fernandomierhicks/wheeled-leg-robot/cad/v4 Larger Ball bearings/README.txt

Rationale
-Wide bearings 6804 bearings
-Double suspended tibia for max stiffness - less friction
-Single coupler for simplicity
-Movable Leg plate that bolts onto body for easy CG adjustment

--------------------------------------------------------------------------------Optimization
-Optimized for max travel with 2Nm limit when applying 1kg force on wheel. Leave us some margin
-10mm max vertical deviation ( to avoid balancing issues when changing leg height
-ok for femur to collie with coupler, design has them in different planes 

See 2N_10mm_279mm.pdf for main dimensions. 
Stroke is +28 to -57 degrees. 

------------------------------------------------Dimensions:
2mm 		link to link clearance
32.05mm 	Bearing clearance
20.05mm 	for shaft going into bearing
23mm 		inner bearing ring. 
26mm 		outer bearing ring. 
7mm		Shaft fastener reinforcement pattern radius - allows for washer to be on 23mm inner ring while fasteners are still in PLA
38.05mm		diameter for hole pattern of retaining washer for outer ring bearing.
