fernandomierhicks/wheeled-leg-robot/cad/v3 shifted CG thin RGB Limit Switch/README.txt

Moved to Square tube to be able to use regular ball bearings and not have spherical joints on rod ends. 

Print settings:
-Motor couplers need to be high infill so they dont deform upon compression.
