fernandomierhicks/wheeled-leg-robot/firmware/robot_teensy/radio_channels.md

# Radio Channel Map

**Link:** ExpressLRS / CRSF, 420000 baud, `Serial4` (RX pin 16, **TX pin 17**).
Bidirectional -- telemetry rides the return path. See
`teensy/src/crsf_protocol.h` for the wire format and, more importantly, its
FAILSAFE CONTRACT.

**TX Profile:** `WLR ROBOT` on the RadioMaster TX15 (`radio/sdcard/MODELS/`).
**Reversals:** none

> **"Up" is ambiguous, so read this once.** Below, "C5 up" means the *channel*
> is high (~2000 us). On the TX15 that is produced by pushing the switch
> **down** -- the model maps every switch so that up = channel low = safe, and
> the power-on switch warning enforces it. See `radio/CHANNELS.md`.

### Signal loss

`channel()` returns **0**, not the last value, whenever the link is not alive,
and `alive()` goes false on any of: no frame within 100 ms, uplink link
quality at 0 while frames still arrive, or fewer than 5 good frames since
boot. Set the receiver's own failsafe to **no pulses**, never "hold".

---

## Channel Assignments

| Ch  | TX Control | Function | Details |
|-----|---|---|---|
| C1  | Roll stick | Yaw rate | 1000–2000 → −1…+1 × active profile's `yaw_max` → `PARAM_OMEGA_CMD_RDS`, slewed at `yaw_accel_max` [rad/s²] (default 8, 0 = off) so a snapped stick ramps the rate in and out instead of stepping it. One limit for all profiles: P3 takes longest to reach full rate. Also ramps to 0 on link loss. |
| C2  | Pitch stick | Forward velocity | 1000–2000 → −1…+1 × active profile's `vel_max` → `PARAM_V_CMD_MS` |
| C3  | Throttle stick | Hip height / angle | 1000–2000 → 0…1 → `PARAM_RADIO_HIP_CMD` |
| C4  | Rudder stick | Roll setpoint | 1000–2000 → −1…+1 × active profile's `roll_max` → `PARAM_ROLL_CMD_RAD` (active-suspension roll controller; only acts when `roll_ctrl_en=1` in RUNNING) |
| C5  | SB (top row, 2nd from left) | **SD logging** | **Up = start recording, down = stop.** Edge-triggered. A start is refused outside STANDBY/ESTOP (`"CH5 up ignored -- start the log before arming"`) because opening a log preallocates and blocks ~96 ms — but once started, **recording continues through RUNNING**, which is the whole point. Confirmed by a single G5 chirp, so check `buzzer_volume` — there is no LED cue. C5's level no longer gates arming. |
| C6  | SF (momentary shoulder) | **Jump** | Rising edge > 1990 requests `STATE_JUMPING`. **One jump per edge** — drop C6 and raise it again for another; holding it up does not hop repeatedly. Refused unless the robot is in RUNNING *and* `jump_enable = 1` (default **0**, so this is inert until you deliberately enable it). |
| C7  | S1 dial | Live tune, slot 0 of active group | 1000–2000 → active group's slot-0 range → its mapped param. See "Live parameter tuning" below. |
| C8  | S2 dial | Live tune, slot 1 of active group | 1000–2000 → active group's slot-1 range → its mapped param. See "Live parameter tuning" below. |
| C9  | SC (top row, right of dials) | Speed profile | < 1333 = profile 1, 1333–1667 = profile 2, > 1667 = profile 3. Selects the active `vel_max`, `yaw_max`, `torque_lim`, and `roll_max`. |
| C10 | SD (top row, rightmost) | Arm / disarm | > 1990 → RUNNING (requires calibration); drop → STANDBY |
| C11 | SA (top row, leftmost) | **Calibration** | Rising edge requests CALIBRATION from STANDBY; re-trigger during a radio-owned CALIBRATION cancels it through DISARMING (hip gains taper over `calib_rampdown_s`). Edge-triggered off a latching switch, so a debounced *release* is required before another edge counts — powering up with it already down does nothing. 1 s lockout between actions. The calibration stick combo remains as the fallback. |
| C12 | SE (latching shoulder) | **Reset fault** | Rising edge in ESTOP: full reset to STARTUP, clearing `fault_code` regardless of severity and re-running the startup checks — the same effect as the rescue combo's rising edge. In STANDBY: beep only. Armed solely in STANDBY/ESTOP, never with torque live. No hold-to-reboot: a latching switch left down is not the deliberate gesture that makes the combo's 3 s hold safe. |
| C13 | SG/SH/SI (RGB buttons 1–3) | Live-tune group | All three mutually-exclusive buttons encoded onto one channel as distinct levels: ~1500 µs none, 1660 group 0, 1830 group 1, 2000 group 2. Decoded with ±80 µs bands. Still gated by `live_tune_multi_en`, which defaults to 0. C5/C6 keep SD logging and jump — the old combination borrowed them, so a tuning session could not be logged. |
| C14 | SJ (RGB button 4) | **Latch gains** | Rising edge fires the same one-shot as writing `live_tune_latch` from the GUI. Only picked-up slots are committed. |
| C15 | SK (RGB button 5) | **Coordinated-turn lean** | `roll_cmd = −lean_gain·atan(v·ω/g)`, added to the stick roll and clamped to the profile's roll limit. Requires `lean_turn_en=1`, `lean_gain>0` **and** `roll_ctrl_en=1` — the roll controller is what actually delivers the lean, and a warning is logged if it is off. Verify the sign suspended before any floor test. |
| C16 | — | *spare* | |

There is **no "LEGACY mode"**. C5 is always the SD-log switch, C6 is always the
jump trigger, and gain-group select is always C13. An earlier scheme borrowed
C5/C6 for group select and is gone; if you find a comment describing it, the
comment is stale, not the code.

**C1/C4 swap (2026-10-02):** yaw rate moved from C4 to C1, and the roll
setpoint moved from C1 to C4 (`main.cpp`). The physical stick bound to each
channel number is unchanged (C1 is still the TX's roll/aileron stick, C4 is
still the rudder stick) — only which robot command each channel drives
changed. Both signs (roll's and yaw's inversion) were previously
bench-verified on the *other* channel's stick and have **not** been
re-verified on the hardware since the swap — check both directions on the
bench before trusting them.

### Where to watch these channels

`TelemetryPayload.ibus_ch[]` mirrors **C1–C14 only** — the array predates CRSF
and is sized by the payload, not by CRSF's 16 (`main.cpp`, `RC_MIRROR_CH`). So
the GUI's Radio tab stops at C14 and **cannot see C15 or C16**.

That is deliberate rather than a gap to close. The link is bidirectional now
and the transmitter has its own **Outputs** screen showing all 16 channels in
real time, which makes the radio the better instrument for walking the channel
map — widening the telemetry struct would only duplicate it, at the cost of a
`TELEM_VERSION` bump, an ESP32 reflash and every existing `.wlog` ceasing to
decode. Verify C15/C16 on the radio; use the GUI mirror for C1–C14.

`lean_cmd_rad` is read-only telemetry, but it is `−lean_gain·atan(v·ω/g)` and
therefore **zero at standstill**, so it confirms the lean is *working*, never
that the C15 button is *wired*.

## Calibration combo — STANDBY → CALIBRATION

Both sticks jammed into opposite corners, the **exact mirror of the rescue combo
below**: **C1 and C4 full up (> 1990), C2 and C3 full down (< 1010)**. Debounced
3 ticks (~6 ms @ 500 Hz). One-shot on the rising edge — release and re-enter for
the next action. Replaced the old C5 switch when C5 became the SD-log switch.

| Event | Effect |
|---|---|
| Enter combo, in STANDBY | Requests CALIBRATION (still subject to `stateMachine_request_calibration()`'s own check that at least one hip motor is enabled) |
| Enter combo again, during a radio-started CALIBRATION | Cancels it through DISARMING — tapers each hip's calibration gains to zero over `calib_rampdown_s`, then returns to STANDBY |
| Enter combo, any other state | Ignored, logged |

**Armed only in STANDBY and CALIBRATION — deliberately not in ESTOP**, so in a
fault state the rescue combo is the only live stick gesture and the two mirrored
gestures can't be confused. The two combos are mutually exclusive stick
positions and can never be satisfied on the same tick.

After any accepted action there is a **1 s lockout** before another combo edge is
honoured, so a stick glitch part-way through a deliberate hold cannot start a
calibration and immediately cancel it again. Powering up or reconnecting with the
sticks already in the combo position does nothing: a debounced *release* must be
seen before the first rising edge counts. Loss of the radio link reads as
"released", which is inert — only rising edges act, so a dead radio can never
imitate an operator request. There is no other radio-side abort; re-entering the
combo is it.

## Rescue combo — clear ESTOP / reboot

Both sticks jammed into opposite corners, held: **C3 and C2 full up (> 1990),
C1 and C4 full down (< 1010)**. Debounced 3 ticks (~6 ms @ 500 Hz). Only armed
in **STANDBY** or **ESTOP** — never with torque live. Intended as a
transmitter-only escape hatch when the GUI isn't connected; no normal driving
input produces this stick position.

| Event | Effect | Cue |
|---|---|---|
| Enter combo, in ESTOP | Full reset → STARTUP: clears the fault regardless of severity and re-runs the startup checks | A5⇄E6 siren + white LED flash |
| Enter combo, in STANDBY | Nothing to clear — beep only, and the 3 s countdown starts | same siren |
| Hold 3 s | Full MCU reset, identical to the GUI's Reboot command | E6→A5→D5→G4 descending fall |

If the fault can't actually be cleared (a REBOOT-severity hardware dropout),
STARTUP re-faults straight back to ESTOP — keep holding and the 3 s reboot
fires anyway. Releasing the sticks re-arms the combo, so a second attempt
starts a fresh countdown. Loss of the radio link cannot satisfy the combo.

## Arm authority

- With no live radio link, the GUI/API may arm and owns that running session.
- While the radio is live, GUI/API arm requests are rejected; C10 owns arming.
- If a radio link appears during a GUI-owned running session, the robot enters
  DISARMING regardless of C10 level. Re-arm from STANDBY using C10.
- During a radio-owned session, live C10-low or loss of the radio link enters
  DISARMING. C10 is level-based, so its initial low state cannot be missed.
- Motion authority is never handed directly between GUI and radio while armed;
  every takeover passes through STANDBY.
- A calibration started by the calibration combo remains radio-owned until it
  completes or faults. Re-entering the combo while it is active enters
  DISARMING, tapers each hip's current calibration gains to zero over
  `calib_rampdown_s`, then returns to STANDBY. Loss of the radio link is neutral
  and does not imitate this operator-requested cancellation.

## Live parameter tuning

Generic mechanism (`teensy/src/live_tune.h`, `LIVE_TUNE_SLOTS` in `main.cpp`)
for feeling out a gain/limit live on the bench with a knob instead of editing
the Params tab blind and re-arming to see the effect. C7/C8 each drive one
slot of the active *gain group*, RUNNING only.

**Whether live tuning is available at all is set by `live_tune_multi_en`.**

### `live_tune_multi_en = 0` (default)

**Live tuning is off.** The C7/C8 knobs are inert and the group-select buttons
do nothing. The groups are not deleted, just unreachable — set
`live_tune_multi_en = 1`. It stays a deliberate, persistent opt-in so a knocked
button cannot start moving gains on its own.

### `live_tune_multi_en = 1`

Group select is **all on C13**: buttons 1–3 (SG/SH/SI) form a mutually-exclusive
switch group whose three positions are encoded as distinct levels on that one
channel. They are already mutually exclusive, so three channels would have been
three ways to say one thing. **C5 keeps SD logging and C6 keeps jump** — the old
scheme borrowed them, which meant a tuning session gave up both, and a tuning
session is exactly the one you most want a log of.

| Group | Button | C13 level | Decode band | Slot 0 (C7) | Slot 1 (C8) |
|---|---|---|---|---|---|
| *(none lit)* | — | ~1500 µs | < 1580 | *tuning inactive* | — |
| 0 | button 1 / SG | ~1660 µs | 1580–1745 | `lqr_k_pitch_ret`, -0.1 … -2.0 | `lqr_k_rate_ret`, -0.01 … -1.0 |
| 1 | button 2 / SH | ~1830 µs | 1745–1915 | `vel_pi_kp`, 0.05 … 1.0 | `vel_pi_ki`, 0.02 … 0.5 |
| 2 | button 3 / SI | ~2000 µs | > 1915 | `roll_kp`, 0.3 … 4.0 | `roll_kd`, 0.02 … 0.5 |

Bands are the midpoints between levels (`LT_BAND_*` in `main.cpp`), debounced 3
ticks. **"None = ~1500 µs = inactive" matters as much as the rest**: the resting
state of the buttons has to be the state that does nothing. Link loss also reads
as "none", which drops every slot's pickup on the next pass.

Ranges are `(value at knob-zero, value at knob-max)`. Both slots are mirrored
live to telemetry regardless of group: `live_tune_ch7_val` / `live_tune_ch8_val`.

**Knob direction convention.** A slot's range is `(value at knob-zero, value at
knob-max)`, not a sorted `(min, max)` pair. Group 0's gains are negative, so
turning the knob up always moves the value *more* negative — i.e. "more knob"
always means "more gain" (larger magnitude / stronger action), regardless of
the sign of the underlying param. Never flip a slot's range so that the raw
signed value increases with the knob instead.

**Repointing a slot at a different param** (e.g. a future tuning session) is a
one-line edit to `LIVE_TUNE_SLOTS` + reflash — no other code changes needed as
long as the target's read site in `control_loop.cpp` goes through
`live_tune_value(PARAM_X)` instead of a bare `param_get(PARAM_X)`.

**Safety — pickup, no step change.** A knob is inert on entering live-tune mode
(or switching to a different group) until it's swept through the target
param's *current* value; only then does it "pick up" and start tracking 1:1.
This avoids the gain jumping instantly to wherever the knob happened to be
sitting when the group was selected. Pickup resets every time you leave
live-tune mode or change groups (any C13 group change, including link loss, or
leaving RUNNING) — re-entering always requires re-sweeping.

**Nothing is written to the real, persistent param until you say so.** While a
slot is picked up, its live shadow value is what the control loop actually
uses (real-time effect, so you can feel the change) — but the underlying
persistent param is untouched, so exiting live-tune mode (or switching groups)
without latching leaves it exactly as it was.

*(All of the below requires `live_tune_multi_en = 1`.)*

1. Arm normally (raise C10) → RUNNING.
2. Press the group's RGB button — 1, 2 or 3 (C13). The lit button *is* the
   group indicator. Sweep C7/C8 through the group's current values to pick each
   slot up (watch `live_tune_ch7_val`/`live_tune_ch8_val` in telemetry — they
   update immediately; the *effect* on balance only kicks in once picked up,
   independently per slot).
3. Press **button 4 (C14)** to persist every currently picked-up slot's shadow
   value into its real param — or write `live_tune_latch` = 1 from the Params
   tab, which is the same one-shot. One-shot: firmware
   latches and resets the flag. A slot that never picked up this session is
   skipped, not latched at a stale/arbitrary value.
4. To leave live-tune mode: press the lit group button again so **none** are lit
   (C13 back to ~1500 µs), or move to another group and repeat steps 2-3. Either
   way the latched (or, if you didn't latch, unchanged) persistent values take
   over.
