fernandomierhicks/wheeled-leg-robot/artistic concepts/1e269624-bf2c-442b-bb45-654e40681b4a.png

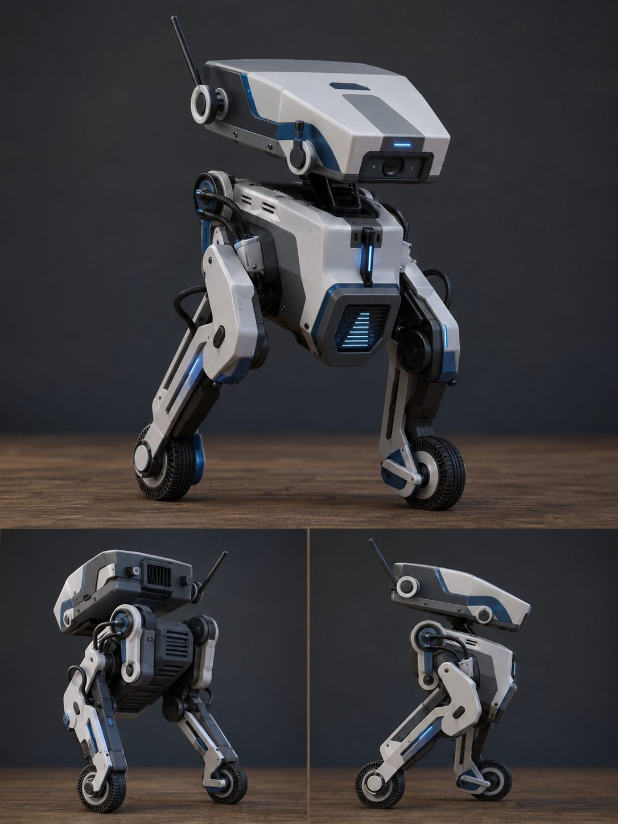
artistic concepts/1e269624-bf2c-442b-bb45-654e40681b4a.png
