fernandomierhicks/wheeled-leg-robot/artistic concepts/5fc2438b-1b2d-4f7d-8f79-38cc8f08c87c.png

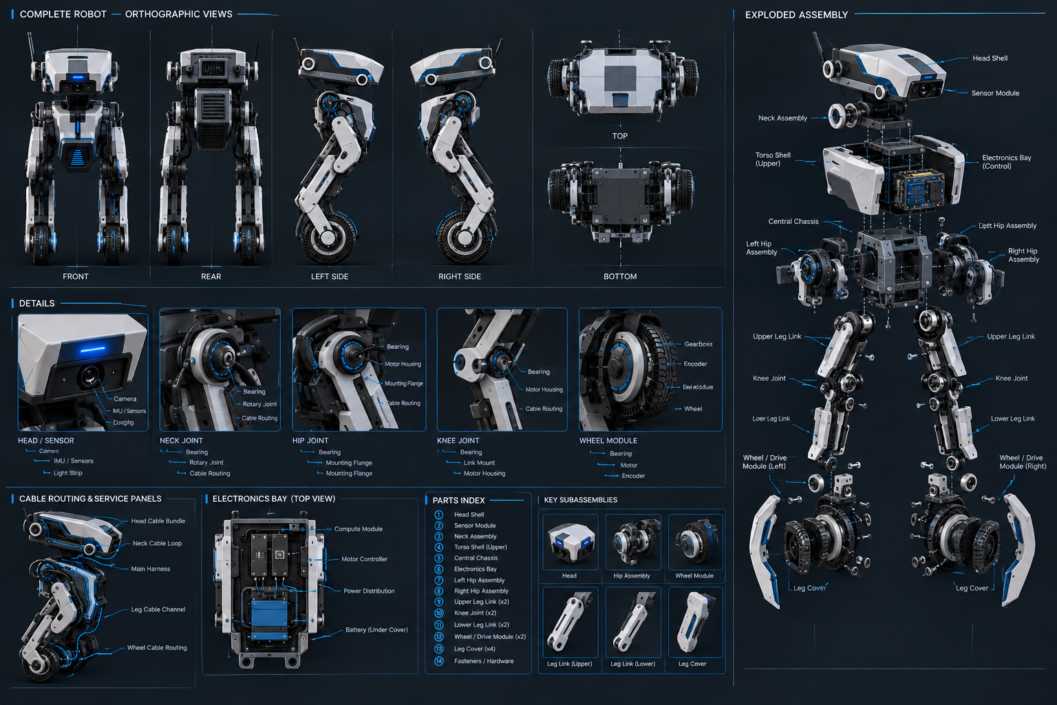
artistic concepts/5fc2438b-1b2d-4f7d-8f79-38cc8f08c87c.png
