fernandomierhicks/wheeled-leg-robot/artistic concepts/6a8995e4-0af4-4b7b-a4b5-fce23d9d5401.png

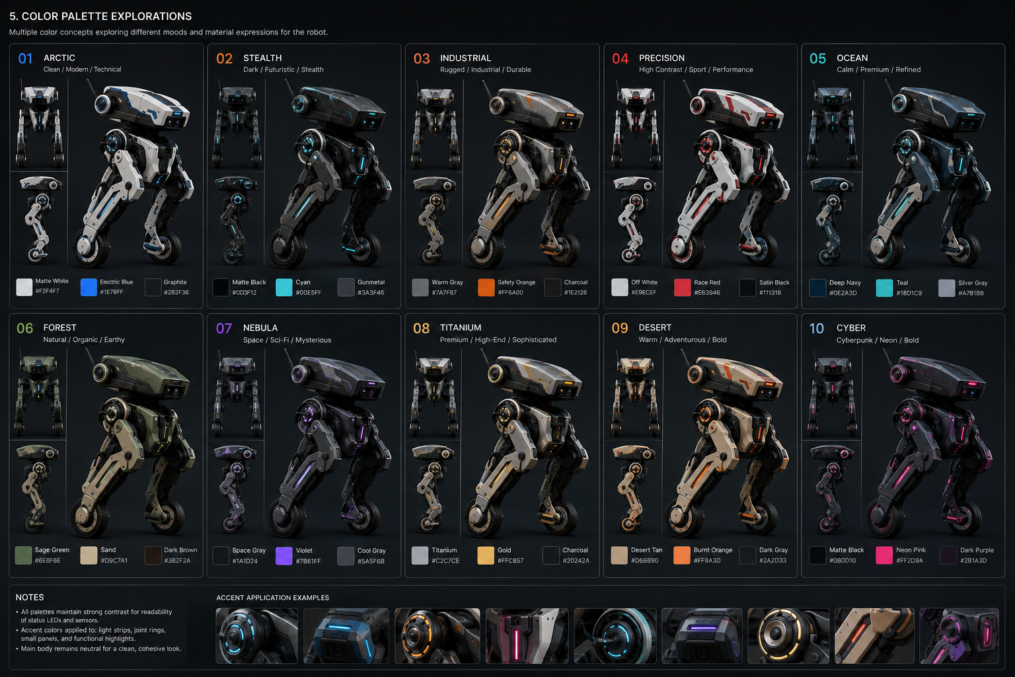
artistic concepts/6a8995e4-0af4-4b7b-a4b5-fce23d9d5401.png
