fernandomierhicks/wheeled-leg-robot/artistic concepts/circuit/futuristic-neon-techno-frame-with-corner-brackets-on-dark-background-vector.jpg

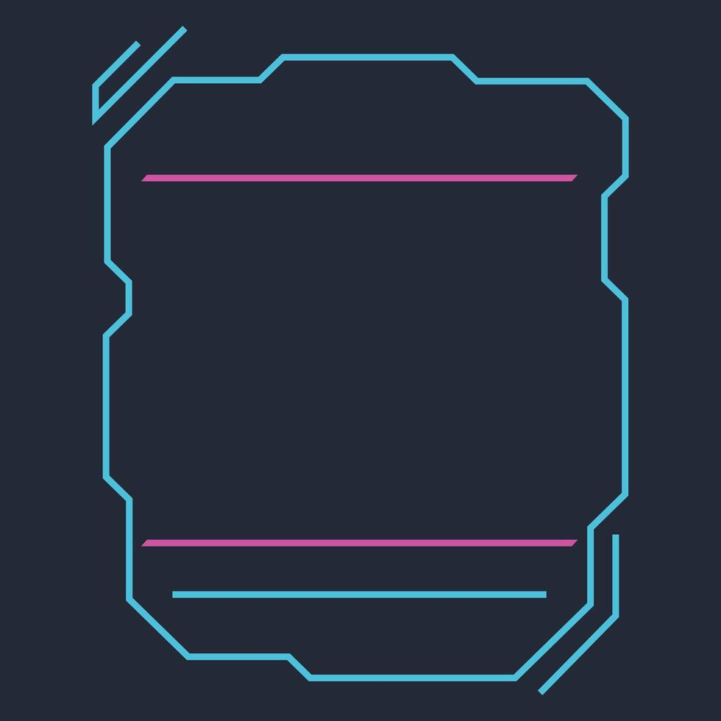
artistic concepts/circuit/futuristic-neon-techno-frame-with-corner-brackets-on-dark-background-vector.jpg
