fernandomierhicks/wheeled-leg-robot/artistic concepts/circuit/images.jpg

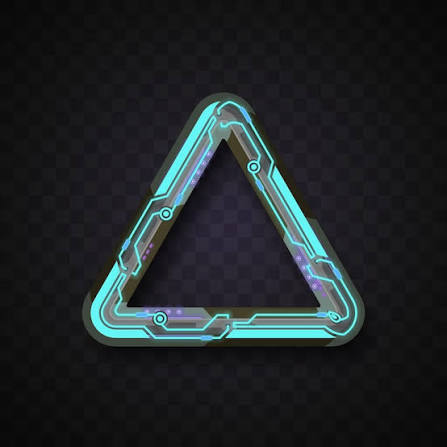
artistic concepts/circuit/images.jpg
