fernandomierhicks/wheeled-leg-robot/artistic concepts/circuit/minimalist-blue-cyberpunk-ui-with-clean-geometric-panels-sci-fi-data-charts-and-shapes-perfect-for-game-hud-robot-control-boards-or-virtual-display-mockups-vector.jpg

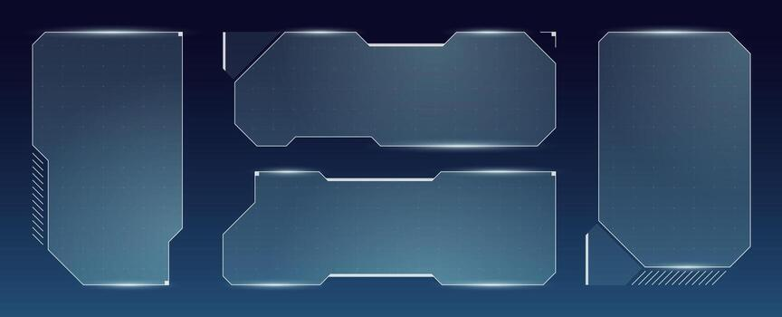
artistic concepts/circuit/minimalist-blue-cyberpunk-ui-with-clean-geometric-panels-sci-fi-data-charts-and-shapes-perfect-for-game-hud-robot-control-boards-or-virtual-display-mockups-vector.jpg
