fernandomierhicks/wheeled-leg-robot/artistic concepts/circuit/stylish-yellow-futuristic-interface-elements-design-vector.jpg

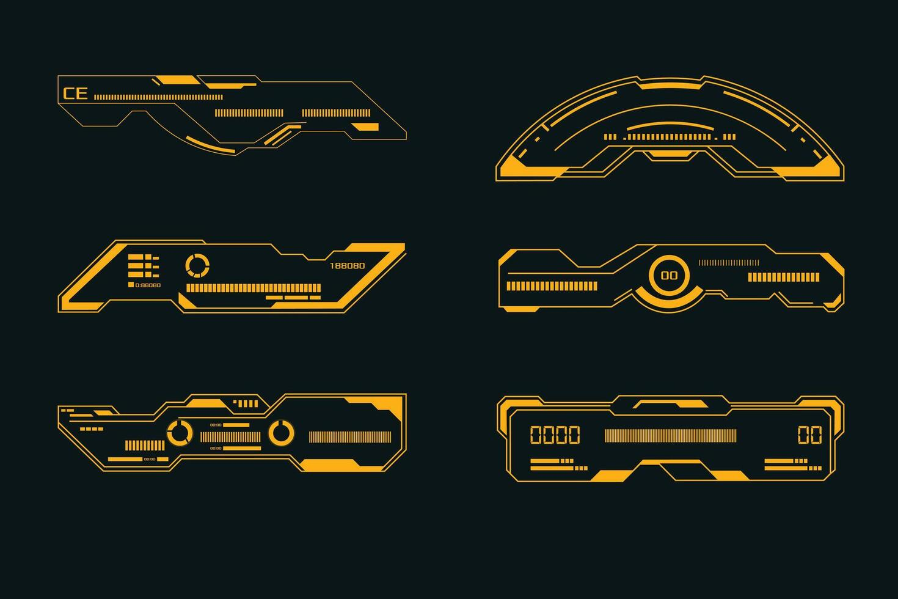
artistic concepts/circuit/stylish-yellow-futuristic-interface-elements-design-vector.jpg
