fernandomierhicks/wheeled-leg-robot/artistic concepts/ed0539cf-2716-43c7-a42b-d176d1103ca7.png

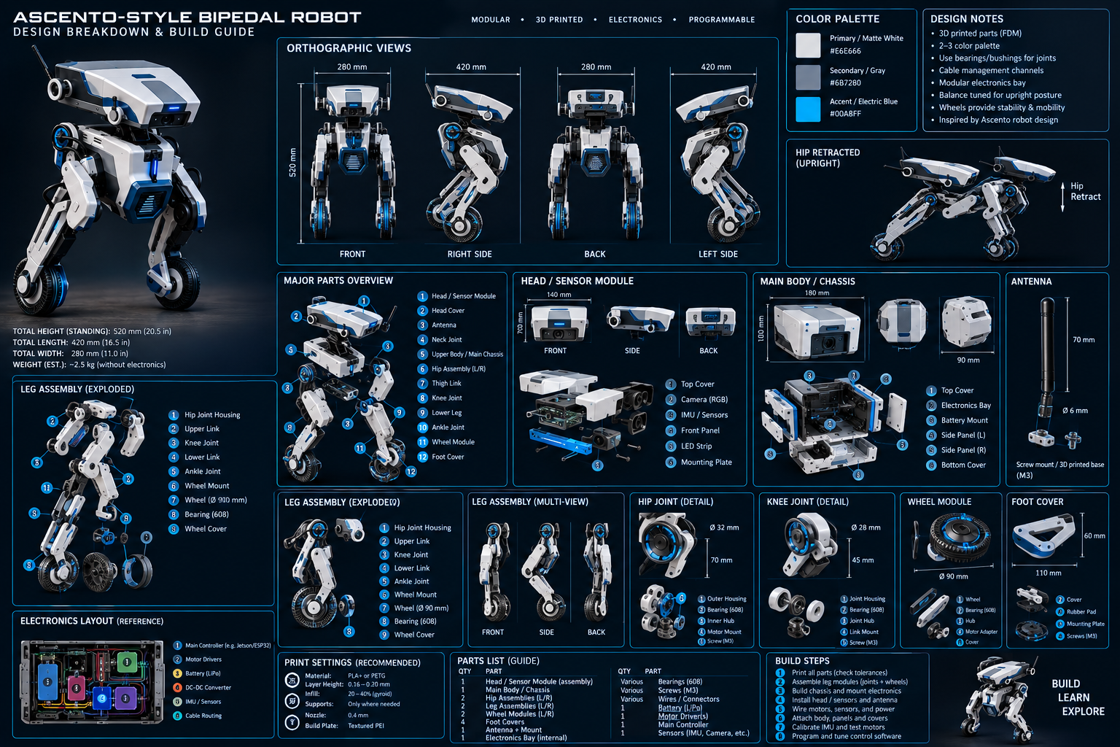
artistic concepts/ed0539cf-2716-43c7-a42b-d176d1103ca7.png
