fernandomierhicks/wheeled-leg-robot/artistic concepts/f49612d2-8224-4d90-8979-7ec5f9c1539f.png

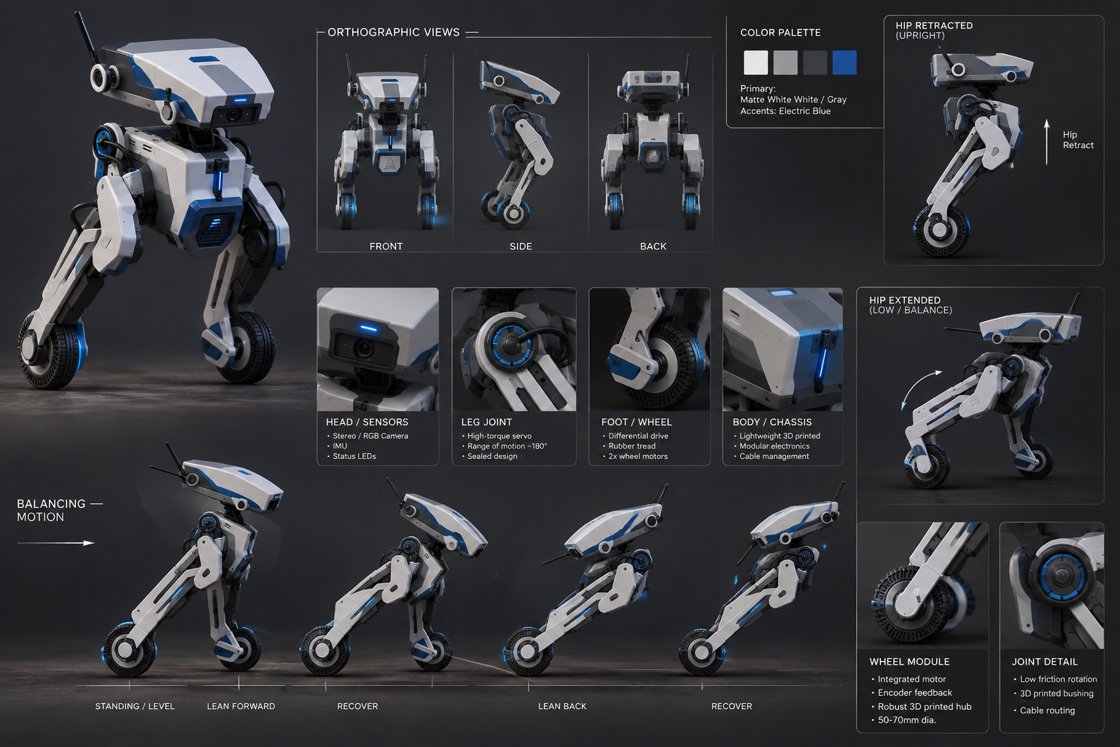
artistic concepts/f49612d2-8224-4d90-8979-7ec5f9c1539f.png
