fernandomierhicks/wheeled-leg-robot/artistic concepts/fd7d5789-46f4-43f5-883d-d11a78b0f6e3.png

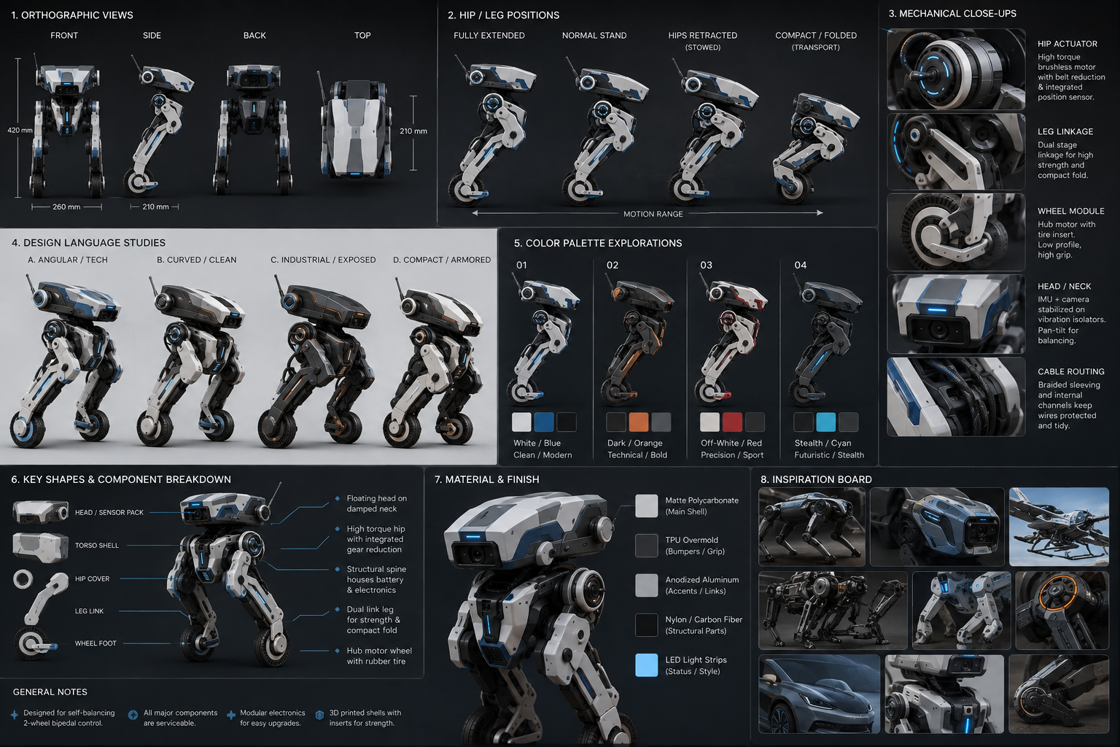
artistic concepts/fd7d5789-46f4-43f5-883d-d11a78b0f6e3.png
