fernandomierhicks/wheeled-leg-robot/artistic concepts/high res render.png

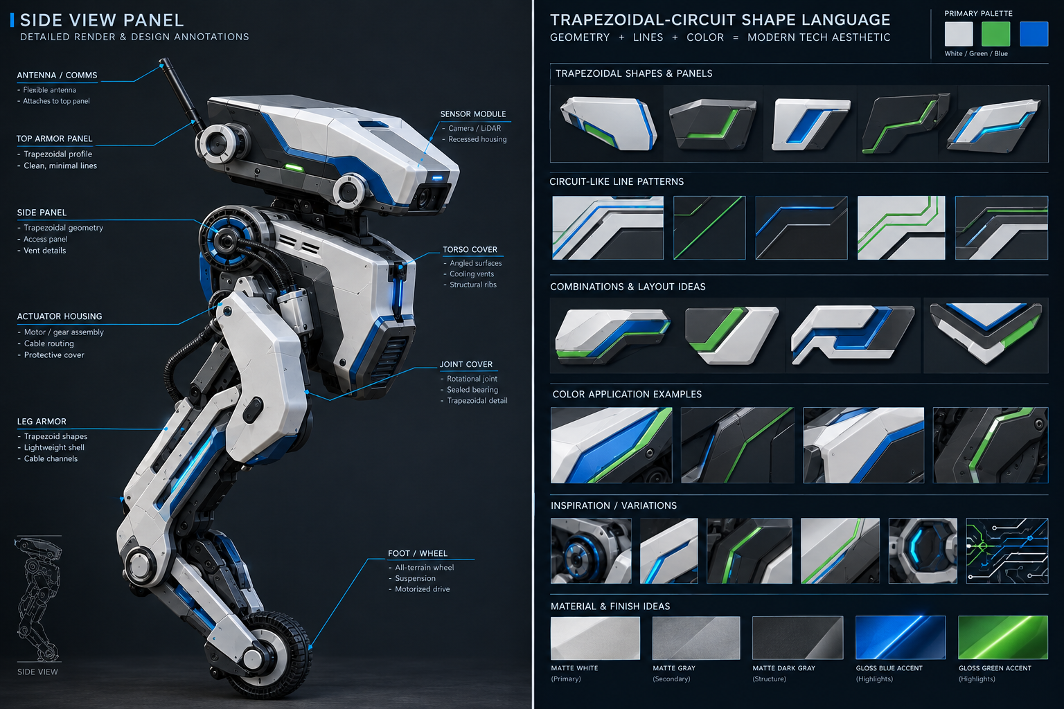
artistic concepts/high res render.png
