fernandomierhicks/wheeled-leg-robot/cad/aesthetics/out/boards/gal_femur_concepts.png

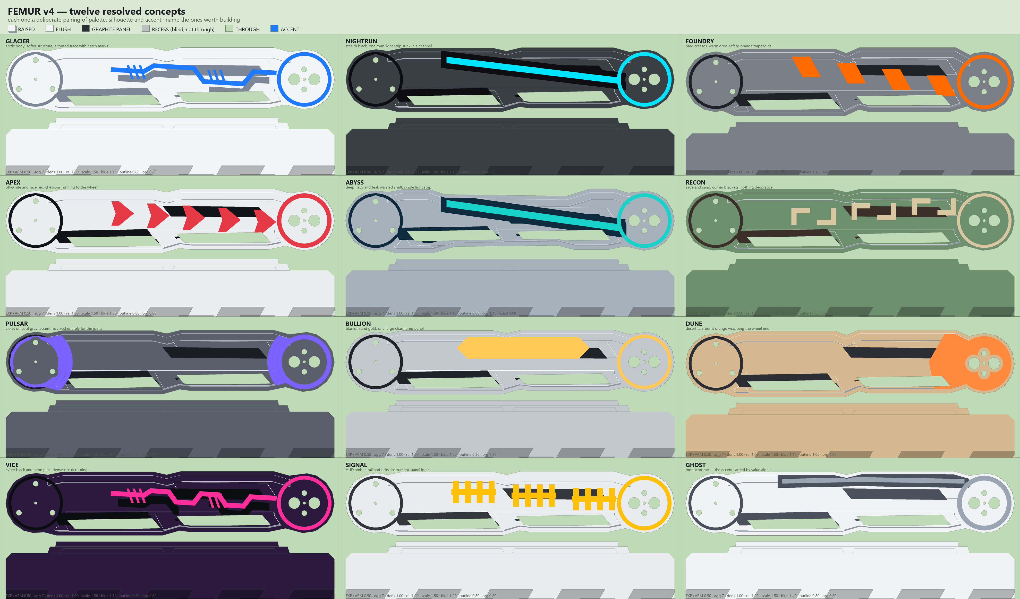
cad/aesthetics/out/boards/gal_femur_concepts.png
