fernandomierhicks/wheeled-leg-robot/cad/aesthetics/out/boards/gal_tibia_concepts.png

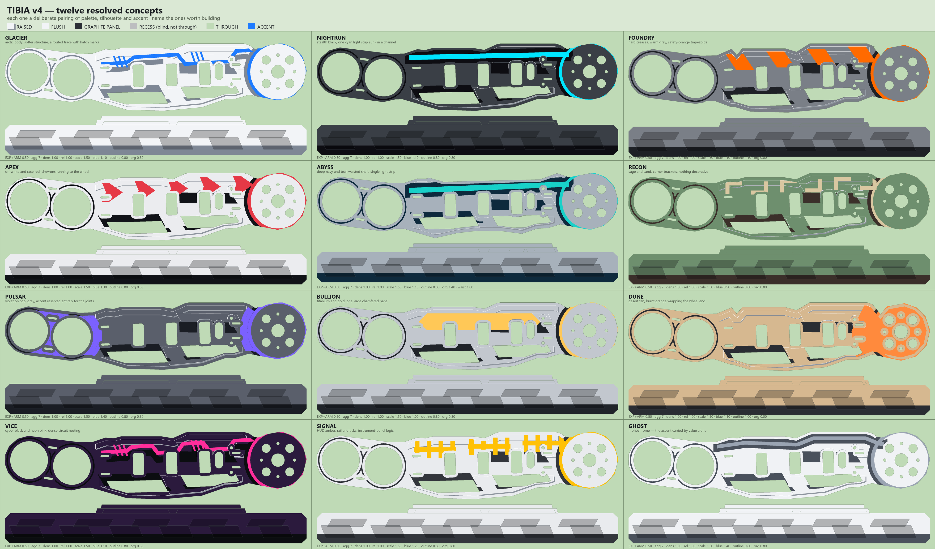
cad/aesthetics/out/boards/gal_tibia_concepts.png
