fernandomierhicks/wheeled-leg-robot/cad/aesthetics/out/renders/added_Coupler_glacier.png

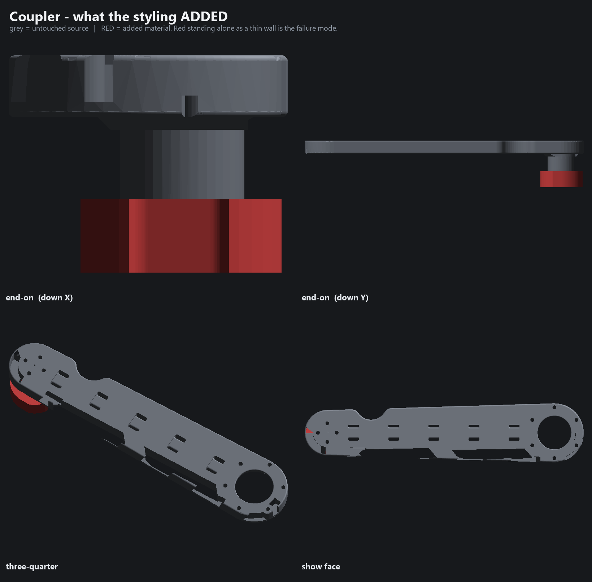
cad/aesthetics/out/renders/added_Coupler_glacier.png
