fernandomierhicks/wheeled-leg-robot/cad/aesthetics/out/renders/added_Femur.png

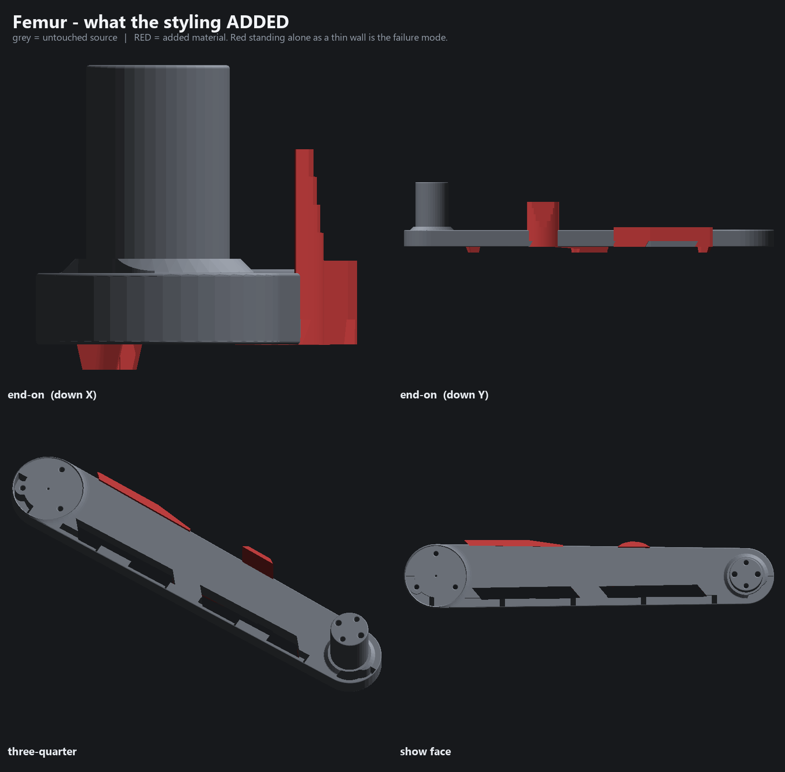
cad/aesthetics/out/renders/added_Femur.png
