fernandomierhicks/wheeled-leg-robot/cad/aesthetics/out/renders/added_Femur_glacier.png

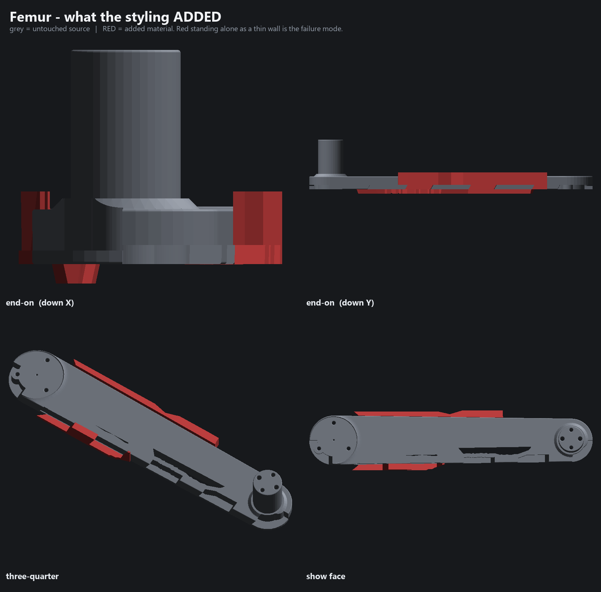
cad/aesthetics/out/renders/added_Femur_glacier.png
