fernandomierhicks/wheeled-leg-robot/cad/aesthetics/out/renders/added_RobotMount_glacier.png

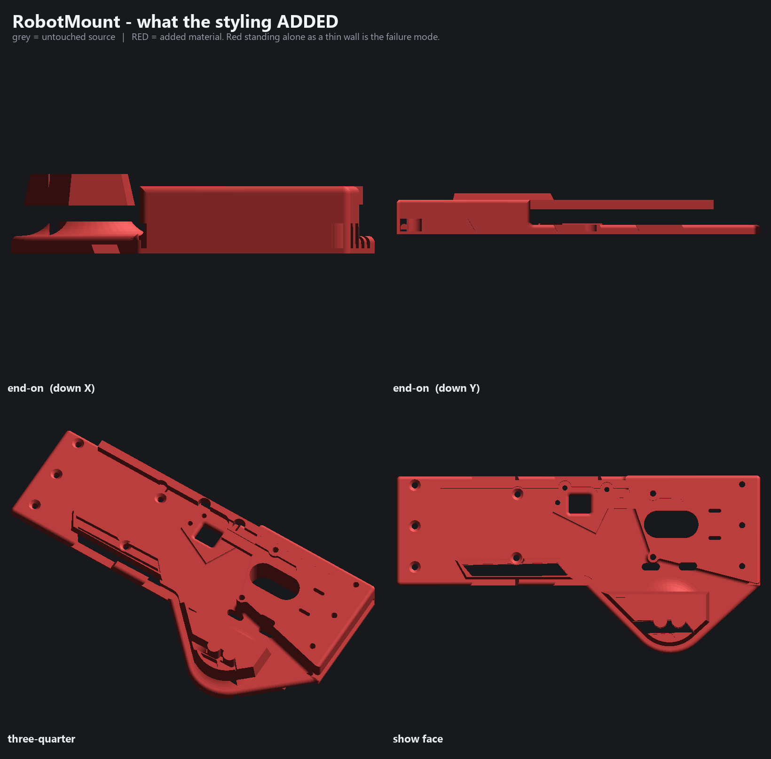
cad/aesthetics/out/renders/added_RobotMount_glacier.png
