fernandomierhicks/wheeled-leg-robot/cad/aesthetics/out/renders/added_Side_panel_glacier.png

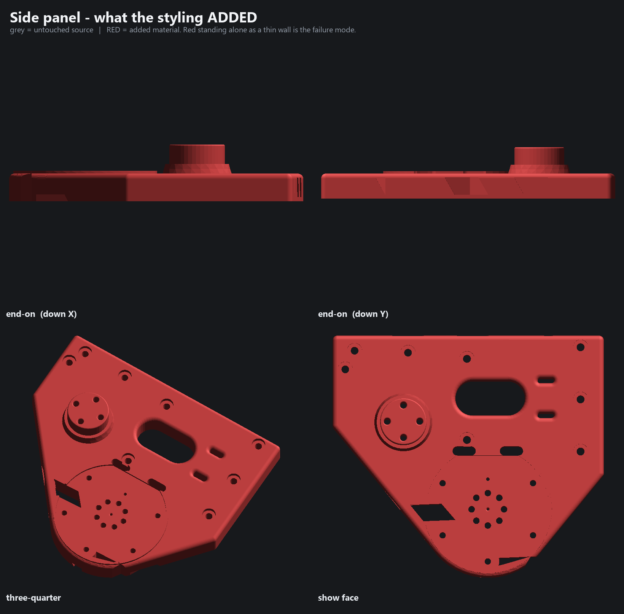
cad/aesthetics/out/renders/added_Side_panel_glacier.png
