fernandomierhicks/wheeled-leg-robot/cad/aesthetics/out/renders/agg_iso.png

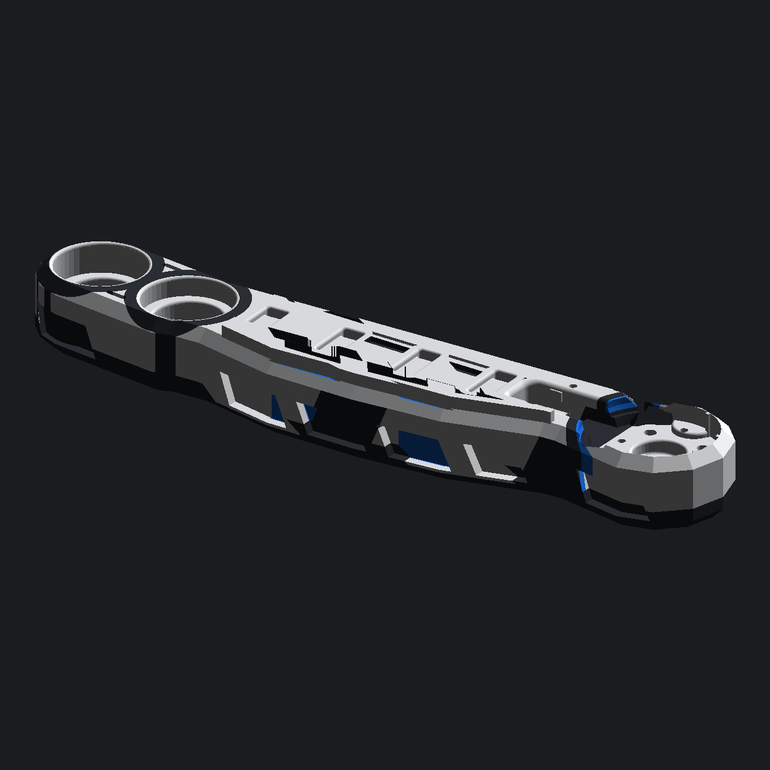
cad/aesthetics/out/renders/agg_iso.png
