fernandomierhicks/wheeled-leg-robot/cad/aesthetics/out/renders/agg_keel.png

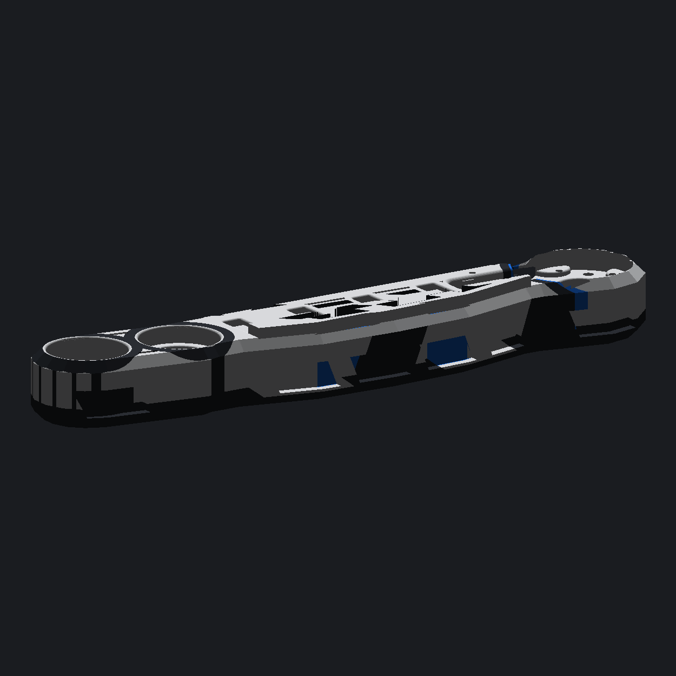
cad/aesthetics/out/renders/agg_keel.png
