fernandomierhicks/wheeled-leg-robot/cad/aesthetics/out/renders/agg_knee.png

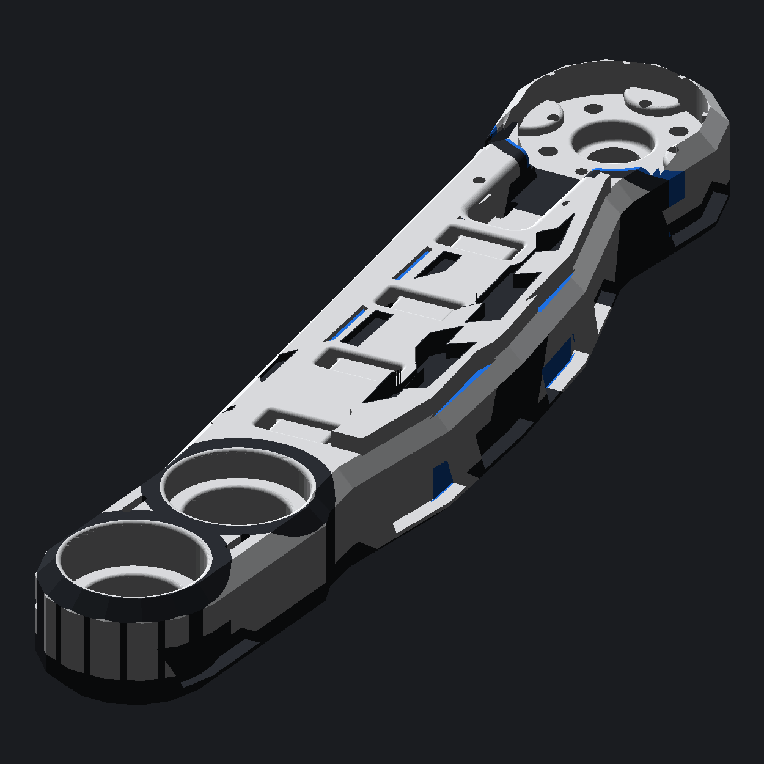
cad/aesthetics/out/renders/agg_knee.png
