fernandomierhicks/wheeled-leg-robot/cad/aesthetics/out/renders/femur_concepts_3d.png

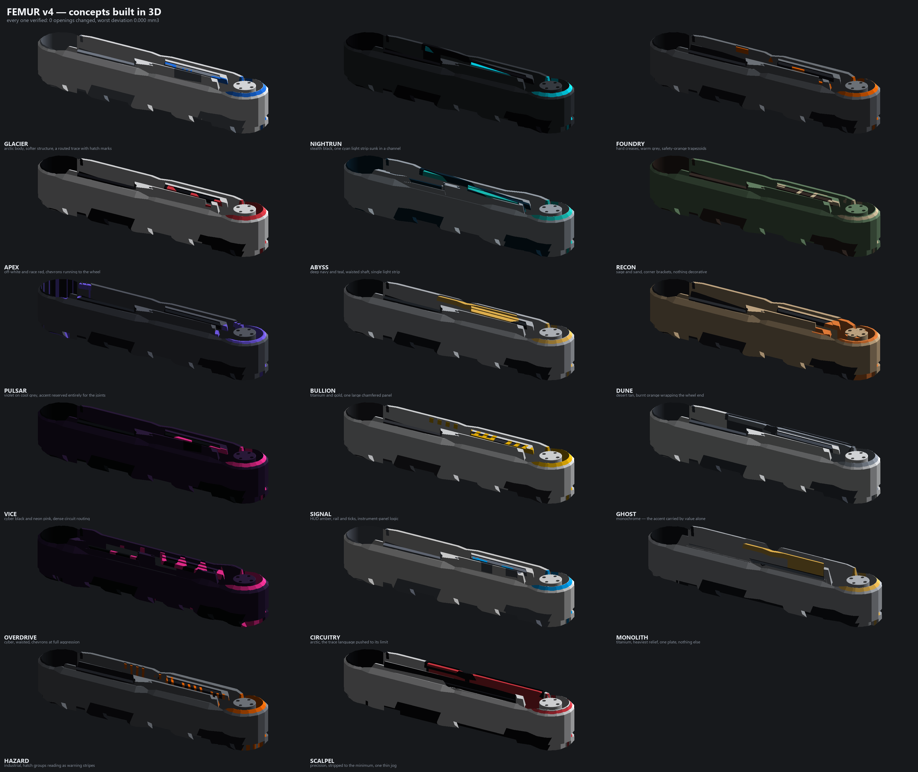
cad/aesthetics/out/renders/femur_concepts_3d.png
