fernandomierhicks/wheeled-leg-robot/cad/aesthetics/out/renders/fromfile_Femur.png

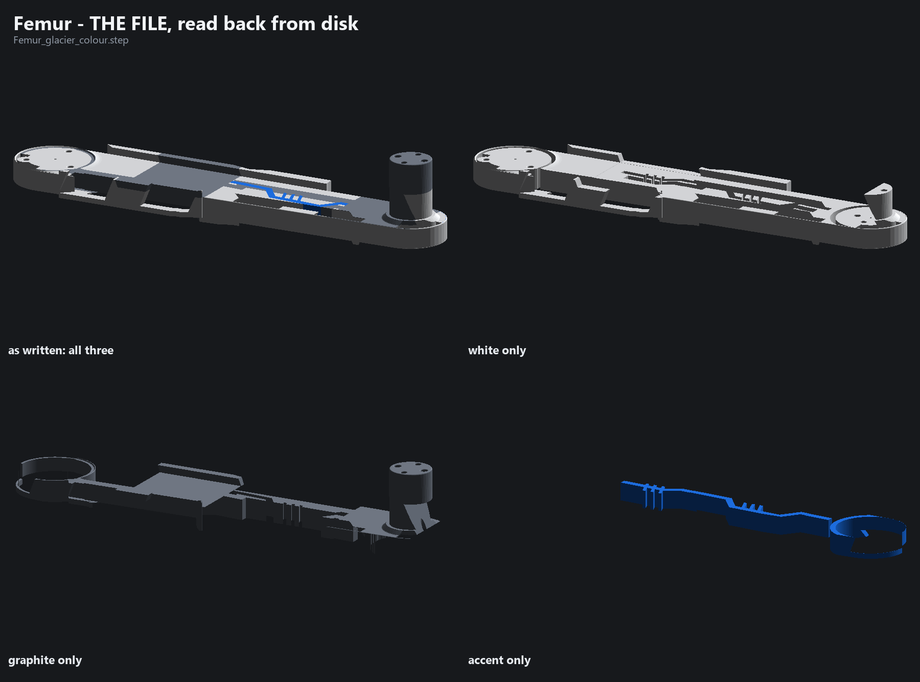
cad/aesthetics/out/renders/fromfile_Femur.png
