fernandomierhicks/wheeled-leg-robot/cad/aesthetics/out/renders/hero_tibia_apex.png

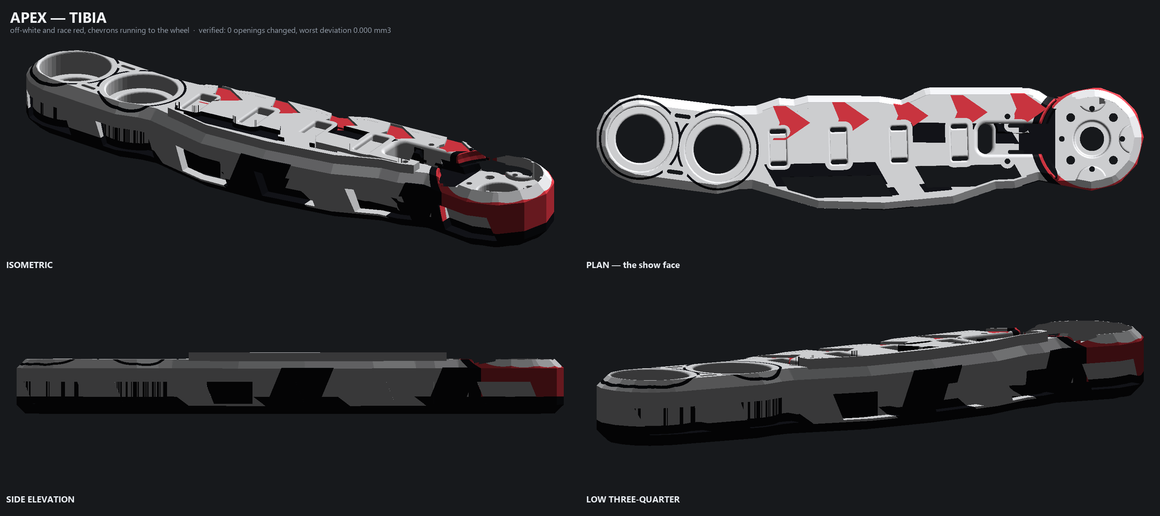
cad/aesthetics/out/renders/hero_tibia_apex.png
