fernandomierhicks/wheeled-leg-robot/cad/aesthetics/out/renders/hero_tibia_glacier.png

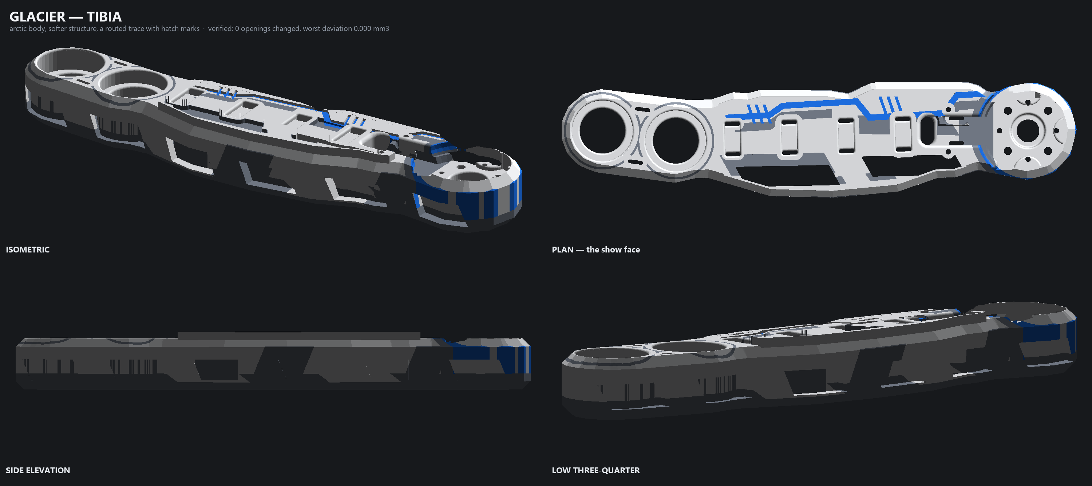
cad/aesthetics/out/renders/hero_tibia_glacier.png
