fernandomierhicks/wheeled-leg-robot/cad/aesthetics/out/renders/hero_tibia_vice.png

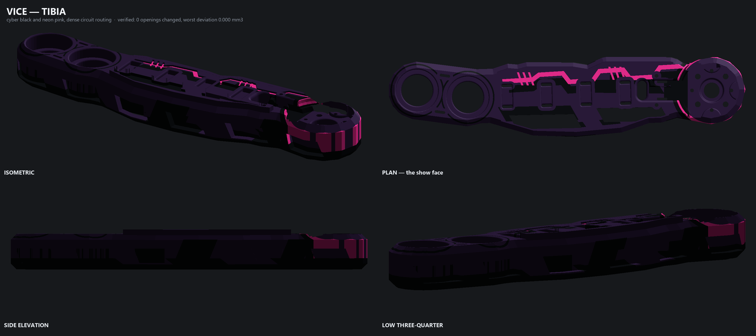
cad/aesthetics/out/renders/hero_tibia_vice.png
