fernandomierhicks/wheeled-leg-robot/cad/aesthetics/out/renders/part_Coupler_glacier.png

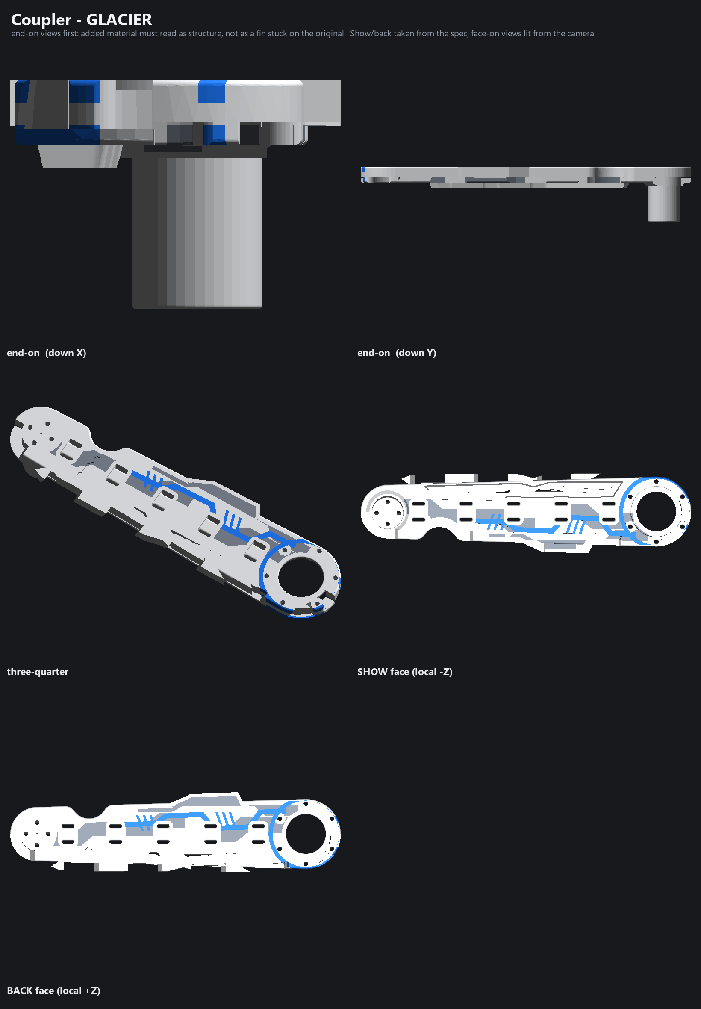
cad/aesthetics/out/renders/part_Coupler_glacier.png
