fernandomierhicks/wheeled-leg-robot/cad/aesthetics/out/renders/part_Femur.png

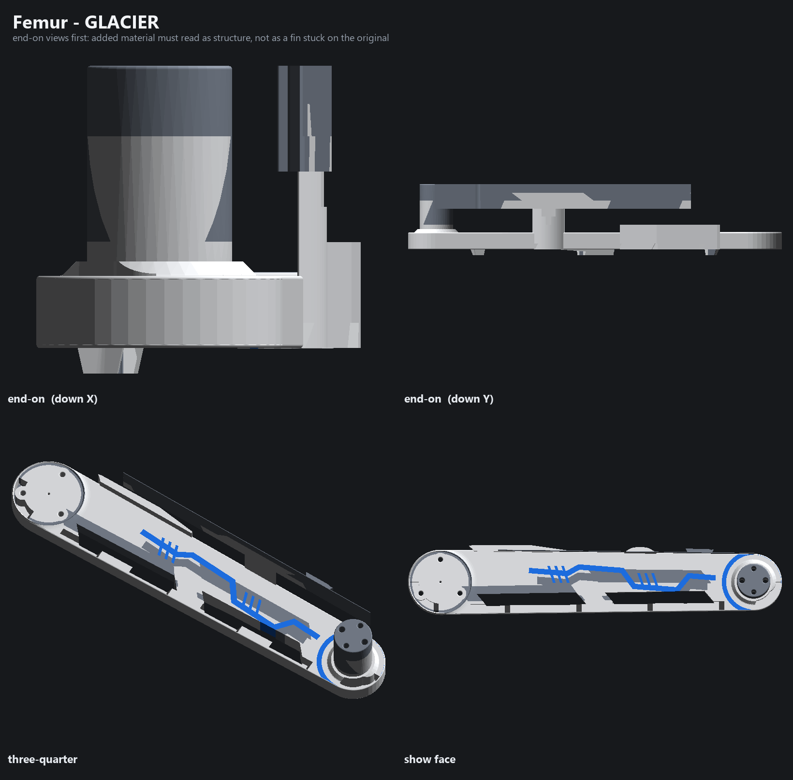
cad/aesthetics/out/renders/part_Femur.png
