fernandomierhicks/wheeled-leg-robot/cad/aesthetics/out/renders/part_Femur_noskirt.png

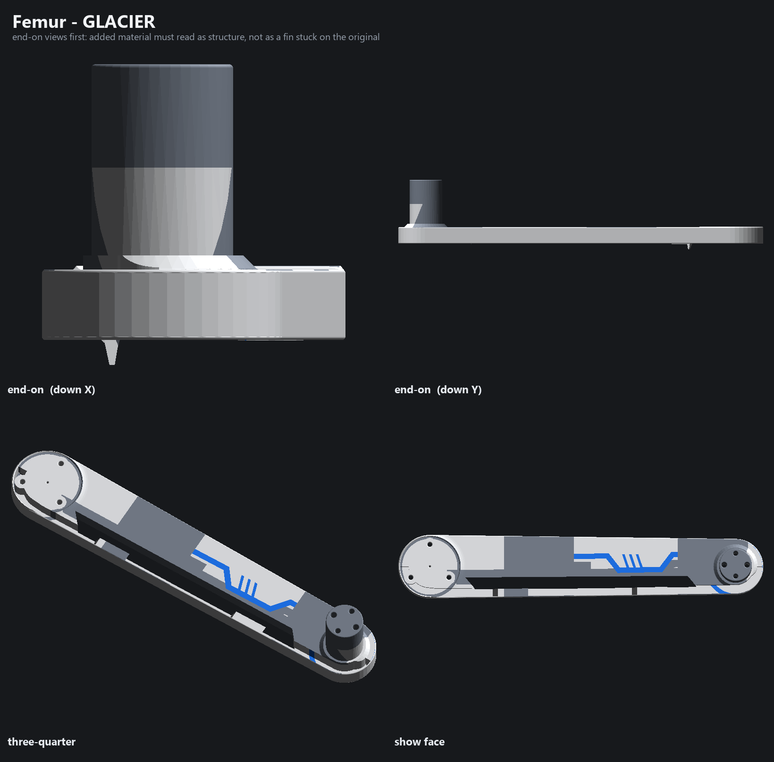
cad/aesthetics/out/renders/part_Femur_noskirt.png
