fernandomierhicks/wheeled-leg-robot/cad/aesthetics/out/renders/part_RobotMount_glacier.png

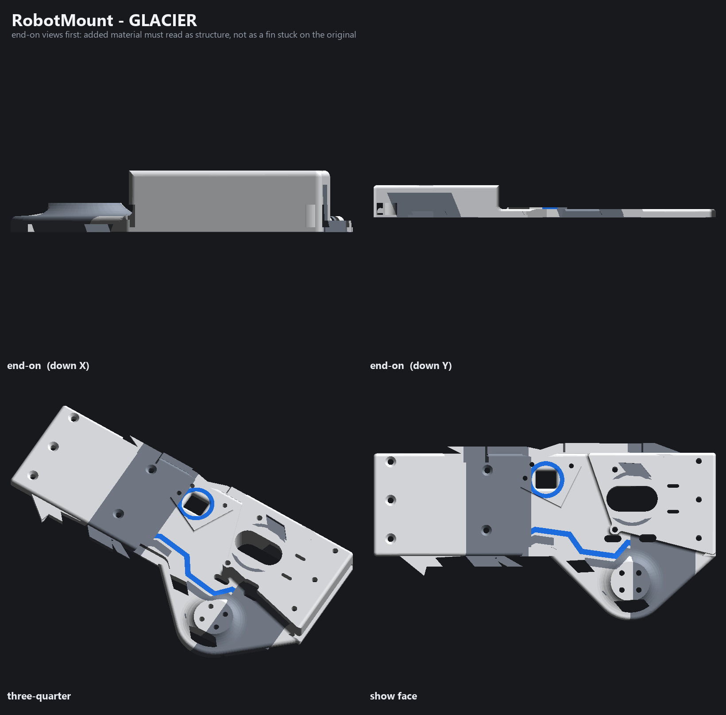
cad/aesthetics/out/renders/part_RobotMount_glacier.png
