fernandomierhicks/wheeled-leg-robot/cad/aesthetics/out/renders/part_Tibia_glacier.png

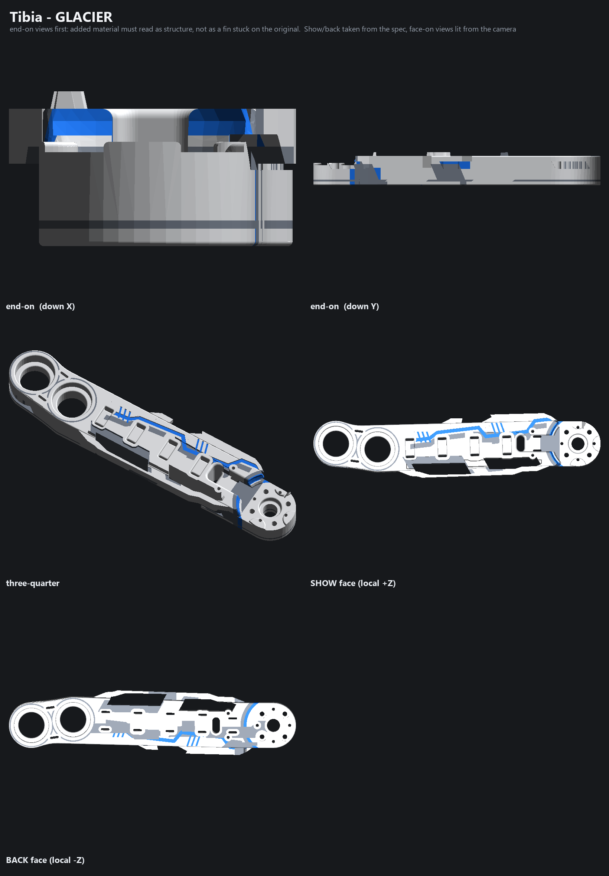
cad/aesthetics/out/renders/part_Tibia_glacier.png
