fernandomierhicks/wheeled-leg-robot/cad/aesthetics/out/renders/tibia_concepts_3d.png

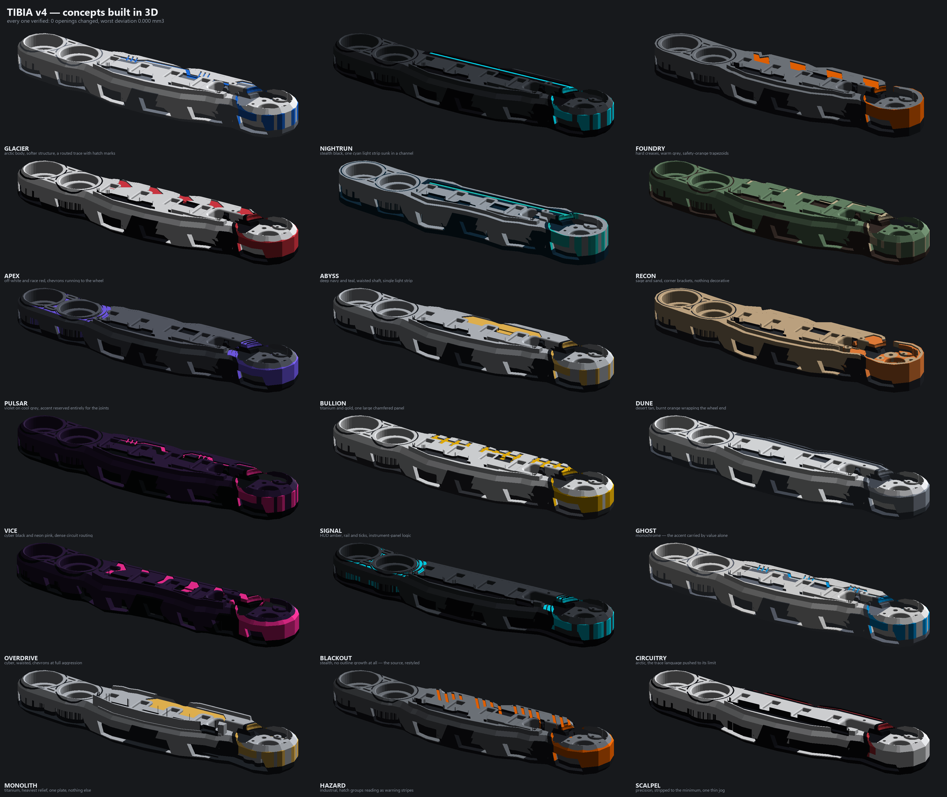
cad/aesthetics/out/renders/tibia_concepts_3d.png
