fernandomierhicks/wheeled-leg-robot/cad/solidworks_api/out/renders/box_concepts/A_helm_body_iso.png

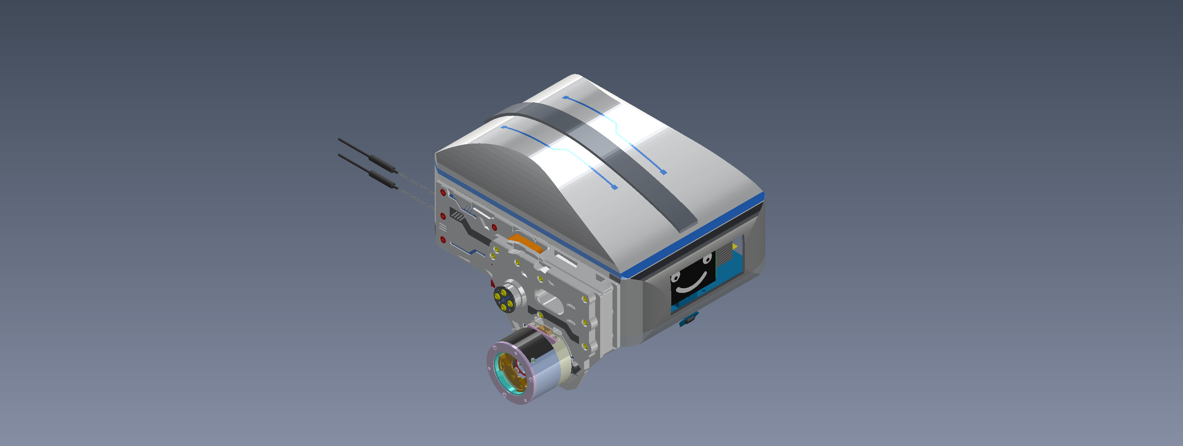
cad/solidworks_api/out/renders/box_concepts/A_helm_body_iso.png
