fernandomierhicks/wheeled-leg-robot/cad/solidworks_api/out/renders/box_concepts/B_carapace_body_back.png

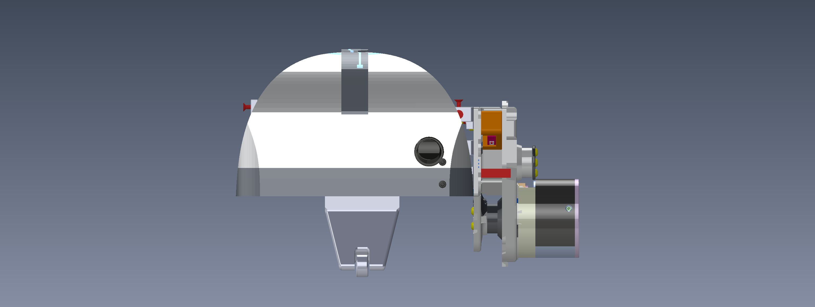
cad/solidworks_api/out/renders/box_concepts/B_carapace_body_back.png
