fernandomierhicks/wheeled-leg-robot/cad/solidworks_api/out/renders/box_concepts/B_carapace_body_face.png

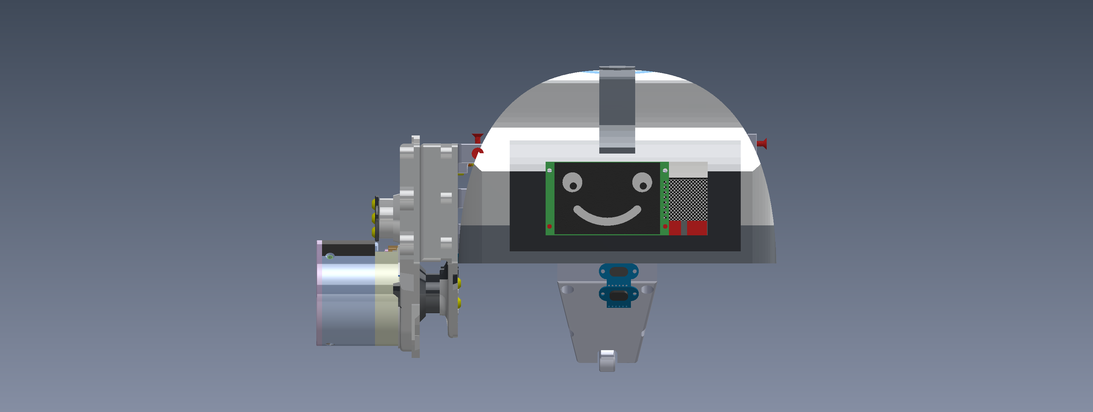
cad/solidworks_api/out/renders/box_concepts/B_carapace_body_face.png
