fernandomierhicks/wheeled-leg-robot/cad/solidworks_api/out/renders/box_concepts/board_concepts.png

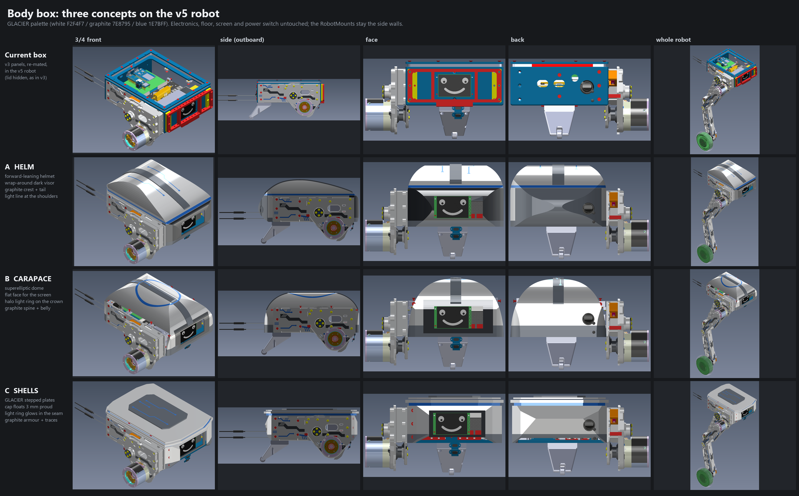
cad/solidworks_api/out/renders/box_concepts/board_concepts.png
