fernandomierhicks/wheeled-leg-robot/cad/solidworks_api/out/renders/box_concepts/C_shells_body_back.png

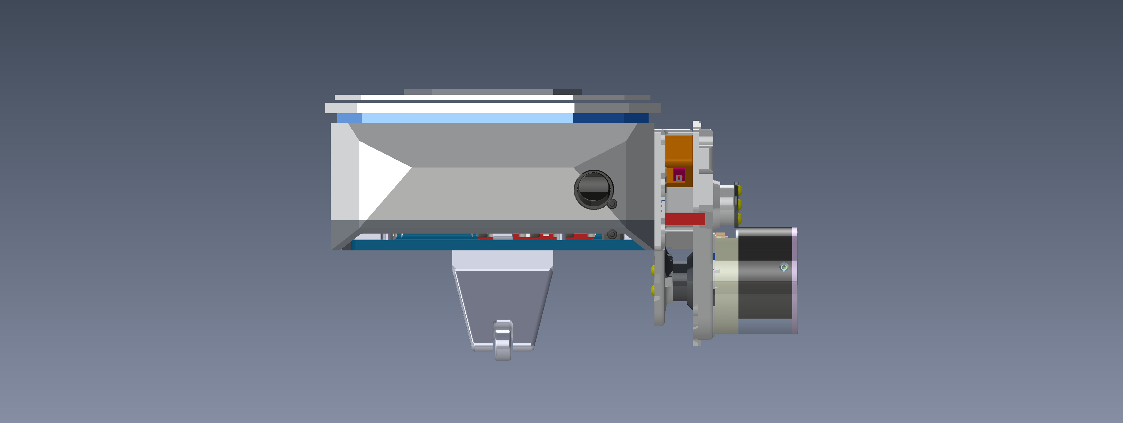
cad/solidworks_api/out/renders/box_concepts/C_shells_body_back.png
