fernandomierhicks/wheeled-leg-robot/cad/solidworks_api/out/renders/box_concepts/current_back.png

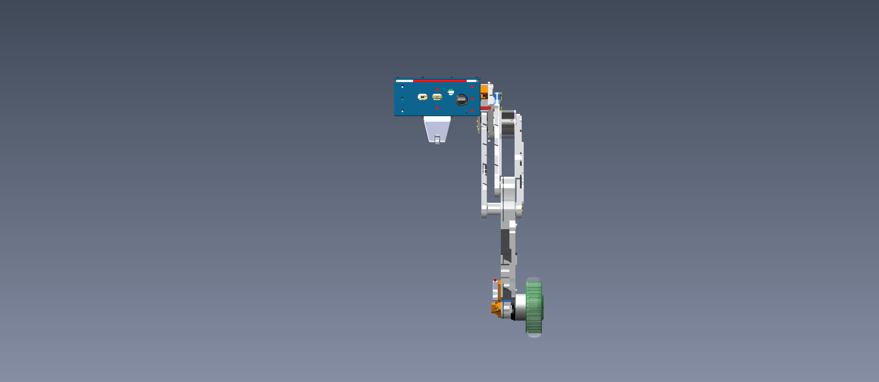
cad/solidworks_api/out/renders/box_concepts/current_back.png
