fernandomierhicks/wheeled-leg-robot/cad/solidworks_api/out/renders/box_concepts/current_body_top.png

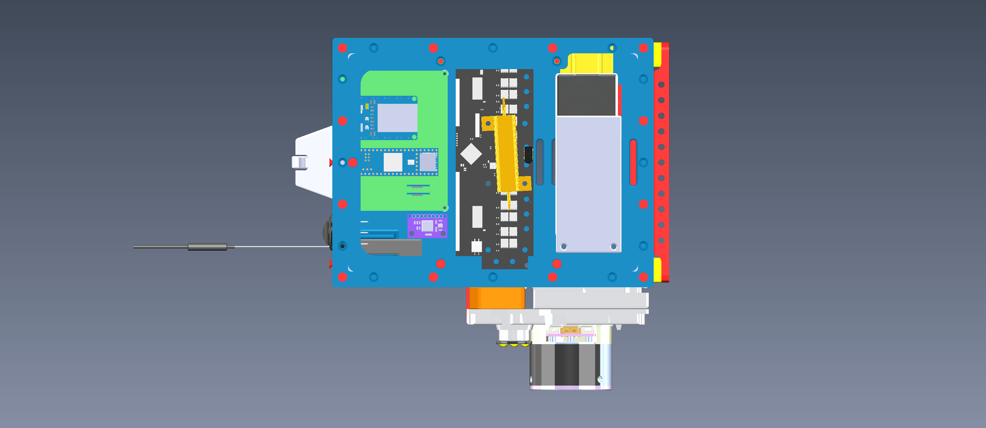
cad/solidworks_api/out/renders/box_concepts/current_body_top.png
