fernandomierhicks/wheeled-leg-robot/cad/solidworks_api/out/renders/box_concepts/D_facet_body_back.png

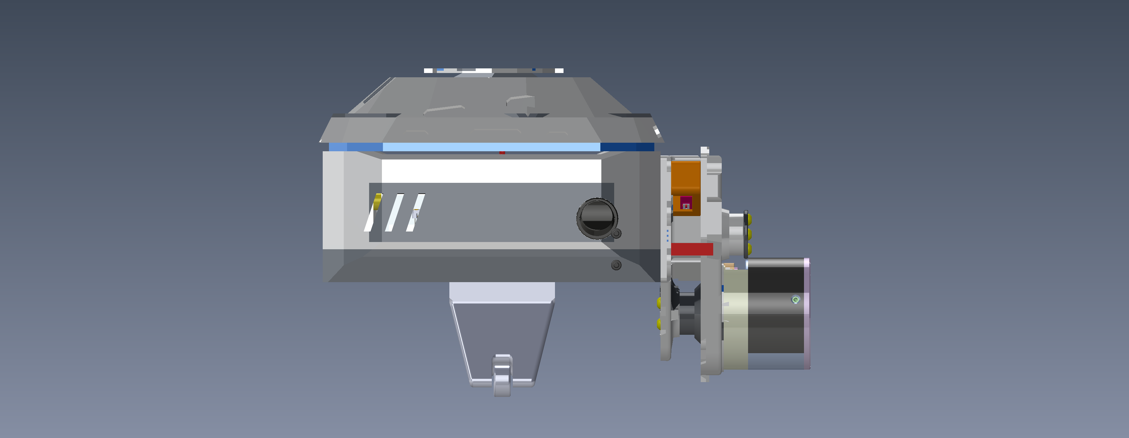
cad/solidworks_api/out/renders/box_concepts/D_facet_body_back.png
