fernandomierhicks/wheeled-leg-robot/cad/solidworks_api/out/renders/box_concepts/D_facet_body_iso.png

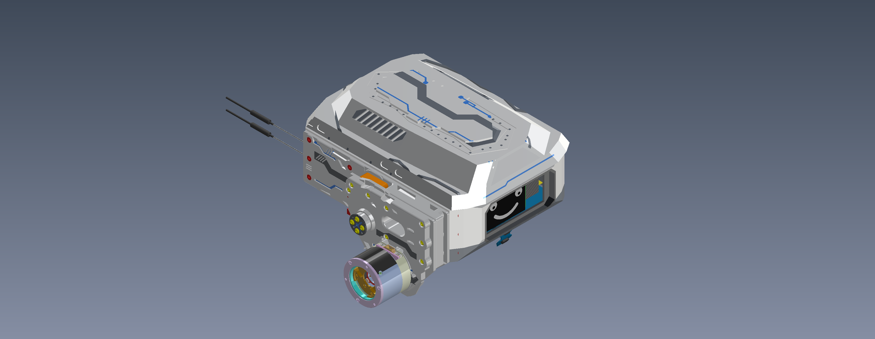
cad/solidworks_api/out/renders/box_concepts/D_facet_body_iso.png
