fernandomierhicks/wheeled-leg-robot/cad/solidworks_api/out/renders/box_concepts/D_facet_body_side.png

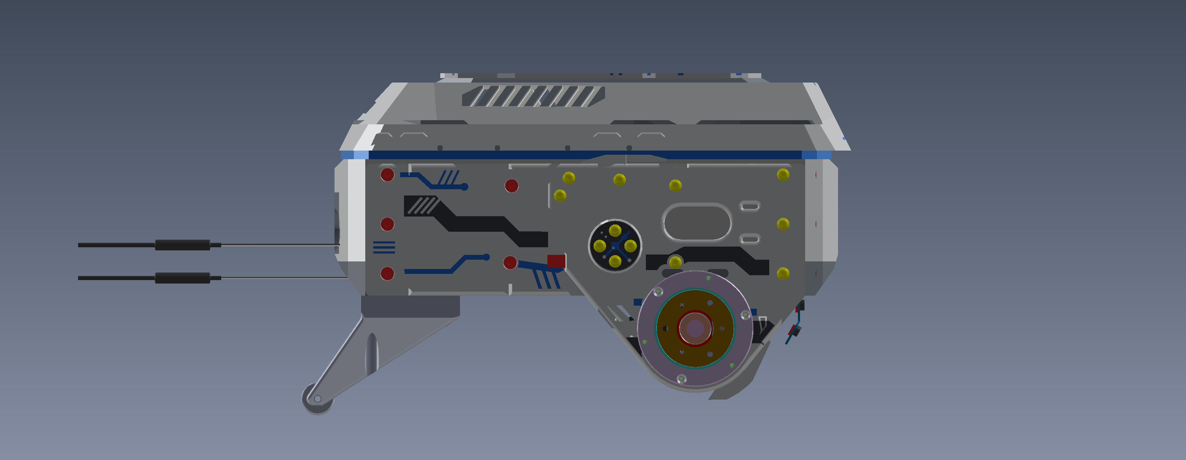
cad/solidworks_api/out/renders/box_concepts/D_facet_body_side.png
