fernandomierhicks/wheeled-leg-robot/cad/solidworks_api/out/renders/box_concepts/preview_A_helm.png

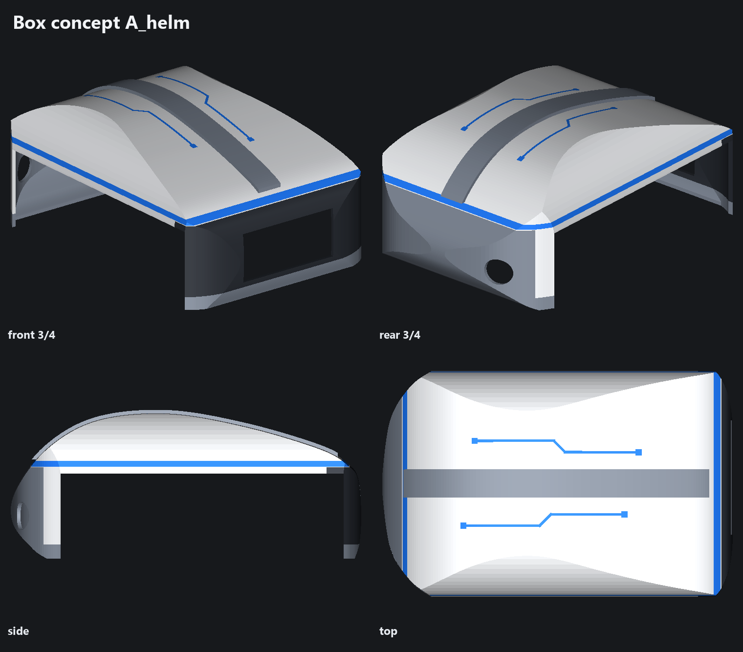
cad/solidworks_api/out/renders/box_concepts/preview_A_helm.png
