fernandomierhicks/wheeled-leg-robot/cad/solidworks_api/out/renders/box_concepts/preview_B_carapace.png

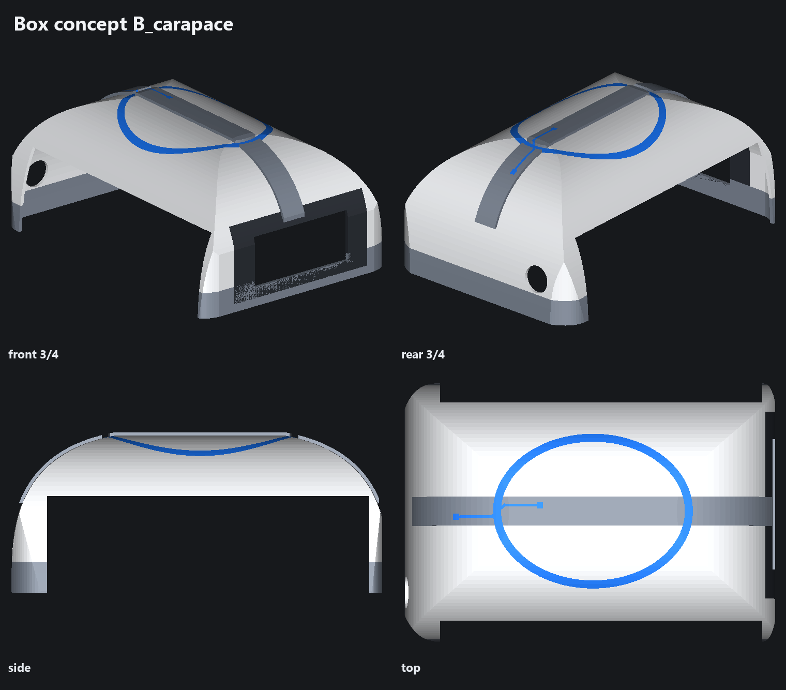
cad/solidworks_api/out/renders/box_concepts/preview_B_carapace.png
