fernandomierhicks/wheeled-leg-robot/cad/solidworks_api/out/renders/box_concepts/preview_C_shells.png

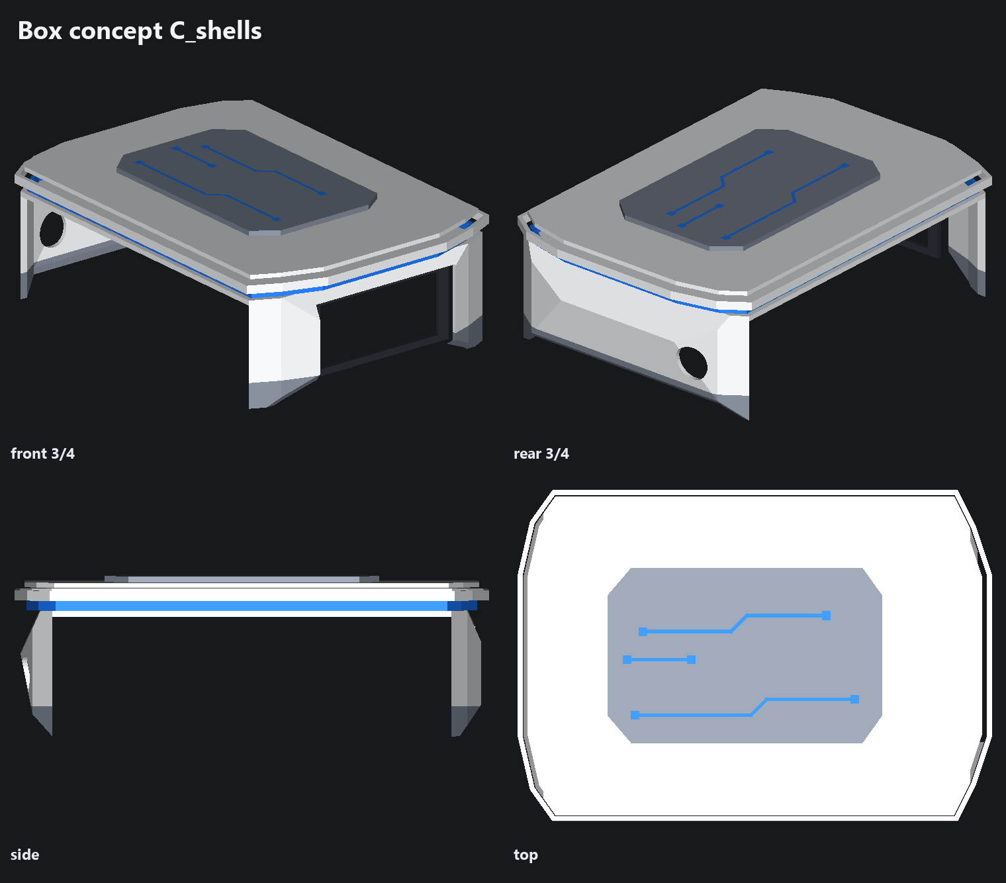
cad/solidworks_api/out/renders/box_concepts/preview_C_shells.png
