fernandomierhicks/wheeled-leg-robot/cad/solidworks_api/out/renders/box_concepts/preview_D_facet.png

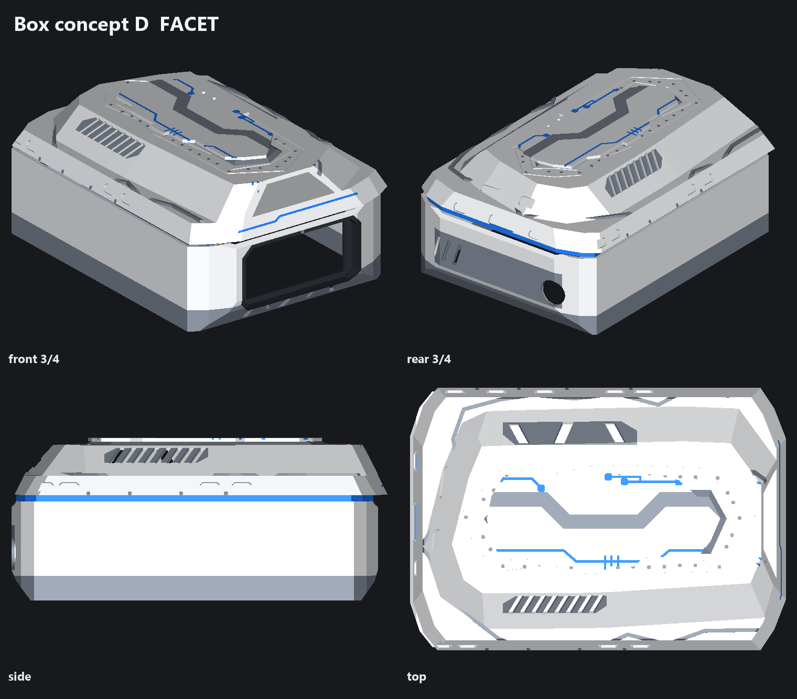
cad/solidworks_api/out/renders/box_concepts/preview_D_facet.png
