fernandomierhicks/wheeled-leg-robot/cad/solidworks_api/out/renders/bumpers_A_board.png

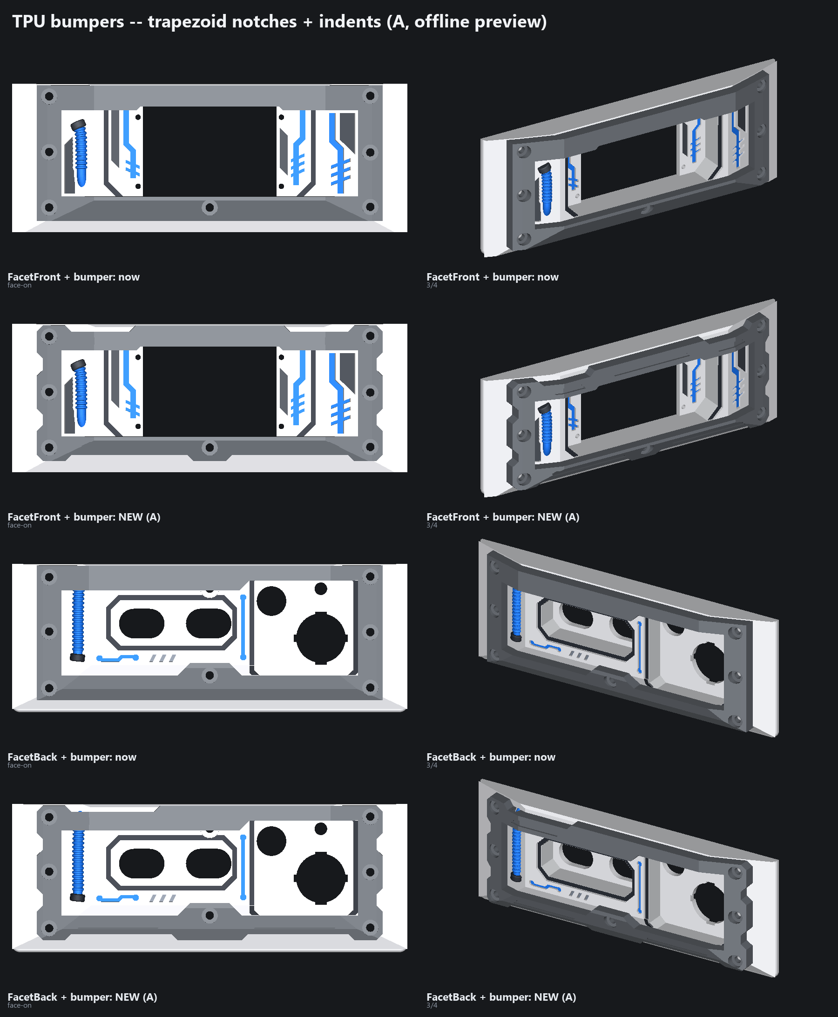
cad/solidworks_api/out/renders/bumpers_A_board.png
