fernandomierhicks/wheeled-leg-robot/cad/solidworks_api/out/renders/encoder_context.png

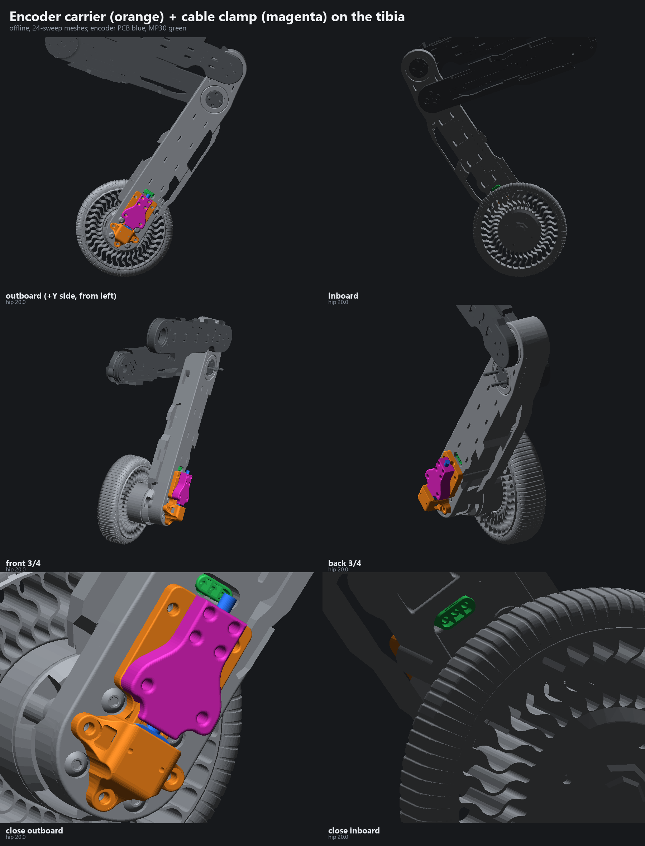
cad/solidworks_api/out/renders/encoder_context.png
