fernandomierhicks/wheeled-leg-robot/cad/solidworks_api/out/renders/encoder_inboard.png

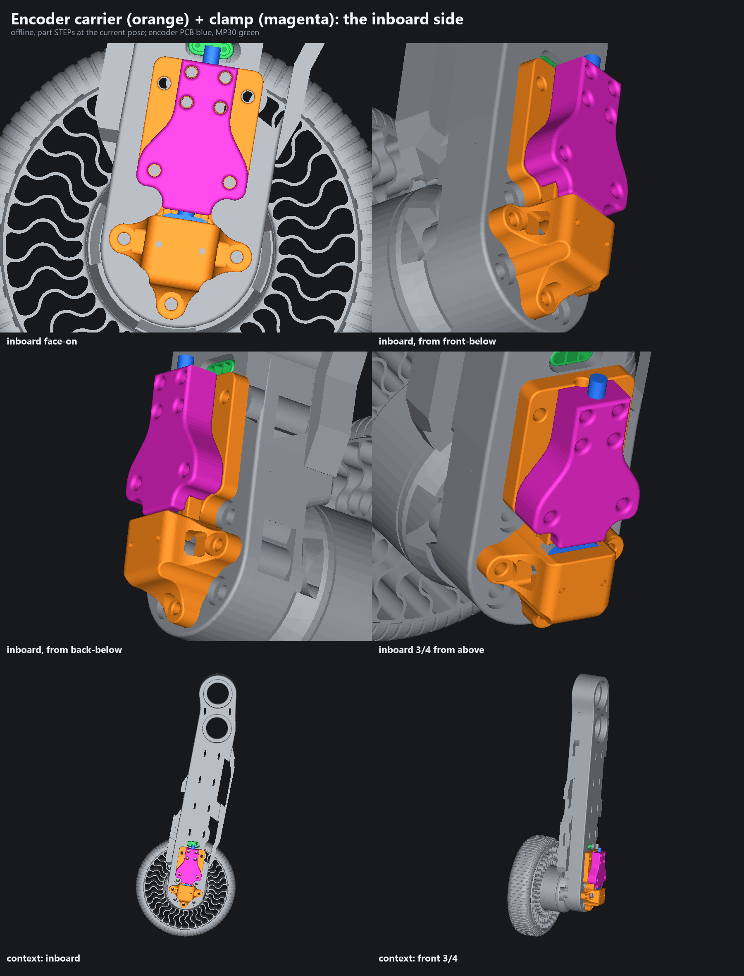
cad/solidworks_api/out/renders/encoder_inboard.png
