fernandomierhicks/wheeled-leg-robot/cad/solidworks_api/out/renders/encoder_style_B.png

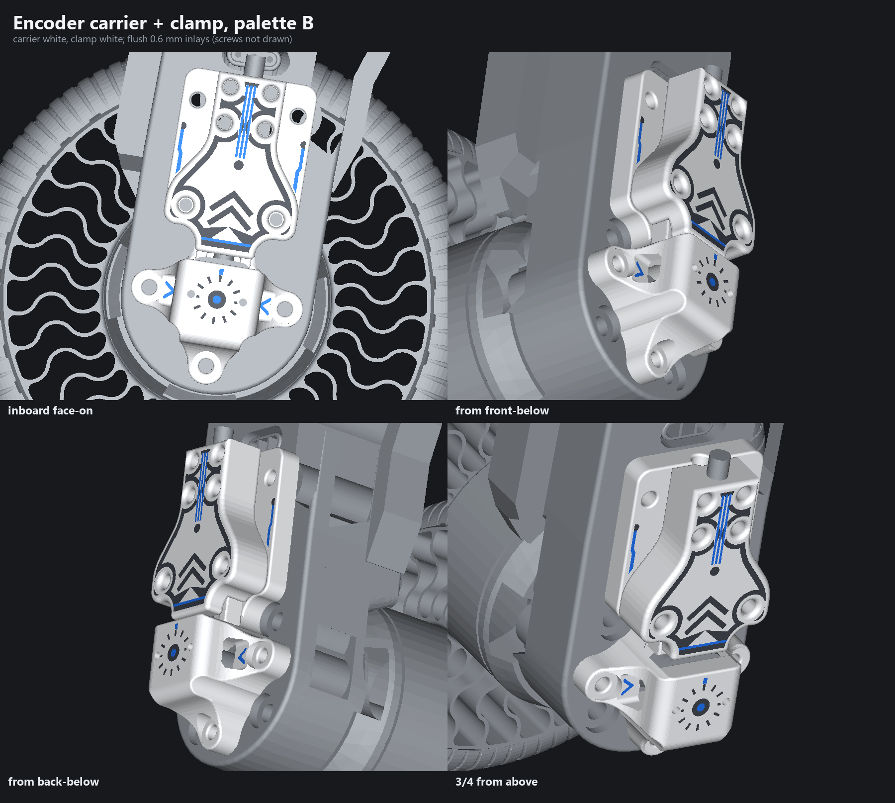
cad/solidworks_api/out/renders/encoder_style_B.png
