fernandomierhicks/wheeled-leg-robot/cad/solidworks_api/out/renders/encoder_style_B_faces.png

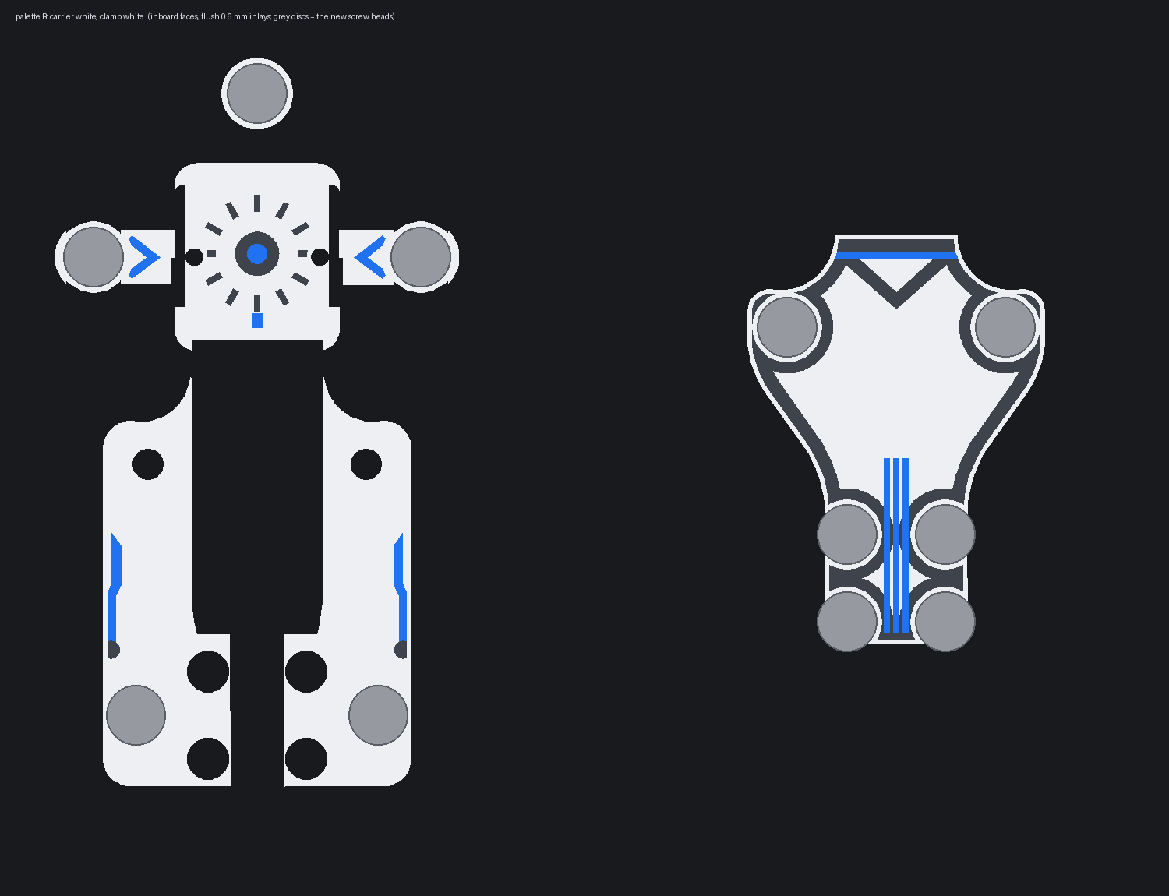
cad/solidworks_api/out/renders/encoder_style_B_faces.png
