fernandomierhicks/wheeled-leg-robot/cad/solidworks_api/out/renders/facet_front_round5_board.png

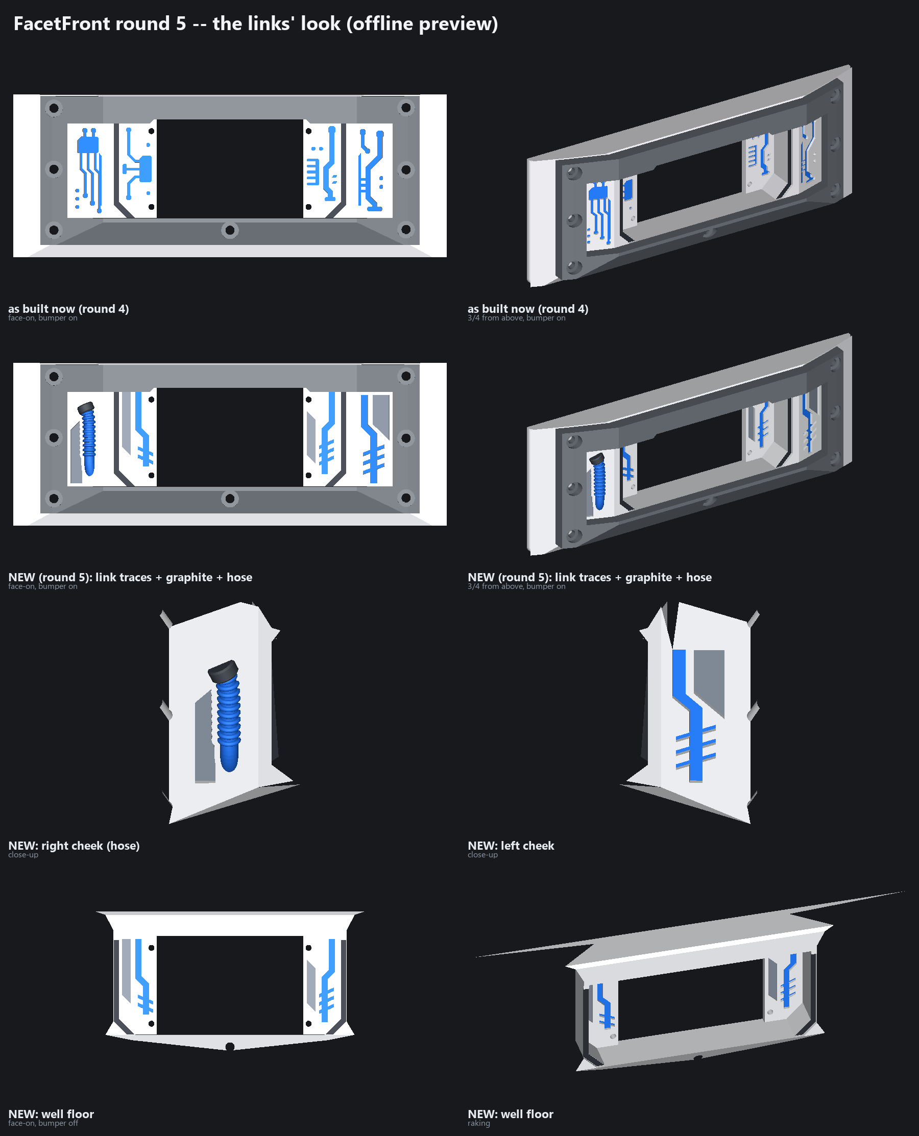
cad/solidworks_api/out/renders/facet_front_round5_board.png
