fernandomierhicks/wheeled-leg-robot/cad/solidworks_api/out/renders/hood_one_colour_board.png

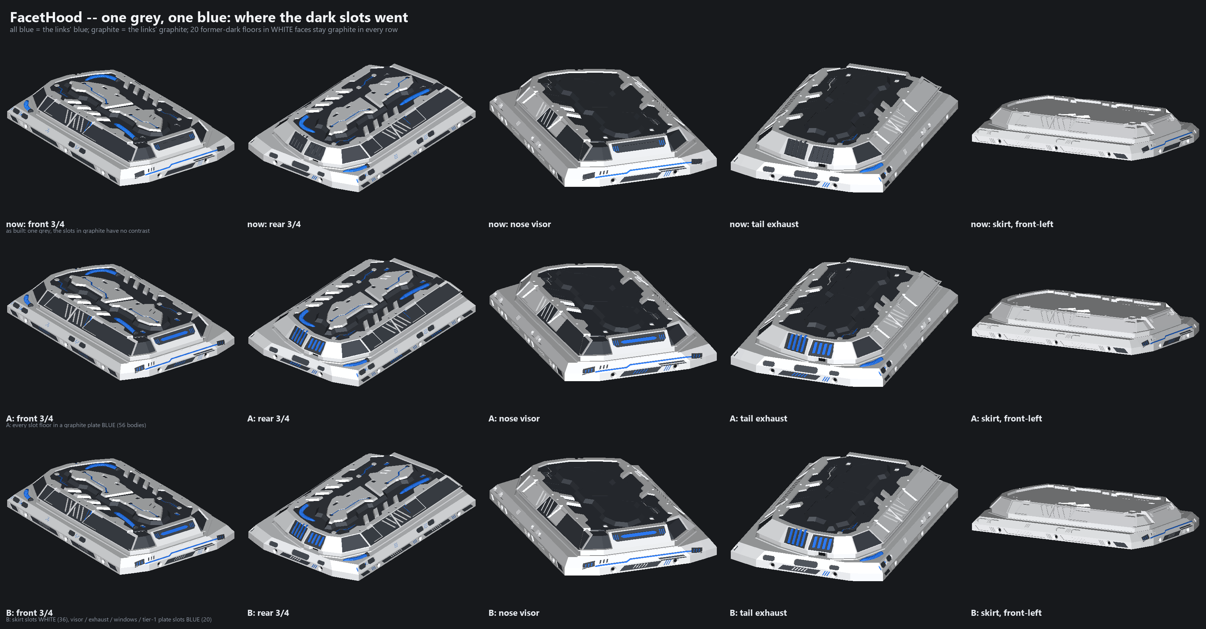
cad/solidworks_api/out/renders/hood_one_colour_board.png
