fernandomierhicks/wheeled-leg-robot/cad/solidworks_api/out/renders/hood_one_colour_built.png

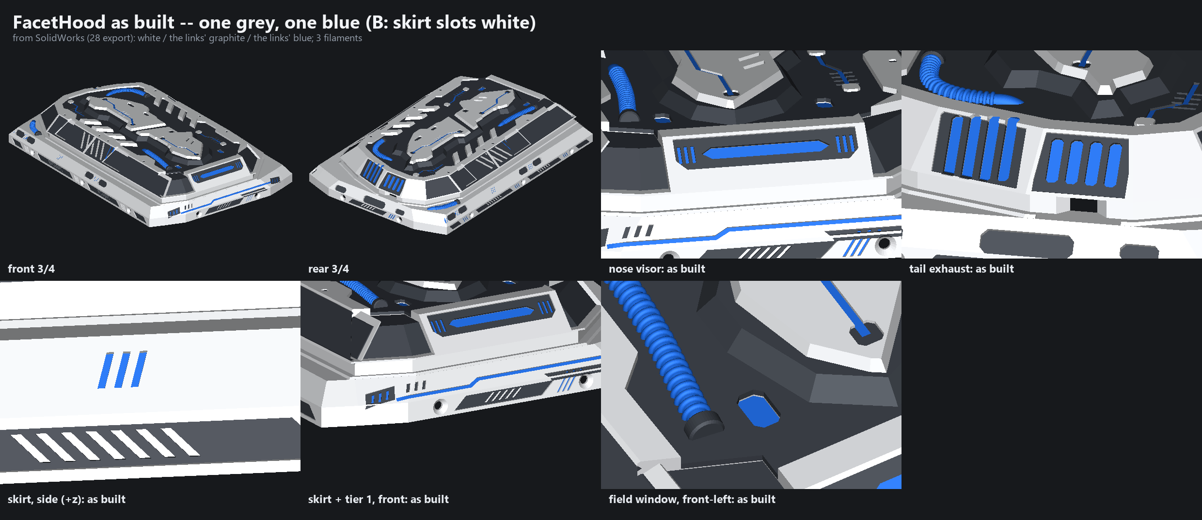
cad/solidworks_api/out/renders/hood_one_colour_built.png
