fernandomierhicks/wheeled-leg-robot/cad/solidworks_api/out/renders/hood_variants/board_204518.png

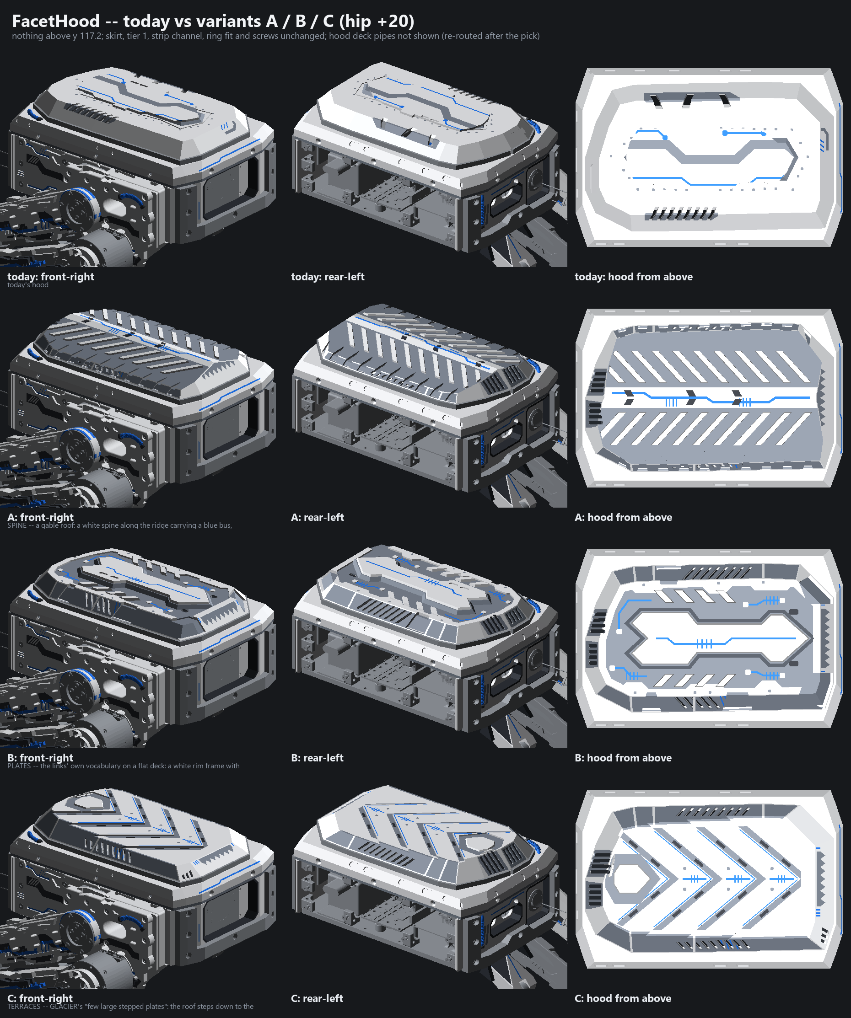
cad/solidworks_api/out/renders/hood_variants/board_204518.png
