fernandomierhicks/wheeled-leg-robot/cad/solidworks_api/out/renders/hood_variants/board_212953.png

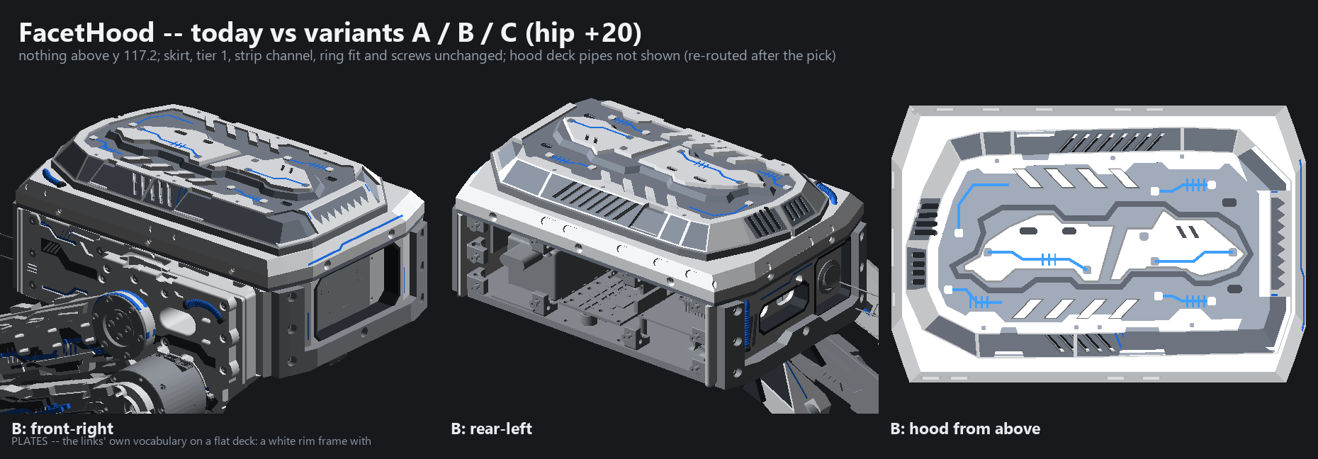
cad/solidworks_api/out/renders/hood_variants/board_212953.png
