fernandomierhicks/wheeled-leg-robot/cad/solidworks_api/out/renders/hood_variants/hood_A_203952.png

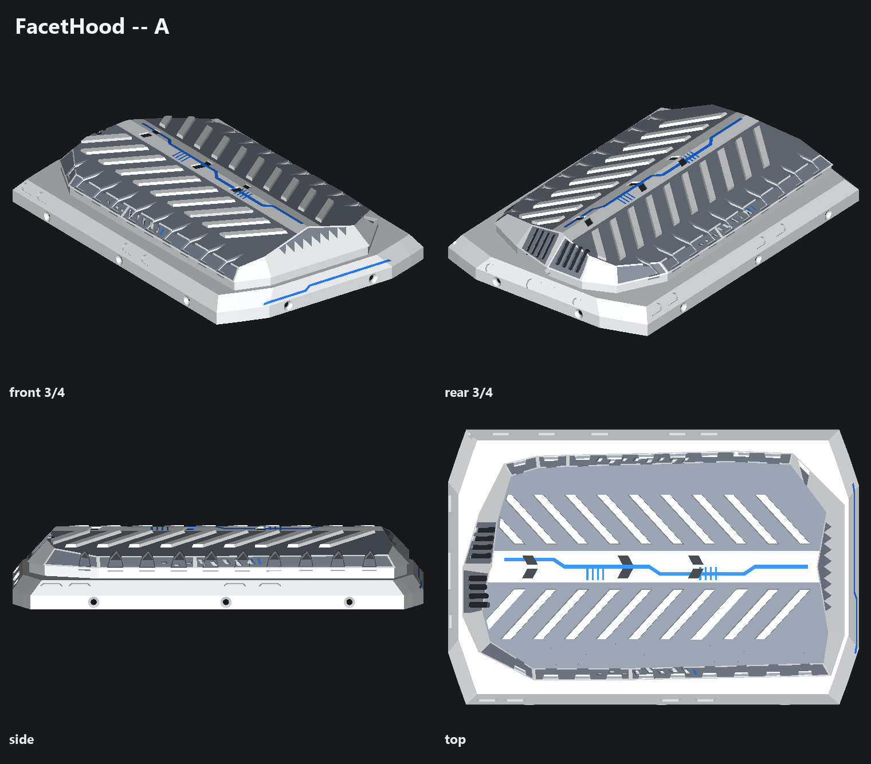
cad/solidworks_api/out/renders/hood_variants/hood_A_203952.png
