fernandomierhicks/wheeled-leg-robot/cad/solidworks_api/out/renders/hood_variants/hood_B_204054.png

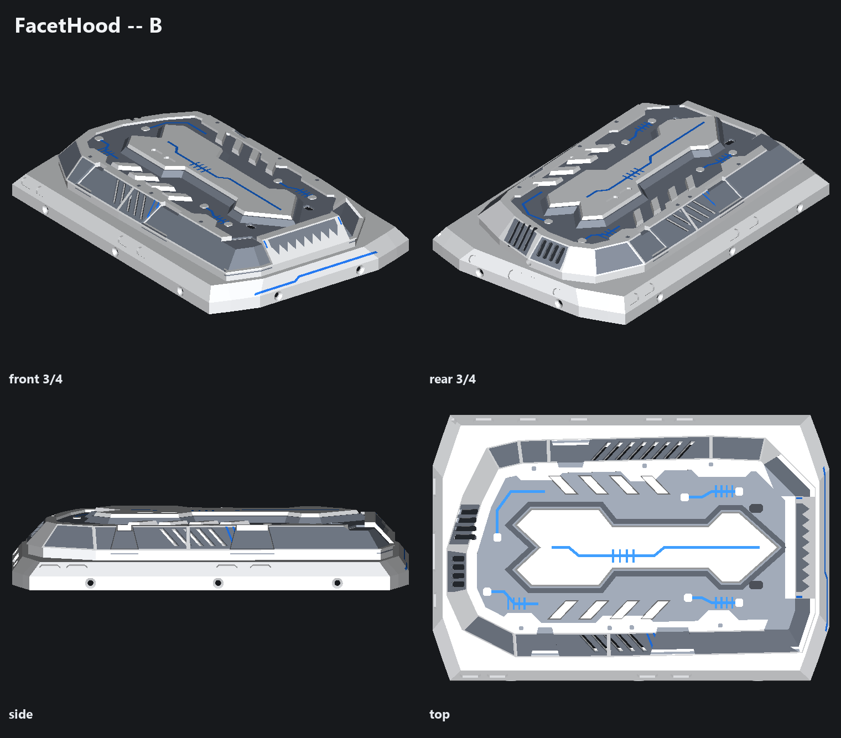
cad/solidworks_api/out/renders/hood_variants/hood_B_204054.png
