fernandomierhicks/wheeled-leg-robot/cad/solidworks_api/out/renders/hood_variants/hood_C_204137.png

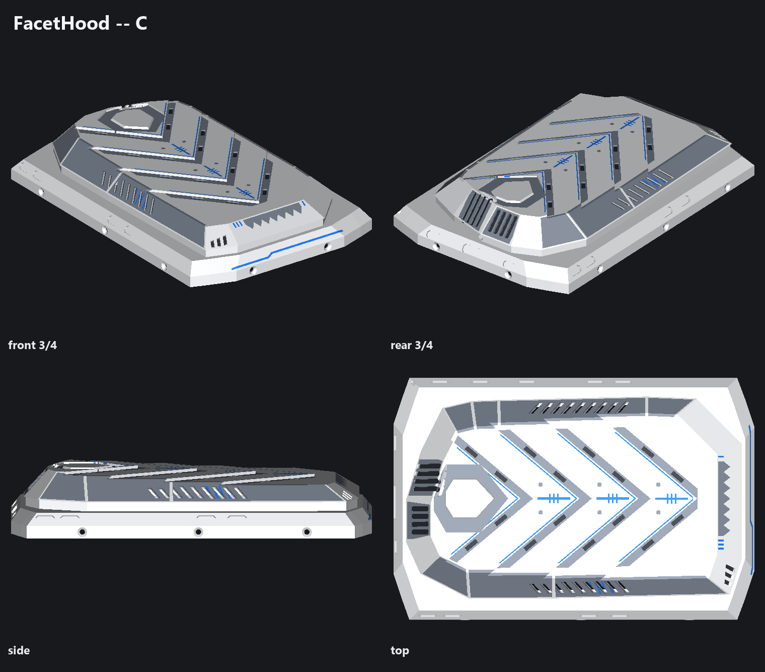
cad/solidworks_api/out/renders/hood_variants/hood_C_204137.png
