fernandomierhicks/wheeled-leg-robot/cad/solidworks_api/out/renders/hood_variants/hood_now_203824.png

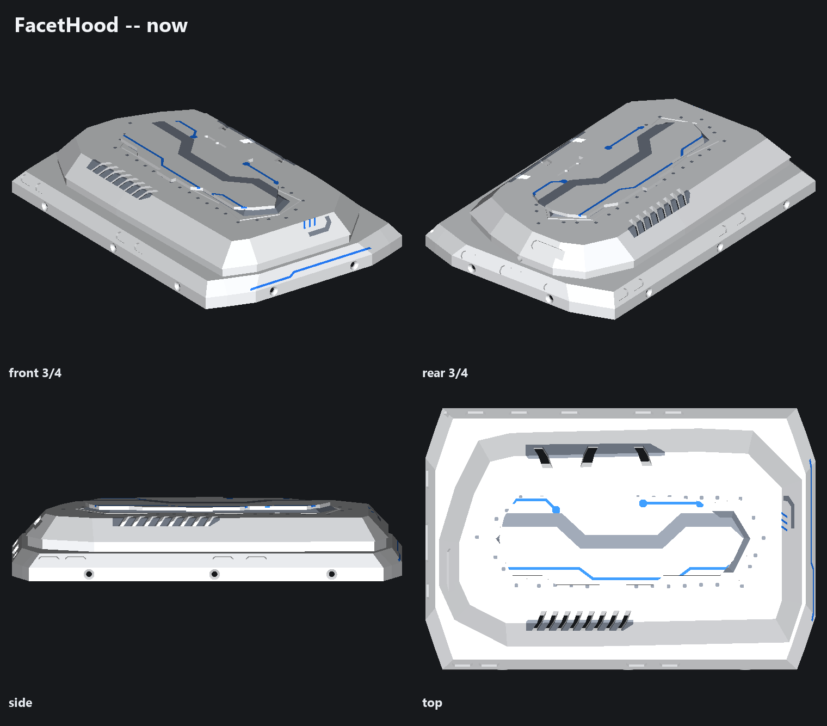
cad/solidworks_api/out/renders/hood_variants/hood_now_203824.png
