fernandomierhicks/wheeled-leg-robot/cad/solidworks_api/out/renders/part_BearingWasher_bottom.png

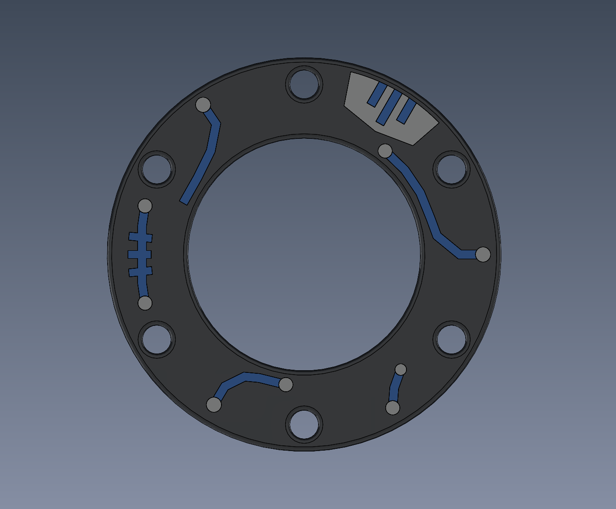
cad/solidworks_api/out/renders/part_BearingWasher_bottom.png
