fernandomierhicks/wheeled-leg-robot/cad/solidworks_api/out/renders/part_Coupler_back.png

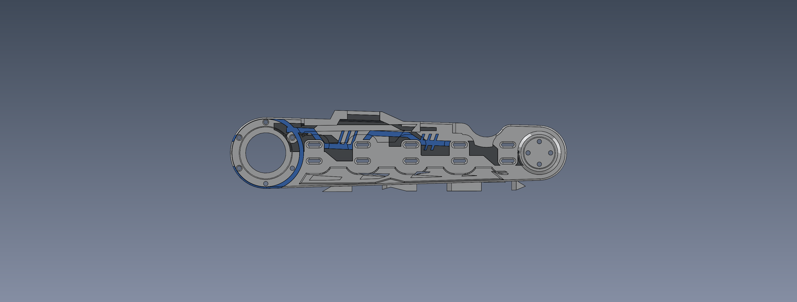
cad/solidworks_api/out/renders/part_Coupler_back.png
