fernandomierhicks/wheeled-leg-robot/cad/solidworks_api/out/renders/part_Coupler_front.png

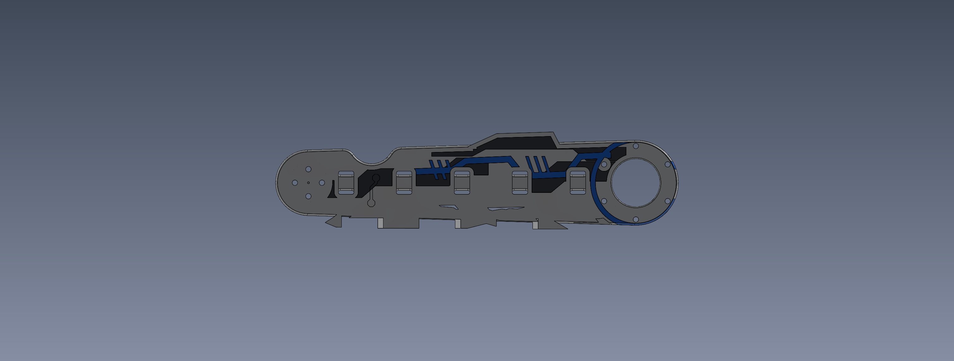
cad/solidworks_api/out/renders/part_Coupler_front.png
