fernandomierhicks/wheeled-leg-robot/cad/solidworks_api/out/renders/part_Femur_inside_trimetric.png

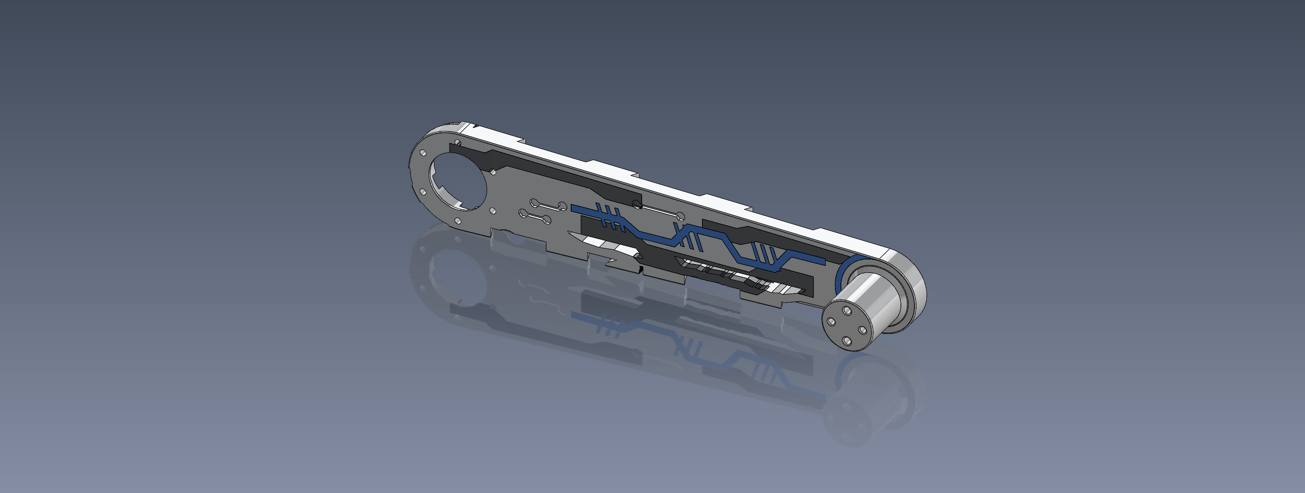
cad/solidworks_api/out/renders/part_Femur_inside_trimetric.png
