fernandomierhicks/wheeled-leg-robot/cad/solidworks_api/out/renders/part_InsideFemurShaft_top.png

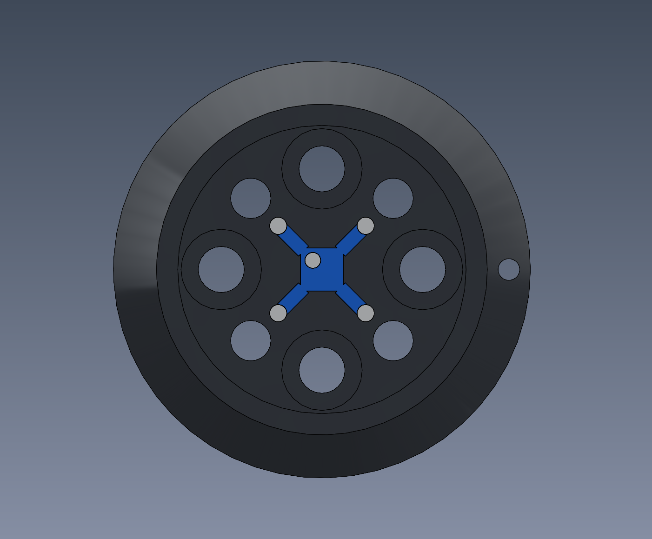
cad/solidworks_api/out/renders/part_InsideFemurShaft_top.png
