fernandomierhicks/wheeled-leg-robot/cad/solidworks_api/out/renders/part_InsideFemurShaft_trimetric.png

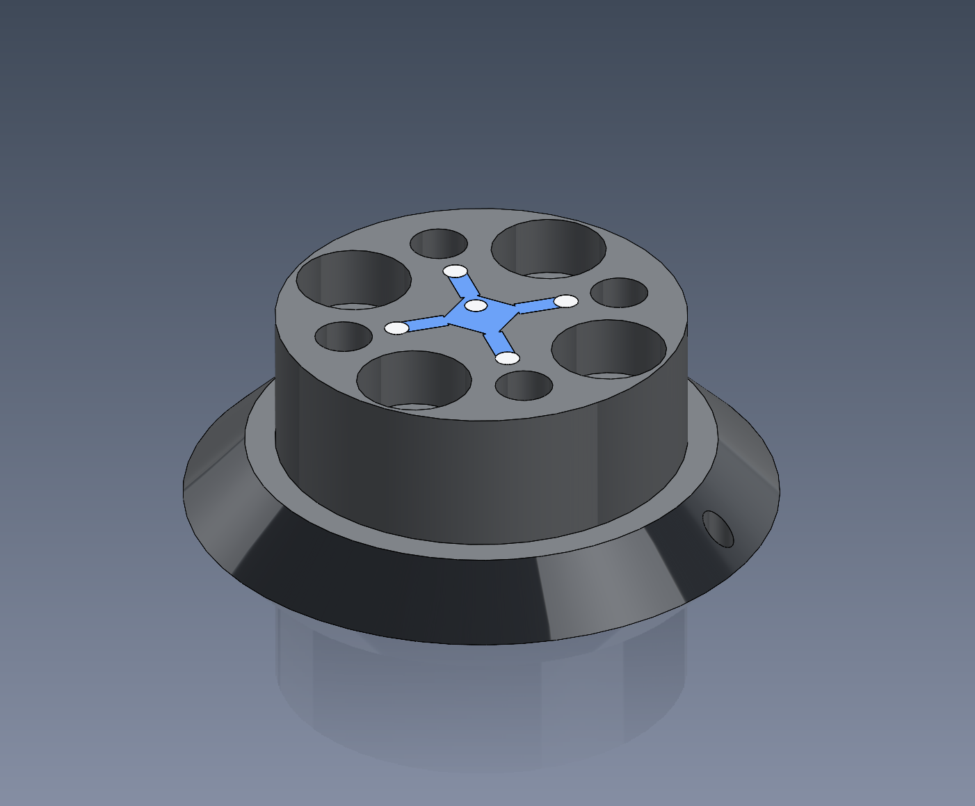
cad/solidworks_api/out/renders/part_InsideFemurShaft_trimetric.png
