fernandomierhicks/wheeled-leg-robot/cad/solidworks_api/out/renders/part_RobotMount_back.png

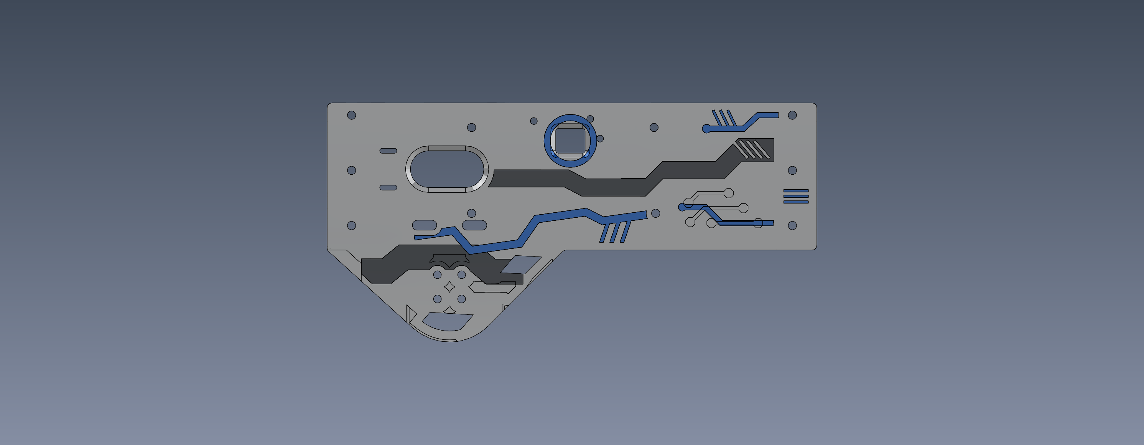
cad/solidworks_api/out/renders/part_RobotMount_back.png
