fernandomierhicks/wheeled-leg-robot/cad/solidworks_api/out/renders/part_Side_panel_front.png

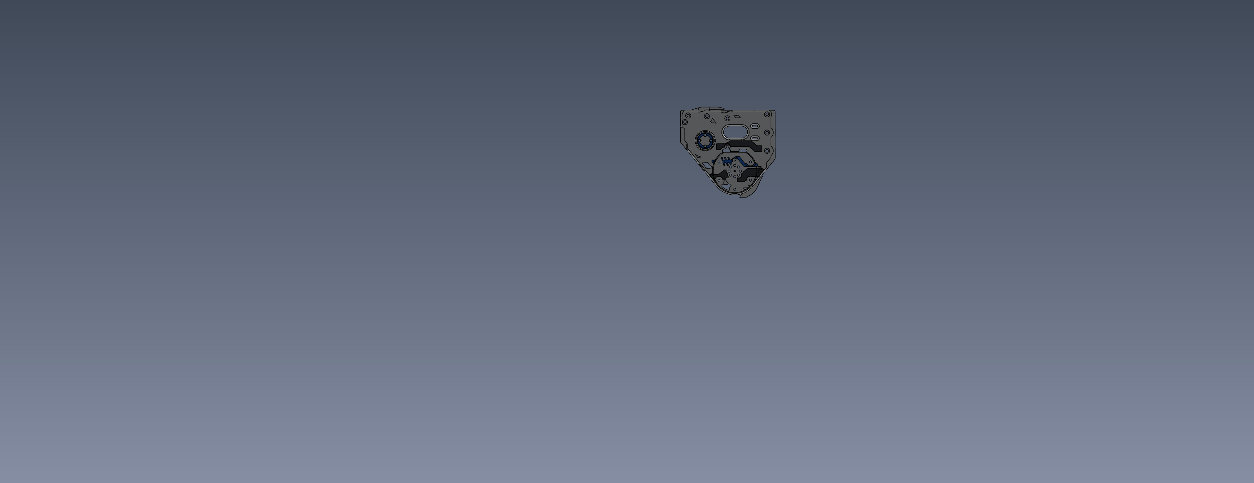
cad/solidworks_api/out/renders/part_Side_panel_front.png
