fernandomierhicks/wheeled-leg-robot/cad/solidworks_api/out/renders/part_Side_panel_trimetric.png

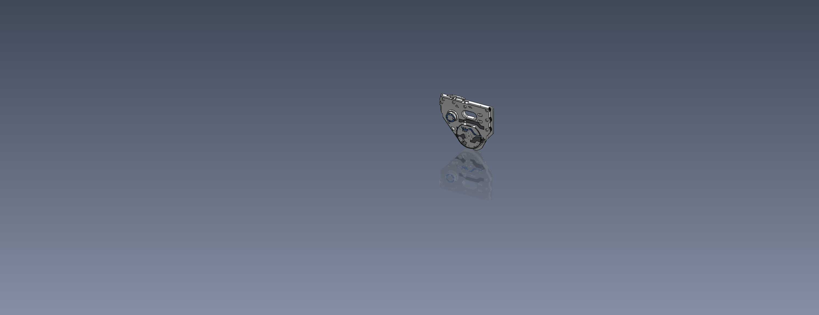
cad/solidworks_api/out/renders/part_Side_panel_trimetric.png
