fernandomierhicks/wheeled-leg-robot/cad/solidworks_api/out/renders/part_Tibia_back.png

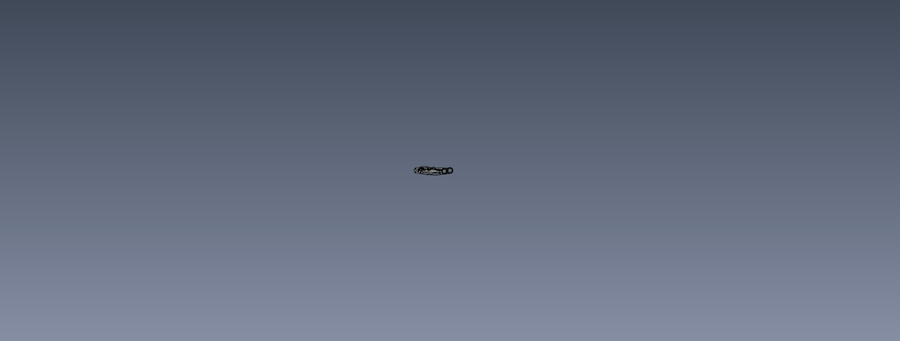
cad/solidworks_api/out/renders/part_Tibia_back.png
