fernandomierhicks/wheeled-leg-robot/cad/solidworks_api/out/renders/robot_full_front.png

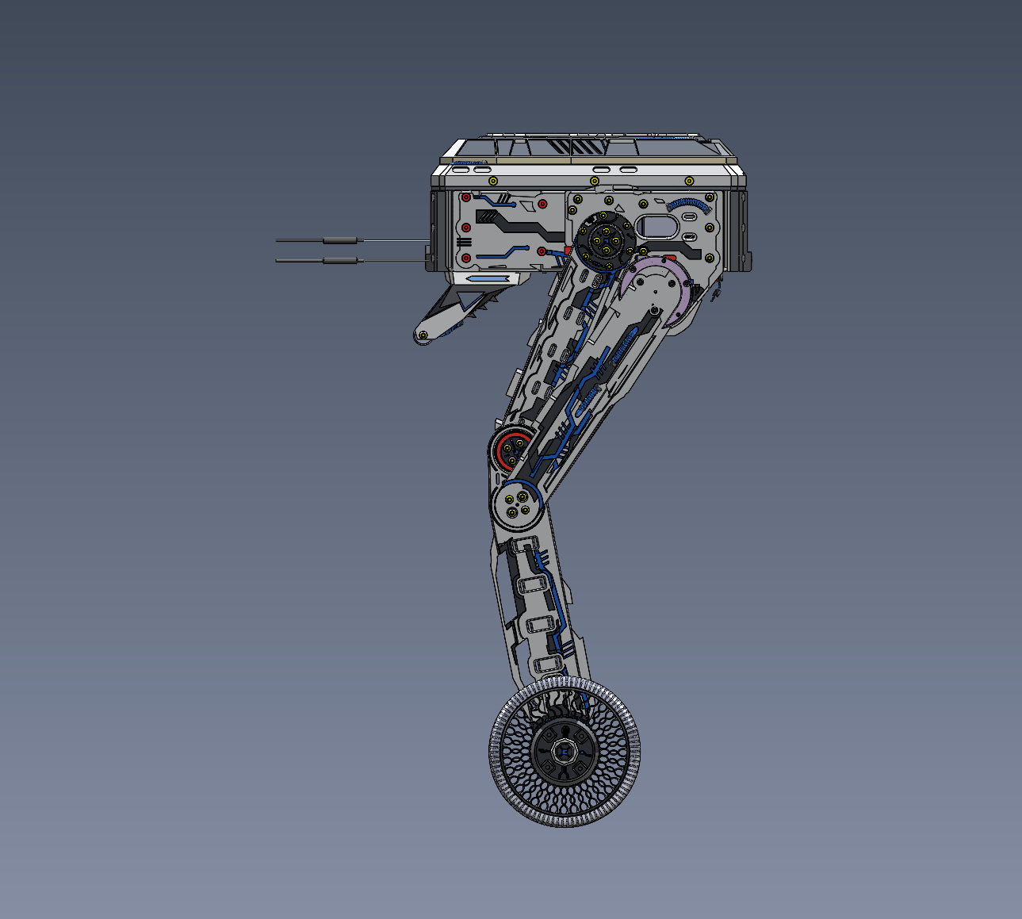
cad/solidworks_api/out/renders/robot_full_front.png
