fernandomierhicks/wheeled-leg-robot/cad/solidworks_api/out/renders/robot_full_isometric.png

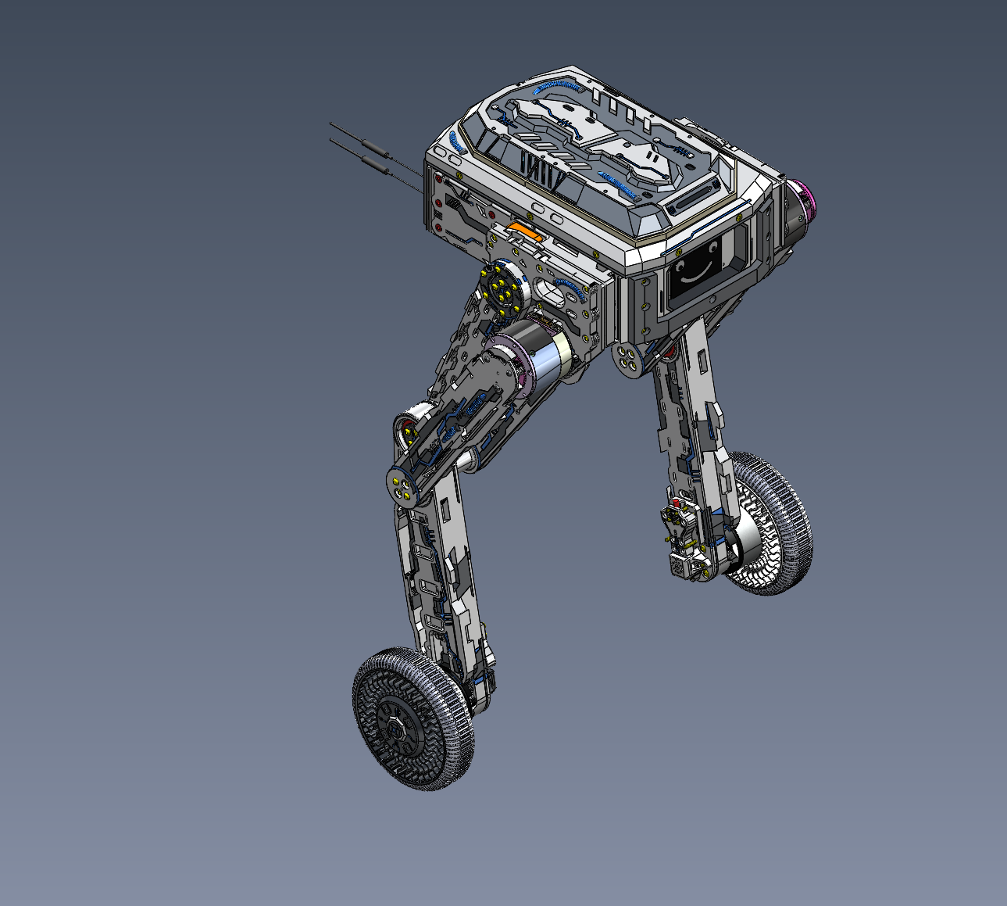
cad/solidworks_api/out/renders/robot_full_isometric.png
