fernandomierhicks/wheeled-leg-robot/cad/solidworks_api/out/renders/tail_strut_box_below.png

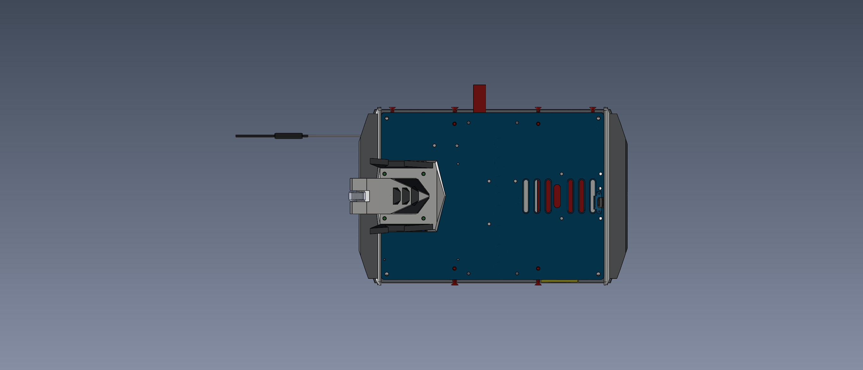
cad/solidworks_api/out/renders/tail_strut_box_below.png
