fernandomierhicks/wheeled-leg-robot/cad/solidworks_api/out/renders/tail_strut_box_side.png

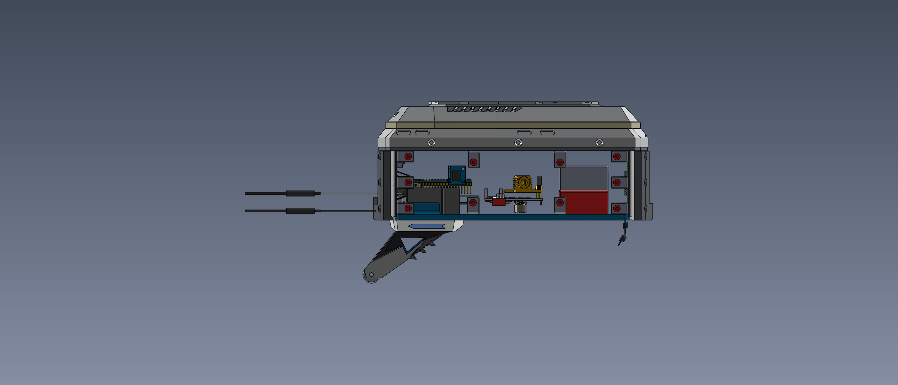
cad/solidworks_api/out/renders/tail_strut_box_side.png
