fernandomierhicks/wheeled-leg-robot/cad/solidworks_api/out/renders/tail_strut_preview.png

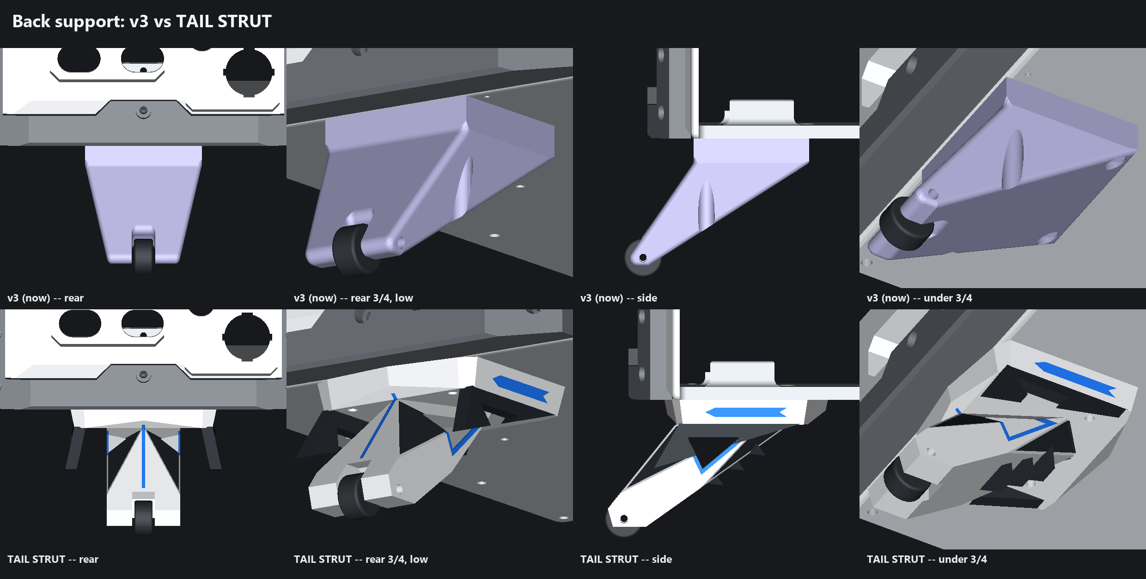
cad/solidworks_api/out/renders/tail_strut_preview.png
