fernandomierhicks/wheeled-leg-robot/cad/solidworks_api/out/renders/tail_strut_robot_side.png

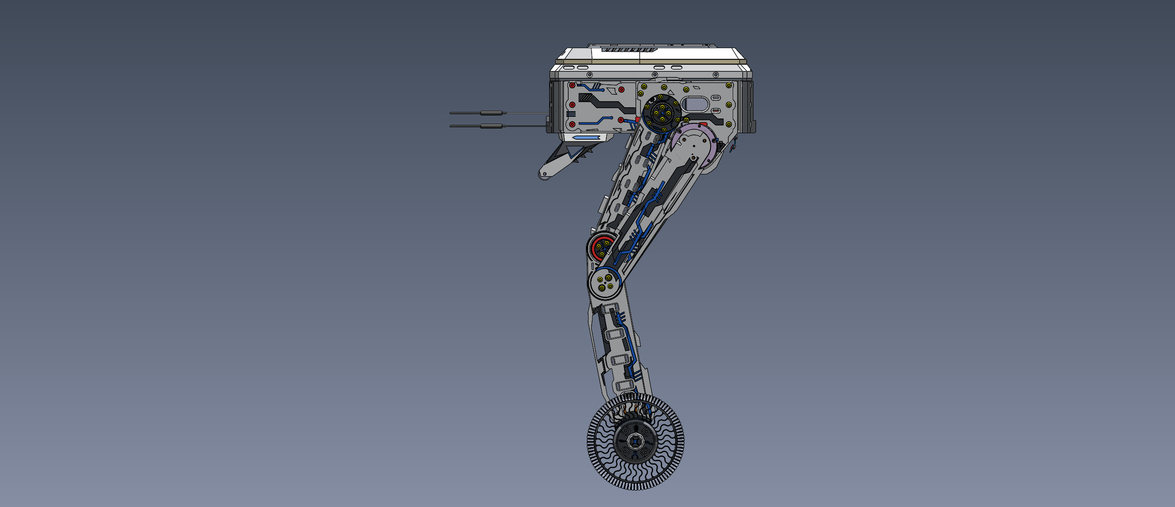
cad/solidworks_api/out/renders/tail_strut_robot_side.png
