fernandomierhicks/wheeled-leg-robot/cad/solidworks_api/out/renders/tailstrut_trapezoids.png

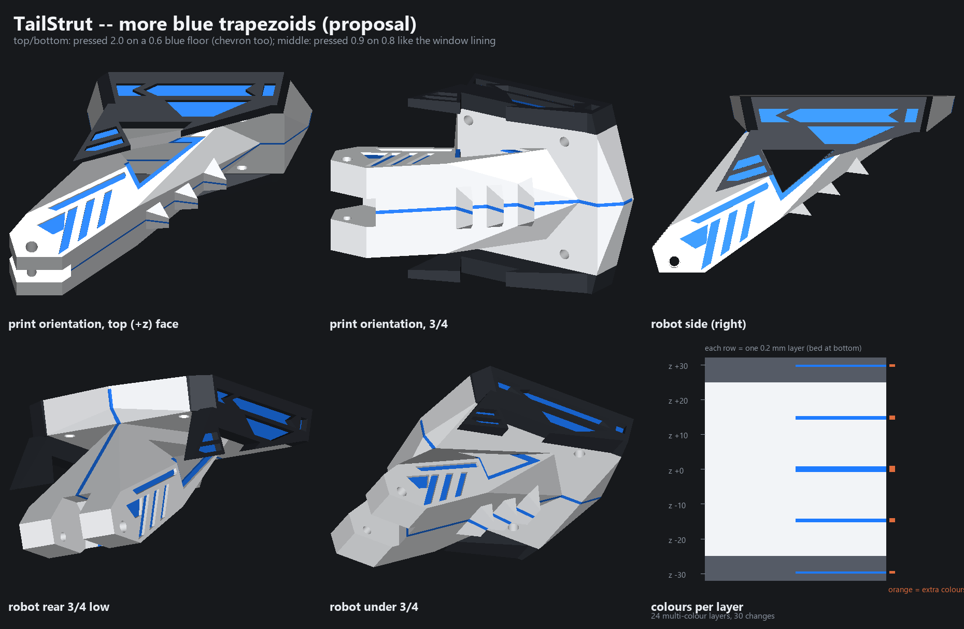
cad/solidworks_api/out/renders/tailstrut_trapezoids.png
