fernandomierhicks/wheeled-leg-robot/cad/solidworks_api/out/renders/tyrelock_rim_top.png

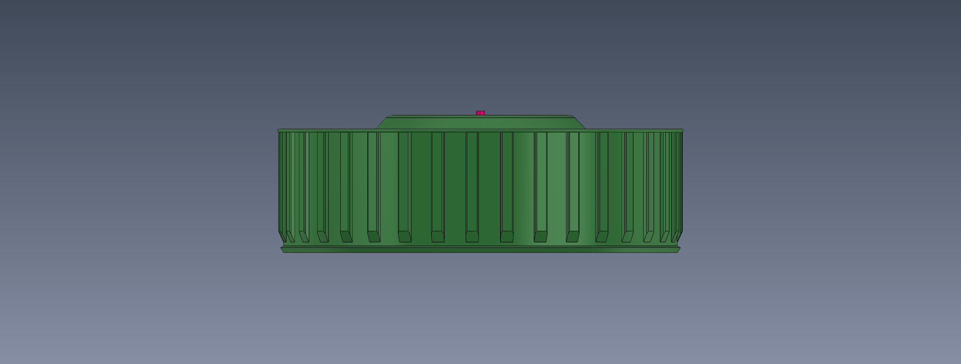
cad/solidworks_api/out/renders/tyrelock_rim_top.png
