fernandomierhicks/wheeled-leg-robot/cad/solidworks_api/out/renders/tyrelock_tyre_front.png

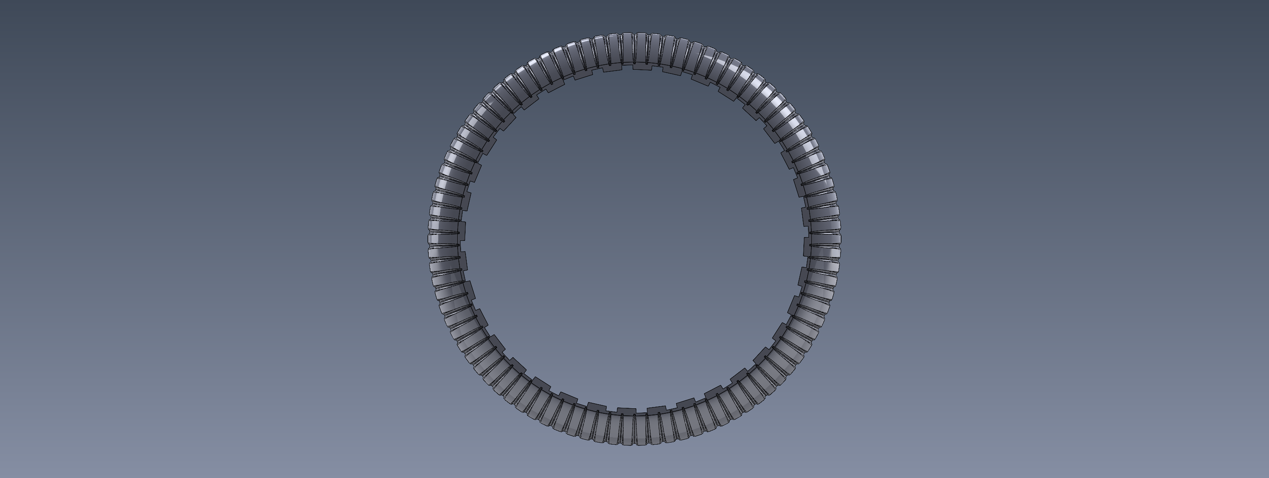
cad/solidworks_api/out/renders/tyrelock_tyre_front.png
