fernandomierhicks/wheeled-leg-robot/cad/solidworks_api/out/renders/tyrelock_tyre_trimetric.png

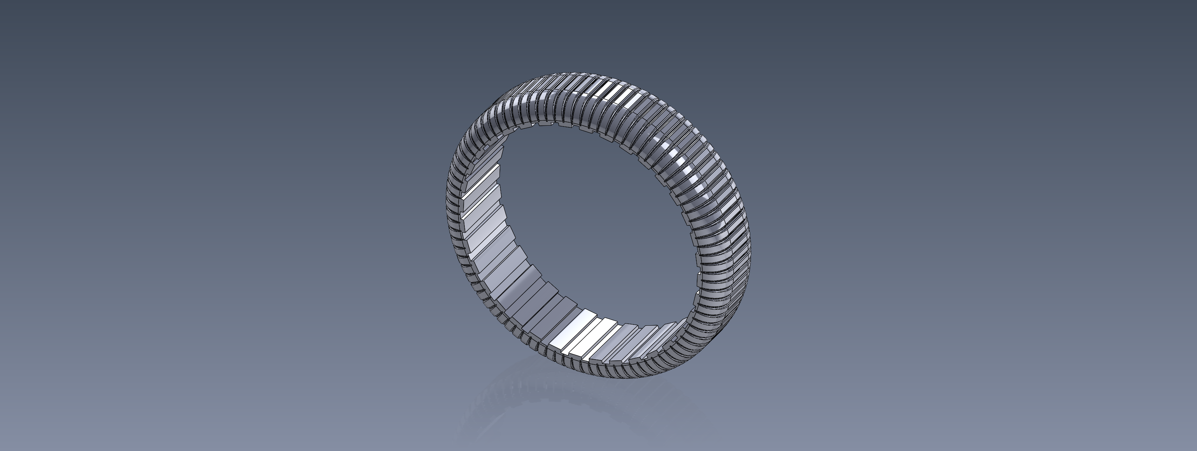
cad/solidworks_api/out/renders/tyrelock_tyre_trimetric.png
