fernandomierhicks/wheeled-leg-robot/cad/solidworks_api/out/renders/tyrelock_wheel_asm_front.png

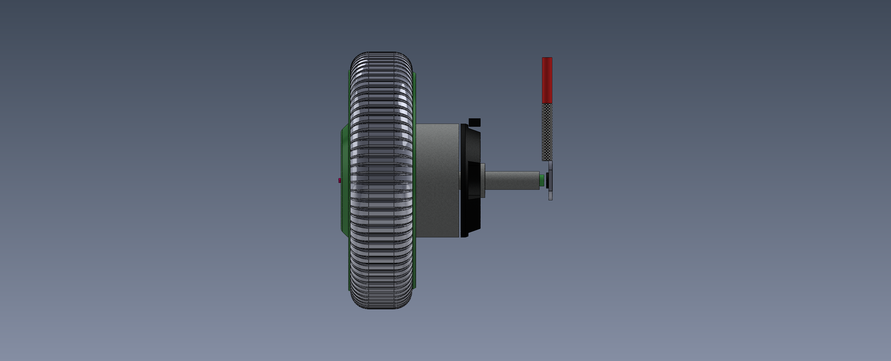
cad/solidworks_api/out/renders/tyrelock_wheel_asm_front.png
