fernandomierhicks/wheeled-leg-robot/cad/solidworks_api/out/renders/tyrelock_wheel_asm_trimetric.png

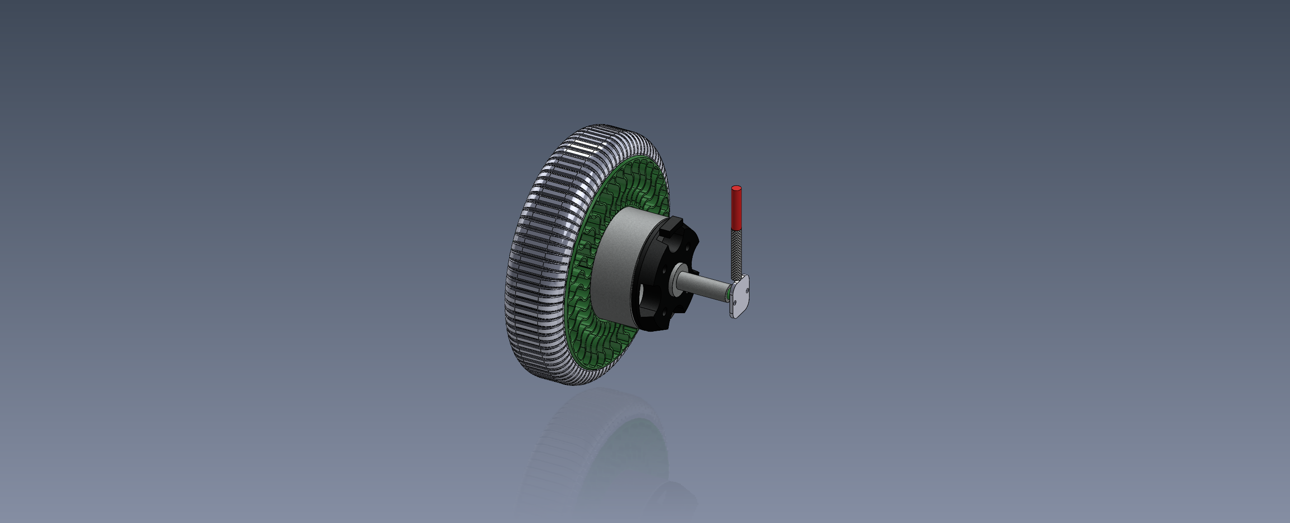
cad/solidworks_api/out/renders/tyrelock_wheel_asm_trimetric.png
