fernandomierhicks/wheeled-leg-robot/cad/solidworks_api/out/renders/washer_E_coupler_tibia_front.png

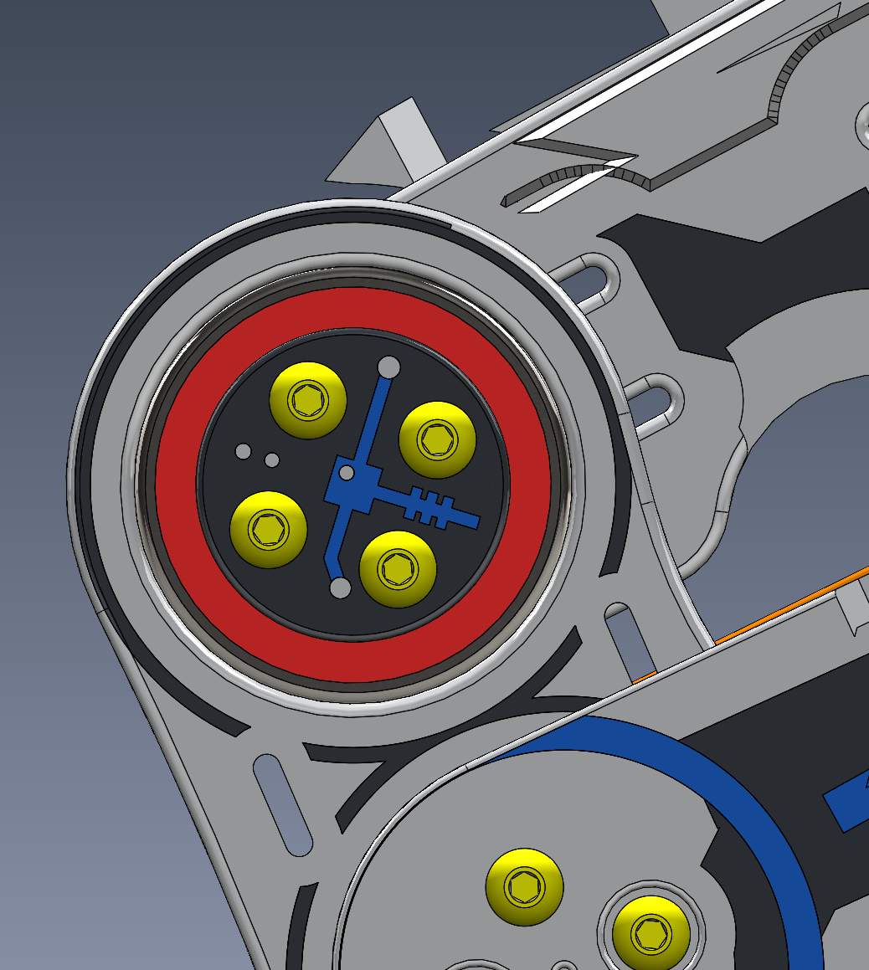
cad/solidworks_api/out/renders/washer_E_coupler_tibia_front.png
