fernandomierhicks/wheeled-leg-robot/cad/solidworks_api/out/renders/washer_F_coupler_body_front.png

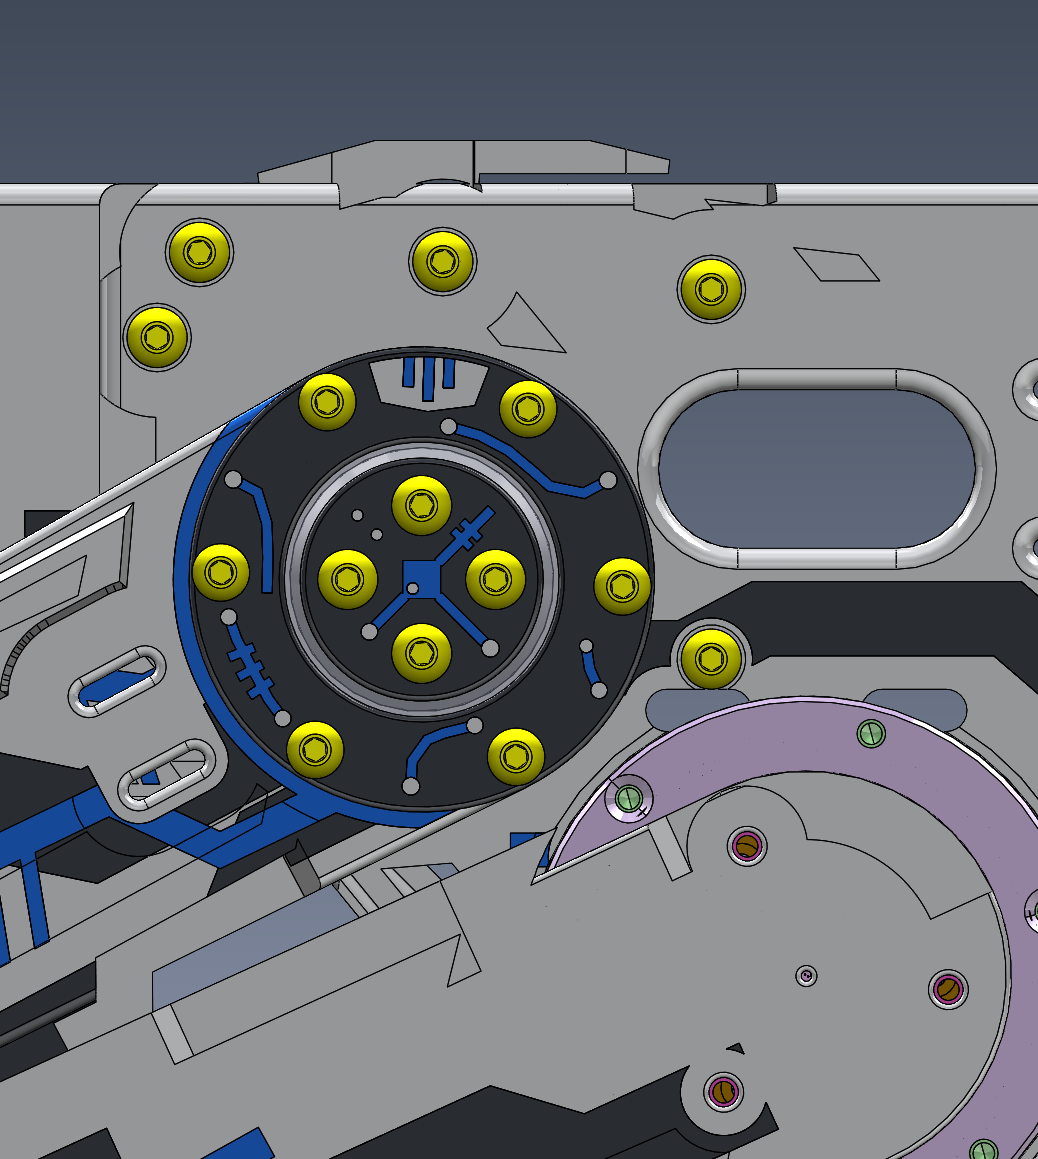
cad/solidworks_api/out/renders/washer_F_coupler_body_front.png
