fernandomierhicks/wheeled-leg-robot/cad/solidworks_api/out/renders/washer_patterns.png

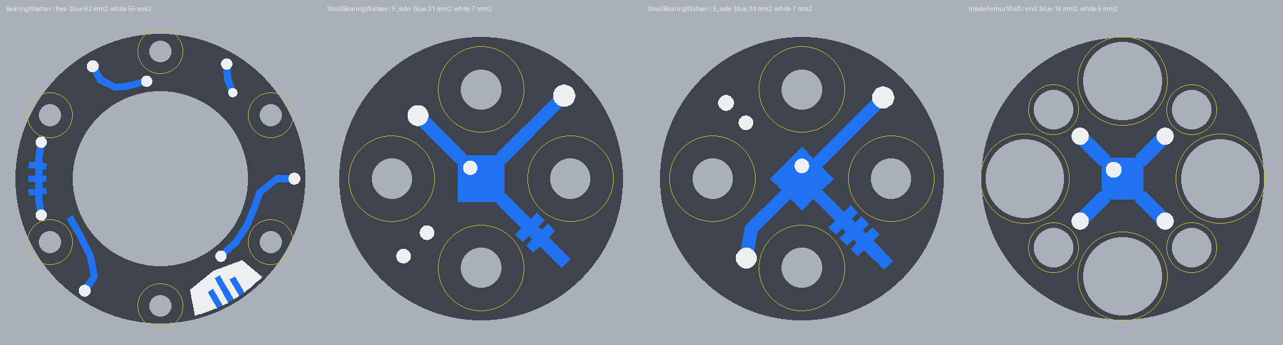
cad/solidworks_api/out/renders/washer_patterns.png
