fernandomierhicks/wheeled-leg-robot/cad/solidworks_api/out/renders/wheel_on_robot_front.png

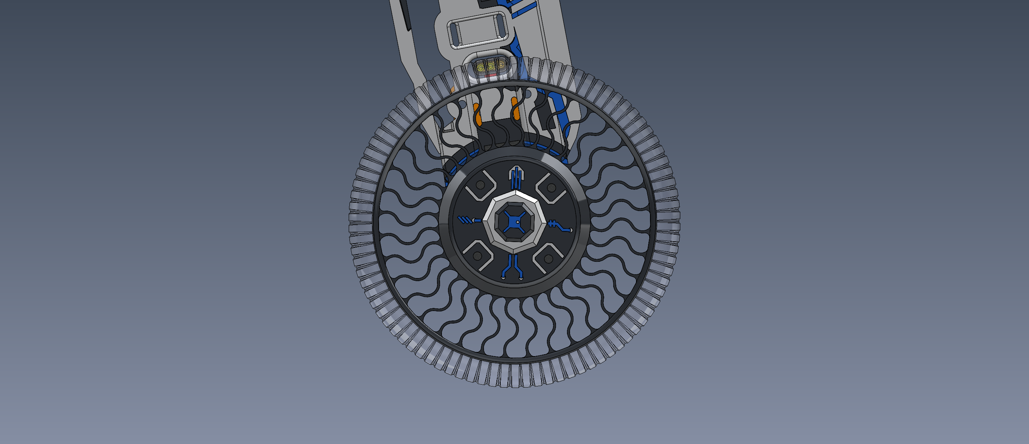
cad/solidworks_api/out/renders/wheel_on_robot_front.png
