fernandomierhicks/wheeled-leg-robot/cad/solidworks_api/out/renders/wheel_on_robot_trimetric.png

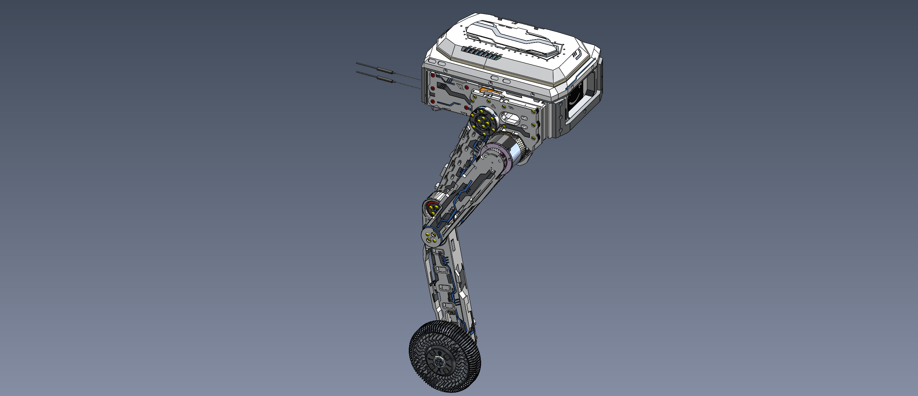
cad/solidworks_api/out/renders/wheel_on_robot_trimetric.png
