fernandomierhicks/wheeled-leg-robot/cad/v5 Ai designed/_originals/pre_facet_round3_2026-10-14/relief_src/FacetFront_relief.png

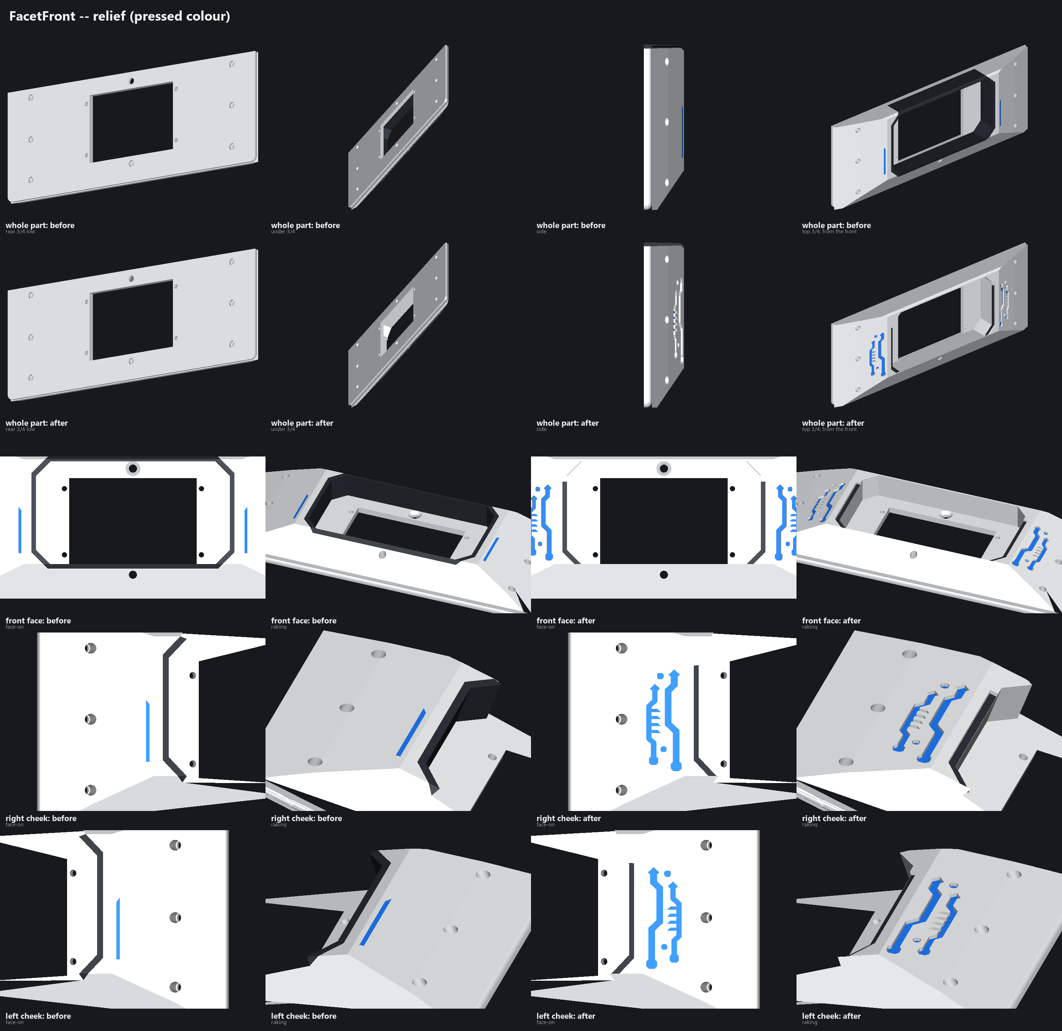
cad/v5 Ai designed/_originals/pre_facet_round3_2026-10-14/relief_src/FacetFront_relief.png
