fernandomierhicks/wheeled-leg-robot/cad/v5 Ai designed/_originals/pre_hoodB_2026-10-07/solidworks_api_out/pipes/FacetHood_pipes.png

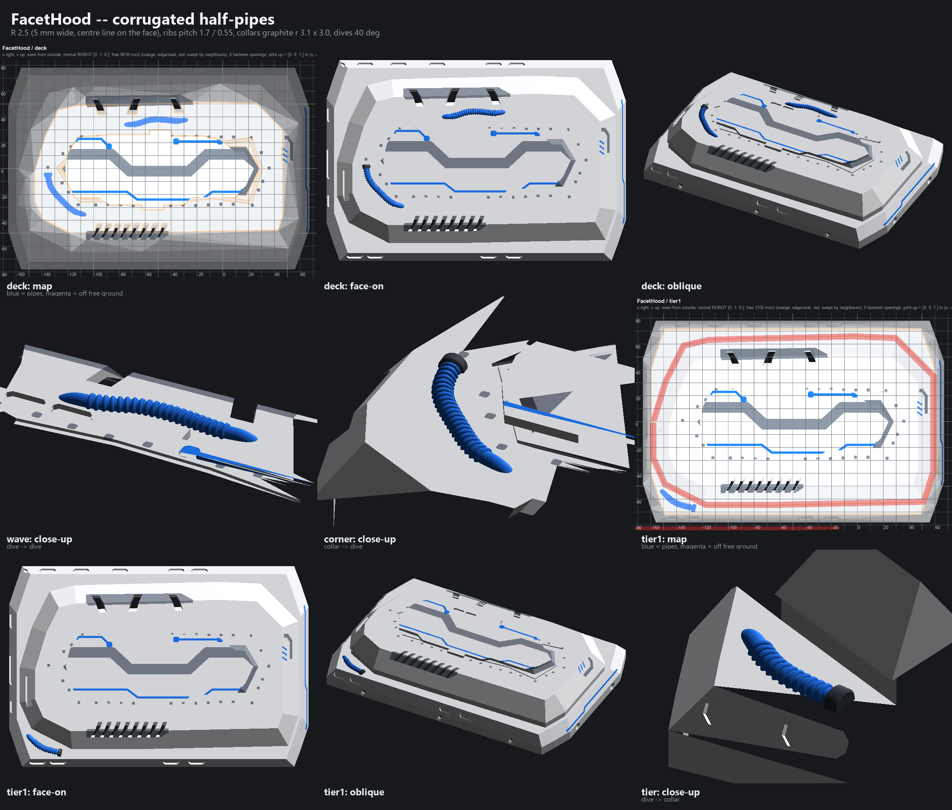
cad/v5 Ai designed/_originals/pre_hoodB_2026-10-07/solidworks_api_out/pipes/FacetHood_pipes.png
