fernandomierhicks/wheeled-leg-robot/components/datasheets/AbsoluteEncoder/Encoder Pinout.png

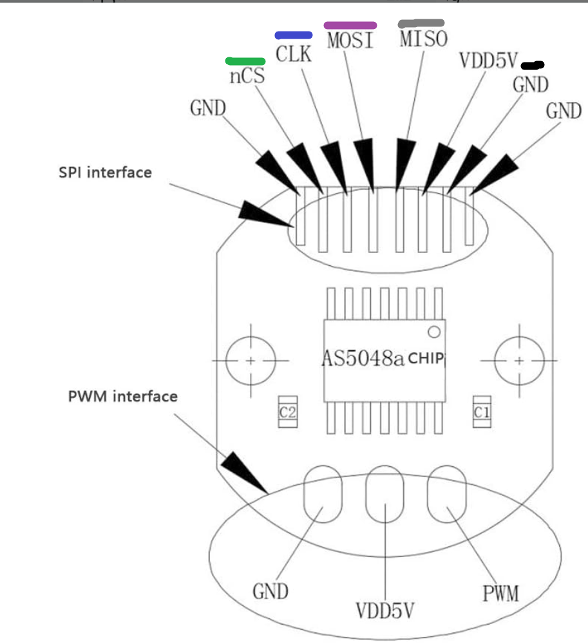
components/datasheets/AbsoluteEncoder/Encoder Pinout.png
