fernandomierhicks/wheeled-leg-robot/components/datasheets/Leg Motor/Pinout.png

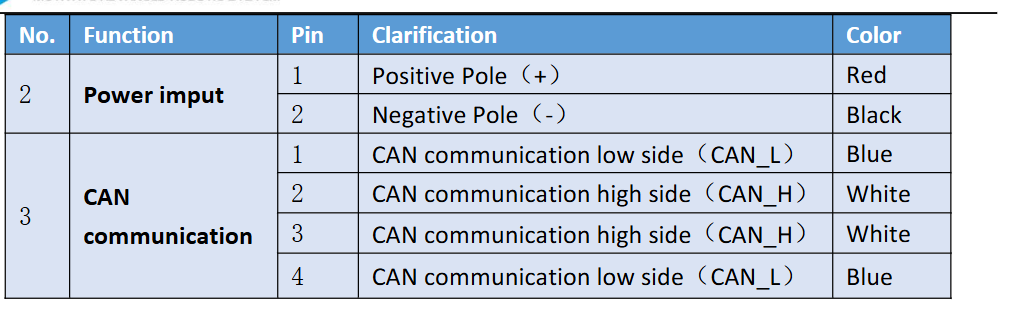
components/datasheets/Leg Motor/Pinout.png
