fernandomierhicks/wheeled-leg-robot/components/datasheets/Teensy/pinout.png

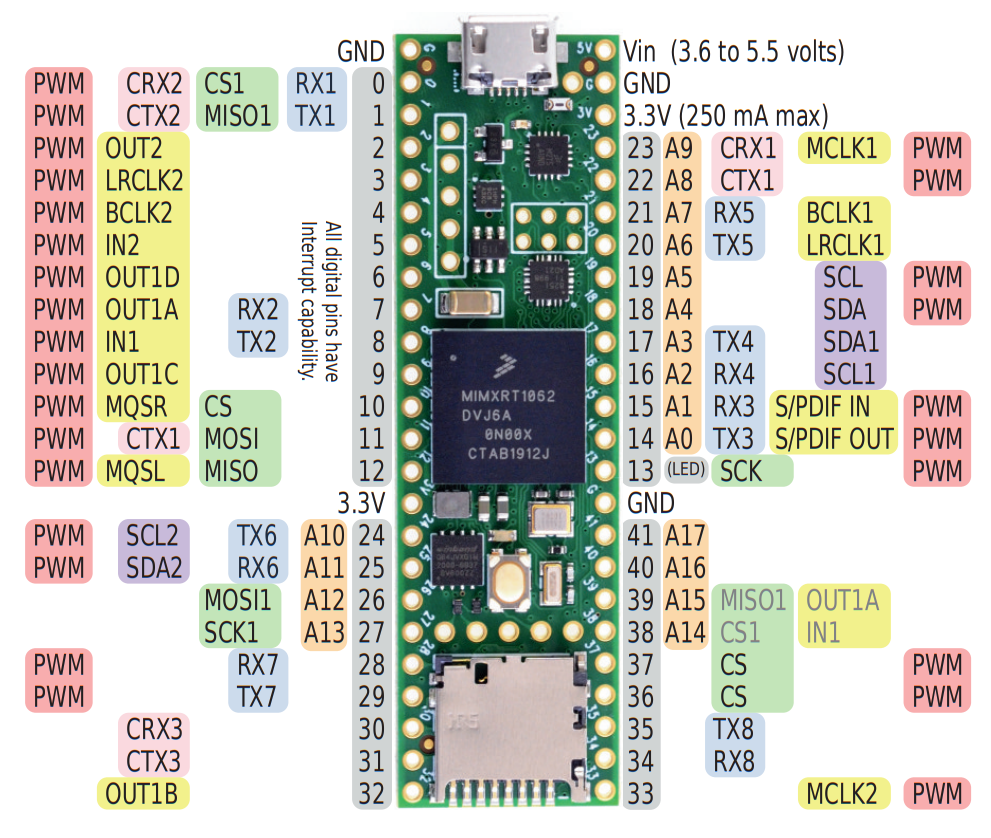
components/datasheets/Teensy/pinout.png
