fernandomierhicks/wheeled-leg-robot/docs/other/Jump_math_figures.png

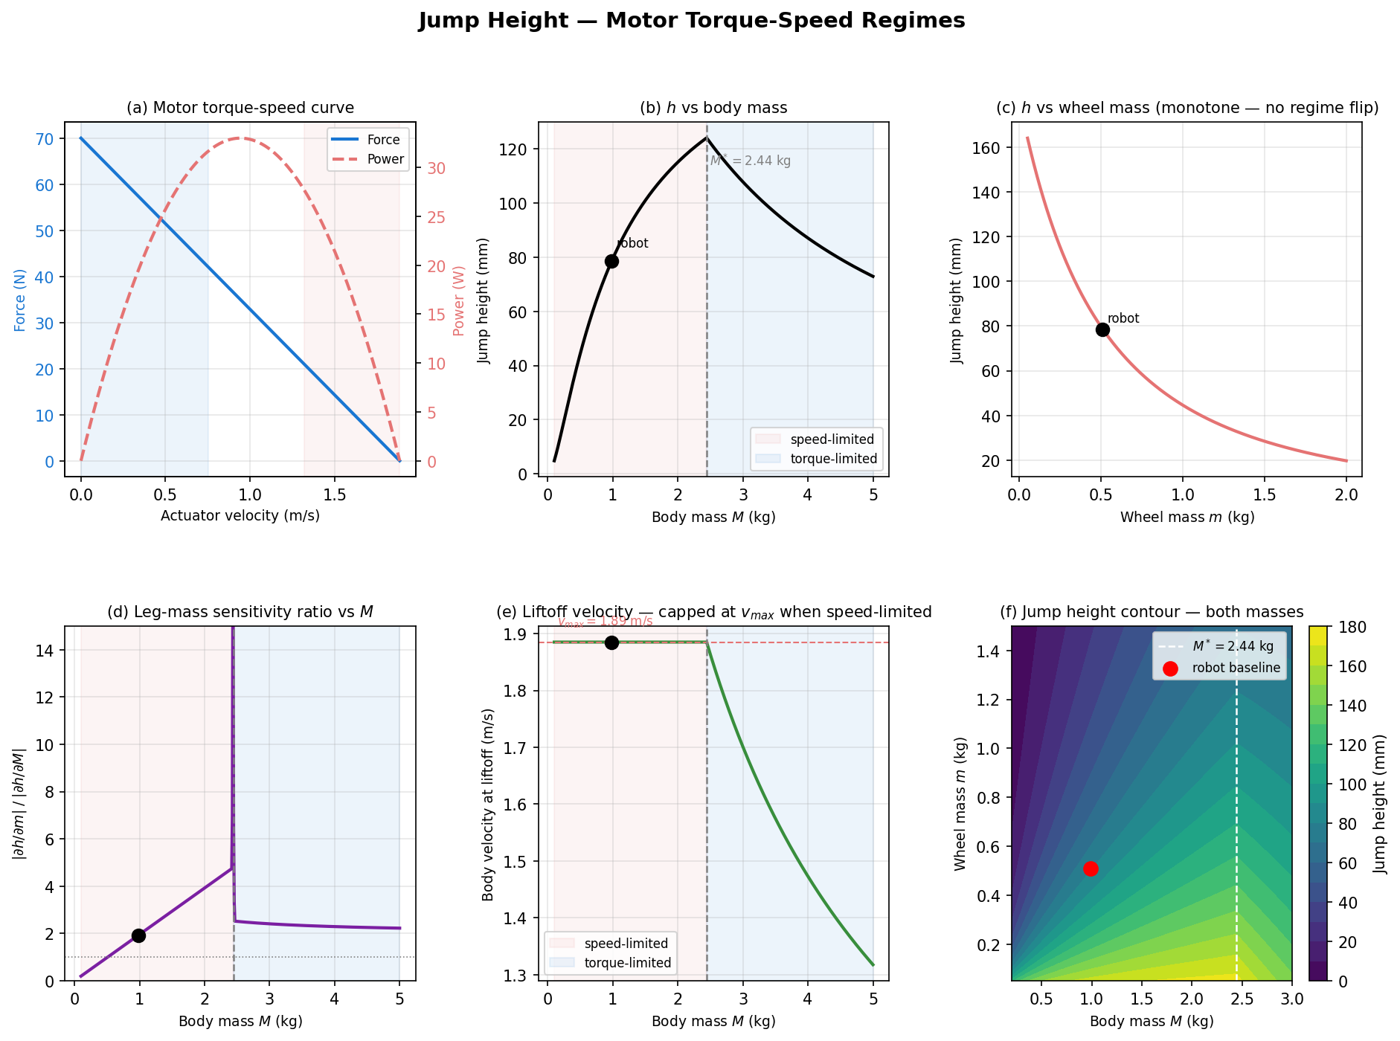
docs/other/Jump_math_figures.png
