fernandomierhicks/wheeled-leg-robot/media/2026_08_05 metal legs/2026-08-05 19.14.39.jpg

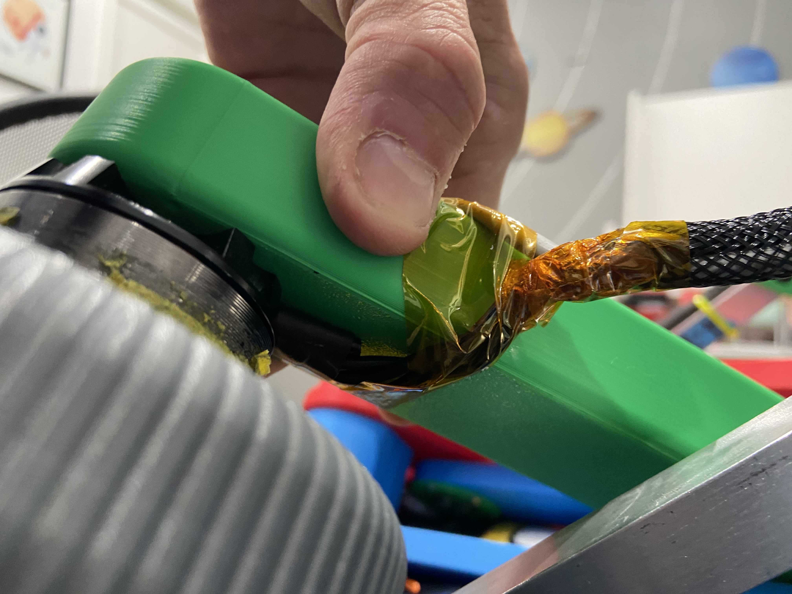
media/2026_08_05 metal legs/2026-08-05 19.14.39.jpg
