fernandomierhicks/wheeled-leg-robot/media/2026_08_05 metal legs/2026-08-05 19.21.58.jpg

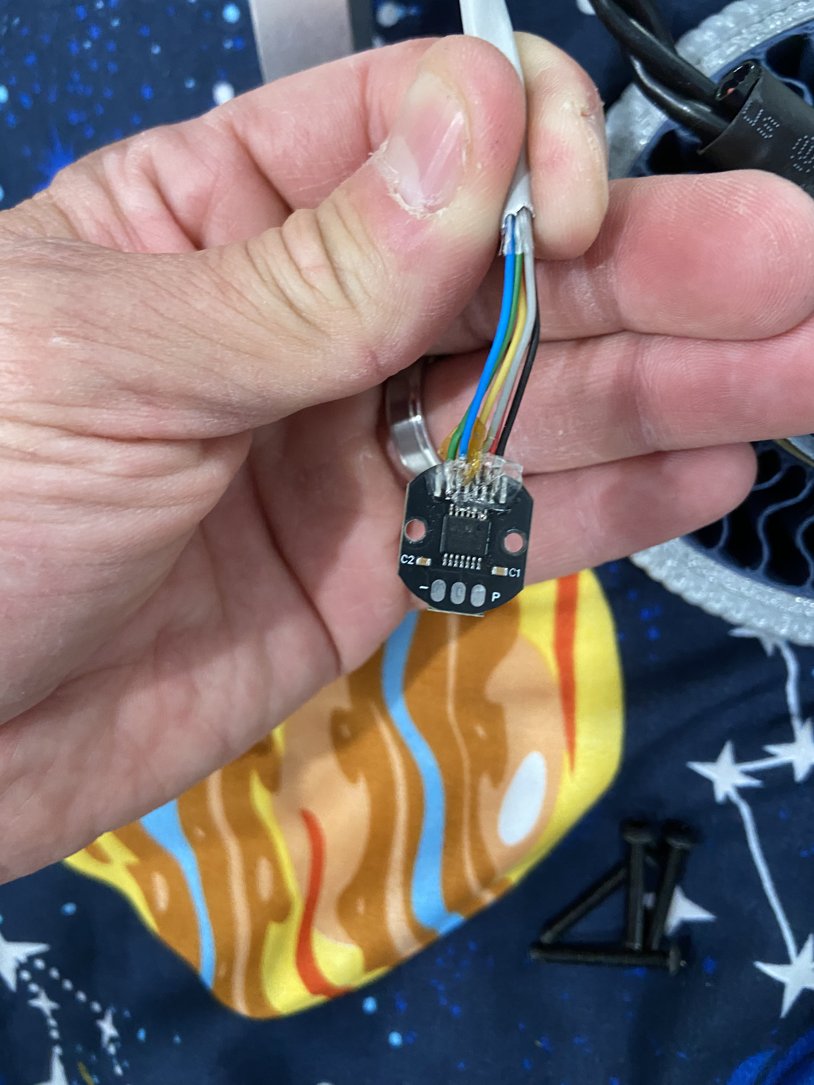
media/2026_08_05 metal legs/2026-08-05 19.21.58.jpg
