fernandomierhicks/wheeled-leg-robot/media/2026_08_05 metal legs/2026-08-07 10.24.17.jpg

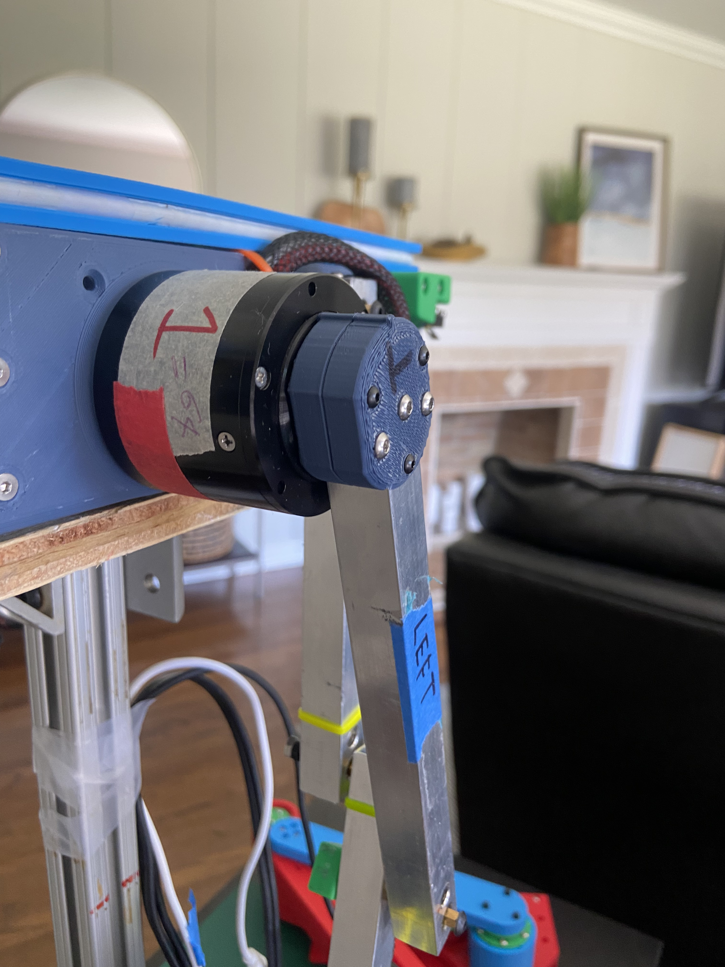
media/2026_08_05 metal legs/2026-08-07 10.24.17.jpg
