fernandomierhicks/wheeled-leg-robot/media/2026_10_10/2026-10-02 19.45.58.jpg

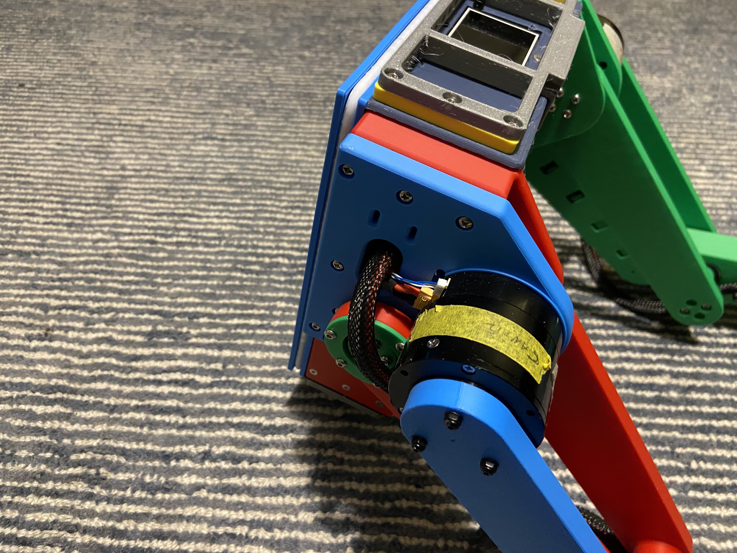
media/2026_10_10/2026-10-02 19.45.58.jpg
