fernandomierhicks/wheeled-leg-robot/components/datasheets/Leg Motor/other/ch340-driver-download-for-ak-2-0-Series-motor/CH340-Driver-Download-for-AK-2.0-Series-Motor/readme.txt

Open SETUP.EXE. The INF file prompted is CH341SER.INF. We don't need to pay attention to it (it's shared by 341 and 340). So just click "Install" directly!!
