fernandomierhicks/wheeled-leg-robot/cad/aesthetics/out/marks/INDEX_parts.png

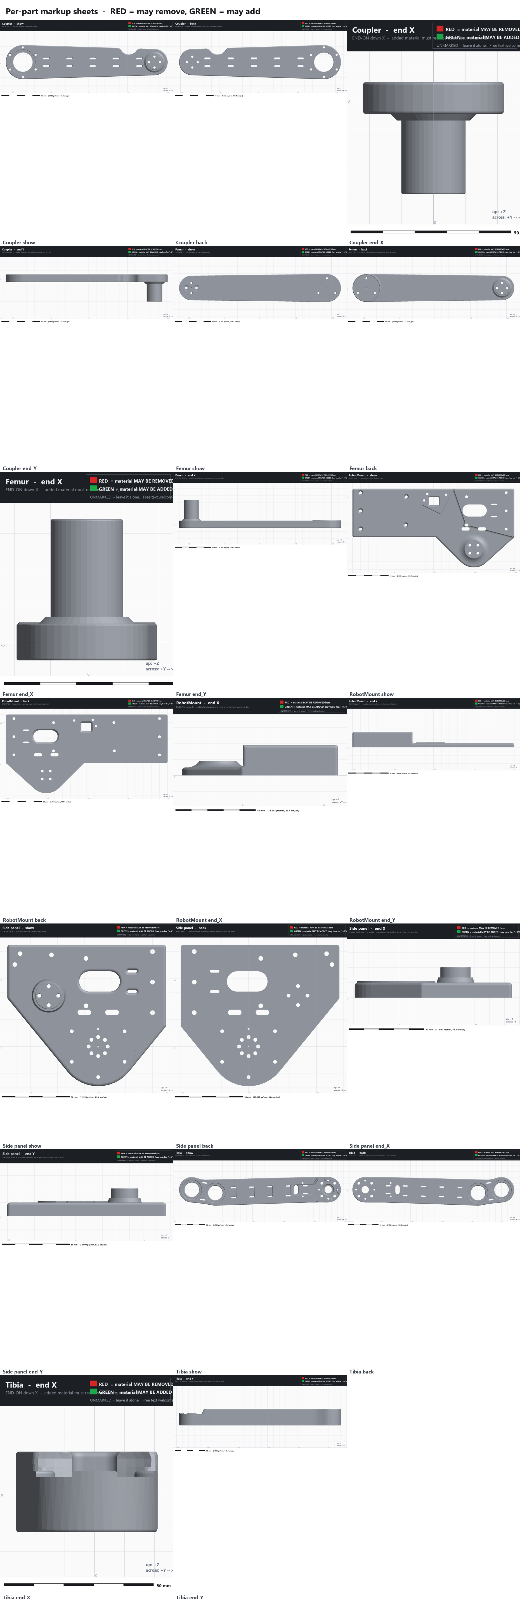
cad/aesthetics/out/marks/INDEX_parts.png
