fernandomierhicks/wheeled-leg-robot/cad/aesthetics/out/marks/parts/Coupler_back.png

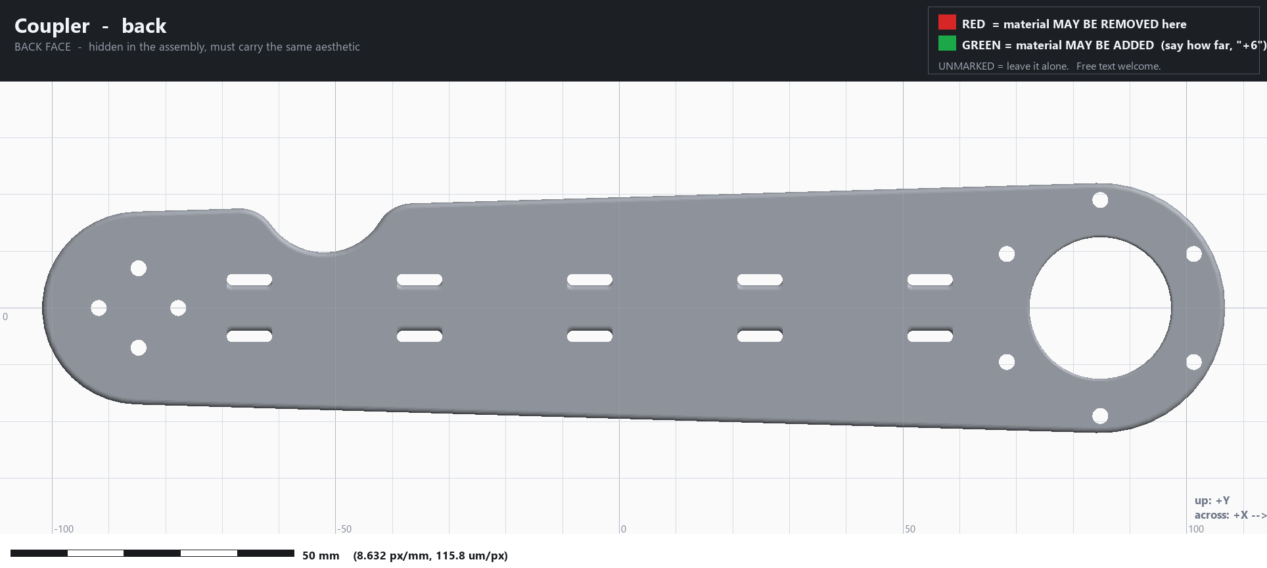
cad/aesthetics/out/marks/parts/Coupler_back.png
