fernandomierhicks/wheeled-leg-robot/cad/aesthetics/out/marks/parts/Coupler_end_X.png

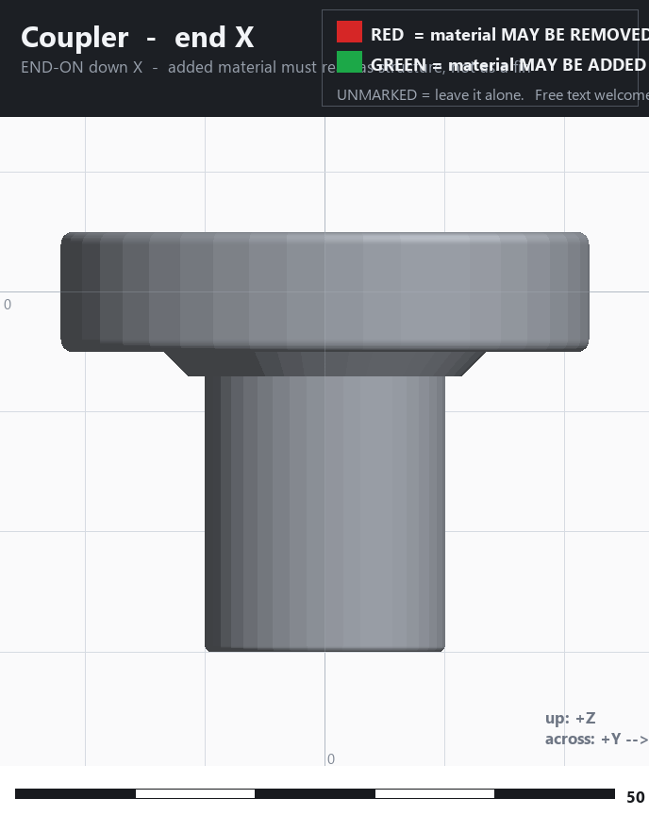
cad/aesthetics/out/marks/parts/Coupler_end_X.png
