fernandomierhicks/wheeled-leg-robot/cad/aesthetics/out/marks/parts/Coupler_end_Y.png

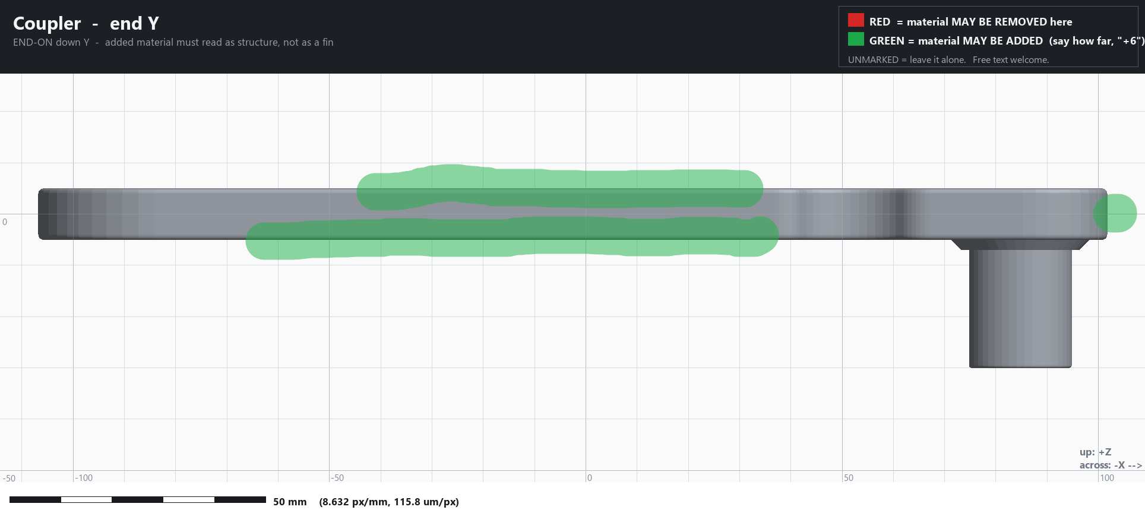
cad/aesthetics/out/marks/parts/Coupler_end_Y.png
