fernandomierhicks/wheeled-leg-robot/cad/aesthetics/out/marks/parts/Coupler_show.png

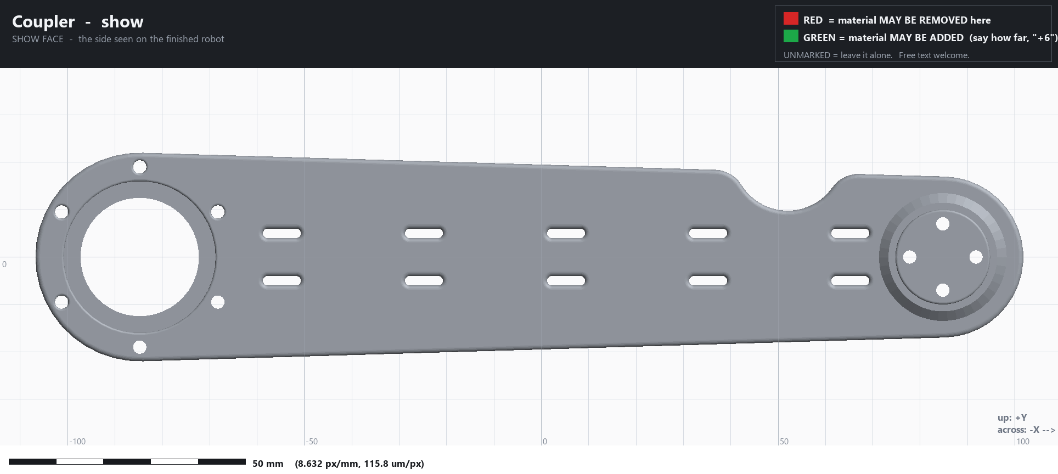
cad/aesthetics/out/marks/parts/Coupler_show.png
