fernandomierhicks/wheeled-leg-robot/cad/aesthetics/out/marks/parts/Femur_back.png

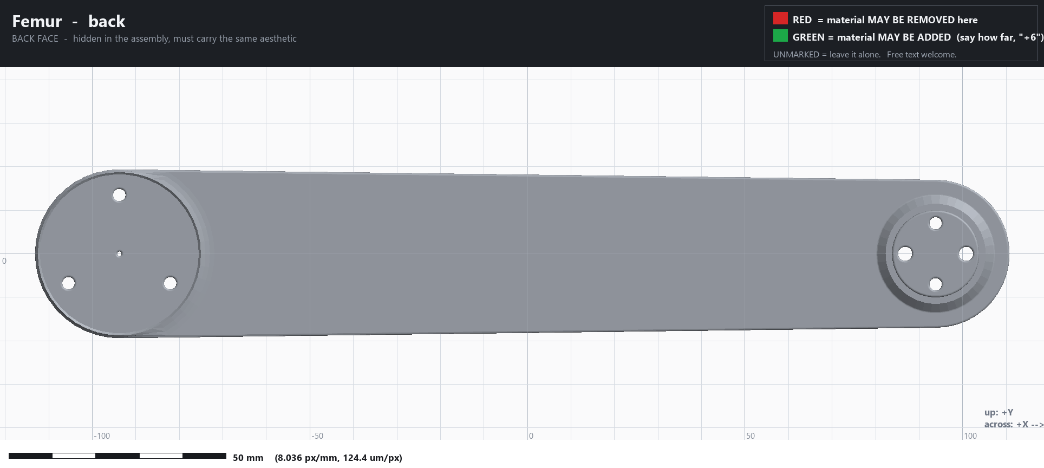
cad/aesthetics/out/marks/parts/Femur_back.png
