fernandomierhicks/wheeled-leg-robot/cad/aesthetics/out/marks/parts/Femur_end_X.png

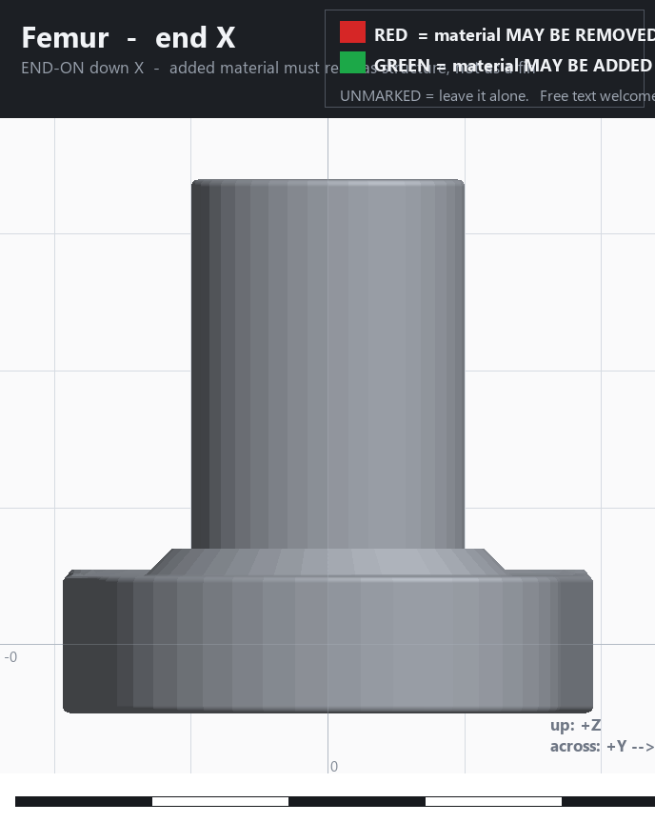
cad/aesthetics/out/marks/parts/Femur_end_X.png
