fernandomierhicks/wheeled-leg-robot/cad/aesthetics/out/marks/parts/Femur_end_Y.png

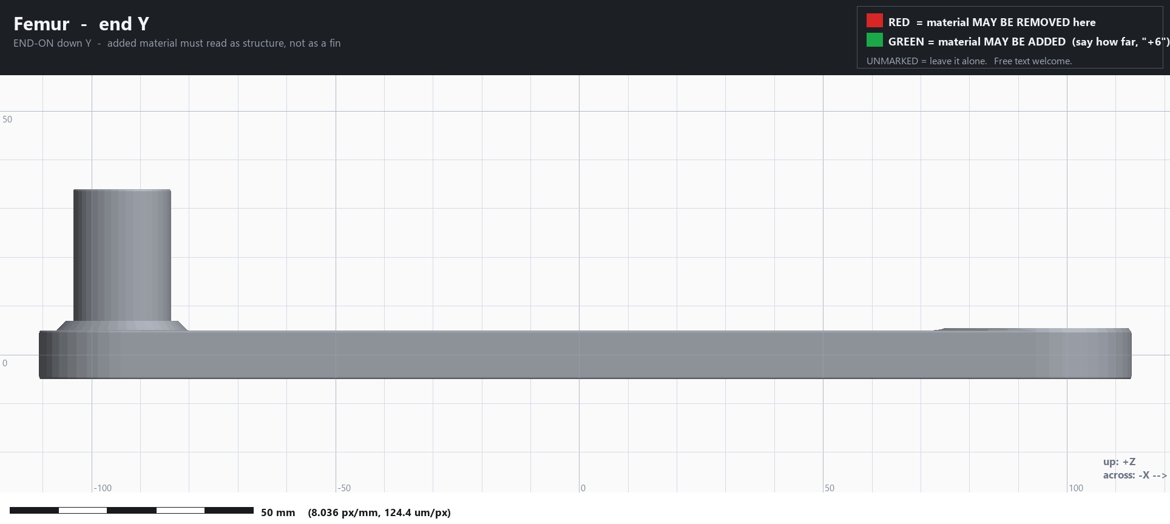
cad/aesthetics/out/marks/parts/Femur_end_Y.png
