fernandomierhicks/wheeled-leg-robot/cad/aesthetics/out/marks/parts/Femur_show.png

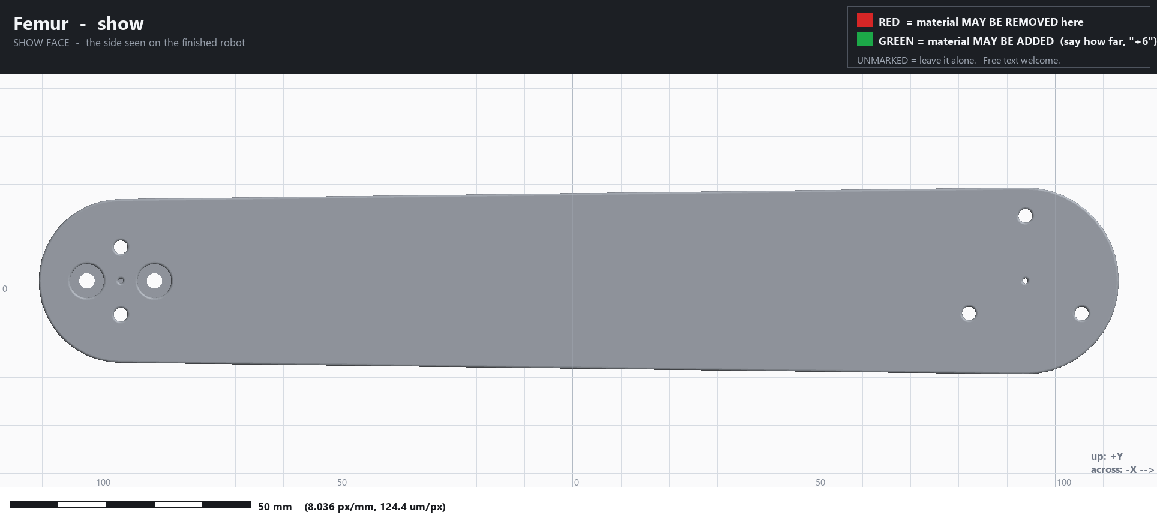
cad/aesthetics/out/marks/parts/Femur_show.png
