fernandomierhicks/wheeled-leg-robot/cad/aesthetics/out/marks/parts/RobotMount_back.png

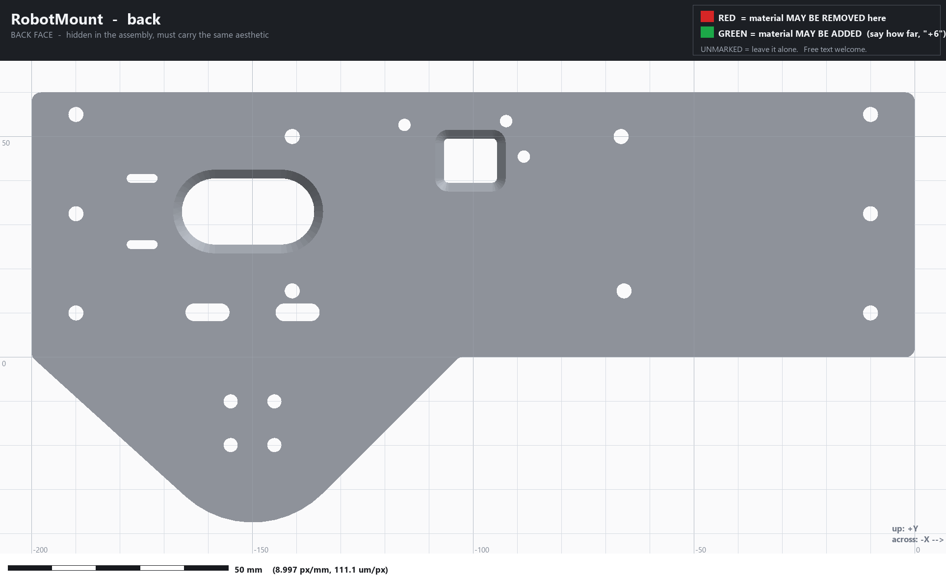
cad/aesthetics/out/marks/parts/RobotMount_back.png
