fernandomierhicks/wheeled-leg-robot/cad/aesthetics/out/marks/parts/RobotMount_end_X.png

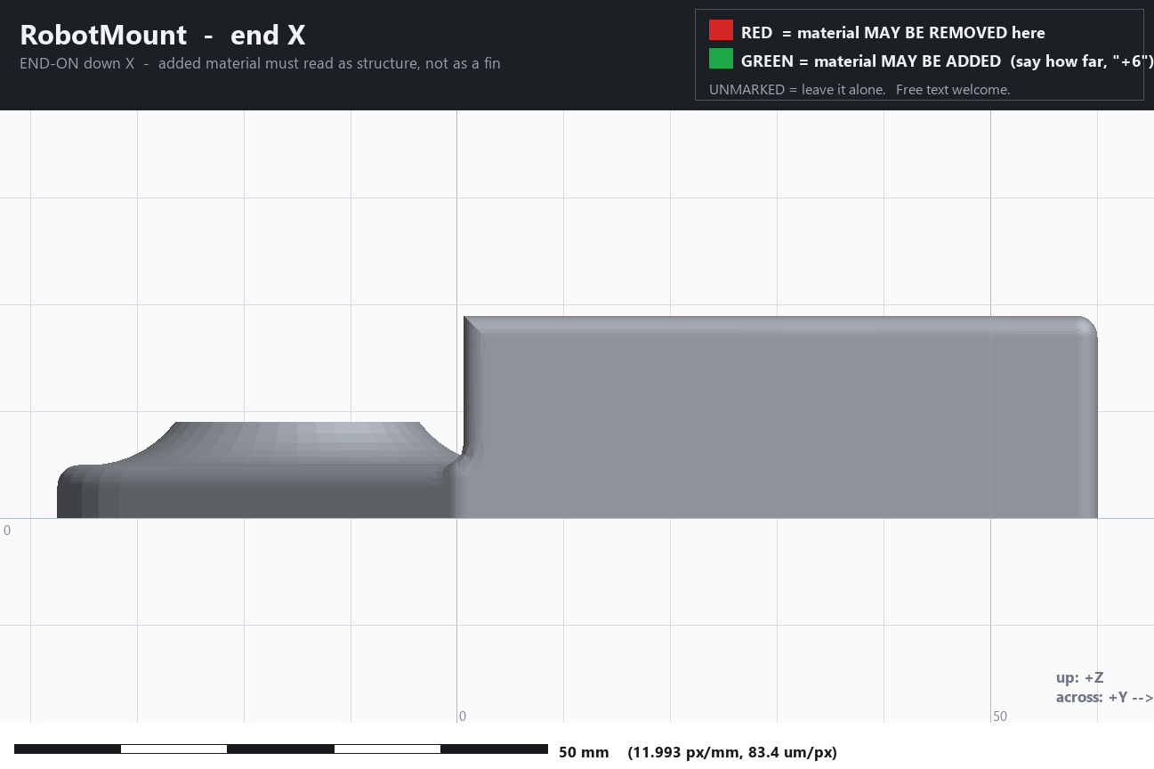
cad/aesthetics/out/marks/parts/RobotMount_end_X.png
