fernandomierhicks/wheeled-leg-robot/cad/aesthetics/out/marks/parts/RobotMount_end_Y.png

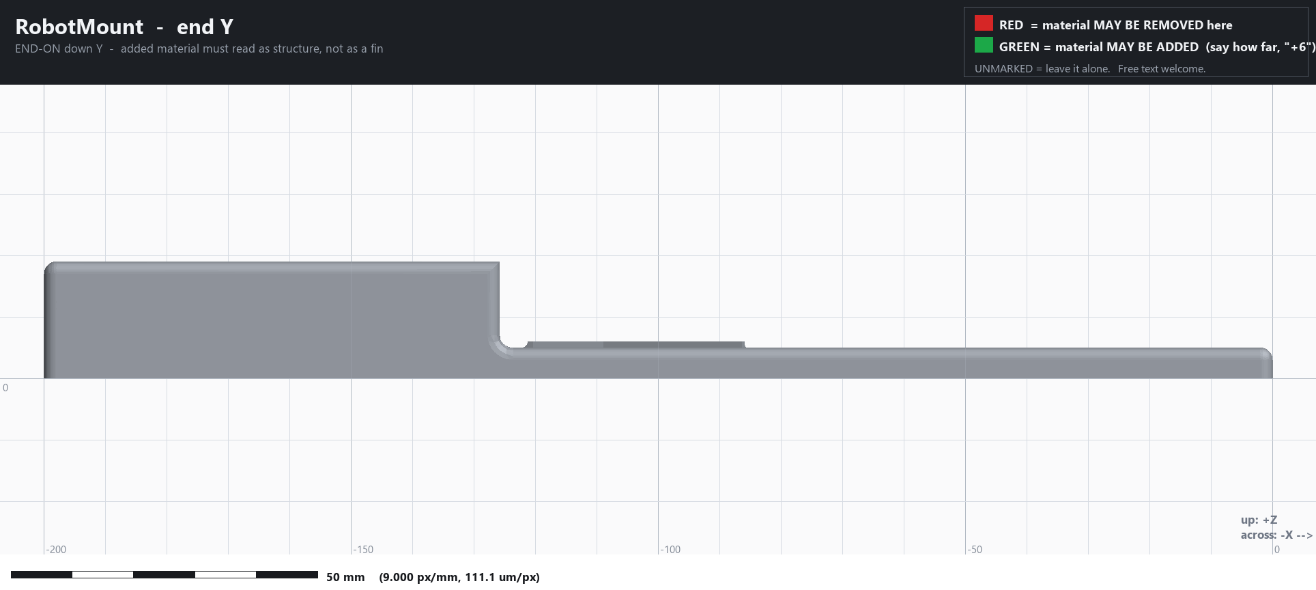
cad/aesthetics/out/marks/parts/RobotMount_end_Y.png
