fernandomierhicks/wheeled-leg-robot/cad/aesthetics/out/marks/parts/RobotMount_show.png

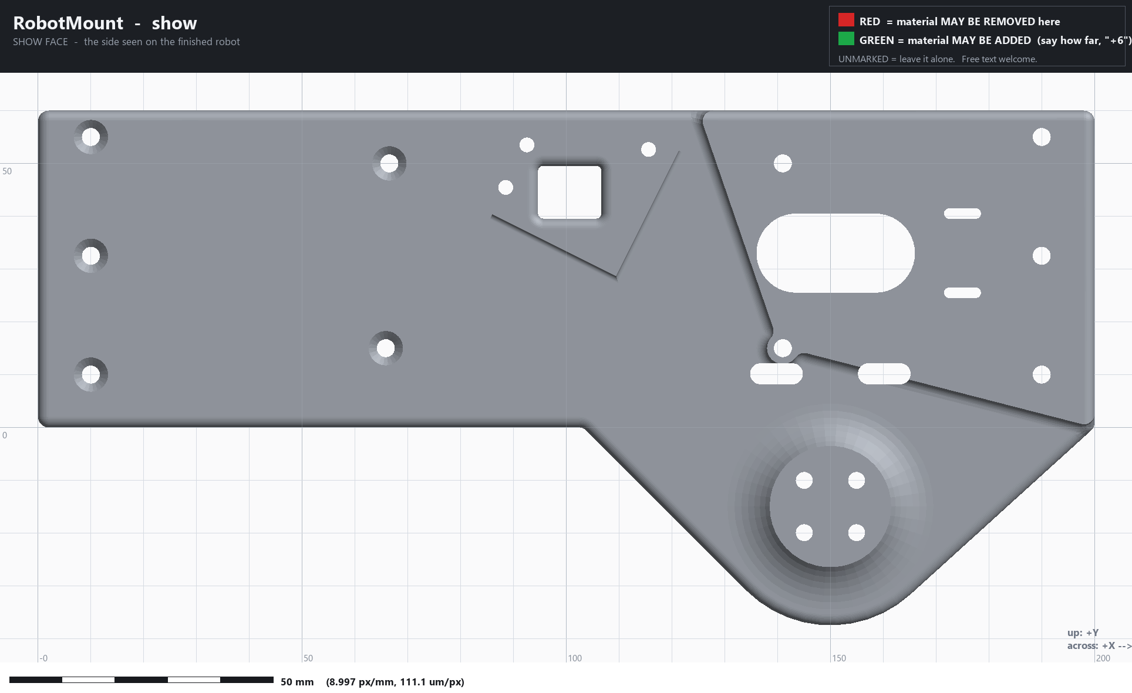
cad/aesthetics/out/marks/parts/RobotMount_show.png
