fernandomierhicks/wheeled-leg-robot/cad/aesthetics/out/marks/parts/Side_panel_back.png

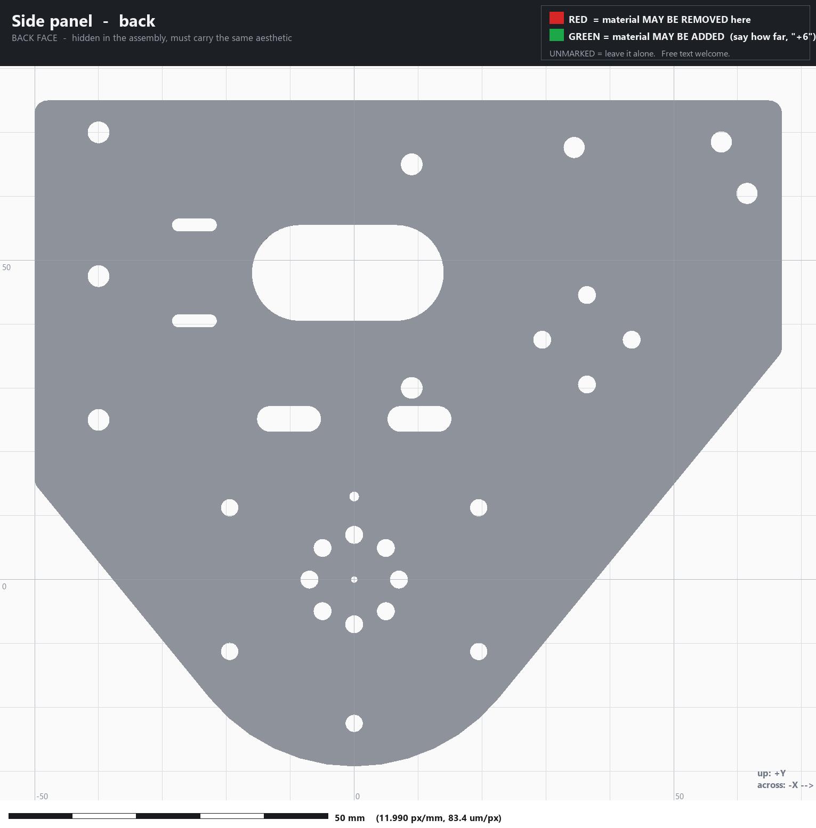
cad/aesthetics/out/marks/parts/Side_panel_back.png
