fernandomierhicks/wheeled-leg-robot/cad/aesthetics/out/marks/parts/Side_panel_end_X.png

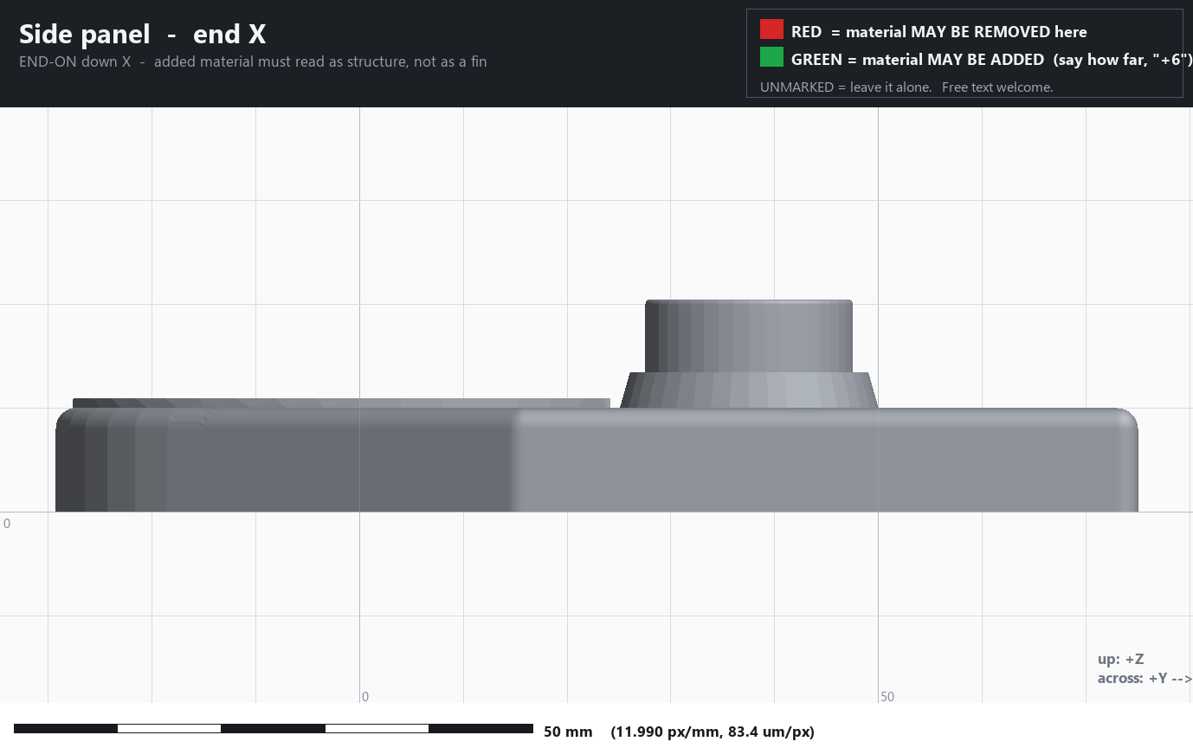
cad/aesthetics/out/marks/parts/Side_panel_end_X.png
