fernandomierhicks/wheeled-leg-robot/cad/aesthetics/out/marks/parts/Side_panel_show.png

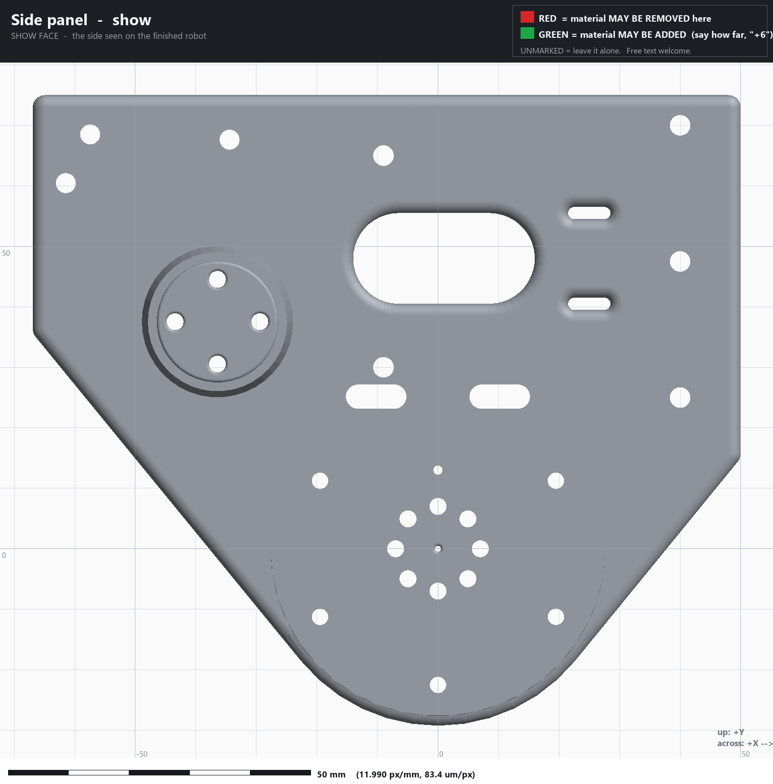
cad/aesthetics/out/marks/parts/Side_panel_show.png
