fernandomierhicks/wheeled-leg-robot/cad/aesthetics/out/marks/parts/Tibia_back.png

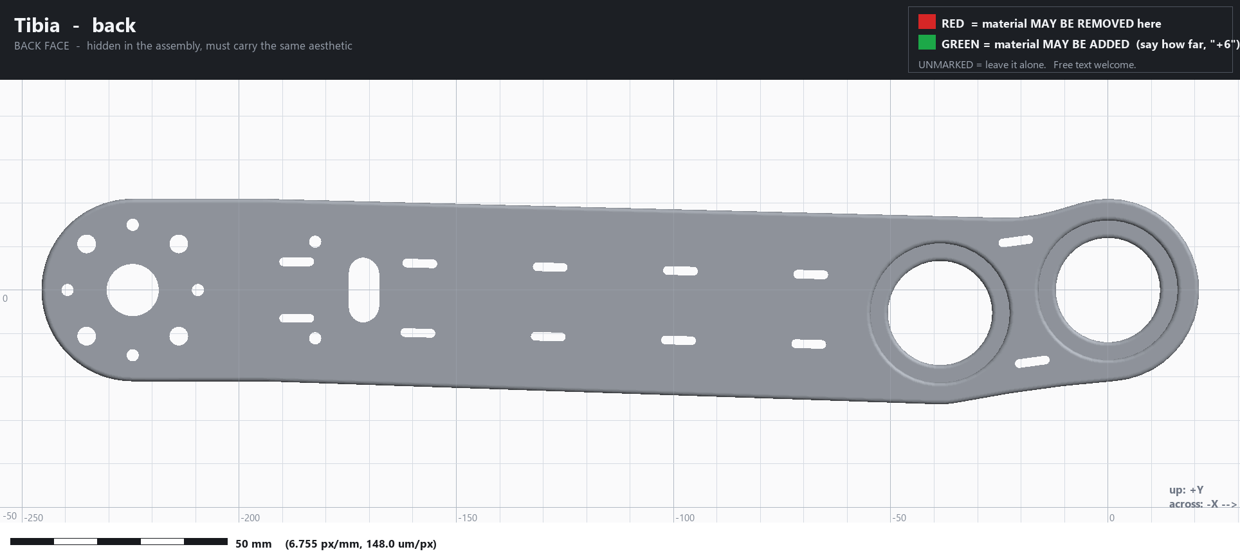
cad/aesthetics/out/marks/parts/Tibia_back.png
