fernandomierhicks/wheeled-leg-robot/cad/aesthetics/out/marks/parts/Tibia_end_X.png

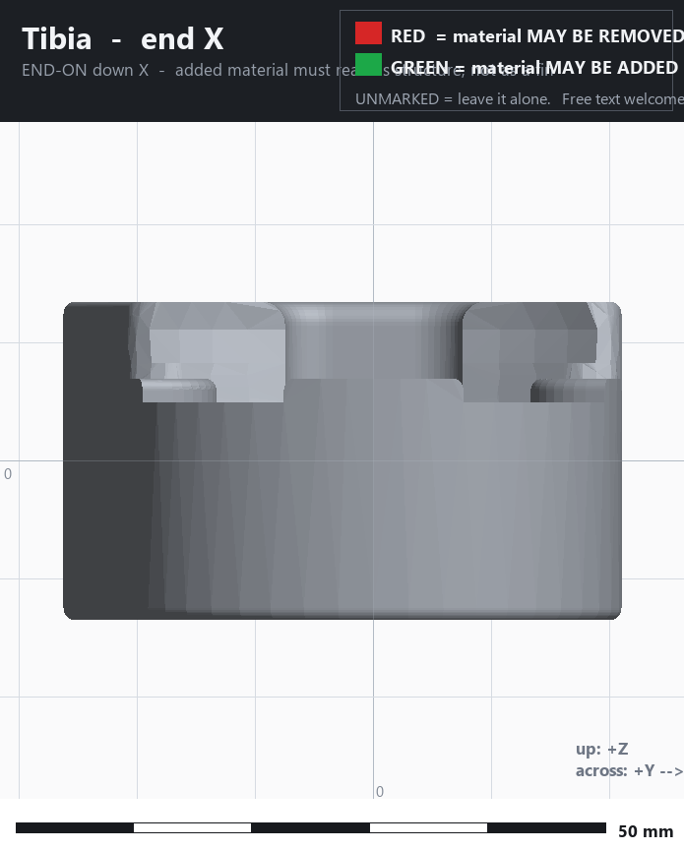
cad/aesthetics/out/marks/parts/Tibia_end_X.png
