fernandomierhicks/wheeled-leg-robot/cad/aesthetics/out/marks/parts/Tibia_end_Y.png

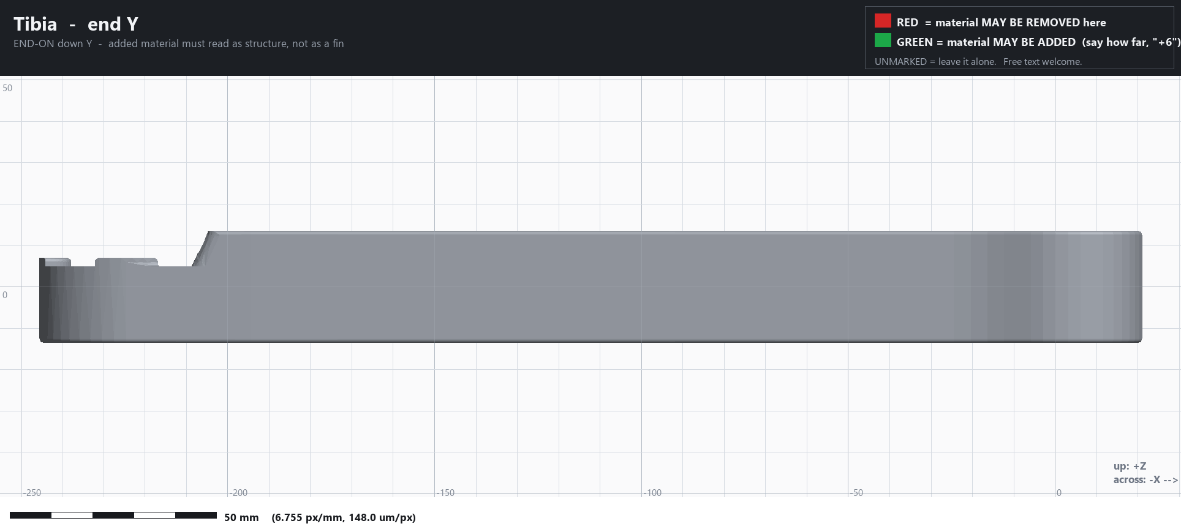
cad/aesthetics/out/marks/parts/Tibia_end_Y.png
