fernandomierhicks/wheeled-leg-robot/cad/aesthetics/out/marks/parts/Tibia_show.png

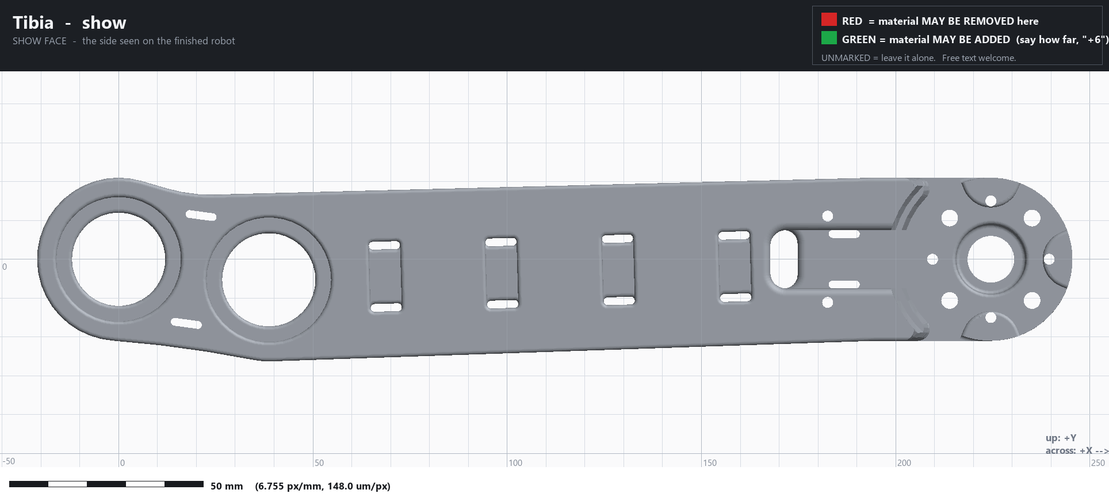
cad/aesthetics/out/marks/parts/Tibia_show.png
