fernandomierhicks/wheeled-leg-robot/components/datasheets/AbsoluteEncoder/Encoder Drawing.png

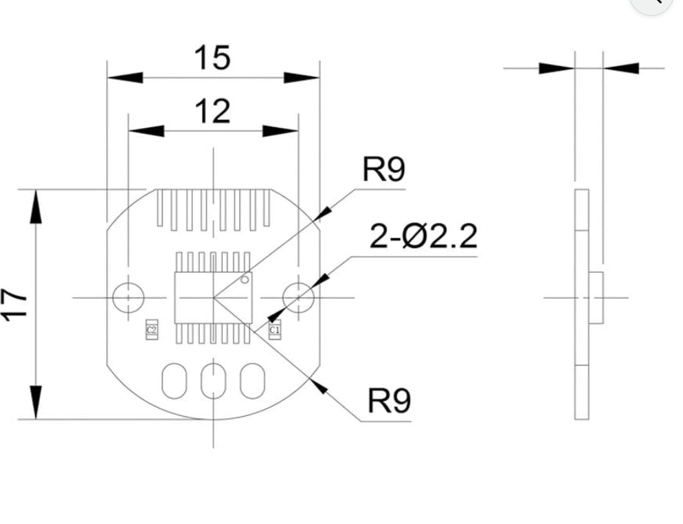
components/datasheets/AbsoluteEncoder/Encoder Drawing.png
