fernandomierhicks/wheeled-leg-robot/components/datasheets/custom board/Screenshot 2026-10-07 194200.png

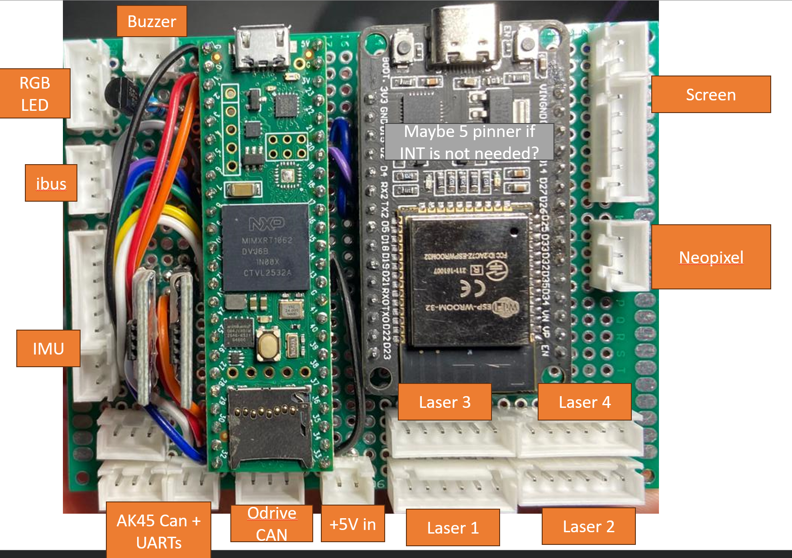
components/datasheets/custom board/Screenshot 2026-10-07 194200.png
