fernandomierhicks/wheeled-leg-robot/components/datasheets/custom board/Screenshot 2026-10-07 194221.png

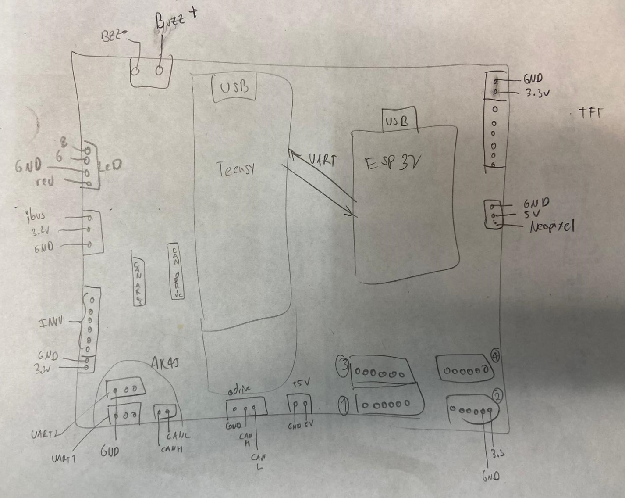
components/datasheets/custom board/Screenshot 2026-10-07 194221.png
