fernandomierhicks/wheeled-leg-robot/components/datasheets/Leg Motor/piout serial.png

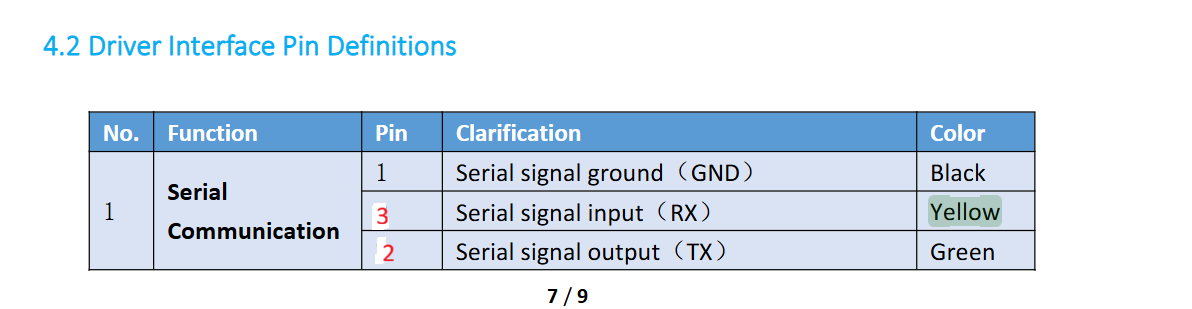
components/datasheets/Leg Motor/piout serial.png
