fernandomierhicks/wheeled-leg-robot/components/datasheets/radio receiver/Screenshot 2026-08-21 165144.png

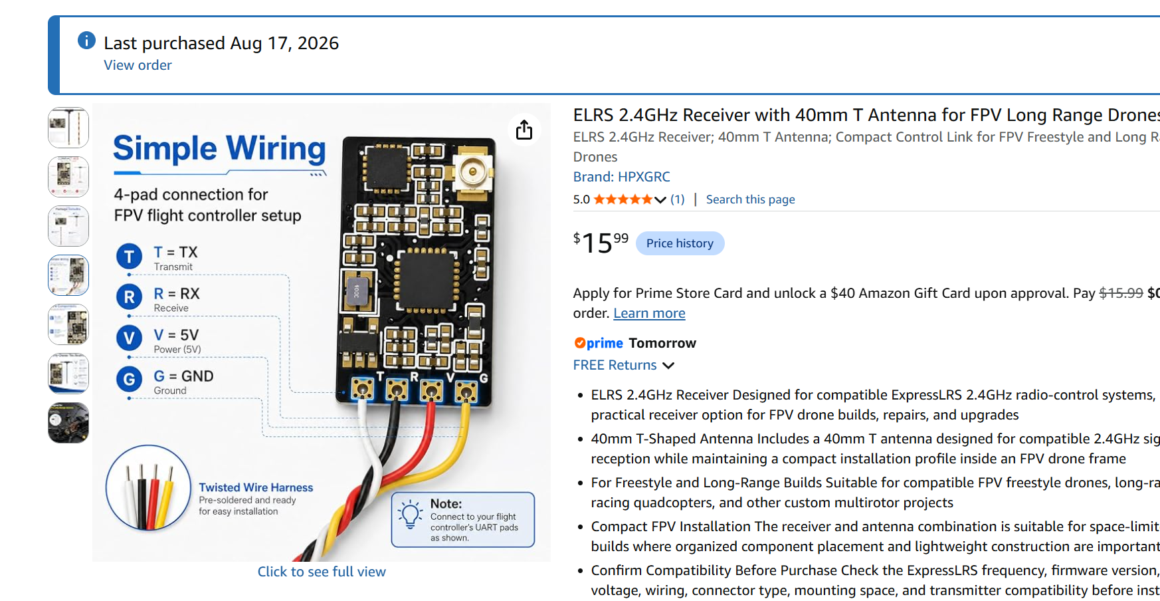
components/datasheets/radio receiver/Screenshot 2026-08-21 165144.png
