fernandomierhicks/wheeled-leg-robot/components/datasheets/radio transmitter/Screenshot 2026-08-21 183049.png

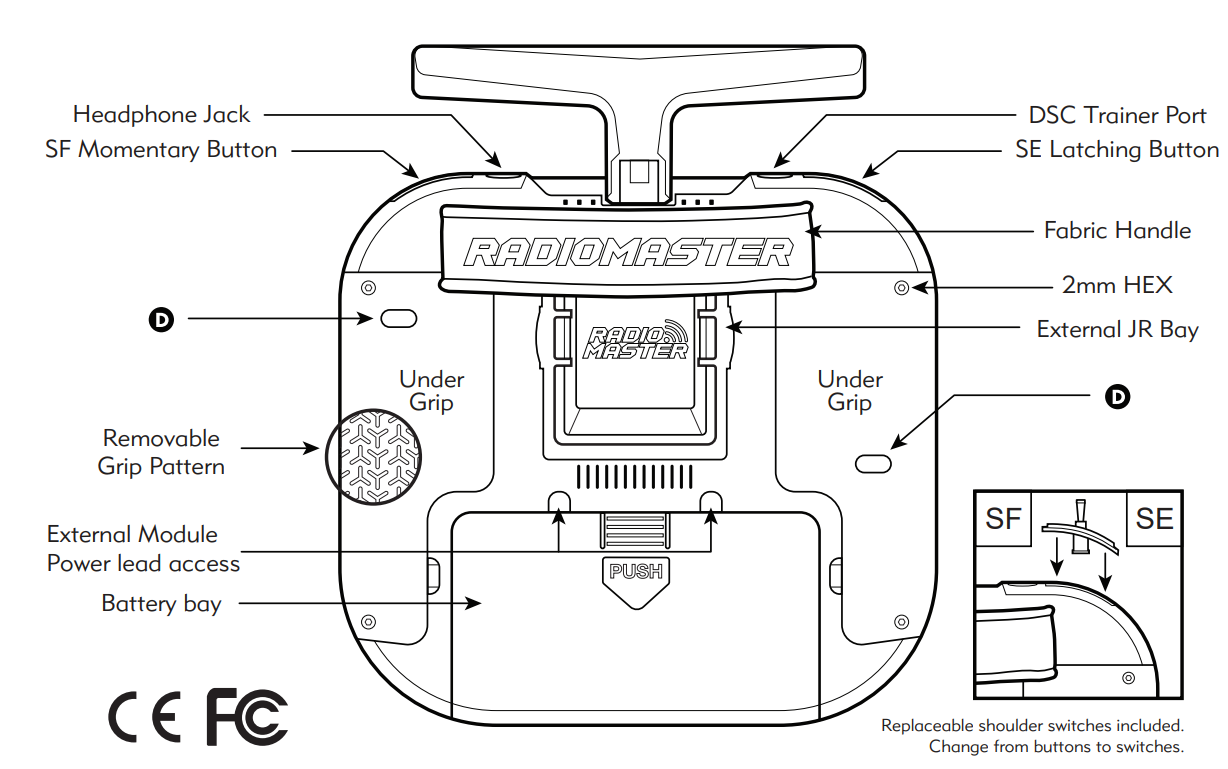
components/datasheets/radio transmitter/Screenshot 2026-08-21 183049.png
