fernandomierhicks/wheeled-leg-robot/components/datasheets/radio transmitter/Screenshot 2026-08-21 183102.png

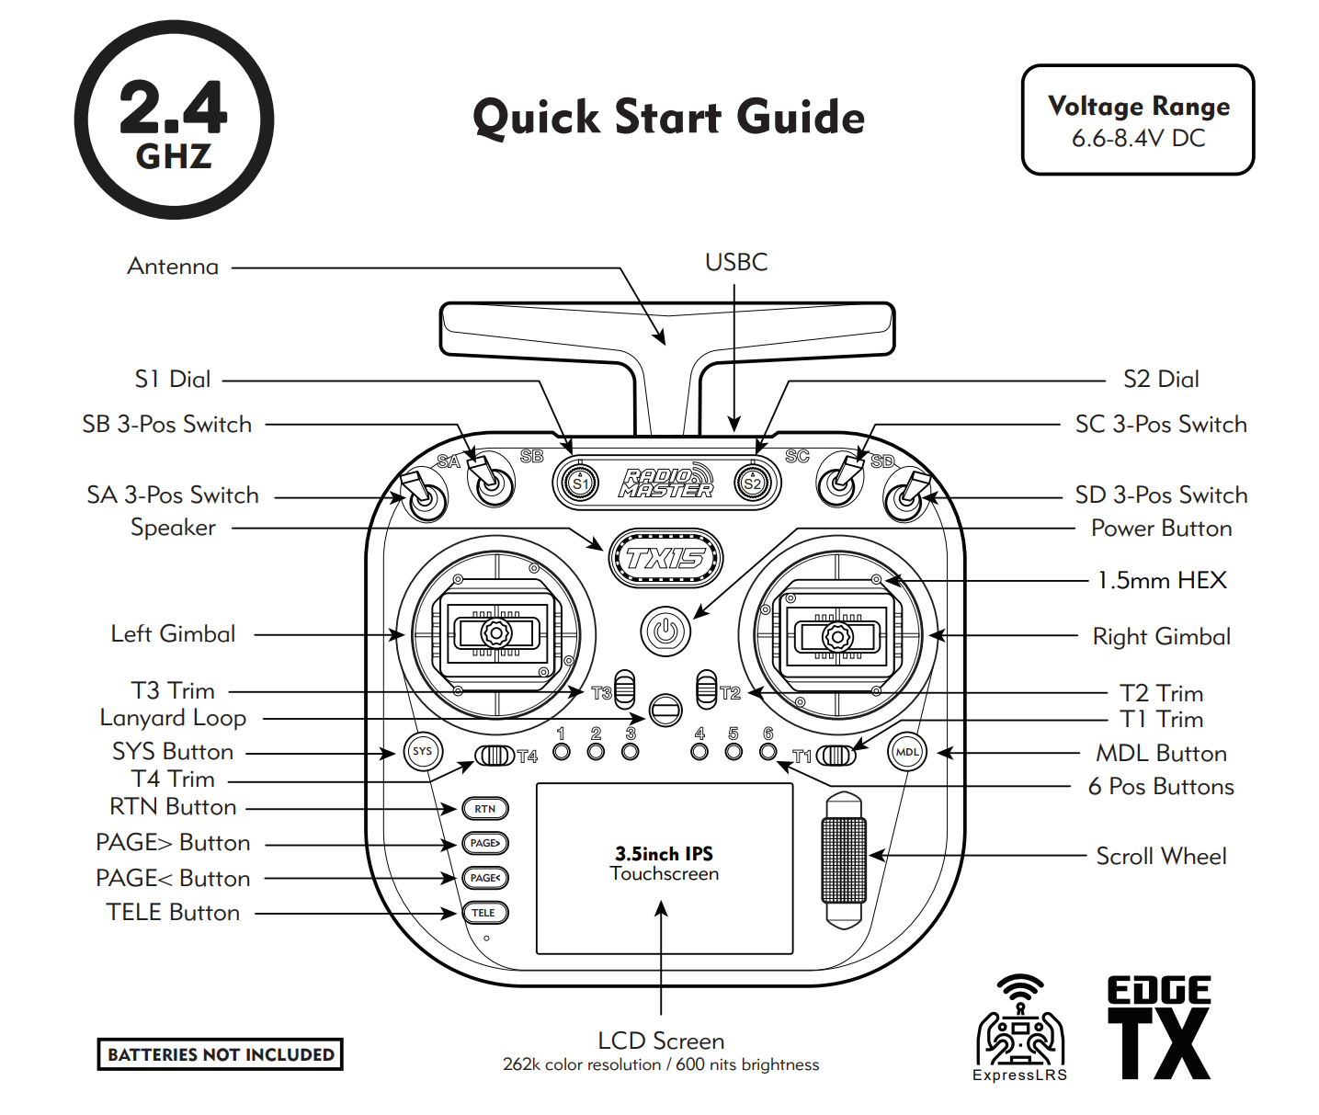
components/datasheets/radio transmitter/Screenshot 2026-08-21 183102.png
