fernandomierhicks/wheeled-leg-robot/components/datasheets/Wheel motor/Wheel motor dimensions.png

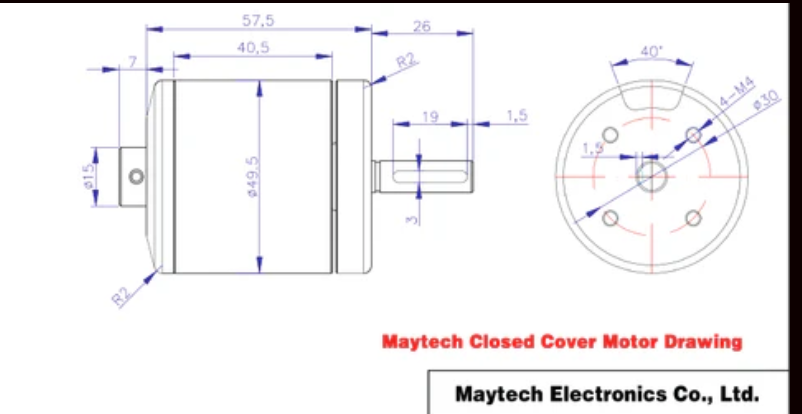
components/datasheets/Wheel motor/Wheel motor dimensions.png
