fernandomierhicks/wheeled-leg-robot/components/datasheets/Wheel motor/Wheel motor HAll connector.png

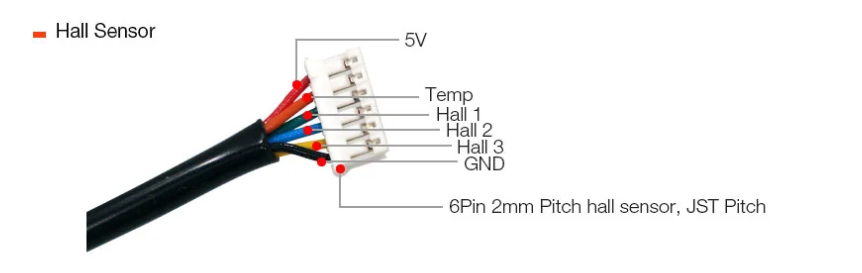
components/datasheets/Wheel motor/Wheel motor HAll connector.png
