fernandomierhicks/wheeled-leg-robot/components/Masses/2026-07-11 21.20.53.jpg

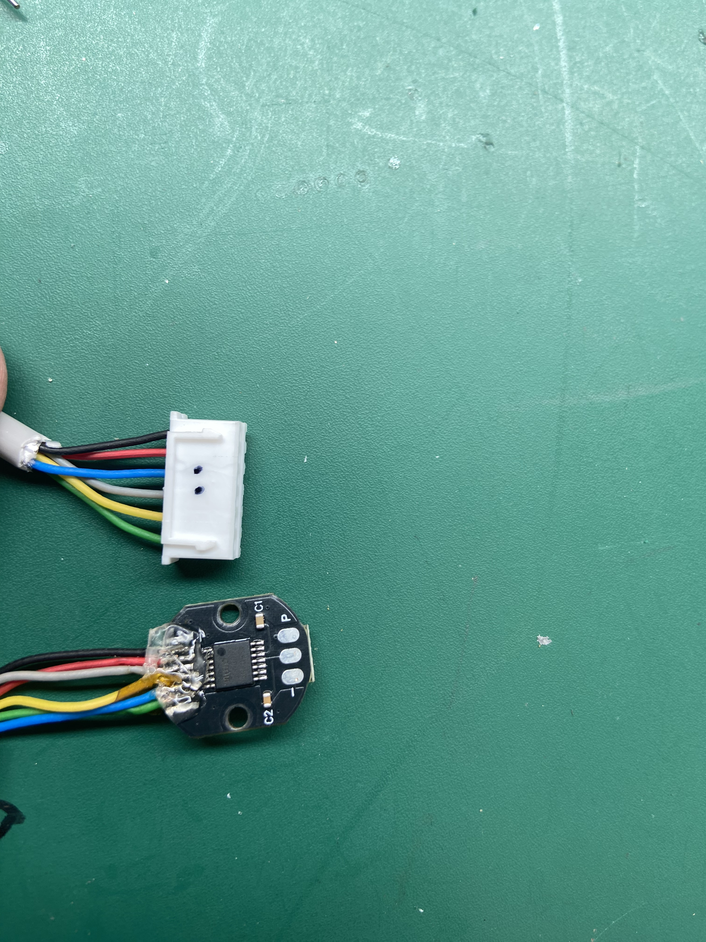
components/Masses/2026-07-11 21.20.53.jpg
