fernandomierhicks/wheeled-leg-robot/components/Masses/2026-07-13 22.07.12.jpg

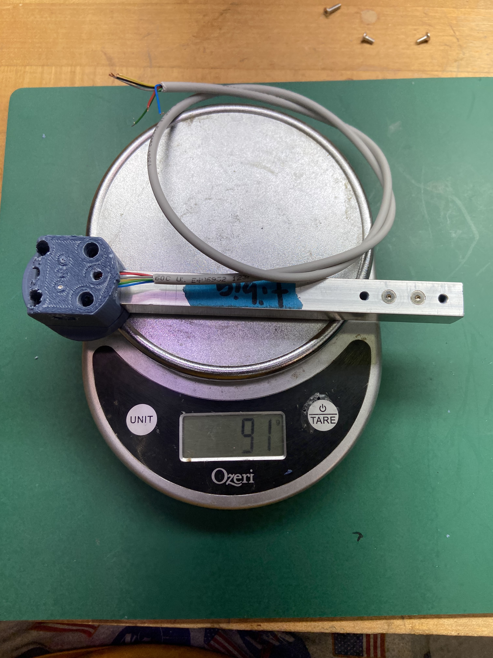
components/Masses/2026-07-13 22.07.12.jpg
