fernandomierhicks/wheeled-leg-robot/components/Masses/2026-07-13 22.14.31.jpg

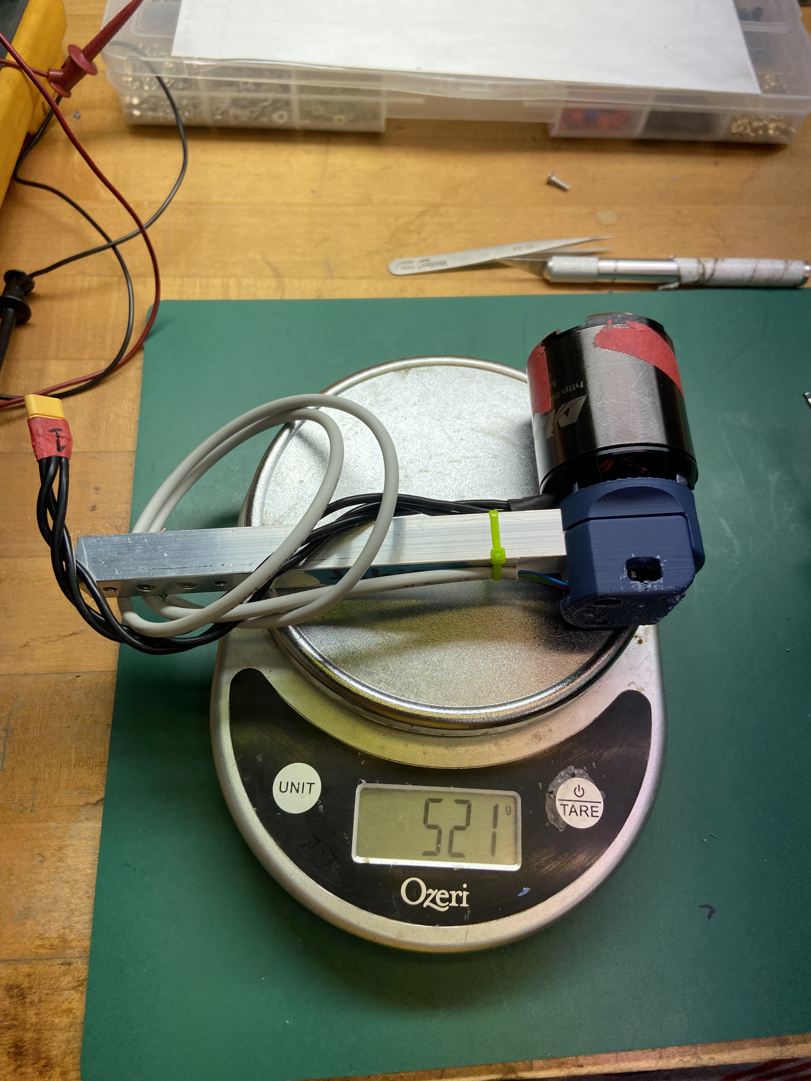
components/Masses/2026-07-13 22.14.31.jpg
