fernandomierhicks/wheeled-leg-robot/components/Masses/2026-07-13 22.24.36.jpg

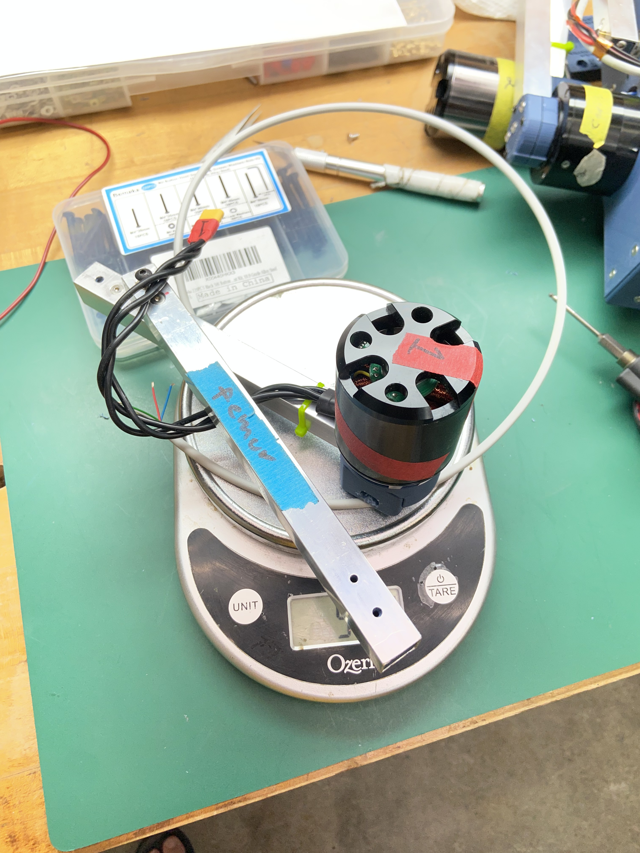
components/Masses/2026-07-13 22.24.36.jpg
