fernandomierhicks/wheeled-leg-robot/components/Masses/2026-07-14 19.01.38.jpg

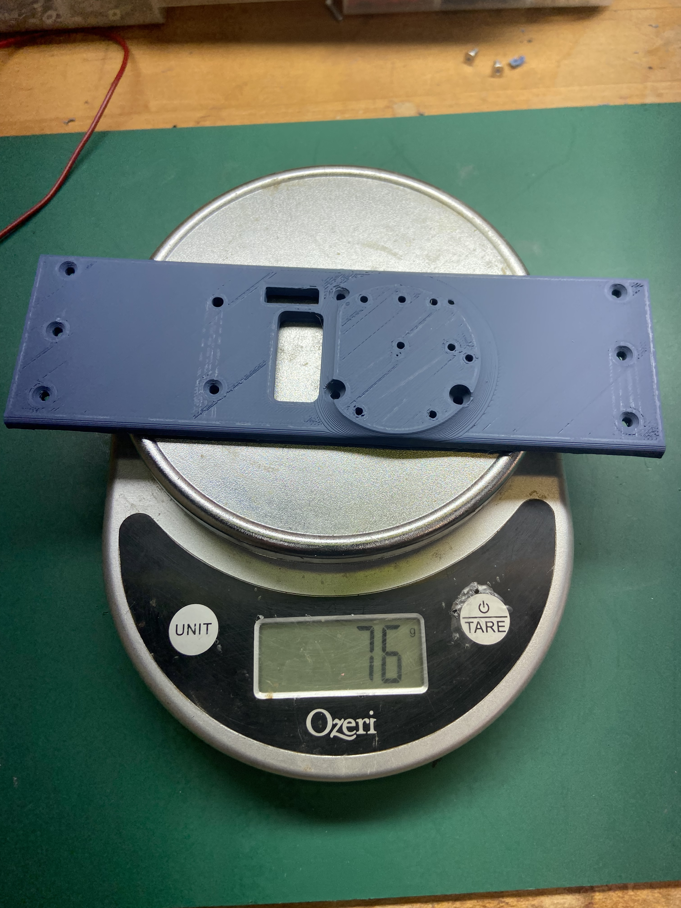
components/Masses/2026-07-14 19.01.38.jpg
