fernandomierhicks/wheeled-leg-robot/components/Masses/2026-07-22 19.05.20.jpg

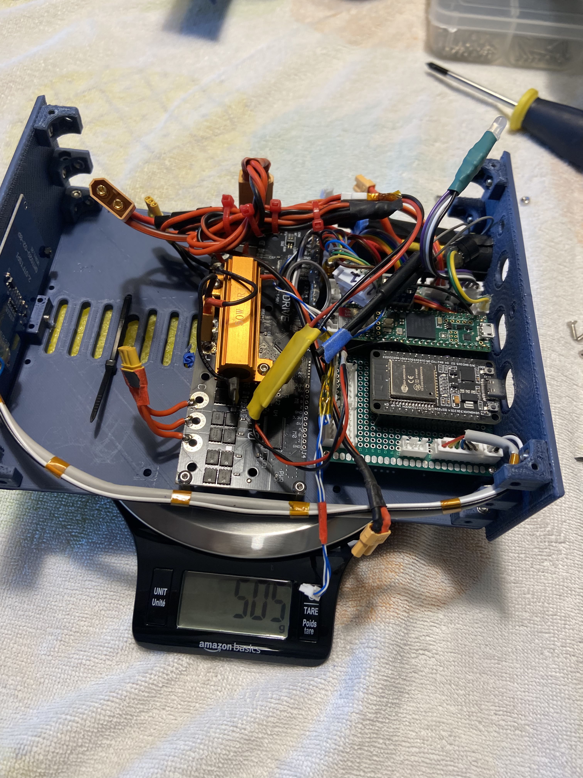
components/Masses/2026-07-22 19.05.20.jpg
