fernandomierhicks/wheeled-leg-robot/components/Masses/2026-07-22 19.41.00.jpg

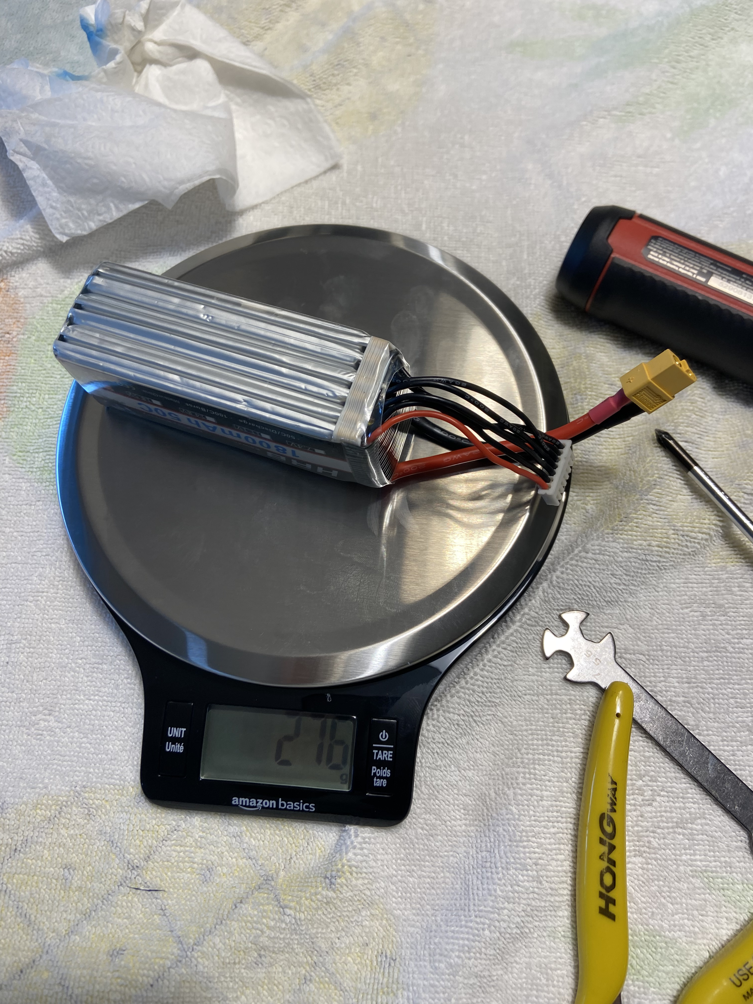
components/Masses/2026-07-22 19.41.00.jpg
