fernandomierhicks/wheeled-leg-robot/components/Masses/2026-07-22 19.50.22.jpg

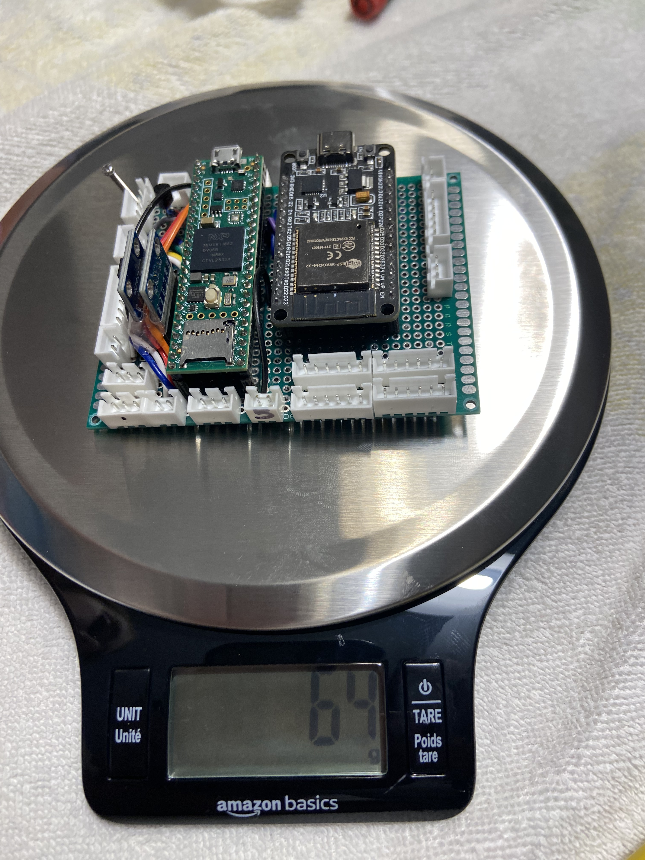
components/Masses/2026-07-22 19.50.22.jpg
