fernandomierhicks/wheeled-leg-robot/components/Masses/2026-08-09 22.43.23.jpg

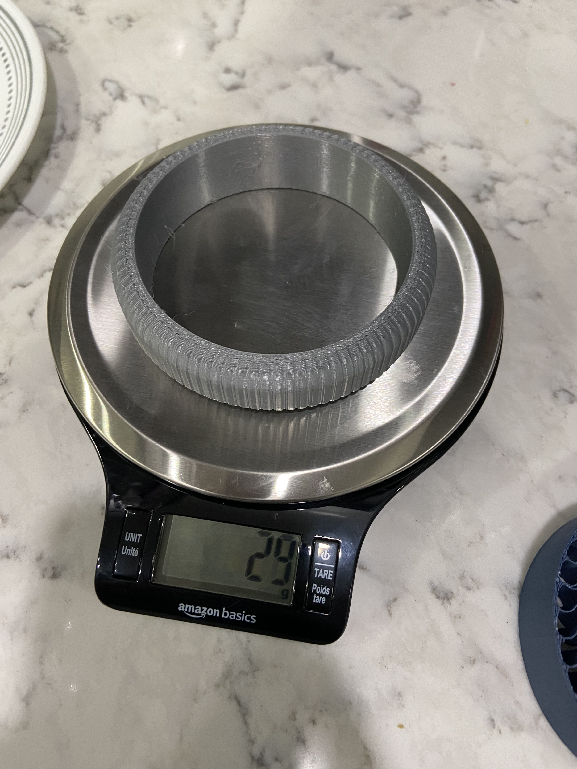
components/Masses/2026-08-09 22.43.23.jpg
