fernandomierhicks/wheeled-leg-robot/components/Masses/2026-08-09 22.43.27.jpg

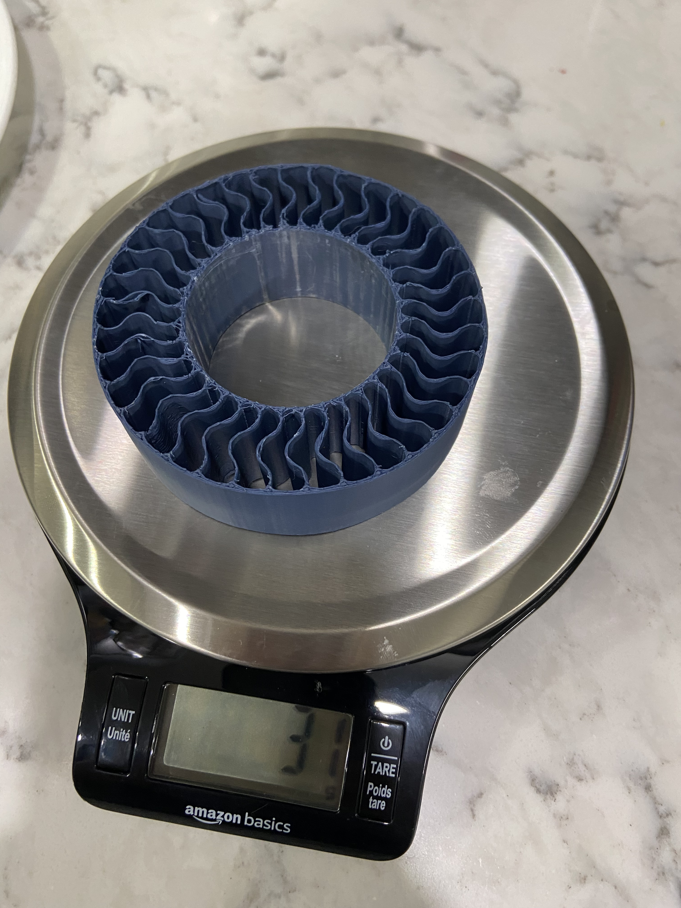
components/Masses/2026-08-09 22.43.27.jpg
