fernandomierhicks/wheeled-leg-robot/components/Masses/2026-08-09 22.44.34.jpg

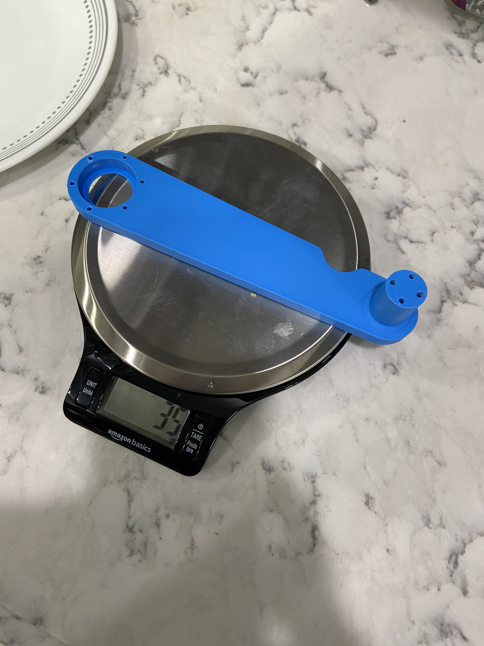
components/Masses/2026-08-09 22.44.34.jpg
