fernandomierhicks/wheeled-leg-robot/cad/aesthetics/input/parts/Coupler.step

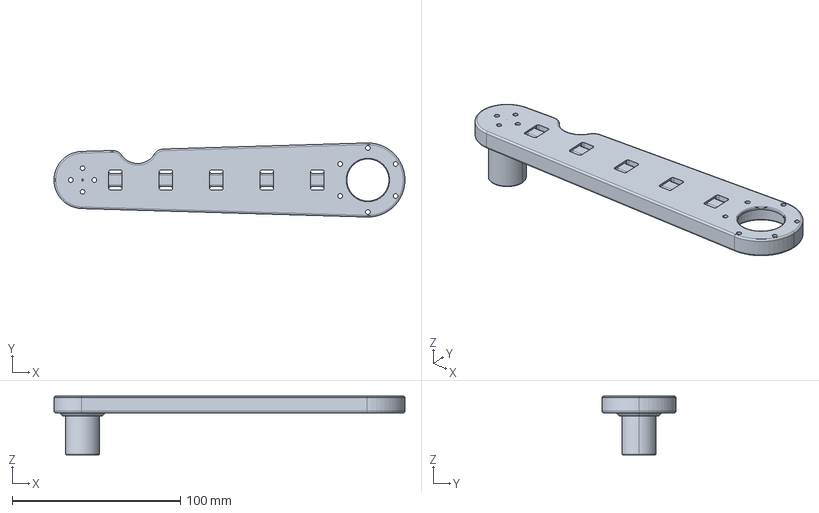
[picture p227: CAD file, 2026-10-04]
cad/aesthetics/input/parts/Coupler.step
208.5 x 44.0 x 35.0 mm
