fernandomierhicks/wheeled-leg-robot/cad/aesthetics/out/print/Coupler/Coupler_glacier.3mf

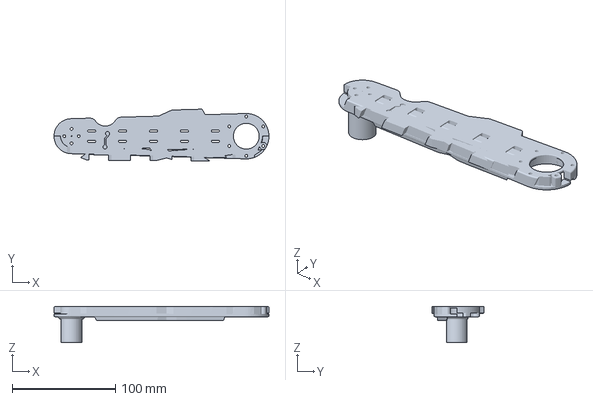
[picture p228: CAD file, 2026-10-03]
cad/aesthetics/out/print/Coupler/Coupler_glacier.3mf
208.6 x 50.2 x 35.0 mm
