fernandomierhicks/wheeled-leg-robot/cad/aesthetics/out/print/Femur/Femur_glacier.3mf

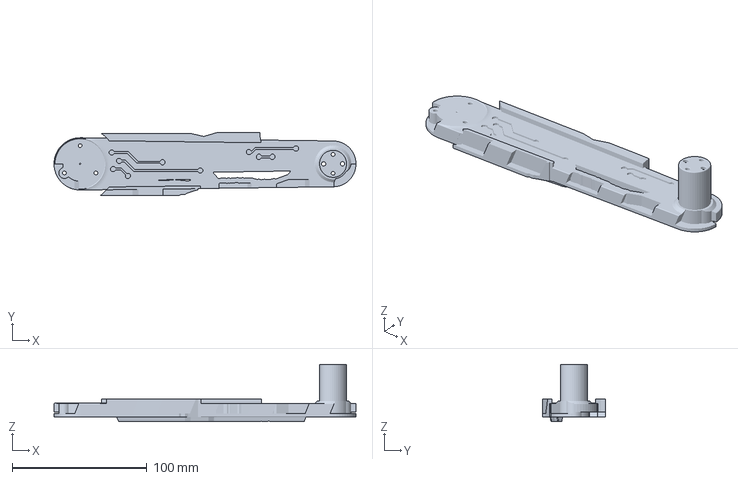
[picture p229: CAD file, 2026-10-03]
cad/aesthetics/out/print/Femur/Femur_glacier.3mf
224.0 x 46.8 x 42.5 mm
