fernandomierhicks/wheeled-leg-robot/cad/aesthetics/out/print/other colors/Femur/Femur_scalpel.3mf

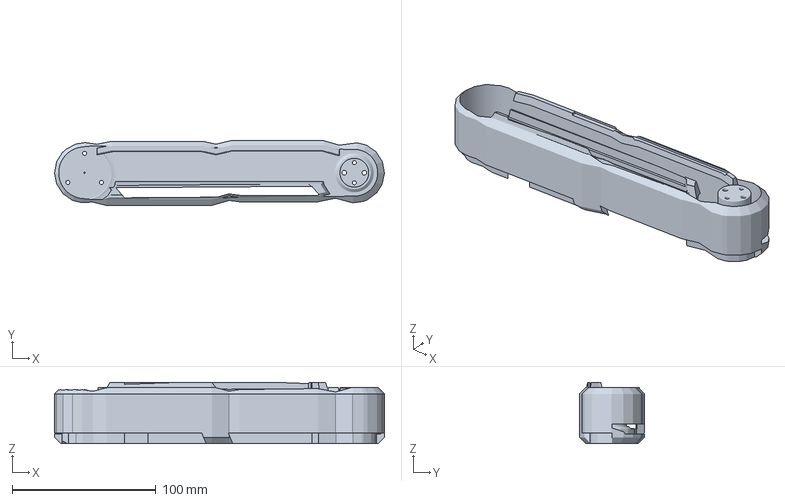
[picture p230: CAD file, 2026-09-20]
cad/aesthetics/out/print/other colors/Femur/Femur_scalpel.3mf
229.5 x 44.9 x 42.5 mm
