fernandomierhicks/wheeled-leg-robot/cad/aesthetics/out/print/other colors/Tibia/Tibia_pulsar.3mf

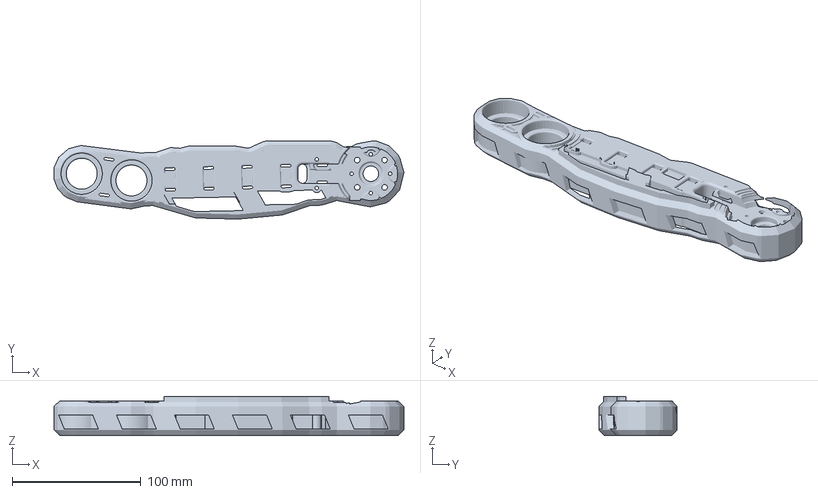
[picture p231: CAD file, 2026-09-20]
cad/aesthetics/out/print/other colors/Tibia/Tibia_pulsar.3mf
271.7 x 60.7 x 30.5 mm
