fernandomierhicks/wheeled-leg-robot/cad/aesthetics/out/print/RobotMount/RobotMount_glacier.3mf

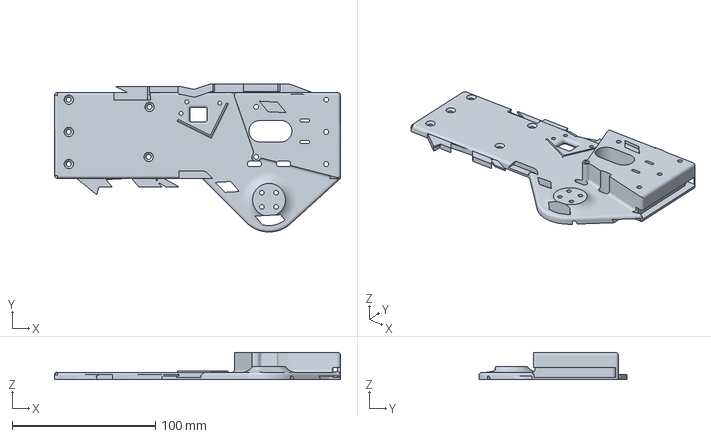
[picture p232: CAD file, 2026-09-20]
cad/aesthetics/out/print/RobotMount/RobotMount_glacier.3mf
200.0 x 103.5 x 19.0 mm
