fernandomierhicks/wheeled-leg-robot/cad/aesthetics/out/print/Side panel/Side panel_glacier.3mf

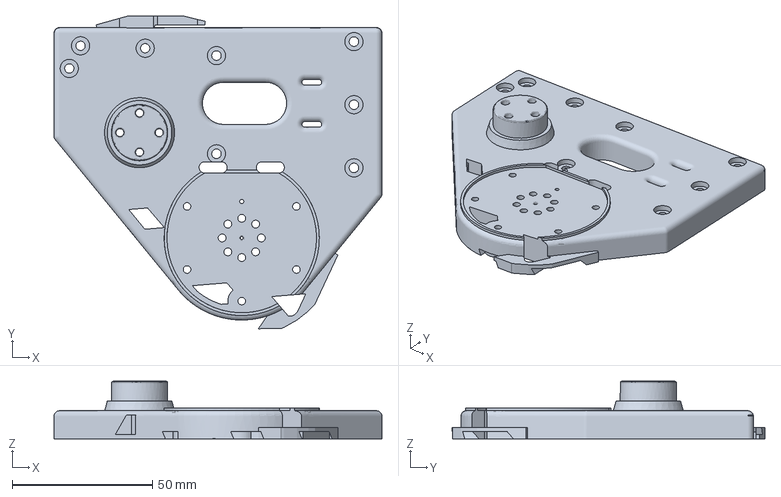
[picture p233: CAD file, 2026-09-20]
cad/aesthetics/out/print/Side panel/Side panel_glacier.3mf
116.9 x 111.4 x 20.5 mm
