fernandomierhicks/wheeled-leg-robot/cad/aesthetics/out/print/Tibia/Tibia_glacier.3mf

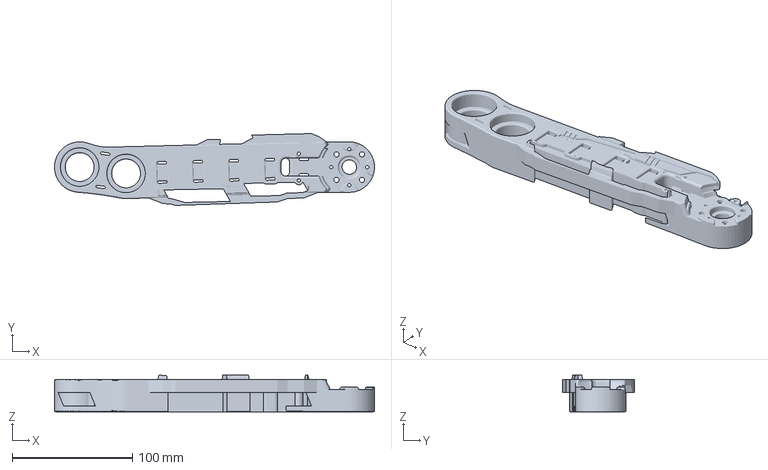
[picture p234: CAD file, 2026-09-22]
cad/aesthetics/out/print/Tibia/Tibia_glacier.3mf
266.5 x 59.9 x 30.5 mm
