fernandomierhicks/wheeled-leg-robot/cad/References to other robots/Robot Assembly STEP Files/Lower_Link_Left.3mf

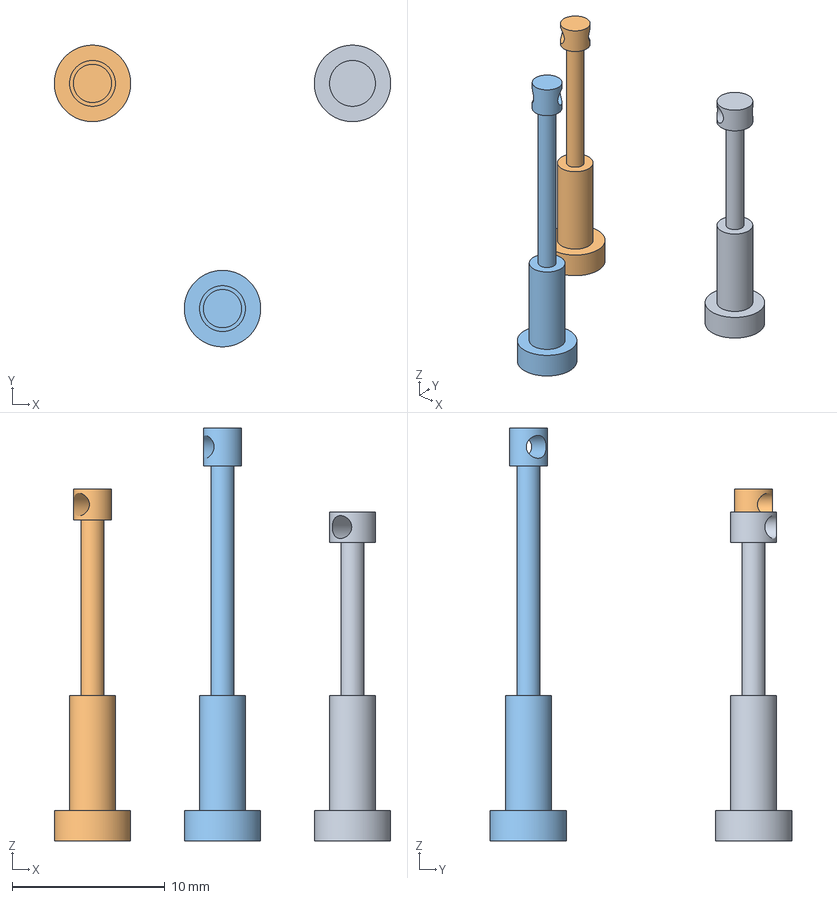
[picture p235: CAD file, 2026-07-30]
cad/References to other robots/Robot Assembly STEP Files/Lower_Link_Left.3mf
22.0 x 19.7 x 27.0 mm
Small Piston.stl
Medium Piston.stl
Large Piston.stl
