fernandomierhicks/wheeled-leg-robot/cad/solidworks_api/out/print/BumperBack_bambu.3mf

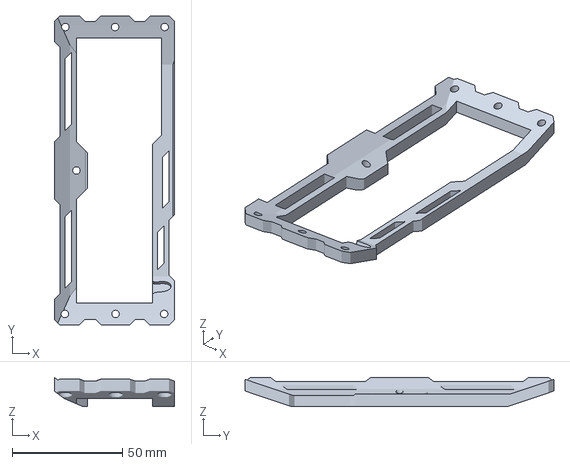
[picture p236: CAD file, 2026-10-17]
cad/solidworks_api/out/print/BumperBack_bambu.3mf
54.5 x 140.0 x 13.2 mm
