fernandomierhicks/wheeled-leg-robot/cad/v1 circular tube with end rods/wheel/Motor/Mount.SLDPRT

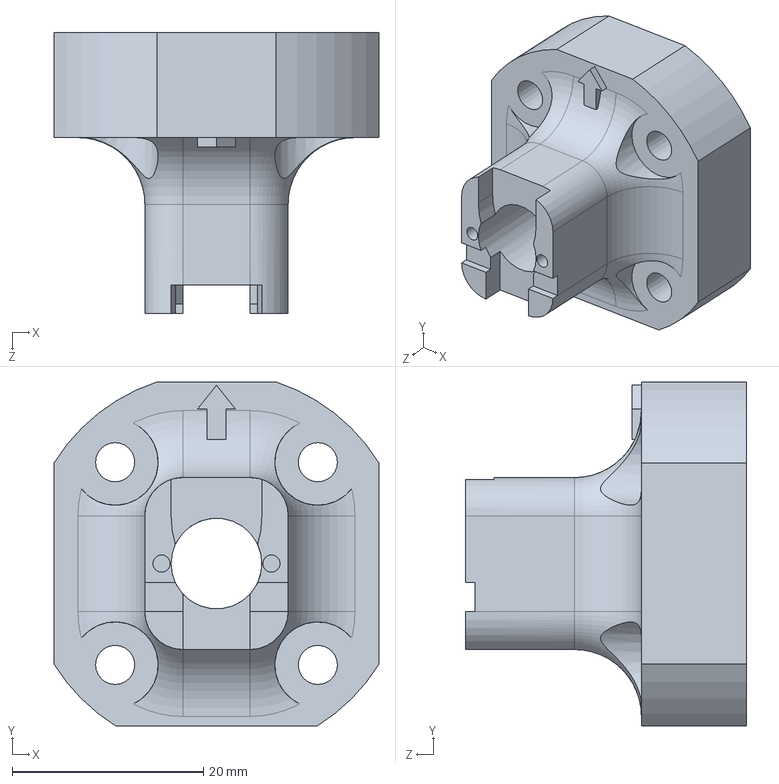
[picture p237: CAD file, 2026-08-07]
cad/v1 circular tube with end rods/wheel/Motor/Mount.SLDPRT
34.0 x 36.0 x 29.4 mm
