fernandomierhicks/wheeled-leg-robot/cad/v1 circular tube with end rods/wheel/Wheel.SLDPRT

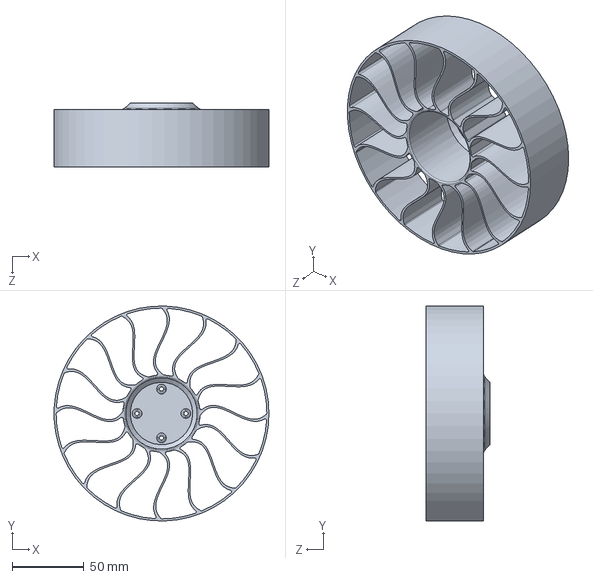
[picture p238: CAD file, 2026-04-28]
cad/v1 circular tube with end rods/wheel/Wheel.SLDPRT
150.0 x 149.9 x 44.7 mm
