fernandomierhicks/wheeled-leg-robot/cad/v2 square tube/wheel/Wheel.SLDPRT

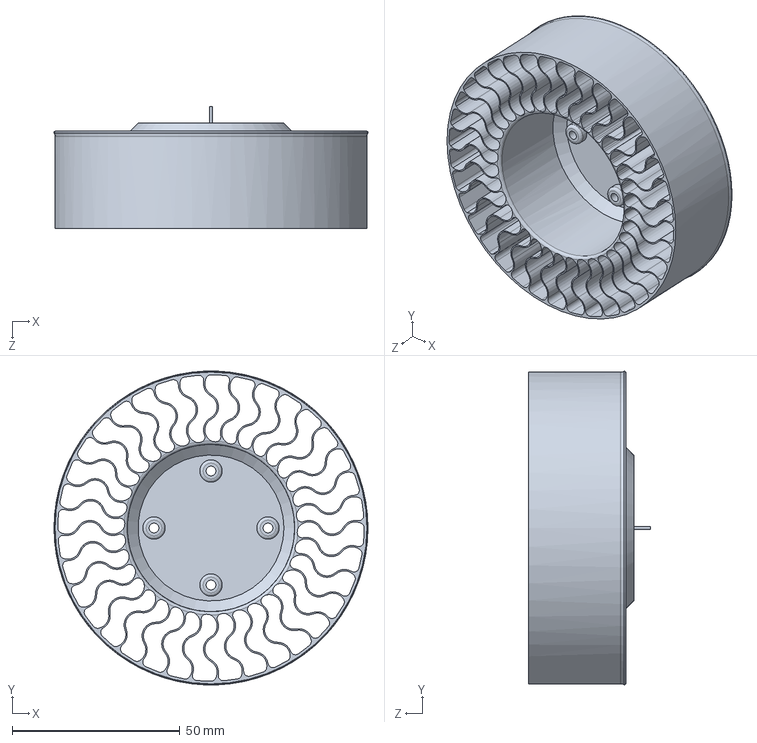
[picture p239: CAD file, 2026-07-31]
cad/v2 square tube/wheel/Wheel.SLDPRT
93.6 x 93.6 x 36.5 mm
