fernandomierhicks/wheeled-leg-robot/cad/v3 shifted CG thin RGB Limit Switch/links/Stopper.SLDPRT

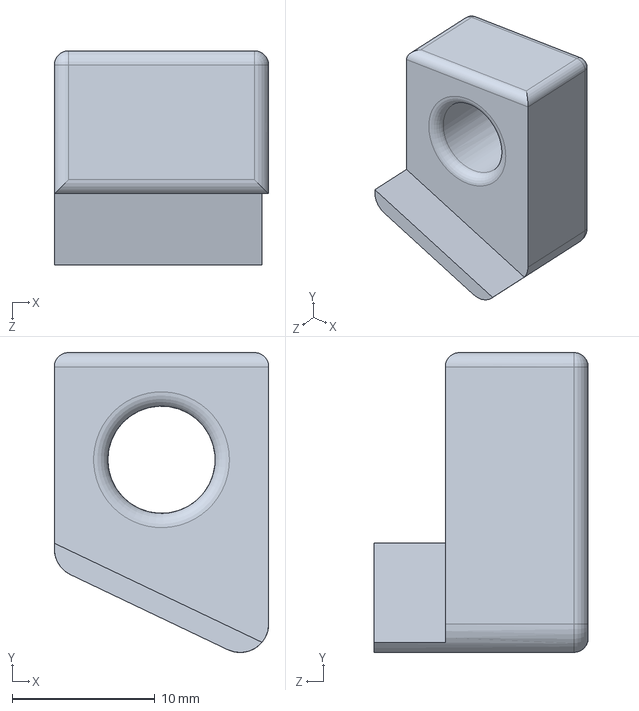
[picture p240: CAD file, 2026-07-30]
cad/v3 shifted CG thin RGB Limit Switch/links/Stopper.SLDPRT
15.0 x 21.0 x 15.0 mm
