fernandomierhicks/wheeled-leg-robot/cad/v3 shifted CG thin RGB Limit Switch/SupportWheel.SLDPRT

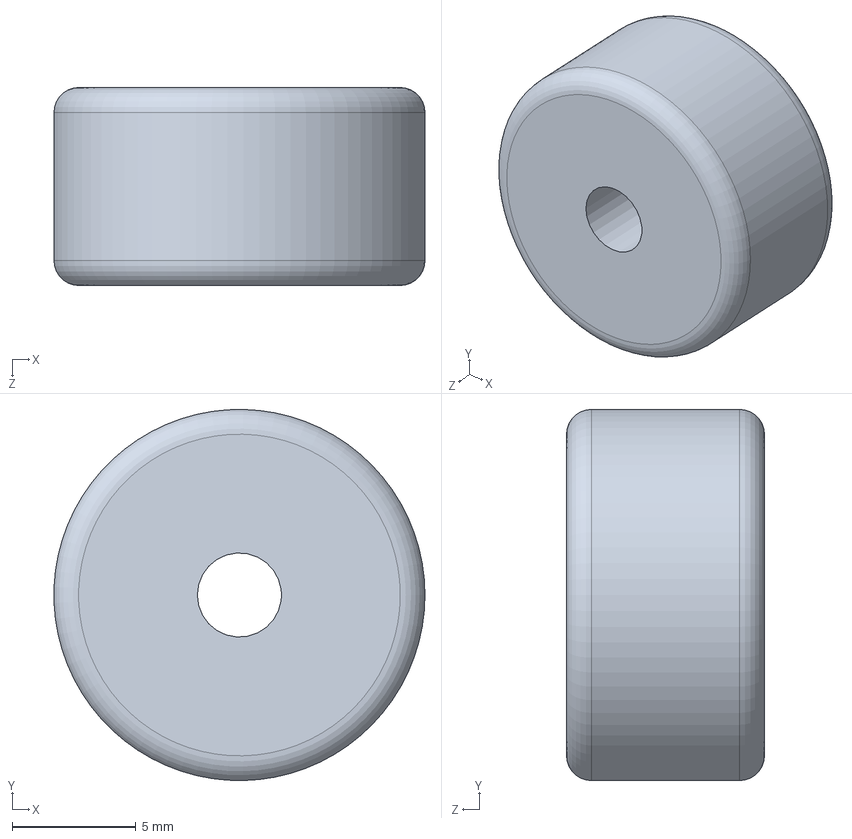
[picture p241: CAD file, 2026-08-10]
cad/v3 shifted CG thin RGB Limit Switch/SupportWheel.SLDPRT
15.0 x 15.0 x 8.00 mm
