fernandomierhicks/wheeled-leg-robot/cad/v3 shifted CG thin RGB Limit Switch/wheel/Motor/Encoder.SLDPRT

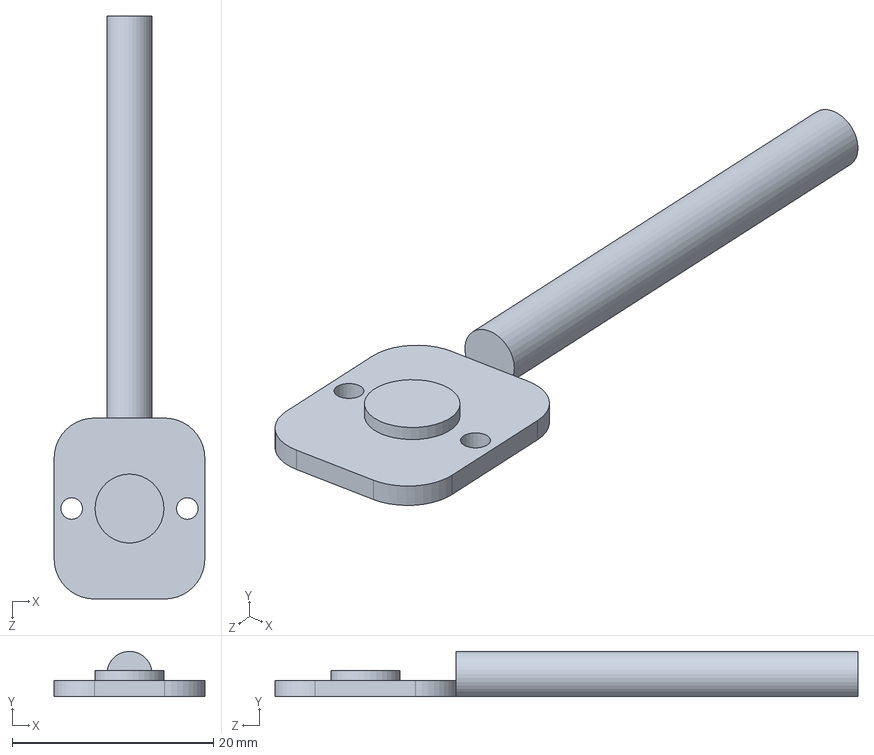
[picture p242: CAD file, 2026-07-17]
cad/v3 shifted CG thin RGB Limit Switch/wheel/Motor/Encoder.SLDPRT
15.0 x 4.50 x 58.0 mm
