fernandomierhicks/wheeled-leg-robot/cad/v3 shifted CG thin RGB Limit Switch/wheel/Tire.SLDPRT

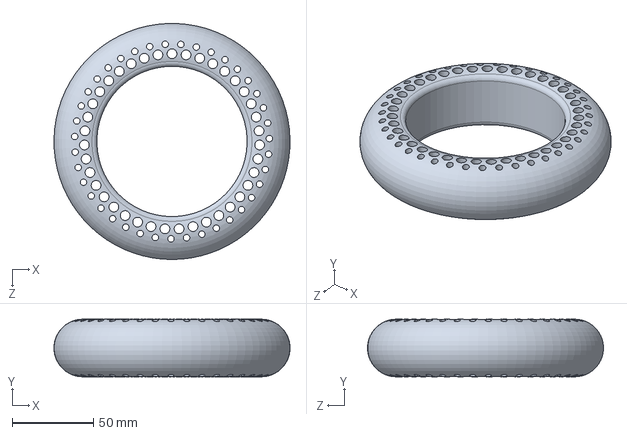
[picture p243: CAD file, 2026-05-29]
cad/v3 shifted CG thin RGB Limit Switch/wheel/Tire.SLDPRT
145.3 x 35.4 x 145.3 mm
