fernandomierhicks/wheeled-leg-robot/cad/v4 Larger Ball bearings/Other/WheelHanger.SLDPRT

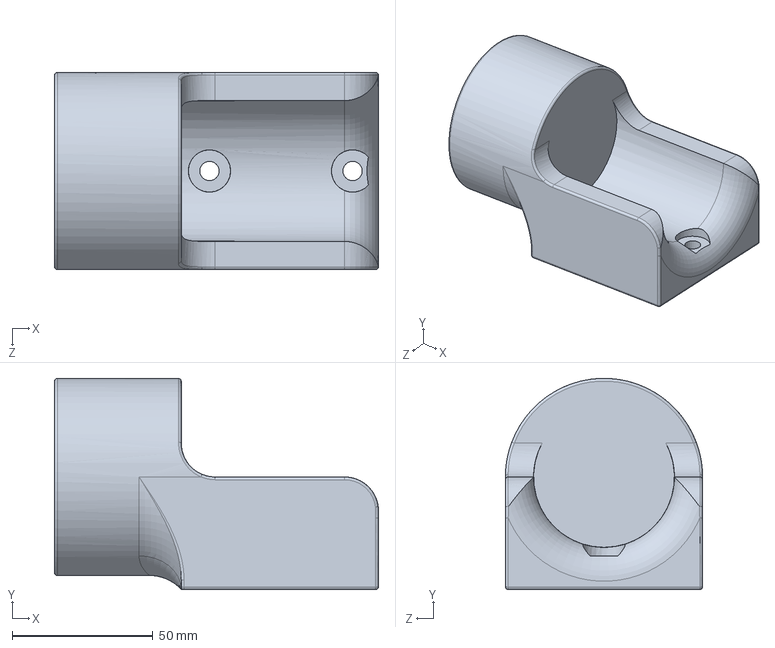
[picture p244: CAD file, 2026-08-10]
cad/v4 Larger Ball bearings/Other/WheelHanger.SLDPRT
115.0 x 75.0 x 70.0 mm
