fernandomierhicks/wheeled-leg-robot/cad/v4 Larger Ball bearings/STEP exports/Middle multiple parts/Femur.STEP

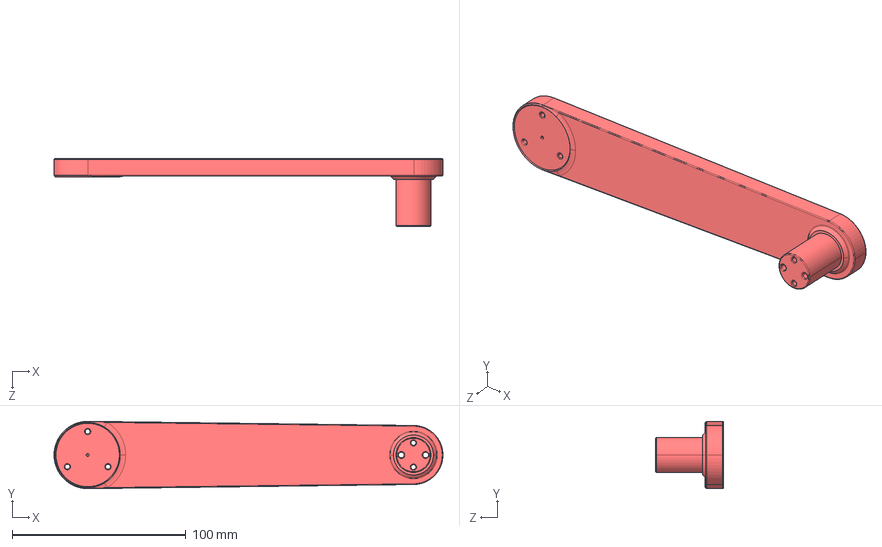
[picture p245: CAD file, 2026-10-04]
cad/v4 Larger Ball bearings/STEP exports/Middle multiple parts/Femur.STEP
224.0 x 38.8 x 39.0 mm
