fernandomierhicks/wheeled-leg-robot/cad/v5 Ai designed/_originals/Body/SmallBearingWahser.SLDPRT

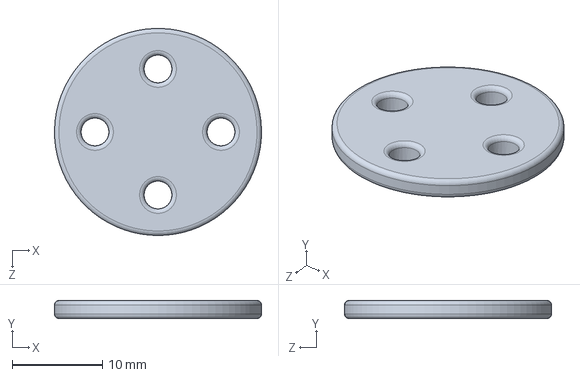
[picture p246: CAD file, 2026-10-04]
cad/v5 Ai designed/_originals/Body/SmallBearingWahser.SLDPRT
23.0 x 2.00 x 23.0 mm
