fernandomierhicks/wheeled-leg-robot/cad/v5 Ai designed/_originals/pre_bumper_slots_2026-10-16/Facet/BumperBack.SLDPRT

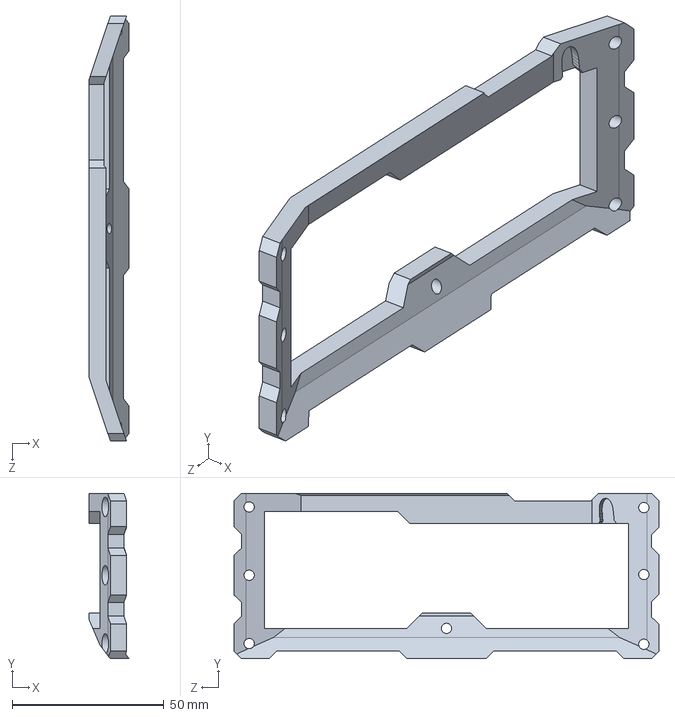
[picture p247: CAD file, 2026-10-17]
cad/v5 Ai designed/_originals/pre_bumper_slots_2026-10-16/Facet/BumperBack.SLDPRT
13.2 x 54.5 x 140.0 mm
