fernandomierhicks/wheeled-leg-robot/cad/v5 Ai designed/_originals/pre_facet_round3_2026-10-14/Facet/FacetFront.SLDPRT

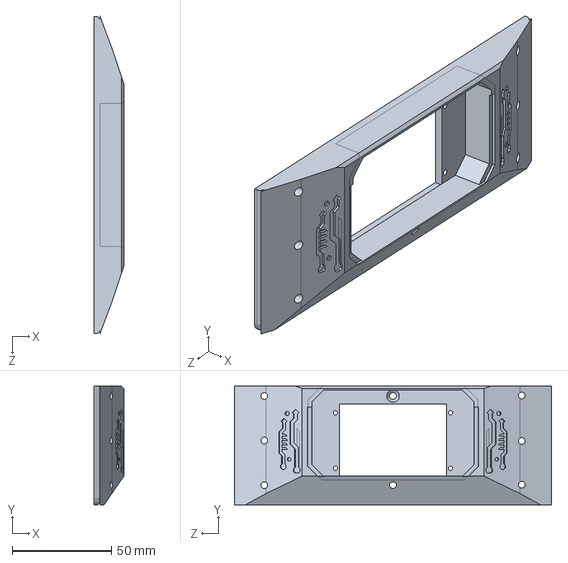
[picture p250: CAD file, 2026-10-17]
cad/v5 Ai designed/_originals/pre_facet_round3_2026-10-14/Facet/FacetFront.SLDPRT
15.0 x 60.0 x 160.0 mm
