fernandomierhicks/wheeled-leg-robot/cad/v5 Ai designed/_originals/pre_one_grey_2026-10-16/FacetHood.SLDPRT

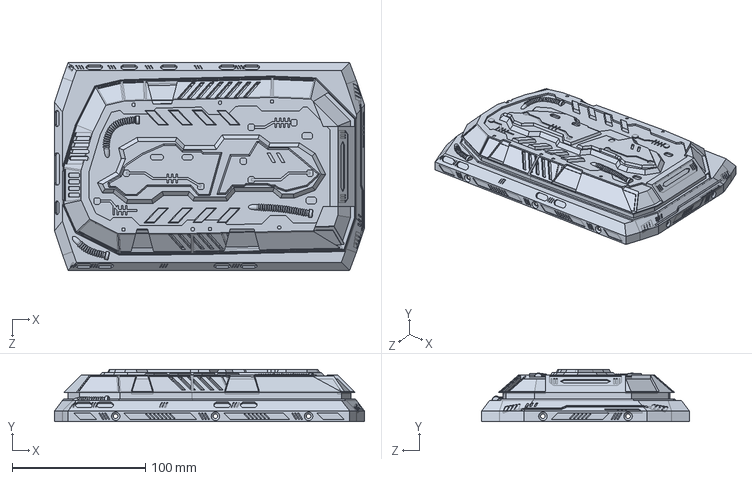
[picture p252: CAD file, 2026-10-17]
cad/v5 Ai designed/_originals/pre_one_grey_2026-10-16/FacetHood.SLDPRT
233.0 x 39.2 x 156.0 mm
