fernandomierhicks/wheeled-leg-robot/cad/v5 Ai designed/_originals/pre_pipes_2026-10-07/Box/TailStrut/TailStrut.SLDPRT

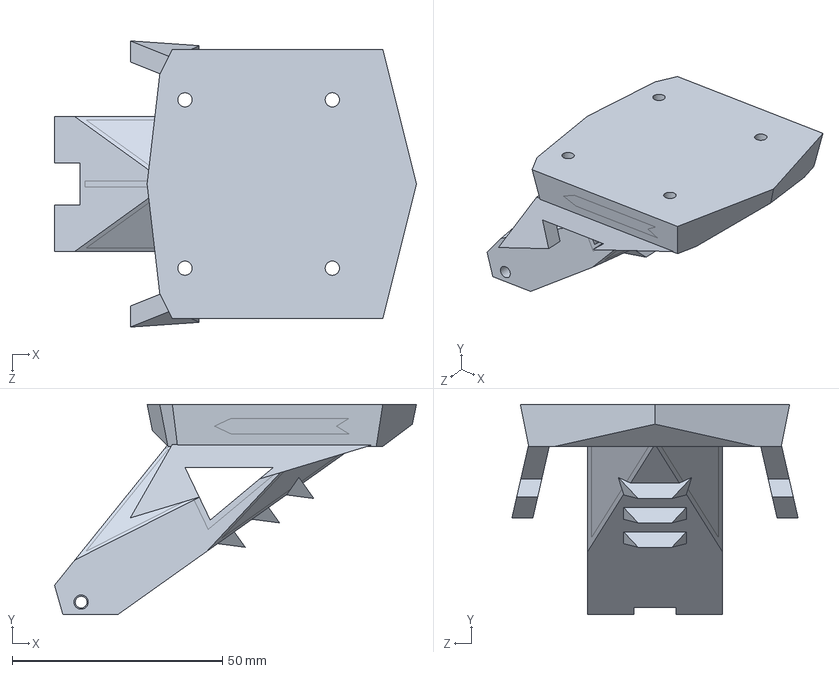
[picture p253: CAD file, 2026-10-08]
cad/v5 Ai designed/_originals/pre_pipes_2026-10-07/Box/TailStrut/TailStrut.SLDPRT
86.0 x 50.0 x 68.0 mm
