fernandomierhicks/wheeled-leg-robot/cad/v5 Ai designed/_originals/pre_printcolours_2026-10-12/Box/TailStrut/TailStrut.SLDPRT

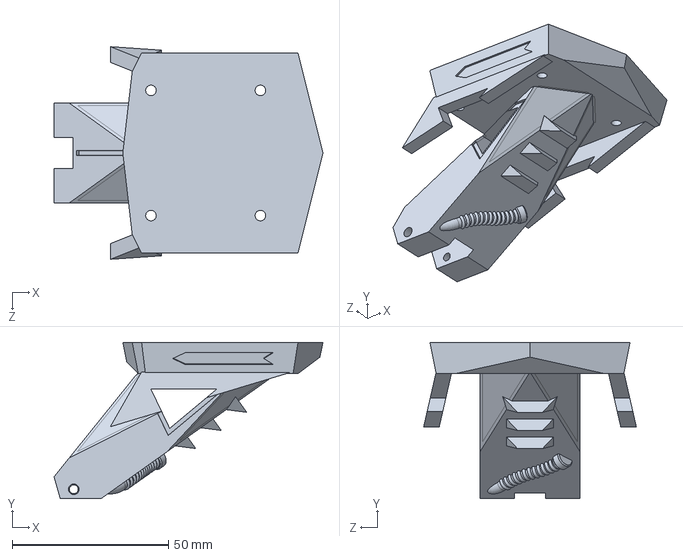
[picture p254: CAD file, 2026-10-13]
cad/v5 Ai designed/_originals/pre_printcolours_2026-10-12/Box/TailStrut/TailStrut.SLDPRT
86.0 x 50.0 x 68.0 mm
