fernandomierhicks/wheeled-leg-robot/cad/v5 Ai designed/_originals/pre_relief_2026-10-09/Motor/Wheel Motor/Wheel.SLDPRT

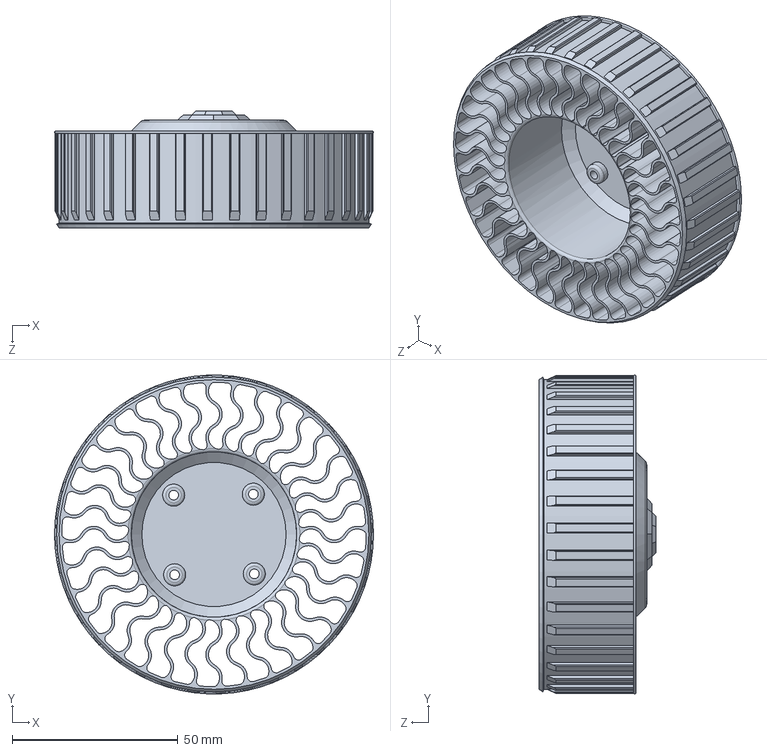
[picture p255: CAD file, 2026-10-13]
cad/v5 Ai designed/_originals/pre_relief_2026-10-09/Motor/Wheel Motor/Wheel.SLDPRT
96.2 x 96.1 x 35.4 mm
