fernandomierhicks/wheeled-leg-robot/cad/v5 Ai designed/_originals/pre_relief_2026-10-09/print/EncoderCableClamp_glacier_native.3mf

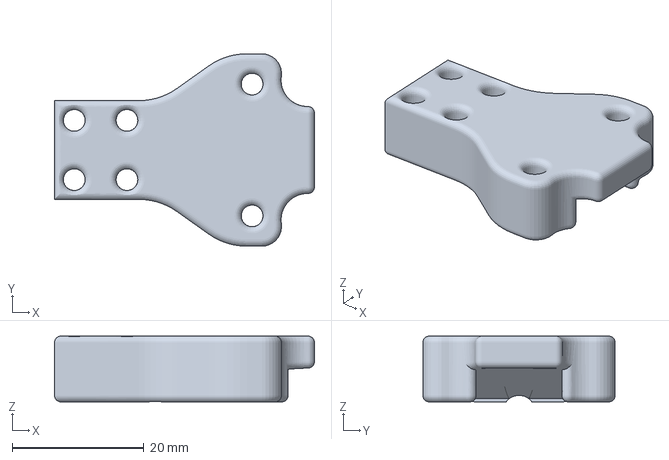
[picture p256: CAD file, 2026-10-09]
cad/v5 Ai designed/_originals/pre_relief_2026-10-09/print/EncoderCableClamp_glacier_native.3mf
39.5 x 29.2 x 10.0 mm
