fernandomierhicks/wheeled-leg-robot/cad/v5 Ai designed/_originals/pre_trapezoids_2026-10-12/Box/TailStrut/TailStrut.SLDPRT

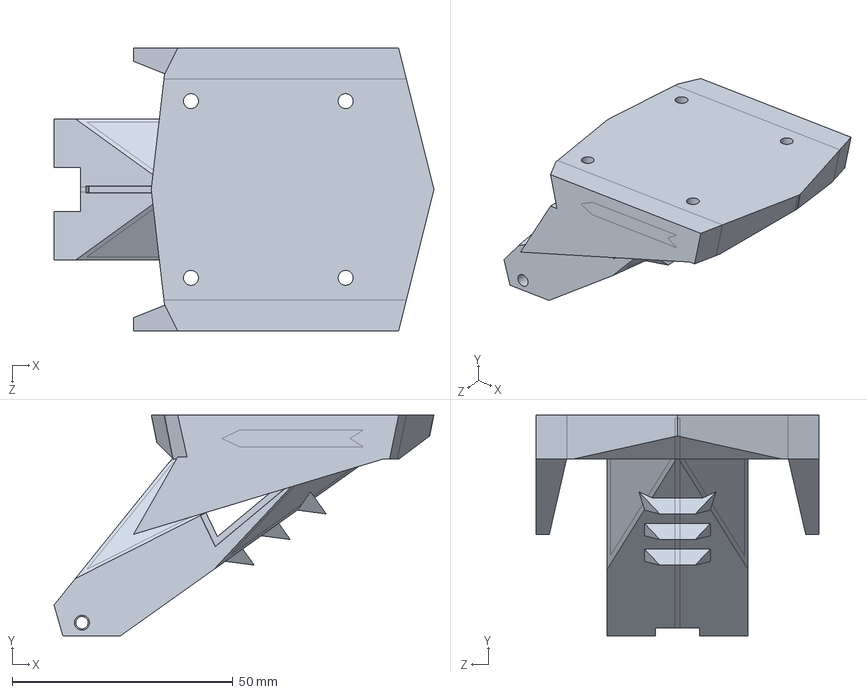
[picture p257: CAD file, 2026-10-13]
cad/v5 Ai designed/_originals/pre_trapezoids_2026-10-12/Box/TailStrut/TailStrut.SLDPRT
86.0 x 50.0 x 64.0 mm
