fernandomierhicks/wheeled-leg-robot/cad/v5 Ai designed/_originals/pre_visor_2026-10-08/Box/Facet/FacetHood.SLDPRT

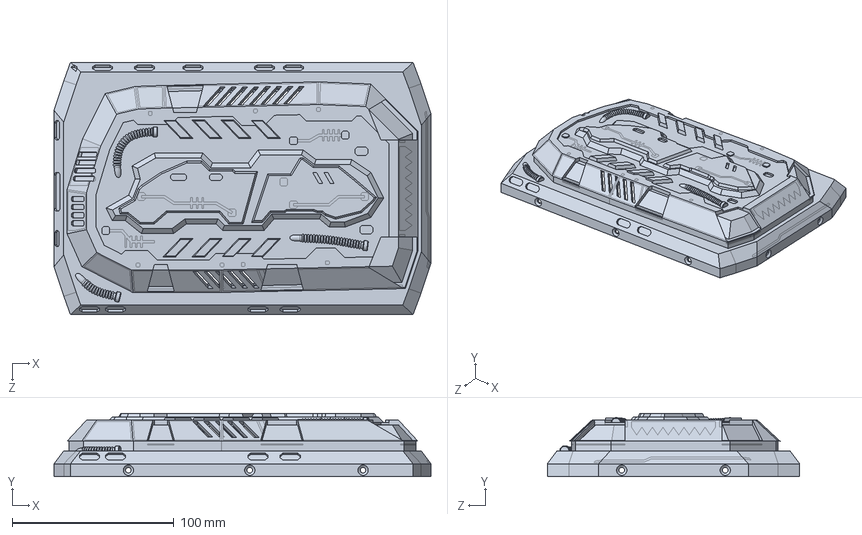
[picture p258: CAD file, 2026-10-08]
cad/v5 Ai designed/_originals/pre_visor_2026-10-08/Box/Facet/FacetHood.SLDPRT
233.0 x 39.2 x 156.0 mm
