fernandomierhicks/wheeled-leg-robot/cad/v5 Ai designed/ai_components/hello_box_multicolor_bambu.3mf

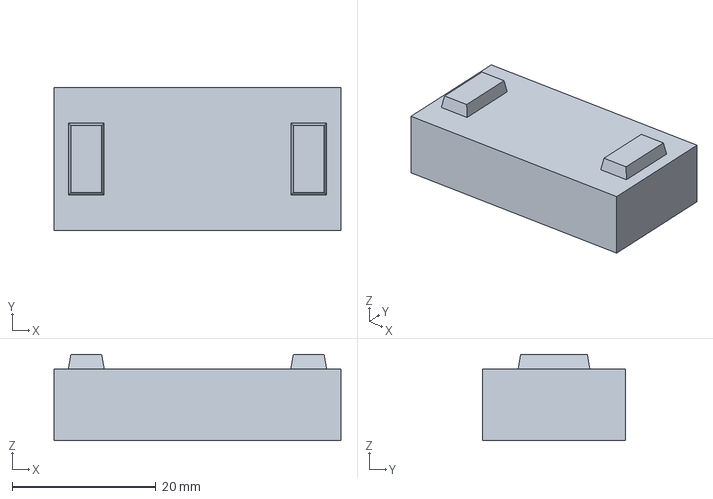
[picture p259: CAD file, 2026-10-04]
cad/v5 Ai designed/ai_components/hello_box_multicolor_bambu.3mf
40.0 x 20.0 x 12.0 mm
