fernandomierhicks/wheeled-leg-robot/cad/v5 Ai designed/Body/LimitSwitch/LimitSwitch.SLDPRT

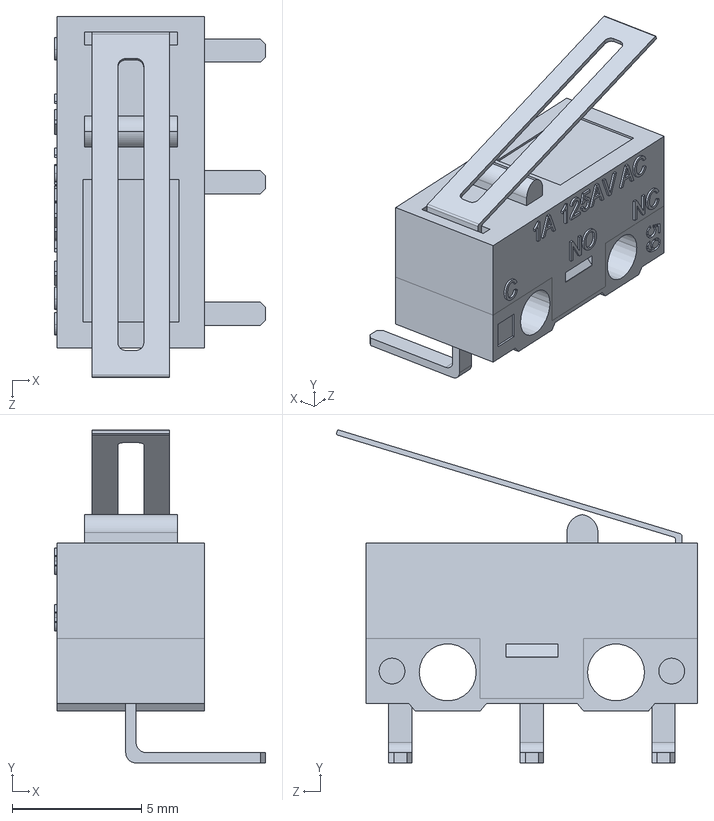
[picture p260: CAD file, 2026-10-17]
cad/v5 Ai designed/Body/LimitSwitch/LimitSwitch.SLDPRT
8.15 x 12.9 x 13.9 mm
