fernandomierhicks/wheeled-leg-robot/cad/v5 Ai designed/Box/Concepts/_originals/pre_round3_update_2026-10-04/BoxConcept_D_facet.SLDPRT

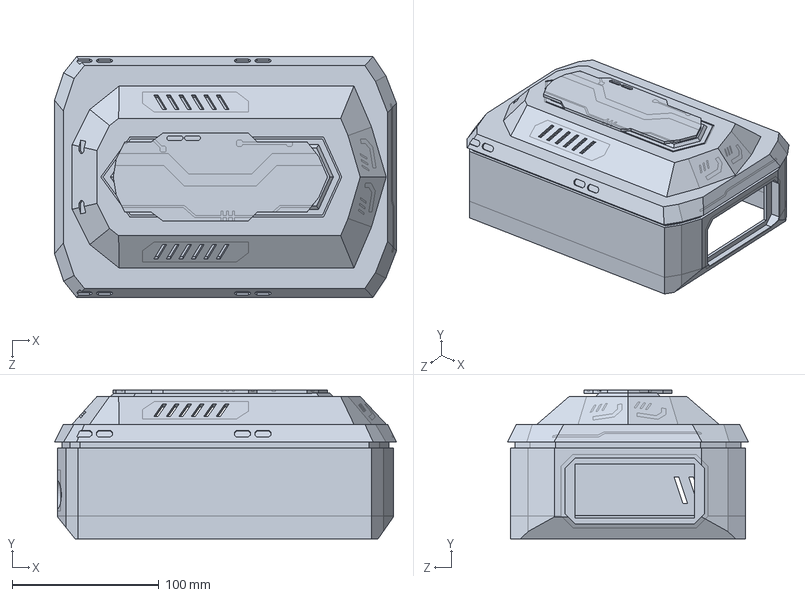
[picture p261: CAD file, 2026-10-08]
cad/v5 Ai designed/Box/Concepts/_originals/pre_round3_update_2026-10-04/BoxConcept_D_facet.SLDPRT
233.0 x 101.2 x 164.0 mm
