fernandomierhicks/wheeled-leg-robot/cad/v5 Ai designed/Box/Concepts/BoxConcept_A_helm.SLDPRT

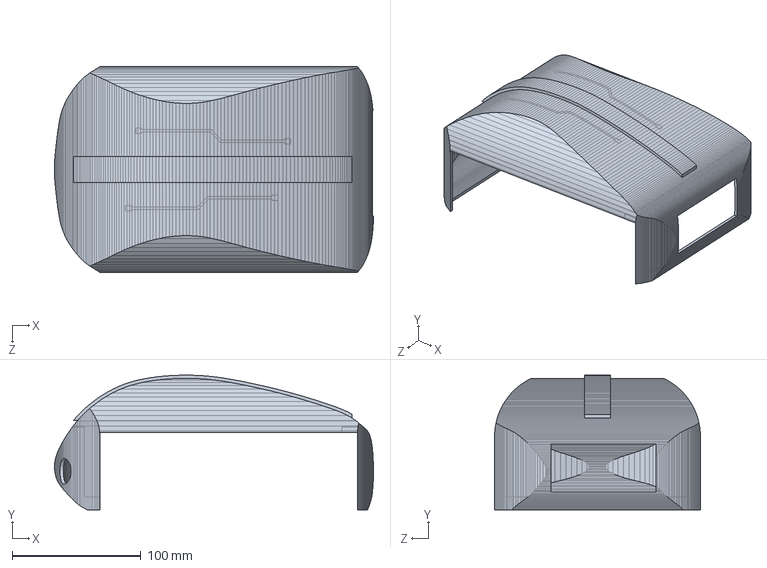
[picture p262: CAD file, 2026-10-08]
cad/v5 Ai designed/Box/Concepts/BoxConcept_A_helm.SLDPRT
247.8 x 104.7 x 160.0 mm
