fernandomierhicks/wheeled-leg-robot/cad/v5 Ai designed/Box/Electronics/LaserRange.SLDPRT

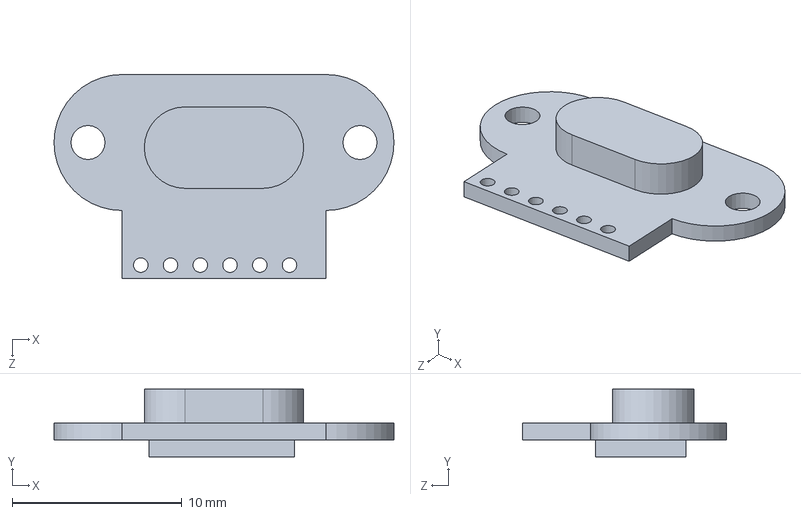
[picture p263: CAD file, 2026-10-17]
cad/v5 Ai designed/Box/Electronics/LaserRange.SLDPRT
20.0 x 4.00 x 12.0 mm
