fernandomierhicks/wheeled-leg-robot/cad/v5 Ai designed/Box/Facet/NeopixelStrip.SLDPRT

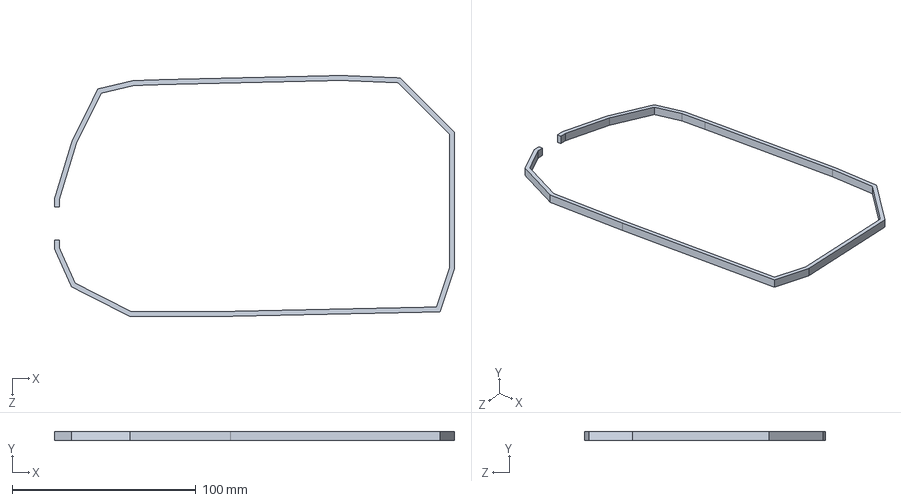
[picture p264: CAD file, 2026-10-17]
cad/v5 Ai designed/Box/Facet/NeopixelStrip.SLDPRT
217.8 x 5.10 x 131.3 mm
