fernandomierhicks/wheeled-leg-robot/cad/v5 Ai designed/Box/TailStrut/TailStrut.SLDPRT

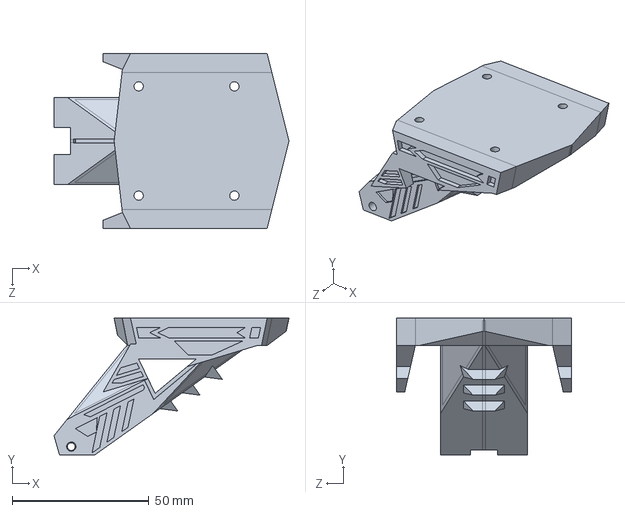
[picture p265: CAD file, 2026-10-17]
cad/v5 Ai designed/Box/TailStrut/TailStrut.SLDPRT
86.0 x 50.0 x 64.0 mm
