fernandomierhicks/wheeled-leg-robot/cad/v5 Ai designed/Common/M2.5 Roundhead.SLDPRT

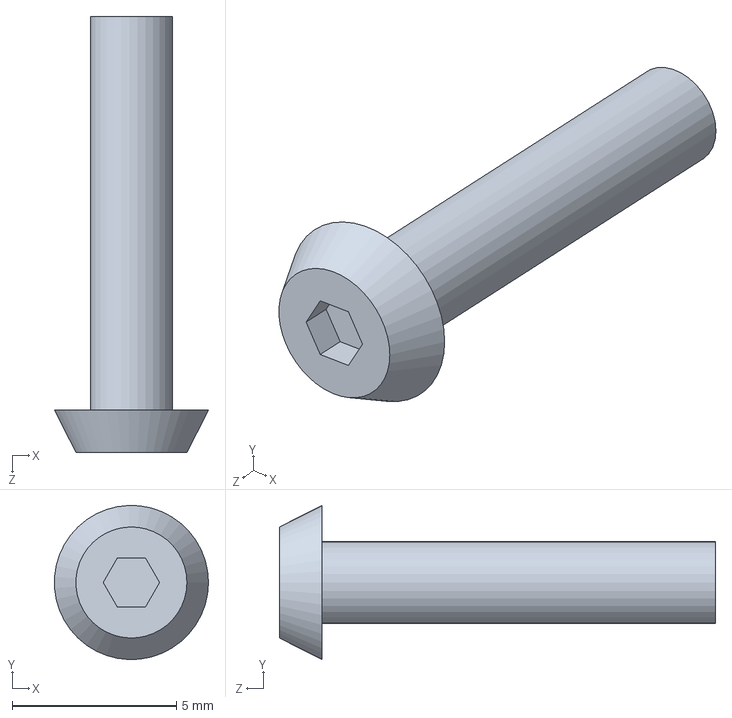
[picture p266: CAD file, 2026-10-17]
cad/v5 Ai designed/Common/M2.5 Roundhead.SLDPRT
4.69 x 4.70 x 13.3 mm
