fernandomierhicks/wheeled-leg-robot/cad/v5 Ai designed/Motor/AK45 simulator/ak sim body.SLDPRT

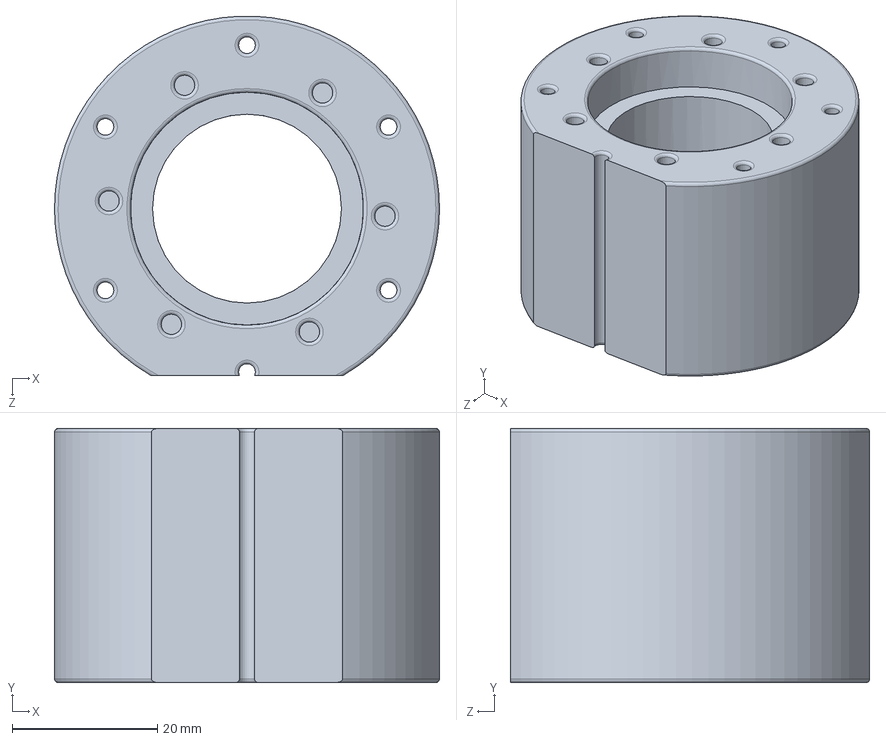
[picture p267: CAD file, 2026-10-17]
cad/v5 Ai designed/Motor/AK45 simulator/ak sim body.SLDPRT
53.0 x 35.0 x 49.5 mm
