fernandomierhicks/wheeled-leg-robot/cad/v5 Ai designed/Motor/AK45-10 Stator.SLDPRT

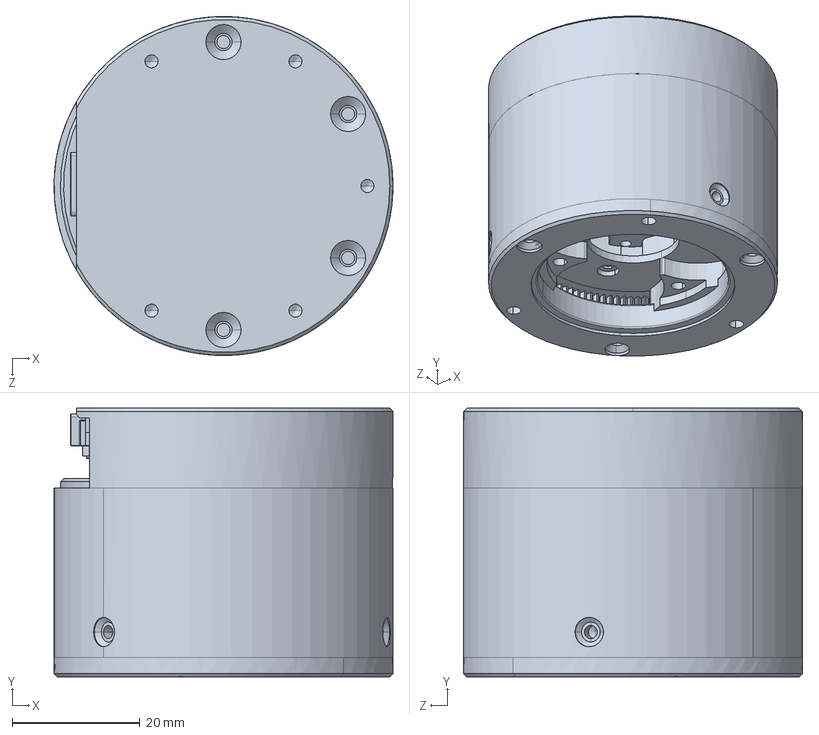
[picture p268: CAD file, 2026-10-17]
cad/v5 Ai designed/Motor/AK45-10 Stator.SLDPRT
53.0 x 42.0 x 53.0 mm
