fernandomierhicks/wheeled-leg-robot/cad/aesthetics/input/parts/Side panel.step

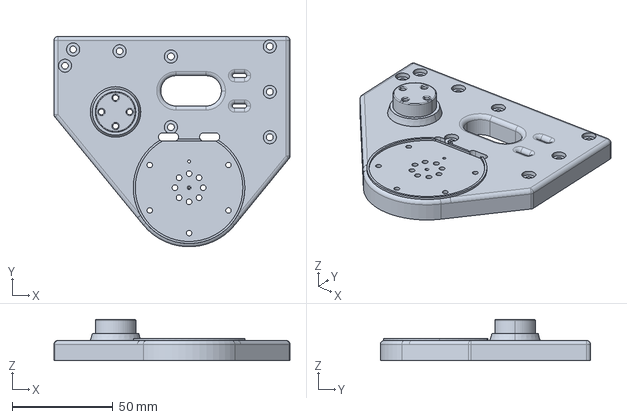
[picture p269: CAD file, 2026-10-04]
cad/aesthetics/input/parts/Side panel.step
116.9 x 104.2 x 20.5 mm
