fernandomierhicks/wheeled-leg-robot/cad/aesthetics/out/print/other colors/Femur/Femur_foundry.3mf

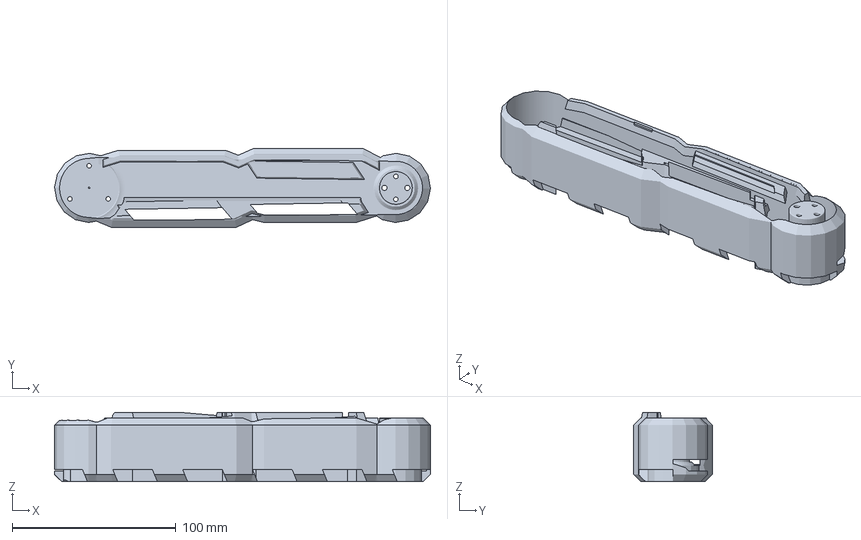
[picture p270: CAD file, 2026-09-20]
cad/aesthetics/out/print/other colors/Femur/Femur_foundry.3mf
229.9 x 48.1 x 42.5 mm
