fernandomierhicks/wheeled-leg-robot/cad/v3 shifted CG thin RGB Limit Switch/BackWheelSupport.SLDPRT

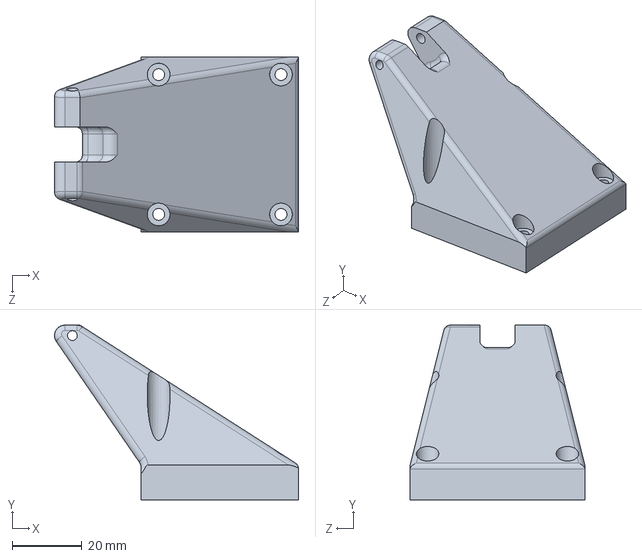
[picture p272: CAD file, 2026-08-10]
cad/v3 shifted CG thin RGB Limit Switch/BackWheelSupport.SLDPRT
69.8 x 50.0 x 50.0 mm
