fernandomierhicks/wheeled-leg-robot/cad/v3 shifted CG thin RGB Limit Switch/other/SupportBart.SLDPRT

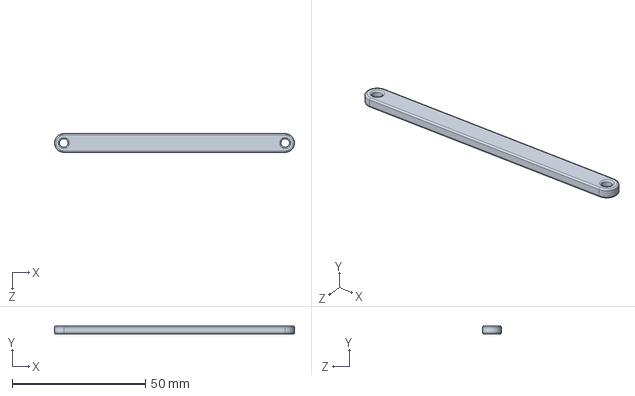
[picture p273: CAD file, 2026-05-15]
cad/v3 shifted CG thin RGB Limit Switch/other/SupportBart.SLDPRT
90.1 x 3.00 x 7.00 mm
