fernandomierhicks/wheeled-leg-robot/cad/v4 Larger Ball bearings/STEP exports/Middle multiple parts/RobotMount.STEP

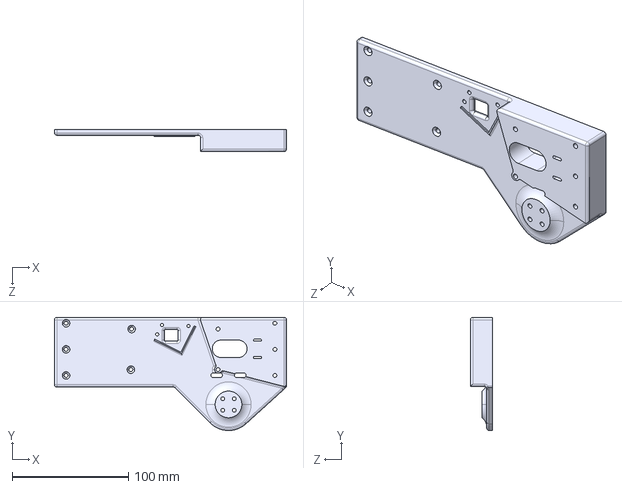
[picture p275: CAD file, 2026-10-04]
cad/v4 Larger Ball bearings/STEP exports/Middle multiple parts/RobotMount.STEP
200.0 x 97.5 x 19.0 mm
