fernandomierhicks/wheeled-leg-robot/cad/v5 Ai designed/_originals/Body/InsideFemurShaft.SLDPRT

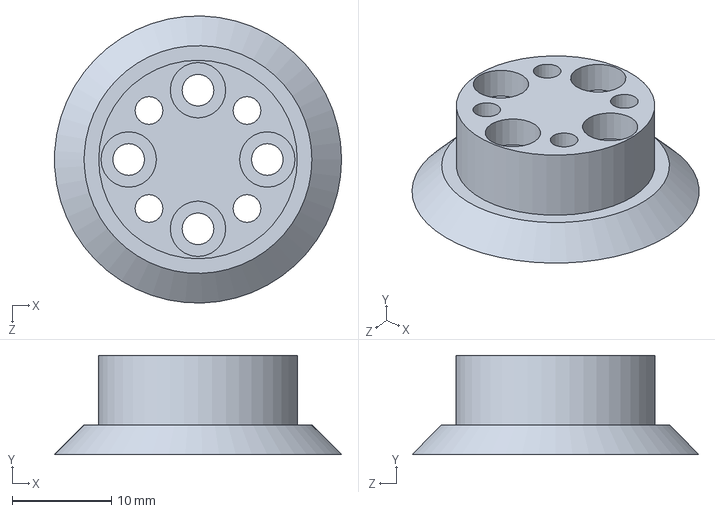
[picture p276: CAD file, 2026-10-04]
cad/v5 Ai designed/_originals/Body/InsideFemurShaft.SLDPRT
29.0 x 10.0 x 29.0 mm
