fernandomierhicks/wheeled-leg-robot/cad/v5 Ai designed/_originals/Motor/Wheel Motor/TPU wheel.SLDPRT

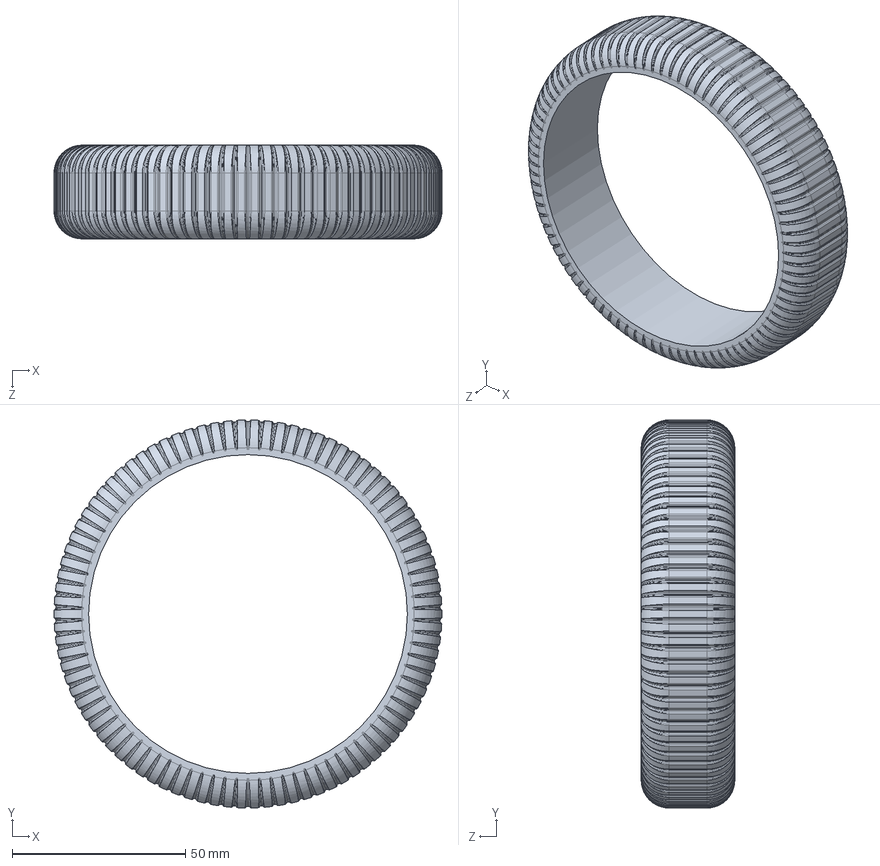
[picture p277: CAD file, 2026-10-04]
cad/v5 Ai designed/_originals/Motor/Wheel Motor/TPU wheel.SLDPRT
112.0 x 112.0 x 27.0 mm
