fernandomierhicks/wheeled-leg-robot/cad/v5 Ai designed/_originals/pre_bumper_slots_2026-10-16/print/BumperBack_bambu.3mf

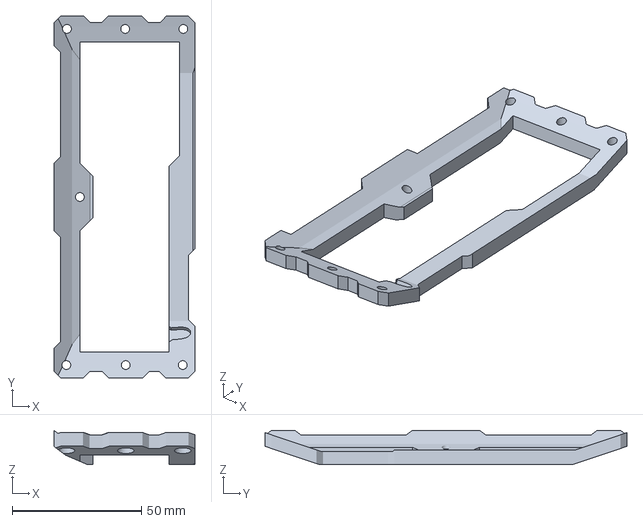
[picture p278: CAD file, 2026-10-17]
cad/v5 Ai designed/_originals/pre_bumper_slots_2026-10-16/print/BumperBack_bambu.3mf
54.5 x 140.0 x 13.2 mm
