fernandomierhicks/wheeled-leg-robot/cad/v5 Ai designed/_originals/pre_facet_round2_2026-10-14/Facet/FacetFront.SLDPRT

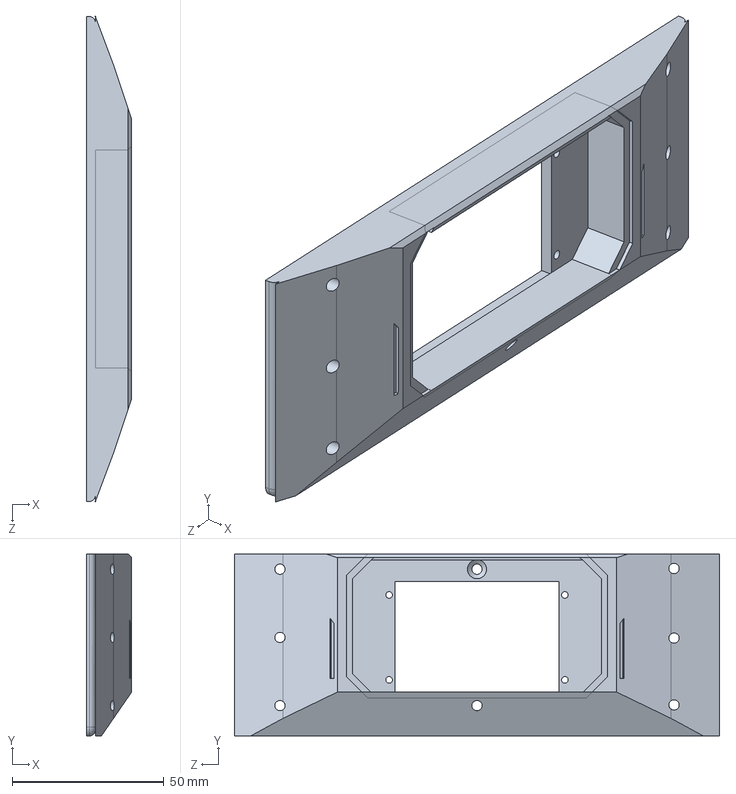
[picture p279: CAD file, 2026-10-15]
cad/v5 Ai designed/_originals/pre_facet_round2_2026-10-14/Facet/FacetFront.SLDPRT
15.0 x 60.0 x 160.0 mm
