fernandomierhicks/wheeled-leg-robot/cad/v5 Ai designed/_originals/pre_relief_2026-10-09/Links/MirrorFemur.SLDPRT

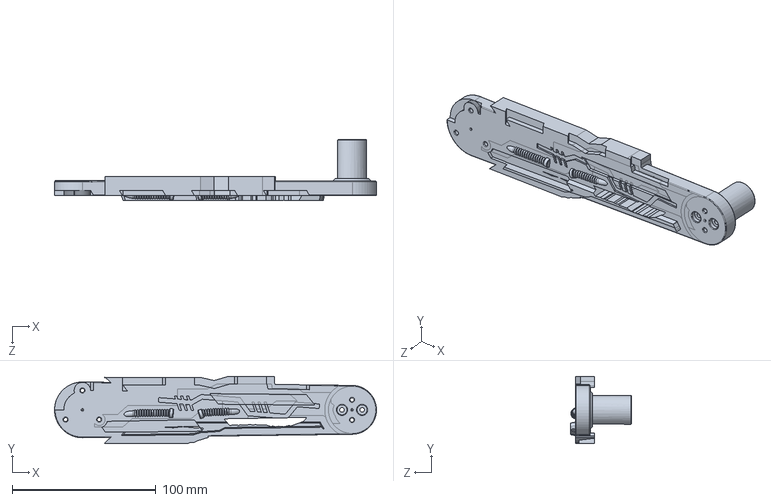
[picture p280: CAD file, 2026-10-13]
cad/v5 Ai designed/_originals/pre_relief_2026-10-09/Links/MirrorFemur.SLDPRT
224.0 x 46.9 x 42.5 mm
