fernandomierhicks/wheeled-leg-robot/cad/v5 Ai designed/_originals/pre_relief_2026-10-09/print/BumperFront_bambu.3mf

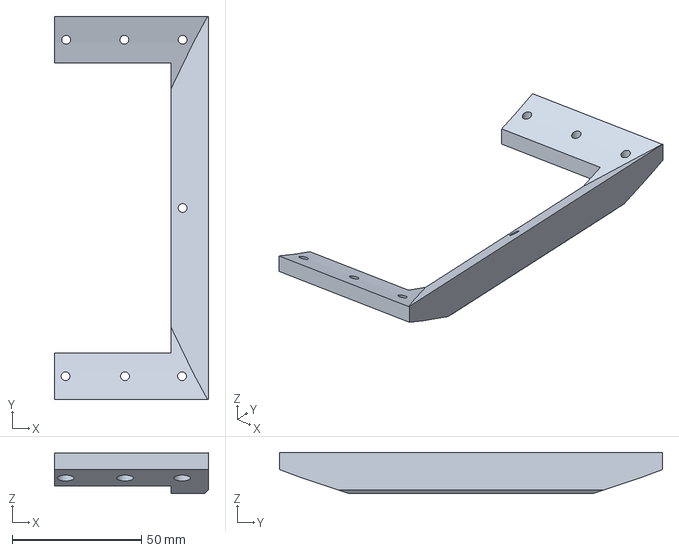
[picture p281: CAD file, 2026-10-08]
cad/v5 Ai designed/_originals/pre_relief_2026-10-09/print/BumperFront_bambu.3mf
59.5 x 148.0 x 16.0 mm
