fernandomierhicks/wheeled-leg-robot/cad/v5 Ai designed/_originals/pre_stripseat_2026-10-13/NeopixelStrip.SLDPRT

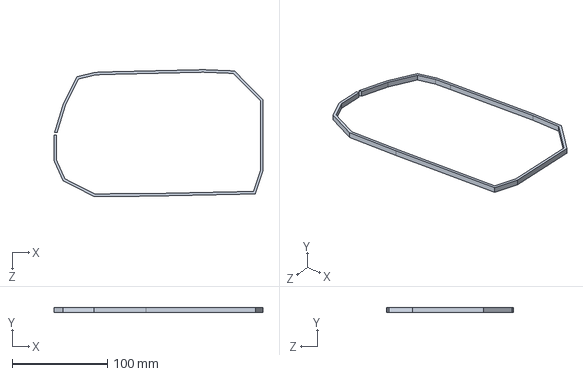
[picture p282: CAD file, 2026-10-15]
cad/v5 Ai designed/_originals/pre_stripseat_2026-10-13/NeopixelStrip.SLDPRT
219.8 x 5.10 x 133.3 mm
