fernandomierhicks/wheeled-leg-robot/cad/v5 Ai designed/Body/LimitSwitch/Switch_Mount.SLDPRT

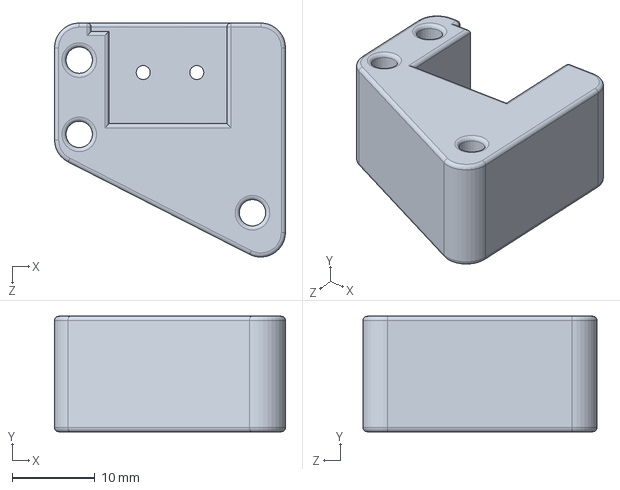
[picture p283: CAD file, 2026-10-17]
cad/v5 Ai designed/Body/LimitSwitch/Switch_Mount.SLDPRT
28.0 x 14.0 x 28.4 mm
