fernandomierhicks/wheeled-leg-robot/cad/v5 Ai designed/Box/Concepts/BoxConcept_C_shells.SLDPRT

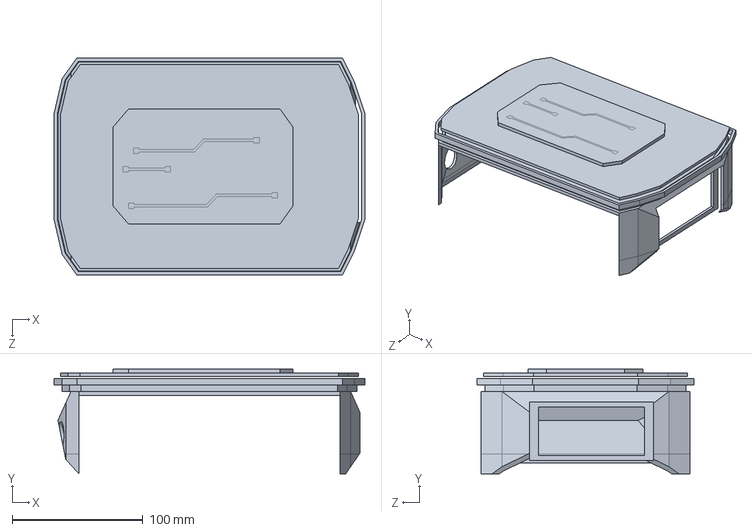
[picture p284: CAD file, 2026-10-08]
cad/v5 Ai designed/Box/Concepts/BoxConcept_C_shells.SLDPRT
238.0 x 80.0 x 166.0 mm
