fernandomierhicks/wheeled-leg-robot/cad/v5 Ai designed/Box/Electronics/Battery.SLDPRT

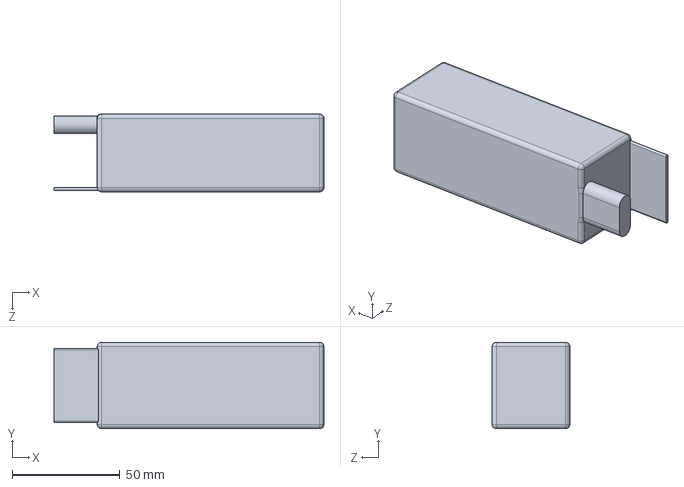
[picture p285: CAD file, 2026-10-17]
cad/v5 Ai designed/Box/Electronics/Battery.SLDPRT
125.0 x 40.0 x 36.0 mm
