fernandomierhicks/wheeled-leg-robot/cad/v5 Ai designed/Box/Switch.SLDPRT

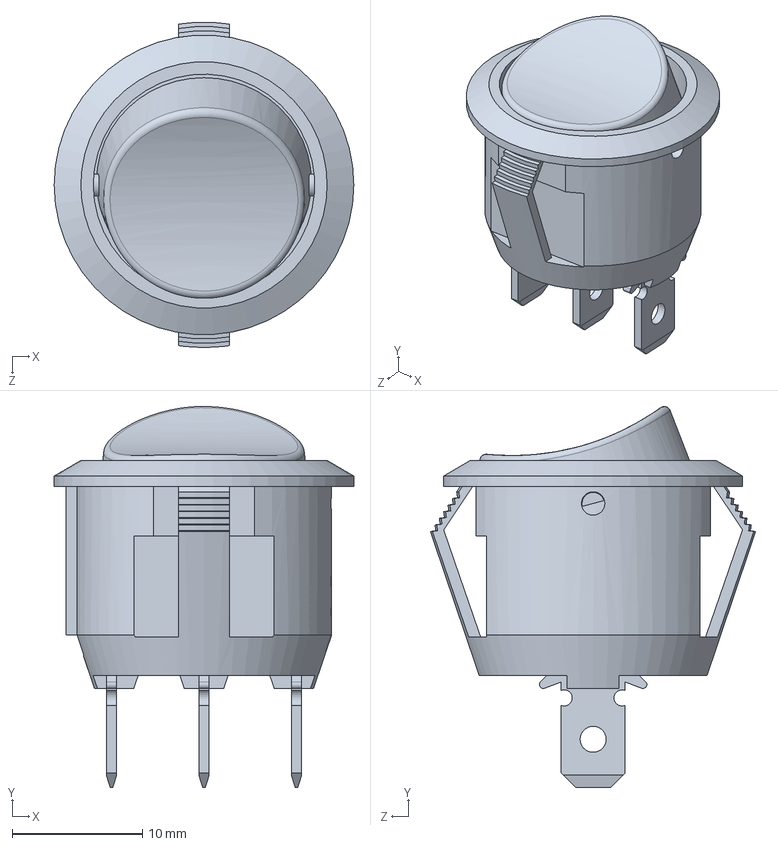
[picture p286: CAD file, 2026-10-17]
cad/v5 Ai designed/Box/Switch.SLDPRT
23.0 x 29.2 x 25.0 mm
