fernandomierhicks/wheeled-leg-robot/cad/v5 Ai designed/Concepts/Bearing mounting/MiddleLink.SLDPRT

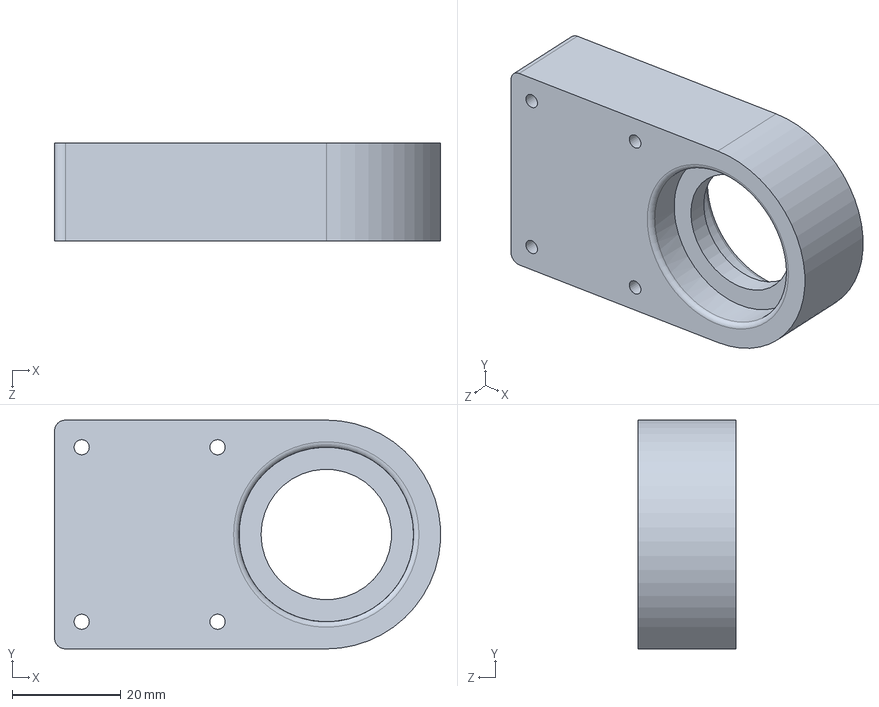
[picture p287: CAD file, 2026-08-07]
cad/v5 Ai designed/Concepts/Bearing mounting/MiddleLink.SLDPRT
71.0 x 42.1 x 18.0 mm
