fernandomierhicks/wheeled-leg-robot/cad/v5 Ai designed/Concepts/Kinematics/Tibia.SLDPRT

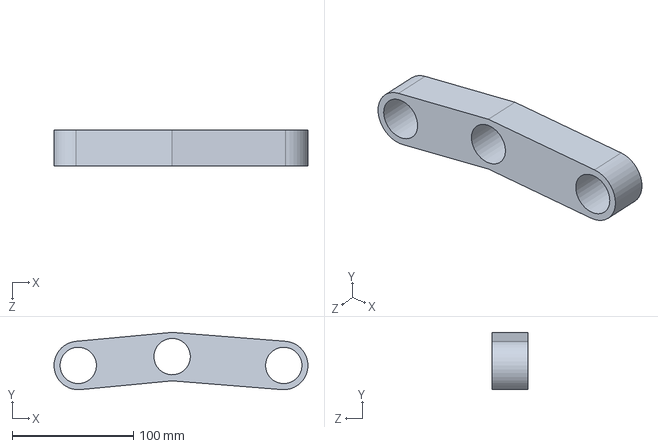
[picture p288: CAD file, 2026-07-31]
cad/v5 Ai designed/Concepts/Kinematics/Tibia.SLDPRT
209.5 x 47.3 x 30.0 mm
