fernandomierhicks/wheeled-leg-robot/cad/v5 Ai designed/Links/EncoderCableClamp.SLDPRT

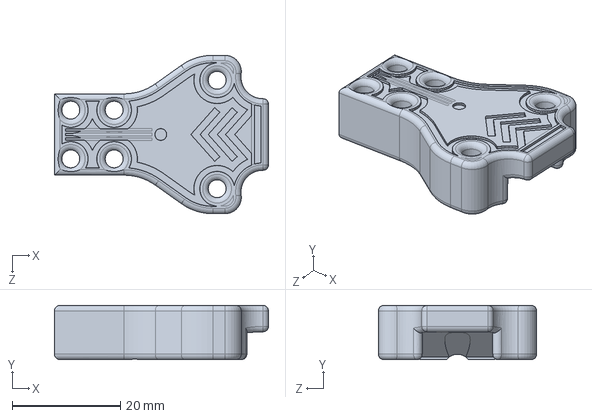
[picture p289: CAD file, 2026-10-17]
cad/v5 Ai designed/Links/EncoderCableClamp.SLDPRT
39.5 x 10.0 x 29.2 mm
