fernandomierhicks/wheeled-leg-robot/cad/v5 Ai designed/Motor/AK45 simulator/Ak sim rotor.SLDPRT

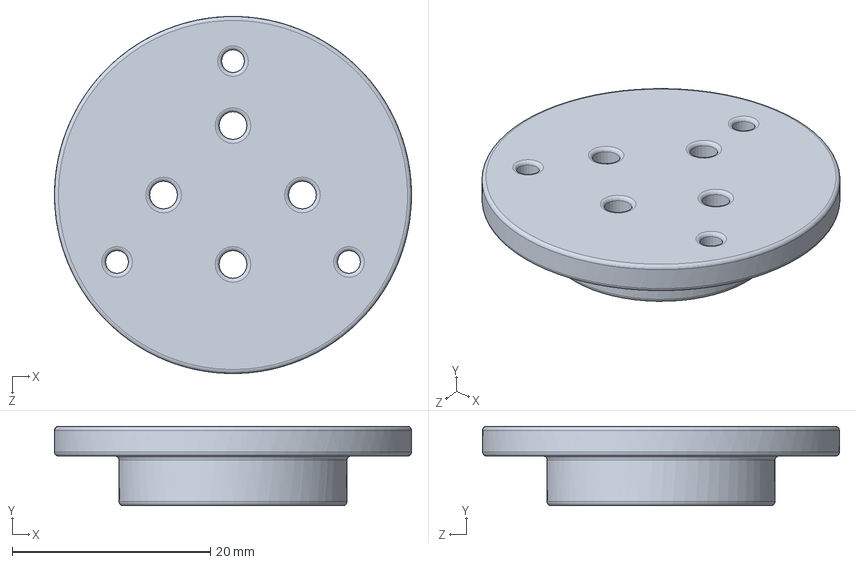
[picture p290: CAD file, 2026-10-17]
cad/v5 Ai designed/Motor/AK45 simulator/Ak sim rotor.SLDPRT
36.0 x 8.00 x 36.0 mm
