fernandomierhicks/wheeled-leg-robot/cad/v5 Ai designed/Motor/AK45-10 Rotor.SLDPRT

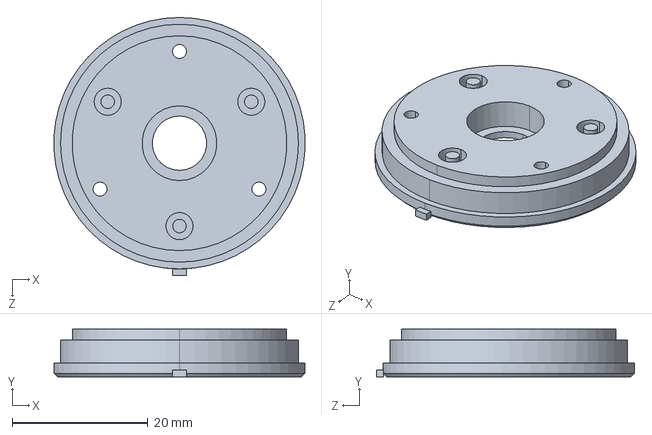
[picture p291: CAD file, 2026-10-17]
cad/v5 Ai designed/Motor/AK45-10 Rotor.SLDPRT
36.9 x 7.00 x 38.0 mm
