fernandomierhicks/wheeled-leg-robot/cad/v5 Ai designed/Motor/Wheel Motor/Stator.SLDPRT

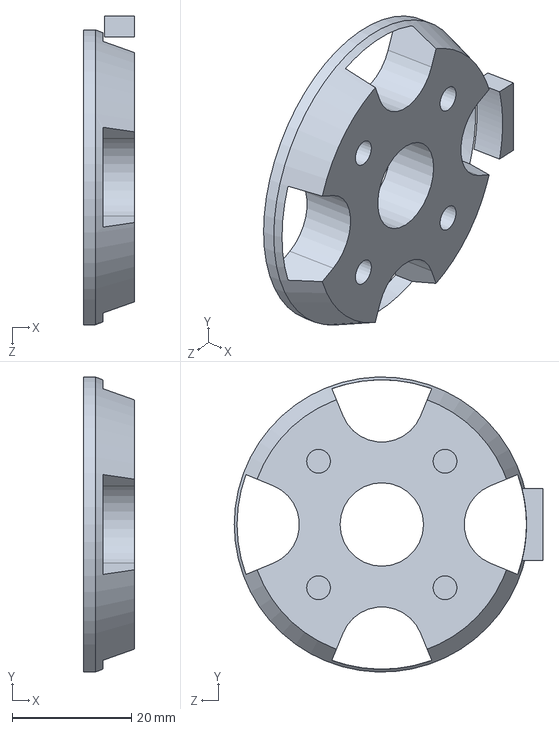
[picture p292: CAD file, 2026-10-17]
cad/v5 Ai designed/Motor/Wheel Motor/Stator.SLDPRT
8.50 x 49.5 x 51.8 mm
