fernandomierhicks/wheeled-leg-robot/cad/v5 Ai designed/Other/Ak45 Lever arm.SLDPRT

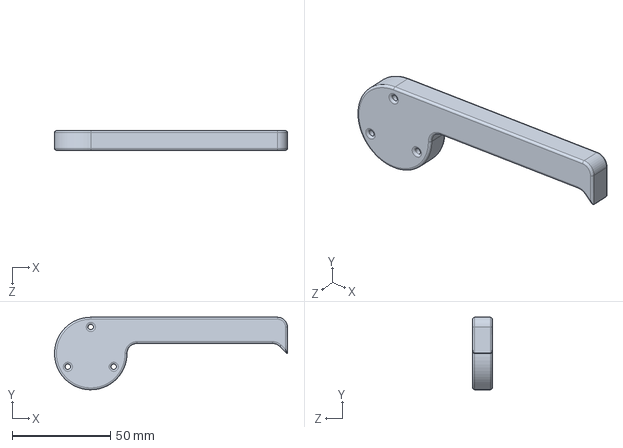
[picture p293: CAD file, 2026-08-07]
cad/v5 Ai designed/Other/Ak45 Lever arm.SLDPRT
118.8 x 37.0 x 10.0 mm
