fernandomierhicks/wheeled-leg-robot/cad/aesthetics/input/parts/Femur_inside.step

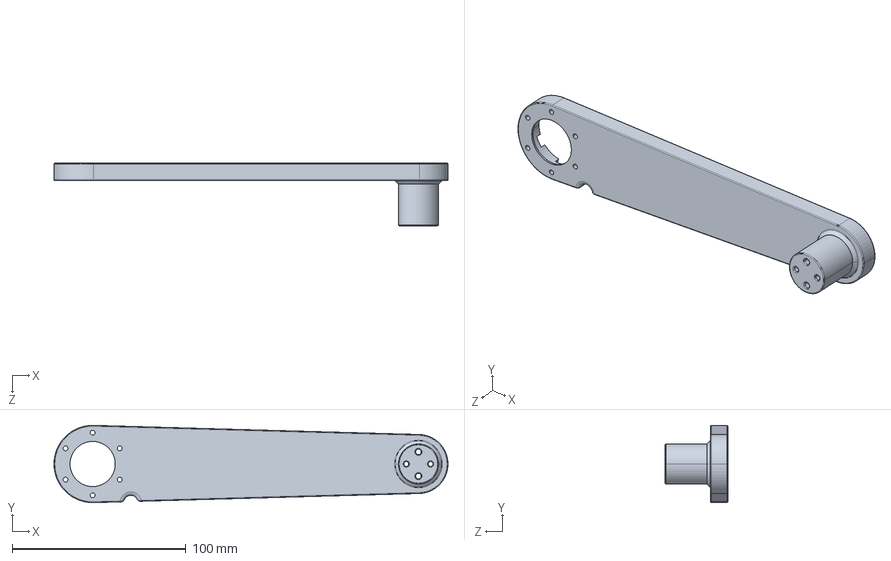
[picture p294: CAD file, 2026-10-04]
cad/aesthetics/input/parts/Femur_inside.step
226.8 x 44.5 x 36.0 mm
