fernandomierhicks/wheeled-leg-robot/cad/aesthetics/out/print/other colors/Femur/Femur_abyss.3mf

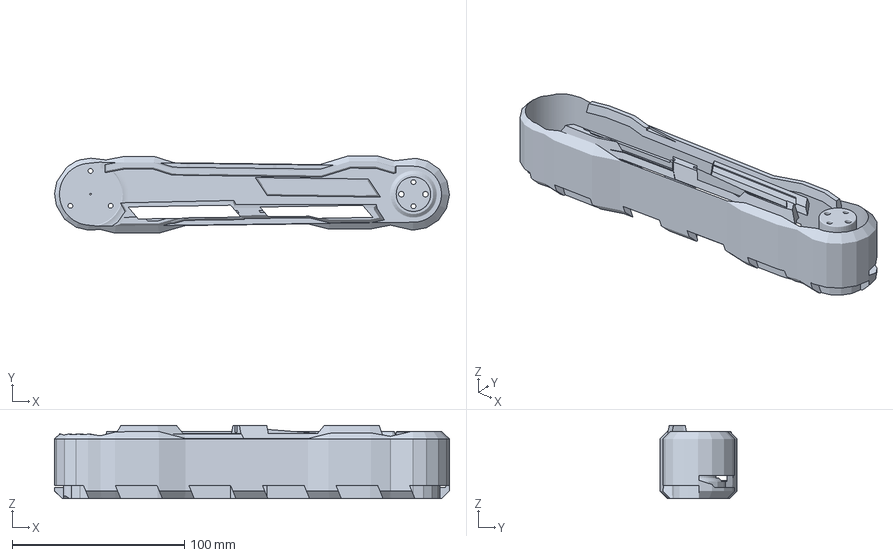
[picture p295: CAD file, 2026-09-20]
cad/aesthetics/out/print/other colors/Femur/Femur_abyss.3mf
229.4 x 44.9 x 42.5 mm
