fernandomierhicks/wheeled-leg-robot/cad/aesthetics/out/print/other colors/Tibia/Tibia_dune.3mf

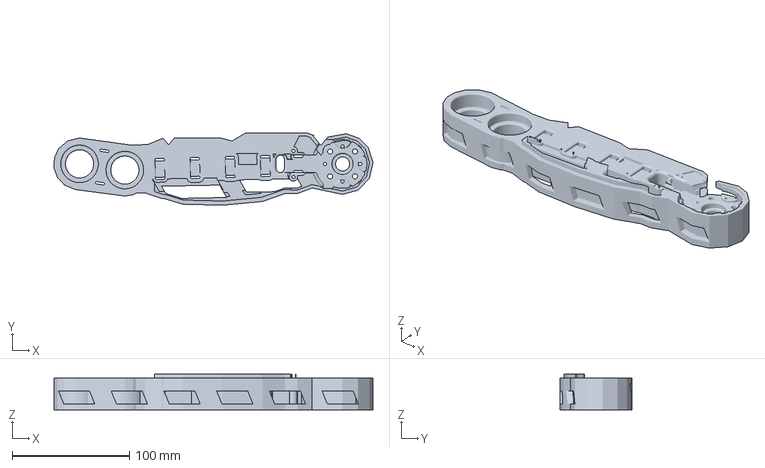
[picture p296: CAD file, 2026-09-20]
cad/aesthetics/out/print/other colors/Tibia/Tibia_dune.3mf
272.3 x 61.9 x 30.5 mm
