fernandomierhicks/wheeled-leg-robot/cad/solidworks_api/out/print/EncoderCarrier_glacier_native.3mf

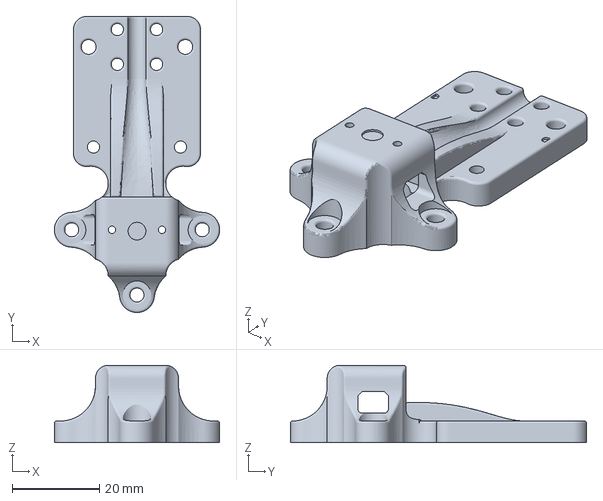
[picture p297: CAD file, 2026-10-17]
cad/solidworks_api/out/print/EncoderCarrier_glacier_native.3mf
38.0 x 68.0 x 17.8 mm
