fernandomierhicks/wheeled-leg-robot/cad/v3 shifted CG thin RGB Limit Switch/DC_DC.SLDPRT

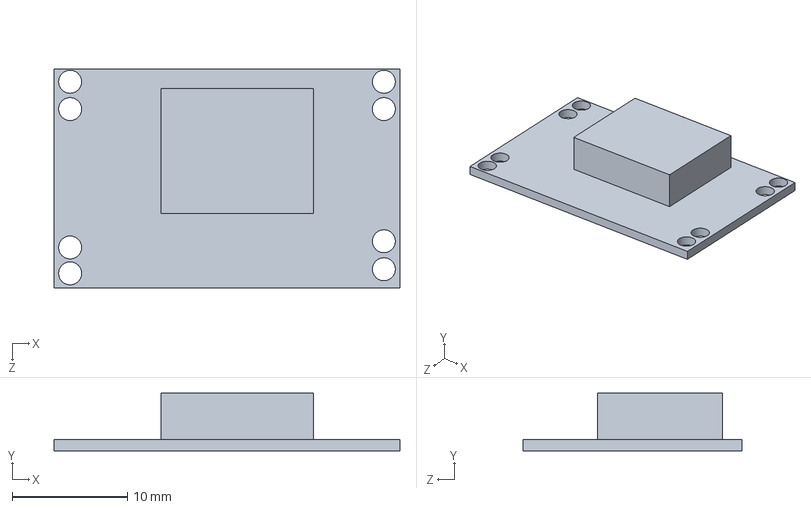
[picture p298: CAD file, 2026-07-17]
cad/v3 shifted CG thin RGB Limit Switch/DC_DC.SLDPRT
30.0 x 5.00 x 19.0 mm
