fernandomierhicks/wheeled-leg-robot/cad/v3 shifted CG thin RGB Limit Switch/other/CustomBoardFlatsatSupport.SLDPRT

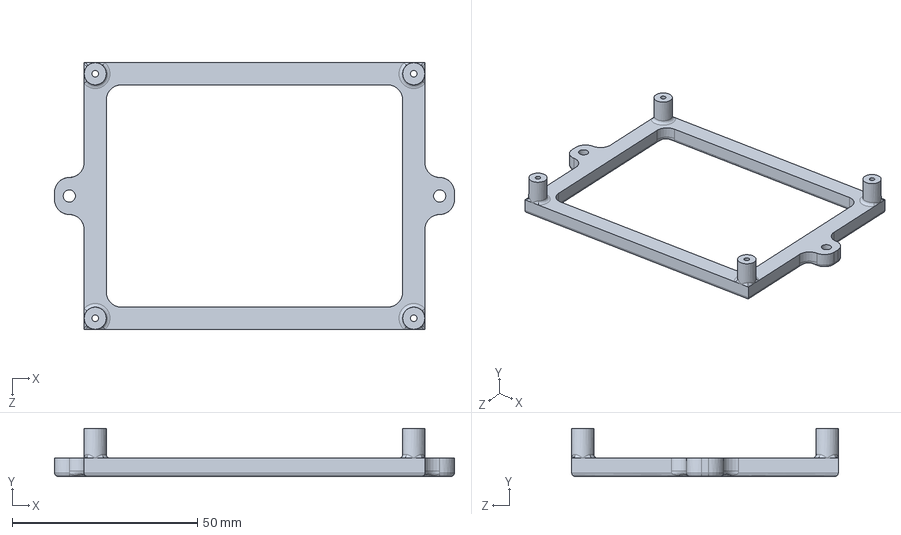
[picture p299: CAD file, 2026-05-15]
cad/v3 shifted CG thin RGB Limit Switch/other/CustomBoardFlatsatSupport.SLDPRT
108.0 x 13.0 x 72.0 mm
