fernandomierhicks/wheeled-leg-robot/cad/v3 shifted CG thin RGB Limit Switch/wheel/Wheel.SLDPRT

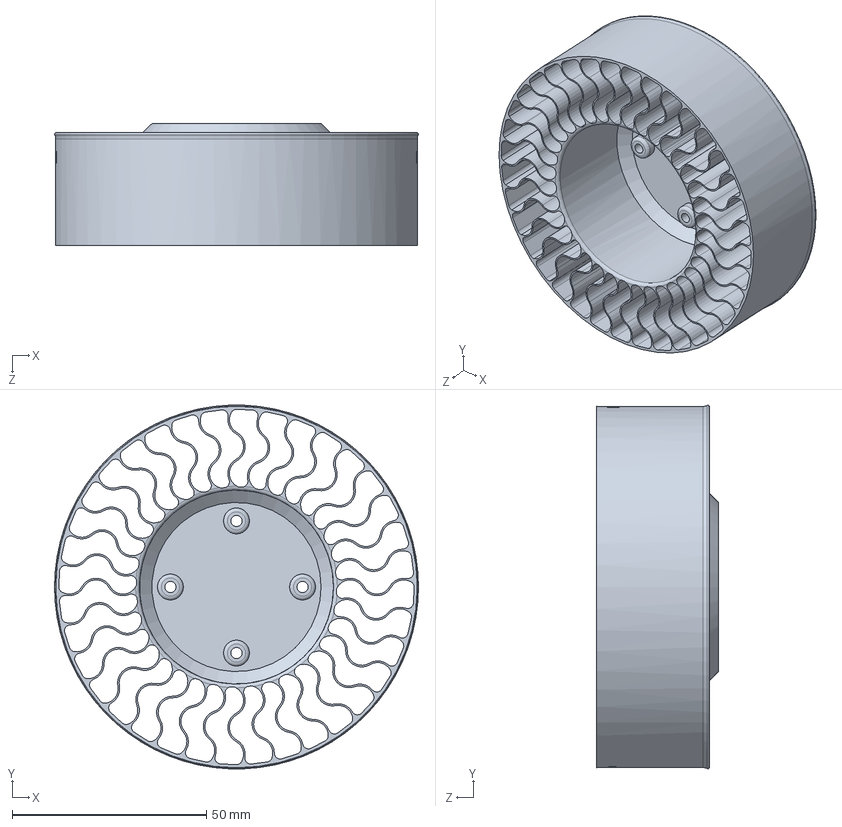
[picture p300: CAD file, 2026-05-29]
cad/v3 shifted CG thin RGB Limit Switch/wheel/Wheel.SLDPRT
93.6 x 93.6 x 31.5 mm
