fernandomierhicks/wheeled-leg-robot/cad/v4 Larger Ball bearings/STEP exports/Middle multiple parts/Tibia.STEP

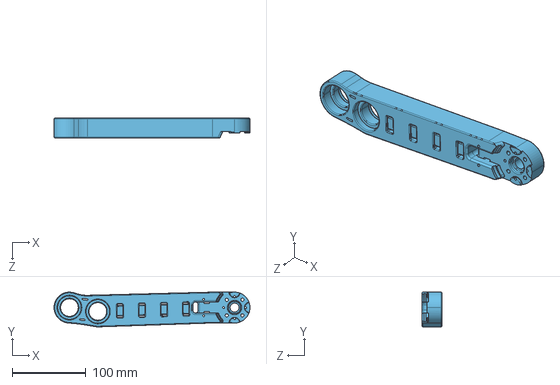
[picture p301: CAD file, 2026-10-04]
cad/v4 Larger Ball bearings/STEP exports/Middle multiple parts/Tibia.STEP
266.5 x 47.3 x 27.0 mm
