fernandomierhicks/wheeled-leg-robot/cad/v5 Ai designed/_originals/Motor/Wheel Motor/Wheel.SLDPRT

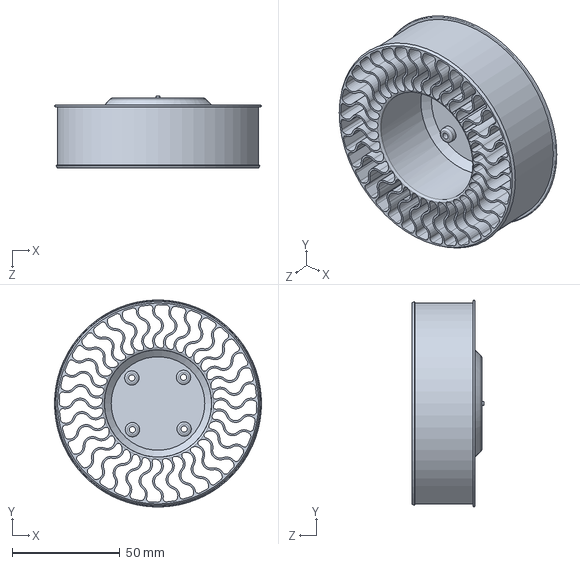
[picture p302: CAD file, 2026-10-04]
cad/v5 Ai designed/_originals/Motor/Wheel Motor/Wheel.SLDPRT
96.2 x 96.1 x 33.7 mm
