fernandomierhicks/wheeled-leg-robot/cad/v1 circular tube with end rods/ROBOT.SLDASM

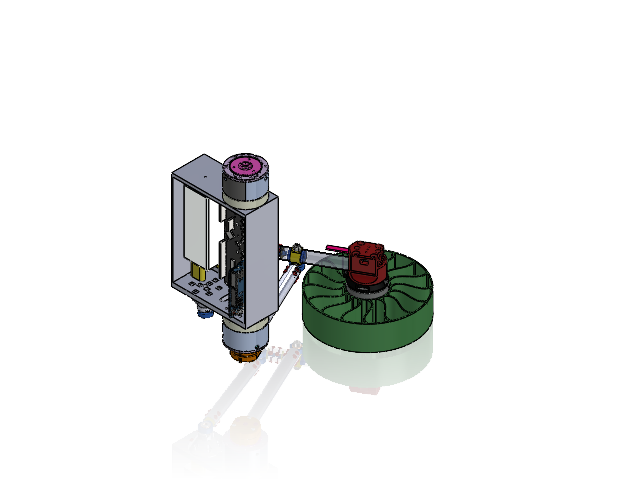
[picture p303: CAD file, 2026-05-29]
cad/v1 circular tube with end rods/ROBOT.SLDASM
Odrive
AK45-10 Stator x 2
Battery
AK45-10 Rotor x 2
IMU BNO085
Arduino
M16 Tube Coupler
M5 RodEnd x 4
Coupler x 4
M3x5 x 37
Washer x 8
M5 Washer x 6
M16 Tube Femur
M5x30
FemurMotorCoupler
M2.5x20 x 3
MotorCouplerReinforcement
M16 Tube Tibia
Encoder
Magnet
Stator
TibiaCouplerBase
TibiaCouplerCap
FemuerTibiaCoupler
FemurTibiaSleeve
M5 nut
FootCoupler
Rotor
Wheel
CouplerSupport
