fernandomierhicks/wheeled-leg-robot/cad/v2 square tube/ROBOT.SLDASM

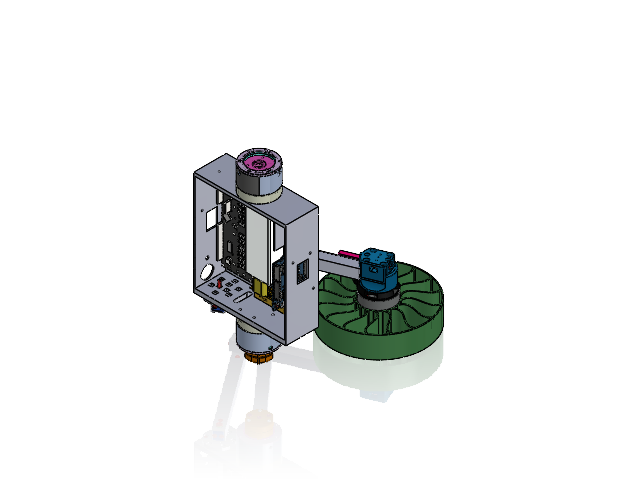
[picture p304: CAD file, 2026-05-07]
cad/v2 square tube/ROBOT.SLDASM
Odrive
AK45-10 Stator x 2
Battery
AK45-10 Rotor x 2
IMU BNO085
Arduino
M3x5 x 17
Bearing 624ZZ x 10
Coupler x 5
M4 SplitWasher x 10
M3 x 6 flathead x 12
M16 Tube Coupler
M16 Tube Femur
FemurMotorCoupler x 2
M2.5x20 x 3
MotorCouplerReinforcement
Stator
Encoder
M16 Tube Tibia
Magnet
TibiaCouplerBase
TibiaCouplerCap
FootCoupler
M4x10 x 7
FemurTibiaCoupler
Rotor
Wheel
CouplerSupport
Resistor
