fernandomierhicks/wheeled-leg-robot/cad/v3 shifted CG thin RGB Limit Switch/other/FlatSAT.SLDASM

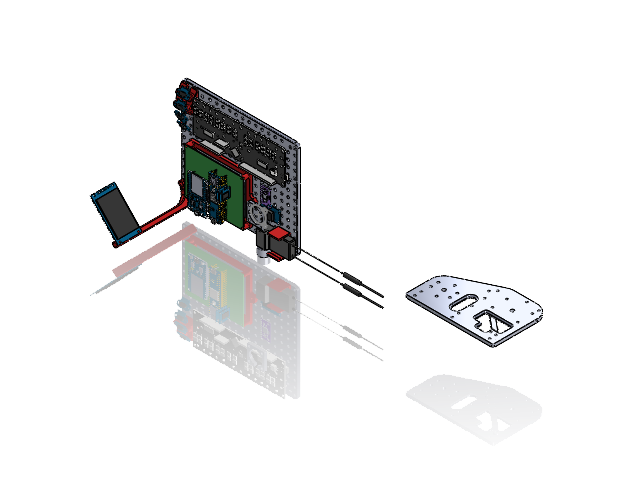
[picture p305: CAD file, 2026-05-29]
cad/v3 shifted CG thin RGB Limit Switch/other/FlatSAT.SLDASM
FlatSatPlate
IMU BNO085
Odrive
OLED
LaserRange x 4
DC_DC
Receiver
Buzzer
CustomBoard
CAN x 2
ESP32
Teensy 4.1
ScreenFlatsatSupport
FlySkyFlatsat support
CustomBoardFlatsatSupport
LaserFlatSat support
switch
FlatSatMotorPlate
SupportBart
