fernandomierhicks/wheeled-leg-robot/cad/v4 Larger Ball bearings/ROBOT.SLDASM

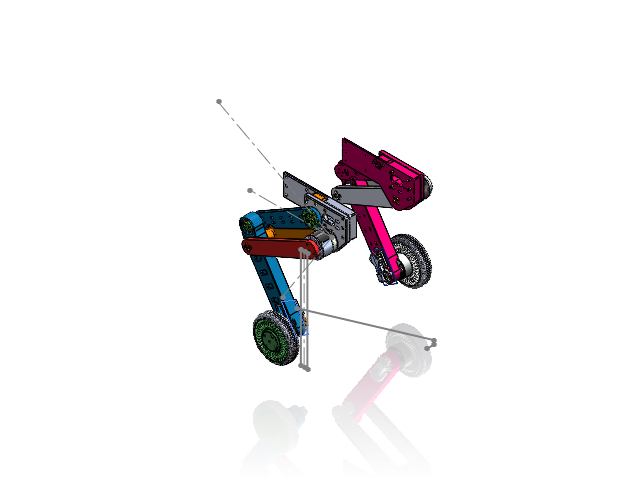
[picture p306: CAD file, 2026-10-04]
cad/v4 Larger Ball bearings/ROBOT.SLDASM
Tibia
Bearing 6804-2RS (20x32x7) x 12
Stator x 2
Rotor x 2
Magnet x 2
Encoder x 2
TPU wheel x 2
Wheel x 2
M4 roundhead x 8
MP30 connector x 2
EncoderCarrier x 2
EncoderCableClamp x 2
Femur x 2
AK45-10 Rotor x 2
M3 Roundhead x 88
Side panel
AK45-10 Stator x 2
SmallBearingWahser x 4
InsideFemurShaft x 2
LimitSwitch x 2
Switch_Mount
RobotMount
Coupler
BearingWasher x 2
Femur_inside
M3 washer x 12
MirrorTibia
MirrorSide panel
MirrorSwitch_Mount
MirrorRobotMount
MirrorCoupler
MirrorFemur_inside
