fernandomierhicks/wheeled-leg-robot/cad/v5 Ai designed/_originals/Motor/Wheel Motor/WheelMotorASM.SLDASM

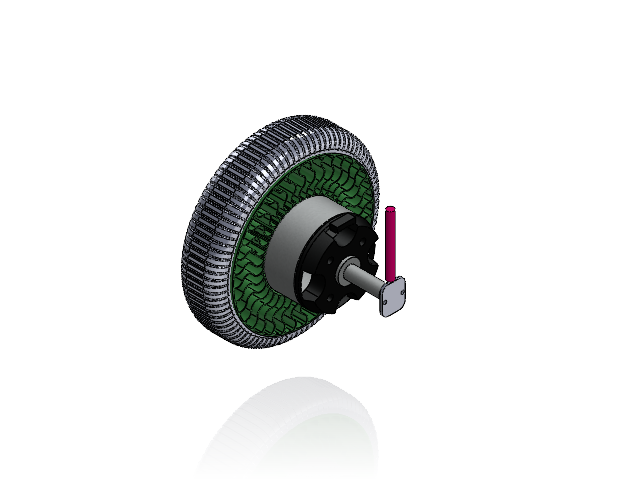
[picture p307: CAD file, 2026-10-04]
cad/v5 Ai designed/_originals/Motor/Wheel Motor/WheelMotorASM.SLDASM
Stator
Rotor
Magnet
Encoder
TPU wheel
Wheel
