fernandomierhicks/wheeled-leg-robot/cad/v5 Ai designed/_originals/pre_pipes_2026-10-07/Box/BottomPanelWithAvionics.SLDASM

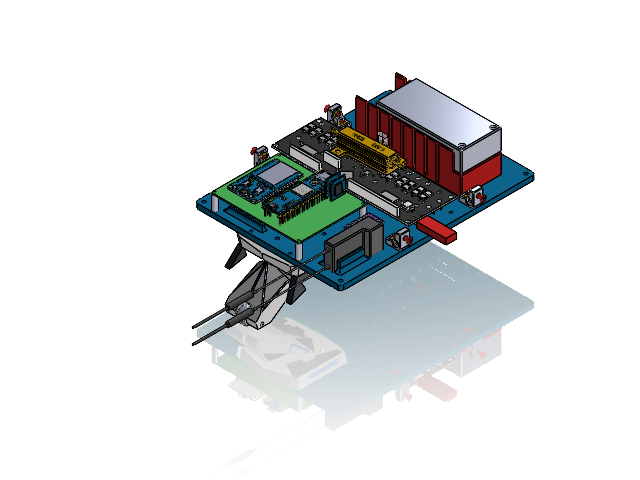
[picture p309: CAD file, 2026-10-08]
cad/v5 Ai designed/_originals/pre_pipes_2026-10-07/Box/BottomPanelWithAvionics.SLDASM
BottomPanel
CustomBoard
CAN x 2
ESP32
Teensy 4.1
IMU BNO085
Odrive
Receiver
Resistor
DC_DC
CornerBracket x 4
M3x8 flathead x 8
M3 nut x 8
M2 standoff x 4
XT30
Battery holder
BatteryCap
SupportWheel
TailStrut
