fernandomierhicks/wheeled-leg-robot/cad/v5 Ai designed/_originals/pre_pipes_2026-10-07/Links/Femur.SLDASM

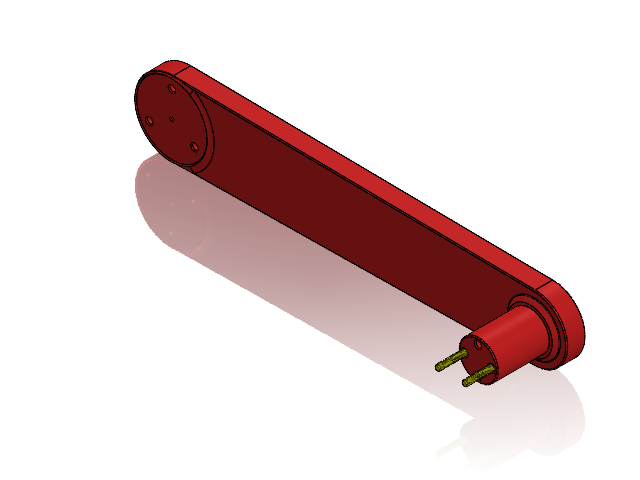
[picture p310: CAD file, 2026-10-04]
cad/v5 Ai designed/_originals/pre_pipes_2026-10-07/Links/Femur.SLDASM
Femur
M3 Roundhead x 4
