fernandomierhicks/wheeled-leg-robot/cad/v5 Ai designed/Box/Box.SLDASM

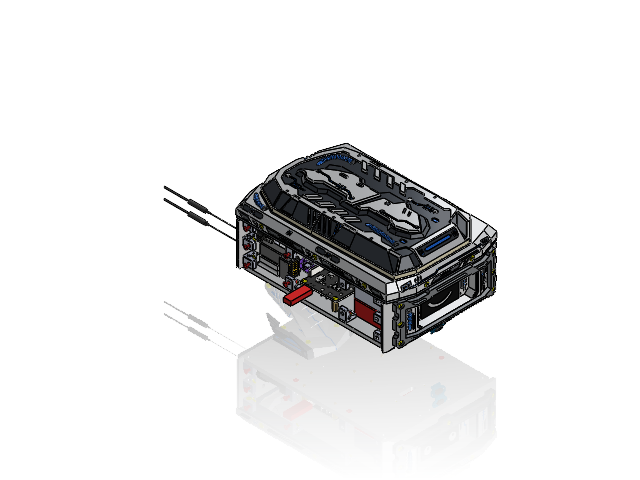
[picture p311: CAD file, 2026-10-17]
cad/v5 Ai designed/Box/Box.SLDASM
CornerBracket x 22
M3x8 flathead x 15
M3 nut x 48
BottomPanel
Battery
CustomBoard
CAN x 2
ESP32
Teensy 4.1
IMU BNO085
Odrive
Receiver
Resistor
DC_DC
M2 standoff x 4
XT30
Battery holder
BatteryCap
SupportWheel
TailStrut
M3 Roundhead x 30
M3 Flathead x 22
M3 standoff MF x 11
OLED
LaserRange x 2
Switch
FacetFront
FacetBack
BumperFront
BumperBack
FacetRing
FacetHood
NeopixelStrip
M2 Roundhead x 4
