fernandomierhicks/wheeled-leg-robot/cad/v5 Ai designed/Concepts/Bearing mounting/Bearings on inside link.SLDASM

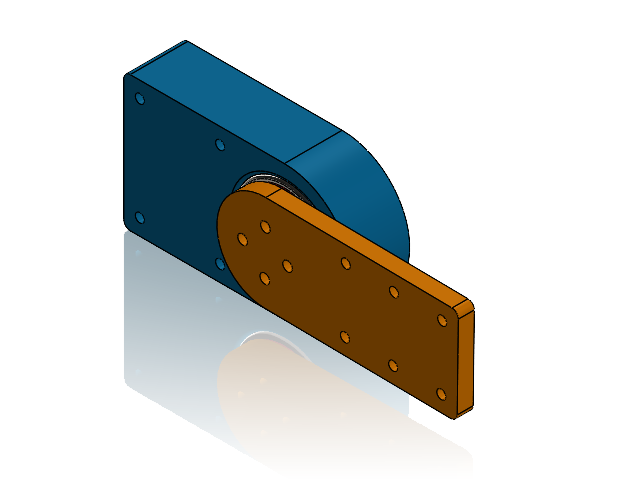
[picture p312: CAD file, 2026-08-07]
cad/v5 Ai designed/Concepts/Bearing mounting/Bearings on inside link.SLDASM
MiddleLink
Bearing 6804-2RS (20x32x7) x 2
Outer Plate
