fernandomierhicks/wheeled-leg-robot/cad/v5 Ai designed/Concepts/Kinematics/WheelMotorASM.SLDASM

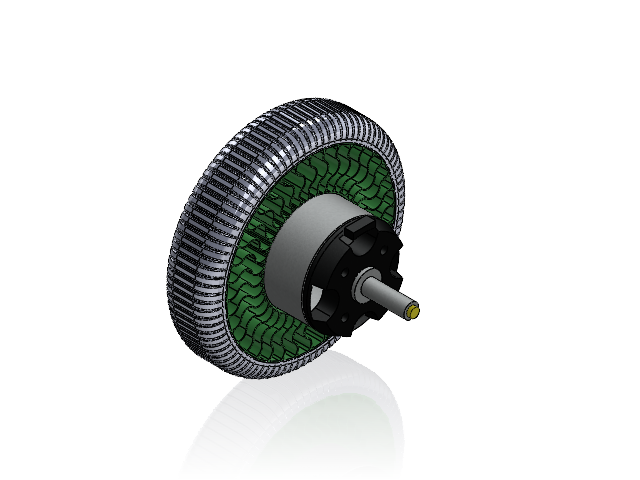
[picture p313: CAD file, 2026-07-31]
cad/v5 Ai designed/Concepts/Kinematics/WheelMotorASM.SLDASM
Stator
Rotor
Magnet
Wheel
TPU wheel
