fernandomierhicks/wheeled-leg-robot/cad/v5 Ai designed/Links/FEMUR_INSIDE.SLDASM

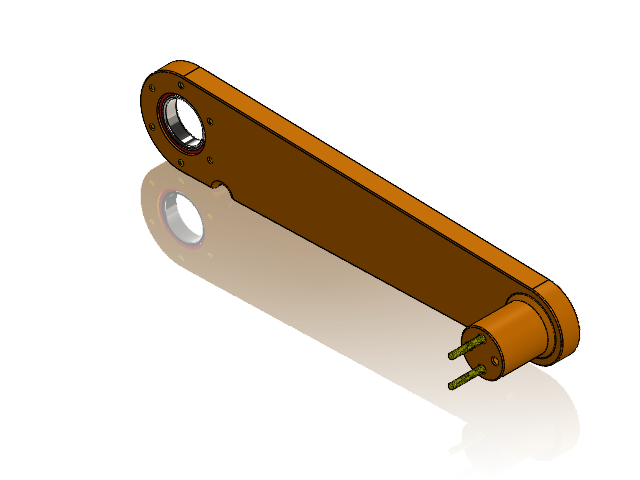
[picture p314: CAD file, 2026-10-17]
cad/v5 Ai designed/Links/FEMUR_INSIDE.SLDASM
Femur_inside
Bearing 6804-2RS (20x32x7)
M3 Roundhead x 10
M3 washer x 6
