fernandomierhicks/wheeled-leg-robot/cad/v5 Ai designed/Motor/Wheel Motor/WheelMotorASM.SLDASM

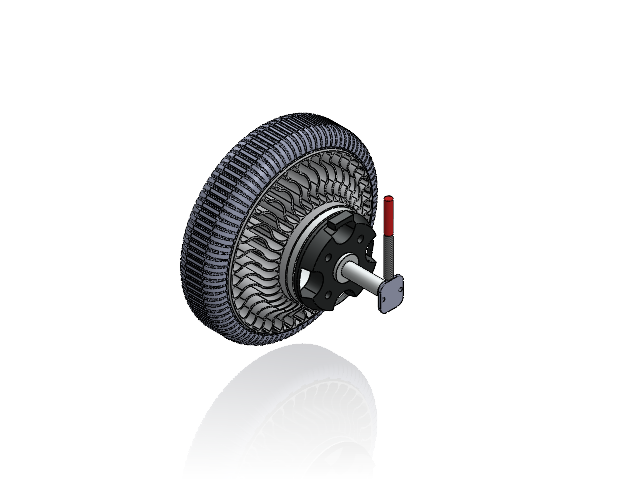
[picture p315: CAD file, 2026-10-17]
cad/v5 Ai designed/Motor/Wheel Motor/WheelMotorASM.SLDASM
Stator
Rotor
Magnet
Encoder
TPU wheel
Wheel
