fernandomierhicks/wheeled-leg-robot/cad/v3 shifted CG thin RGB Limit Switch/links/Tibia.SLDASM

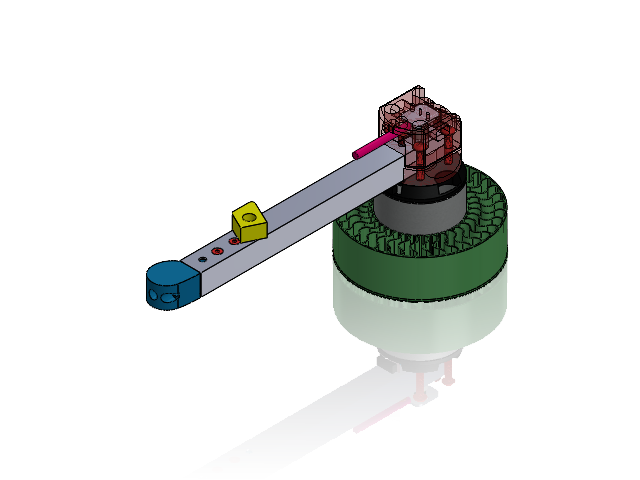
[picture p316: CAD file, 2026-07-30]
cad/v3 shifted CG thin RGB Limit Switch/links/Tibia.SLDASM
M3x5 x 4
M3 x 6 flathead x 4
Stator
Encoder
M16 Tube Tibia
Magnet
Rotor
TibiaCouplerBase
TibiaCouplerCap
FootCoupler
M4x10 x 4
CouplerNOBearing
Wheel
KneeCover
Stopper
