fernandomierhicks/wheeled-leg-robot/cad/v3 shifted CG thin RGB Limit Switch/wheel/Motor/WheelMotorASM.SLDASM

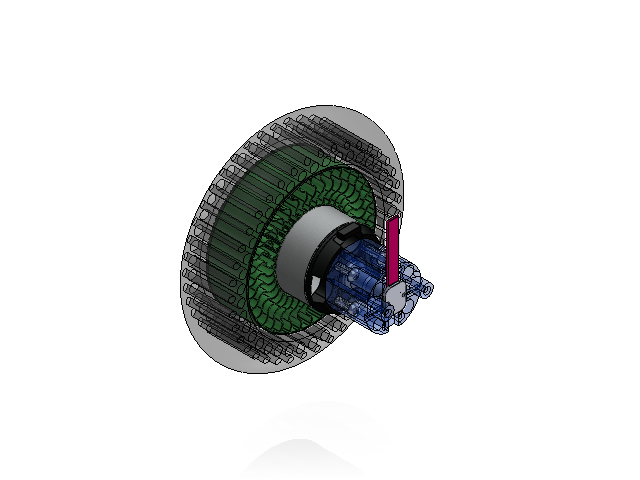
[picture p317: CAD file, 2026-07-17]
cad/v3 shifted CG thin RGB Limit Switch/wheel/Motor/WheelMotorASM.SLDASM
Stator
Rotor
Magnet
Encoder
Mount
M4x16 x 4
Wheel
Tire
