fernandomierhicks/wheeled-leg-robot/cad/v5 Ai designed/_originals/pre_pipes_2026-10-07/Body/SIDE PANEL.SLDASM

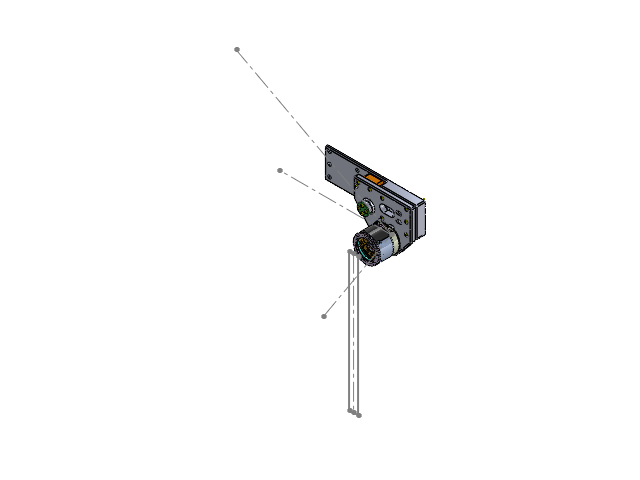
[picture p318: CAD file, 2026-10-04]
cad/v5 Ai designed/_originals/pre_pipes_2026-10-07/Body/SIDE PANEL.SLDASM
Side panel
AK45-10 Stator
SmallBearingWahser
InsideFemurShaft
LimitSwitch
Switch_Mount
M3 Roundhead x 20
RobotMount
