fernandomierhicks/wheeled-leg-robot/cad/v5 Ai designed/_originals/pre_pipes_2026-10-07/Box/Box.SLDASM

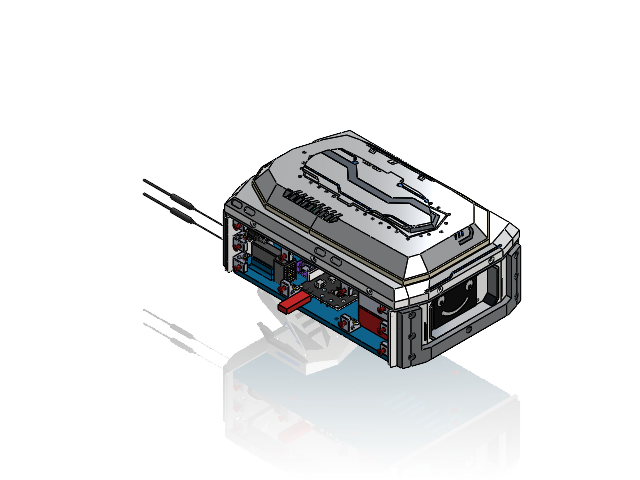
[picture p319: CAD file, 2026-10-08]
cad/v5 Ai designed/_originals/pre_pipes_2026-10-07/Box/Box.SLDASM
CornerBracket x 16
M3x8 flathead x 32
M3 nut x 32
BottomPanel
Battery
CustomBoard
CAN x 2
ESP32
Teensy 4.1
IMU BNO085
Odrive
Receiver
Resistor
DC_DC
M2 standoff x 4
XT30
Battery holder
BatteryCap
SupportWheel
TailStrut
OLED
LaserRange x 2
Switch
FacetFront
FacetBack
BumperFront
BumperBack
FacetRing
FacetHood
NeopixelStrip
