fernandomierhicks/wheeled-leg-robot/cad/v5 Ai designed/Body/SIDE PANEL.SLDASM

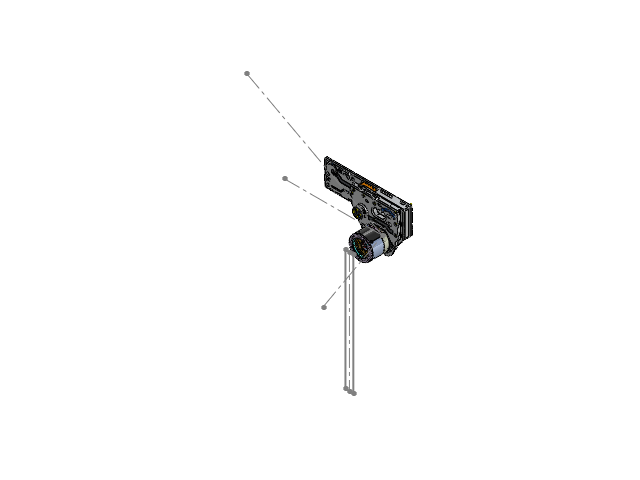
[picture p320: CAD file, 2026-10-17]
cad/v5 Ai designed/Body/SIDE PANEL.SLDASM
Side panel
AK45-10 Stator
SmallBearingWahser
InsideFemurShaft
LimitSwitch
Switch_Mount
M2 Roundhead x 2
M3 Roundhead x 20
RobotMount
M2.5 Roundhead x 5
