fernandomierhicks/wheeled-leg-robot/cad/v3 shifted CG thin RGB Limit Switch/wheel/Motor/FlatSatMotorPlate.SLDASM

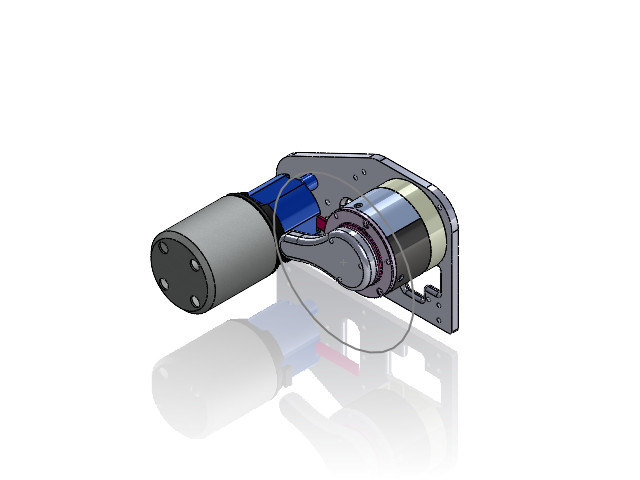
[picture p321: CAD file, 2026-05-07]
cad/v3 shifted CG thin RGB Limit Switch/wheel/Motor/FlatSatMotorPlate.SLDASM
FlatSatMotorPlate
Stator
Rotor
Magnet
Encoder
Mount
M4x16 x 4
AK45-10 Stator
AK45-10 Rotor
Ak45LeverArm
