fernandomierhicks/wheeled-leg-robot/cad/v5 Ai designed/Body/MirrorSIDE PANEL.SLDASM

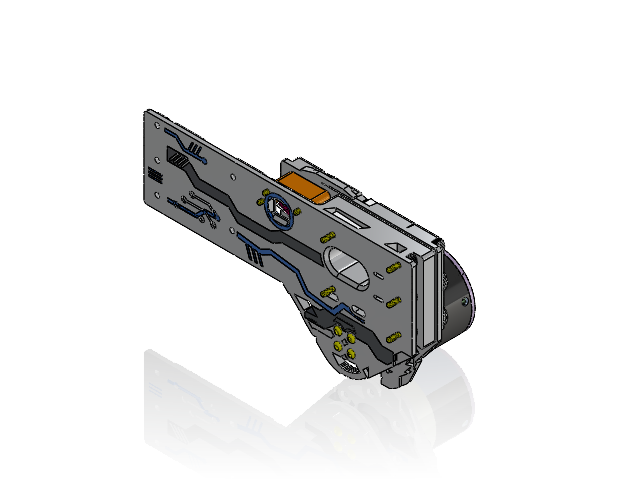
[picture p322: CAD file, 2026-10-17]
cad/v5 Ai designed/Body/MirrorSIDE PANEL.SLDASM
MirrorSide panel
AK45-10 Stator
SmallBearingWahser
InsideFemurShaft
LimitSwitch
MirrorSwitch_Mount
M2 Roundhead x 2
M3 Roundhead x 20
MirrorRobotMount
M2.5 Roundhead x 5
