fernandomierhicks/wheeled-leg-robot/cad/v5 Ai designed/Box/CornerBracket.SLDASM

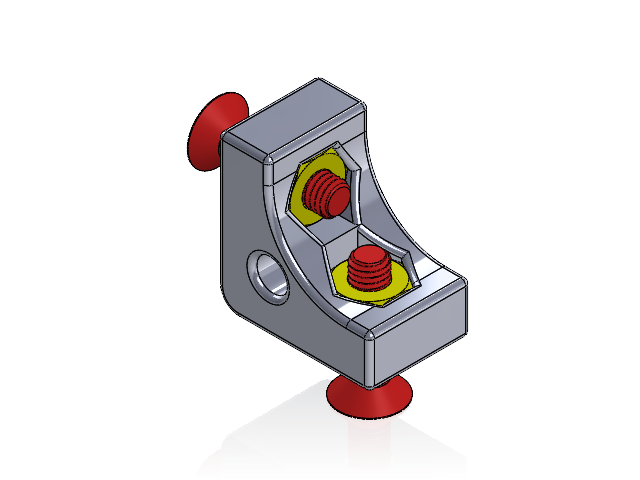
[picture p323: CAD file, 2026-10-17]
cad/v5 Ai designed/Box/CornerBracket.SLDASM
CornerBracket
M3x8 flathead
M3 nut x 2
