fernandomierhicks/wheeled-leg-robot/cad/v5 Ai designed/Concepts/Bearing mounting/Bearings on outside link.SLDASM

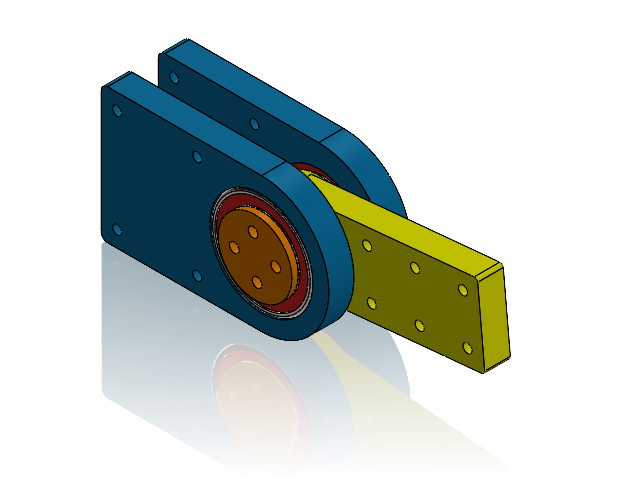
[picture p324: CAD file, 2026-08-07]
cad/v5 Ai designed/Concepts/Bearing mounting/Bearings on outside link.SLDASM
FemurPlate x 2
Bearing 6804-2RS (20x32x7) x 2
Tibia
BearingWasher x 2
