fernandomierhicks/wheeled-leg-robot/cad/v5 Ai designed/Motor/AK45 simulator/AK_SIM.SLDASM

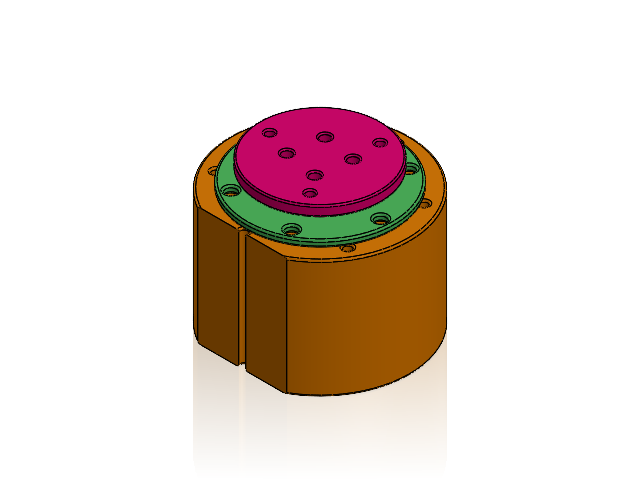
[picture p325: CAD file, 2026-10-17]
cad/v5 Ai designed/Motor/AK45 simulator/AK_SIM.SLDASM
ak sim body
Bearing 6804-2RS (20x32x7)
BearingWasher
Ak sim rotor
Plug
