fernandomierhicks/wheeled-leg-robot/cad/v3 shifted CG thin RGB Limit Switch/CustomBoard.SLDASM

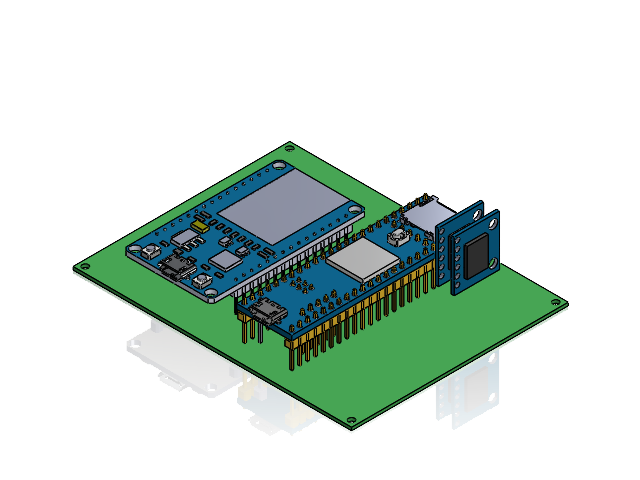
[picture p326: CAD file, 2026-07-17]
cad/v3 shifted CG thin RGB Limit Switch/CustomBoard.SLDASM
CustomBoard
CAN x 2
ESP32
Teensy 4.1
