fernandomierhicks/wheeled-leg-robot/cad/v5 Ai designed/Body/LimitSwitch/MirrorSwicthMount.SLDASM

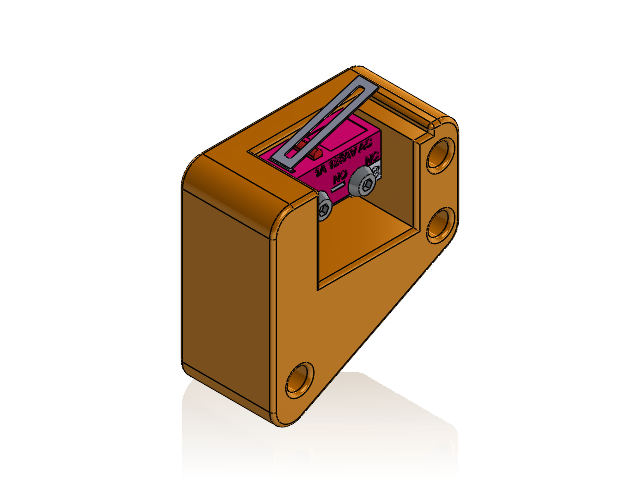
[picture p327: CAD file, 2026-10-17]
cad/v5 Ai designed/Body/LimitSwitch/MirrorSwicthMount.SLDASM
LimitSwitch
MirrorSwitch_Mount
M2 Roundhead x 2
