fernandomierhicks/wheeled-leg-robot/cad/v5 Ai designed/Links/LeftFemur.SLDASM

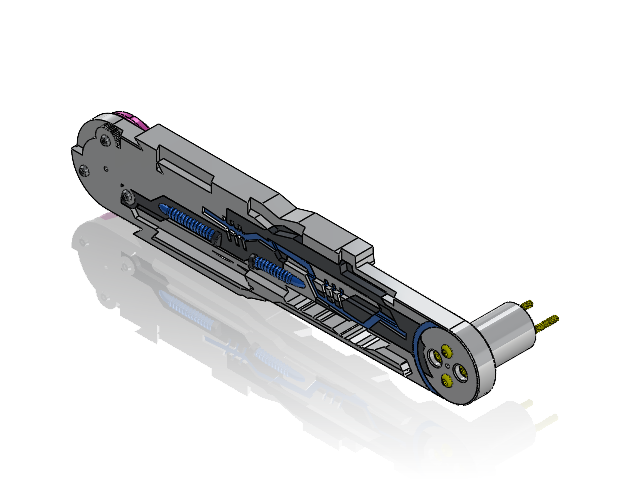
[picture p328: CAD file, 2026-10-17]
cad/v5 Ai designed/Links/LeftFemur.SLDASM
AK45-10 Rotor
M3 Roundhead x 4
M2.5 Roundhead x 3
MirrorFemur
