fernandomierhicks/wheeled-leg-robot/cad/v5 Ai designed/Body/LimitSwitch/SwicthMount.SLDASM

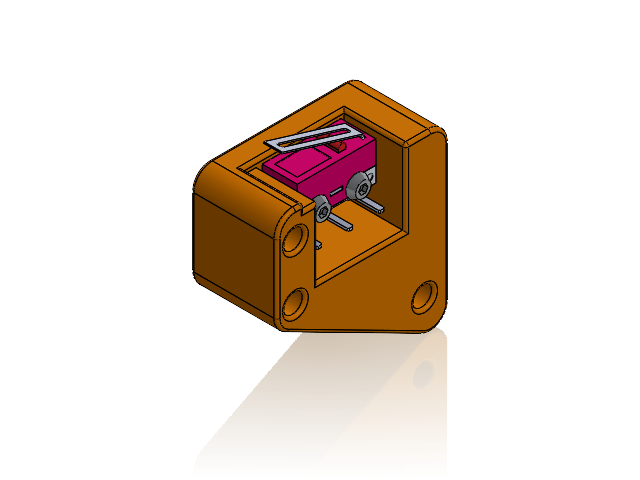
[picture p329: CAD file, 2026-10-17]
cad/v5 Ai designed/Body/LimitSwitch/SwicthMount.SLDASM
LimitSwitch
Switch_Mount
M2 Roundhead x 2
