fernandomierhicks/wheeled-leg-robot/cad/v5 Ai designed/Links/Femur.SLDASM

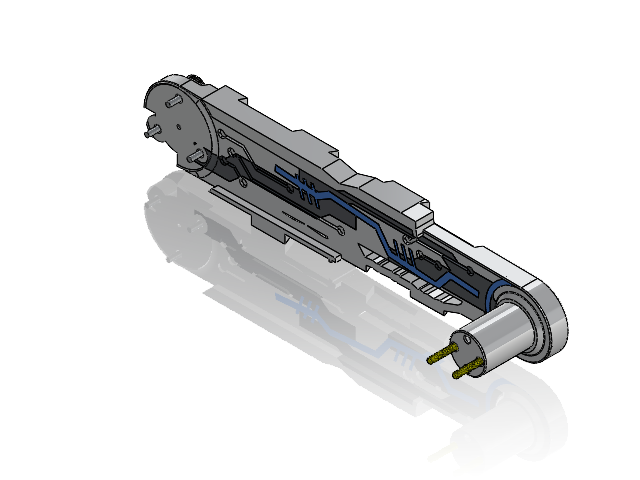
[picture p330: CAD file, 2026-10-17]
cad/v5 Ai designed/Links/Femur.SLDASM
Femur
M3 Roundhead x 4
M2.5 Roundhead x 3
