fernandomierhicks/wheeled-leg-robot/cad/v5 Ai designed/Box/Electronics/CustomBoard.SLDASM

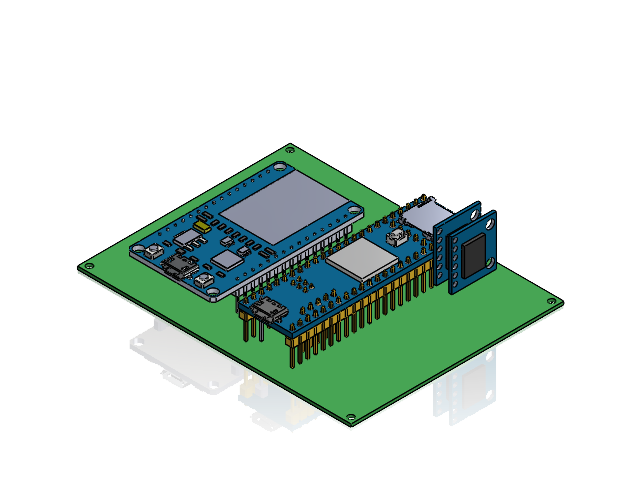
[picture p331: CAD file, 2026-10-17]
cad/v5 Ai designed/Box/Electronics/CustomBoard.SLDASM
CustomBoard
CAN x 2
ESP32
Teensy 4.1
