fernandomierhicks/wheeled-leg-robot/cad/v5 Ai designed/Concepts/Kinematics/Kinematics.SLDASM

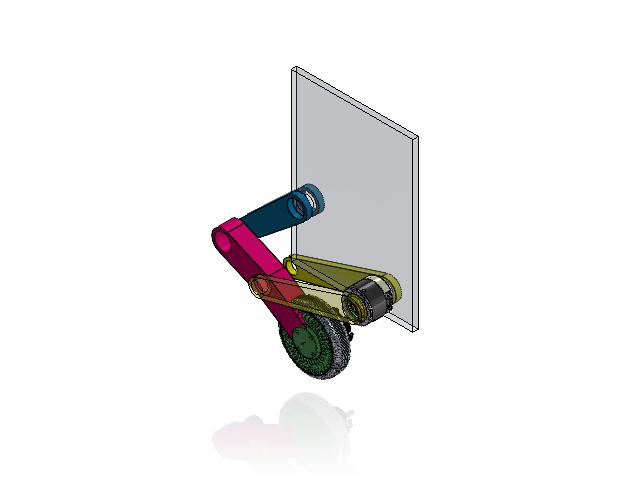
[picture p332: CAD file, 2026-07-31]
cad/v5 Ai designed/Concepts/Kinematics/Kinematics.SLDASM
Femur x 2
AK45-10 Stator
Stator
Rotor
Magnet
Wheel
TPU wheel
Tibia
Coupler x 2
