fernandomierhicks/wheeled-leg-robot/cad/v5 Ai designed/Links/COUPLER.SLDASM

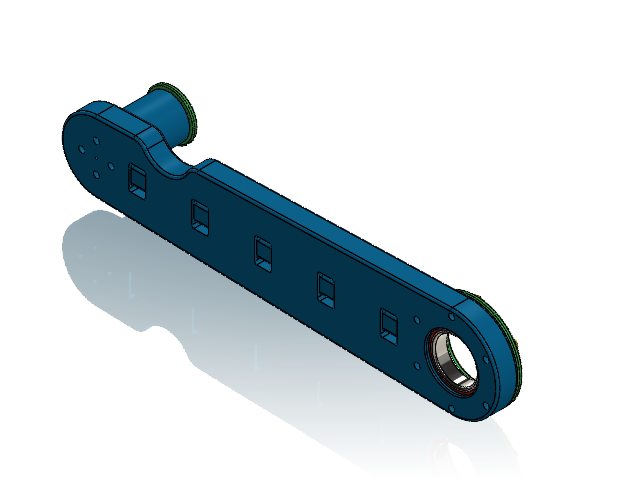
[picture p333: CAD file, 2026-10-17]
cad/v5 Ai designed/Links/COUPLER.SLDASM
Coupler
Bearing 6804-2RS (20x32x7)
BearingWasher
SmallBearingWahser
M3 Roundhead x 10
