fernandomierhicks/wheeled-leg-robot/cad/v3 shifted CG thin RGB Limit Switch/links/Femur.SLDASM

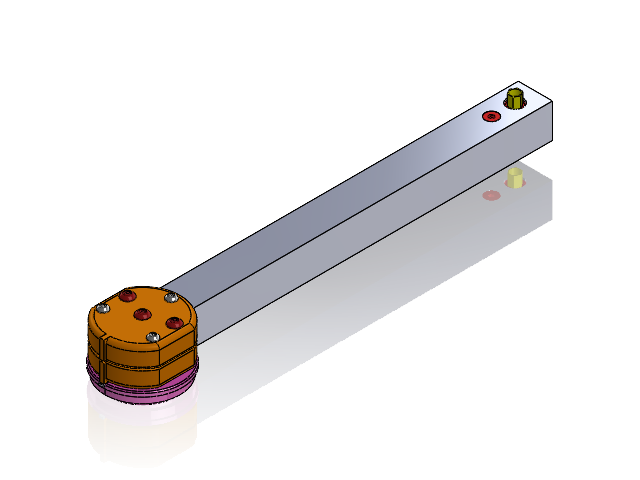
[picture p334: CAD file, 2026-07-12]
cad/v3 shifted CG thin RGB Limit Switch/links/Femur.SLDASM
M3x5 x 5
Bearing 624ZZ x 2
Coupler
M4 SplitWasher x 2
M3 x 6 flathead x 2
AK45-10 Rotor
M16 Tube Femur
FemurMotorCoupler x 2
M2.5x20 x 3
MotorCouplerReinforcement
