fernandomierhicks/wheeled-leg-robot/cad/v3 shifted CG thin RGB Limit Switch/links/Coupler.SLDASM

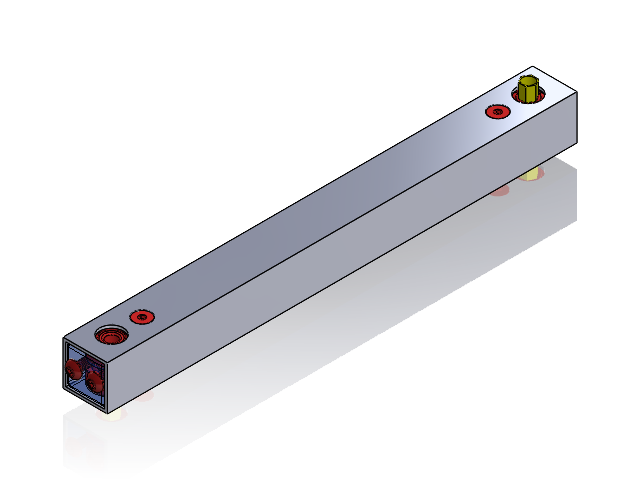
[picture p335: CAD file, 2026-06-09]
cad/v3 shifted CG thin RGB Limit Switch/links/Coupler.SLDASM
M3x5 x 4
Bearing 624ZZ x 4
Coupler x 2
M4 SplitWasher x 2
M3 x 6 flathead x 4
M16 Tube Coupler
