fernandomierhicks/wheeled-leg-robot/cad/v3 shifted CG thin RGB Limit Switch/links/EndRod.SLDASM

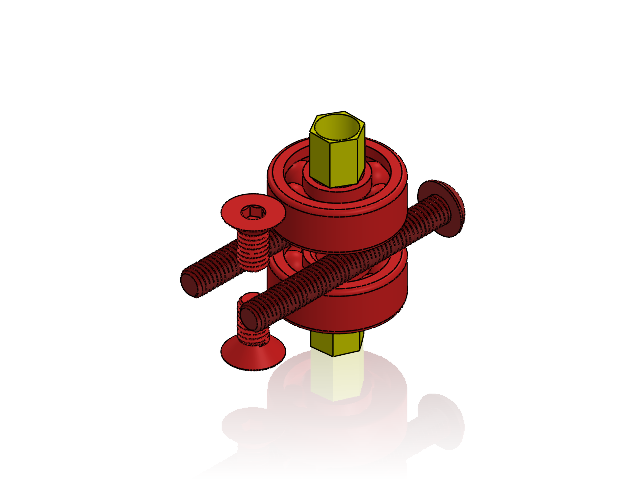
[picture p337: CAD file, 2026-06-09]
cad/v3 shifted CG thin RGB Limit Switch/links/EndRod.SLDASM
M3x5 x 2
Bearing 624ZZ x 2
M4 SplitWasher x 2
M3 x 6 flathead x 2
