fernandomierhicks/wheeled-leg-robot/cad/v3 shifted CG thin RGB Limit Switch/other/Ak45Stand.SLDASM

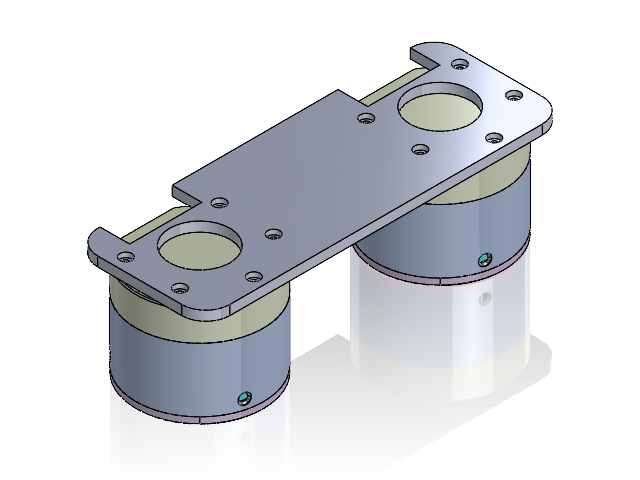
[picture p338: CAD file, 2026-05-02]
cad/v3 shifted CG thin RGB Limit Switch/other/Ak45Stand.SLDASM
AK45-10 Stator x 2
AK45 stand
