fernandomierhicks/wheeled-leg-robot/cad/v3 shifted CG thin RGB Limit Switch/Box/SwicthMount.SLDASM

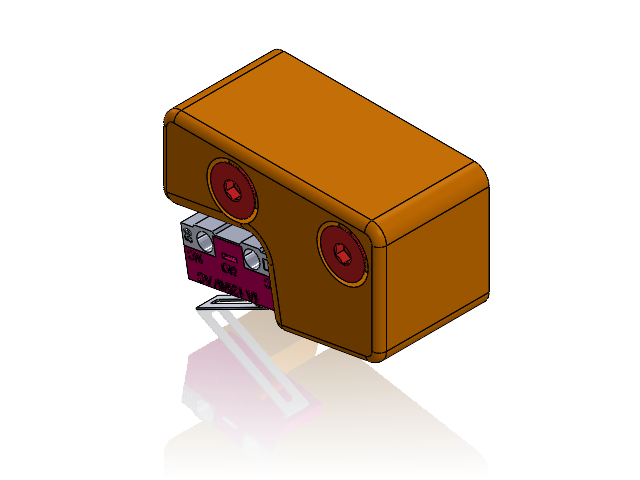
[picture p339: CAD file, 2026-08-09]
cad/v3 shifted CG thin RGB Limit Switch/Box/SwicthMount.SLDASM
SwitchMount
LimitSwitch
M3x8 flathead x 2
