fernandomierhicks/wheeled-leg-robot/cad/v5 Ai designed/Box/BottomPanelWithAvionics.SLDASM

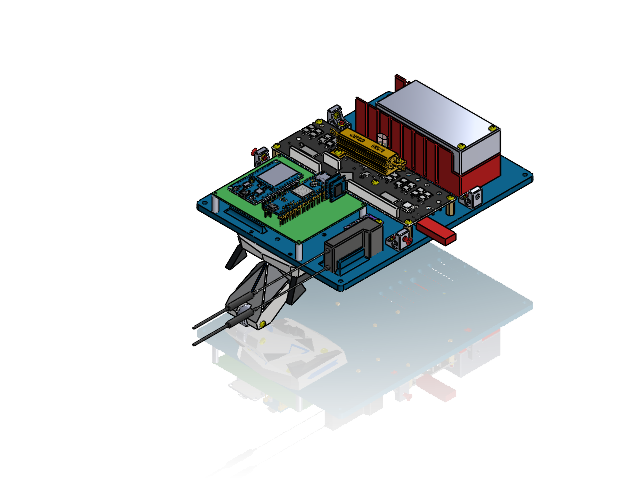
[picture p340: CAD file, 2026-10-17]
cad/v5 Ai designed/Box/BottomPanelWithAvionics.SLDASM
BottomPanel
CustomBoard
CAN x 2
ESP32
Teensy 4.1
IMU BNO085
Odrive
Receiver
Resistor
DC_DC
CornerBracket x 4
M3x8 flathead x 6
M3 nut x 8
M2 standoff x 4
XT30
Battery holder
BatteryCap
SupportWheel
TailStrut
M3 Roundhead x 16
M3 Flathead x 2
M3 standoff MF x 11
