fernandomierhicks/wheeled-leg-robot/cad/v5 Ai designed/Links/Tibia.SLDASM

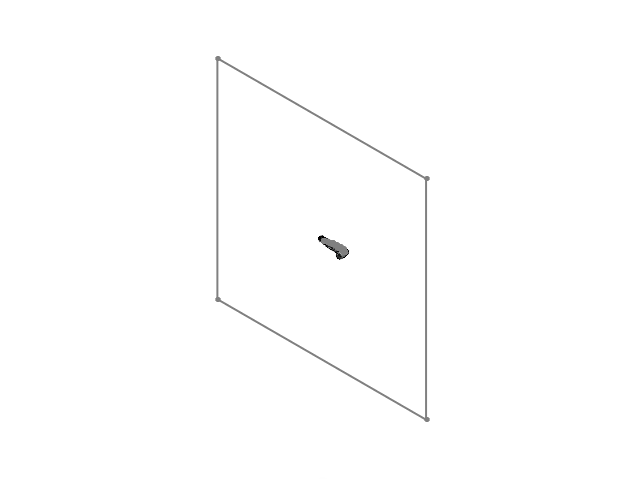
[picture p341: CAD file, 2026-10-17]
cad/v5 Ai designed/Links/Tibia.SLDASM
Tibia
Bearing 6804-2RS (20x32x7) x 4
Stator
Rotor
Magnet
Encoder
M4 roundhead x 4
MP30 connector
EncoderCarrier
EncoderCableClamp
M3 Roundhead x 11
M2 Roundhead x 2
