fernandomierhicks/wheeled-leg-robot/cad/v5 Ai designed/Links/MirrorFemur.SLDASM

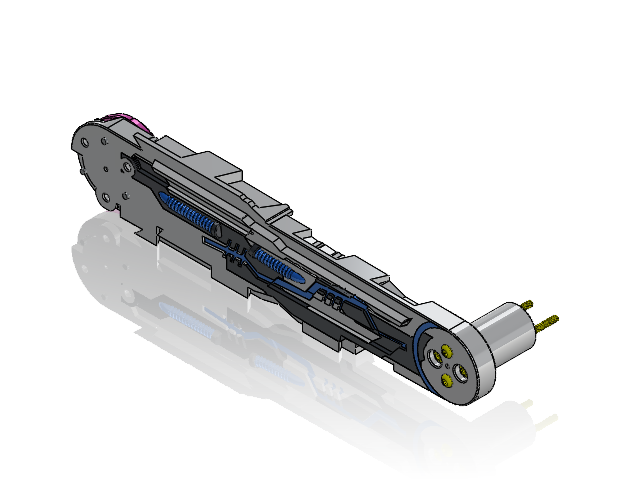
[picture p342: CAD file, 2026-10-10]
cad/v5 Ai designed/Links/MirrorFemur.SLDASM
Femur
AK45-10 Rotor
M3 Roundhead x 4
M2.5 Roundhead x 3
