fernandomierhicks/wheeled-leg-robot/cad/v5 Ai designed/Links/MirrorTibia.SLDASM

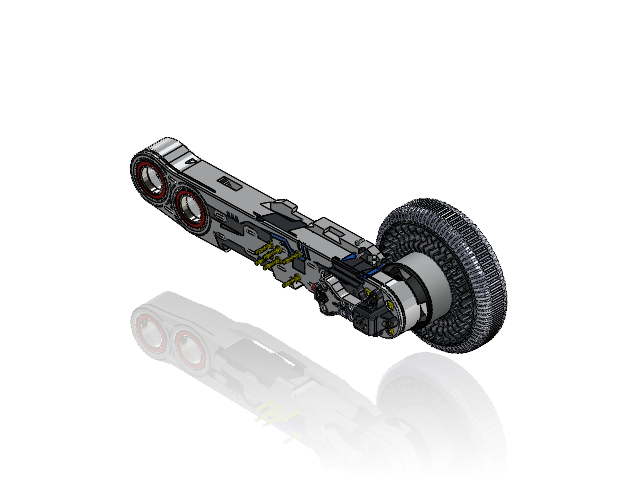
[picture p343: CAD file, 2026-10-10]
cad/v5 Ai designed/Links/MirrorTibia.SLDASM
MirrorTibia
Bearing 6804-2RS (20x32x7) x 4
Stator
Rotor
Magnet
Encoder
TPU wheel
Wheel
M4 roundhead x 4
MP30 connector
EncoderCarrier
EncoderCableClamp
M3 Roundhead x 11
M2 Roundhead x 2
