fernandomierhicks/wheeled-leg-robot/cad/v3 shifted CG thin RGB Limit Switch/links/FemurTibiaCouplerForPrinting.SLDASM

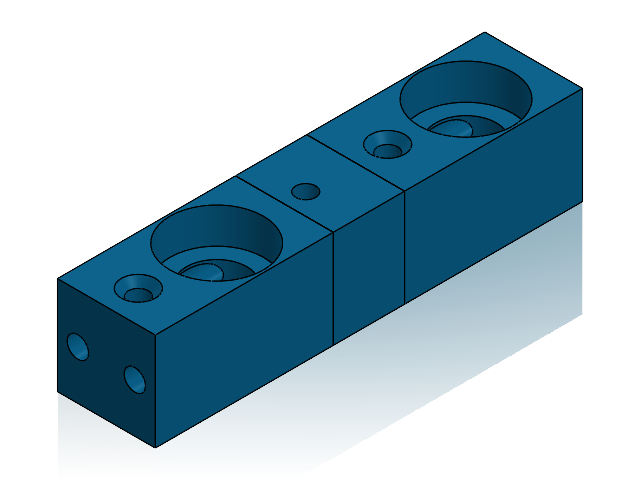
[picture p344: CAD file, 2026-05-07]
cad/v3 shifted CG thin RGB Limit Switch/links/FemurTibiaCouplerForPrinting.SLDASM
Coupler x 2
FemurTibiaCoupler
