fernandomierhicks/wheeled-leg-robot/(list of files, cad)

Other CAD files:
cad/v5 Ai designed/Body/BODY.SLDASM
cad/v5 Ai designed/ROBOT.SLDASM
cad/v5 Ai designed/_originals/pre_pipes_2026-10-07/Links/MirrorFemur.SLDASM
cad/v5 Ai designed/_originals/pre_pipes_2026-10-07/Body/MirrorSIDE PANEL.SLDASM
cad/v5 Ai designed/_originals/pre_pipes_2026-10-07/Body/MirrorBODY.SLDASM
cad/v5 Ai designed/Body/MirrorBODY.SLDASM
cad/v5 Ai designed/Links/MirrorFEMUR_INSIDE.SLDASM
cad/v5 Ai designed/Links/MirrorCOUPLER.SLDASM
cad/v5 Ai designed/_originals/pre_bumper_slots_2026-10-16/print/BumperFront_bambu.3mf
cad/v5 Ai designed/_originals/pre_facet_round3_2026-10-14/print/FacetFront_bambu.3mf
cad/v5 Ai designed/_originals/pre_facet_round4_2026-10-15/Facet/FacetFront.SLDPRT
cad/v5 Ai designed/_originals/pre_facet_round4_2026-10-15/print/FacetFront_bambu.3mf
cad/v5 Ai designed/_originals/pre_facet_round5_2026-10-15/Facet/FacetFront.SLDPRT
cad/v5 Ai designed/_originals/pre_facet_round5_2026-10-15/print/FacetFront_bambu.3mf
cad/v5 Ai designed/_originals/pre_hoodB_2026-10-07/solidworks_api_out/print/FacetHood_bambu.3mf
cad/v5 Ai designed/_originals/pre_printcolours_2026-10-12/print/TailStrut_bambu.3mf
cad/v5 Ai designed/_originals/pre_relief_2026-10-09/Box/TailStrut/TailStrut.SLDPRT
cad/v5 Ai designed/_originals/pre_relief_2026-10-09/Links/Coupler.SLDPRT
cad/v5 Ai designed/_originals/pre_stripseat_2026-10-13/FacetHood.SLDPRT
cad/v5 Ai designed/_originals/pre_trapezoids_2026-10-12/print/TailStrut_bambu.3mf
cad/v5 Ai designed/_originals/pre_visor_2026-10-08/solidworks_api_out/print/FacetHood_bambu.3mf
cad/v5 Ai designed/Other/WheelHanger.SLDPRT
cad/solidworks_api/out/print/TailStrut_bambu.3mf
cad/v5 Ai designed/_originals/pre_bumper_slots_2026-10-16/Facet/BumperFront.SLDPRT
cad/v5 Ai designed/_originals/pre_bumper_trapezoid_2026-10-15/Facet/BumperFront.SLDPRT
cad/v5 Ai designed/_originals/pre_one_grey_2026-10-16/FacetHood_bambu.3mf
cad/v5 Ai designed/ai_components/hello_box_multicolor.SLDPRT
cad/v5 Ai designed/Box/Facet/BumperFront.SLDPRT
cad/v3 shifted CG thin RGB Limit Switch/links/StopperMirrored.SLDPRT
cad/v5 Ai designed/_originals/Body/Side panel.SLDPRT
cad/v5 Ai designed/_originals/pre_relief_2026-10-09/Box/Facet/FacetHood.SLDPRT
cad/v5 Ai designed/_originals/pre_relief_2026-10-09/Links/MirrorCoupler.SLDPRT
cad/aesthetics/out/print/other colors/Femur/Femur_apex.3mf
cad/aesthetics/out/print/other colors/Femur/Femur_bullion.3mf
cad/aesthetics/out/print/other colors/Femur/Femur_circuitry.3mf
cad/aesthetics/out/print/other colors/Femur/Femur_dune.3mf
cad/aesthetics/out/print/other colors/Femur/Femur_ghost.3mf
cad/aesthetics/out/print/other colors/Femur/Femur_hazard.3mf
cad/aesthetics/out/print/other colors/Femur/Femur_monolith.3mf
cad/aesthetics/out/print/other colors/Femur/Femur_nightrun.3mf
cad/aesthetics/out/print/other colors/Femur/Femur_overdrive.3mf
cad/aesthetics/out/print/other colors/Femur/Femur_pulsar.3mf
cad/aesthetics/out/print/other colors/Femur/Femur_recon.3mf
cad/aesthetics/out/print/other colors/Femur/Femur_signal.3mf
cad/aesthetics/out/print/other colors/Femur/Femur_vice.3mf
cad/aesthetics/out/print/other colors/Tibia/Tibia_abyss.3mf
cad/aesthetics/out/print/other colors/Tibia/Tibia_apex.3mf
cad/aesthetics/out/print/other colors/Tibia/Tibia_blackout.3mf
cad/aesthetics/out/print/other colors/Tibia/Tibia_bullion.3mf
cad/aesthetics/out/print/other colors/Tibia/Tibia_circuitry.3mf
cad/aesthetics/out/print/other colors/Tibia/Tibia_foundry.3mf
cad/aesthetics/out/print/other colors/Tibia/Tibia_ghost.3mf
cad/aesthetics/out/print/other colors/Tibia/Tibia_hazard.3mf
cad/aesthetics/out/print/other colors/Tibia/Tibia_monolith.3mf
cad/aesthetics/out/print/other colors/Tibia/Tibia_overdrive.3mf
cad/aesthetics/out/print/other colors/Tibia/Tibia_recon.3mf
cad/aesthetics/out/print/other colors/Tibia/Tibia_scalpel.3mf
cad/aesthetics/out/print/other colors/Tibia/Tibia_signal.3mf
cad/aesthetics/out/print/other colors/Tibia/Tibia_vice.3mf
cad/solidworks_api/out/print/BearingWasher_glacier_native.3mf
cad/solidworks_api/out/print/BottomPanel_bambu.3mf
cad/solidworks_api/out/print/BumperFront_bambu.3mf
cad/solidworks_api/out/print/Coupler_glacier_native.3mf
cad/solidworks_api/out/print/EncoderCableClamp_glacier_native.3mf
cad/solidworks_api/out/print/FacetBack_bambu.3mf
cad/solidworks_api/out/print/FacetFront_bambu.3mf
cad/solidworks_api/out/print/FacetHood_bambu.3mf
cad/solidworks_api/out/print/FacetRing_bambu.3mf
cad/solidworks_api/out/print/Femur_glacier_native.3mf
cad/solidworks_api/out/print/Femur_inside_glacier_native.3mf
cad/solidworks_api/out/print/InsideFemurShaft_glacier_native.3mf
cad/solidworks_api/out/print/RobotMount_glacier_native.3mf
cad/solidworks_api/out/print/Side panel_glacier_native.3mf
cad/solidworks_api/out/print/Side panel_skin.3mf
cad/solidworks_api/out/print/SmallBearingWahser_glacier_native.3mf
cad/solidworks_api/out/print/Tibia_glacier_native.3mf
cad/solidworks_api/out/print/Wheel_glacier_native.3mf
cad/v1 circular tube with end rods/links/Ak45LeverArm.SLDPRT
cad/v1 circular tube with end rods/links/AligmentJig.SLDPRT
cad/v1 circular tube with end rods/links/Coupler.SLDASM
cad/v1 circular tube with end rods/links/Coupler.SLDPRT
cad/v1 circular tube with end rods/links/CouplerJig.SLDPRT
cad/v1 circular tube with end rods/links/EndRod.SLDASM
cad/v1 circular tube with end rods/links/Femur.SLDASM
cad/v1 circular tube with end rods/links/FemurJig.SLDPRT
cad/v1 circular tube with end rods/links/FemurMotorCoupler.SLDPRT
cad/v1 circular tube with end rods/links/FootCoupler.SLDPRT
cad/v1 circular tube with end rods/links/M16 Tube Coupler.SLDPRT
cad/v1 circular tube with end rods/links/M16 Tube Femur.SLDPRT
cad/v1 circular tube with end rods/links/M16 Tube Tibia.SLDPRT
cad/v1 circular tube with end rods/links/M16 Tube.SLDPRT
cad/v1 circular tube with end rods/links/M5 RodEnd.SLDPRT
cad/v1 circular tube with end rods/links/MotorCouplerReinforcement.SLDPRT
cad/v1 circular tube with end rods/links/Tibia.SLDASM
cad/v1 circular tube with end rods/links/TibiaCouplerBase.SLDPRT
cad/v1 circular tube with end rods/links/TibiaCouplerCap.SLDPRT
cad/v1 circular tube with end rods/links/TibiaJig.SLDPRT
cad/v3 shifted CG thin RGB Limit Switch/AK45-10 Rotor.SLDPRT
cad/v3 shifted CG thin RGB Limit Switch/Arduino.SLDPRT
cad/v3 shifted CG thin RGB Limit Switch/Battery.SLDPRT
cad/v3 shifted CG thin RGB Limit Switch/Box/BackPanel.SLDPRT
cad/v3 shifted CG thin RGB Limit Switch/Box/Battery holder.SLDPRT
cad/v3 shifted CG thin RGB Limit Switch/Box/BatteryCap.SLDPRT
cad/v3 shifted CG thin RGB Limit Switch/Box/BottomPanel.SLDPRT
cad/v3 shifted CG thin RGB Limit Switch/Box/BottomPanelWithAvionics.SLDASM
cad/v3 shifted CG thin RGB Limit Switch/Box/Box.SLDASM
cad/v3 shifted CG thin RGB Limit Switch/Box/CableClamp.SLDPRT
cad/v3 shifted CG thin RGB Limit Switch/Box/Cap.SLDPRT
cad/v3 shifted CG thin RGB Limit Switch/Box/CornerBracket.SLDASM
cad/v3 shifted CG thin RGB Limit Switch/Box/CornerBracket.SLDPRT
cad/v3 shifted CG thin RGB Limit Switch/Box/Cushion_support.SLDPRT
cad/v3 shifted CG thin RGB Limit Switch/Box/FrontPanel.SLDPRT
cad/v3 shifted CG thin RGB Limit Switch/Box/Lid.SLDPRT
cad/v3 shifted CG thin RGB Limit Switch/Box/M2 standoff.SLDPRT
cad/v3 shifted CG thin RGB Limit Switch/Box/M3 Square nut.SLDPRT
cad/v3 shifted CG thin RGB Limit Switch/Box/M3x8 flathead.SLDPRT
cad/v3 shifted CG thin RGB Limit Switch/Box/MirrorSinePanel.SLDPRT
cad/v3 shifted CG thin RGB Limit Switch/Box/MirroredSwitchMount.SLDPRT
cad/v3 shifted CG thin RGB Limit Switch/Box/NeoPixelCage.SLDPRT
cad/v3 shifted CG thin RGB Limit Switch/Box/Neopixel.SLDPRT
cad/v3 shifted CG thin RGB Limit Switch/Box/NeopixelSupport.SLDPRT
cad/v3 shifted CG thin RGB Limit Switch/Box/SinePanel.SLDPRT
cad/v3 shifted CG thin RGB Limit Switch/Box/SwitchMount.SLDPRT
cad/v3 shifted CG thin RGB Limit Switch/Box/TPU_protector.SLDPRT
cad/v3 shifted CG thin RGB Limit Switch/Buzzer.SLDPRT
cad/v3 shifted CG thin RGB Limit Switch/CAN.SLDPRT
cad/v3 shifted CG thin RGB Limit Switch/CouplerSupport.SLDPRT
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
