fernandomierhicks/wheeled-leg-robot/cad/v3 shifted CG thin RGB Limit Switch/Instructions.txt

Drill all holes
Chamfers need to be drilled without 3d part in there.
