fernandomierhicks/wheeled-leg-robot/cad/aesthetics/out/marks/assembly/asm_edge_-X.png

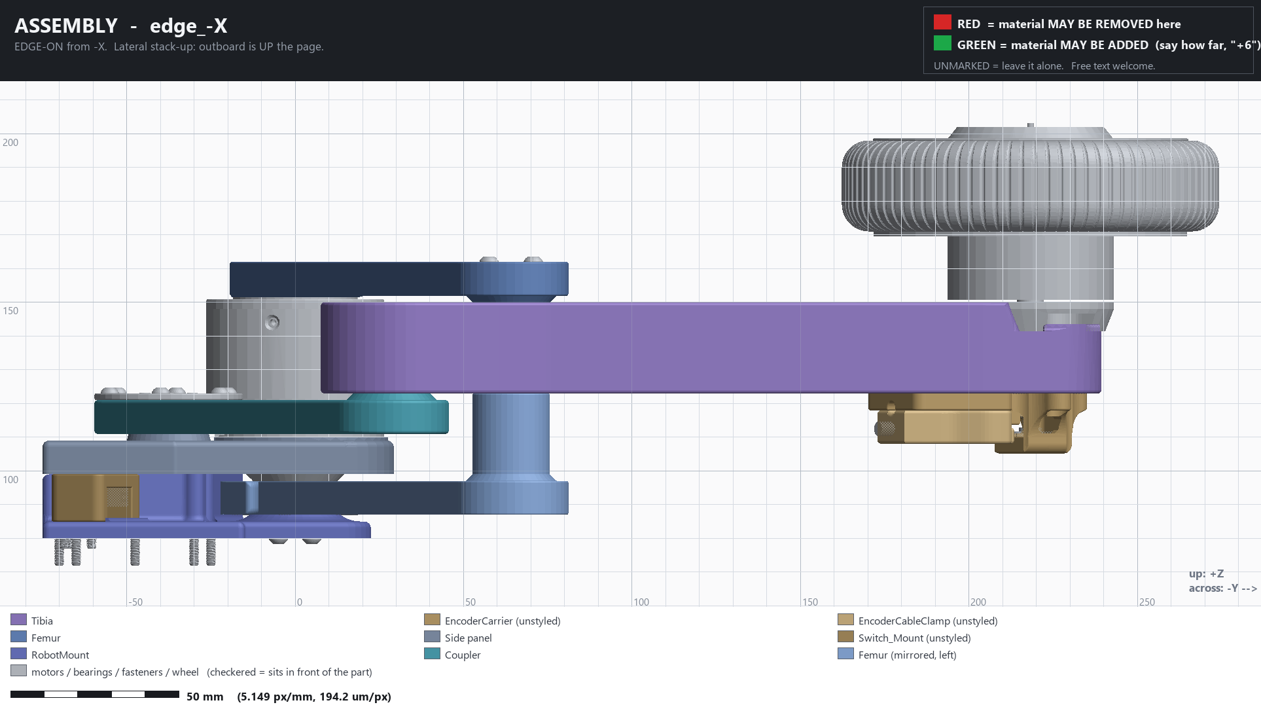
cad/aesthetics/out/marks/assembly/asm_edge_-X.png
