fernandomierhicks/wheeled-leg-robot/cad/aesthetics/out/marks/assembly/asm_edge_-Y.png

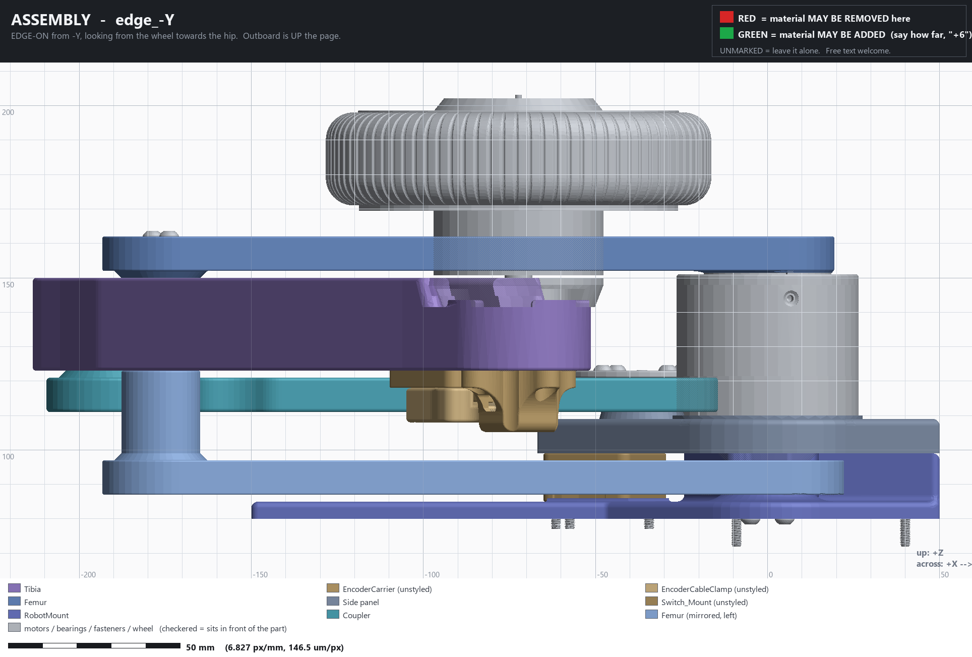
cad/aesthetics/out/marks/assembly/asm_edge_-Y.png
