fernandomierhicks/wheeled-leg-robot/cad/aesthetics/out/marks/assembly/asm_inboard.png

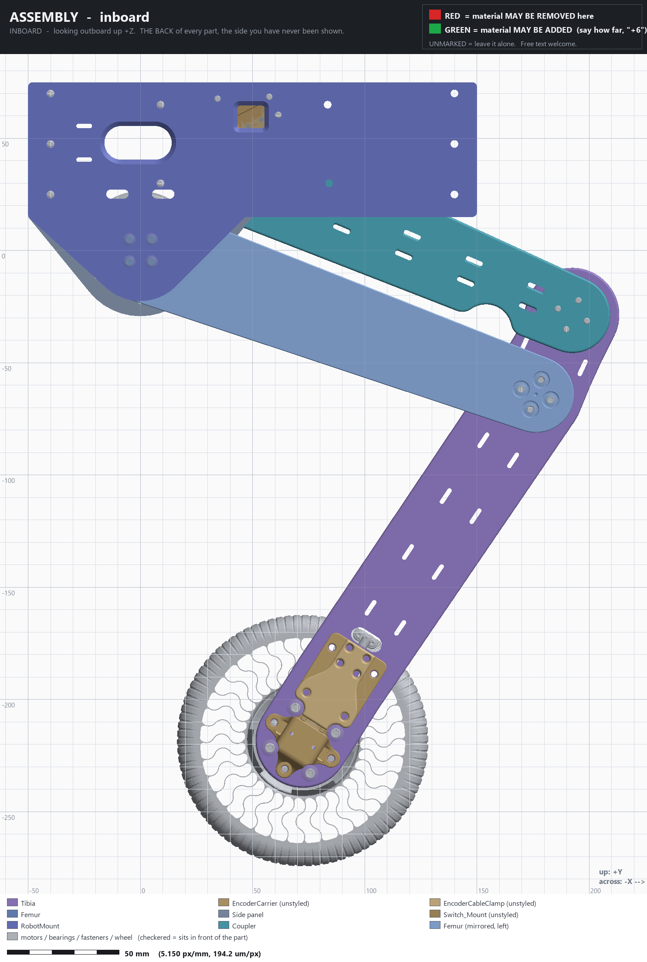
cad/aesthetics/out/marks/assembly/asm_inboard.png
