fernandomierhicks/wheeled-leg-robot/cad/aesthetics/out/marks/assembly/asm_outboard.png

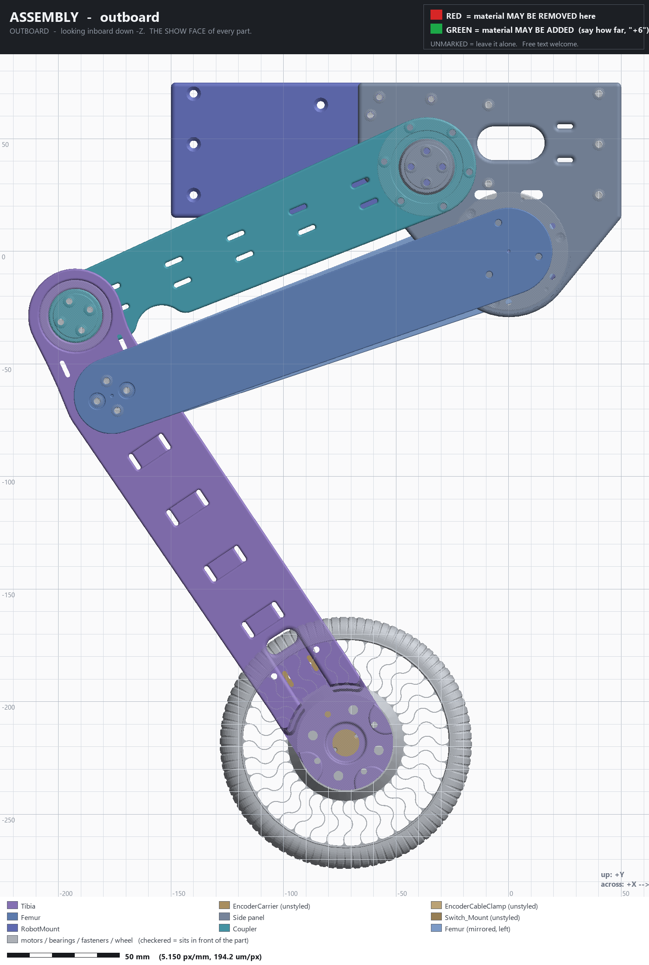
cad/aesthetics/out/marks/assembly/asm_outboard.png
