fernandomierhicks/wheeled-leg-robot/cad/aesthetics/out/marks/INDEX_assembly.png

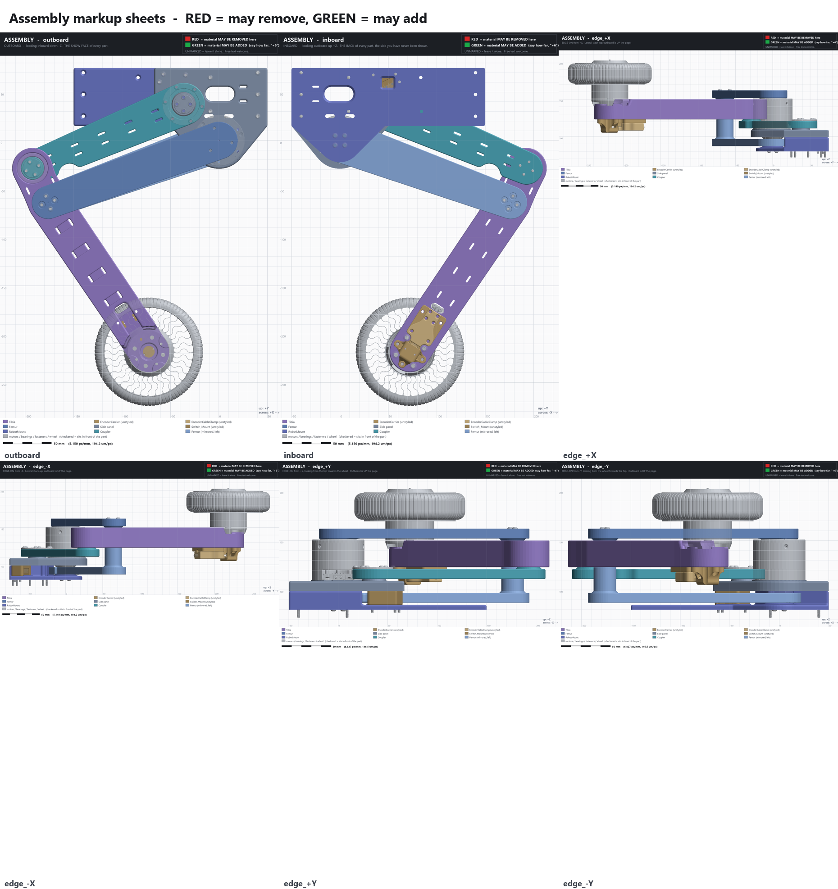
cad/aesthetics/out/marks/INDEX_assembly.png
