fernandomierhicks/wheeled-leg-robot/cad/aesthetics/out/renders/assembly_glacier.png

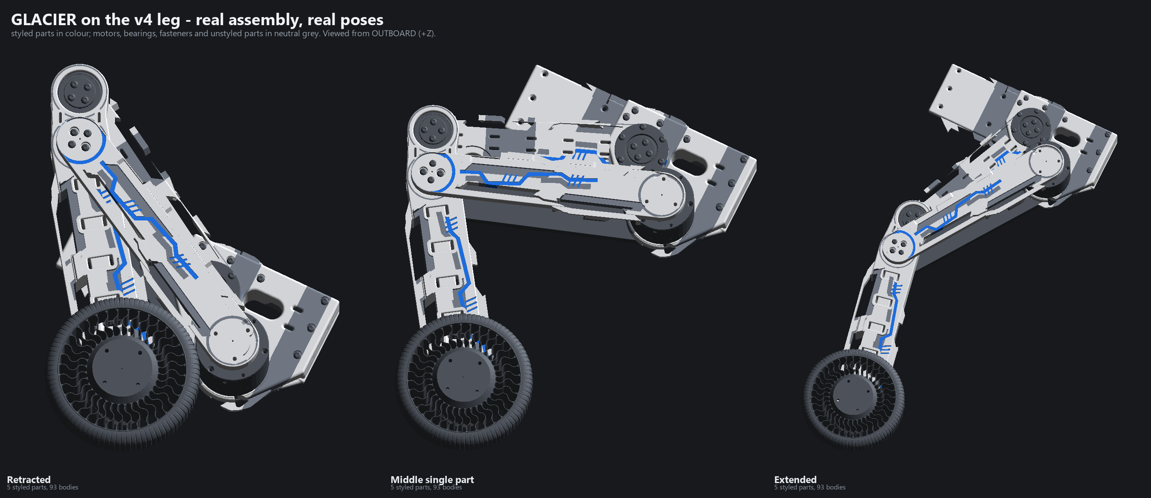
cad/aesthetics/out/renders/assembly_glacier.png
