fernandomierhicks/wheeled-leg-robot/cad/solidworks_api/out/renders/assembly_middle_front.png

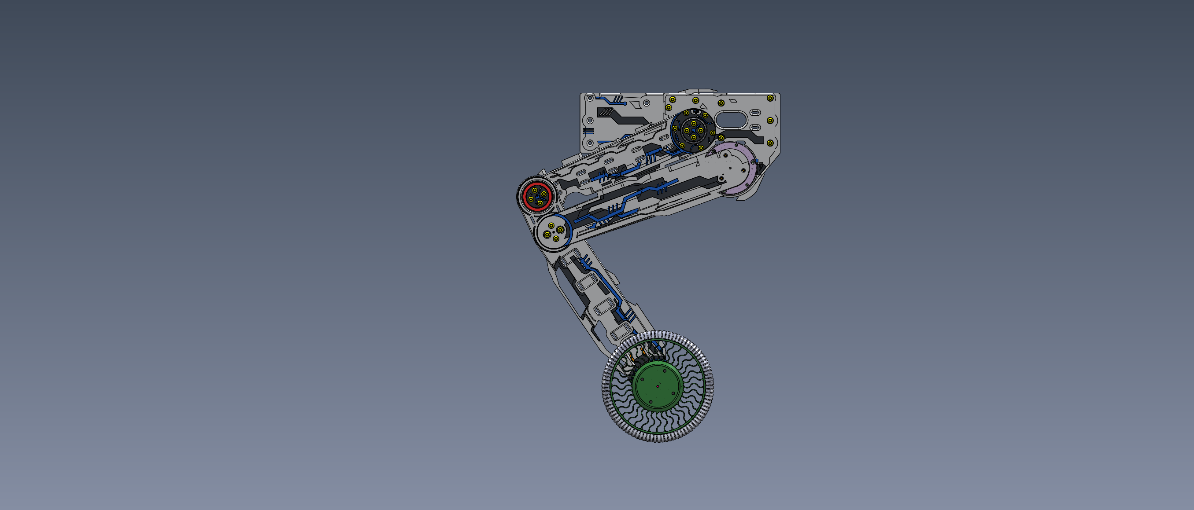
cad/solidworks_api/out/renders/assembly_middle_front.png
