fernandomierhicks/wheeled-leg-robot/cad/solidworks_api/out/renders/assembly_middle_trimetric.png

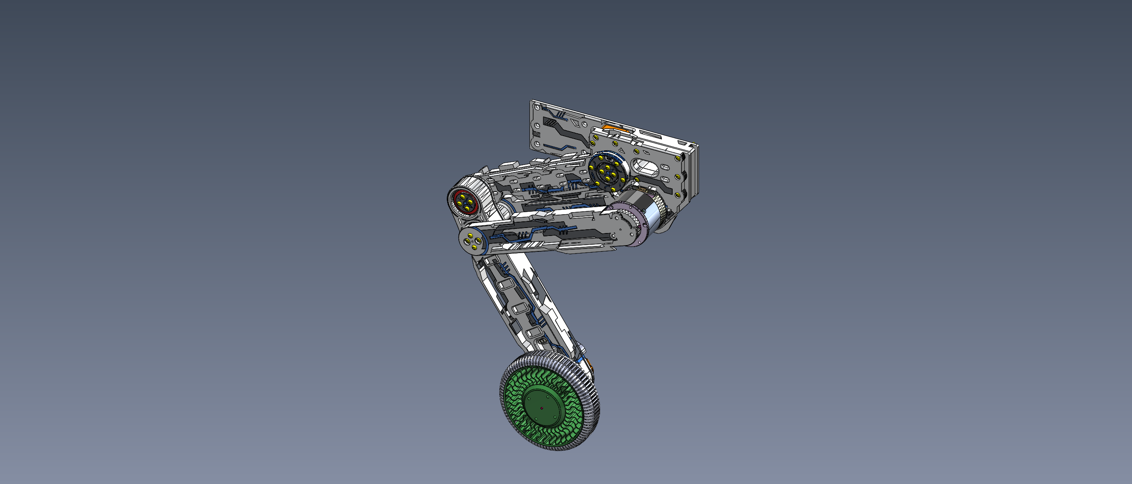
cad/solidworks_api/out/renders/assembly_middle_trimetric.png
