fernandomierhicks/wheeled-leg-robot/cad/solidworks_api/out/renders/assembly_retracted_trimetric.png

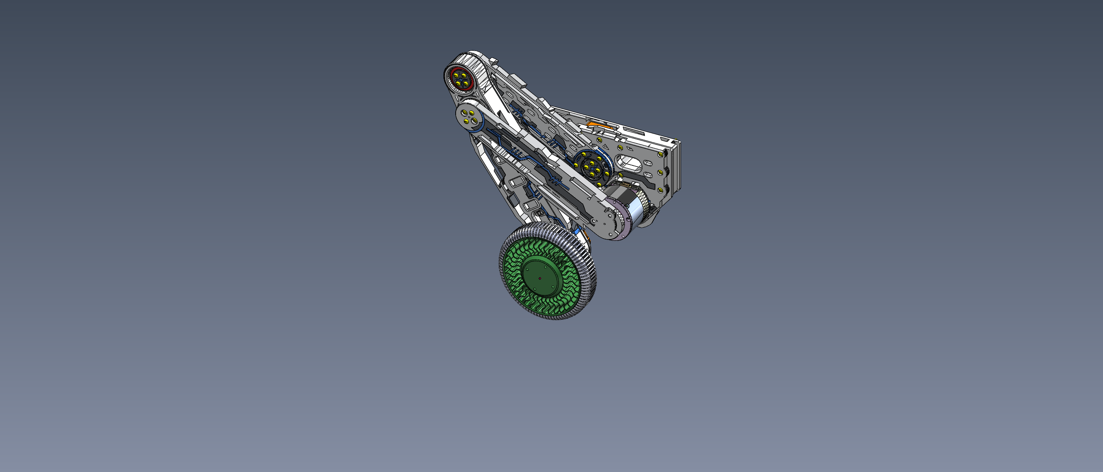
cad/solidworks_api/out/renders/assembly_retracted_trimetric.png
