fernandomierhicks/wheeled-leg-robot/cad/solidworks_api/out/renders/box_facet_print/facet_close.png

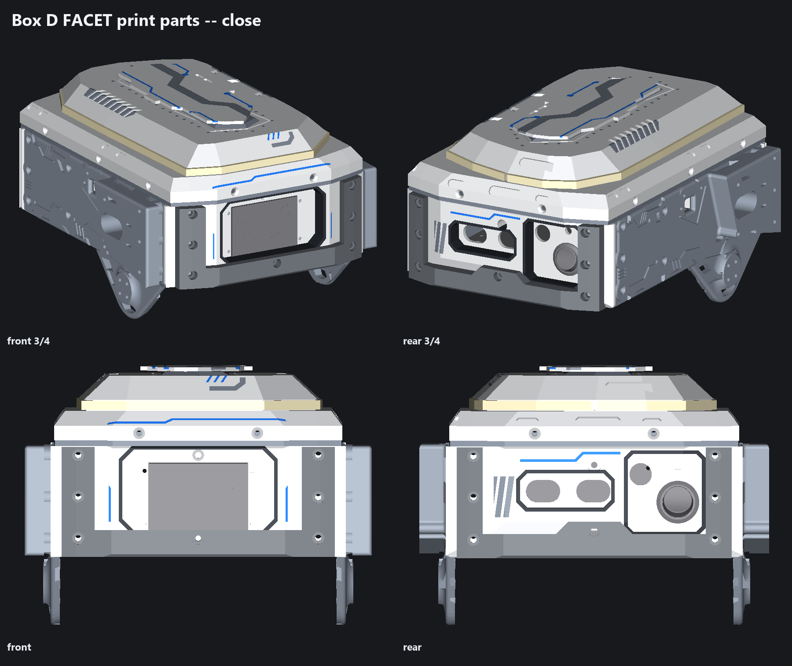
cad/solidworks_api/out/renders/box_facet_print/facet_close.png
