fernandomierhicks/wheeled-leg-robot/cad/solidworks_api/out/renders/box_facet_print/facet_exploded.png

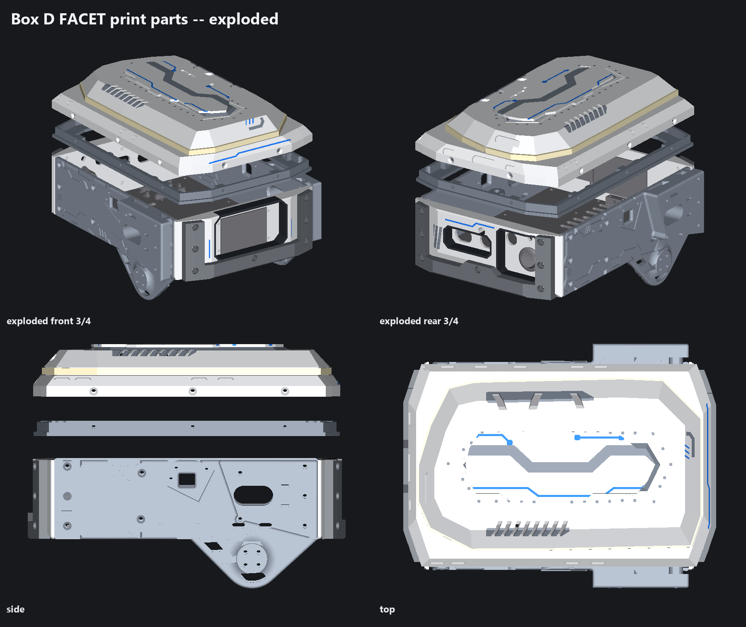
cad/solidworks_api/out/renders/box_facet_print/facet_exploded.png
