fernandomierhicks/wheeled-leg-robot/cad/solidworks_api/out/renders/box_facet_print/facet_part_BumperFront_BumperBack.png

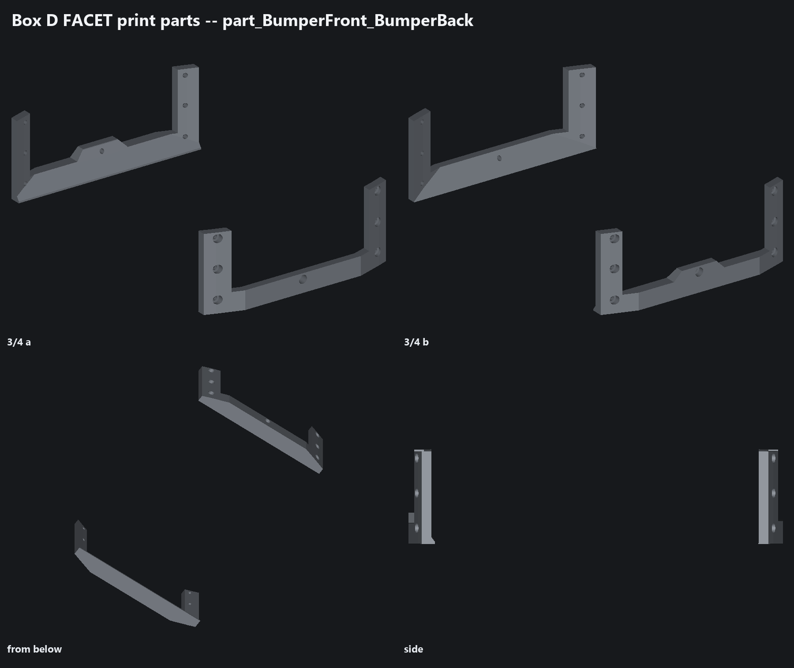
cad/solidworks_api/out/renders/box_facet_print/facet_part_BumperFront_BumperBack.png
