fernandomierhicks/wheeled-leg-robot/cad/solidworks_api/out/renders/box_facet_print/robot_body_iso.png

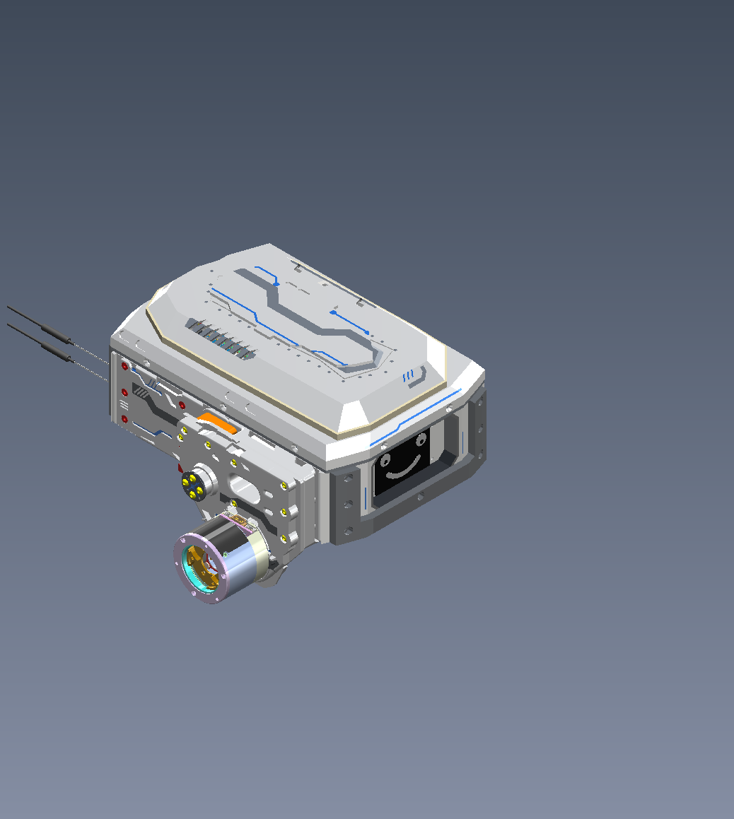
cad/solidworks_api/out/renders/box_facet_print/robot_body_iso.png
