fernandomierhicks/wheeled-leg-robot/cad/solidworks_api/out/renders/robotmount_left_field_assembly_front.png

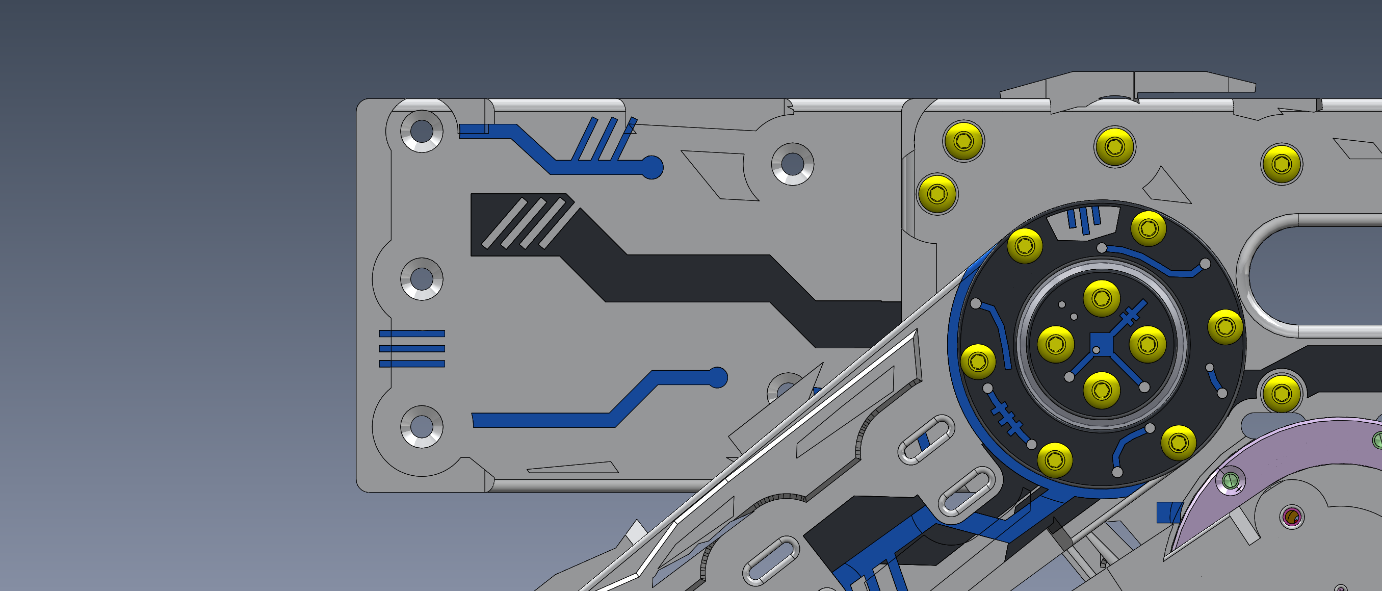
cad/solidworks_api/out/renders/robotmount_left_field_assembly_front.png
