fernandomierhicks/wheeled-leg-robot/cad/solidworks_api/out/renders/tailstrut_print_colours.png

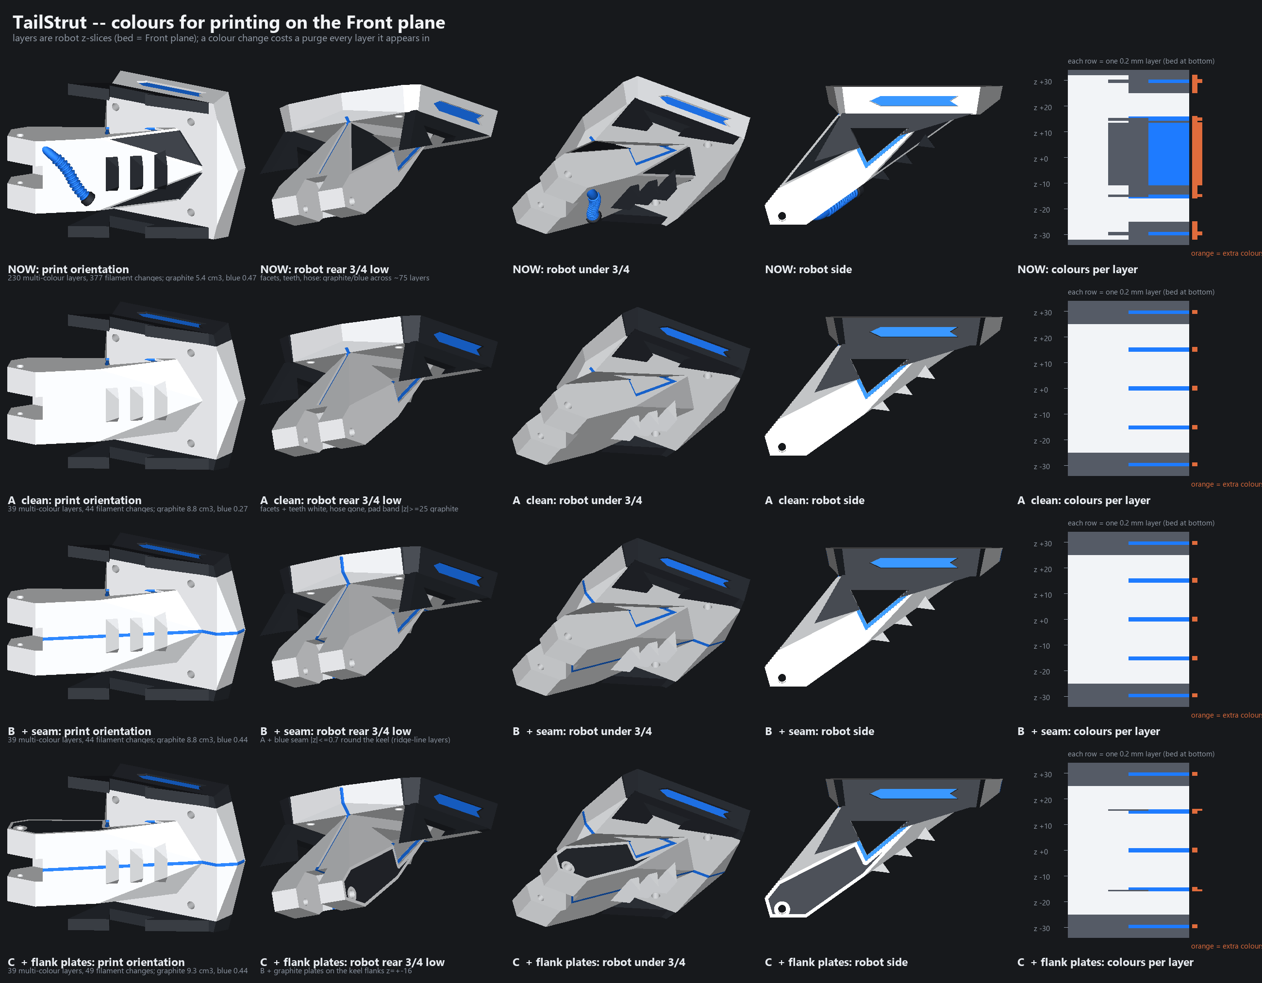
cad/solidworks_api/out/renders/tailstrut_print_colours.png
