fernandomierhicks/wheeled-leg-robot/cad/v5 Ai designed/Box/Facet/preview_facet_print.png

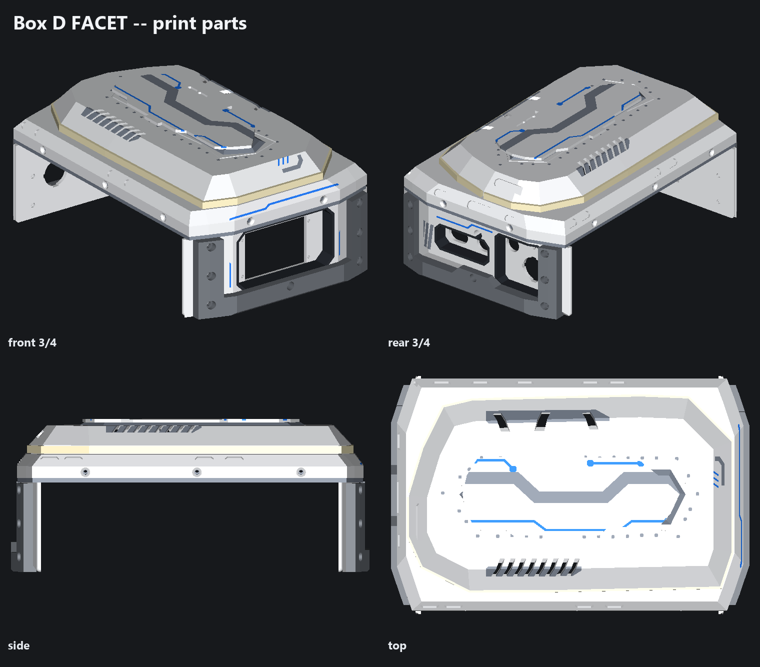
cad/v5 Ai designed/Box/Facet/preview_facet_print.png
