fernandomierhicks/wheeled-leg-robot/components/characterization/akMars/README.md

# AK45-10 Characterization — CubeMars Tool V1.32

## Tool
`CubeMarstool_V1.32.exe` — VESC-derived upper computer software.

## Max Speed

**Datasheet:** 180 rpm output (no-load, 24 V) = **25,200 ERPM** (10:1 gearbox, 14 pole pairs).

**Verified:** Visual inspection confirmed the motor reaches ~3 RPS (180 rpm) at full command — matches datasheet.

## Known Issue: Speed Display in deg/s is Wrong

The GUI reports output speed in deg/s with a large scaling error (~4.7× too low). At full speed the display shows ~230 deg/s when the true output is ~1,080 deg/s (180 rpm × 6).

**Use ERPM as the ground truth** (25,200 ERPM = 180 rpm = 1,080 deg/s at no load, 24 V).

The bug is likely a wrong gear ratio or pole-pair count in the GUI's unit conversion — do not trust the deg/s readout.

## CAN Wiring: Ground Required

CAN communication to the AK45 **requires a common ground** between the Arduino and the motor driver. Without it, CAN frames are never received by the motor despite correct CANH/CANL wiring.

**Use the GND pin exposed on the motor's UART connector** — it is the most accessible ground point on the motor side.

## MIT Mode: Periodic `enter_mit` is Required

Sending `enter_mit` once in `setup()` is **not enough**. The motor drops out of MIT mode after a few seconds if it does not receive a periodic re-entry command.

**Rule:** re-send `enter_mit` (followed immediately by a motion command) every few seconds in the main loop. The working cadence found in `springness` is every **4 seconds**. Without this, the motor silently stops responding to position/torque commands even though CAN traffic continues — it will not move and gives no error indication.

```cpp
if (nowMs - lastEnterMs >= 4000) {
    lastEnterMs = nowMs;
    enter_mit(M1_ID);
    delayMicroseconds(INTER_FRAME_US);
    enter_mit(M2_ID);
    delay(5);
    send_command(M1_ID);   // must follow enter_mit immediately
    delayMicroseconds(INTER_FRAME_US);
    send_command(M2_ID);
}
```
