fernandomierhicks/wheeled-leg-robot/components/characterization/akMars/Tuning.docx

SERVO SETUP

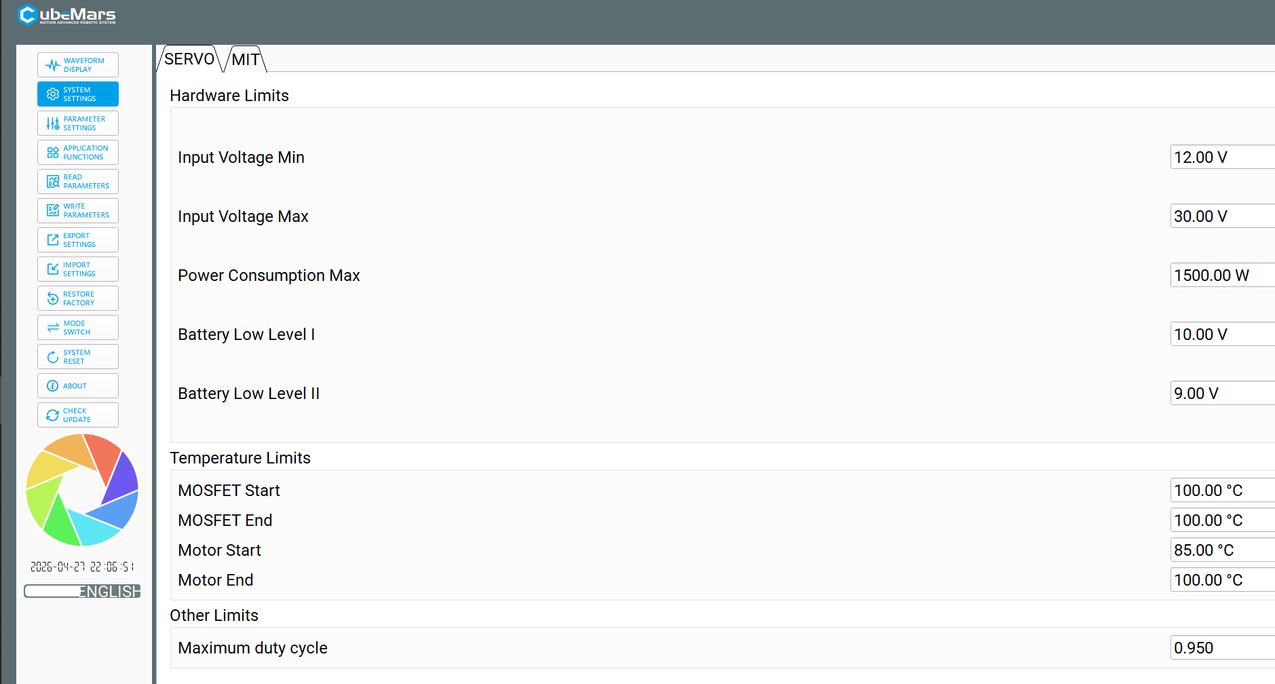
[picture p373: figure]

1. Set Current limits
2. Detect encoder→Update
3. Measure R/L →Lambda→Update
4. Might have to tune velocity controller

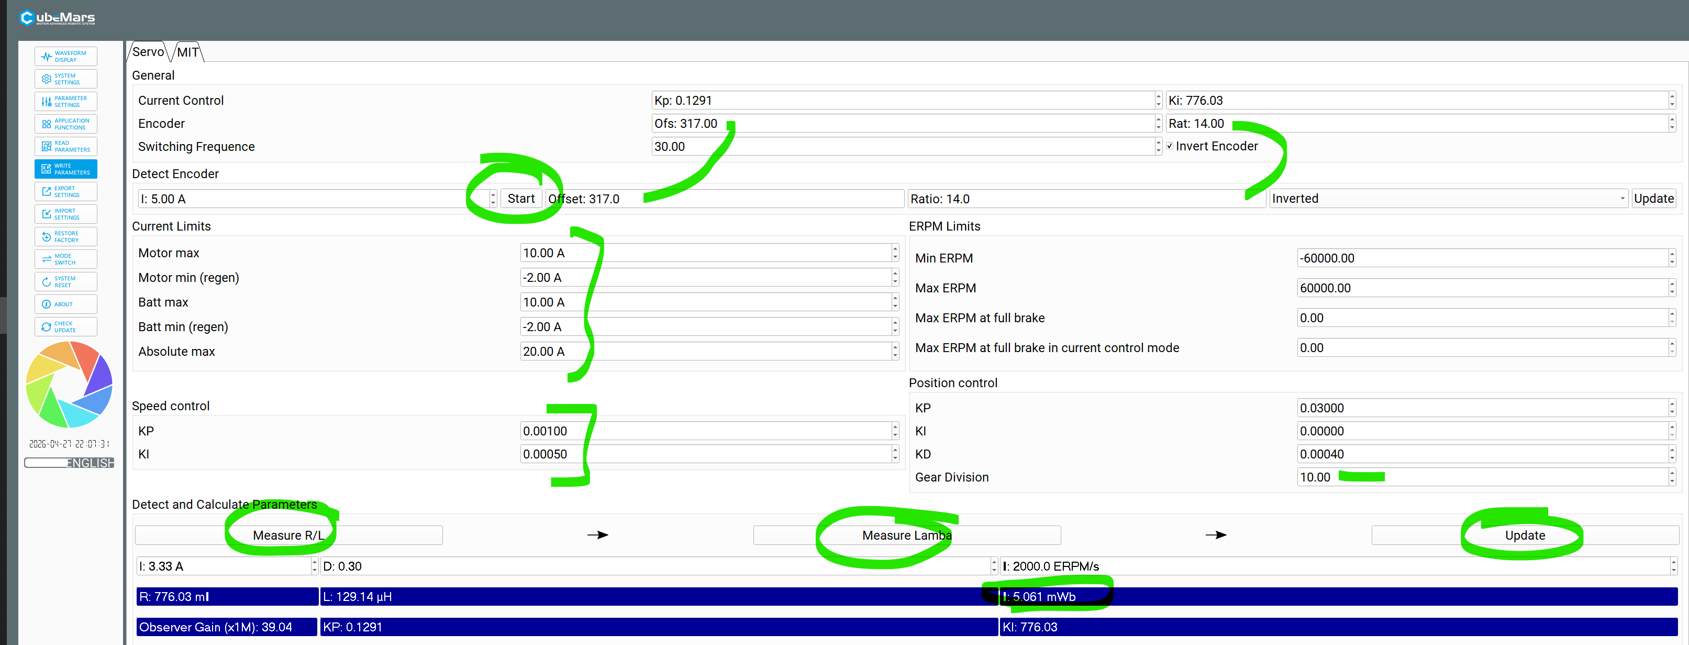
[picture p374: figure]
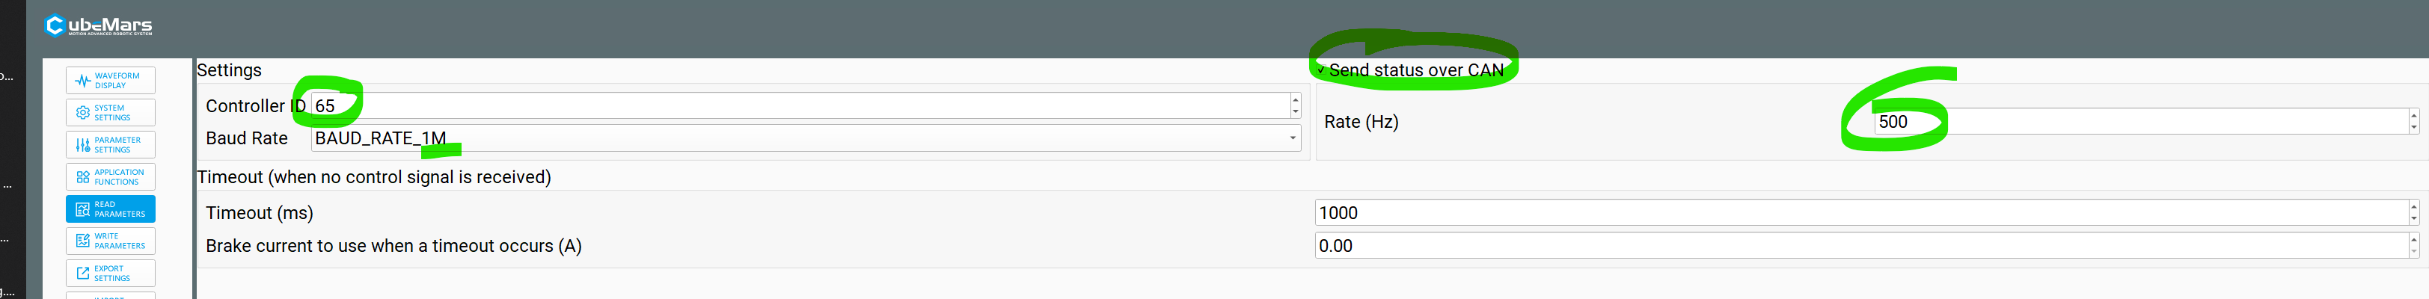
[picture p375: figure]

CAN MODE

https://www.youtube.com/watch?v=5KYqYAnAdCM

Setup CAN mode→ Debug

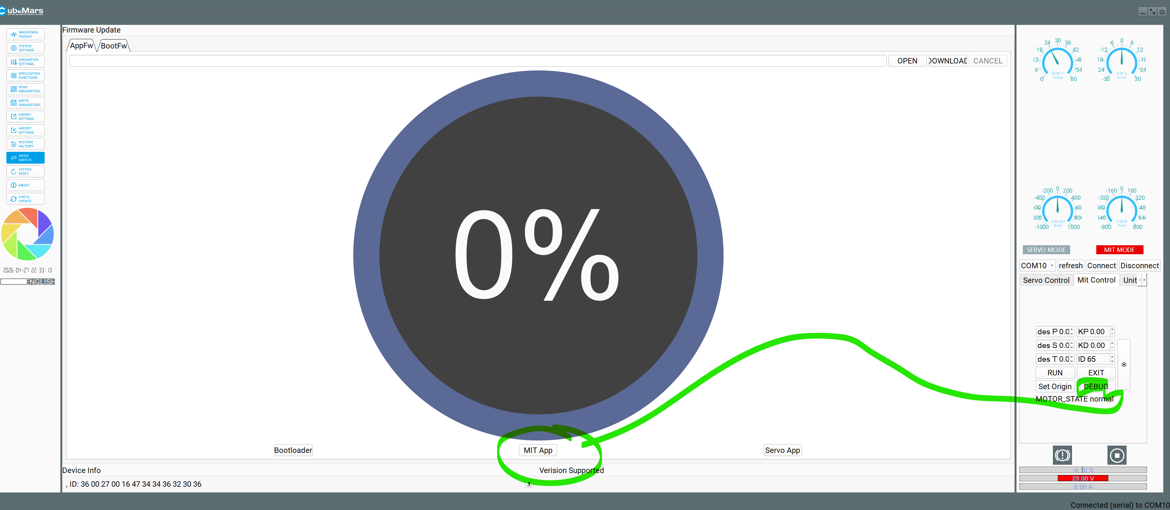
[picture p376: figure]
