fernandomierhicks/wheeled-leg-robot/simulation/mujoco/4bar_optimization/results.csv

run_id | label | timestamp | L_femur_mm | L_stub_mm | L_tibia_mm | Lc_mm | F_X_mm | F_Z_mm | A_Z_mm | AF_mm | AF_motor_clearance_mm | m_box_g | m_femur_g | m_tibia_g | m_coupler_g | m_wheel_g | total_mass_g | Q_retracted_rad | Q_extended_rad | stroke_deg | jump_height_mm | status | fail_reason | bearing_warnings
1 | visual_sim_baseline | 2026-03-16 11:37:07 | 100.0 | 15.0 | 115.0 | 110.0 | -15.0 | 2.5 | -23.5 | 30.02 | 3.52 | 477.0 | 25.0 | 35.0 | 15.0 | 410.0 | 1222.0 | -0.35071 | -1.31902 | 55.48 | 33.13 | PASS |  | tibia_stub 15.0mm<25mm|AF_clear 3.5mm<12.5mm
2 | bearing_legal_default | 2026-03-16 11:37:08 | 100.0 | 25.0 | 115.0 | 110.0 | -20.0 | 11.16 | -23.5 | 40.02 | 13.52 | 477.0 | 25.0 | 35.0 | 15.0 | 410.0 | 1222.0 | -0.35071 | -1.35905 | 57.77 | 21.87 | PASS
3 | oat_L_femur_50mm | 2026-03-16 11:37:08 | 50.0 | 25.0 | 115.0 | 110.0 | -20.0 | 11.16 | -23.5 | 40.02 | 13.52 | 477.0 | 25.0 | 35.0 | 15.0 | 410.0 | 1222.0 | -2.35238 | -2.35488 | 0.14 |  | FAIL | mechanical crash: joint below ground
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
