fernandomierhicks/wheeled-leg-robot/simulation/mujoco/LQR_controller/lqr_sweep_results.csv

Q_pitch | R | settle_time | overshoot | control_effort | peak_control | damp_ratio
50 | 0.05 | 0.734 | 2.8944032115136005 | 831159.1168912401 | 660.703830423325 | 0.968647655965139
50 | 0.1 | 0.734 | 2.8944032115136005 | 416674.6055425546 | 467.6194904812313 | 0.968142723175761
50 | 0.2 | 0.734 | 2.8944032115136005 | 209112.80230164988 | 331.08800737158526 | 0.9671329659243743
50 | 0.5 | 1.1420000000000001 | 2.894360317918633 | 84248.55162966828 | 208.8951612594769 | 0.9641065385811658
50 | 1.0 | 0.734 | 2.8943010065995725 | 42455.19494051807 | 151.52458563941488 | 0.959084983385107
75 | 0.05 | 0.734 | 2.8944032115136005 | 833363.0336155521 | 661.3195045369241 | 0.9510743849705515
75 | 0.1 | 0.734 | 2.8944032115136005 | 417770.8425536148 | 468.0518392757579 | 0.9506656254296616
75 | 0.2 | 0.734 | 2.8944032115136005 | 209655.32552655868 | 331.38987698661106 | 0.9498487154513303
75 | 0.5 | 1.1420000000000001 | 2.894361921534063 | 84540.28608776901 | 210.03856230266325 | 0.9474038632527518
75 | 1.0 | 0.734 | 2.894303897434329 | 42545.67188608375 | 148.43883218574456 | 0.9433552666971247
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
