fernandomierhicks/wheeled-leg-robot/simulation/mujoco/latency_sensitivity/logs/results.csv

run_id | scenario | label | timestamp | Q_PITCH | Q_PITCH_RATE | Q_VEL | R | KP_V | KI_V | rms_pitch_deg | max_pitch_deg | wheel_travel_m | wheel_liftoff_s | vel_track_rms_ms | settle_time_s | survived_s | fitness_balance | fitness_disturbance | fitness_drive_slow | fitness_drive_med | fitness_obstacle | fitness | status | fail_reason
1 | 1_LQR_pitch_step |  | 2026-03-20 01:25:00 |  |  |  |  |  |  | 6.8756 | 43.4979 |  |  |  | 0.52 | 2.296 |  |  |  |  |  | 200.324169 | FAIL | fell over
2 | 1_LQR_pitch_step |  | 2026-03-20 01:25:01 |  |  |  |  |  |  | 7.2019 | 43.1072 |  |  |  | 0.216 | 2.302 |  |  |  |  |  | 200.315713 | FAIL | fell over
3 | 1_LQR_pitch_step |  | 2026-03-20 01:25:01 |  |  |  |  |  |  | 7.1346 | 43.4948 |  |  |  | 0.148 | 2.304 |  |  |  |  |  | 200.30622 | FAIL | fell over
4 | 1_LQR_pitch_step |  | 2026-03-20 01:25:01 |  |  |  |  |  |  | 6.4643 | 43.1642 |  |  |  | 0.21 | 2.258 |  |  |  |  |  | 200.319683 | FAIL | fell over
5 | 1_LQR_pitch_step |  | 2026-03-20 01:25:01 |  |  |  |  |  |  | 6.9179 | 43.1035 |  |  |  | 0.144 | 2.302 |  |  |  |  |  | 200.309908 | FAIL | fell over
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
