fernandomierhicks/wheeled-leg-robot/components/characterization/Archive/odesk/AbsoluteEncoder.md

Ribbon cable absolute encoder pinout:

BLACK   GND
WHITE   5V or 3.3V
GREY    MISO
PURPLE  MOSI
BLUE    CLK
GREEN   CS

ODESK SPI connector pintout:
RED     3.3V
BLACK   CS
WHITE   SCK
BLUE    MISO
GREEN   MOSI
YELLOW  GND
