fernandomierhicks/wheeled-leg-robot/simulation/mujoco/archive/LQR_Control_optimization/results_5_VEL_PI_leg_cycling.csv

run_id | scenario | label | timestamp | Q_PITCH | Q_PITCH_RATE | Q_VEL | R | KP_V | KI_V | rms_pitch_deg | max_pitch_deg | wheel_travel_m | wheel_liftoff_s | vel_track_rms_ms | settle_time_s | survived_s | fitness_balance | fitness_disturbance | fitness_drive_slow | fitness_drive_med | fitness_obstacle | fitness | status | fail_reason
1 | 5_VEL_PI_leg_cycling | evo_seed | 2026-03-18 14:50:39 |  |  |  |  | 0.502932 | 0.012678 | 6.6849 | 16.9991 | 7.2958 | 1.054 | 0.4883 | 1.38 | 13.0 |  |  |  |  |  | 2.1334 | PASS
2 | 5_VEL_PI_leg_cycling | evo_g000000_c0 | 2026-03-18 14:50:41 |  |  |  |  | 0.389224 | 0.01 | 6.3147 | 17.0333 | 7.1999 | 0.944 | 0.5168 | 1.422 | 13.0 |  |  |  |  |  | 2.1819 | PASS
4 | 5_VEL_PI_leg_cycling | evo_g000000_c2 | 2026-03-18 14:50:41 |  |  |  |  | 1.440417 | 0.02335 | 9.617 | 17.2061 | 7.9588 | 1.11 | 0.7737 | 13.0 | 13.0 |  |  |  |  |  | 3.2828 | PASS
5 | 5_VEL_PI_leg_cycling | evo_g000000_c3 | 2026-03-18 14:50:41 |  |  |  |  | 0.147942 | 0.083623 | 6.3411 | 16.6682 | 8.3168 | 1.1 | 0.5868 | 0.592 | 13.0 |  |  |  |  |  | 2.3945 | PASS
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
