fernandomierhicks/wheeled-leg-robot/simulation/mujoco/archive/LQR_Control_optimization/results_archive_4_leg_height_gain_sched.csv

run_id | scenario | label | timestamp | Q_PITCH | Q_PITCH_RATE | Q_VEL | R | KP_V | KI_V | rms_pitch_deg | max_pitch_deg | wheel_travel_m | wheel_liftoff_s | vel_track_rms_ms | settle_time_s | survived_s | fitness_balance | fitness_disturbance | fitness_drive_slow | fitness_drive_med | fitness_obstacle | fitness | status | fail_reason
4861 | 4_leg_height_gain_sched |  | 2026-03-18 14:28:59 | 0.138282 | 0.023379 | 0.004591 | 9.998298 |  |  | 1.8714 | 3.6533 |  |  |  |  | 12.0 |  |  |  |  |  | 0.02558 | PASS
4862 | 4_leg_height_gain_sched |  | 2026-03-18 14:28:59 | 0.436737 | 0.02457 | 0.016647 | 0.514014 |  |  | 23.2952 | 51.462 |  |  |  |  | 0.152 |  |  |  |  |  | 200.665528 | FAIL | fell over
4863 | 4_leg_height_gain_sched |  | 2026-03-18 14:29:00 | 0.272281 | 0.052038 | 0.003486 | 0.190832 |  |  | 13.1607 | 55.7208 |  |  |  |  | 0.316 |  |  |  |  |  | 201.566947 | FAIL | fell over
4864 | 4_leg_height_gain_sched |  | 2026-03-18 14:29:00 | 0.034118 | 0.00438 | 0.000133 | 21.173286 |  |  | 1.2437 | 2.1303 |  |  |  |  | 12.0 |  |  |  |  |  | 0.017997 | PASS
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
