fernandomierhicks/wheeled-leg-robot/simulation/mujoco/archive/LQR_Control_optimization/results_combined_PI.csv

run_id | scenario | label | timestamp | Q_PITCH | Q_PITCH_RATE | Q_VEL | R | KP_V | KI_V | rms_pitch_deg | max_pitch_deg | wheel_travel_m | wheel_liftoff_s | vel_track_rms_ms | settle_time_s | survived_s | fitness_balance | fitness_disturbance | fitness_drive_slow | fitness_drive_med | fitness_obstacle | fitness | status | fail_reason
1 | combined_PI | evo_seed | 2026-03-18 13:45:52 |  |  |  |  | 0.502932 | 0.012678 |  |  |  |  |  |  | 12.0 |  |  |  |  |  | 1.06 | PASS
5 | combined_PI | evo_g000000_c3 | 2026-03-18 13:45:55 |  |  |  |  | 0.246906 | 0.01 |  |  |  |  |  |  | 12.0 |  |  |  |  |  | 1.1206 | PASS
4 | combined_PI | evo_g000000_c2 | 2026-03-18 13:45:55 |  |  |  |  | 0.168118 | 0.020422 |  |  |  |  |  |  | 12.0 |  |  |  |  |  | 1.1518 | PASS
6 | combined_PI | evo_g000000_c4 | 2026-03-18 13:45:56 |  |  |  |  | 0.243248 | 0.02769 |  |  |  |  |  |  | 12.0 |  |  |  |  |  | 1.0924 | PASS
3 | combined_PI | evo_g000000_c1 | 2026-03-18 13:45:56 |  |  |  |  | 0.575168 | 0.023783 |  |  |  |  |  |  | 12.0 |  |  |  |  |  | 1.0649 | PASS
2 | combined_PI | evo_g000000_c0 | 2026-03-18 13:45:56 |  |  |  |  | 0.126469 | 0.059231 |  |  |  |  |  |  | 12.0 |  |  |  |  |  | 1.1421 | PASS
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
