fernandomierhicks/wheeled-leg-robot/simulation/mujoco/archive/LQR_Control_optimization/results_suspension_combined.csv

run_id | scenario | label | timestamp | Q_PITCH | Q_PITCH_RATE | Q_VEL | R | KP_V | KI_V | rms_pitch_deg | max_pitch_deg | wheel_travel_m | wheel_liftoff_s | vel_track_rms_ms | settle_time_s | survived_s | fitness_balance | fitness_disturbance | fitness_drive_slow | fitness_drive_med | fitness_obstacle | fitness | status | fail_reason
1 | suspension_combined | evo_seed | 2026-03-18 17:27:57 |  |  |  |  |  |  |  |  |  |  |  |  |  |  |  |  |  |  | 5000.5419 | FAIL
2 | suspension_combined | evo_g000000_c0 | 2026-03-18 17:27:58 |  |  |  |  |  |  |  |  |  |  |  |  |  |  |  |  |  |  | 5000.541 | FAIL
4 | suspension_combined | evo_g000000_c2 | 2026-03-18 17:27:58 |  |  |  |  |  |  |  |  |  |  |  |  |  |  |  |  |  |  | 5000.5409 | FAIL
3 | suspension_combined | evo_g000000_c1 | 2026-03-18 17:27:58 |  |  |  |  |  |  |  |  |  |  |  |  |  |  |  |  |  |  | 5000.5258 | FAIL
7 | suspension_combined | evo_g000000_c5 | 2026-03-18 17:27:58 |  |  |  |  |  |  |  |  |  |  |  |  |  |  |  |  |  |  | 5000.5702 | FAIL
8 | suspension_combined | evo_g000000_c6 | 2026-03-18 17:27:58 |  |  |  |  |  |  |  |  |  |  |  |  |  |  |  |  |  |  | 5000.5037 | FAIL
5 | suspension_combined | evo_g000000_c3 | 2026-03-18 17:27:58 |  |  |  |  |  |  |  |  |  |  |  |  |  |  |  |  |  |  | 5000.5566 | FAIL
6 | suspension_combined | evo_g000000_c4 | 2026-03-18 17:27:58 |  |  |  |  |  |  |  |  |  |  |  |  |  |  |  |  |  |  | 5000.5552 | FAIL
9 | suspension_combined | evo_g000000_c7 | 2026-03-18 17:27:58 |  |  |  |  |  |  |  |  |  |  |  |  |  |  |  |  |  |  | 5000.5466 | FAIL
16 | suspension_combined | evo_g000001_c6 | 2026-03-18 17:27:59 |  |  |  |  |  |  |  |  |  |  |  |  |  |  |  |  |  |  | 5000.5418 | FAIL
13 | suspension_combined | evo_g000001_c3 | 2026-03-18 17:27:59 |  |  |  |  |  |  |  |  |  |  |  |  |  |  |  |  |  |  | 5000.5375 | FAIL
15 | suspension_combined | evo_g000001_c5 | 2026-03-18 17:27:59 |  |  |  |  |  |  |  |  |  |  |  |  |  |  |  |  |  |  | 5000.5461 | FAIL
10 | suspension_combined | evo_g000001_c0 | 2026-03-18 17:27:59 |  |  |  |  |  |  |  |  |  |  |  |  |  |  |  |  |  |  | 5000.5172 | FAIL
14 | suspension_combined | evo_g000001_c4 | 2026-03-18 17:27:59 |  |  |  |  |  |  |  |  |  |  |  |  |  |  |  |  |  |  | 5000.535 | FAIL
12 | suspension_combined | evo_g000001_c2 | 2026-03-18 17:27:59 |  |  |  |  |  |  |  |  |  |  |  |  |  |  |  |  |  |  | 5000.54 | FAIL
11 | suspension_combined | evo_g000001_c1 | 2026-03-18 17:27:59 |  |  |  |  |  |  |  |  |  |  |  |  |  |  |  |  |  |  | 5000.5495 | FAIL
17 | suspension_combined | evo_g000001_c7 | 2026-03-18 17:27:59 |  |  |  |  |  |  |  |  |  |  |  |  |  |  |  |  |  |  | 5000.5419 | FAIL
20 | suspension_combined | evo_g000002_c2 | 2026-03-18 17:28:00 |  |  |  |  |  |  |  |  |  |  |  |  |  |  |  |  |  |  | 5000.5469 | FAIL
24 | suspension_combined | evo_g000002_c6 | 2026-03-18 17:28:00 |  |  |  |  |  |  |  |  |  |  |  |  |  |  |  |  |  |  | 5000.5469 | FAIL
19 | suspension_combined | evo_g000002_c1 | 2026-03-18 17:28:00 |  |  |  |  |  |  |  |  |  |  |  |  |  |  |  |  |  |  | 5000.5504 | FAIL
23 | suspension_combined | evo_g000002_c5 | 2026-03-18 17:28:00 |  |  |  |  |  |  |  |  |  |  |  |  |  |  |  |  |  |  | 5000.5426 | FAIL
22 | suspension_combined | evo_g000002_c4 | 2026-03-18 17:28:00 |  |  |  |  |  |  |  |  |  |  |  |  |  |  |  |  |  |  | 5000.5246 | FAIL
18 | suspension_combined | evo_g000002_c0 | 2026-03-18 17:28:00 |  |  |  |  |  |  |  |  |  |  |  |  |  |  |  |  |  |  | 5000.5314 | FAIL
21 | suspension_combined | evo_g000002_c3 | 2026-03-18 17:28:00 |  |  |  |  |  |  |  |  |  |  |  |  |  |  |  |  |  |  | 5000.5741 | FAIL
25 | suspension_combined | evo_g000002_c7 | 2026-03-18 17:28:00 |  |  |  |  |  |  |  |  |  |  |  |  |  |  |  |  |  |  | 5000.5198 | FAIL
32 | suspension_combined | evo_g000003_c6 | 2026-03-18 17:28:01 |  |  |  |  |  |  |  |  |  |  |  |  |  |  |  |  |  |  | 5000.5382 | FAIL
29 | suspension_combined | evo_g000003_c3 | 2026-03-18 17:28:01 |  |  |  |  |  |  |  |  |  |  |  |  |  |  |  |  |  |  | 5000.5401 | FAIL
28 | suspension_combined | evo_g000003_c2 | 2026-03-18 17:28:01 |  |  |  |  |  |  |  |  |  |  |  |  |  |  |  |  |  |  | 5000.5495 | FAIL
31 | suspension_combined | evo_g000003_c5 | 2026-03-18 17:28:01 |  |  |  |  |  |  |  |  |  |  |  |  |  |  |  |  |  |  | 5000.5534 | FAIL
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
459 | suspension_combined | evo_g000057_c1 | 2026-03-18 17:28:48 |  |  |  |  |  |  |  |  |  |  |  |  |  |  |  |  |  |  | 5000.5733 | FAIL
463 | suspension_combined | evo_g000057_c5 | 2026-03-18 17:28:48 |  |  |  |  |  |  |  |  |  |  |  |  |  |  |  |  |  |  | 5000.5498 | FAIL
458 | suspension_combined | evo_g000057_c0 | 2026-03-18 17:28:48 |  |  |  |  |  |  |  |  |  |  |  |  |  |  |  |  |  |  | 5000.5453 | FAIL
461 | suspension_combined | evo_g000057_c3 | 2026-03-18 17:28:48 |  |  |  |  |  |  |  |  |  |  |  |  |  |  |  |  |  |  | 5000.5434 | FAIL
465 | suspension_combined | evo_g000057_c7 | 2026-03-18 17:28:48 |  |  |  |  |  |  |  |  |  |  |  |  |  |  |  |  |  |  | 5000.5432 | FAIL
464 | suspension_combined | evo_g000057_c6 | 2026-03-18 17:28:48 |  |  |  |  |  |  |  |  |  |  |  |  |  |  |  |  |  |  | 5000.5514 | FAIL
460 | suspension_combined | evo_g000057_c2 | 2026-03-18 17:28:48 |  |  |  |  |  |  |  |  |  |  |  |  |  |  |  |  |  |  | 5000.5575 | FAIL
466 | suspension_combined | evo_g000058_c0 | 2026-03-18 17:28:49 |  |  |  |  |  |  |  |  |  |  |  |  |  |  |  |  |  |  | 5000.5435 | FAIL
472 | suspension_combined | evo_g000058_c6 | 2026-03-18 17:28:49 |  |  |  |  |  |  |  |  |  |  |  |  |  |  |  |  |  |  | 5000.5496 | FAIL
473 | suspension_combined | evo_g000058_c7 | 2026-03-18 17:28:49 |  |  |  |  |  |  |  |  |  |  |  |  |  |  |  |  |  |  | 5000.5655 | FAIL
469 | suspension_combined | evo_g000058_c3 | 2026-03-18 17:28:49 |  |  |  |  |  |  |  |  |  |  |  |  |  |  |  |  |  |  | 5000.5405 | FAIL
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
