fernandomierhicks/wheeled-leg-robot/components/characterization/akMars/Presets/Factory settings/After RL and Lambda calibration.png

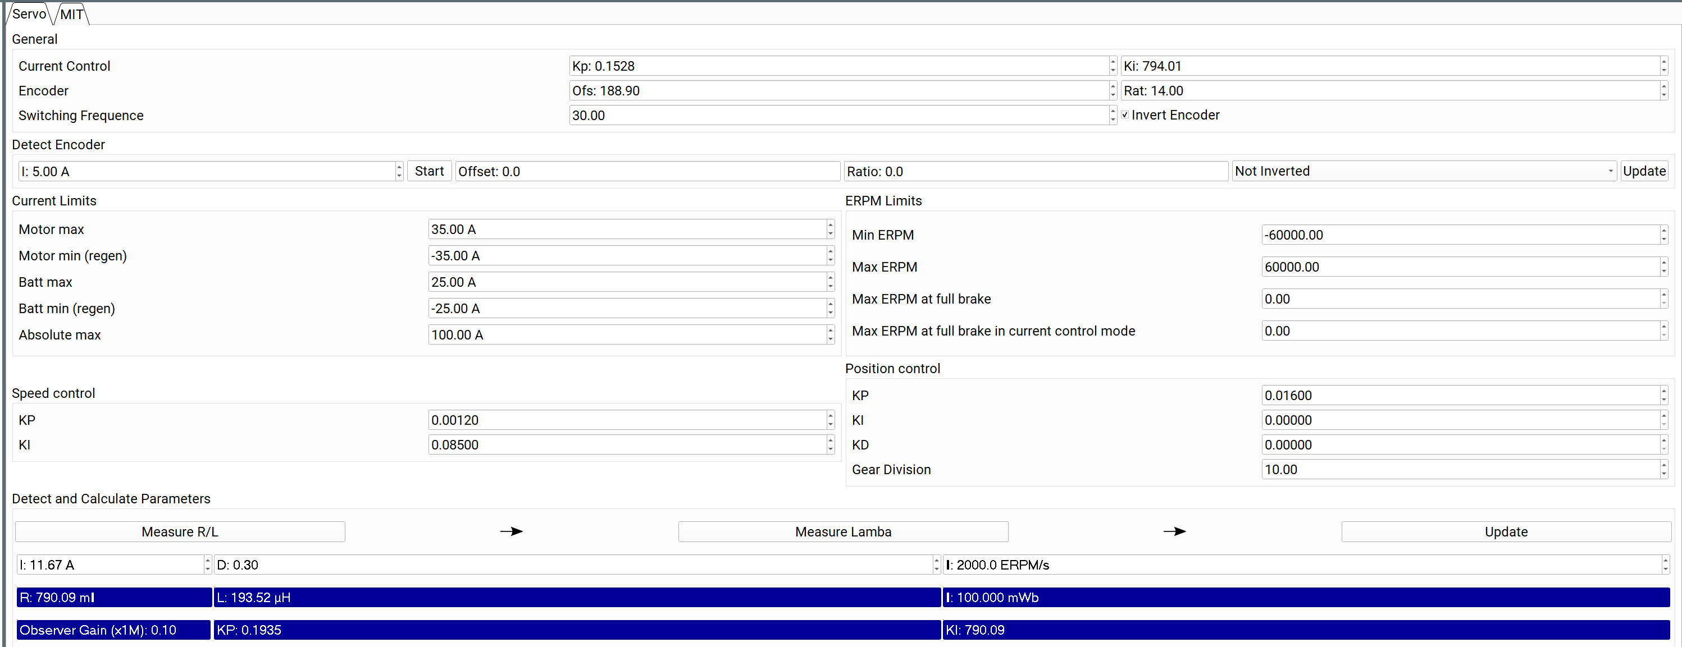
components/characterization/akMars/Presets/Factory settings/After RL and Lambda calibration.png
