fernandomierhicks/wheeled-leg-robot/components/characterization/akMars/Presets/Factory settings/Screenshot 2026-05-01 224914.png

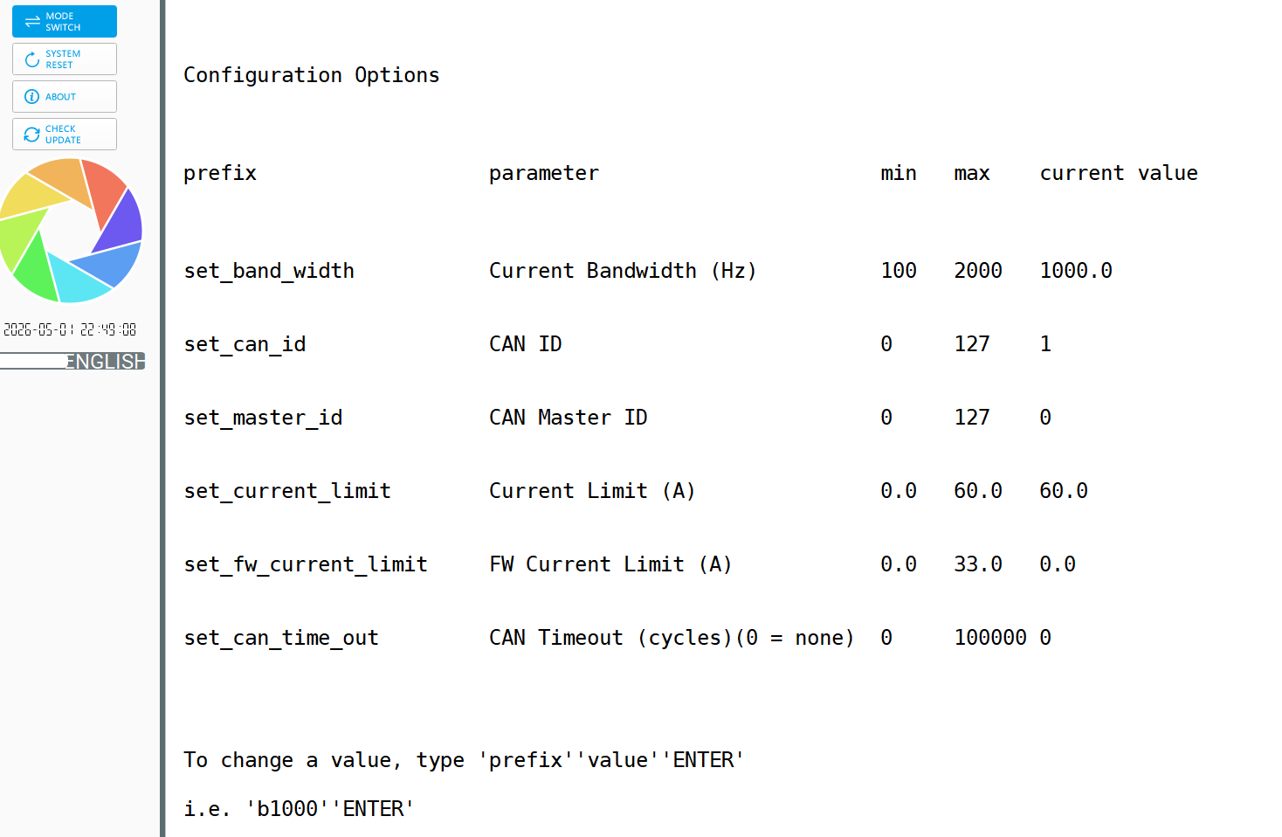
components/characterization/akMars/Presets/Factory settings/Screenshot 2026-05-01 224914.png
