fernandomierhicks/wheeled-leg-robot/components/characterization/IMU_Sparkfun/logs/drift_timeseries.png

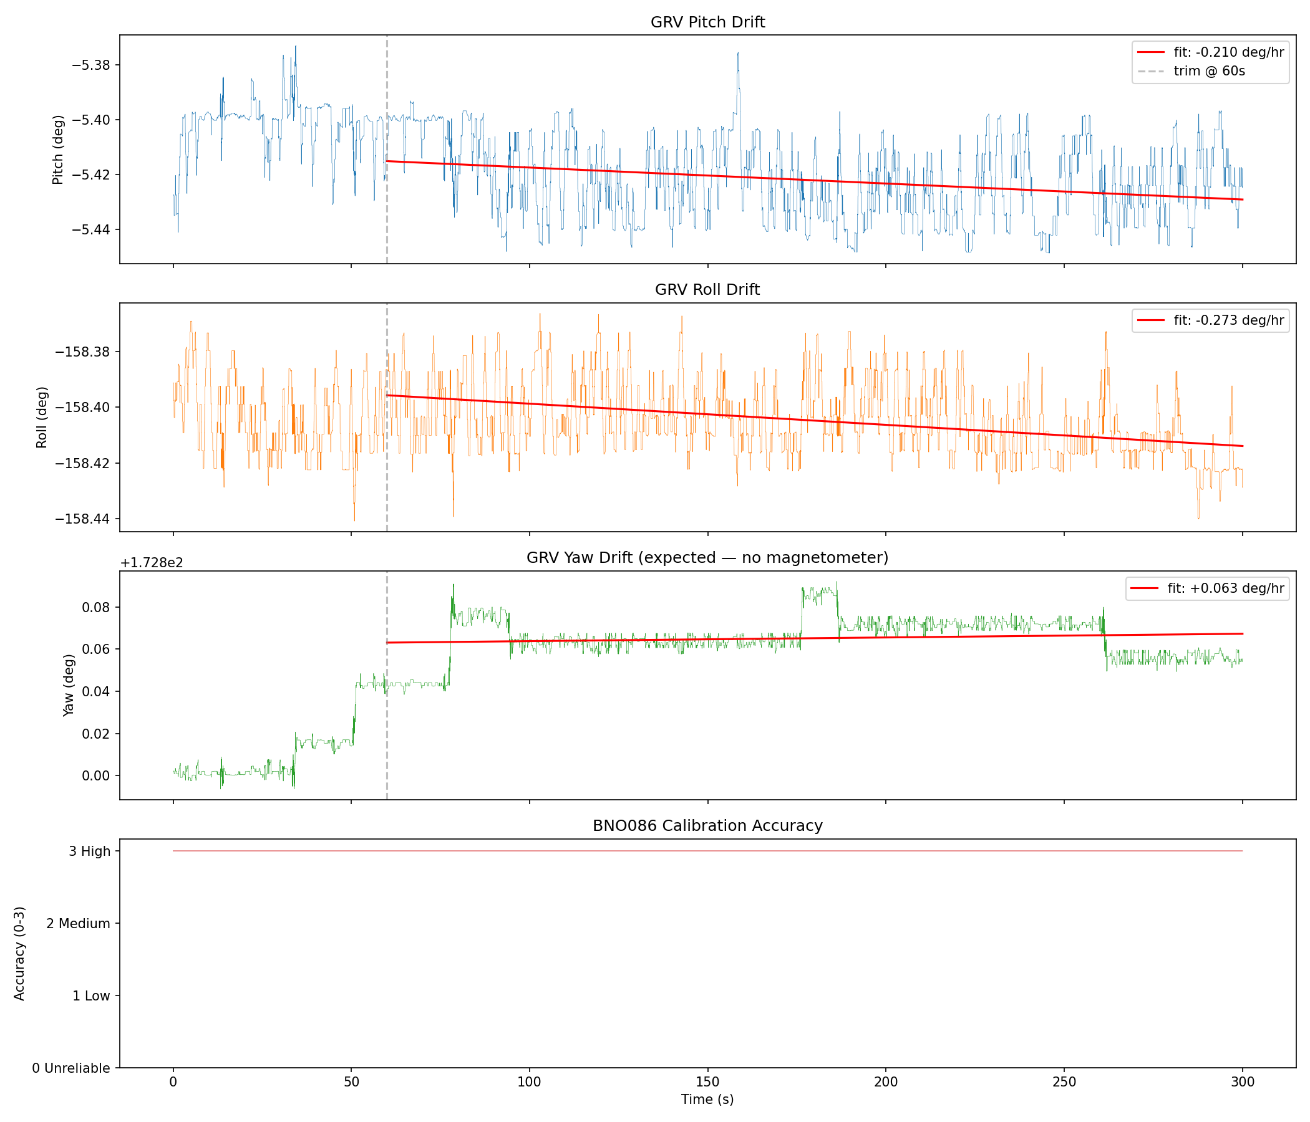
components/characterization/IMU_Sparkfun/logs/drift_timeseries.png
