fernandomierhicks/wheeled-leg-robot/components/characterization/IMU_Sparkfun/logs/noise_accel_allan.png

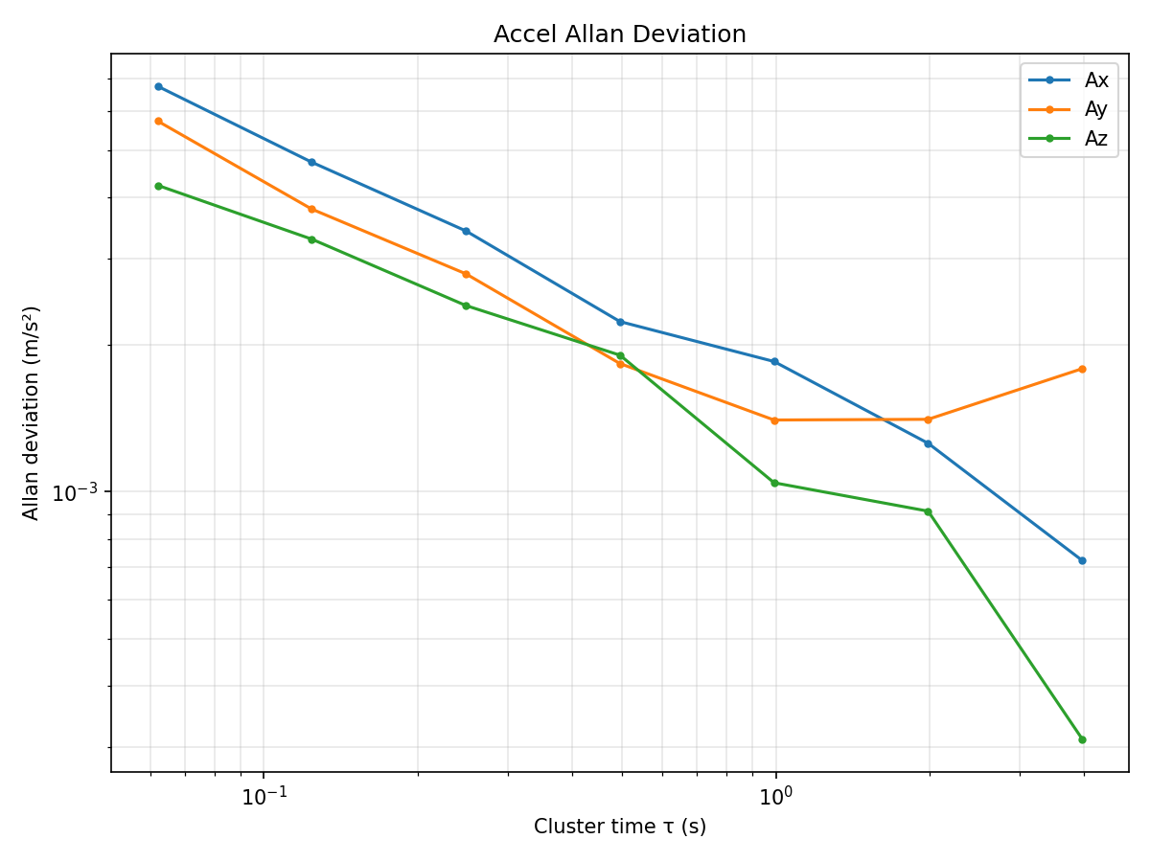
components/characterization/IMU_Sparkfun/logs/noise_accel_allan.png
