fernandomierhicks/wheeled-leg-robot/components/characterization/IMU_Sparkfun/logs/noise_accel_psd.png

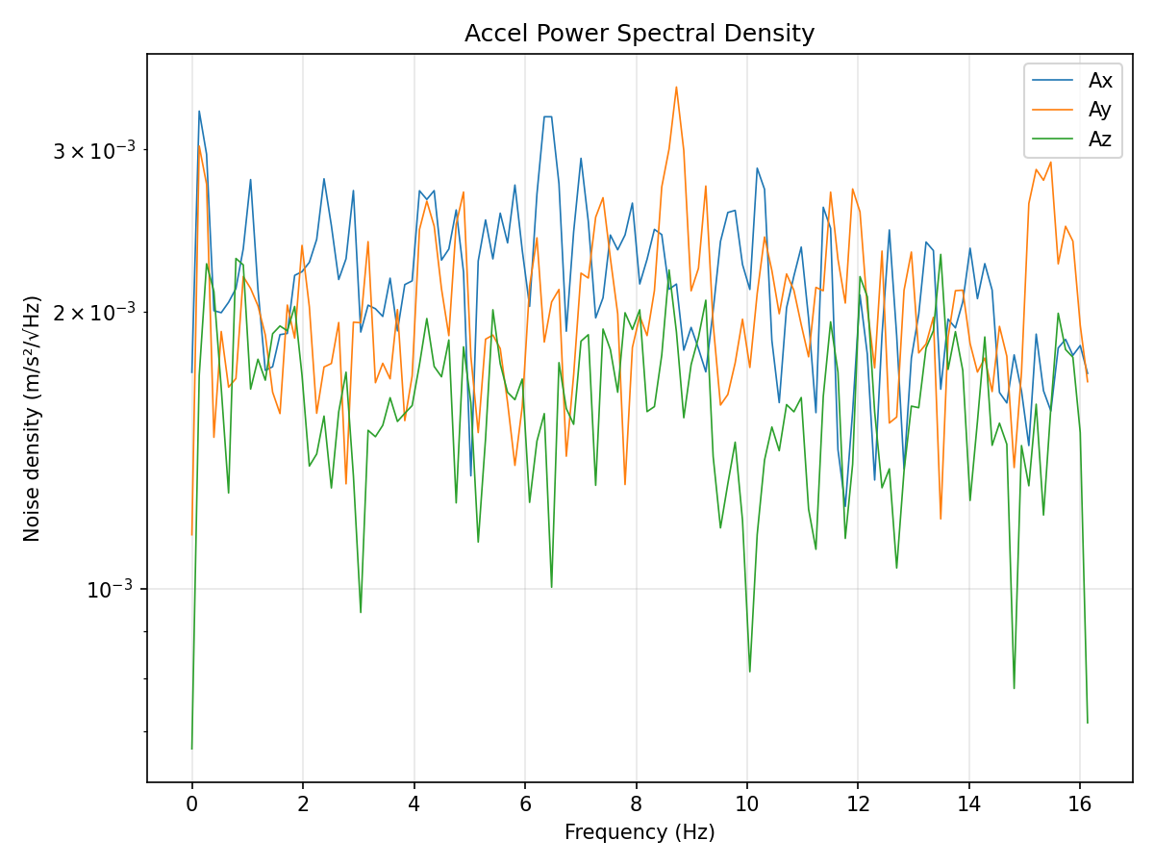
components/characterization/IMU_Sparkfun/logs/noise_accel_psd.png
