fernandomierhicks/wheeled-leg-robot/components/characterization/IMU_Sparkfun/logs/noise_allan_deviation.png

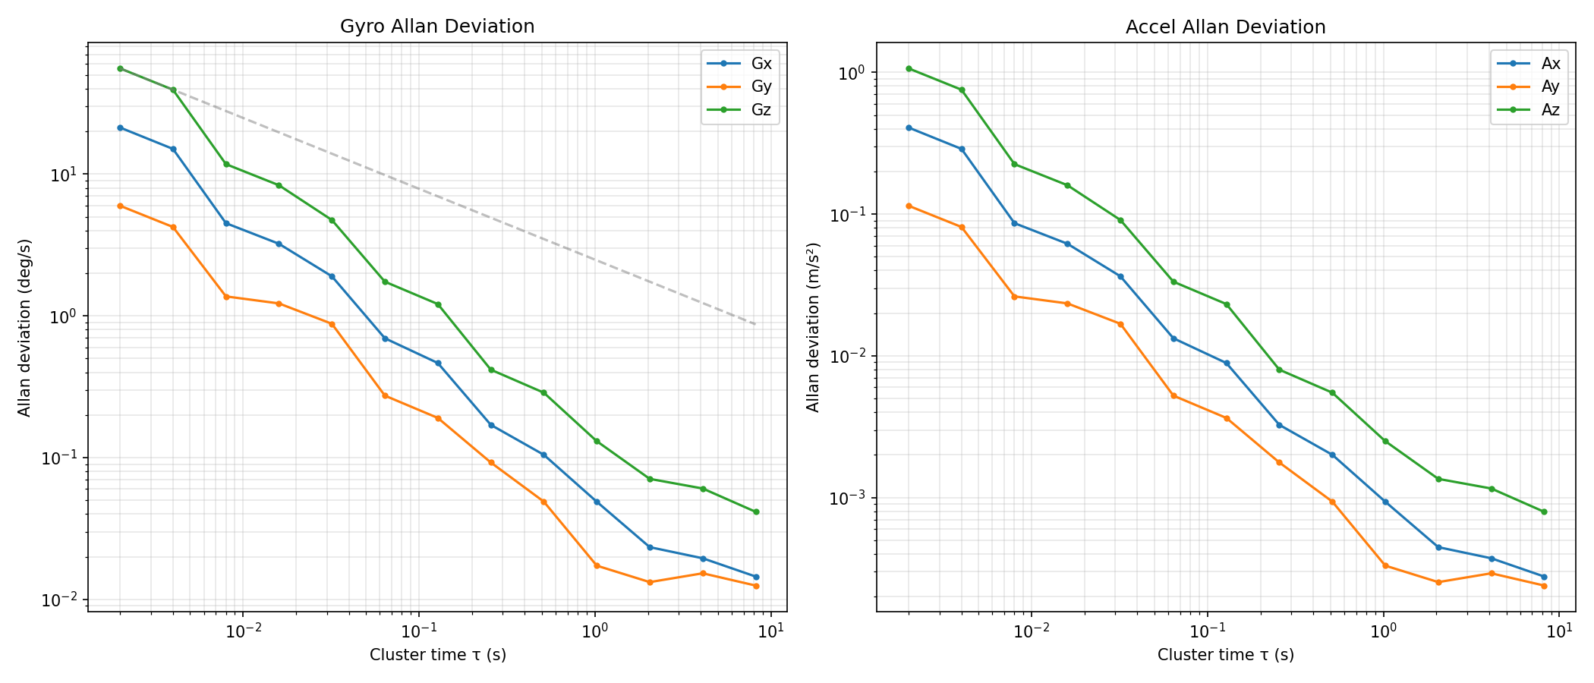
components/characterization/IMU_Sparkfun/logs/noise_allan_deviation.png
