fernandomierhicks/wheeled-leg-robot/components/characterization/IMU_Sparkfun/logs/noise_gyro_allan.png

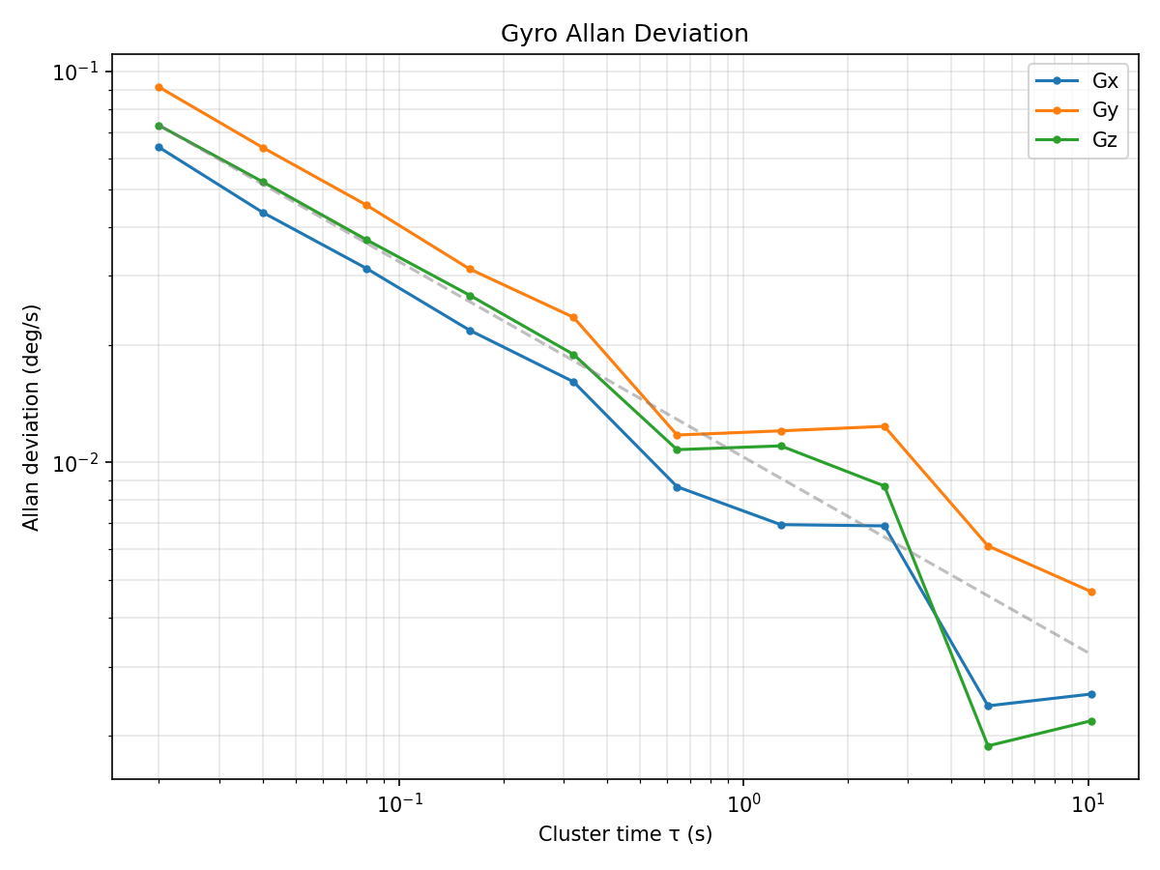
components/characterization/IMU_Sparkfun/logs/noise_gyro_allan.png
