fernandomierhicks/wheeled-leg-robot/components/characterization/IMU_Sparkfun/logs/noise_gyro_psd.png

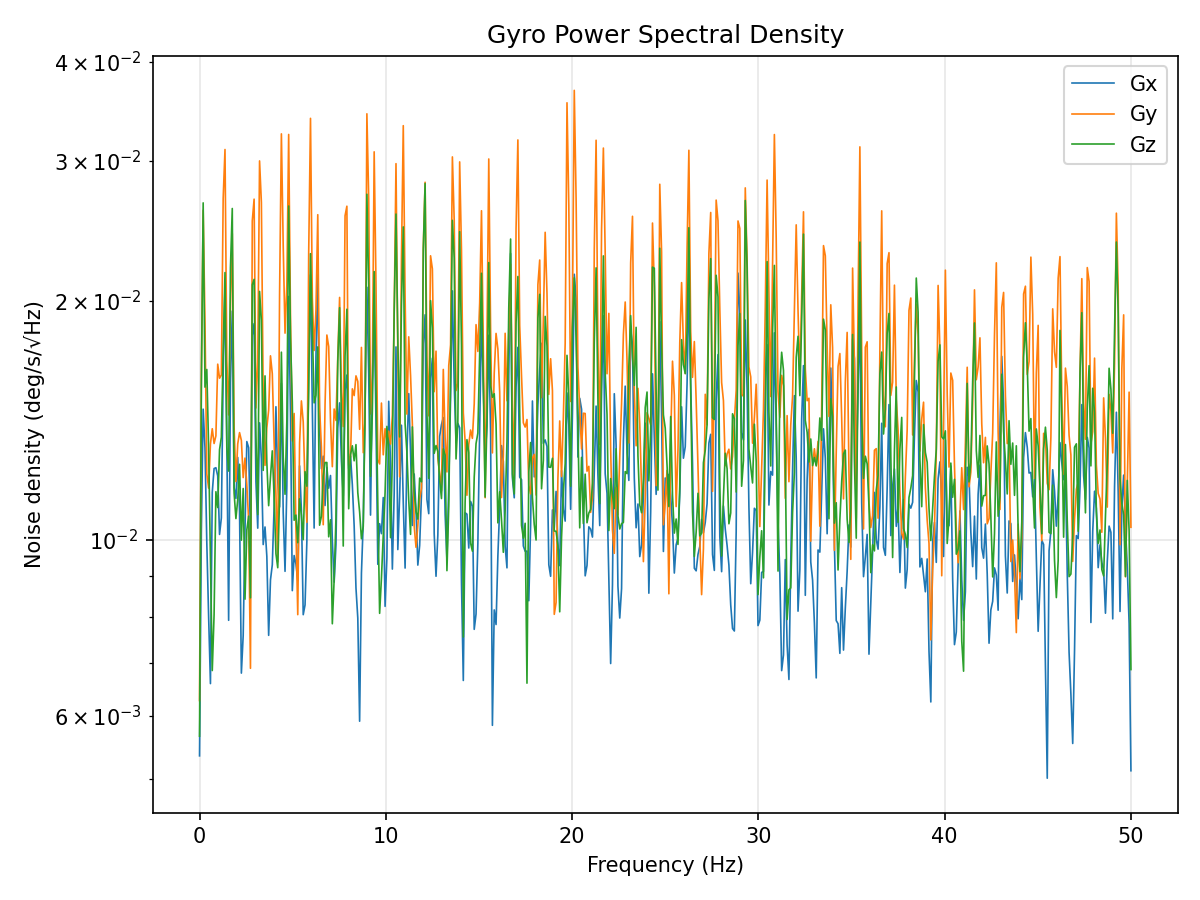
components/characterization/IMU_Sparkfun/logs/noise_gyro_psd.png
