fernandomierhicks/wheeled-leg-robot/components/characterization/IMU_Sparkfun/logs/noise_gyro_timeseries.png

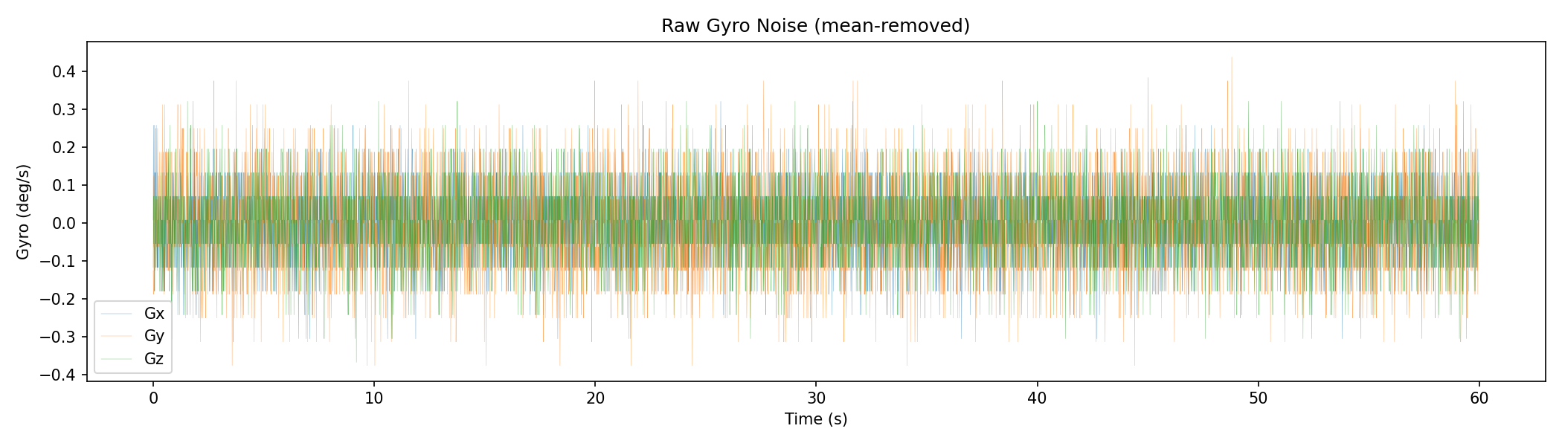
components/characterization/IMU_Sparkfun/logs/noise_gyro_timeseries.png
