fernandomierhicks/wheeled-leg-robot/components/characterization/motor/ak45_dyno_results.png

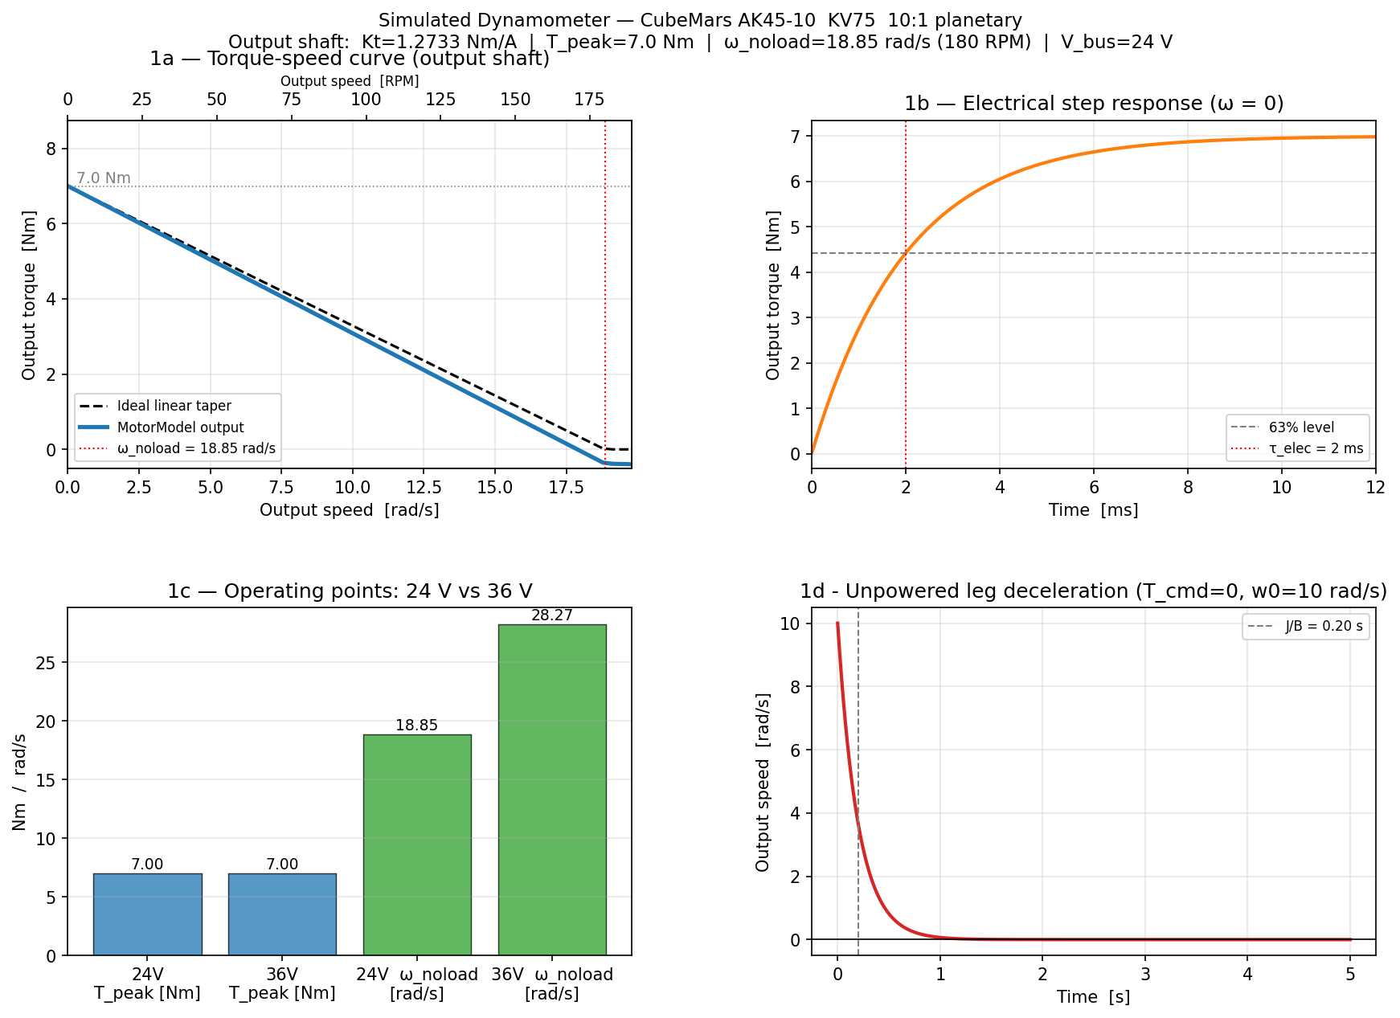
components/characterization/motor/ak45_dyno_results.png
