fernandomierhicks/wheeled-leg-robot/components/characterization/motor/ak45_motor_curve.png

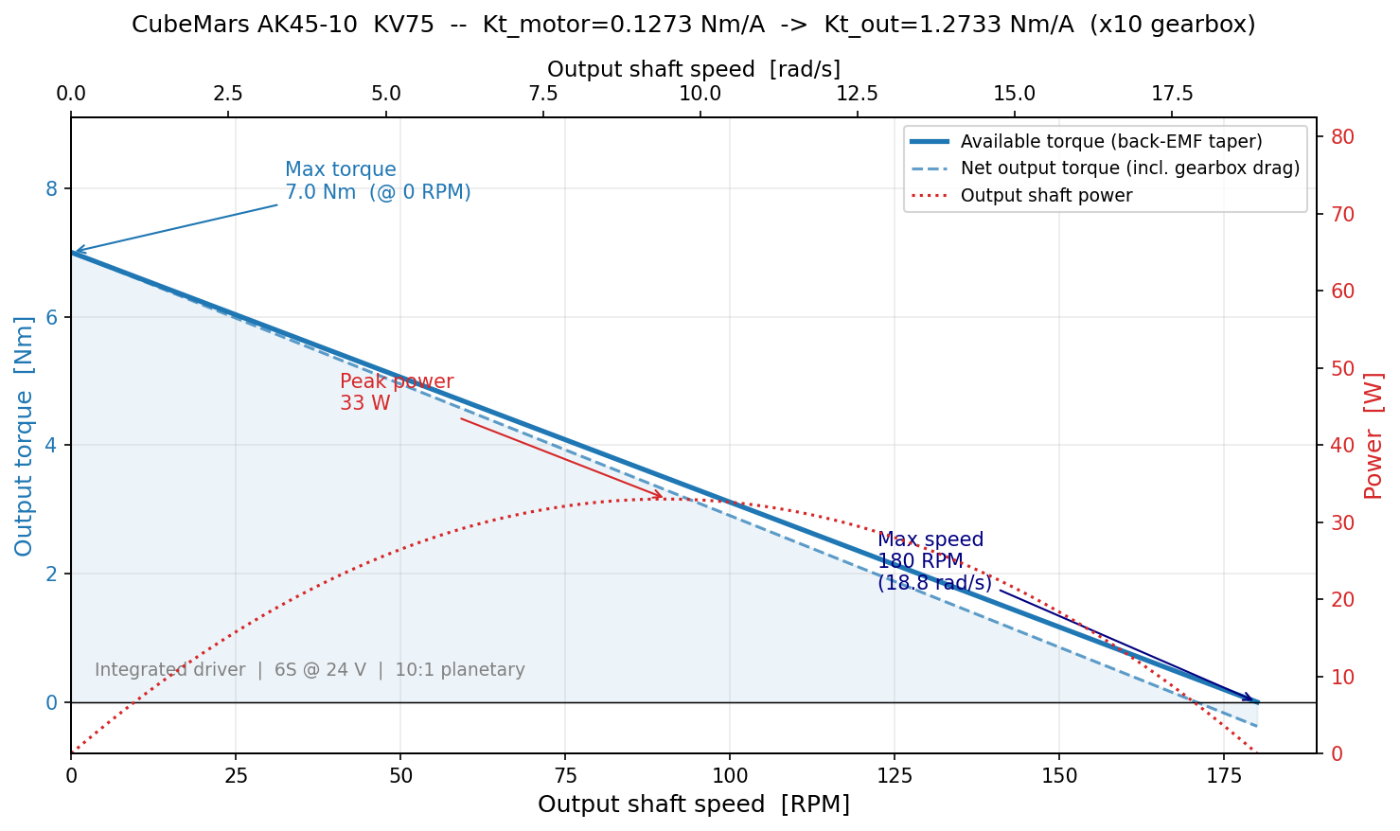
components/characterization/motor/ak45_motor_curve.png
