fernandomierhicks/wheeled-leg-robot/components/characterization/motor/motor_curve.png

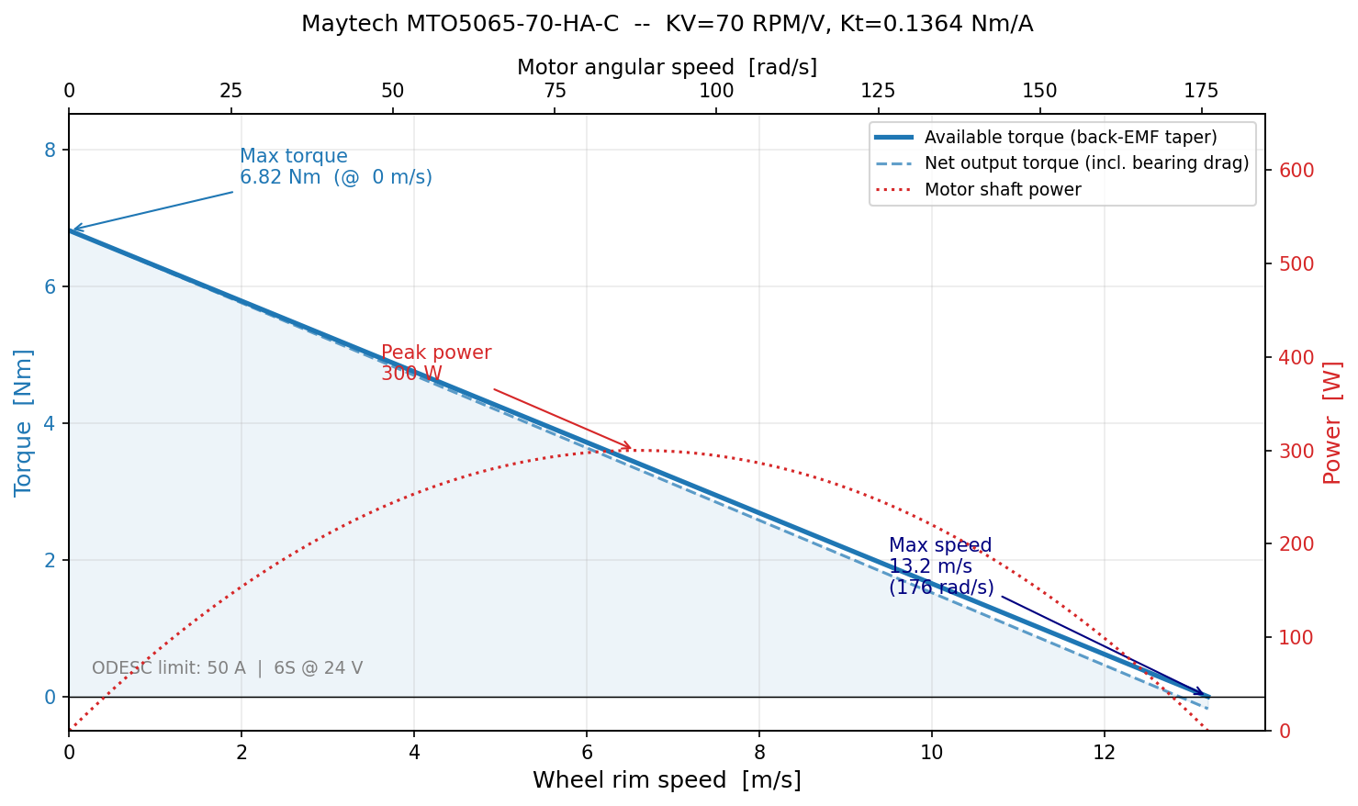
components/characterization/motor/motor_curve.png
