fernandomierhicks/wheeled-leg-robot/components/characterization/motor/motor_dyno_results.png

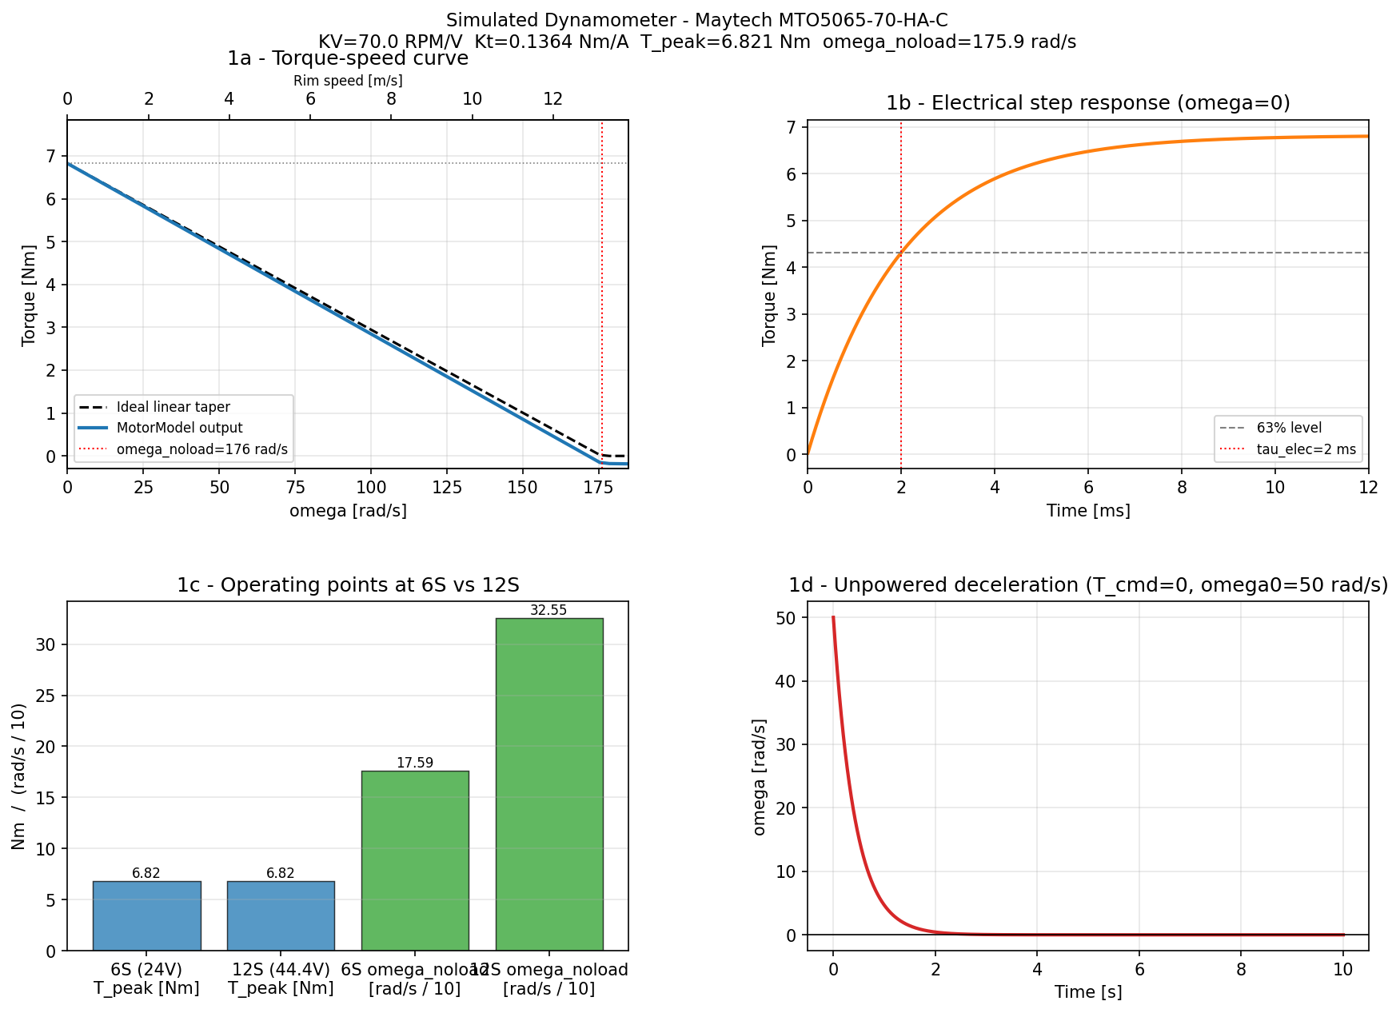
components/characterization/motor/motor_dyno_results.png
