fernandomierhicks/wheeled-leg-robot/TODO.txt

---Fernandos note dont change below

----------------------------------------------------------CAD

-How to allow human to edit parts?
-Hole for USB on right side panel. 
-No flat colors, any line or thing of different color has a different height, even if minimal.
-Make blue accents round so they shine better?
-Optimize color intrusions for less waste? color is only 2 layers or so deep? eveything else is white. 
-find easier way for AI to work with SW so I can save 
-whenever you save generate .3mf or print ready files? show me where scripts are....

------------------------------firmware
-reduce speed limit on profile3, hitting traction wheel limitation. 

---------------------------------------------------------SIMULATION
TYPO on mechanical dimensions. Revisit for highest jump???

-retune robot with AK45 as wheel motor?

-Flip?
Want me to build this as a new scenario (S11)? The sequence would be:
Settle + drive forward at max speed for ~1.5s
Brake hard (or just jump without braking — the hip extension alone might be enough)
Jump
Retract legs immediately after liftoff
Land (somehow...)

-----------------------------------------------------------CUBEMARS
LEG MOTOR
-Add CAN interface Via arduino

---------------------------------------------------------ODRIVE

-implement the potential odrive firmware improvements in components\characterization\odrive\forkedFirmware
Do 30min anticogging run or longer for both motors
-Fix encoder parity issue in README.MD

--MOtor
-Spinout detection
-Hard bus current limits
-Leak current limit 
-Live Power Monitoring Torque estimation

--CAN into ODRIVE to check latencies.
