fernandomierhicks/wheeled-leg-robot/components/2N_10mm_279mm.pdf

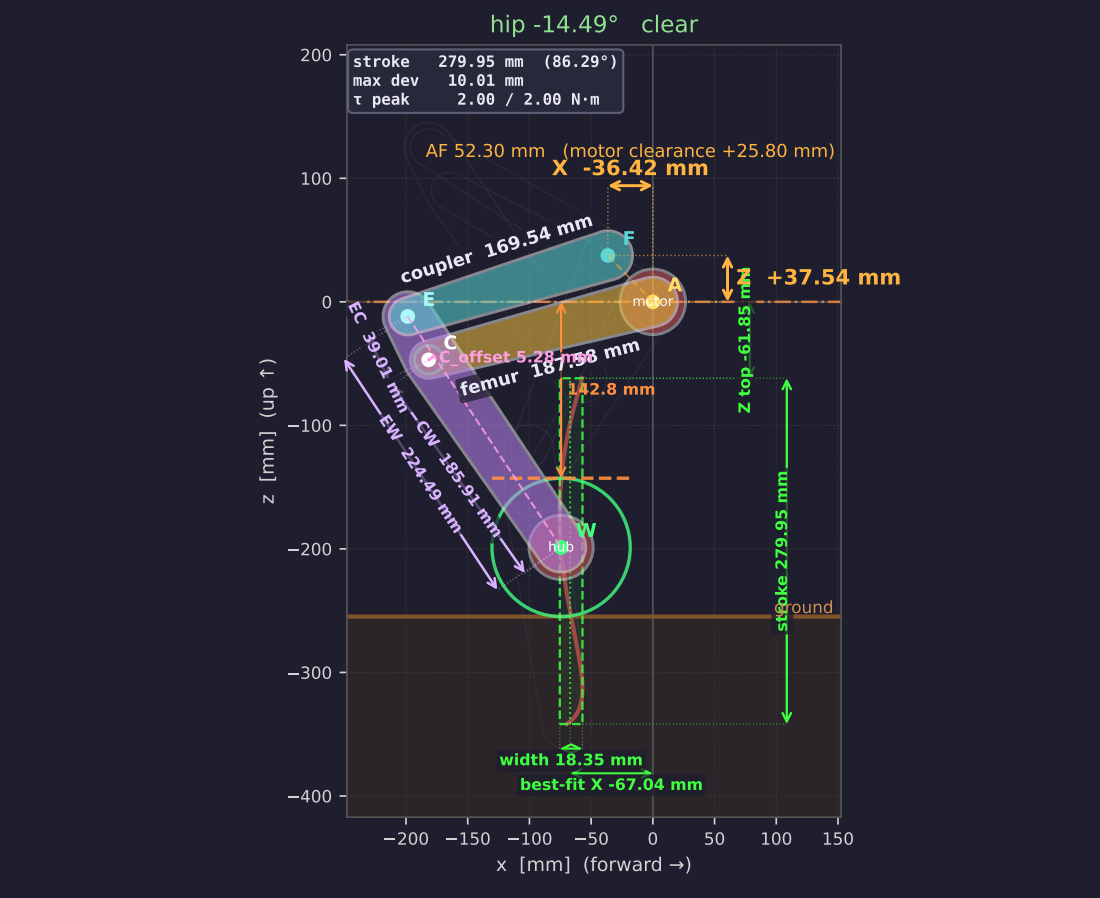
[picture p394: page 1]
x [mm] (forward ); hip -14.49° clear; Z top -61.85 mm; stroke 279.95 mm; width 18.35 mm; best-fit; femur 187.58 mm; coupler 169.54 mm

stroke max dev peak | 279.95 mm 10.01 mm 2.00 / 2.00 N·m AF 52.30 mm (motor clearance | (86.29°) X -36.42 mm | | | +25.80 mm)

E | | | motor | A

C C_offset 5.28 mm

hub | W

ground
