fernandomierhicks/wheeled-leg-robot/pcb/wlr_mainboard.kicad_pcb

## KiCad design pcb/wlr_mainboard.kicad_pcb (2026-10-08)

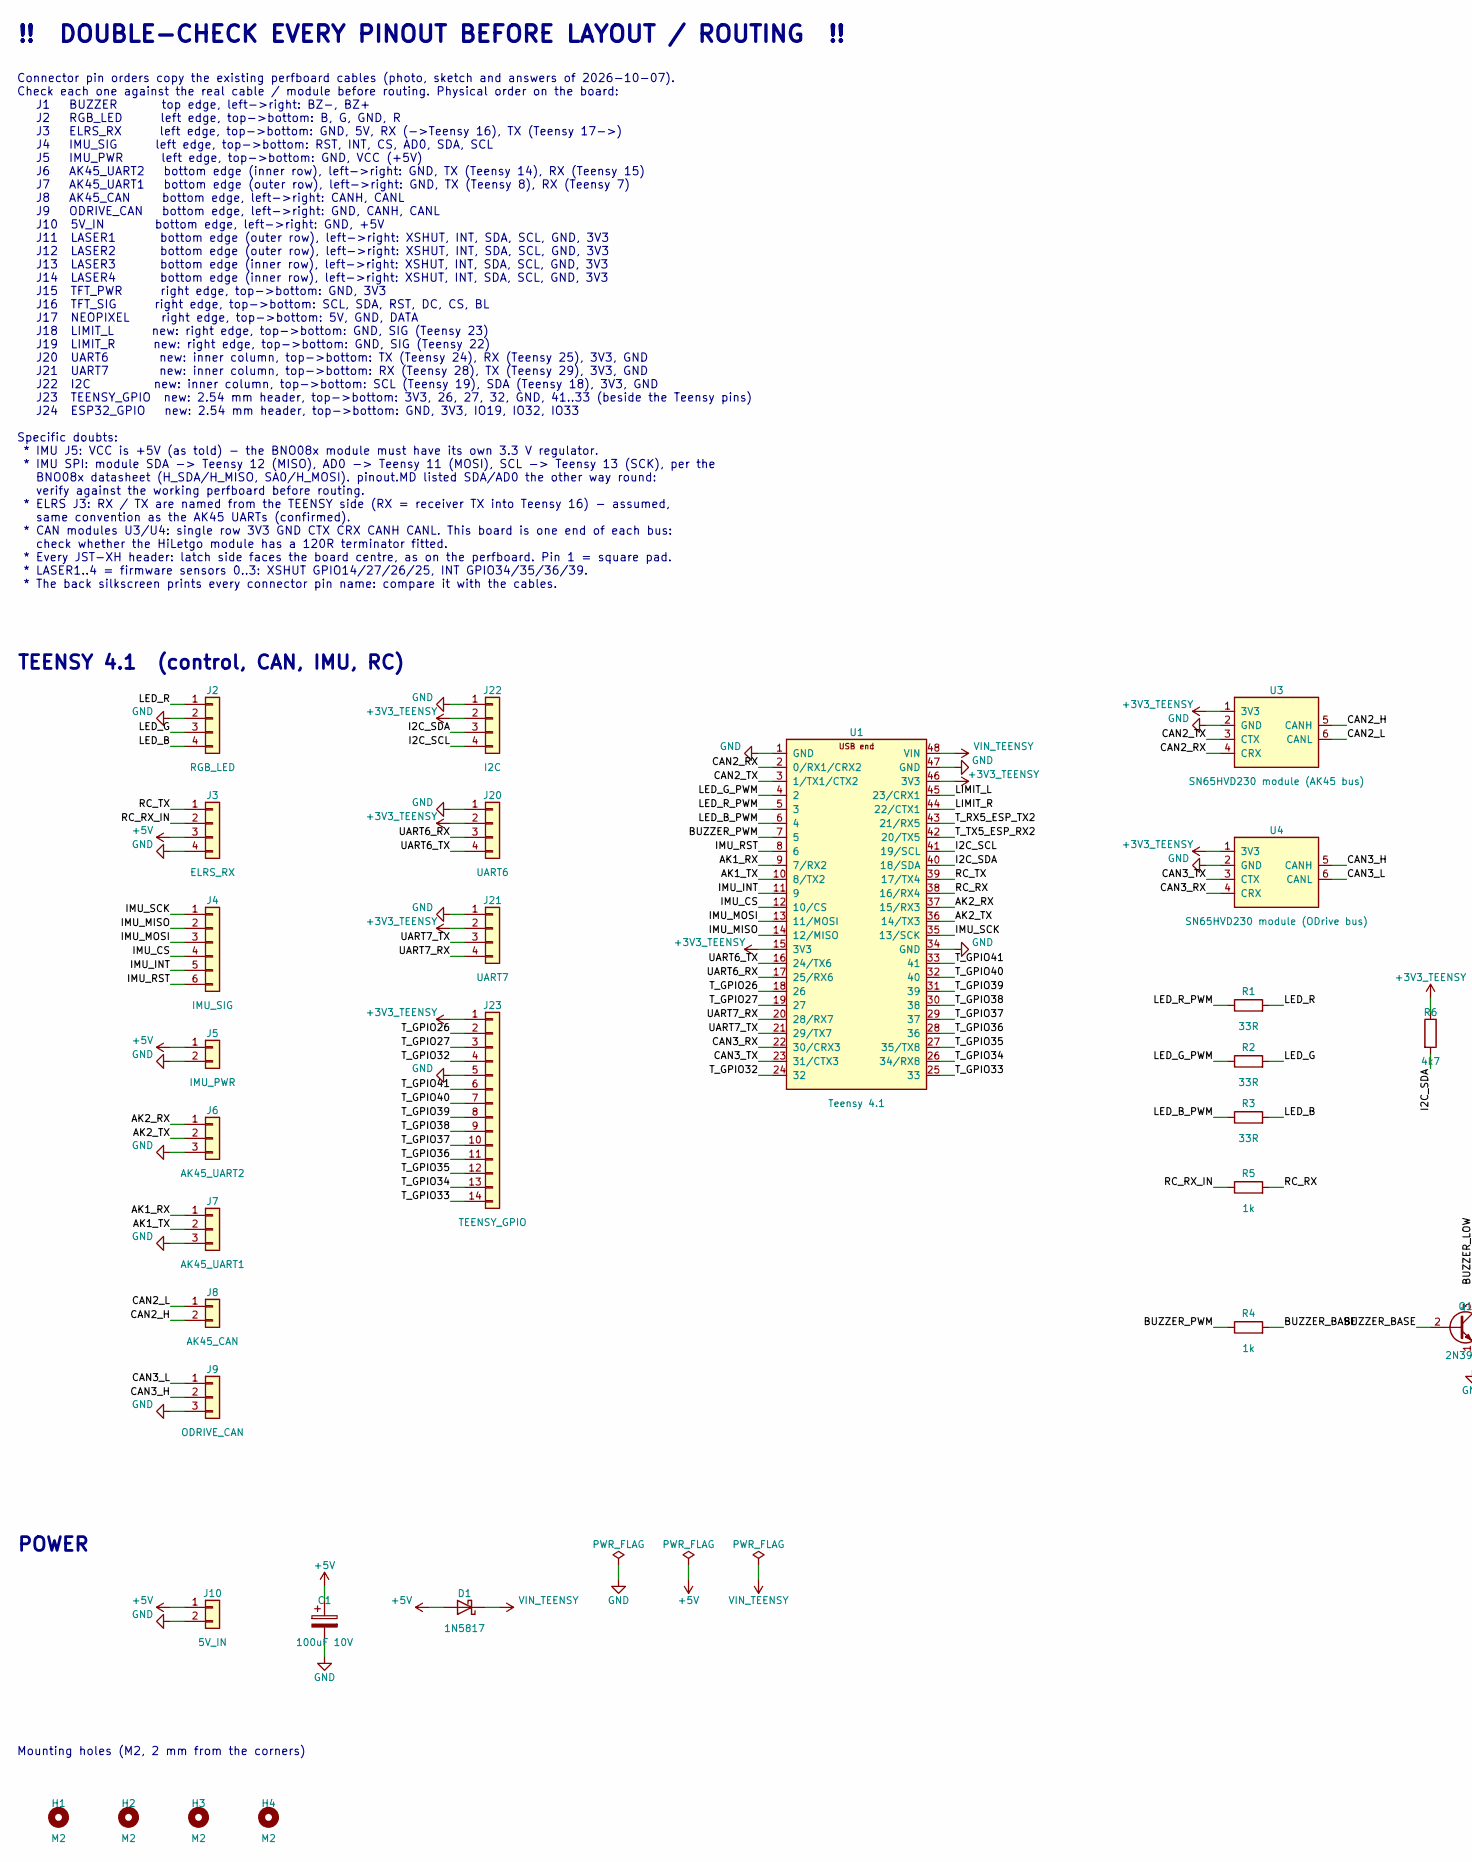
[picture p395: schematic wlr_mainboard.kicad_sch, Wheeled-Leg Robot - Main Board, part in row 1, column 1]

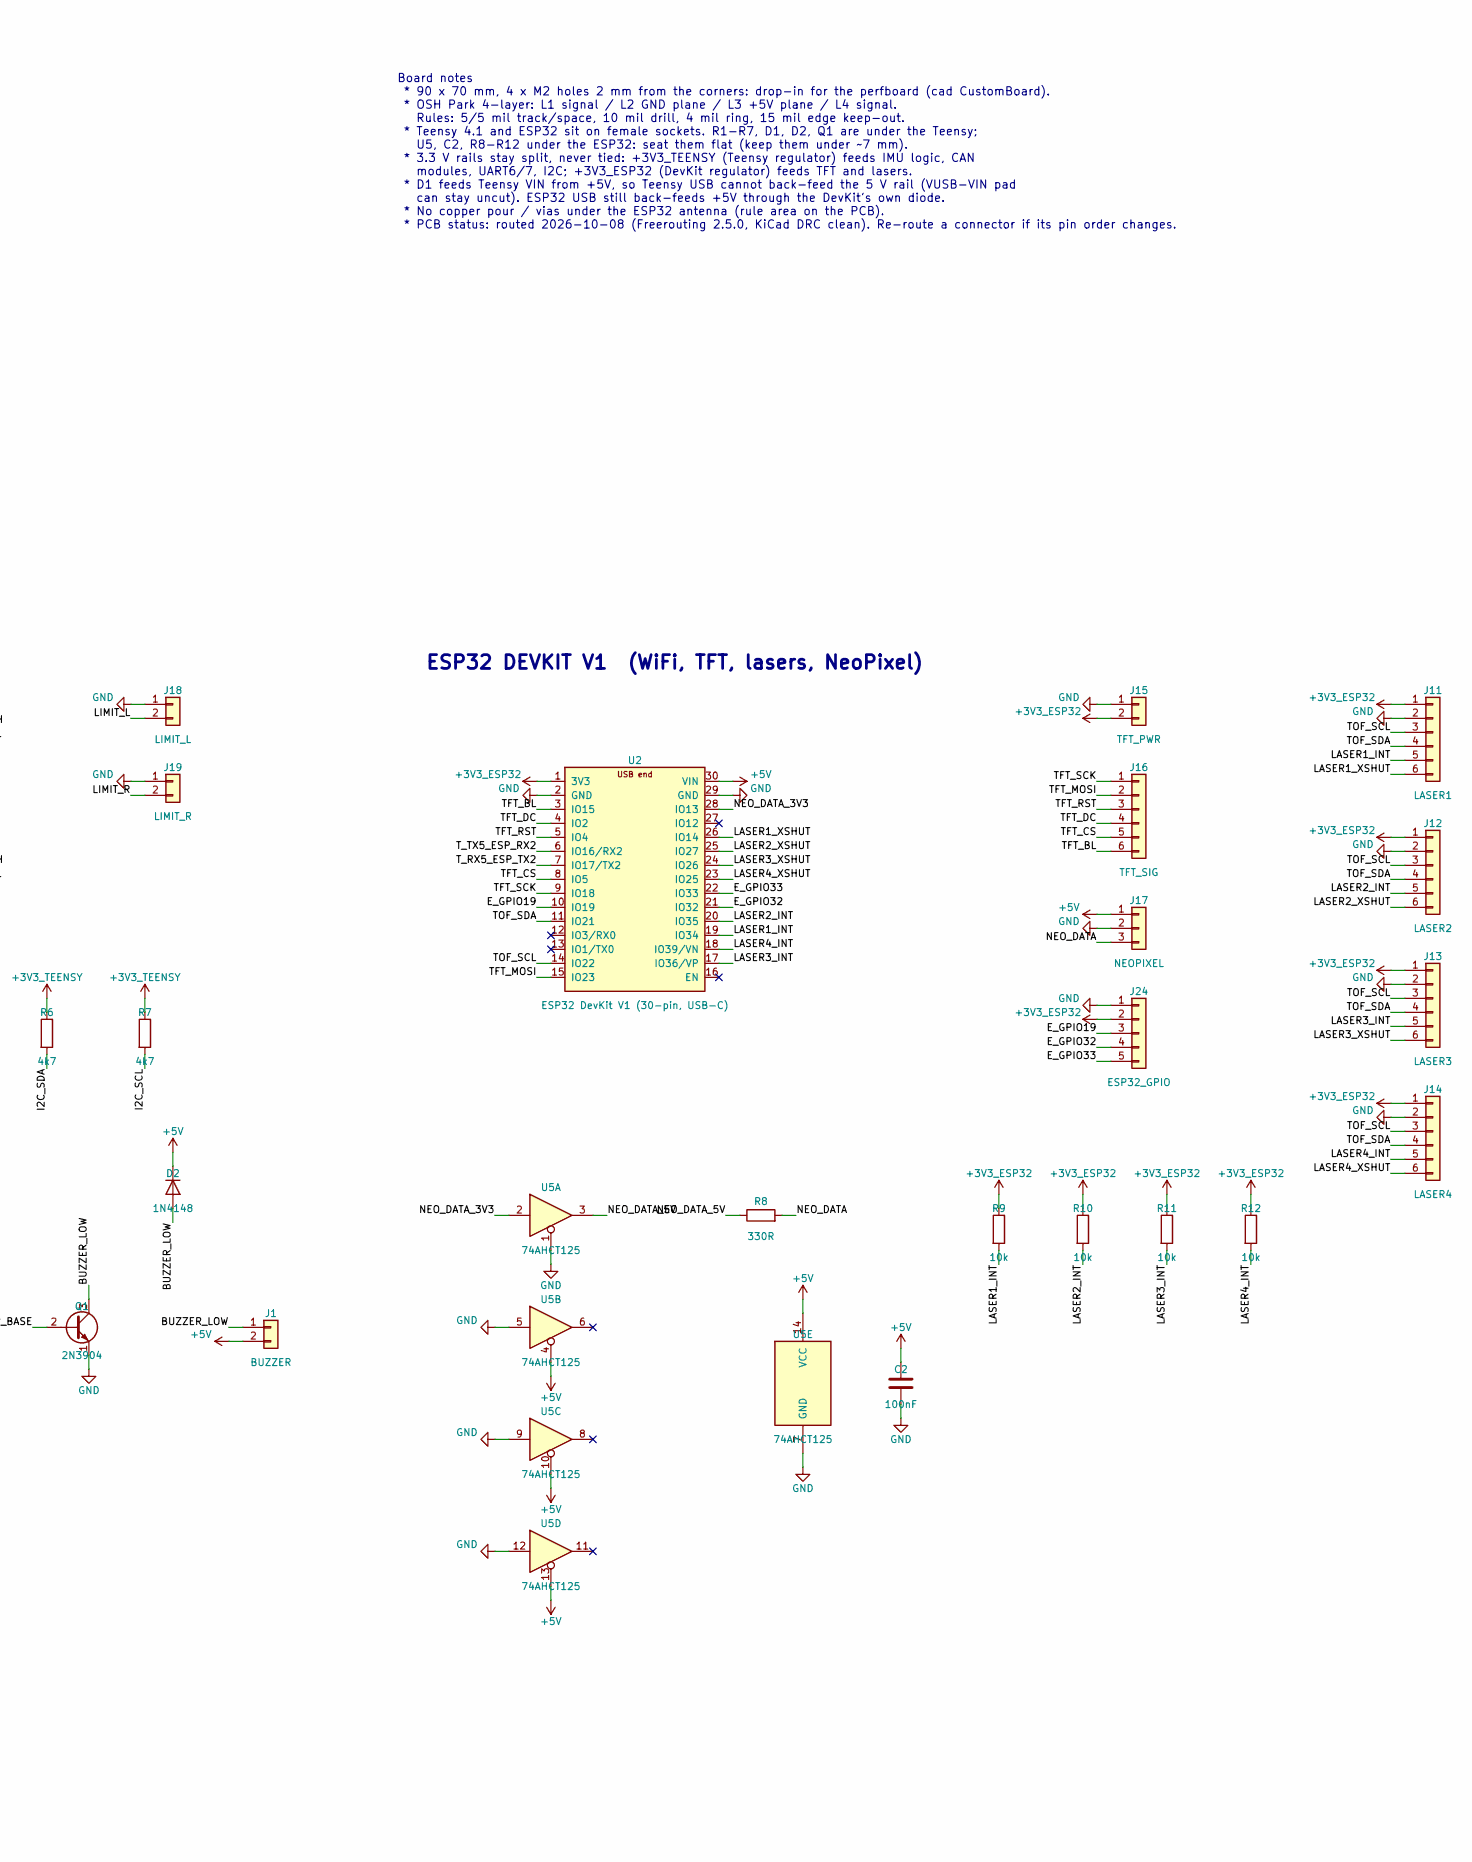
[picture p396: schematic wlr_mainboard.kicad_sch, Wheeled-Leg Robot - Main Board, part in row 1, column 2]

Parts:
C1: 100uF 10V; CP_Radial_D6.3mm_P2.50mm
C2: 100nF; C_Disc_D5.0mm_W2.5mm_P5.00mm
D1: 1N5817; D_DO-41_SOD81_P7.62mm_Horizontal
D2: 1N4148; D_DO-35_SOD27_P7.62mm_Horizontal
H1, H2, H3, H4: M2; MountingHole_2.2mm_M2
J1: BUZZER; JST_XH_B2B-XH-A_1x02_P2.50mm_Vertical
J2: RGB_LED; JST_XH_B4B-XH-A_1x04_P2.50mm_Vertical
J3: ELRS_RX; JST_XH_B4B-XH-A_1x04_P2.50mm_Vertical
J4: IMU_SIG; JST_XH_B6B-XH-A_1x06_P2.50mm_Vertical
J5: IMU_PWR; JST_XH_B2B-XH-A_1x02_P2.50mm_Vertical
J6: AK45_UART2; JST_XH_B3B-XH-A_1x03_P2.50mm_Vertical
J7: AK45_UART1; JST_XH_B3B-XH-A_1x03_P2.50mm_Vertical
J8: AK45_CAN; JST_XH_B2B-XH-A_1x02_P2.50mm_Vertical
J9: ODRIVE_CAN; JST_XH_B3B-XH-A_1x03_P2.50mm_Vertical
J10: 5V_IN; JST_XH_B2B-XH-A_1x02_P2.50mm_Vertical
J11: LASER1; JST_XH_B6B-XH-A_1x06_P2.50mm_Vertical
J12: LASER2; JST_XH_B6B-XH-A_1x06_P2.50mm_Vertical
J13: LASER3; JST_XH_B6B-XH-A_1x06_P2.50mm_Vertical
J14: LASER4; JST_XH_B6B-XH-A_1x06_P2.50mm_Vertical
J15: TFT_PWR; JST_XH_B2B-XH-A_1x02_P2.50mm_Vertical
J16: TFT_SIG; JST_XH_B6B-XH-A_1x06_P2.50mm_Vertical
J17: NEOPIXEL; JST_XH_B3B-XH-A_1x03_P2.50mm_Vertical
J18: LIMIT_L; JST_XH_B2B-XH-A_1x02_P2.50mm_Vertical
J19: LIMIT_R; JST_XH_B2B-XH-A_1x02_P2.50mm_Vertical
J20: UART6; JST_XH_B4B-XH-A_1x04_P2.50mm_Vertical
J21: UART7; JST_XH_B4B-XH-A_1x04_P2.50mm_Vertical
J22: I2C; JST_XH_B4B-XH-A_1x04_P2.50mm_Vertical
J23: TEENSY_GPIO; PinHeader_1x14_P2.54mm_Vertical
J24: ESP32_GPIO; PinHeader_1x05_P2.54mm_Vertical
Q1: 2N3904; TO-92_Inline
R1, R2, R3: 33R; R_Axial_DIN0207_L6.3mm_D2.5mm_P7.62mm_Horizontal
R4, R5: 1k; R_Axial_DIN0207_L6.3mm_D2.5mm_P7.62mm_Horizontal
R6, R7: 4k7; R_Axial_DIN0207_L6.3mm_D2.5mm_P7.62mm_Horizontal
R8: 330R; R_Axial_DIN0207_L6.3mm_D2.5mm_P7.62mm_Horizontal
R9, R10, R11, R12: 10k; R_Axial_DIN0207_L6.3mm_D2.5mm_P7.62mm_Horizontal
U1: Teensy 4.1; Teensy_4.1_Socket
U2: ESP32 DevKit V1 (30-pin, USB-C); ESP32_DevKit_V1_30P_Socket
U3: SN65HVD230 module (AK45 bus); SN65HVD230_Module_Standing
U4: SN65HVD230 module (ODrive bus); SN65HVD230_Module_Standing
U5: 74AHCT125; DIP-14_W7.62mm

Connections:
+3V3_ESP32: J11.1, J12.1, J13.1, J14.1, J15.2, J24.2, R9.1, R10.1, R11.1, R12.1, U2.1 (3V3)
+3V3_TEENSY: J20.2, J21.2, J22.2, J23.1, R6.1, R7.1, U1.15 (3V3), U1.46 (3V3), U3.1 (3V3), U4.1 (3V3)
+5V: C1.1, C2.1, D1.2 (A), D2.1 (K), J1.2, J3.3, J5.1, J10.1, J17.1, U2.30 (VIN), U5.4, U5.10, U5.13, U5.14 (VCC)
/AK1_RX: J7.1, U1.9 (7/RX2)
/AK1_TX: J7.2, U1.10 (8/TX2)
/AK2_RX: J6.1, U1.37 (15/RX3)
/AK2_TX: J6.2, U1.36 (14/TX3)
/BUZZER_BASE: Q1.2 (B), R4.2
/BUZZER_LOW: D2.2 (A), J1.1, Q1.3 (C)
/BUZZER_PWM: R4.1, U1.7 (5)
/CAN2_H: J8.2, U3.5 (CANH)
/CAN2_L: J8.1, U3.6 (CANL)
/CAN2_RX: U1.2 (0/RX1/CRX2), U3.4 (CRX)
/CAN2_TX: U1.3 (1/TX1/CTX2), U3.3 (CTX)
/CAN3_H: J9.2, U4.5 (CANH)
/CAN3_L: J9.1, U4.6 (CANL)
/CAN3_RX: U1.22 (30/CRX3), U4.4 (CRX)
/CAN3_TX: U1.23 (31/CTX3), U4.3 (CTX)
/E_GPIO19: J24.3, U2.10 (IO19)
/E_GPIO32: J24.4, U2.21 (IO32)
/E_GPIO33: J24.5, U2.22 (IO33)
/I2C_SCL: J22.4, R7.2, U1.41 (19/SCL)
/I2C_SDA: J22.3, R6.2, U1.40 (18/SDA)
/IMU_CS: J4.4, U1.12 (10/CS)
/IMU_INT: J4.5, U1.11 (9)
/IMU_MISO: J4.2, U1.14 (12/MISO)
/IMU_MOSI: J4.3, U1.13 (11/MOSI)
/IMU_RST: J4.6, U1.8 (6)
/IMU_SCK: J4.1, U1.35 (13/SCK)
/LASER1_INT: J11.5, R9.2, U2.19 (IO34)
/LASER1_XSHUT: J11.6, U2.26 (IO14)
/LASER2_INT: J12.5, R10.2, U2.20 (IO35)
/LASER2_XSHUT: J12.6, U2.25 (IO27)
/LASER3_INT: J13.5, R11.2, U2.17 (IO36/VP)
/LASER3_XSHUT: J13.6, U2.24 (IO26)
/LASER4_INT: J14.5, R12.2, U2.18 (IO39/VN)
/LASER4_XSHUT: J14.6, U2.23 (IO25)
/LED_B: J2.4, R3.2
/LED_B_PWM: R3.1, U1.6 (4)
/LED_G: J2.3, R2.2
/LED_G_PWM: R2.1, U1.4 (2)
/LED_R: J2.1, R1.2
/LED_R_PWM: R1.1, U1.5 (3)
/LIMIT_L: J18.2, U1.45 (23/CRX1)
/LIMIT_R: J19.2, U1.44 (22/CTX1)
/NEO_DATA: J17.3, R8.2
/NEO_DATA_3V3: U2.28 (IO13), U5.2
/NEO_DATA_5V: R8.1, U5.3
/RC_RX: R5.2, U1.38 (16/RX4)
/RC_RX_IN: J3.2, R5.1
/RC_TX: J3.1, U1.39 (17/TX4)
/TFT_BL: J16.6, U2.3 (IO15)
/TFT_CS: J16.5, U2.8 (IO5)
/TFT_DC: J16.4, U2.4 (IO2)
/TFT_MOSI: J16.2, U2.15 (IO23)
/TFT_RST: J16.3, U2.5 (IO4)
/TFT_SCK: J16.1, U2.9 (IO18)
/TOF_SCL: J11.3, J12.3, J13.3, J14.3, U2.14 (IO22)
/TOF_SDA: J11.4, J12.4, J13.4, J14.4, U2.11 (IO21)
/T_GPIO26: J23.2, U1.18 (26)
/T_GPIO27: J23.3, U1.19 (27)
/T_GPIO32: J23.4, U1.24 (32)
/T_GPIO33: J23.14, U1.25 (33)
/T_GPIO34: J23.13, U1.26 (34/RX8)
/T_GPIO35: J23.12, U1.27 (35/TX8)
/T_GPIO36: J23.11, U1.28 (36)
/T_GPIO37: J23.10, U1.29 (37)
/T_GPIO38: J23.9, U1.30 (38)
/T_GPIO39: J23.8, U1.31 (39)
/T_GPIO40: J23.7, U1.32 (40)
/T_GPIO41: J23.6, U1.33 (41)
/T_RX5_ESP_TX2: U1.43 (21/RX5), U2.7 (IO17/TX2)
/T_TX5_ESP_RX2: U1.42 (20/TX5), U2.6 (IO16/RX2)
/UART6_RX: J20.3, U1.17 (25/RX6)
/UART6_TX: J20.4, U1.16 (24/TX6)
/UART7_RX: J21.4, U1.20 (28/RX7)
/UART7_TX: J21.3, U1.21 (29/TX7)
GND: C1.2, C2.2, J2.2, J3.4, J5.2, J6.3, J7.3, J9.3, J10.2, J11.2, J12.2, J13.2, J14.2, J15.1, J17.2, J18.1, J19.1, J20.1, J21.1, J22.1, J23.5, J24.1, Q1.1 (E), U1.1 (GND), U1.34 (GND), U1.47 (GND), U2.2 (GND), U2.29 (GND), U3.2 (GND), U4.2 (GND), U5.1, U5.5, U5.7 (GND), U5.9, U5.12
VIN_TEENSY: D1.1 (K), U1.48 (VIN)

Notes on the sheet:
!! DOUBLE-CHECK EVERY PINOUT BEFORE LAYOUT / ROUTING !!
Board notes * 90 x 70 mm, 4 x M2 holes 2 mm from the corners: drop-in for the perfboard (cad CustomBoard). * OSH Park 4-layer: L1 signal / L2 GND plane / L3 +5V plane / L4 signal. Rules: 5/5 mil track/space, 10 mil drill, 4 mil ring, 15 mil edge keep-out. * Teensy 4.1 and ESP32 sit on female socket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
ESP32 DEVKIT V1 (WiFi, TFT, lasers, NeoPixel)
Mounting holes (M2, 2 mm from the corners)
POWER
TEENSY 4.1 (control, CAN, IMU, RC)
Connector pin orders copy the existing perfboard cables (photo, sketch and answers of 2026-10-07). Check each one against the real cable / module before routing. Physical order on the board: J1 BUZZER top edge, left->right: BZ-, BZ+ J2 RGB_LED left edge, top->bottom: B, G, GND, R J3 ELRS_RX left ed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

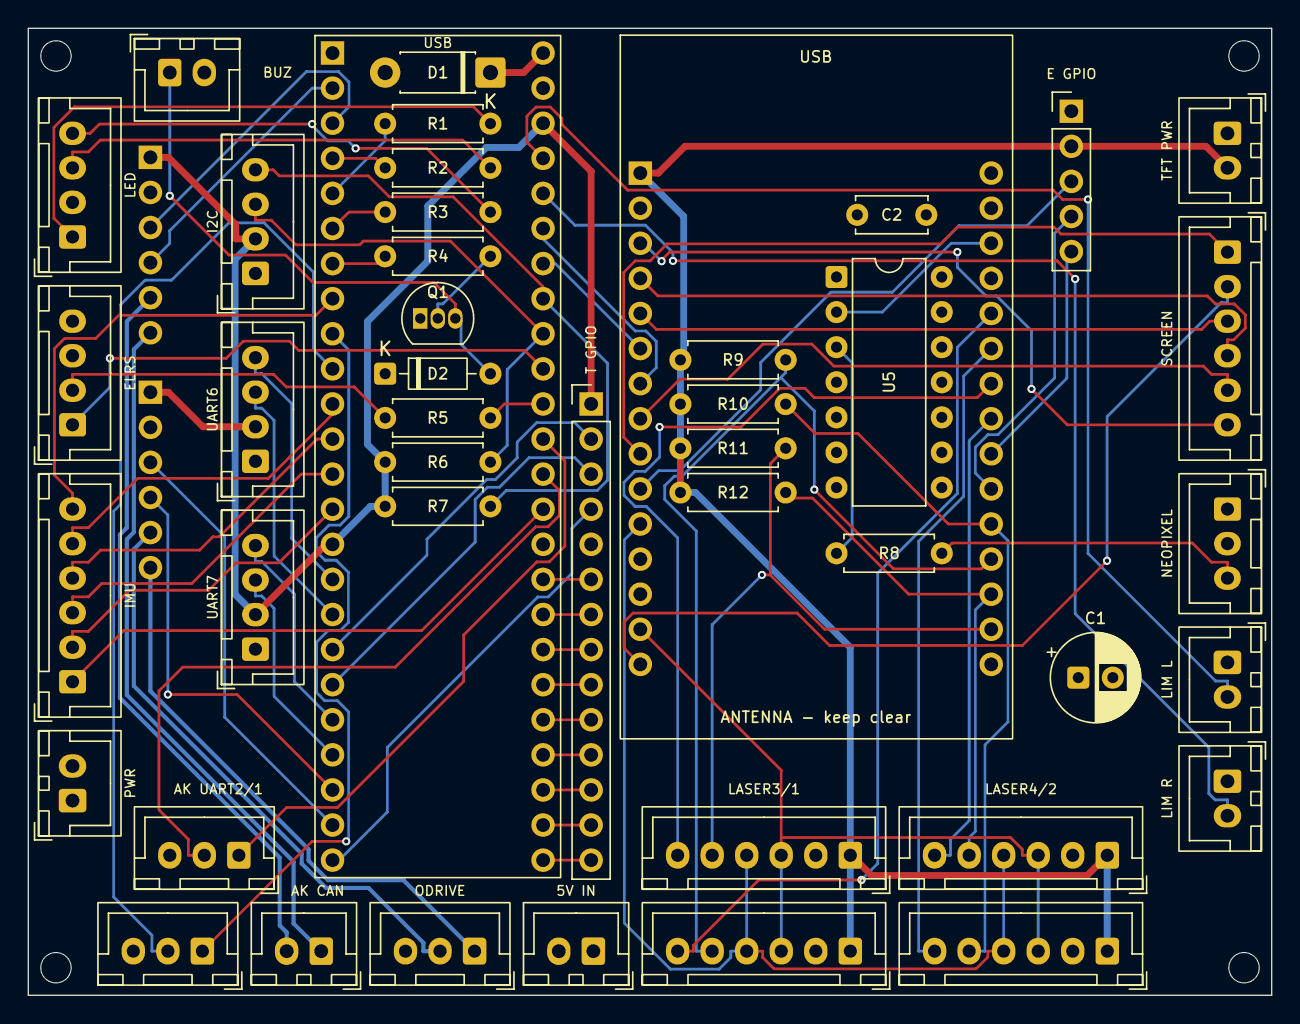
[picture p397: board wlr_mainboard.kicad_pcb from above]

Board: 4 copper layers, 90.0 x 70.0 mm, 50 parts (0 on the bottom side), 79 nets.
