fernandomierhicks/wheeled-leg-robot/firmware/robot_teensy/teensy/src/state_machine.cpp

#include <Arduino.h>
#include "state_machine.h"
#include "robot_state.h"
#include "IMU.h"
#include "hip_motors.h"
#include "calibration.h"
#include "comm_protocol.h"
#include "config.h"
#include "param_registry.h"
#include "control_loop.h"
#include "jump_landing.h"
#include "standup_safety.h"
#include "wheel_motors.h"
#include "Buzzer.h"
#include <StateMachine.h>

extern Buzzer g_buzzer;

static const BuzzerNote ARMED_MELODY[] = {
    {79, 80, 20},   // G5
    {86, 120,  0},  // D6 — rising fifth: "armed"
};
static const BuzzerNote DISARMED_MELODY[] = {
    {86, 80, 20},   // D6
    {79, 120,  0},  // G5 — falling fifth: "safe"
};
static const BuzzerNote REJECT_MELODY[] = {
    {60, 100, 40},  // C4
    {55, 180,  0},  // G3 — low descending: "denied"
};
static const BuzzerNote ESTOP_MELODY[] = {
    {72, 80,  20},  // C5
    {72, 80,  20},  // C5
    {72, 80,  20},  // C5
    {60, 400,  0},  // C4 — three short blasts then low long: "danger"
};
static const BuzzerNote JUMP_MELODY[] = {
    // Launch countdown: quick ascending run
    {72,  80, 30},  // C5
    {74,  80, 30},  // D5
    {76,  80, 30},  // E5
    {79,  80, 30},  // G5
    // Power-up hits
    {84, 150, 40},  // C6
    {83, 150, 40},  // B5
    {84, 150, 40},  // C6
    // Big launch arc
    {86, 250, 50},  // D6
    {84, 250, 50},  // C6
    {81, 250, 50},  // A5
    // Victory fanfare
    {79, 120, 20},  // G5
    {84, 120, 20},  // C6
    {88, 400,  0},  // E6 — hold: ~2.6 s total, state timer holds to 3 s
};
static const BuzzerNote STANDUP_MELODY[] = {
    // Fallen -> recovering: low, unresolved — outcome (capture vs. fail) unknown yet
    {48,  90, 30},  // C3
    {50,  90, 30},  // D3
    {53, 150,  0},  // F3
};

// ── State machine ─────────────────────────────────────────────────────────────

static StateMachine sm;

static State* S_STARTUP;
static State* S_STANDBY;
static State* S_MANUAL;
static State* S_CALIBRATION;
static State* S_RUNNING;
static State* S_ESTOP;
static State* S_CMD_REJECT;
static State* S_JUMPING;
static State* S_STANDING_UP;
static State* S_DISARMING;

// ── ESTOP hip-disable tracking ────────────────────────────────────────────────
static bool s_estop_hip_disabled = false;  // set when MIT was killed on ESTOP entry
static bool s_hip_disarm_ramping = false;  // set while ramping hip torque down before STANDBY
static bool s_disarming_calibration = false;

// ── ESTOP gentle hip-cutoff ramp ───────────────────────────────────────────────
// Compatibility hook for stateMachine_estop_hip_ramping(). ESTOP is now an
// immediate cutoff; normal hip ramp-down belongs only to DISARMING.
static bool s_estop_hip_ramping = false;
static bool s_disarm_done = false;

// ── Pending mode-change requests (set by command handler) ─────────────────────
static volatile bool s_req_manual        = false;
static volatile bool s_req_standby       = false;
static volatile bool s_req_reset         = false;
static volatile bool s_req_calibration   = false;
static volatile bool s_req_running       = false;
static volatile bool s_req_disarm_running = false;
static volatile bool s_req_disarm_calibration = false;
static volatile bool s_req_estop         = false;
static volatile bool s_req_cmd_reject    = false;
static volatile bool s_req_soft_clear    = false;
static volatile bool s_req_jump          = false;

// ── CMD_REJECT auto-exit timer ────────────────────────────────────────────────
static uint32_t s_cmd_reject_deadline_ms = 0;

// ── JUMPING timing ────────────────────────────────────────────────────────────
// No overall deadline/overrun fault (removed 2026-08-12): every JUMPING phase
// timeout — EXTEND's, RETRACT's landing detection, HANDOFF's capture — now
// falls through to a normal, non-faulting exit (retire to RETRACT/RUNNING as
// appropriate) rather than ESTOPping, because the ground-tuned wheel/balance
// loop runs unbroken through every phase regardless (see g_state.jump_state
// below), so a missed timing bookkeeping event was never actually a loss of
// control. The pitch watchdog (and motor/IMU hard-fault detection) remain the
// live safety net throughout — see JUMPING's row in state_machine.md.

// Floor on any derived phase duration. A zero-travel phase (already at the
// crouch target, or an EXTEND that never moved) must still occupy a couple of
// control ticks rather than collapsing to zero and dividing badly.
static constexpr float JUMP_PHASE_MIN_S = 0.02f;

// The quintic minimum-jerk profile's peak rate is 1.875x its average —
// standup_min_jerk_rate(0.5, 1.0) == 1.875, asserted in test_control_math.cpp.
// So a phase whose *peak* hip speed must not exceed peak_speed takes this long.
// Speeds are specified as peak because that is what the motor and the balance
// disturbance actually see; average would understate both by nearly 2x.
static constexpr float MIN_JERK_PEAK_OVER_MEAN = 1.875f;

static float jump_phase_duration_s(float travel_rad, float peak_speed_rad_s) {
    if (peak_speed_rad_s <= 0.0f) return JUMP_PHASE_MIN_S;
    float d = MIN_JERK_PEAK_OVER_MEAN * fabsf(travel_rad) / peak_speed_rad_s;
    return d < JUMP_PHASE_MIN_S ? JUMP_PHASE_MIN_S : d;
}

// ── Jump FSM state (Phase 7) ──────────────────────────────────────────────────
typedef enum : uint8_t {
    JP_CROUCH  = 0,
    JP_EXTEND  = 1,
    JP_RETRACT = 2,
    JP_LANDING = 3,
    JP_HANDOFF = 4,
} JumpPhase;

static JumpPhase s_jp_phase        = JP_HANDOFF;
static uint32_t  s_jp_phase_ms     = 0;       // millis() when current phase started
static float     s_jp_nom_L        = 0.0f;    // hip pos at jump trigger (RETRACT target)
static float     s_jp_nom_R        = 0.0f;
static float     s_jp_crouch_L     = 0.0f;    // CROUCH target, from jump_crouch_angle
static float     s_jp_crouch_R     = 0.0f;
static float     s_jp_ret_L        = 0.0f;    // RETRACT target — the intended landing pose
static float     s_jp_ret_R        = 0.0f;
static float     s_jp_from_L       = 0.0f;    // hip pos when RETRACT began
static float     s_jp_from_R       = 0.0f;
static float     s_jp_crouch_dur_s = 0.0f;    // derived: angle travel / jump_crouch_speed
static float     s_jp_retract_dur_s = 0.0f;   // derived when RETRACT begins, from actual travel
static JumpLandingDetector s_jp_landing = {};
// Liftoff: unloaded wheels spin up within ~10 ms of leaving the floor, which no
// ground manoeuvre can do (5 turns/s is ~1.8 m/s). LOG0043 shows it 25-40 ms
// into RETRACT on all nine jumps. A jump that never leaves the floor never
// trips it, so the ground balance loop keeps the wheels.
static constexpr float JUMP_LIFTOFF_WHEEL_DELTA = 5.0f;   // [turns/s]
static bool      s_jp_airborne     = false;
static float     s_jp_whl0_L       = 0.0f;    // wheel speed at RETRACT entry [turns/s]
static float     s_jp_whl0_R       = 0.0f;
static uint32_t  s_jp_handoff_capture_since_ms = 0;
static bool      s_jp_handoff_captured = false;

// ── Standing-up FSM state ─────────────────────────────────────────────────────
// Phase order is CROUCH -> STIFFEN -> RECOVER (-> PAUSE on a retry). SU_STIFFEN
// is numbered last, not in sequence, so the telemetry codes already in logs and
// in the GUI keep their meaning.
typedef enum : uint8_t {
    SU_CROUCH = 0, SU_RECOVER = 1, SU_PAUSE = 2, SU_STIFFEN = 3
} StandupPhase;
// Divergence debounce — fixed duration (not a tunable param), same rationale
// as control_loop.cpp's PITCH_WATCHDOG_MS: a safety-timeout, not a tuning knob.
static constexpr uint32_t STANDUP_DIVERGE_MS = 50;
static StandupPhase s_su_phase             = SU_CROUCH;
static uint32_t     s_su_phase_ms          = 0;
static float        s_su_nom_L, s_su_nom_R;       // hip pos snapshot at entry
static uint32_t     s_su_hip_settle_since_ms = 0; // 0 = hips not continuously settled
static float        s_su_stiff_from          = 0.0f; // stiffness scale STIFFEN ramps up from
static uint8_t      s_su_attempt           = 0;   // 1-based RECOVER attempt counter
static uint32_t     s_su_capture_since_ms  = 0;   // 0 = not currently in-band
static uint32_t     s_su_diverge_start_ms  = 0;   // 0 = not currently past the divergence limit
static bool         s_su_captured          = false;

// ── MANUAL GUI watchdog ───────────────────────────────────────────────────────
// Fed by any COMM_TYPE_COMMAND packet; the GUI sends CMD_ID_PING at 10 Hz so a
// GUI crash/disconnect exits MANUAL (and stops wheels) within ~500 ms.
static uint32_t s_last_gui_packet_ms  = 0;
static const uint32_t MANUAL_GUI_TIMEOUT_MS = 500;

// ── State actions ─────────────────────────────────────────────────────────────

static void on_startup()  {
    bool entering = (g_state.state != STATE_STARTUP);
    g_state.state = STATE_STARTUP;
    if (entering) {
        g_state.fault_code = FAULT_NONE;
        comm_log(LOG_LEVEL_INFO, "-> STARTUP");
        // Defensive cleanup for firmware upgraded from the former ESTOP-ramp
        // behavior: never carry a cached hip command across reset.
        if (s_estop_hip_ramping) {
            s_estop_hip_ramping = false;
            hip_motors_clear_setpoints();
        }
    }
    if (s_estop_hip_disabled) {
        s_estop_hip_disabled = false;
        if (param_get(PARAM_ESTOP_HIP_DISABLE) >= 0.5f) hip_motors_enter_mit();
    }
}
static void on_standby()  {
    bool entering      = (g_state.state != STATE_STANDBY);
    bool from_calib    = (g_state.state == STATE_CALIBRATION);
    bool calib_done    = from_calib && calibration_done();
    bool from_estop    = (g_state.state == STATE_ESTOP);  // soft-clear path
    bool from_manual   = (g_state.state == STATE_MANUAL);
    bool from_startup  = (g_state.state == STATE_STARTUP);
    g_state.state = STATE_STANDBY;
    hip_motors_clear_setpoints();  // DISARMING has already completed any normal ramp

    g_state.whl_tau_l = 0.0f;
    g_state.whl_tau_r = 0.0f;
    if (from_calib && !calib_done) calibration_abort();
    if (from_manual) {
        wheel_motors_send(0.0f, 0.0f);
        wheel_motors_set_mode(WheelMode::IDLE);
        wheel_motors_clear_errors();
    }
    // Startup succeeded: enabled hardware is ready and the IMU (if enabled)
    // reached NOMINAL.
    if (entering && from_startup) comm_log(LOG_LEVEL_INFO, "Startup complete");
    if (entering) comm_log(LOG_LEVEL_INFO, "-> STANDBY");
    if (from_estop) {
        // Soft-clear: clear fault and restore hip MIT mode skipped by bypassing STARTUP.
        g_state.fault_code = FAULT_NONE;
        // Defensive cleanup for the former ESTOP-ramp behavior.
        s_estop_hip_ramping = false;
        if (s_estop_hip_disabled) {
            s_estop_hip_disabled = false;
            if (param_get(PARAM_ESTOP_HIP_DISABLE) >= 0.5f) hip_motors_enter_mit();
        }
    }
}

static void on_disarming() {
    bool entering = (g_state.state != STATE_DISARMING);
    bool from_calib = (g_state.state == STATE_CALIBRATION);
    g_state.state = STATE_DISARMING;
    if (entering) {
        comm_log(LOG_LEVEL_INFO, "-> DISARMING");
        wheel_motors_send(0.0f, 0.0f);
        wheel_motors_set_mode(WheelMode::IDLE);
        g_state.whl_tau_l = g_state.whl_tau_r = g_state.tau_sym = g_state.tau_yaw = 0.0f;
        s_jp_phase = JP_HANDOFF;
        s_jp_handoff_captured = false;
        controlLoop_set_jump_handoff_active(false);
        controlLoop_set_velocity_loop_frozen(false);
        controlLoop_set_wheel_hold(false, 0.0f, 0.0f);
        s_su_captured = false;
        s_disarming_calibration = from_calib;
        if (s_disarming_calibration) {
            calibration_begin_disarm();
            s_hip_disarm_ramping = true;
            s_disarm_done = false;
        } else {
            controlLoop_reset_hip_disarm_ramp();
            s_hip_disarm_ramping =
                param_get(PARAM_HIP_RUNNING_RAMP_TIME_S) > 0.0f;
            s_disarm_done = !s_hip_disarm_ramping;
            if (s_disarm_done) hip_motors_clear_setpoints();
        }
    }
    if (s_hip_disarm_ramping) {
        const bool ramping = s_disarming_calibration
            ? calibration_run_disarm()
            : controlLoop_run_hip_disarm_ramp();
        if (!ramping) {
            s_hip_disarm_ramping = false;
            s_disarm_done = true;
            hip_motors_clear_setpoints();
        }
    }
}
static void on_manual() {
    bool entering = (g_state.state != STATE_MANUAL);
    g_state.state = STATE_MANUAL;
    if (entering) {
        s_last_gui_packet_ms = millis();  // start watchdog fresh; don't inherit stale timestamp
        g_hip_cmd.pending = false;        // discard any hip cmd latched before MANUAL entry
        comm_log(LOG_LEVEL_INFO, "-> MANUAL");
    }
    if (!g_hip_cmd.pending) return;
    g_hip_cmd.pending = false;
    switch (g_hip_cmd.sub_cmd) {
        case HIP_SUB_ENABLE:  hip_motors_enter_mit(); break;
        case HIP_SUB_DISABLE: hip_motors_exit_mit();  break;
        case HIP_SUB_ZERO:    hip_motors_zero();       break;
        case HIP_SUB_MIT:
            if      (g_hip_cmd.motor_id == HIP_MOTOR_L)
                hip_motors_set_setpoint_L(g_hip_cmd.p, g_hip_cmd.v, g_hip_cmd.kp, g_hip_cmd.kd, g_hip_cmd.tff);
            else if (g_hip_cmd.motor_id == HIP_MOTOR_R)
                hip_motors_set_setpoint_R(g_hip_cmd.p, g_hip_cmd.v, g_hip_cmd.kp, g_hip_cmd.kd, g_hip_cmd.tff);
            else {
                hip_motors_set_setpoint_L(g_hip_cmd.p, g_hip_cmd.v, g_hip_cmd.kp, g_hip_cmd.kd, g_hip_cmd.tff);
                hip_motors_set_setpoint_R(g_hip_cmd.p, g_hip_cmd.v, g_hip_cmd.kp, g_hip_cmd.kd, g_hip_cmd.tff);
            }
            break;
        default: break;
    }
}
static void on_calibration() {
    bool entering = (g_state.state != STATE_CALIBRATION);
    g_state.state = STATE_CALIBRATION;
    if (entering) {
        comm_log(LOG_LEVEL_INFO, "-> CALIBRATION");
        calibration_start();
    }
    calibration_update();
}
static void on_running() {
    bool entering         = (g_state.state != STATE_RUNNING);
    bool from_jumping     = (g_state.state == STATE_JUMPING);
    bool from_standing_up = (g_state.state == STATE_STANDING_UP);
    g_state.state = STATE_RUNNING;
    if (entering) {
        comm_log(LOG_LEVEL_INFO, "-> RUNNING (armed)");
        g_buzzer.play(ARMED_MELODY, sizeof(ARMED_MELODY) / sizeof(ARMED_MELODY[0]));
        wheel_motors_set_mode(WheelMode::TORQUE);
        // Captured standup and jump handoff have already been running this very
        // controller until the entry guard passed. Resetting it here would
        // throw away a converged velocity integral and create a torque step at
        // the exact moment the steady RUNNING limits take over.
        if (from_standing_up) {
            controlLoop_clear_hip_override();
        } else if (from_jumping) {
            controlLoop_set_jump_handoff_active(false);
            controlLoop_set_velocity_loop_frozen(false);
            controlLoop_set_wheel_hold(false, 0.0f, 0.0f);
        } else {
            controlLoop_reset();  // C1: clear integrators/rate-limit state so each arm starts clean
        }
        // Skip after either captured recovery. Landing already seeded the hip
        // command shadow from the measured pose and forced full stiffness;
        // normal CH3 slew has been active throughout HANDOFF.
        if (!from_jumping && !from_standing_up) {
            controlLoop_reset_hip_ramp();
        }
    }
    controlLoop_run();
}
static void on_cmd_reject() {
    bool entering = (g_state.state != STATE_CMD_REJECT);
    g_state.state = STATE_CMD_REJECT;
    if (entering) {
        comm_log(LOG_LEVEL_WARN, "-> CMD_REJECT");
        g_buzzer.play(REJECT_MELODY, sizeof(REJECT_MELODY) / sizeof(REJECT_MELODY[0]));
        s_cmd_reject_deadline_ms = millis() + 1000;
    }
}
static void on_jumping() {
    bool entering = (g_state.state != STATE_JUMPING);
    g_state.state = STATE_JUMPING;

    if (entering) {
        comm_log(LOG_LEVEL_INFO, "-> JUMPING");
        g_buzzer.play(JUMP_MELODY, sizeof(JUMP_MELODY) / sizeof(JUMP_MELODY[0]));

        s_jp_phase  = JP_CROUCH;
        s_jp_phase_ms = millis();
        s_jp_handoff_capture_since_ms = 0;
        s_jp_handoff_captured = false;
        s_jp_airborne = false;
        controlLoop_set_jump_handoff_active(false);
        s_jp_nom_L  = hm_L.pos_rad;
        s_jp_nom_R  = hm_R.pos_rad;

        // CROUCH target is an absolute extension angle, so the same jump is the
        // same motion from any ride height. The old code always crouched to the
        // calibrated retracted endpoint over a fixed time, which meant the
        // crouch *speed* silently scaled with wherever CH3 happened to be — two
        // jumps from different heights were two different manoeuvres.
        hip_ext_angle_to_setpoints(param_get(PARAM_JUMP_CROUCH_ANGLE),
                                   &s_jp_crouch_L, &s_jp_crouch_R);
        float crouch_travel = fmaxf(fabsf(s_jp_crouch_L - s_jp_nom_L),
                                    fabsf(s_jp_crouch_R - s_jp_nom_R));
        s_jp_crouch_dur_s = jump_phase_duration_s(
            crouch_travel, param_get(PARAM_JUMP_CROUCH_SPEED));
        s_jp_retract_dur_s = 0.0f;   // not known until EXTEND ends
    }

    // The wheel loop runs as in RUNNING except between detected liftoff and
    // detected landing, when each wheel is held at its RETRACT-entry speed.
    // Releasing the wheels by *phase* was tried and removed: crouched, l_eff is
    // ~0.09 m and the pendulum time constant ~0.1 s, so free wheels on a jump
    // that never leaves the floor are an every-attempt fall risk. Gating on the
    // liftoff wheel spike means such a jump never enters the hold.
    g_state.jump_state = (uint8_t)s_jp_phase;

    // Both gates below skip the phase machine entirely, so the phase would
    // otherwise sit at JP_CROUCH forever. Retire straight to a captured
    // handoff instead: no hip command was ever issued, so there is nothing to
    // unwind, and the sequence exits through the normal jump_done() path.
    auto retire_unstarted = [] {
        s_jp_phase = JP_HANDOFF;
        s_jp_handoff_captured = true;
        controlLoop_set_jump_handoff_active(false);
    };

    // ── Master gate: leave at 0 until ready to test ───────────────────────────
    const bool jump_enabled = param_get(PARAM_JUMP_ENABLE) >= 0.5f;
    const bool limits_valid = hm_limits_L.valid && hm_limits_R.valid;

    float phase_elapsed = (millis() - s_jp_phase_ms) / 1000.0f;
    controlLoop_set_jump_handoff_active(
        s_jp_phase == JP_LANDING || s_jp_phase == JP_HANDOFF);
    controlLoop_set_velocity_loop_frozen(
        s_jp_phase == JP_RETRACT || s_jp_phase == JP_LANDING ||
        (s_jp_phase == JP_HANDOFF && !s_jp_handoff_captured));
    controlLoop_set_wheel_hold(s_jp_airborne && s_jp_phase == JP_RETRACT,
                               s_jp_whl0_L, s_jp_whl0_R);
    controlLoop_run();

    if (!jump_enabled) { retire_unstarted(); return; }

    // Require valid calibration limits before any hip torque is applied
    if (!limits_valid) {
        comm_log(LOG_LEVEL_WARN, "JUMP: limits not valid — skipping hip cmds");
        retire_unstarted();
        return;
    }

    float hip_q_L  = hm_L.pos_rad;
    float hip_q_R  = hm_R.pos_rad;
    float hip_dq_L = hm_L.vel_rad_s;
    float hip_dq_R = hm_R.vel_rad_s;
    float elapsed  = phase_elapsed;
    float kp       = param_get(PARAM_JUMP_KP);
    float kd       = param_get(PARAM_JUMP_KD);

    if (s_jp_phase == JP_CROUCH) {
        // Minimum-jerk S-curve, the same profile and helpers STANDING_UP's
        // CROUCH uses (standup_safety.h). Zero commanded velocity and
        // acceleration at both ends, so the drop into the crouch no longer
        // starts and stops with an instantaneous velocity step.
        float u = (s_jp_crouch_dur_s > 0.0f) ? (elapsed / s_jp_crouch_dur_s) : 1.0f;
        if (u > 1.0f) u = 1.0f;
        float s    = standup_min_jerk_position(u);
        float rate = standup_min_jerk_rate(u, s_jp_crouch_dur_s);
        float dq_L = (s_jp_crouch_L - s_jp_nom_L) * rate;
        float dq_R = (s_jp_crouch_R - s_jp_nom_R) * rate;
        hip_motors_set_setpoint_L(s_jp_nom_L + s * (s_jp_crouch_L - s_jp_nom_L), dq_L, kp, kd, 0.0f);
        hip_motors_set_setpoint_R(s_jp_nom_R + s * (s_jp_crouch_R - s_jp_nom_R), dq_R, kp, kd, 0.0f);
        if (elapsed >= s_jp_crouch_dur_s) {
            s_jp_phase    = JP_EXTEND;
            s_jp_phase_ms = millis();
        }
    }
    else if (s_jp_phase == JP_EXTEND) {
        // seek_dir points toward the retract switch; extension is opposite.
        float dir_L = CALIB_L_SEEK_DIR;
        float dir_R = CALIB_R_SEEK_DIR;

        // Extended limit is the configured range from switch zero.
        float lim_L = (dir_L > 0.0f) ? hm_limits_L.min_rad : hm_limits_L.max_rad;
        float lim_R = (dir_R > 0.0f) ? hm_limits_R.min_rad : hm_limits_R.max_rad;

        float dist_L = fabsf(hip_q_L - lim_L);
        float dist_R = fabsf(hip_q_R - lim_R);

        float ramp_dn = param_get(PARAM_JUMP_RAMP_DOWN_RAD);
        float margin  = param_get(PARAM_JUMP_HARDSTOP_MARGIN);
        float w_max   = param_get(PARAM_JUMP_OMEGA_MAX);
        float ext_kd  = param_get(PARAM_JUMP_EXTEND_KD);

        // jump_torque_max is the reviewed ceiling; persistent jump_effort is the
        // operator's scale factor. The product is what reaches the motor, so an
        // effort of 0 is a full no-op even with jump_enable stored at 1.
        float max_trq = param_get(PARAM_JUMP_TORQUE_MAX) * param_get(PARAM_JUMP_EFFORT);

        // How far each leg still has to go to reach the commanded extend target,
        // stated forwards as an angle rather than backwards from the calibrated
        // limit. Negative once past it.
        float togo_L = param_get(PARAM_JUMP_EXTEND_ANGLE)
                     - hip_measured_ext_angle(hm_L, hm_limits_L, dir_L);
        float togo_R = param_get(PARAM_JUMP_EXTEND_ANGLE)
                     - hip_measured_ext_angle(hm_R, hm_limits_R, dir_R);

        // Torque onset at a fixed *rate*, so the time to reach the commanded
        // torque scales with that torque. Under the old fixed softstart duration
        // a harder push ramped in proportionally faster — the biggest jumps got
        // the sharpest torque step, which is exactly backwards.
        float ramp_in = 1.0f;
        if (max_trq > 0.0f) {
            ramp_in = elapsed * param_get(PARAM_JUMP_TORQUE_RATE) / max_trq;
            if (ramp_in > 1.0f) ramp_in = 1.0f;
        }

        // Torque ramp-to-zero approaching the extend target
        float ramp_out_L = togo_L / ramp_dn;
        if (ramp_out_L > 1.0f) ramp_out_L = 1.0f;
        if (ramp_out_L < 0.0f) ramp_out_L = 0.0f;
        float ramp_out_R = togo_R / ramp_dn;
        if (ramp_out_R > 1.0f) ramp_out_R = 1.0f;
        if (ramp_out_R < 0.0f) ramp_out_R = 0.0f;

        // Speed taper: torque → 0 as hip velocity approaches omega_max
        float tap_L = 1.0f - fabsf(hip_dq_L) / w_max;
        if (tap_L < 0.0f) tap_L = 0.0f;
        float tap_R = 1.0f - fabsf(hip_dq_R) / w_max;
        if (tap_R < 0.0f) tap_R = 0.0f;

        // Extension is -dir: seek_dir points toward the retract switch, so with
        // dir=+1 define_limits() puts retracted at max_rad and extended at
        // min_rad (see lim_L above, and hip_cmd_to_setpoints()) — extending
        // means *decreasing* position, which needs negative torque.
        //
        // Until 2026-08-11 this read `dir_L *`, i.e. it pushed the leg INTO the
        // retract stop for the whole of EXTEND. Nothing caught it: dist_L grows
        // under the wrong sign so neither near_ext nor the hardstop cutoff can
        // fire, and EXTEND runs at kp=0 so clamp_to_limits() has no position
        // command to clamp. It stayed invisible only because jump_torque_max
        // shipped at 0 and no jump had ever commanded torque.
        float tff_L = -dir_L * max_trq * ramp_in * ramp_out_L * tap_L;
        float tff_R = -dir_R * max_trq * ramp_in * ramp_out_R * tap_R;

        // Layer 4: hard cutoff — zero torque if within absolute margin of the
        // *calibrated* extended limit. Independent of jump_extend_angle and
        // deliberately lower-level than it, so an extend target set too high is
        // still caught by the mechanism rather than by the operator.
        bool cutoff = false;
        if (dist_L < margin) { tff_L = 0.0f; cutoff = true; }
        if (dist_R < margin) { tff_R = 0.0f; cutoff = true; }

        // kp=0: pure torque + small damping; pos set to current so MITprotocol is well-formed
        hip_motors_set_setpoint_L(hip_q_L, 0.0f, 0.0f, ext_kd, tff_L);
        hip_motors_set_setpoint_R(hip_q_R, 0.0f, 0.0f, ext_kd, tff_R);

        bool near_ext = (togo_L <= 0.0f && togo_R <= 0.0f);
        bool timed_out = (elapsed >= param_get(PARAM_JUMP_EXTEND_TIMEOUT_S));
        if (near_ext || cutoff || timed_out) {
            s_jp_from_L   = hip_q_L;
            s_jp_from_R   = hip_q_R;

            // Landing pose. A negative jump_retract_angle means "return to the
            // pose we launched from" — the behaviour before the parameter
            // existed, and still the default. A real angle lets the landing pose
            // be chosen independently of the launch height.
            float ret_ang = param_get(PARAM_JUMP_RETRACT_ANGLE);
            if (ret_ang < 0.0f) {
                s_jp_ret_L = s_jp_nom_L;
                s_jp_ret_R = s_jp_nom_R;
            } else {
                hip_ext_angle_to_setpoints(ret_ang, &s_jp_ret_L, &s_jp_ret_R);
            }

            // Only now is the tuck distance known — it depends on how far EXTEND
            // actually got as well as on the target. Deriving the duration here
            // is what makes jump_retract_speed mean a speed rather than, as the
            // old hardcoded 0.20 s did, whatever speed that distance implied.
            float retract_travel = fmaxf(fabsf(s_jp_ret_L - s_jp_from_L),
                                         fabsf(s_jp_ret_R - s_jp_from_R));
            s_jp_retract_dur_s = jump_phase_duration_s(
                retract_travel, param_get(PARAM_JUMP_RETRACT_SPEED));
            s_jp_whl0_L   = wm_L.vel_turns_s;
            s_jp_whl0_R   = wm_R.vel_turns_s;
            s_jp_airborne = false;
            s_jp_phase    = JP_RETRACT;
            s_jp_phase_ms = millis();
            jump_landing_reset(&s_jp_landing,
                               s_jp_phase_ms,
                               imu_gyro_last_update_ms(),
                               imu_roll_rate(),
                               imu_pitch_rate(),
                               imu_yaw_rate());
        }
    }
    else if (s_jp_phase == JP_RETRACT) {
        // Held at the landing pose once the tuck completes, until landing is
        // detected or jump_land_timeout expires.
        float u = (s_jp_retract_dur_s > 0.0f) ? (elapsed / s_jp_retract_dur_s) : 1.0f;
        if (u > 1.0f) u = 1.0f;
        float s    = standup_min_jerk_position(u);
        float rate = standup_min_jerk_rate(u, s_jp_retract_dur_s);
        float dq_L = (s_jp_ret_L - s_jp_from_L) * rate;
        float dq_R = (s_jp_ret_R - s_jp_from_R) * rate;
        hip_motors_set_setpoint_L(s_jp_from_L + s * (s_jp_ret_L - s_jp_from_L), dq_L, kp, kd, 0.0f);
        hip_motors_set_setpoint_R(s_jp_from_R + s * (s_jp_ret_R - s_jp_from_R), dq_R, kp, kd, 0.0f);

        if (!s_jp_airborne &&
            (fabsf(wm_L.vel_turns_s - s_jp_whl0_L) > JUMP_LIFTOFF_WHEEL_DELTA ||
             fabsf(wm_R.vel_turns_s - s_jp_whl0_R) > JUMP_LIFTOFF_WHEEL_DELTA)) {
            s_jp_airborne = true;
            comm_log(LOG_LEVEL_INFO, "JUMP: liftoff detected at %.3f s", elapsed);
        }

        bool landed = jump_landing_update(
            &s_jp_landing,
            millis(),
            imu_gyro_last_update_ms(),
            imu_roll_rate(),
            imu_pitch_rate(),
            imu_yaw_rate(),
            param_get(PARAM_JUMP_LANDING_MIN_AIR_S),
            param_get(PARAM_JUMP_LANDING_GYRO_IMPULSE_RADS));

        if (landed) {
            comm_log(LOG_LEVEL_INFO,
                     "JUMP: gyro landing detected at %.3f s", elapsed);
            controlLoop_reset_hip_ramp();
            controlLoop_complete_hip_ramp();
            s_jp_handoff_capture_since_ms = 0;
            s_jp_phase    = JP_LANDING;
            s_jp_phase_ms = millis();
        } else if (elapsed >= param_get(PARAM_JUMP_LANDING_TIMEOUT_S)) {
            // A missed detection is not a fault: the balance loop has run every
            // tick since CROUCH. Enter HANDOFF uncaptured rather than jumping
            // straight to RUNNING, so the handoff wheel-speed limit still
            // applies — the wheels can still be near jmp_air_vel_lim here, and
            // RUNNING's 2x wm_vel_limit runaway trip (LOG0042 jump 4) would
            // fire within 50 ms.
            comm_log(LOG_LEVEL_WARN,
                     "JUMP: gyro landing not detected within %.3f s — entering HANDOFF",
                     elapsed);
            controlLoop_reset_hip_ramp();
            controlLoop_complete_hip_ramp();
            s_jp_handoff_capture_since_ms = 0;
            s_jp_phase    = JP_HANDOFF;
            s_jp_phase_ms = millis();
        }
    }
    else if (s_jp_phase == JP_LANDING) {
        // One explicit telemetry phase separates contact from recovery. The
        // ordinary controller already owns wheel and hip outputs here with the
        // handoff gains active.
        if (elapsed >= 0.002f) {
            s_jp_phase    = JP_HANDOFF;
            s_jp_phase_ms = millis();
        }
    }
    else {  // JP_HANDOFF
        float pitch_error = g_state.pitch_rad - g_state.theta_ref - g_state.applied_pitch_trim;
        float running_vel_limit = param_get(PARAM_WHEEL_VEL_LIMIT_TURNS_S);
        bool in_band = fabsf(pitch_error) < param_get(PARAM_JUMP_HANDOFF_CAPTURE_PITCH_RAD) &&
                       fabsf(g_state.pitch_rate_rads) < param_get(PARAM_JUMP_HANDOFF_CAPTURE_RATE_RADS) &&
                       fabsf(wm_L.vel_turns_s) <= running_vel_limit &&
                       fabsf(wm_R.vel_turns_s) <= running_vel_limit;
        if (in_band) {
            if (s_jp_handoff_capture_since_ms == 0) {
                s_jp_handoff_capture_since_ms = millis();
            }
            if (!s_jp_handoff_captured &&
                millis() - s_jp_handoff_capture_since_ms >=
                (uint32_t)(param_get(PARAM_JUMP_HANDOFF_CAPTURE_HOLD_S) * 1000.0f)) {
                s_jp_handoff_captured = true;
                comm_log(LOG_LEVEL_INFO, "JUMP: handoff captured");
            }
        } else {
            s_jp_handoff_capture_since_ms = 0;
        }

        // Give up waiting for the tight capture band rather than fault: the
        // ordinary RUNNING controller (with handoff authority active) has
        // already been the one driving pitch/wheels this whole time, so a
        // slow convergence is not a loss of control — just a bookkeeping
        // gap, same reasoning as the RETRACT landing-timeout fallback above.
        // Drop the elevated handoff authority and let plain RUNNING limits
        // take over; the pitch watchdog remains live throughout regardless.
        if (!s_jp_handoff_captured &&
            elapsed >= param_get(PARAM_JUMP_HANDOFF_TIMEOUT_S)) {
            comm_log(LOG_LEVEL_WARN,
                     "JUMP: handoff not captured within %.3f s — releasing to RUNNING anyway",
                     elapsed);
            s_jp_handoff_captured = true;
            controlLoop_set_jump_handoff_active(false);
        }
    }
}
// Hip hold used by the pre-LQR standup phases. `stiff` scales kp and the hip
// feedforward together — the same pair control_loop.cpp's arm-in ramp_alpha
// scales, and for the same reason: kp alone would leave the feedforward
// stepping in whole at the RECOVER handoff (hip_running_tff_ret is -2.5 N·m by
// default, which is a real kick). kd is at its full running value throughout,
// also matching the arm-in ramp — damping is what keeps a softly-held leg from
// oscillating, so it is never the thing that gets faded.
//
// The feedforward uses the retracted anchor only. It is exact at the crouch
// target (where alpha = 0, and where the hips spend STIFFEN and RECOVER) and
// approximate during the excursion, where the leg is still extended; `stiff` is
// small there, so the error it can contribute is small too.
static void standup_hold_hips(float pos_L, float pos_R,
                              float vel_L, float vel_R, float stiff) {
    float kp  = stiff * param_get(PARAM_HIP_RUNNING_KP);
    float kd  = param_get(PARAM_HIP_RUNNING_KD);
    float tff = stiff * param_get(PARAM_HIP_RUNNING_TFF_RET);
    hip_motors_set_setpoint_L(pos_L, vel_L, kp, kd, tff);
    hip_motors_set_setpoint_R(pos_R, vel_R, kp, kd, tff);
}

// Arm-time settling window — see standing_up.md. Not a separate controller:
// CROUCH poses the legs, then RECOVER hands every tick to controlLoop_run()
// (the ordinary RUNNING stack) with only the pitch watchdog masked, so the
// catch and the steady state are the same loop and the handoff to RUNNING is
// not a controller switch. Replaced an earlier inline P/D wheel-torque law.
static void on_standing_up() {
    bool entering = (g_state.state != STATE_STANDING_UP);
    g_state.state = STATE_STANDING_UP;

    if (entering) {
        comm_log(LOG_LEVEL_INFO, "-> STANDING_UP");
        g_buzzer.play(STANDUP_MELODY, sizeof(STANDUP_MELODY) / sizeof(STANDUP_MELODY[0]));
        s_su_phase            = SU_CROUCH;
        s_su_phase_ms         = millis();
        s_su_attempt          = 0;
        s_su_captured         = false;
        s_su_capture_since_ms = 0;
        s_su_diverge_start_ms = 0;
        s_su_hip_settle_since_ms = 0;
        s_su_stiff_from = 0.0f;
        // Clamp the ramp's starting pose into the calibrated span. Every hip
        // command is clamped on the way out (hip_motors_set_setpoint_*), so a
        // ramp starting outside the span is not a ramp at all: its first
        // command is already the clamped endpoint and the excursion collapses
        // into a step. That is the normal case, not a corner case — the leg
        // parks *on* the retract switch at the end of calibration, which is one
        // calib_backoff_rad (15 deg as configured) beyond the retracted end of
        // the span, so every arm from the parked pose used to snap the hips
        // through that backoff at full running stiffness, whatever
        // standup_crouch_time said. Clamping here makes the ramp start where
        // the commands can actually start; the stiffness fade-in below is what
        // removes the torque step the remaining pose error would otherwise
        // still produce.
        s_su_nom_L = hip_motors_clamp_to_limits(hm_L.pos_rad, hm_limits_L);
        s_su_nom_R = hip_motors_clamp_to_limits(hm_R.pos_rad, hm_limits_R);
        wheel_motors_set_mode(WheelMode::TORQUE);
        // Clean integrators/rate-limit state before the RUNNING controllers are
        // handed the catch in SU_RECOVER. Also clears any stale hip override.
        controlLoop_reset();
    }

    g_state.standup_state = (uint8_t)s_su_phase;

    // Refuse to command hips without valid calibrated limits — mirrors the
    // identical guard in on_jumping(). Without it, hip_cmd_to_setpoints()
    // silently returns pos=0 (span==0), not the requested height, which would
    // snap the hip to an arbitrary pose at full stiffness. Unlike
    // on_jumping(), an invalid-limits abort here goes straight to ESTOP rather
    // than just skipping hip commands for the tick: the whole point of this
    // state is that the pitch watchdog is masked, so there is no safety net
    // left to fall back on if the legs are in an unknown pose.
    if (!hm_limits_L.valid || !hm_limits_R.valid) {
        comm_log(LOG_LEVEL_WARN, "STANDING_UP: limits not valid — aborting");
        g_state.fault_code = FAULT_STANDUP_FAILED;
        stateMachine_request_estop();
        return;
    }

    float pitch      = g_state.pitch_rad;
    float pitch_rate = g_state.pitch_rate_rads;

    // The stand-up pose is the calibrated retracted endpoint. Calibration
    // defines t=0 at exactly calib_backoff_rad away from each retract switch,
    // so no second stand-up height parameter can disagree with it.
    float su_ret_L, su_ret_R;
    hip_cmd_to_setpoints(0.0f, &su_ret_L, &su_ret_R);
    float configured_backoff = param_get(PARAM_CALIB_BACKOFF_RAD);
    if (!standup_target_matches_configured_backoff(
            su_ret_L, su_ret_R, configured_backoff,
            CALIB_L_SEEK_DIR, CALIB_R_SEEK_DIR)) {
        comm_log(LOG_LEVEL_ERROR,
                 "STANDING_UP: calib_backoff changed since calibration; recalibrate before arming");
        g_state.fault_code = FAULT_STANDUP_FAILED;
        stateMachine_request_estop();
        return;
    }

    // Divergence check (no retry): pitch grew past the recoverable range
    // mid-attempt — a wrong-direction/unstable response, not just a slow one.
    // Deliberately looser than the arm-time-only entry gate
    // (standup_pitch_min/max) so a saturated catch has overshoot budget
    // instead of self-tripping the instant it starts, and debounced
    // (STANDUP_DIVERGE_MS) like every other fault instead of instantaneous,
    // so one noisy IMU sample can't abort a good catch. Checked every phase,
    // including CROUCH, not just RECOVER/PAUSE.
    if (pitch > param_get(PARAM_STANDUP_DIVERGE_PITCH_FWD_RAD) ||
        pitch < -param_get(PARAM_STANDUP_DIVERGE_PITCH_BWD_RAD)) {
        if (s_su_diverge_start_ms == 0) s_su_diverge_start_ms = millis();
        if (millis() - s_su_diverge_start_ms > STANDUP_DIVERGE_MS) {
            g_state.fault_code = FAULT_STANDUP_FAILED;
            stateMachine_request_estop();
            return;
        }
    } else {
        s_su_diverge_start_ms = 0;
    }

    float elapsed = (millis() - s_su_phase_ms) / 1000.0f;

    if (s_su_phase == SU_CROUCH) {
        // The excursion: walk the hip setpoint from where the legs actually are
        // to the calibrated retracted endpoint over standup_crouch_time. This
        // is the pose the balance controller can recover from, and getting
        // there slowly — under a stiffness that fades in with the motion rather
        // than being applied whole on tick one — is the whole point of the
        // phase. Wheels stay at zero until the legs are in a measured
        // known-good pose.
        float crouch_t = param_get(PARAM_STANDUP_CROUCH_TIME_S);
        float u = elapsed / crouch_t;
        if (u > 1.0f) u = 1.0f;
        float alpha      = standup_min_jerk_position(u);
        float alpha_rate = standup_min_jerk_rate(u, crouch_t);
        float dq_L = (su_ret_L - s_su_nom_L) * alpha_rate;
        float dq_R = (su_ret_R - s_su_nom_R) * alpha_rate;
        bool ramp_done = elapsed >= crouch_t;

        // Fade kp/tff in on the same minimum-jerk profile as the position, so
        // both the commanded motion and the stiffness that drives it start at
        // exactly zero. Arming therefore applies no torque step regardless of
        // where the legs are — including the parked-on-the-switch case above,
        // where the clamped ramp has no distance left to travel and this fade
        // is the only thing moving the leg onto the backoff pose.
        float crouch_stiff = param_get(PARAM_STANDUP_CROUCH_STIFF) * alpha;
        standup_hold_hips(s_su_nom_L + alpha * (su_ret_L - s_su_nom_L),
                          s_su_nom_R + alpha * (su_ret_R - s_su_nom_R),
                          dq_L, dq_R, crouch_stiff);
        wheel_motors_send(0.0f, 0.0f);  // no wheel motion until legs are known-good
        g_state.whl_tau_l = g_state.whl_tau_r = g_state.tau_sym = 0.0f;

        uint32_t now_ms = millis();
        bool hips_quiet = ramp_done && standup_hips_quiet(hm_L.vel_rad_s, hm_R.vel_rad_s);
        if (hips_quiet) {
            if (s_su_hip_settle_since_ms == 0) s_su_hip_settle_since_ms = now_ms;
        } else {
            s_su_hip_settle_since_ms = 0;
        }

        // Excursion over: the commanded trajectory has run its full length and
        // the legs have come to rest. Only their *position* is still unverified
        // — a partial-stiffness proportional hold sags well past the strict
        // band — so that check belongs to STIFFEN, at full gains.
        if (s_su_hip_settle_since_ms != 0 &&
            now_ms - s_su_hip_settle_since_ms >= STANDUP_HIP_SETTLE_HOLD_MS) {
            s_su_stiff_from = param_get(PARAM_STANDUP_CROUCH_STIFF);
            s_su_phase    = SU_STIFFEN;
            s_su_phase_ms = now_ms;
            s_su_hip_settle_since_ms = 0;
        } else if (ramp_done &&
                   now_ms - s_su_phase_ms >=
                       (uint32_t)(crouch_t * 1000.0f) + STANDUP_HIP_SETTLE_TIMEOUT_MS) {
            comm_log(LOG_LEVEL_ERROR,
                     "STANDING_UP: hips still moving after crouch (vel L=%.3f R=%.3f rad/s)",
                     (double)hm_L.vel_rad_s, (double)hm_R.vel_rad_s);
            g_state.fault_code = FAULT_STANDUP_FAILED;
            stateMachine_request_estop();
        }
        return;
    }

    if (s_su_phase == SU_STIFFEN) {
        // Legs are parked at the crouch target; make them rigid before handing
        // the robot to the LQR. kp and the hip feedforward ramp from the crouch
        // fraction to their full running values, which also pulls out the sag
        // the softer hold left — so the strict position band below is only
        // reachable once the hips really are stiff.
        float stiffen_t = param_get(PARAM_STANDUP_STIFFEN_TIME_S);
        float stiff = standup_stiffen_scale(elapsed, stiffen_t, s_su_stiff_from);
        standup_hold_hips(su_ret_L, su_ret_R, 0.0f, 0.0f, stiff);
        wheel_motors_send(0.0f, 0.0f);
        g_state.whl_tau_l = g_state.whl_tau_r = g_state.tau_sym = 0.0f;

        uint32_t now_ms = millis();
        bool at_full_stiffness = elapsed >= stiffen_t;
        // Tolerance at the gains actually commanded this tick: a P-hold with a
        // feedforward rests offset by (tff - load)/kp, and the load is nothing
        // like the standing load while the wheels are still off the ground.
        float pos_tol = standup_hip_pos_tol(stiff * param_get(PARAM_HIP_RUNNING_KP),
                                            stiff * param_get(PARAM_HIP_RUNNING_TFF_RET));
        bool hips_settled = at_full_stiffness && standup_hips_in_settle_band(
            hm_L.pos_rad, hm_L.vel_rad_s, hm_R.pos_rad, hm_R.vel_rad_s,
            su_ret_L, su_ret_R, pos_tol);
        if (hips_settled) {
            if (s_su_hip_settle_since_ms == 0) s_su_hip_settle_since_ms = now_ms;
        } else {
            s_su_hip_settle_since_ms = 0;
        }

        // Engage the balance controller only after both measured hips have
        // reached the calibrated backoff pose, at full stiffness, and stopped
        // there continuously.
        if (s_su_hip_settle_since_ms != 0 &&
            now_ms - s_su_hip_settle_since_ms >= STANDUP_HIP_SETTLE_HOLD_MS) {
            // STIFFEN has just walked the hips up to full hip_running_kp/tff.
            // Mark the ordinary arm-in ramp complete so RECOVER and the RUNNING
            // handoff continue from there instead of re-loosening a verified
            // pose the moment the wheel LQR is enabled.
            controlLoop_complete_hip_ramp();
            s_su_phase    = SU_RECOVER;
            s_su_phase_ms = now_ms;
            s_su_attempt  = 1;
            s_su_hip_settle_since_ms = 0;
        } else if (at_full_stiffness &&
                   now_ms - s_su_phase_ms >=
                       (uint32_t)(stiffen_t * 1000.0f) + STANDUP_HIP_SETTLE_TIMEOUT_MS) {
            comm_log(LOG_LEVEL_ERROR,
                     "STANDING_UP: hips failed to settle (err L=%.3f R=%.3f rad, tol %.3f, "
                     "vel L=%.3f R=%.3f rad/s)",
                     (double)(hm_L.pos_rad - su_ret_L),
                     (double)(hm_R.pos_rad - su_ret_R), (double)pos_tol,
                     (double)hm_L.vel_rad_s, (double)hm_R.vel_rad_s);
            g_state.fault_code = FAULT_STANDUP_FAILED;
            stateMachine_request_estop();
        }
        return;
    }

    if (s_su_phase == SU_RECOVER) {
        // The catch is the ordinary RUNNING control stack — balance LQR,
        // velocity PI, yaw PI, feedforward, per-wheel soft governor and
        // wheel-runaway watchdog — with only the pitch watchdog suppressed
        // (control_loop.cpp gates it on STATE_STANDING_UP). No standup-specific
        // torque law: from the leans the entry gate admits, the linearized LQR
        // is what will be holding the robot a moment later anyway, so catching
        // with the same controller removes the handoff discontinuity entirely.
        // controlLoop_run() commands the hips too; re-assert the calibrated
        // retracted endpoint every tick so CH3 cannot move them mid-catch.
        controlLoop_set_hip_override(0.0f);
        controlLoop_run();

        // Capture check: in-band relative to the same trim the LQR is
        // regulating to (not pitch=0), continuously for the hold time =>
        // settled enough to re-arm the pitch watchdog. A trim-blind band
        // centered on zero would capture mid-roll, since x0=0 there requires
        // sustained forward acceleration rather than being an equilibrium.
        // Reads the trim controlLoop_run() just applied this tick rather than
        // lqr_pitch_trim_ret directly, so the band stays centred on the actual
        // equilibrium when standup_ret_gains=0 leaves alpha free to schedule.
        float x0 = pitch - g_state.applied_pitch_trim;
        bool in_band = fabsf(x0)         < param_get(PARAM_STANDUP_CAPTURE_PITCH_RAD) &&
                        fabsf(pitch_rate) < param_get(PARAM_STANDUP_CAPTURE_RATE_RADS) &&
                        standup_wheels_ready_for_handoff(
                            wm_L.vel_turns_s, wm_R.vel_turns_s,
                            param_get(PARAM_WHEEL_VEL_LIMIT_TURNS_S));
        if (in_band) {
            if (s_su_capture_since_ms == 0) s_su_capture_since_ms = millis();
            if (millis() - s_su_capture_since_ms >= (uint32_t)(param_get(PARAM_STANDUP_CAPTURE_HOLD_S) * 1000.0f)) {
                s_su_captured = true;
            }
        } else {
            s_su_capture_since_ms = 0;
        }

        // Attempt timeout: stayed within range but didn't converge in time
        if (elapsed >= param_get(PARAM_STANDUP_ATTEMPT_TIMEOUT_S) && !s_su_captured) {
            if (s_su_attempt >= (uint8_t)param_get(PARAM_STANDUP_MAX_RETRIES) + 1) {
                g_state.fault_code = FAULT_STANDUP_FAILED;
                stateMachine_request_estop();
                return;
            }
            s_su_phase    = SU_PAUSE;
            s_su_phase_ms = millis();
        }
    }
    else {  // SU_PAUSE
        // controlLoop_run() is not called here, so hold the hips explicitly at
        // the same pinned height RECOVER uses (the override only takes effect
        // inside controlLoop_run(); it stays set across the pause). Full
        // stiffness, feedforward included: the hips were rigid entering the
        // pause and dropping either one would sag the legs and hand RECOVER a
        // different pose than the one it left.
        standup_hold_hips(su_ret_L, su_ret_R, 0.0f, 0.0f, 1.0f);
        wheel_motors_send(0.0f, 0.0f);
        g_state.whl_tau_l = g_state.whl_tau_r = g_state.tau_sym = 0.0f;
        if (elapsed >= param_get(PARAM_STANDUP_RETRY_PAUSE_S)) {
            s_su_attempt++;
            s_su_phase    = SU_RECOVER;
            s_su_phase_ms = millis();
        }
    }
}
static bool standup_captured() { return s_su_captured; }
// Immediate hip cutoff used by ESTOP. Normal exits use STATE_DISARMING.
static void estop_cut_hip() {
    if (param_get(PARAM_ESTOP_HIP_DISABLE) >= 0.5f) {
        hip_motors_exit_mit();
        s_estop_hip_disabled = true;
    }
}

static void on_estop() {
    bool entering     = (g_state.state != STATE_ESTOP);
    bool from_startup = (g_state.state == STATE_STARTUP);
    g_state.state = STATE_ESTOP;
    if (entering) {
        // Discard ALL queued requests so nothing stale fires after a future
        // reset/soft-clear — e.g. a CH6 jump latched the same tick a fault
        // fired would otherwise jump the instant the robot is re-armed.
        s_req_cmd_reject     = false;
        s_req_manual         = false;
        s_req_running        = false;
        s_req_calibration    = false;
        s_req_jump           = false;
        s_req_disarm_running = false;
        s_req_disarm_calibration = false;
        s_req_standby        = false;
        s_req_reset          = false;
        s_req_soft_clear     = false;
        // Startup failed (or was aborted by ESTOP) before it could resolve —
        // the specific reason (IMU/hip) was already logged by startup_fail()
        // just before this transition fired.
        if (from_startup) comm_log(LOG_LEVEL_ERROR, "Startup complete with errors");
        comm_log(LOG_LEVEL_ERROR, "-> ESTOP [fault 0x%02X]", g_state.fault_code);
        g_buzzer.play(ESTOP_MELODY, sizeof(ESTOP_MELODY) / sizeof(ESTOP_MELODY[0]));

        // Wheels: kill power immediately — no reason to keep driving a wheel
        // through an emergency stop.
        wheel_motors_set_mode(WheelMode::IDLE);

        // ESTOP is the immediate path, distinct from normal DISARMING. Clear
        // every active hip setpoint in this entry action and apply the
        // configured MIT-disable policy now; no torque ramp may delay the
        // emergency output invariant.
        s_hip_disarm_ramping = false;
        s_disarming_calibration = false;
        s_estop_hip_ramping = false;
        // A fault raised mid-jump must not leave the phase machine mid-sequence
        // for whatever state comes next.
        s_jp_phase = JP_HANDOFF;
        s_jp_handoff_captured = false;
        controlLoop_set_jump_handoff_active(false);
        controlLoop_set_velocity_loop_frozen(false);
        controlLoop_set_wheel_hold(false, 0.0f, 0.0f);
        hip_motors_clear_setpoints();
        estop_cut_hip();
    }
}

// ── Transition conditions ─────────────────────────────────────────────────────

static bool startup_ok() {
    bool imu_ok = (param_get(PARAM_IMU_ENABLE) < 0.5f) ||
                  (imu_state() == ImuState::NOMINAL);
    return imu_ok && hip_motors_ok() && wheel_motors_ok();
}
static bool startup_fail() {
    if (param_get(PARAM_IMU_ENABLE) >= 0.5f && imu_state() == ImuState::ERROR) {
        comm_log(LOG_LEVEL_ERROR, "FAULT: IMU init failed");
        g_state.fault_code = FAULT_IMU_ERROR;
        return true;
    }
    bool l_missing = (param_get(PARAM_HIP_L_ENABLE) >= 0.5f) && !hm_L.ever_heard;
    bool r_missing = (param_get(PARAM_HIP_R_ENABLE) >= 0.5f) && !hm_R.ever_heard;
    if (millis() > 2000 && (l_missing || r_missing)) {
        comm_log(LOG_LEVEL_ERROR, "FAULT: hip init timeout (L=%d R=%d)", (int)hm_L.ever_heard, (int)hm_R.ever_heard);
        g_state.fault_code = FAULT_HIP_INIT_TIMEOUT;
        return true;
    }
    bool wl_missing = (param_get(PARAM_WHEEL_L_ENABLE) >= 0.5f) && !wm_L.ever_heard;
    bool wr_missing = (param_get(PARAM_WHEEL_R_ENABLE) >= 0.5f) && !wm_R.ever_heard;
    if (millis() > 2000 && (wl_missing || wr_missing)) {
        comm_log(LOG_LEVEL_ERROR, "FAULT: wheel init timeout (L=%d R=%d)", (int)wm_L.ever_heard, (int)wm_R.ever_heard);
        g_state.fault_code = FAULT_WHEEL_INIT_TIMEOUT;
        return true;
    }
    return false;
}
// Checked from nearly every state (see stateMachine_init()) — a motor feedback
// dropout is a global ESTOP trigger, not just a RUNNING-time concern.
static bool motor_feedback_fault() {
    if (!hip_motors_ok()) {
        comm_log(LOG_LEVEL_ERROR, "FAULT: hip feedback lost");
        g_state.fault_code = FAULT_HIP_FEEDBACK_LOST;
        return true;
    }
    if (!wheel_motors_ok()) {
        comm_log(LOG_LEVEL_ERROR, "FAULT: wheel feedback lost L(ok=%d e=%lu) R(ok=%d e=%lu)",
                 (int)wm_L.ok, (unsigned long)wm_L.error, (int)wm_R.ok, (unsigned long)wm_R.error);
        g_state.fault_code = FAULT_WHEEL_FEEDBACK_LOST;
        return true;
    }
    return false;
}
// All energetic states, including DISARMING: a frozen pitch estimate is unsafe,
// so ESTOP the moment the required IMU leaves NOMINAL.
static bool running_imu_fault() {
    if (param_get(PARAM_IMU_ENABLE) < 0.5f) return false;
    if (imu_state() == ImuState::NOMINAL) return false;
    comm_log(LOG_LEVEL_ERROR, "FAULT: IMU lost (imu_state=%d)", (int)imu_state());
    g_state.fault_code = FAULT_IMU_LOST;
    return true;
}
static bool req_manual()        { bool v = s_req_manual;  s_req_manual  = false; return v; }
static bool req_standby()       { bool v = s_req_standby; s_req_standby = false; return v; }
static bool req_reset()         { bool v = s_req_reset;   s_req_reset   = false; return v; }
static bool req_calibration() {
    bool v = s_req_calibration;
    s_req_calibration = false;
    return v;
}
static bool req_cmd_reject() { bool v = s_req_cmd_reject; s_req_cmd_reject = false; return v; }
static bool cmd_reject_done() { return (millis() >= s_cmd_reject_deadline_ms); }
static bool manual_gui_timeout() {
    if (millis() - s_last_gui_packet_ms < MANUAL_GUI_TIMEOUT_MS) return false;
    comm_log(LOG_LEVEL_WARN, "MANUAL: GUI timeout -> STANDBY");
    return true;
}
static bool req_running_checks_common() {
    if (param_get(PARAM_IMU_ENABLE) < 0.5f) {
        comm_log(LOG_LEVEL_WARN, "Running mode denied: IMU disabled (imu_enable=0)");
        stateMachine_request_cmd_reject();
        return false;
    }
    if (!hm_limits_L.valid || !hm_limits_R.valid) {
        if (param_get(PARAM_CALIB_BYPASS_EN) < 0.5f) {
            comm_log(LOG_LEVEL_WARN, "Running mode denied: calibrate first (limits not valid).");
            stateMachine_request_cmd_reject();
            return false;
        }
        comm_log(LOG_LEVEL_WARN, "Running mode ARMED without calibration (calib_bypass_en=1) — hip limits unenforced.");
    }
    // The two halves are reported separately and by name. Fused into one
    // message ("a motor is disabled") they were genuinely hard to act on: with
    // calib_bypass_en=1 the log said the hip bypass was working on one line and
    // denied on the next, without ever revealing that it was the *wheel* half
    // and a different param (run_wheel_bypass_en) that was missing.
    bool bypass_hip_check   = param_get(PARAM_CALIB_BYPASS_EN)         >= 0.5f;
    bool bypass_wheel_check = param_get(PARAM_RUNNING_WHEEL_BYPASS_EN) >= 0.5f;
    if (!bypass_hip_check &&
        (param_get(PARAM_HIP_L_ENABLE) < 0.5f || param_get(PARAM_HIP_R_ENABLE) < 0.5f)) {
        comm_log(LOG_LEVEL_WARN,
                 "Running mode denied: hip motor disabled (hip_l_enable=%.0f hip_r_enable=%.0f) "
                 "and calib_bypass_en=0",
                 param_get(PARAM_HIP_L_ENABLE), param_get(PARAM_HIP_R_ENABLE));
        stateMachine_request_cmd_reject();
        return false;
    }
    if (!bypass_wheel_check &&
        (param_get(PARAM_WHEEL_L_ENABLE) < 0.5f || param_get(PARAM_WHEEL_R_ENABLE) < 0.5f)) {
        comm_log(LOG_LEVEL_WARN,
                 "Running mode denied: wheel motor disabled (wheel_l_enable=%.0f wheel_r_enable=%.0f) "
                 "and run_wheel_bypass_en=0",
                 param_get(PARAM_WHEEL_L_ENABLE), param_get(PARAM_WHEEL_R_ENABLE));
        stateMachine_request_cmd_reject();
        return false;
    }
    return true;
}
// Arm while STANDUP_ENABLE=1: gate on recoverable pitch range, then route
// through STANDING_UP instead of straight to RUNNING.
static bool req_running_to_standing_up() {
    if (!s_req_running) return false;
    if (param_get(PARAM_STANDUP_ENABLE) < 0.5f) return false;  // let _direct handle it
    s_req_running = false;
    return true;
}
// Today's exact behavior, byte-identical, when STANDUP_ENABLE=0 (the default).
static bool req_running_direct() {
    if (!s_req_running) return false;
    if (param_get(PARAM_STANDUP_ENABLE) >= 0.5f) return false;  // handled above
    s_req_running = false;
    return true;
}
static bool req_disarm_running() { bool v = s_req_disarm_running; s_req_disarm_running = false; return v; }
static bool req_disarm_calibration() {
    bool v = s_req_disarm_calibration;
    s_req_disarm_calibration = false;
    return v;
}
static bool disarm_done()        { return s_disarm_done; }
static bool req_jump()           { bool v = s_req_jump;           s_req_jump           = false; return v; }
// Normal exit only after the post-landing controller has continuously held its
// capture band. The controller remains live across this transition.
static bool jump_done() {
    return s_jp_handoff_captured;
}

static bool req_estop() {
    if (!s_req_estop) return false;
    s_req_estop = false;
    if (g_state.fault_code == FAULT_NONE) g_state.fault_code = FAULT_HUMAN_ESTOP;
    return true;
}
static bool req_soft_clear() {
    if (!s_req_soft_clear) return false;
    s_req_soft_clear = false;
    if (fault_severity(g_state.fault_code) != FAULT_SEVERITY_SOFT) {
        comm_log(LOG_LEVEL_WARN, "Soft clear denied: fault 0x%02X is not SOFT severity", g_state.fault_code);
        return false;
    }
    comm_log(LOG_LEVEL_INFO, "Soft clear ESTOP [0x%02X] -> STANDBY", g_state.fault_code);
    return true;
}

static bool calibration_done_fn() {
    return calibration_done();
}
static bool calibration_failed_fn() {
    if (!calibration_failed()) return false;
    g_state.fault_code = FAULT_CALIBRATION_TIMEOUT;
    return true;
}

// ── Init / update ─────────────────────────────────────────────────────────────

void stateMachine_init() {
    S_STARTUP     = sm.addState(on_startup);
    S_STANDBY     = sm.addState(on_standby);
    S_MANUAL      = sm.addState(on_manual);
    S_CALIBRATION = sm.addState(on_calibration);
    S_RUNNING     = sm.addState(on_running);
    S_ESTOP       = sm.addState(on_estop);
    S_CMD_REJECT  = sm.addState(on_cmd_reject);
    S_JUMPING     = sm.addState(on_jumping);
    S_STANDING_UP = sm.addState(on_standing_up);
    S_DISARMING   = sm.addState(on_disarming);

    S_STARTUP->addTransition(req_estop,    S_ESTOP);
    S_STARTUP->addTransition(startup_ok,   S_STANDBY);
    S_STARTUP->addTransition(startup_fail, S_ESTOP);

    S_STANDBY->addTransition(req_estop,            S_ESTOP);
    S_STANDBY->addTransition(motor_feedback_fault, S_ESTOP);
    S_STANDBY->addTransition(req_manual,           S_MANUAL);
    S_STANDBY->addTransition(req_calibration,      S_CALIBRATION);
    S_STANDBY->addTransition(req_running_to_standing_up, S_STANDING_UP);
    S_STANDBY->addTransition(req_running_direct,   S_RUNNING);
    S_STANDBY->addTransition(req_cmd_reject,       S_CMD_REJECT);

    S_MANUAL ->addTransition(req_estop,            S_ESTOP);
    S_MANUAL ->addTransition(motor_feedback_fault, S_ESTOP);
    S_MANUAL ->addTransition(req_standby,          S_STANDBY);
    S_MANUAL ->addTransition(manual_gui_timeout,   S_STANDBY);

    S_CALIBRATION->addTransition(req_estop,             S_ESTOP);
    S_CALIBRATION->addTransition(motor_feedback_fault,  S_ESTOP);
    S_CALIBRATION->addTransition(calibration_failed_fn, S_ESTOP);
    S_CALIBRATION->addTransition(calibration_done_fn,   S_STANDBY);
    S_CALIBRATION->addTransition(req_disarm_calibration, S_DISARMING);
    S_CALIBRATION->addTransition(req_standby,           S_STANDBY);

    S_RUNNING->addTransition(req_estop,            S_ESTOP);
    S_RUNNING->addTransition(motor_feedback_fault, S_ESTOP);
    S_RUNNING->addTransition(running_imu_fault,    S_ESTOP);
    S_RUNNING->addTransition(req_disarm_running,   S_DISARMING);
    S_RUNNING->addTransition(req_jump,             S_JUMPING);

    S_JUMPING->addTransition(req_estop,            S_ESTOP);
    S_JUMPING->addTransition(motor_feedback_fault, S_ESTOP);
    S_JUMPING->addTransition(running_imu_fault,    S_ESTOP);
    S_JUMPING->addTransition(req_disarm_running,   S_DISARMING);
    S_JUMPING->addTransition(jump_done,            S_RUNNING);

    S_STANDING_UP->addTransition(req_estop,            S_ESTOP);
    S_STANDING_UP->addTransition(motor_feedback_fault, S_ESTOP);
    S_STANDING_UP->addTransition(running_imu_fault,    S_ESTOP);
    S_STANDING_UP->addTransition(req_disarm_running,   S_DISARMING);
    S_STANDING_UP->addTransition(standup_captured,     S_RUNNING);

    S_DISARMING->addTransition(req_estop,            S_ESTOP);
    S_DISARMING->addTransition(motor_feedback_fault, S_ESTOP);
    S_DISARMING->addTransition(running_imu_fault,    S_ESTOP);
    S_DISARMING->addTransition(disarm_done,          S_STANDBY);

    S_ESTOP  ->addTransition(req_soft_clear,     S_STANDBY);
    S_ESTOP  ->addTransition(req_reset,          S_STARTUP);

    // req_estop/motor_feedback_fault checked first, same as every other state —
    // without these, an ESTOP request during the ~1 s reject transient would
    // sit latched and only take effect once cmd_reject_done() fires.
    S_CMD_REJECT->addTransition(req_estop,            S_ESTOP);
    S_CMD_REJECT->addTransition(motor_feedback_fault, S_ESTOP);
    S_CMD_REJECT->addTransition(cmd_reject_done,      S_STANDBY);

    g_state.state = STATE_STARTUP;
}

void stateMachine_update() {
    RobotStateEnum previous_state = g_state.state;
    sm.run();
    if (g_state.state != previous_state &&
        (previous_state == STATE_RUNNING || previous_state == STATE_JUMPING)) {
        controlLoop_disarm_plant_id();
    }
}

// ── Public request API ────────────────────────────────────────────────────────

// stateMachine_request_manual/_calibration/_running only latch while actually
// in STANDBY. Their matching req_X() transition conditions (which clear the
// flag) are only ever evaluated from S_STANDBY, so a stale/duplicate request
// arriving while already past STANDBY (e.g. the GUI's dual WiFi+USB send
// delivering one click twice) would otherwise sit latched indefinitely and
// immediately re-fire the instant we return to STANDBY for any reason.
bool stateMachine_request_manual() {
    if (g_state.state != STATE_STANDBY) return false;
    s_req_manual = true;
    return true;
}
// req_standby() is only evaluated from S_MANUAL/S_CALIBRATION — guard so a
// stray "Standby" request sent from some other state (e.g. RUNNING, where
// disarm_running is the correct path) doesn't latch and fire the moment we
// next happen to enter MANUAL or CALIBRATION.
bool stateMachine_exit_manual() {
    if (g_state.state != STATE_MANUAL && g_state.state != STATE_CALIBRATION) return false;
    s_req_standby = true;
    return true;
}
// req_reset() is only evaluated from S_ESTOP — guard so a stray reset request
// doesn't sit latched and silently clear a later, unrelated ESTOP fault.
bool stateMachine_request_reset() {
    if (g_state.state != STATE_ESTOP) return false;
    s_req_reset = true;
    return true;
}
bool stateMachine_request_calibration() {
    if (g_state.state != STATE_STANDBY) return false;
    if (param_get(PARAM_HIP_L_ENABLE) < 0.5f && param_get(PARAM_HIP_R_ENABLE) < 0.5f) {
        comm_log(LOG_LEVEL_WARN, "Calibration denied: no hip motors enabled (hip_l_enable=0, hip_r_enable=0)");
        stateMachine_request_cmd_reject();
        return false;
    }
    s_req_calibration = true;
    return true;
}
bool stateMachine_request_running() {
    if (g_state.state != STATE_STANDBY) return false;
    if (imu_state() != ImuState::NOMINAL || millis() - imu_last_update_ms() > 50) {
        comm_log(LOG_LEVEL_WARN, "Running mode denied: IMU not nominal/fresh (state=%d age=%lu ms)",
                 (int)imu_state(), (unsigned long)(millis() - imu_last_update_ms()));
        stateMachine_request_cmd_reject();
        return false;
    }
    if (!req_running_checks_common()) return false;
    if (param_get(PARAM_STANDUP_ENABLE) >= 0.5f) {
        float pitch = g_state.pitch_rad;
        if (pitch < param_get(PARAM_STANDUP_PITCH_MIN_RAD) ||
            pitch > param_get(PARAM_STANDUP_PITCH_MAX_RAD)) {
            comm_log(LOG_LEVEL_WARN, "Standing-up denied: pitch %.3f rad outside recoverable range", pitch);
            stateMachine_request_cmd_reject();
            return false;
        }
    }
    s_req_running = true;
    return true;
}
// req_disarm_running() is only evaluated from S_RUNNING — guard so a stray
// disarm request doesn't sit latched and fire the instant we next arm,
// disarming immediately after an operator arms RUNNING.
bool stateMachine_disarm_running() {
    if (g_state.state != STATE_RUNNING && g_state.state != STATE_JUMPING &&
        g_state.state != STATE_STANDING_UP) return false;
    s_req_disarm_running = true;
    return true;
}
bool stateMachine_disarm_calibration() {
    if (g_state.state != STATE_CALIBRATION) return false;
    s_req_disarm_calibration = true;
    return true;
}
// Deliberately unguarded: ESTOP must be reachable from any state (it already
// is, from every state's transition list) and re-requesting it is harmless —
// idempotent, and there is no origin state where a "stray" estop is wrong.
bool stateMachine_request_estop() {
    // Idempotent in ESTOP, and crucially do not leave a stale event that can
    // fire immediately after RESET enters STARTUP.
    if (g_state.state == STATE_ESTOP) return true;
    s_req_estop = true;
    return true;
}
// Only ever called synchronously from within req_calibration()/req_running(),
// which themselves only run while currentState == S_STANDBY — no external
// caller, so no stale-latch risk here.
void stateMachine_request_cmd_reject()  { s_req_cmd_reject     = true; }
// req_soft_clear() is only evaluated from S_ESTOP — guard so a stray soft
// clear doesn't sit latched and silently clear a later, unrelated SOFT fault.
bool stateMachine_request_soft_clear() {
    if (g_state.state != STATE_ESTOP) return false;
    if (fault_severity(g_state.fault_code) != FAULT_SEVERITY_SOFT) {
        comm_log(LOG_LEVEL_WARN, "Soft clear denied: fault 0x%02X is not SOFT severity", g_state.fault_code);
        return false;
    }
    s_req_soft_clear = true;
    return true;
}
// req_jump() is only evaluated from S_RUNNING — guard so a stray jump request
// doesn't sit latched and fire an unintended jump the instant we next arm.
// jump_enable is the master gate: with it 0, don't even enter STATE_JUMPING —
// on_jumping() would skip hip commands, leaving the hips uncommanded for 3 s.
// Ground-motion arm gate: refuse to launch a jump out of a maneuver already
// in progress, since CROUCH/EXTEND would then compound whatever disturbance
// is live rather than start from a settled stance. Checked once here, at
// request time — not re-checked during the jump, which leans on the (still
// fully live, per 2026-08-12 review) pitch watchdog for that. Forward speed
// is deliberately given more headroom than backward/yaw/roll: a bit of
// forward speed helps the launch, the others don't.
static bool jump_arm_motion_ok() {
    float v = g_state.wheel_vel_avg_ms;
    if (v > param_get(PARAM_JUMP_ARM_MAX_FWD_SPEED_MS)) {
        comm_log(LOG_LEVEL_WARN, "JUMP: blocked — forward speed %.2f m/s too high", v);
        return false;
    }
    if (-v > param_get(PARAM_JUMP_ARM_MAX_BWD_SPEED_MS)) {
        comm_log(LOG_LEVEL_WARN, "JUMP: blocked — backward speed %.2f m/s too high", -v);
        return false;
    }
    float yaw_rate = imu_yaw_rate();
    if (fabsf(yaw_rate) > param_get(PARAM_JUMP_ARM_MAX_YAW_RATE_RADS)) {
        comm_log(LOG_LEVEL_WARN, "JUMP: blocked — yaw rate %.2f rad/s too high", yaw_rate);
        return false;
    }
    float roll = imu_roll();
    if (fabsf(roll) > param_get(PARAM_JUMP_ARM_MAX_ROLL_RAD)) {
        comm_log(LOG_LEVEL_WARN, "JUMP: blocked — roll %.2f rad too high", roll);
        return false;
    }
    return true;
}
bool stateMachine_request_jump() {
    if (param_get(PARAM_JUMP_ENABLE) < 0.5f) {
        comm_log(LOG_LEVEL_WARN, "JUMP: blocked — jump_enable=0");
        return false;
    }
    if (g_state.state != STATE_RUNNING) return false;
    if (!jump_arm_motion_ok()) return false;
    s_req_jump = true;
    return true;
}
void stateMachine_ping_gui_watchdog()   { s_last_gui_packet_ms = millis(); }
uint32_t stateMachine_ms_since_gui_packet() { return millis() - s_last_gui_packet_ms; }
bool stateMachine_is_estop_hip_ramping() { return s_estop_hip_ramping; }
