fernandomierhicks/wheeled-leg-robot/radio/sdcard/MODELS/model90.yml

semver: 3.0.0
header: 
   name: "WLR ROBOT"
   modelId: 
      0: 
         val: 1
   bitmap: "wlrrobot.png"
   labels: "Robot"
mixData: 
 -
   destCh: 0
   srcRaw: "I3"
   carryTrim: 1
   mixWarn: 0
   mltpx: ADD
   delayPrec: 0
   speedPrec: 0
   flightModes: 000000000
   weight: 100
   offset: 0
   swtch: "NONE"
   delayUp: 0
   delayDown: 0
   speedUp: 0
   speedDown: 0
   name: "Roll"
 -
   destCh: 1
   srcRaw: "I1"
   carryTrim: 1
   mixWarn: 0
   mltpx: ADD
   delayPrec: 0
   speedPrec: 0
   flightModes: 000000000
   weight: 100
   offset: 0
   swtch: "NONE"
   delayUp: 0
   delayDown: 0
   speedUp: 0
   speedDown: 0
   name: "Vel"
 -
   destCh: 2
   srcRaw: "I2"
   carryTrim: 1
   mixWarn: 0
   mltpx: ADD
   delayPrec: 0
   speedPrec: 0
   flightModes: 000000000
   weight: 100
   offset: 0
   swtch: "NONE"
   delayUp: 0
   delayDown: 0
   speedUp: 0
   speedDown: 0
   name: "Hip"
 -
   destCh: 3
   srcRaw: "I0"
   carryTrim: 1
   mixWarn: 0
   mltpx: ADD
   delayPrec: 0
   speedPrec: 0
   flightModes: 000000000
   weight: 100
   offset: 0
   swtch: "NONE"
   delayUp: 0
   delayDown: 0
   speedUp: 0
   speedDown: 0
   name: "Yaw"
 -
   destCh: 4
   srcRaw: "SB"
   carryTrim: 1
   mixWarn: 0
   mltpx: ADD
   delayPrec: 0
   speedPrec: 0
   flightModes: 000000000
   weight: 100
   offset: 0
   swtch: "NONE"
   delayUp: 0
   delayDown: 0
   speedUp: 0
   speedDown: 0
   name: "Log"
 -
   destCh: 5
   srcRaw: "SF"
   carryTrim: 1
   mixWarn: 0
   mltpx: ADD
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
      curve: 0
      name: "PROF"
   9: 
      min: 0
      max: 0
      ppmCenter: 0
      offset: 0
      symetrical: 0
      revert: 0
      curve: 0
      name: "ARM"
   10: 
      min: 0
      max: 0
      ppmCenter: 0
      offset: 0
      symetrical: 0
      revert: 0
      curve: 0
      name: "CALIB"
   11: 
      min: 0
      max: 0
      ppmCenter: 0
      offset: 0
      symetrical: 0
      revert: 0
      curve: 0
      name: "RESET"
   13: 
      min: 0
      max: 0
      ppmCenter: 0
      offset: 0
      symetrical: 0
      revert: 0
      curve: 0
      name: "LATCH"
   14: 
      min: 0
      max: 0
      ppmCenter: 0
      offset: 0
      symetrical: 0
      revert: 0
      curve: 0
      name: "LEAN"
   12: 
      min: 0
      max: 0
      ppmCenter: 0
      offset: 0
      symetrical: 0
      revert: 0
      curve: 0
      name: "TUNEG"
expoData: 
 -
   mode: 3
   scale: 0
   trimSource: 0
   srcRaw: "Rud"
   weight: 100
   offset: 0
   swtch: "NONE"
   curve: 
      type: 1
      value: 0
   chn: 0
   flightModes: 000000000
   name: "Yaw"
 -
   mode: 3
   scale: 0
   trimSource: 0
   srcRaw: "Ele"
   weight: 100
   offset: 0
   swtch: "NONE"
   curve: 
      type: 1
      value: 0
   chn: 1
   flightModes: 000000000
   name: "Vel"
 -
   mode: 3
   scale: 0
   trimSource: 0
   srcRaw: "Thr"
   weight: 100
   offset: 0
   swtch: "NONE"
   curve: 
      type: 1
      value: 0
   chn: 2
   flightModes: 000000000
   name: "Hip"
 -
   mode: 3
   scale: 0
   trimSource: 0
   srcRaw: "Ail"
   weight: 100
   offset: 0
   swtch: "NONE"
   curve: 
      type: 1
      value: 0
   chn: 3
   flightModes: 000000000
   name: "Roll"
inputNames: 
   0: 
      val: "Yaw"
   1: 
      val: "Vel"
   2: 
      val: "Hip"
   3: 
      val: "Roll"
logicalSw: 
   0: 
      func: FUNC_VPOS
      def: "ch(9),50"
      andsw: "NONE"
      delay: 0
      duration: 0
   1: 
      func: FUNC_VPOS
      def: "ch(5),50"
      andsw: "NONE"
      delay: 0
      duration: 0
   2: 
      func: FUNC_VPOS
      def: "ch(10),50"
      andsw: "NONE"
      delay: 0
      duration: 0
customFn: 
   0: 
      swtch: "L1"
      func: PLAY_TRACK
      def: "wlrarm,1,1x"
   1: 
      swtch: "!L1"
      func: PLAY_TRACK
      def: "wlrdis,1,1x"
   2: 
      swtch: "L3"
      func: PLAY_TRACK
      def: "wlrcal,1,1x"
   3: 
      swtch: "SBd"
      func: LOGS
      def: "10,1"
   4: 
      swtch: "SBd"
      func: PLAY_TRACK
      def: "wlrlog,1,1x"
   5: 
      swtch: "!SBd"
      func: PLAY_TRACK
      def: "wlrlgf,1,1x"
timers: 
   0: 
      start: 0
      swtch: "L1"
      value: 0
      mode: ON
      countdownBeep: 0
      minuteBeep: 1
      persistent: 0
      countdownStart: 0
      showElapsed: 0
      extraHaptic: 0
      name: "ARMED"
switchWarning: 
   SA: 
      pos: up
   SB: 
      pos: up
   SC: 
      pos: up
   SD: 
      pos: up
   SE: 
      pos: up
   SF: 
      pos: up
moduleData: 
   0: 
      type: TYPE_CROSSFIRE
      subType: 0
      channelsStart: 0
      channelsCount: 16
      failsafeMode: NOT_SET
      mod: 
         crsf: 
            telemetryBaudrate: 0
            crsfArmingMode: 0
            crsfArmingTrigger: "NONE"
screenData: 
   0: 
      LayoutId: "Layout1x1"
      layoutData: 
         zones: 
            0: 
               widgetName: "WLR HUD"
               widgetData: 
                  options: 
                     0: 
                        type: Bool
                        value: 
                           boolValue: 1
                     1: 
                        type: Color
                        value: 
                           color: COLIDX4
         options: 
            0: 
               type: Bool
               value: 
                  boolValue: 0
            1: 
               type: Bool
               value: 
                  boolValue: 0
            2: 
               type: Bool
               value: 
                  boolValue: 0
            3: 
               type: Bool
               value: 
                  boolValue: 0
            4: 
               type: Bool
               value: 
                  boolValue: 0
   1: 
      LayoutId: "Layout1x1"
      layoutData: 
         zones: 
            0: 
               widgetName: "Outputs"
               widgetData: 
                  options: 
                     0: 
                        type: Signed
                        value: 
                           signedValue: 1
                     1: 
                        type: Bool
                        value: 
                           boolValue: 0
                     2: 
                        type: Color
                        value: 
                           color: COLIDX5
                     3: 
                        type: Color
                        value: 
                           color: COLIDX1
                     4: 
                        type: Color
                        value: 
                           color: COLIDX4
         options: 
            0: 
               type: Bool
               value: 
                  boolValue: 1
            1: 
               type: Bool
               value: 
                  boolValue: 0
            2: 
               type: Bool
               value: 
                  boolValue: 0
            3: 
               type: Bool
               value: 
                  boolValue: 1
            4: 
               type: Bool
               value: 
                  boolValue: 0
customSwitches: 
   SW1: 
      name: "TUNE G0"
      type: 2POS
      group: 1
      start: START_OFF
      state: 0
      onColorLuaOverride: OFF
      offColorLuaOverride: OFF
      onColor: 
         r: 255
         g: 180
         b: 0
      offColor: 
         r: 0
         g: 0
         b: 0
   SW2: 
      name: "TUNE G1"
      type: 2POS
      group: 1
      start: START_OFF
      state: 0
      onColorLuaOverride: OFF
      offColorLuaOverride: OFF
      onColor: 
         r: 255
         g: 180
         b: 0
      offColor: 
         r: 0
         g: 0
         b: 0
   SW3: 
      name: "TUNE G2"
      type: 2POS
      group: 1
      start: START_OFF
      state: 0
      onColorLuaOverride: OFF
      offColorLuaOverride: OFF
      onColor: 
         r: 255
         g: 180
         b: 0
      offColor: 
         r: 0
         g: 0
         b: 0
   SW4: 
      name: "LATCH"
      type: TOGGLE
      group: 0
      start: START_OFF
      state: 0
      onColorLuaOverride: OFF
      offColorLuaOverride: OFF
      onColor: 
         r: 46
         g: 230
         b: 138
      offColor: 
         r: 0
         g: 0
         b: 0
   SW5: 
      name: "LEAN"
      type: 2POS
      group: 0
      start: START_OFF
      state: 0
      onColorLuaOverride: OFF
      offColorLuaOverride: OFF
      onColor: 
         r: 0
         g: 229
         b: 255
      offColor: 
         r: 0
         g: 0
         b: 0
   SW6: 
      name: ""
      type: NONE
      group: 0
      start: START_OFF
      state: 0
      onColorLuaOverride: OFF
      offColorLuaOverride: OFF
      onColor: 
         r: 255
         g: 255
         b: 255
      offColor: 
         r: 0
         g: 0
         b: 0
cfsGroupOn: 
   1: 
      v: 0
   2: 
      v: 0
   3: 
      v: 0
displayChecklist: 0
checklistInteractive: 0
disableThrottleWarning: 0
thrTraceSrc: Thr
view: 0
radioThemesDisabled: GLOBAL
radioGFDisabled: GLOBAL
radioTrainerDisabled: GLOBAL
modelHeliDisabled: GLOBAL
modelFMDisabled: GLOBAL
modelCurvesDisabled: GLOBAL
modelGVDisabled: GLOBAL
modelLSDisabled: GLOBAL
modelSFDisabled: GLOBAL
modelCustomScriptsDisabled: GLOBAL
modelTelemetryDisabled: GLOBAL
telemetryProtocol: 0
ignoreSensorIds: 0
showInstanceIds: 0
rssiSource: none
rfAlarms: 
   warning: 45
   critical: 42
disableTelemetryWarning: 1
thrTrim: 0
thrTrimSw: 0
throttleReversed: 0
enableCustomThrottleWarning: 0
customThrottleWarningPosition: 0
extendedLimits: 0
extendedTrims: 0
trimInc: 0
displayTrims: 0
beepANACenter: 0
noGlobalFunctions: 0
potsWarnEnabled: 0
potsWarnMode: WARN_OFF
jitterFilter: GLOBAL
modelRegistrationID: ""
usbJoystickExtMode: 0
usbJoystickIfMode: JOYSTICK
usbJoystickCircularCut: 0
topbarData: 
   zones: 
      4:
         widgetName: "Radio Info"
         widgetData: 
            options: 
               0:
                  type: Color
                  value: 
                     color: 0xF04030
               1:
                  type: Color
                  value: 
                     color: 0xF8C000
               2:
                  type: Color
                  value: 
                     color: 0x48AC50
      5:
         widgetName: "Date Time"
         widgetData: 
            options: 
               0:
                  type: Color
                  value: 
                     color: COLIDX1
topbarWidgetWidth: 
   0:
      val: 1
   1:
      val: 1
   2:
      val: 1
   3:
      val: 1
   4:
      val: 1
   5:
      val: 1
