fernandomierhicks/wheeled-leg-robot/(commit log)

2026-03-17 Initial commit — wheeled-leg robot project
    Full project snapshot: MuJoCo 4-bar sim, firmware scaffold, params,
    docs, and Claude Code config. CAD STEP/STL files excluded (>50 MB).
    [4bar_base.xml, 4bar_jump.xml, 4bar_leg.xml, femur_jump.xml, force_log.csv, fourbar.xml, results.csv, robot_params.yaml]
2026-03-17 Add arena walls, platforms, and ramps to simulation environment
    - 5m x 5m enclosure with 4 concrete walls (0.5m tall)
    - 12 wide platforms: 5 low (3-5cm), 7 taller (7-11cm)
    - 5 ramps at 5-8 degree slopes, floor-flush base
    - All heights at 50% of initial design after user feedback
2026-03-17 Rebaseline wheel motor — 5065 130KV outrunner replaces Maytech 7052 hub
    - BOM: swap WHEEL_MOTOR to 5065 130KV (200g, $30), add WHEEL_TYRE entry
    (PLA hub 45g + TPU tread 25g = 70g); totals now 2798g / $625
    - sim_config: update m_wheel=0.270kg, WHEEL_TORQUE_LIMIT=3.67Nm,
    WHEEL_OMEGA_NOLOAD=326.7 rad/s, WHEEL_B_FRICTION=0.02
    - motor_models: update wheel motor docstring to match new specs
2026-03-17 Trim and update CLAUDE.md; fix COMPONENTS.md for 5065 wheel motor
    - CLAUDE.md: remove duplicate BOM table, update architecture to baseline1
    geometry (173.78 mm femur etc.), fix wheel motor to 5065 130KV, update
    sim section to describe baseline1_leg_analysis, refresh open tasks
    - COMPONENTS.md: Maytech 380g → 5065 130KV 200g, wheel 30g TPU →
    70g PLA hub + TPU tread; subtotals and summary recalculated (3018g → 2738g)
2026-03-17 Implement LQR balance controller with systematic parameter tuning
    - Create LQR_controller/ parallel folder with complete implementation
    * lqr_design.py: 4-step LQR design pipeline (params → A,B → CARE → K)
    * lqr_parameter_sweep.py: 25-config grid search (Q[0,0]=50-200, R=0.05-1.0)
    * viewer.py: PID/LQR blending with interactive slider (0.0-1.0 fade)
    * test_lqr_integration.py: Validates control law execution
    - LQR state vector: [pitch, pitch_rate, wheel_pos, wheel_vel]
    - Wheel position tracking: Integrate velocities in control loop
    - Blending formula: u = (1-factor)*u_pid + factor*u_lqr
    - Sweep results: Q[0,0]=50, R=1.0 optimal (settling 0.73s, overshoot 2.89°)
    Recommended g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
2026-03-17 Document Session 4 findings: self-balance LQR complete, drive needs architecture redesign
    ## Summary
    - Completed behavioral test framework (test_behavioral.py)
    - Completed evolutionary LQR optimization (optimize_self_balance.py)
    Best found: Q=16.96, R=1.514 with RMS pitch wobble 0.10°
    - Completed visualization tool (run_scenario_visual.py)
    ## Key Finding
    Drive scenario reveals fundamental architecture conflict: single LQR state
    [pitch_error, pitch_rate, wheel_pos, wheel_vel] cannot simultaneously:
    - Hold position (for self-balance)
    - Allow position changes (for drive)
    Tried 5 approaches; all failed. Proper solution requires redesign:
    Option A (hierarchical): inner LQR pitch damper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
2026-03-17 Add full control architecture plan and Session 4 artifacts
    docs/Control.MD: complete 6-phase control strategy — 3-state balance LQR
    with Ascento-style gain scheduling, velocity PI outer loop, yaw PI differential
    drive, leg impedance suspension, and jump recovery state machine. Includes
    per-controller tuning strategy and granular Haiku agent step tables.
    Also commits Session 4 optimizer artifacts: best_solution.json (Q=16.96,
    R=1.51, RMS pitch 0.10°), optimization_log.csv, lqr_sweep_results.csv,
    optimize_self_balance.py, run_scenario_visual.py, test_behavioral.py.
    [lqr_sweep_results.csv, optimization_log.csv]
2026-03-17 Phase 1.1: Add q_hip parameter to compute_lqr_gain(); flag asymmetric leg control as future task
    - Modified compute_lqr_gain() to accept q_hip parameter (defaults to Q_NEUTRAL)
    - Function now computes l_eff at given hip angle via solve_ik(q_hip, p)
    - Added comprehensive test showing gains differ across stroke range (RET/NOM/EXT)
    - Gains K differ significantly: ||K_RET - K_NOM|| = 142.46, ||K_NOM - K_EXT|| = 62.34
    - l_eff changes: 0.106 m (retracted) → 0.172 m (nominal) → 0.295 m (extended)
    - Currently assumes symmetric leg operation (both at same angle)
    - Flagged independent leg control (asymmetric q_hip_L, q_hip_R) as future task in HANDOFF.md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
    [force_log.csv]
2026-03-17 Phase 1.2: Convert 4-state LQR to 3-state (remove wheel_pos)
    - Changed system state from [pitch, pitch_rate, wheel_pos, wheel_vel] to [pitch, pitch_rate, wheel_vel]
    - Updated A matrix from 4x4 to 3x3, B matrix from 4x1 to 3x1
    - Updated Q cost matrix from diag([100, 1, 1, 0.1]) to diag([100, 1, 0.1])
    - Updated compute_lqr_gain() function to use 3-state matrices
    - 3-state gains: K = [-72.56, -12.20, -1.00] for nominal leg height
    - All eigenvalues negative real (stable): -58.4, -7.76, -3.23
    - Step response settles in ~3-4 seconds
    - Gain scheduling still varies across leg heights: ||K_RET-K_NOM||=107, ||K_NOM-K_EXT||=37.97
    - Updated sim_config.py with new 3-state LQR_K gains
    - Enables hierarchic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
2026-03-17 Add test_3state_lqr.py: quick validation of 3-state LQR control law
    Tests confirm:
    - 3-state gains loaded correctly from sim_config (shape 3,)
    - Control law is corrective: 5 deg pitch error -> +6.3 Nm torque
    - Closed-loop system stabilizes pitch disturbance
    - Linear simulation settles in ~3-4 seconds
    - Gain scheduling foundation verified: gains differ 107 Nm (RET->NOM), 37 Nm (NOM->EXT)
    This is a quick sanity check before implementing gain scheduling (Steps 1.3-1.5).
2026-03-17 Disable blend slider: use 100% 3-state LQR control
    - Commented out matplotlib Slider widget for LQR blending
    - Set blend_factor = 1.0 (use pure LQR, no PID)
    - Disabled BLEND command handler in simulation loop
    - Self-balance scenario now runs with pure 3-state LQR control
    Visualization confirmed working:
    - No dimension mismatch errors
    - 3-state state vector properly constructed
    - Control torques applied to wheels
    - MuJoCo viewer launches and runs simulation
    Next: implement gain scheduling (Steps 1.3-1.4) for adaptive gains across leg heights.
2026-03-17 Fix run_scenario_visual.py: update to 3-state LQR
    - Changed _lqr_state from 4-state to 3-state: [pitch_err, pitch_rate, wheel_vel]
    - Removed wheel_pos from state vector (handled by outer Velocity PI loop)
    - Updated both self_balance and drive scenarios
    - Visualization now runs without dimension mismatch errors
2026-03-17 Add diagnose_viewer.py: interactive debugging for visualization issues
    - Launches MuJoCo viewer with proper initialization (IK + equilibrium pitch)
    - Extracts pitch correctly from body quaternion (not from qpos)
    - Uses dynamically computed LQR K gains (matches run_scenario_visual.py)
    - Provides step-by-step diagnostics: model build, indices, motors, init, viewer, sim loop
    - Shows detailed error output for debugging viewer crashes
    Current finding: 3-state LQR is UNSTABLE in nonlinear MuJoCo physics
    - Pitch grows from -2° to 50-90° over first 4-5 seconds
    - Control torques exceed motor limits (50+ Nm vs 3.67 Nm limit)
    - This likely causes the viewer window to close on user machines
    This is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
2026-03-17 Fix diagnose_viewer.py: correct body/joint ID lookups and add equilibrium pitch feedforward
    - Fix body name from 'body' to 'box' to match MuJoCo model
    - Use model.jnt_dofadr[] for proper DOF address lookups (was using name2id directly on DOF)
    - Add validation to catch missing entities and provide helpful error messages
    - Add equilibrium pitch target based on hip angle (accounts for 4-bar linkage geometry)
    - Update TODO with next phase: LQR control architecture from docs/Control.MD
2026-03-18 Phase 1 Complete: Baseline optimized 3-state LQR controller with gain scheduling
    - Implemented 3-state LQR with gain scheduling across leg stroke
    - Optimized Q/R weights via (1+8)-ES: 50 gen, 400 evals
    - Baseline gains: Q=[0.158, 0.00419, 0.00196], R=0.451
    - Performance: 5.428 combined fitness (20% balance + 80% disturbance)
    - Baseline1 equivalent: RMS pitch 1.44° (still), survives 1N disturbance for 1s
    - Updated Control.MD with Phase 1 findings and implementation details
    - Updated CLAUDE.md to point to Control.MD for control architecture
    - LQR_Control_optimization now standalone, production-ready
    Run 819 baseline: stable balance + robust disturbance recovery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
2026-03-18 Phase 1 re-baselined: 8496-eval LQR optimizer run, new gains Q/R
    - Re-baselined LQR weights from 10-min / 8-worker optimizer run (1062 gen, 8496 evals)
    Q=[0.0438, 0.0021, 0.0001], R=9.027 → fitness=0.400, RMS pitch=0.113°, max=0.363°
    - Fixed replay.py: was using PD defaults; now loads Q/R from CSV and recomputes K_table
    - Archived old LQR_controller/ → LQR_controller_OUTDATED/
    - HANDOFF.md: added obstacle and turning path-forward plans
    - docs/Control.MD, CLAUDE.md: updated with new gains, metrics, and Phase 1 v2 notes
    [force_log.csv, lqr_sweep_results.csv, optimization_log.csv, results.csv]
2026-03-18 Phase 2: Add drive+obstacle scenarios and VelocityPI to LQR optimizer
    New simulation scenarios (all headless, work with existing LQR):
    - run_drive_slow_scenario: 0.3 m/s fwd/bwd with VelocityPI lean control
    - run_drive_medium_scenario: 0.8 m/s fwd/bwd
    - run_obstacle_scenario: 0.3 m/s + 3cm floor step at x=0.5m
    Architecture:
    - VelocityPI class: velocity error -> theta_ref (lean angle command)
    theta_ref > 0 = forward drive; sign convention empirically verified
    - lqr_torque() extended with theta_ref=0.0 default (backward compatible)
    - _run_sim_loop() shared core loop for all drive/obstacle scenarios
    - build_xml() extended with obstacle_height=0.0 (floor step geometry)
    Optimizer (6-param sea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
2026-03-18 Phase 2 complete: balance-only optimizer, bearing fix, scenario polish
    Key changes:
    - physics.py: fix get_equilibrium_pitch to include bearing pin masses (4×12g×2 legs),
    correcting pitch_ff from -1.99° to +1.92° — eliminates backward drift
    - scenarios.py: balance fitness simplified (wheel_travel only, liftoff=instant kill);
    run_combined_scenario gains active_scenarios param for single/multi-scenario switching
    - optimize_lqr.py: add ACTIVE_SCENARIOS=['balance'], SEED_WEIGHTS with Q_VEL=0.02,
    SIGMA_LOG_INIT=0.50; thread active_scenarios through worker args
    - replay.py: add --freefall and --slowmo flags
    - sim_config.py: Phase 2 baseline gains committed
    - results.csv: cleared to bala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
    [results.csv]
2026-03-18 Phase 2 Complete: VelocityPI wired with correct sign, optimized gains
    - Fix velocity sign: vel_est_ms = wheel_vel * WHEEL_R (+ve = forward)
    Previous negation caused positive feedback in VelocityPI
    - Optimize KP_V=0.299, KI_V=0.500 (balance-only, 3032 evals, 2 min)
    fitness=0.142m wheel travel (was 2.94m, 20x improvement)
    - replay.py: 4-panel telemetry (pitch + commanded pitch overlay,
    torque, hip angle, robot velocity m/s)
    - replay.py: v_desired slider (±1 m/s) feeds VelocityPI directly
    - replay.py: Drive ON/OFF toggle, XYZ world frame axes in viewer
    - sim_config.py: updated VELOCITY_PI_KP/KI to optimized values
    - HANDOFF.md + Control.MD: updated to reflect Phase 2 complete,
    next ste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
    [results.csv]
2026-03-18 Phase 2 baselined: VelocityPI optimized, drive scenarios added, docs updated
    - Optimized VelocityPI gains (KP=0.503, KI=0.013) via combined S2+S3 scenario
    - Added optimize_vel_pi.py with (1+8)-ES optimizer and progress window
    - Added vis_scenario1.py for S1 telemetry visualization
    - Updated Control.MD and HANDOFF.md with Phase 2 status and next steps
    - Refreshed results CSVs with latest run data
    [results.csv, results_1_LQR_pitch_step.csv, results_combined_PI.csv]
2026-03-18 Phase 2 re-baselined on S4/S5: LQR + VelocityPI tuned on harder scenarios with leg cycling and obstacles
    [results.csv, results_4_leg_height_gain_sched.csv, results_5_VEL_PI_leg_cycling.csv, results_combined_PI.csv]
2026-03-18 Phase 3: YawPI controller — class, differential torque, S6 scenario, optimizer
    - Add YawPI class to scenarios.py (mirrors VelocityPI pattern)
    kp=0.3 N·m/(rad/s), ki=0.05 N·m/rad, torque_max=0.5 N·m
    - Add USE_YAW_PI flag (default True); disable for LQR/VelocityPI-only tests
    - Wire differential torque into _run_sim_loop via omega_profile_fn=None:
    tau_L = tau_sym - tau_yaw (right wheel gets more for left turn)
    tau_R = tau_sym + tau_yaw
    Sign verified: omega=+1 rad/s → +26.5° CCW yaw ✓
    - Add yaw_track_rms_rads metric to _run_sim_loop return dict
    - Add Scenario 6 (6_YAW_PI_turn): pure 360° CCW turn at 1 rad/s, 8s
    Starting gains: yaw_rms=0.045 rad/s, pitch=3.3°, survived=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
2026-03-18 Phase 3 complete: YawPI + sandbox arena, docs updated for Phase 4
    - replay.py: yaw rate telemetry panel, omega_desired slider, Turn ON/OFF,
    differential torque (tau_L = tau_sym - tau_yaw, tau_R = tau_sym + tau_yaw)
    - sandbox.py: interactive free-drive arena, 28 obstacles 1-8 cm,
    v/omega/hip sliders, gamepad support (axes 1/2/3), Drive+Turn ON by default
    - physics.py: build_xml() extended with sandbox_obstacles + floor_size params
    - HANDOFF.md: Phase 3 marked complete, Phase 4 leg suspension task spelled out
    - docs/Control.MD: Phase 3 section updated with implementation details and results
    - LQR_controller_OUTDATED/: removed obsolete files
    - LQR_Control_optimization/handoff.md: removed (s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
    [force_log.csv, lqr_sweep_results.csv, optimization_log.csv]
2026-03-19 Phase 4 complete: Leg Impedance + Roll Leveling — baselined and visualized
    Controller:
    - Leg impedance PD: K_s=16.0 N·m/rad, B_s=0.822 N·m·s/rad
    - Roll leveling (differential hip): K_ROLL=3.964, D_ROLL=1.0
    - Hip safe range: ±10° buffer from joint limits (HIP_SAFE_MIN/MAX)
    - Single source of truth in sim_config.py — no duplicated gains
    Optimizer (optimize_suspension.py):
    - (1+8)-ES, combined S5+S8 fitness, 177 gens / 1416 evals / 5 min
    - Best fitness: 4.11 (seed was ~20.16)
    Scenario 8 (one-sided bumps):
    - Alternating left/right bumps at y=±LEG_Y to exercise roll in both directions
    - Metric: max_roll_deg (peak spike, not RMS)
    replay.py:
    - 8-panel 4×2 telemetry: pitch, velocity, y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
    [results_suspension_combined.csv]
2026-03-19 Re-baseline Yaw PI and Suspension from long optimizer runs (75+90 min)
    Yaw PI (55752 evals, 75 min, fitness=0.4102):
    KP_YAW: 0.3 → 2.272 (+7.6×)
    KI_YAW: 0.05 → 1.125 (+22.5×)
    Previous gains were visual only; optimizer found much more aggressive response needed.
    Suspension (25016 evals, 90 min, fitness=4.0918):
    K_s=16.0 (unchanged), B_s: 0.8216 → 0.7987, K_ROLL=4.0, D_ROLL=1.0
    Confirmed K_s/K_ROLL/D_ROLL all at upper bounds — bounds are correct.
2026-03-19 Tune velocity responsiveness: KP_V 2× and rate limit 2.5×
    VELOCITY_PI_KP: 0.251209 → 0.502418 (2×, matches pre-S5 known-good baseline)
    THETA_REF_RATE_LIMIT: 2.0 → 5.0 rad/s (2.5×, lean ramp ~52ms vs 130ms)
    Manually tuned in sandbox — 1.0/10.0 too aggressive, 0.75/7.5 slightly too much,
    0.50/5.0 felt right. VelocityPI_KI unchanged (0.011405).
2026-03-19 Baseline manual velocity tuning — optimizer gains too conservative
    Sandbox testing showed optimizer-tuned KP_V (0.251) felt sluggish.
    Doubled KP_V and raised rate limit 2.5× based on sandbox feel.
    VELOCITY_PI_KP: 0.251209 → 0.502418
    THETA_REF_RATE_LIMIT: 2.0 → 5.0 rad/s
    VELOCITY_PI_KI: unchanged (0.011405)
2026-03-19 HANDOFF: update stale gains, document Phase 5 (back-EMF motor model)
    - Phase 2: updated to sandbox-retuned KP_V=0.502, rate_limit=5.0
    - Phase 3: updated to optimizer gains KP_YAW=2.272, KI_YAW=1.125
    - Phase 4: updated to re-opt gains B_s=0.799, K_ROLL=4.0
    - Phase 5 proposal: realistic wheel back-EMF taper in control loop
2026-03-19 Fix sandbox telemetry tuple mismatch (15 vs 18 values)
    _plot_process expected 18 values after Phase 5 battery panel expansion,
    but push loop was sending 15 (missing v_batt, soc_pct, batt_temp_c).
    Added real battery state values to match the 5×2 telemetry layout.
2026-03-19 Phase 6: realistic 6S LiPo battery model + telemetry overhaul
    - battery_model.py (new): BatteryModel with OCV-SoC curve, R_int(SoC,T),
    Coulomb counting, and 1st-order thermal model
    - sim_config.py: add 13 battery constants + HIP_KT_OUTPUT
    - scenarios.py: voltage-scaled motor_taper(), _motor_currents() helper,
    battery.step() integrated into all 6 control loops
    - sandbox.py / replay.py: battery instance, per-motor current telemetry
    (I_whl_L/R, I_hip_L/R, I_total), 22-value tuple, 120 Hz update rate;
    remove drive sliders, combine battery V+T on one axis, new currents panel,
    logically reordered 5×2 chart layout
2026-03-19 Phase 6 plan: latency model docs + HANDOFF updated, sandbox changes
    - docs/Latencies.MD: new §5 with ring-buffer implementation plan, delay constants, granularity table, BNO086 400Hz note
    - HANDOFF.md: Phase 5 (back-EMF) marked complete, Phase 6 (latency model) added as NEXT with full plan
    - sandbox.py, TODO.txt: misc updates from session
2026-03-19 Phase 6: latency_sensitivity/ framework + optimization plan
    - New folder latency_sensitivity/ (copy of LQR_Control_optimization/) with ring-buffer delays:
    sensor 10 steps (5 ms), actuator 5 steps (2.5 ms)
    - sim_config.py: USE_LATENCY_MODEL, SENSOR_DELAY_S, ACTUATOR_DELAY_S constants
    - scenarios.py: collections.deque sensor + actuator ring buffers in _run_sim_loop
    - sandbox.py: same ring buffers + reset on _reset_state + import fix
    - docs/Control.MD: new "Optimizing with Latencies" section (Steps 0-4 with rationale)
    [results_1_LQR_pitch_step.csv, results_4_leg_height_gain_sched.csv, results_5_VEL_PI_leg_cycling.csv, results_combined_PI.csv, results_suspension_combined.csv]
2026-03-19 Phase 6 Step 1 baselined: LQR re-tuned for delayed plant on S4
    - latency_sensitivity/sim_config.py: new LQR gains (Q=[0.0634, 0.000219, 0.000011], R=1.98)
    - optimize_lqr.py: ACTIVE_SCENARIO=S4, SEED_WEIGHTS from Step 0 result
    - All result CSVs cleared (latency_sensitivity/) — clean slate for remaining steps
    - docs/Control.MD: Steps 0+1 marked done with results tables
    - HANDOFF.md: Phase 6 updated, Step 2 (VelocityPI) written up as NEXT
    [results_1_LQR_pitch_step.csv, results_4_leg_height_gain_sched.csv, results_5_VEL_PI_leg_cycling.csv, results_combined_PI.csv, results_suspension_combined.csv]
2026-03-20 Phase 6: full latency-model gain sweep — LQR, VelocityPI, YawPI, Suspension
    All controllers re-optimised in simulation/mujoco/latency_sensitivity/ with 6ms
    sensor + 2.5ms actuator ring-buffer delays active.
    Key findings:
    - LQR (S4): Q_PITCH↑4.5×, Q_PITCH_RATE↓154×, Q_VEL↓23×, R↓14× vs zero-latency
    Stale rate info destabilises — pitch correction only, rates suppressed
    - VelocityPI (S5): KP_V 0.50→0.376, KI_V 0.011→0.011 (fitness 2.06→6.51)
    Near-zero KP was artefact of stiff suspension; resolved after suspension re-opt
    - YawPI (S6): KP_YAW −3%, KI_YAW −62% — integrator wind-up with stale yaw rate
    - Suspension (combined S5+S8): K_S 16→2.04 (↓8×), B_S 0.8→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
    [results_2_VEL_PI_disturbance.csv, results_4_leg_height_gain_sched.csv, results_6_YAW_PI_turn.csv, results_suspension_combined.csv]
2026-03-20 Phase 6 post-processing: replay fixes, sandbox_fastchart, pipeline, log reorganisation + doc cleanup
    - latency_sensitivity: S6/S7 replay bugs fixed (turn_active NameError, S7 omega_desired missing)
    - latency_sensitivity: CSVs moved to logs/S{name}.csv; archive/ for old results; pipeline.py added
    - latency_sensitivity: sandbox_fastchart.py (pyqtgraph arena), thermal_model.py added
    - LQR_Control_optimization: S8 bump reduced to 1 (left 5cm at x=1.2m); results_6 CSV added
    - components/characterization/: motor dyno scripts + curves added
    - misc/fastchart.py: shared chart helper
    - Docs: CLAUDE.md + HANDOFF.md + Control.MD self-consistency pass (dates, Yaw gains 0.3→2.272,
    latency steps 3/4 or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
    [S1_LQR_pitch_step.csv, S2_leg_height_gain_sched.csv, S3_VEL_PI_disturbance.csv, S4_VEL_PI_staircase.csv, S5_VEL_PI_leg_cycling.csv, S6_YAW_PI_turn.csv, S7_DRIVE_TURN.csv, S8_terrain_compliance.csv]
2026-03-21 Consolidate sim into master_sim framework, archive old folders
    Move all legacy sim folders (LQR_Control_optimization, latency_sensitivity,
    4bar_*, baseline1_leg_analysis, etc.) to simulation/mujoco/archive/.
    Add new unified master_sim/ package with modular controllers, scenarios,
    optimizer, and physics. Update HANDOFF.md, TODO.txt, and COMPONENTS.md.
    [4bar_base.xml, 4bar_jump.xml, 4bar_leg.xml, S1_LQR_pitch_step.csv, S2_leg_height_gain_sched.csv, S3_VEL_PI_disturbance.csv, S4_VEL_PI_staircase.csv, S5_VEL_PI_leg_cycling.csv]
2026-03-21 Live scenario switching, optimizer DRY-up, and sim_loop cleanup
    - Launcher now spawns a single visualizer process and switches scenarios
    via mp.Queue instead of relaunching subprocesses
    - Extract optimizer/common.py to DRY up the 4 optimizer scripts
    - Add tick_flags property on ScenarioConfig as single source of truth
    - Move metric thresholds from sim_loop constants into MetricThresholds dataclass
    - Visualizer: add world-origin axes, window layout padding constants
    - Use hip_position_torque() helper in sim_loop
    - Delete obsolete verify_phase{0,1,3}.py scripts
    - Temp suspension gain tweaks for step-terrain testing
2026-03-23 Good gains for sim with delay=0; Arduino OTA and IMU
    - Optimized LQR/velocity/yaw/suspension gains for zero-delay plant
    - Added integrated scenario (s09) and optimizer
    - Arduino UNO R4 WiFi firmware: BNO086 IMU over SPI, ESP32-S3 OTA, LED matrix status
    - Reorganized characterization files into Arduino/IMU/motor subdirs
    - Master sim improvements: search space, progress UI, baseline auto-save
    [S_s01_lqr_pitch_step.csv, S_s02_leg_height_gain_sched.csv, S_s03_vel_pi_disturbance.csv, S_s04_vel_pi_staircase.csv, S_s05_vel_pi_leg_cycling.csv, S_s06_yaw_pi_turn.csv, S_s07_drive_turn.csv, S_s08_terrain_compliance.csv]
2026-03-23 UDP telemetry/commands, IMU drain loop, loop timing instrumentation, and LQR A/B interpolation
    Firmware: add binary UDP telemetry (50 Hz) and command receiver (10 Hz) with
    auto-discovered dashboard IP; drain BNO086 event queue via direct INT register
    read to avoid stale data; per-section timing breakdown in 1 Hz heartbeat;
    loop-rate watchdog (faults on >20% drift); OTA reduced to 1 Hz; serial 1 Mbps.
    Simulation: precompute and interpolate continuous A,B matrices across leg stroke
    for state prediction in LQR controller; params and visualizer updates.
    [S_s01_lqr_pitch_step.csv]
2026-03-23 Matrix ZOH predictor replaces scalar Smith predictor for sensor-delay compensation
    - lqr.py: add discretize_AB() using matrix exponential (ZOH)
    - sim_loop.py: SimController pre-computes A_d^n and B_d power series at init;
    tick() propagates delayed 3-state vector x(t-n) forward n steps exactly,
    replacing scalar Euler predict_state/smith_predict; remove physics-rate
    sample_sensors() — sensor buffer now pushed at control rate only
    - params.py: restore good gains (Q_pitch=5.40254, R=39.647); unlock real
    torque limit (Kt × I_max); simplify LatencyParams (drop predict_state flag
    and physics-rate delay helpers); sensor_delay=2 ms, actuator_delay=0
    - visualizer.py: remove stale _replay_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
    [S_s01_lqr_pitch_step.csv]
2026-03-23 Delay predictor analysis, updated TODOs, and pipeline logs
    Replace Master Sim plan with delay/predictor investigation findings
    (no code bug, stability margin issue at ≥2ms delay). Update TODO
    with new tasks (visualizer fixes, estimator delay tests, gyro filter).
    Add pipeline logs from today's runs.
2026-03-24 Delayed controller now works — IMU characterization, firmware telemetry, sim scenarios, and dashboard
    Adds BNO086 IMU characterization suite (datarate, drift, noise, e2e latency tests with analysis scripts),
    firmware UDP telemetry/commands with WiFi manager, simulation scenario updates for delay-compensated LQR,
    and Dear PyGui telemetry dashboard. Cleans up .pio build artifacts from tracking and broadens .gitignore.
    [S_s01_lqr_pitch_step.csv, S_s02_leg_height_gain_sched.csv, S_s03_vel_pi_disturbance.csv]
2026-03-24 Retuned gains (LQR, velocity PI, yaw PI, suspension), scenario fixes, and visualizer layout swap
    - Updated LQR, velocity PI, yaw PI, and suspension gains from optimizer runs
    - Wider Q_RET range, hip target clamping in sim_loop
    - S1 hip_mode → none, S8 adds yaw_pi controller, fix use_suspension logic
    - Swapped hip/wheel torque chart order in both replay and live visualizer
    - Live viz syncs controller checkboxes on scenario switch (CONFIG_UPDATE)
    - Narrowed KFF_V search space, removed stale leg_cycle_Q_RET property
    - Deleted Master Sim plan.md, updated TODO, added JumpController.MD
    [S_s01_lqr_pitch_step.csv, S_s02_leg_height_gain_sched.csv, S_s03_vel_pi_disturbance.csv, S_s04_vel_pi_staircase.csv, S_s05_vel_pi_leg_cycling.csv, S_s06_yaw_pi_turn.csv, S_s07_drive_turn.csv, S_s08_terrain_compliance.csv]
2026-03-25 Retuned suspension gains, S08 scenario fix, jump sim scaffold, and updated logs
    - Suspension gains reoptimized (K_s, B_s, K_roll, D_roll)
    - S08 terrain compliance: disabled yaw controller, formatting cleanup
    - Added master_sim_jump/ scaffold for jump controller development
    - Updated velocity PI and terrain compliance CSV logs + param backups
    - Cleaned up TODO.txt
    [S_s01_lqr_pitch_step.csv, S_s02_leg_height_gain_sched.csv, S_s03_vel_pi_disturbance.csv, S_s04_vel_pi_staircase.csv, S_s05_vel_pi_leg_cycling.csv, S_s06_yaw_pi_turn.csv, S_s07_drive_turn.csv, S_s08_terrain_compliance.csv]
2026-03-25 LED matrix icon rewrite, S09 disturbance cleanup, force arrow viz, and flip analysis script
    [robot_params.yaml]
2026-03-25 Retuned LQR, velocity PI, yaw PI, and suspension gains from optimizer + updated sim logs
    [S_s01_lqr_pitch_step.csv, S_s02_leg_height_gain_sched.csv, S_s03_vel_pi_disturbance.csv, S_s04_vel_pi_staircase.csv, S_s05_vel_pi_leg_cycling.csv, S_s06_yaw_pi_turn.csv, S_s07_drive_turn.csv, S_s08_terrain_compliance.csv]
2026-03-26 ODESC CAN driver, jump controller improvements, and feedforward planning
    - Add odesc_can.cpp/h: CAN bus driver for ODESC wheel encoder feedback and torque commands
    - Wire ODESC CAN init/poll/send into firmware main loop
    - Update CAN node IDs to match actual hardware wiring (hip L=2, R=3, ODESC axes 0/1)
    - Jump controller: flying phase now uses impedance mode to retract legs (tuck + cushion landing)
    - Jump controller: add extend and landing timeouts to prevent stuck states
    - Rewrite HANDOFF.md with feedforward & state estimation improvement plan (FF1-FF4, SE1)
    - Remove stale scratch files (ManualGains.txt, good gains 3-24.py)
    - Update TODO.txt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
    [config.h, main.cpp]
2026-03-26 FF1 hip reaction torque cancellation feedforward implementation
    Adds feedforward term that compensates wheel torque for hip reaction forces,
    with configurable alpha gain and IK-based effective leg length. Wired into
    sim loop, scenarios, visualizer toggle, and sandbox/unified run modes.
2026-03-27 Updated mass estimates, feedforward docs, spring optimizer, and sim improvements
    Corrected wheel motor mass (200→450g each), bringing total robot mass to ~3.5 kg.
    Documented FF1/FF2 feedforward terms in Control.MD. Added detailed component
    breakdown table to COMPONENTS.md. New spring optimizer script. Updated sim
    controllers, physics, and visualizer.
2026-03-28 Add IMU_ONLY/NO_CAN bench-test build modes, auto_stroke_angles, and fix dashboard mode display
    - firmware: IMU_ONLY env strips CAN + controllers for bench testing; NO_CAN stubs in odesc_can
    - imu: replace direct register read with digitalRead(), reduce drain cap 10→4
    - physics: add auto_stroke_angles() to find valid hip stroke range for arbitrary 4-bar geometry
    - dashboard: fix mode label (_last_mode tracking was a no-op stub)
    [dashboard.py, imu.cpp, main.cpp]
2026-03-28 Add staircase obstacle and custom rgba support for sandbox boxes
    - physics.py: sandbox box geoms now respect per-obstacle rgba override
    - visualizer.py: add 3-step staircase (0.18 m rise, 0.28 m run) in purple
    - S_s01 log: updated pitch-step run data
    [S_s01_lqr_pitch_step.csv]
2026-03-30 4-bar geometry optimizer: widen search bounds and add 8h run results
    - Widened search space: L_FEMUR 220→280mm, L_TIBIA 170→220mm, LC 190→240mm, CROUCH_TIME upper 0.35→1.0s, lower 0.10→0.05s
    - Fixed UnicodeEncodeError on Windows (→ arrow in print statement)
    - Best geometry from 8h run (24k evals, converged): L_femur=247mm, L_tibia=220mm, Lc=222mm, L_stub=25mm, crouch_time=0.125s → ~770mm peak body Z (vs 470mm baseline)
    - Added best_jump_params.py with baseline annotations for comparison
    - Updated README bounds table
    [S_s10_jump_geometry.csv]
2026-03-30 Optimizer: wheel-height fitness, mechanical constraints, mass fixes, and jump wheel hold
    - Switch optimizer fitness from peak_body_z to peak_wheel_z (eliminates
    leg-length bias) and add pitch-stability + compactness penalty terms
    - Add analytical mechanical constraint checks (bearing interference,
    link-to-link collisions, wheel-body clearance) to reject infeasible
    geometries before running sim
    - Fix MuJoCo mass double-counting: fold motor/bearing masses into
    <inertial> tags and zero the corresponding geom masses
    - Disable knee spring (K=0) — found not useful for jump performance
    - Add wheel hold gain + reverse feedforward during CROUCH/EXTEND to
    keep wheels stationary during jump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
    [S_s10_jump_geometry.csv]
2026-03-31 Add ODrive characterization GUI and update AI usage in TODO
2026-04-01 Jump controller improvements, visualizer enhancements, and cleanup
    - Extend jump.py with improved flight/landing detection logic
    - Update params.py with new suspension/jump parameters
    - Refactor sim_loop.py sensor and jump control flow
    - Enhance visualizer with jump phase markers and IMU plot updates
    - Update TODO with new tasks and AI usage stats
    - Remove Optimizer4bar.md and fourbaroptimizer.md (consolidated elsewhere)
    - Add BugFixes.MD
2026-04-01 Fix az_imu reading wrong cacc index (5→2)
    Index 5 is angular Z acceleration; index 2 is linear Z.
    At rest az_imu now correctly reads ~9.81 m/s² instead of ~19.5.
2026-04-02 Add RETRACT state, full IMU channels, and sandbox fall-pause
    jump.py: 6-state machine (BALANCE→CROUCH→EXTEND→RETRACT→FLYING→LANDING→SETTLED),
    position-based liftoff (hip reaches Q_EXT) replaces IMU debounce.
    params.py: retract_time/retract_done_rad replace liftoff_debounce_s; wheel_ff_torque=0.
    sim_loop.py: ax/ay/gx/gy/gz IMU channels added; jump ctrl uses undelayed az.
    visualizer.py: sandbox fall freezes sim instead of auto-reset — click Restart to recover;
    replay gains hot-swap, pause/resume, and mode marker index fix.
    [_test_cacc.xml]
2026-04-04 Milestone: ODrive driving motor with absolute encoder feedback
    - Expand ODrive GUI with full characterization suite: velocity/position/torque
    ramp tests, encoder diagnostics, hall sensor test, and live telemetry plots
    - Add CAD: ODrive SLDPRT body part and wheel motor folder
    - Add datasheets: absolute encoder, encoder drawings/pinout, wheel motor dims
    - Add ODESC wiring diagram (drawio)
    - Minor params.py and TODO updates
    [CenteringJig.SLDPRT, Encoder.SLDPRT, M4x16.SLDPRT, Magnet.SLDPRT, Mount.SLDPRT, Odrive.sldprt, Rotor.SLDPRT, Stator.SLDPRT]
2026-04-04 ODrive firmware updated to v0.5.6; probe and docs updated
    - Flashed official ODrive v0.5.6 via STM32CubeProgrammer + Zadig driver reinstall
    - probe_firmware.py: full recursive tree dump, UTF-8 file output, incremental flush
    - probe_results.txt: full attribute tree captured on pre-update dev snapshot
    - odrive.md: comprehensive reference — all params, callables, encoder modes, API quirks
    - updateFirmware.md: step-by-step DFU → flash → driver reinstall procedure
    - This commit marks the baseline before any work begins on 0.5.6 firmware
2026-04-04 Update ODrive docs to confirmed 0.5.6 firmware probe results
    - odrive.md: fully rewritten for 0.5.6 — all attribute paths, new features,
    API diffs vs old snapshot, encoder reconfiguration steps needed after flash
    - probe_results.txt: fresh 0.5.6 full tree capture
    - Key findings: per-axis CAN moved to axis.config.can sub-object,
    thermistors moved into motor, gpio{n}_mode per-pin config, brake resistor
    now needs explicit enable, user_config_loaded=0 (config wiped by flash)
2026-04-05 Add anticogging docs, calibration scripts, and firmware backups
    Full anticogging calibration procedure documented from source-verified
    fw-v0.5.6 behaviour. Added ODrive utility scripts (GUI v2, anticogging
    probing/running, velocity test) and backed up firmware binaries.
2026-04-12 ODESC v4.2 works but web GUI has firmware mismatch issues
    The ODESC v4.2 board runs modified fw v0.5.1, which lacks properties
    the MoonLighTingPY web GUI assumes (e.g. usb_cdc_protocol). Added
    HANDOFF with a fork plan to fix it, ODESK characterization docs, and
    updated TODO/odrive notes with current status.
2026-04-12 Unified ODrive GUI Steps 1-2: core framework, terminal tab, and Claude command interface
    Consolidates 9 standalone scripts + 2 old GUIs into a clean modular PySide6 app.
    Step 1: ODriveManager, error tables, dark theme, connect/status bar.
    Step 2: Terminal REPL (eval namespace: odrv, ax0, ax1), file-based command
    inbox/outbox for Claude automation, continuous odrive_gui.log.
    Old scripts archived to odrive_old/.
    [check_anticog_nvm.py, constants.py, fix_and_spin.py, odrive_errors.py, odrive_gui.py, odrive_manager.py, probe_anticogging.py]
2026-04-12 AS5048A encoder workaround + ODrive GUI Step 3 tabs
    Add SPI Absolute CUI (256) as a selectable encoder type because the
    AS5048A fails under the documented SPI_ABS_AMS (257) mode — leading
    hypothesis is the AS5047P vs AS5048A parity/EF bit swap in the 16-bit
    SPI frame. Mode 256 reads position correctly but still raises spurious
    SPI error bits, so encoder errors are suppressed in the status bar while
    GUI development continues. README documents the quirk, hypothesis, and
    confirmation steps. Also lands the Setup, Control, and Anticogging tabs
    plus core/odrive_operations for the unified GUI, and a direct-SPI
    encoder setup helper script.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
    [constants.py, odrive_gui.py, odrive_operations.py, tab_anticogging.py, tab_control.py, tab_setup.py]
2026-04-12 ODrive GUI Step 6: Inspector tab + AS5048A encoder working with documented workaround
    Add property tree inspector tab with recursive device walk, search/filter,
    and inline editing of writable config properties. AS5048A encoder now
    calibrates successfully via error-suppression + split calibration sequence;
    known SPI parity/EF bit-swap idiosyncrasy documented in README.md with
    permanent fix options.
    [odrive_gui.py, tab_control.py, tab_inspector.py, tab_setup.py]
2026-04-13 ODrive GUI Step 7: Live charts tab merged into Control tab
    Split-pane layout: left = controls (errors, mode, gains, readouts),
    right = 4 pyqtgraph ring-buffer plots (Vbus, Iq, velocity, position)
    with toggle checkboxes, clear, and live stats.
    [odrive_gui.py, tab_charts.py, tab_control.py]
2026-04-13 ODrive GUI Step 8: Presets tab for saving/loading ODrive configurations
    Adds preset management (save, load, delete) so known-good ODrive configs can be
    recalled quickly. First saved preset: "Simple p and v control working".
    [odrive_cmd_output.json]
2026-04-13 ODrive GUI Step 9: Working feedforwards and watchdog
    [Arm.SLDPRT, Rotor.SLDPRT, WheelMotorASM.SLDASM]
2026-04-13 ODrive GUI Step 10: Autotuner, control tab improvements, and working preset
    Add autotuner module, enhance control/setup/charts tabs with feedforward
    and watchdog refinements, and save "Both axis working" preset.
2026-04-14 ODrive GUI Step 11: Safety guards against position-mode slam
    Motivated by an ODrive 3.6 fry caused by switching from velocity to
    position mode while the motor was armed — the PASSTHROUGH input_pos=0
    seed snapped a 150 mm arm toward zero, spiking regen and killing the
    STM32 rail.
    Changes in tab_control.py:
    - Seed input_pos from encoder.pos_estimate on enable (no more snap to 0)
    - Default position mode to TRAP_TRAJ (input_mode=5) with conservative
    vel/accel/decel limits; velocity/torque stay on PASSTHROUGH
    - Force IDLE and wait for state transition before writing control_mode
    - Gate mode radios + Enable button on IDLE state; Setpoint spinbox
    only enabled in CLOSED_LOOP
    - Redundant Safet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
    [tab_control.py]
2026-04-15 Sim: fix MuJoCo link inertials to true CoMs; remove FF3
    Femur and coupler inertials were at pos="0 0 0" (hip A and pivot F),
    putting rod mass on the pivot instead of along the rod; tibia's folded
    bearing landed at the rod midpoint instead of at stub E. This biased
    MuJoCo's subtree CoM vs the analytical model by a hip-angle-dependent
    offset (up to ~5 mm), which pitch_ff could not compensate — causing
    hip-direction-dependent drift. Inertials now sit at the composite
    (rod + folded bearings) CoM with parallel-axis inertia about it;
    truth vs analytical CoM now agree to numerical precision across the
    full hip range. With pitch_ff exact, FF3 (which was redundant, wrong-
    signed, and used the wrong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
2026-04-18 AK45-10 characterization notes and sim updates
    Add README to akMars folder documenting CubeMars tool deg/s display
    bug and confirming motor reaches 3 RPS (180 rpm) as expected.
    Also stage latest HANDOFF, TODO, and sim changes.
    [ak45_dyno.py, check_anticog_nvm.py, fix_and_spin.py, odrive_gui.py, probe_anticogging.py, probe_firmware.py, run_anticogging.py]
2026-04-18 AK45-10 MIT CAN control: firmware driver + dashboard AK45 tab
    - config.h: CAN_ID_HIP_L/R → 0x41/0x42 (avoids ODESC collision)
    - ak45_can.h/cpp: full MIT CAN driver (pack_cmd, unpack_reply, enable/disable/zero, watchdog, NO_CAN stubs)
    - robot_state.h: add hip_enabled, hip_temp, hip_error fields
    - odesc_can.cpp: route hip RX frames to ak45_parse_rx in drain loop
    - main.cpp: ak45_init() in setup; hip MIT cmd TX each tick when hip_enabled
    - telemetry.h/cpp + wifi_fast.cpp: packet 69→73 bytes, hip_q_avg→hip_q_L + hip_q_R
    - dashboard.py: 73-byte format, CMD_HIP=5, send_hip(), AK45 Motors tab with live labels/mini plots/enable/disable/zero/MIT cmd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
    [ak45_can.cpp, ak45_can.h, config.h, dashboard.py, main.cpp, robot_state.h, telemetry.cpp, telemetry.h]
2026-04-23 ODrive: reorganize scripts/firmware, add encoder setup UX, update TODO
    - Move encoder_cal_fix.py and setup_encoder_direct.py into scripts/ subdir
    - Move firmware.elf into firmware/originalFirmwareBinary/ and rename to match version
    - Add saved preset "Both axis working CS 3 and 4"
    - Add AS5048A encoder setup instructions label to tab_setup.py
    - Post-reboot action now triggers power-cycle warning dialog after encoder config save
    - Drop stale docs placeholders (.gitkeep) and outdated project_structure/math docs
    - Add CH340 driver for AK 2.0 series motor to datasheets
    - Update TODO with SIMULATION/CUBEMARS/ODRIVE section headers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
    [tab_setup.py]
2026-04-23 CAN bridge firmware + ODrive CAN config fixes; document D10/D13 pin conflict
    - firmware/can_bridge/: new standalone SLCAN bridge firmware for UNO R4 WiFi;
    relays CAN ↔ USB-Serial so Python can talk to ODrive directly
    - firmware/can_bridge/probe_odrive.py: diagnostic script; confirmed ODrive
    axis0/1 heartbeats and encoder estimates streaming at 1 Mbps
    - firmware/README.MD: pin assignments for both projects; documents critical
    conflict — D10=CAN TX collides with IMU CS, D13=CAN RX collides with SPI SCK
    on the WiFi variant (Minima uses D4/D5 instead)
    - firmware/robot/src/config.h: TODO comments on D10/D13 pin conflicts
    - firmware/robot/src/odesc_can.h: fix stale encoder_rate_ms=0 co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
    [ak45_can.cpp, ak45_can.h, commands.cpp, commands.h, config.h, controllers.h, debug_harness.h, debug_main.cpp]
2026-04-24 ODrive CAN→Dashboard pipeline: velocity mode + diagnostics
    - usb_can firmware env: CAN enabled, telemetry + commands over USB-Serial
    - odesc_can: axis state + error from heartbeats stored in RobotState;
    auto-clear errors before SET_AXIS_STATE in enable_velocity/position;
    log can_send OK/FAIL for each SET_AXIS_STATE call
    - commands: add CMD_ODRIVE_CLEAR (id=11) → sends CLEAR_ERRORS via CAN;
    serial watchdog zeros velocity after 2s silence when ODrive is spinning
    - telemetry: pack odrive_axis_state (bits[5:2]) + has_error (bit 6) into status_flags
    - dashboard: ODrive tab shows axis state label (IDLE/CLOSED_LOOP/ERROR);
    velocity UI range tightened to ±5 t/s for bench safety;
    Clear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
    [commands.cpp, dashboard.py, robot_state.h, telemetry.cpp]
2026-04-24 CAN characterization sketch + ODrive USB GUI reorganization; firmware README rewrite
    - Add components/characterization/CAN/ PlatformIO sketch for measuring CAN TX throughput, RX jitter, and command→feedback latency
    - Rename odrive/ flat layout → odrive/USB GUI/ to separate USB-based tool from new CAN workflow
    - Move forkedFirmware submodule → odrive/firmware/forkedFirmware
    - Rewrite firmware/README.MD: full ODrive CAN protocol table (broadcast, request/reply, command), bus load budget (≈52% at 500 Hz × 4 motors), characterization sketch usage
    - Add firmware/can_bridge/ Python scripts: can_query.py, read_position.py, spin_motor.py
    - Dashboard: fix loop-timing plot (rename, y-range 0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
    [AligmentJig.SLDPRT, CenteringJig.SLDPRT, Coupler.SLDPRT, Link.SLDASM, M16 Tube.SLDPRT, M3x5.SLDPRT, M5 RodEnd.SLDPRT, Rotor.SLDPRT]
2026-04-24 WIP: CAN telemetry + dashboard refactor; known bugs in Arduino & dashboard firmware
    - odesc_can: expanded CAN packet handling, new axis/state fields
    - telemetry: added fields for richer dashboard data
    - dashboard.py: refactored serial/CAN pipeline (debug_serial moved to debug/)
    - firmware/can_bridge: add calibrate, diagnose, spin_both scripts
    - CAD: new top-level assembly (ROBOT.SLDASM), links, body, motor components
    - .vscode settings added
    - NOTE: active bugs in Arduino firmware and dashboard — do not treat as stable
    [AK45-10 Rotor.SLDPRT, Arduino.SLDPRT, Battery.SLDPRT, Coupler.SLDASM, Femur.SLDASM, IMU BNO085.SLDPRT, M16 Tube Coupler.SLDPRT, M16 Tube Femur.SLDPRT]
2026-04-26 Dashboard per-motor control: velocity, position, torque modes via CAN
    - Dashboard: add Position and Torque mode rows to Wheel Motors tab,
    each with Enable + stepper + Send; add Target Motor selector
    (Both / Left M0 / Right M1) that routes to per-motor or broadcast cmds
    - Dashboard: new CMD IDs 12-15 (torque both, vel/pos/torque per-motor)
    and matching CommandSender methods
    - Firmware: split odrive_vel_cmd/odrive_pos_cmd into per-axis fields
    (odrive_vel_L/R, odrive_pos_L/R, odrive_tau_L/R) in RobotState
    - Firmware: handle CMD IDs 12-15 in both commands.cpp (serial) and
    wifi_fast.cpp (UDP); add WheelMode::TORQUE branch in main.cpp
    - Critical finding: small inter-axis CAN delay requir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
2026-04-28 AK45 servo mode CAN control working; MIT mode WIP
    - Add firmware/can_bridge_cubemars: SLCAN bridge firmware + Python scripts
    (move_motor.py servo control, test_servo_to_mit.py mode-switch test,
    mit_control.py MIT velocity sweep — TX confirmed, no RX yet)
    - Add firmware/can_bridge_odrive, can_odrive_library directories
    - Add firmware/robot: ak45_can driver, wheel_motors, telemetry, controllers
    - Remove old firmware/can_bridge (ODrive-era scripts, superseded)
    - CAD updates: leg links, Tibia/Femur/Coupler assemblies, new EndRod/couplers
    - components: AK Mars presets/tuning notes, leg motor datasheet pinout
    - firmware README expanded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
    [AK45 stand.SLDPRT, Ak45Stand.SLDASM, Coupler.SLDASM, Coupler.SLDPRT, Encoder.SLDPRT, EndRod.SLDASM, FemuerTibiaCoupler.SLDPRT, Femur.SLDASM]
2026-05-02 CAD reorg to v1 folder; AK45 MIT mode WIP (not yet working)
    - Moved all cad files into cad/v1 circular tube with end rods/
    - Added CubeMars reference code, factory presets, arduinoToCubeMars sketch
    - Added mit_listen.py, mit_probe.py; renamed move_motor.py -> ServoMode_move_motor.py
    - Updated mit_control.py; removed test_servo_to_mit.py
    [AK45 stand.SLDPRT, AK45-10 Rotor.SLDPRT, AK45-10 Stator.SLDPRT, Ak45Stand.SLDASM, AligmentJig.SLDPRT, Arduino.SLDPRT, Arm.SLDPRT, Battery.SLDPRT]
2026-05-02 Arduino CAN to AK45 MIT mode working; initial connection is finicky
    500 Hz CAN telemetry loop with 2-second direction reversal. Motor
    responds correctly once connected but initial MIT mode entry is
    unreliable — root cause TBD.
    [main.cpp]
2026-05-02 AK45 MIT mode CAN demo working with evident backdrivability
    Spring compliance demo: kp=0.5 kd=0.1, alternates between ±2 rad
    set-points every 2s. Motor is easily backdrivable by hand while
    maintaining a compliant spring return force.
2026-05-02 Two AK45 motors in MIT mode working over Arduino CAN!
    Independent spring-compliance control of M1 (ID=64) and M2 (ID=1).
    Motors alternate set-points sequentially — one moves while the other
    holds. Key fix: alternate CAN sends every 1ms so replies never
    collide on the bus. Also includes CAD updates for AK45 rotor and
    femur assembly.
    [AK45-10 Rotor.SLDPRT, Ak45LeverArm.SLDPRT, Femur.SLDASM]
2026-05-03 AK45 CAN timing stress test + springiness explorer firmware
    - time_stress: dual-motor CAN timing benchmark; confirmed 1500 Hz reliable
    (both motors, INTER_FRAME_US=150); 500 Hz is ~10% tick budget
    - arduinoToCubeMars_HelloWorld: dual-motor MIT mode reference firmware
    - springness: cycles through 7 KP/KD presets (1-4 normal, 5-7 softer
    siblings); LED matrix always shows active preset number
2026-05-03 AK45 hardstop detection working — findHardstop firmware
    Dual-motor hardstop finder for AK45-10 hip motors. Wait for 'S' over
    serial while hammering enter_mit + hold-zero so motor is ready the
    instant it boots. On 'S', ramps position target at SEEK_SPEED rad/s;
    detects stall via position deadband + current threshold, then exits
    MIT mode, sets zero, re-enters MIT, and holds with soft gains.
    Also reorganised all akMars Arduino programs under ArduinoPrograms/
    and documented the periodic enter_mit requirement in README.md.
    [flash.py, main.cpp]
2026-05-03 Document AK45 CAN ground requirement in both READMEs
    CAN to AK45 needs a common GND — use the pin on the motor's UART
    connector. Added to both firmware/README.MD and akMars/README.md.
2026-05-07 Teensy firmware + Python GUI — IMU, telemetry, flash monitor
    Firmware (firmware/robot_teensy/):
    - Migrate from Arduino UNO R4 to Teensy 4.1 + ESP32-S3 split
    - BNO086 IMU driver (SPI, 400 Hz, game rotation vector + gyro)
    - Binary comm protocol: TELEM, CMD, ACK, LOG packet types
    - Telemetry payload extended with roll_rad + yaw_rad
    - LOG packet type for structured firmware debug messages
    - IMU state-change events logged (NOMINAL / DEGRADED / ERROR)
    - Serial.printf removed from IMU driver (was corrupting binary stream)
    - Upload protocol switched to teensy-cli (headless, no GUI popup)
    - IMU unit test with live 10 Hz serial readout
    GUI (software/gui/):
    - Flash & Monitor tab: per-device flash bu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
    [AK45 stand.SLDPRT, AK45-10 Rotor.SLDPRT, AK45-10 Stator.SLDPRT, Ak45LeverArm.SLDPRT, Ak45Stand.SLDASM, Arduino.SLDPRT, Arm.SLDPRT, Battery.SLDPRT]
2026-05-09 Teensy dual-MCU firmware — HipMotors + Esp32Link libs, corrected AK45 IDs
    - Add HipMotors library (hip_motors.cpp/h) with MIT Cheetah CAN driver
    - Add Esp32Link library (esp32_link.cpp/h) for Teensy↔ESP32 UART bridge
    - Fix AK45 CAN IDs to 11/12 (decimal) throughout — README, config.h, tests
    - Switch ESP32 MCU to DevKit V1 (ESP32-WROOM-32); update UART2 pin defines
    - Expand test suite: test_uart_hw, test_esp32_link, test_hip_motor, test_wheel_motor, test_telemetry
    - Add springness AK45 characterization firmware (TeensyPrograms)
    - Update pinout.MD with full Teensy 4.1 ↔ ESP32 wiring
    - Add CAD parts: Buzzer.SLDPRT, FlatSatPlate.SLDPRT
    - Update GUI: flash_monitor.py, main.py
    - Remove obs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
    [Buzzer.SLDPRT, FlatSAT.SLDASM, FlatSatPlate.SLDPRT]
2026-05-09 ESP32 VL53L1X driver + GUI flash button
    - src/vl53l1x/main.cpp: single-sensor hello-world, Short mode, cm output,
    XSHUT on GPIO19 (TX2-side), continuous ranging at 50 ms
    - platformio.ini: vl53l1x_demo env (pololu/VL53L1X); esp32dev excludes vl53l1x/ subdir
    - flash_monitor.py: "Flash Laser Test" button in ESP32 test grid
    [main.cpp]
2026-05-09 pinout.MD: document VL53L1X full 4-sensor wiring
    XSHUT on GPIO25-27,32 (left-side pins); I2C on GPIO21/22.
    Replaces the temporary single-sensor workaround note.
2026-05-10 IMU and AK45 working with connectorized board
2026-05-11 Connectorized Teensy board — all interfaces tested and passing
    New: AK45Uart lib, RgbLed lib, ak45_uart_demo, rgb_led_demo, test_comm_usb, test_led.
    Updated: platformio.ini env split, config.h pin assignments, all test stubs, flash_monitor.py.
    Removed: pinout.pdf (replaced by pinout.MD), HipMotor/.gitkeep.
    [FlatSAT.SLDASM]
2026-05-11 Add passive buzzer driver, demo, and unit tests
    - Buzzer lib: non-blocking PWM driver with tone(), midi(), play() (melody),
    volume via duty cycle (0-50%), and midi_to_hz() utility
    - test_buzzer: 13 Unity tests covering MIDI math, tone state, timed tones,
    melody playback, rests, and interrupts; demo sequence runs after tests
    - buzzer_demo: standalone Hello World build (Twinkle -> scale sweep -> SOS)
    - platformio.ini: buzzer_demo env added
    - GUI: single ♪ Buzzer button runs tests + demo
    [main.cpp, test_buzzer.cpp]
2026-05-12 VL53L1X 4-sensor init + working single-sensor demo on GPIO26
    - vl53l1x/main.cpp: rewrite for 4-sensor sequential XSHUT init with
    I2C bus recovery on missing sensor; simplified to single sensor 1
    (GPIO26, default addr 0x29) after confirming GPIO25 sensor absent
    - pinout.MD: move TEENSY_RST from GPIO33 → GPIO14 to free GPIO33 for
    future XSHUT use; update table, bridge diagram, and prose note
    - platformio.ini: exclude neopixel_demo from default build
    - test_telemetry (Teensy + ESP32): simplify to 1 Hz send with per-packet
    serial prints for easier manual verification
    - flash_monitor.py: remove stale test entries, rename OLED→TFT Screen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
    [main.cpp, test_telemetry.cpp]
2026-05-12 VL53L1X 4-sensor demo working — finalize XSHUT pinout
    All 4 sensors confirmed working with XSHUT on GPIO14/27/26/25.
    - vl53l1x/main.cpp: update XSHUT_PINS to {14, 27, 26, 25}, addresses
    0x30–0x33; init→setAddress sequence per Pololu library requirement;
    blocking reads with range_status filter
    - pinout.MD: update XSHUT table and summary to match actual wiring;
    note GPIO25/26 are DAC pins but work in practice
2026-05-14 Fix IMU test assertions, IMU poll-gap timeout, and AK45 UART comms
    - IMU test: replace TEST_ASSERT_LESS_THAN with TEST_ASSERT_TRUE_MESSAGE
    for float comparisons — Unity was truncating floats to int, making
    thresholds < 1.0 always fail
    - IMU driver: timeout now requires active polling + silence; prevents
    ERROR state during Unity teardown gap between tests and loop()
    - AK45 UART: poll() drains multiple frames to skip the diagnostic
    "show encoder now" preamble and find the E ANGLE data frame
    - Remove erroneous half-duplex / 1kΩ+diode wiring references;
    AK45 uses standard 2-wire TX/RX at 921600 baud
    [config.h, main.cpp, test_imu.cpp]
2026-05-15 Flatsat fully working — all interfaces tested and passing
    CAD: CustomBoard SLDASM/SLDPRT, updated FlatSAT assembly and plate, Teensy
    4.1 part, and 6 new flatsat support bracket parts (FlySky, laser, screen,
    switch, SupportBart, CustomBoardFlatsatSupport). VL53L1X firmware updated,
    flash_monitor.py tweaked, connectors.pptx and TODO updated.
    [CustomBoard.SLDASM, CustomBoard.SLDPRT, CustomBoardFlatsatSupport.SLDPRT, FlatSAT.SLDASM, FlatSatPlate.SLDPRT, FlySkyFlatsat support.SLDPRT, LaserFlatSat support.SLDPRT, ScreenFlatsatSupport.SLDPRT]
2026-05-29 v2 CAD updates, Box enclosure, jump math docs, and sim mass tweaks
    - Add Box/ enclosure CAD (corner brackets, panels, hardware)
    - Add new link parts: CouplerNOBearing, M4 nut/washers, TibiaJig2, Tire, wheel variants
    - Delete body.SLDPRT (replaced by Box assembly)
    - Update all v2 assembly and link parts
    - Add BASELINE annotations to params.py mass params; lower m_wheel 0.510→0.383 kg
    - Add Jump_math.ipynb notebook and figures
    - Update TODO.txt with firmware dashboard tasks and jump mass sensitivity note
    - Ignore SolidWorks ~$ lock files in .gitignore
    [BackPanel.SLDPRT, Battery.SLDPRT, Bearing 624ZZ.SLDPRT, BottomPanel.SLDPRT, BottomPanelWithAvionics.SLDASM, Box.SLDASM, CornerBracket.SLDASM, CornerBracket.SLDPRT]
2026-06-09 Teensy/ESP32 firmware restructure, GUI overhaul, CAD Box updates
    - Firmware: state machine with IDLE/STAND/BALANCE/MANUAL modes; hip
    motor torque control via AK45 UART; ESP32 WiFi bridge with OTA;
    shared comm protocol for Teensy↔ESP32 and GUI↔robot messaging
    - GUI: robot visualizer tab, source manager, hip motors panel, IMU tab,
    flash monitor, and theme improvements; port manager refactored
    - CAD: Box enclosure panels updated (sine/mirror-sine/front/back),
    new Lid, Cap, NeoPixel cage/holder parts; ROBOT.SLDASM updated
    - Manual mode still needs work — torque commands not yet fully wired
    end-to-end through the state machine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
    [BackPanel.SLDPRT, BottomPanel.SLDPRT, BottomPanelWithAvionics.SLDASM, Box.SLDASM, Cap.SLDPRT, CornerBracket.SLDASM, CornerBracket.SLDPRT, Coupler.SLDASM]
2026-06-10 Add ESTOP reset/MCU reboot, hip MIT setpoint caching, and GUI command path refactor
    - Teensy: CMD_ID_REBOOT triggers full MCU reset; ESTOP can now transition back
    to STARTUP via a reset request, clearing the fault code
    - Hip motors: cache MIT setpoints and re-send them every poll tick, falling
    back to the safe zero-torque ping on ESTOP or stale commands
    - LED: add flash_then_pulse for a reset-accepted indicator; boot rainbow/chime
    sequence on startup
    - ESP32: decode and display a rolling log of recent commands on the TFT
    - GUI: extract shared CommLink framing into comm_commands.py, add Reset/Reboot
    buttons, decouple hip motor chart redraw from telemetry rate
    [comm_protocol.h, config.h, main.cpp, main.py, state_machine.cpp, state_machine.h]
2026-06-15 Add hardstop calibration state machine and ESTOP request path
    Introduces a STATE_CALIBRATION state (lib/Calibration) that seeks hip
    hardstops, computes joint limits, and homes before returning to
    STANDBY, plus a stateMachine_request_estop() path reachable from any
    non-ESTOP state. GUI/comm protocol and hip motor handling updated to
    support the new calibration flow; HANDOFF.md/frames.md/TODO.txt
    document the follow-up work for surfacing calibration events in the GUI.
2026-06-16 Add STATE_RUNNING with radio arm/disarm, PARAM_CALIB_DONE, and hip direction transform
    - STATE_RUNNING: new state reachable only from STANDBY after calibration has been
    completed at least once (PARAM_CALIB_DONE persisted to flash). Armed by CH10 > 1990
    µs, disarmed when CH10 drops. Hip fault or E-stop still routes to ESTOP.
    - PARAM_CALIB_DONE (0x010C): persistent flag written on calibration completion,
    gates entry into RUNNING across reboots.
    - PARAM_RADIO_HIP_CMD (0x0500): normalised hip extension t ∈ [0,1] (0=retracted,
    1=extended) derived from CH3 each tick while radio is alive; left stale when dead.
    - hip_cmd_to_setpoints(): converts t to per-motor position setpoints [rad] usi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
    [comm_protocol.h, config.h, main.cpp, main.py, state_machine.cpp, state_machine.h, test_comm_usb.cpp]
2026-06-17 Hip motor hardstop calibration and RC control working end-to-end
    - Hardstop detection via current spike in calibration state machine
    - RC arm/disarm via IBus channel gates STATE_RUNNING
    - Hip direction transform and MIT setpoint caching for reliable AK45 control
    - GUI robot_log_widget, hip_motors tab, and raw_data_tab refactored
    - state_machine.md updated with full calibration and running flow
2026-06-20 Add ToF sensor support on ESP32, wheel motor GUI telemetry, and HANDOFF plan
    - ESP32: switch to TFT_eSPI, add VL53L1X ToF ×4 init/task/mux, add DAC buzz
    - comm_protocol.h: add CMD_ID_WHEEL, WHEEL_SUB_*, TELEM_PAYLOAD_V3, wheel telemetry fields (118 bytes)
    - Teensy firmware: add wheel motor init call, telemetry fill for wm_L/wm_R, CMD_ID_WHEEL handler
    - GUI: comm_commands.py adds send_wheel_* helpers; flash_monitor.py parses v3 telemetry; main.py wires WheelMotorsTab; wheel_motors.py new tab file
    - HANDOFF.md: full stack implementation plan for WheelMotorsTab wiring
    [comm_protocol.h, config.h, main.cpp, main.py, state_machine.cpp, test_wheel_motor.cpp]
2026-06-23 Working UART with two packets totalling ~256 bytes
    Structured comm_protocol with two packet types (Teensy→ESP32 and ESP32→PC),
    CommLink framing on both sides, IMU data forwarded through ESP32, robot state
    and control loop updated to match, GUI flash monitor and visualizer tab added.
2026-06-23 Phase 2 LQR verified: enable ODrive on arm, fix right wheel direction
    - state_machine: call wheel_motors_set_mode(TORQUE) on RUNNING entry,
    IDLE on disarm and ESTOP — ODrive was never being enabled
    - wheel_motors: negate right wheel torque and velocity feedback to
    account for physically mirrored motor mount (positive = robot forward)
    - All Phase 2 safe test steps 1-5 complete and verified on hardware
    [comm_protocol.h, control_loop.cpp, main.cpp, main.py, robot_state.h, state_machine.cpp]
2026-06-24 jump logic verified in flatsat, added humanlike screen to ESP32, verified velocity and yaw command via radio TX
2026-06-25 Enable ESP32 WiFi: UDP telemetry broadcast + TCP command path
    - Set WIFI_ENABLED=1 in esp32/config.h to activate dormant WiFi code
    - Add wifi_transport.py: QThread that listens on UDP:5005 for telemetry,
    auto-discovers ESP32 IP from broadcast source, sends commands via TCP:5006
    - comm_commands.py send_frame() now tries WiFi TCP first, then USB serial
    (prefers esp32 over teensy port since ESP32 forwards commands to Teensy)
    - main.py starts WifiTransport thread at window init
2026-06-26 Add battery voltage indicator to TFT display and PC GUI
    Draws a 5-bar battery icon in the ESP32 TFT banner (drawModeBanner now
    takes vbus) and a matching BatteryStatusWidget in the Python status bar.
    Both blink red at 1 Hz when critically low (≤1 bar, ≤21.8 V on 6S).
    Deletes firmware/robot_teensy/Features.MD (content moved elsewhere).
2026-06-26 Redesign TFT display and PC GUI visualizer; extend telemetry protocol
    ESP32 TFT: new sprite layout (banner/AH/hip/wm/footer), color-gradient
    banner per mode, WiFi/UART/IMU icon helpers, extended telemetry fields
    (health_flags, hip cmds, v_ref, omega_cmd, ff outputs, jump_state,
    active_profile). PC GUI: robot_visualizer_tab rewritten as cockpit
    instrument panels surrounding the 3-D scene; raw_data_tab and
    params_tab minor fixes; flash_monitor cleanup. Shared comm_protocol.h
    and ParamRegistry updated to carry new fields; Teensy control_loop and
    main get matching emit code.
    [comm_protocol.h, control_loop.cpp, main.cpp, main.py]
2026-07-12 Add SD-card logging, reorganize GUI into tabs/ package, extend comm protocol
    - Firmware: add SDLogger (sd_logger.cpp/h) for on-robot SD logging, extend
    comm_protocol.h/CommLink.h with LOG_INFO/LOG_DATA frame types and log
    control commands, wire log start/stop/status into main.cpp and
    state_machine.cpp, small Buzzer/RgbLed/ParamRegistry additions.
    - GUI: move all tab/module implementations under software/gui/tabs/
    (only main.py stays at the gui/ root), add log_bus.py/log_playback.py/
    log_transfer.py/telem_format.py for SD-log download + offline .wlog
    playback in a new Logs tab, add tools/ for standalone log utilities.
    - Visualizer: add a black happy-face marking + forward arrow on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
    [BottomPanel.SLDPRT, BottomPanelWithAvionics.SLDASM, Box.SLDASM, Femur.SLDASM, FrontPanel.SLDPRT, M2 standoff.SLDPRT, MirrorSinePanel.SLDPRT, SinePanel.SLDPRT]
2026-07-17 imu working, connector was loose
    [AK45-10 Stator.SLDPRT, BackPanel.SLDPRT, BottomPanel.SLDPRT, BottomPanelWithAvionics.SLDASM, Box.SLDASM, CableClamp.SLDPRT, Cap.SLDPRT, CustomBoard.SLDASM]
2026-07-17 Fix IMU startup: block STARTUP on IMU health, vendor timeout fix
    All peripherals (IMU, hip motors, wheel motors) now initialize
    correctly on boot.
    - STARTUP now blocks in setup() until the IMU is actually NOMINAL or
    ERROR before proceeding, instead of racing the 500 Hz loop budget
    with an async per-tick retry. STARTUP is the one phase that doesn't
    need to hold that budget (no torque is commanded yet).
    - "Setup complete" was misleading (logged before IMU health was known,
    and even while STARTUP was about to ESTOP). It's now "Startup
    complete" / "Startup complete with errors", logged from the state
    machine only once STARTUP actually resolves.
    - A mid-operation IMU dropout (post-ST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
    [main.cpp, state_machine.cpp]
2026-07-17 Add hardware watchdog, param reset command, per-motor bench-test GUI
    - Hardware watchdog (WDOG1) gated on PARAM_WATCHDOG_ENABLE, guards
    against a stuck driver call (e.g. BNO08x sh2 getProdIds) hanging the
    control loop with no crash/recovery.
    - CMD_ID_PARAM_RESET_DEFAULTS: revert all writable params to
    compile-time defaults, replies with a full PARAM_REPORT dump.
    - GUI: params_tab/controllers_tab support for per-motor bench-test
    enable flags and the new reset-defaults command.
    - control_loop.cpp: echo effective pitch/pitch_rate (real or
    sim-injected) back into g_state so telemetry/GUI show what the LQR
    actually sees, not just the raw IMU reading.
    - ESP32: config stub for the not-y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
    [comm_protocol.h, config.h, control_loop.cpp, main.cpp, test_hip_motor.cpp, test_imu.cpp, test_wheel_motor.cpp]
2026-07-18 Fix IMU pitch sign, verify LQR balance loop on hardware, make LQR gains tunable
    Hardware verification (ControllersTest.md): Phase 1 motor-direction checks and
    Phase 2 LQR checks all passed, including pitch-watchdog and wheel-runaway
    ESTOP triggers and release-and-settle balance confirmation.
    - IMU: pitch was inverted relative to the physical mounting (roll/yaw were
    already correct) — fixed the single sign-correction point in main.cpp
    instead of double-negating in the driver. Also bumped BNO086 SPI to its
    3 MHz datasheet max and replaced a delay(1)-per-poll wait with a tight
    micros() spin to cut SHTP read latency.
    - LQR gains (K_pitch/K_rate for retracted+extended, K_vel) are now r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
    [config.h, control_loop.cpp, control_loop.h, main.cpp, main.py, state_machine.cpp, state_machine.h]
2026-07-19 ESP32 Phase 1: decouple uplink sends from UART parse path (UARTplat.md)
    Root cause of the intermittent NO TEENSY / flaky-under-WiFi-GUI symptom:
    on_teensy_packet() ran USB/TCP/UDP sends inline inside the core-1 UART parse
    loop, so a slow blocking TCP/UDP write under WiFi load stalled parsing and
    made the link look dead even though UART bytes kept arriving.
    - on_teensy_packet() now only enqueues each frame (UplinkFrame, never blocks:
    drop-oldest on a full queue, counted in g_uplink_drops).
    - New uplink_task (core 0, prio 2) is the sole writer to Serial, the TCP
    client, and the telemetry/diag UDP sockets; send_wifi_diag() and the
    WIFI_TELEM_COMBINED path route through the same queue ins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
    [config.h, main.cpp]
2026-07-19 Teensy Phase 2: UART hardening + stale artifact cleanup (UARTplat.md)
    - Expand Serial5 RX ring 64 B -> 2048 B (addMemoryForRead, mirroring the
    existing 512 B TX buffer). The default 64 B / ~160 us at 4 Mbaud was
    smaller than one telemetry burst; the main loop only drains it every
    2 ms, so any inbound burst > 64 B between services was silently lost.
    - Pace the PARAM_GET 0xFFFF / PARAM_RESET_DEFAULTS reply dump: both handlers
    now arm a cursor instead of blasting ~60 PARAM_REPORTs in one burst;
    service_param_dump() (called from loop() next to receive_commands())
    sends 4 per tick (~30 ms total) so it can never overflow the TX buffer or
    add jitter to the 500 Hz control loop.
    - Delet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
    [main.cpp, test_telemetry.cpp]
2026-07-19 Phase 3: ESP32<->Teensy link supervision, TELEM V9, WIFI_DIAG V2 (UARTplat.md)
    New COMM_TYPE_ESP32_STATUS (0x16): ESP32->Teensy heartbeat at 5 Hz, sent
    directly on g_teensy independent of the Teensy link's own state, carrying
    ESP32 uptime/WiFi/TCP-client/RSSI and its own uplink-drop and Teensy->ESP32
    UART counters. Teensy stores it (on_command(), telemetry-only, no fault/state
    change) and stamps s_last_esp32_status_ms.
    TelemetryPayload V9 (235 -> 242 bytes, TELEM_B_LEN 117 -> 124): adds
    esp32_link_ok, esp32_status_age_ms, and the Teensy's own g_comm.rx_drops()/
    rx_seq_gaps() (ESP32->Teensy direction) so the GUI can see ESP32-link health
    without a new transport. LogRecord (239 -> 246 bytes)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
2026-07-19 Phase 4: GUI tri-state header, link-health panel, TCP backoff (UARTplat.md)
    Tri-state connection header (§5.1): replaces the old single-shot "any packet
    restarts a 3 s timer" disconnect timer, which could never show anything but
    green/red — WIFI_DIAG now flows from the ESP32 at 5 Hz independent of the
    Teensy link (Phase 1/3), so that timer would have kept the header green
    forever off WIFI_DIAG alone even with the Teensy fully silent. _on_packet()
    now timestamps TELEM and WIFI_DIAG separately; a 250 ms periodic timer
    (_update_link_state) evaluates the tri-state so it also reacts when packets
    stop arriving, not just when they arrive:
    - Connected (green): telemetry fresh < 3 s (unchanged t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
    [main.py]
2026-07-19 Add calibration-bypass param (PARAM_CALIB_BYPASS_EN) to Params tab grouping
    Pre-existing uncommitted change from an earlier session (per-motor bench-test
    work, unrelated to the UARTplat.md WiFi-reliability effort) — separated into
    its own commit here rather than bundled into the Phase 5 command-reliability
    commit, since the two are unrelated. Adds the new 0x0113 param to the Safety
    group and gives calib_l/r_seek_dir their own Left/Right subgroups.
2026-07-19 Phase 5: effect-confirmed command retry via ReliableCommand (UARTplat.md)
    Design choice (kept from the plan): retry at the GUI layer against observed
    telemetry effects, no wire-protocol change — the ESP32 re-stamps `seq` when
    forwarding commands to the Teensy, so GUI seq numbers don't survive the hop,
    and every discrete command already has an observable confirmation. Simplest
    option that needed zero firmware changes.
    New in comm_commands.py: ReliableCommand/send_reliable(send_fn,
    confirm_predicate, retries=3, timeout_ms=250, on_fail=None,
    reject_predicate=None, label=...) — sends immediately, retries on a QTimer
    until confirm_predicate matches a TelemetryBus packet, stops immediately
    (n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
2026-07-19 Phase 6: wifi_load_sim.py load generator + native CommLink robustness test (UARTplat.md)
    wifi_load_sim.py: headless, pyserial-free WiFi load generator that puts the
    same network-facing load on the ESP32 the real GUI does — CMD_ID_PING at
    10 Hz (matches MainWindow's ping timer), periodic CMD_ID_PARAM_GET 0xFFFF
    dumps (deliberately more frequent than real GUI usage, to stress-test the
    Phase 2 paced-dump path), continuous TCP RX drain, and the same reconnect
    backoff as wifi_transport.py's Phase 4 fix. Learns the ESP32's IP from the
    source address of the first UDP telemetry datagram (same signal
    WifiTransport uses), not from USB serial — keeps this tool fully independent
    of the `tabs` packag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
2026-07-19 Update firmware README for Phases 1-3's UART/telemetry changes (UARTplat.md)
    - Remove teensy/lib/Esp32Link/ from the directory tree (deleted in Phase 2).
    - Fix stale TelemetryPayload size (235 -> 242 bytes, TELEM_B 117 -> 124,
    TELEM_VERSION 9) in the telemetry pipeline diagram.
    - Note the Phase 1 uplink_task split (on_teensy_packet() enqueues, never
    sends inline) and the Phase 3 ESP32_STATUS/WIFI_DIAG V2 heartbeats.
    - Note ReliableCommand's effect-confirmed retry (Phase 5) in the params flow.
2026-07-19 Rewrite UARTplat.md: hand off Phase 7 to a fresh conversation
    Phases 1-6 are done and committed (see git log) — this file no longer needs
    their detailed step-by-step implementation instructions, so those are
    replaced with a concise "what's done" summary (commit list, what's been
    verified, known-unrelated dirty files to leave alone, the native-toolchain
    caveat on test_commlink_robustness).
    Phase 7 (the hardware test campaign) is expanded to be self-contained for a
    new conversation with zero prior context: tool usage reference, exact pass
    criteria table, and the user's explicit preference (given when asked, since
    neither board was connected to run it in this session) for a short ~2-3 min
    sa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
2026-07-19 balancing and steering
    [BottomPanel.SLDPRT, BottomPanelWithAvionics.SLDASM, Box.SLDASM, MirrorSinePanel.SLDPRT, SinePanel.SLDPRT, TPU wheel.SLDPRT, Tibia.SLDASM, wifi_campaign_summary.csv]
2026-07-19 Phase 7: fix ESP32 TCP-mutex race causing pbuf_free reboot loop
    The ESP32 crashed roughly every 5s in WiFi mode with an assert failed:
    pbuf_free (p->ref > 0) -> reboot, confirmed 101 times in the raw serial
    log with an identical backtrace, ~28% right after a new TCP client
    accept. Root cause: loop() (core 1) read the TCP command socket via
    g_comm_tcp->update() without holding g_tcp_mutex, while uplink_task
    (core 0) wrote through the same socket under that mutex - concurrent
    cross-core access corrupting lwIP's pbuf chain. This was a residual gap
    from the Phase 1 uplink-decoupling refactor, which guarded uplink_task's
    writes and loop()'s client-accept swap but missed loop()'s own read.
    Also g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
    [main.cpp]
2026-07-19 Phase 8: GUI-driven WiFi test automation + WiFi diagnostics tab
    Retires the ad-hoc wifi_load_sim.py/wifi_capture.py approach in favor of
    driving realistic WiFi-mode test scenarios through the real GUI: a new
    --automation <scenario.json> flag on main.py runs the actual MainWindow
    (WifiTransport, comm_commands, SourceManager) unattended for a fixed
    duration and writes a pass/fail JSON report, so a test run needs no
    human clicking and no synthetic protocol reimplementation.
    - tabs/automation_runner.py: AutomationRunner forces WiFi active
    (SourceManager.set_override), waits for the first WiFi packet before
    starting its timed window (so boot/reconnect time isn't charged
    against the scenari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
    [main.py]
2026-07-19 Update UARTplat.md: Phase 7/8 done, retire wifi_load_sim.py/wifi_capture.py
    Records the pbuf_free root cause and fix (1e26dee), the GUI automation
    replacement for the standalone WiFi scripts (8c9a84a), and the two
    environment gotchas (LAN-IP build flag, Windows Firewall) hit while
    verifying on hardware.
2026-07-19 Phase 9: fix uplink_task hang on blocking WiFiClient::write()
    The GUI's --automation testing (packet-loss/jitter analysis added this
    session) surfaced a second, more severe bug beyond the pbuf_free race
    fixed in Phase 7: uplink_task would intermittently go completely
    silent — not slow, not lossy, zero output on USB relay AND WiFi UDP
    (including the WIFI_DIAG heartbeat, meant to be independent of
    everything else) — for periods well beyond a single test's duration.
    Root-caused with an ESP-IDF task watchdog (esp_task_wdt, new — nothing
    in this codebase used it before) subscribed to uplink_task: every
    reproduction (6 for 6) caught it mid-g_comm_tcp->send(). WiFiClient::
    write() (framework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
    [main.cpp]
2026-07-19 Phase 9: packet-loss/jitter analysis + clean automation shutdown
    automation_runner.py: replaces the coarse pass/fail report from Phase 8
    with real measurements — actual received Hz vs. expected (from TELEM's
    loop_count, which increments by exactly 10 per tick at the Teensy's
    500 Hz clock, so any bigger jump between received packets means a lost/
    unpaired WiFi datagram), inter-arrival jitter percentiles, both UART
    directions' CRC/seq-gap deltas (firmware-computed counters, not the
    GUI's own decode counters — see the module docstring for why: TELEM and
    WIFI_DIAG are separate CommLink instances with independent seq counters
    that land on the same UDP port/decoder, so the existing link_seq_ga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
2026-07-19 Update UARTplat.md: Phase 9 - uplink_task hang found and fixed
    Records the second bug (WiFiClient::write() blocking hang, worse than
    Phase 7's pbuf_free crash) found via the new packet-loss/jitter
    measurements, its root cause and fix, and the 10-minute verification.
2026-07-19 Allow GUI-commanded arm to RUNNING; feedback when arming outside STANDBY
    Not mine — pre-existing uncommitted work found in the working tree
    during this session (same pattern as the earlier calibration-bypass
    param commit), split into its own commit rather than bundled into
    unrelated Phase 9 stress-testing work.
2026-07-19 Phase 9: CRC corruption-injection stress test (UART + WiFi)
    Adds a test-only hook to deliberately flip the CRC-8 byte on outgoing
    CommLink frames, to verify each receiving side's checksum check
    actually detects and drops a bad frame rather than just "hasn't seen
    corruption yet":
    - shared/CommLink: send() gains an optional corrupt_crc_for_test
    parameter (default false — zero behavior change at every existing
    call site).
    - shared/comm_protocol.h: new CMD_ID_TEST_INJECT_CORRUPT (payload:
    count, target). target 0 = Teensy's next `count` UART sends to the
    ESP32; target 1 = ESP32's next `count` WiFi UDP sends to the GUI,
    intercepted locally by the ESP32 (forward_to_teensy()) like
    CM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
    [comm_protocol.h, main.cpp]
2026-07-19 Phase 9 cont'd: malformed-frame corruption modes, GUI decoder length-guard fix, concurrent-TCP-client + extended soak tests (UARTplat.md)
    Extends the CRC-only corruption injection test hook (CMD_ID_TEST_INJECT_CORRUPT)
    to a 3-mode selector shared by CommLink::send() on both Teensy and ESP32:
    mode 1 = flipped CRC-8 (existing), mode 2 = flipped END byte (PS_END bad-byte
    path), mode 3 = oversized on-wire length claim (length-guard/resync path).
    Found and fixed a real gap while testing mode 3 over WiFi: the GUI's Python
    PacketDecoder (flash_monitor.py) had no length-guard equivalent to the
    firmware's Fix 2 — a corrupted length field made it wait indefinitely for
    bytes that would never arrive,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
    [comm_protocol.h, main.cpp]
2026-07-19 Fix WifiTransport: TCP command-response socket was write-only (UARTplat.md)
    While empirically verifying that incoming COMMAND frames get the same
    length/CRC/END-byte parser guards as telemetry (they do — confirmed via a
    new command_corruption_probes test primitive, corrupted_frame_rejected was
    true in every probe across every run), a baseline (uncorrupted) single-param
    PARAM_GET got no reply at all over WiFi. Root cause: WifiTransport's TCP
    socket (used to send commands to the ESP32) was never read from — grep
    confirms zero .recv() calls on it anywhere in the GUI. The ESP32 sends every
    frame type over that same TCP connection unconditionally (uplink_task), with
    UDP as an additional send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
2026-07-19 Fix yaw controller wheel-mixing sign
    Driving the left wheel harder than the right yaws a differential-drive
    robot right (-Z), so positive tau_yaw (commanding +yaw, CCW from
    above per PARAM_OMEGA_CMD_RDS's own doc comment) needs to add to the
    right wheel and subtract from the left. The mixing had this backwards,
    which is why the yaw PI needed negative gains to stay stable, and why
    the physical steering direction was reversed from the radio command.
    [control_loop.cpp]
2026-07-19 Allow RUNNING to arm with wheels disabled for software-triggered bench tests
    Adds PARAM_RUNNING_WHEEL_BYPASS_EN (non-persistent, default off),
    independent of PARAM_CALIB_BYPASS_EN which only covers the hip check.
    Lets req_running() arm with wheel_l/r_enable off, for a pure
    command/state-machine smoke test with zero real torque anywhere when
    combined with hip_l/r_enable also off.
    Adds two standalone USB-serial test tools (no Qt, same pattern as
    tools/trigger_log_test.py):
    - trigger_running_test.py: send CMD_ID_SET_MODE(RUNNING) and confirm
    via comm_log + TELEM_A whether the state machine actually armed.
    - stress_test_arm.py: 3-5 round stress test of the mode-change command
    surface (fuzze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
2026-07-19 Document arm/state-machine stress test instrumentation in README
    Covers the new CMD_ID_SET_MODE(RUNNING) command path,
    PARAM_RUNNING_WHEEL_BYPASS_EN, trigger_running_test.py and
    stress_test_arm.py (software/gui/tools/), and two gotchas found while
    building them: no software disarm-from-RUNNING path exists yet, and
    the radio disarm interlock overrides a software-triggered RUNNING
    within one tick whenever no RC receiver is connected (confirmed
    intentional, not a bug).
2026-07-20 Add CAD v3 (shifted CG, thin RGB, limit switch) design; update v2 ROBOT assembly
    New SolidWorks parts/assemblies for the v3 design iteration (shifted CG,
    thin RGB strip, physical limit-switch homing), plus the box/electronics
    enclosure and wheel/leg link files that go with it. Also updates
    cad/v2 square tube/ROBOT.SLDASM per ongoing v2 CAD work.
    [AK45 stand.SLDPRT, AK45-10 Rotor.SLDPRT, AK45-10 Stator.SLDPRT, Ak45LeverArm.SLDPRT, Ak45Stand.SLDASM, Arduino.SLDPRT, Arm.SLDPRT, BackPanel.SLDPRT]
2026-07-20 firmware: TELEM_VERSION 10 (gain_sched_alpha), GUI-driven motion control, forced-retracted gain scheduling
    - TelemetryPayload gains gain_sched_alpha (V10) so the hip gain-schedule
    blend factor is visible in live telemetry and .wlog captures.
    - New PARAM_ALPHA_FORCE_RETRACTED_EN: forces alpha=0.0 (fully-retracted
    gains) without needing real hip calibration, for bench-tuning sessions
    where the hips are zip-tied retracted and disabled.
    - New PARAM_GUI_MOTION_CTRL_EN: lets a GUI/CLI param_set() drive
    v_cmd_ms/omega_cmd_rds instead of CH2/CH4, with a 300ms watchdog that
    reverts to radio control if no GUI command arrives; never gates arming
    (CH10 stays unconditional).
    - radio_update():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
    [comm_protocol.h, control_loop.cpp, main.cpp, state_machine.cpp, state_machine.h]
2026-07-20 docs: rewrite tuning.md as Phase 1 hardware gain-tuning guide; add standing_up.md spec
    - tuning.md: replace the old pitch-hardstop note with the full Phase 1
    operator guide — session checklist, robot_ctl.py/analysis tool
    reference, hardware test protocol, safety constraints, known gotchas,
    and the new param IDs, matching the gui/firmware infra added alongside.
    - TODO.txt: check off completed WiFi/yaw items, update the near-term list.
    - Add standing_up.md: design spec for a new STANDING_UP state (not yet
    implemented) that would recover the robot from a fallen pose before
    handing off to the balance LQR.
    - Remove ControllersTest.md and UARTplat.md — the work they tracked is
    supe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
2026-07-21 Troubleshooting download logs, before Codex attempted fix
    [BottomPanelWithAvionics.SLDASM, Box.SLDASM, KneeCover.SLDPRT, MirrorSinePanel.SLDPRT, MirroredSwitchMount.SLDPRT, SinePanel.SLDPRT, Tibia.SLDASM]
2026-07-21 Fix reliable log downloads through ESP32 relay
    [comm_protocol.h, config.h, main.cpp, main.py]
2026-07-21 phase 1: freeze protocol and reliability baselines
    [state_machine_contract.json]
2026-07-21 phase 2: add correlated commands and safe disarming
    [state_machine_contract.json]
2026-07-21 phase 3: enforce single-owner ESP32 transports
2026-07-22 Found good default gains for retracted config
    Updates firmware protocol/params, GUI log tooling, and CAD; retires
    stale WiFi test logs and adds default gains export for the retracted
    leg configuration.
    [BottomPanelWithAvionics.SLDASM, Box.SLDASM, MirrorSinePanel.SLDPRT, MirroredSwitchMount.SLDPRT, SinePanel.SLDPRT, SwicthMount.SLDASM, SwitchMount.SLDPRT, wifi_campaign_summary.csv]
2026-07-22 Update webGUIfork submodule pointer
    Pull in ODrive property probe script and manual clear_errors fallback.
2026-07-25 Update robot firmware, GUI, CAD, and tooling
    [BottomPanel.SLDPRT, BottomPanelWithAvionics.SLDASM, Box.SLDASM, Cap.SLDPRT, Lid.SLDPRT, MirrorSinePanel.SLDPRT, MirroredSwitchMount.SLDPRT, NeoPixelCage.SLDPRT]
2026-07-26 Add roll controller, split pitch-watchdog/vel-PI gain scheduling, 3-group live tuning, balance trim
    Bench-measured the retracted balance point at -8 deg pitch and set
    lqr_pitch_trim_ret accordingly (was 0, so the vel-PI integrator was
    permanently absorbing it, eating into the backward lean budget). Widened
    the CH7/CH8 live-tune knob ranges for the LQR pitch/rate group after a
    2026-07-25 run pegged CH7 at its old -0.5 end stop for over half the run.
    Made roll_watchdog_en persistent and default-off per explicit request.
    Also carries pre-existing in-progress work from prior sessions: the active
    suspension roll controller (roll_ctrl_en, PD on roll angle/rate -> hip
    differential offset) and its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
2026-07-26 CAD: v3 shifted-CG box/leg revisions, new stopper parts, mass characterization photos
    [BottomPanelWithAvionics.SLDASM, Box.SLDASM, Cap.SLDPRT, Lid.SLDPRT, MirrorSinePanel.SLDPRT, MirroredSwitchMount.SLDPRT, SinePanel.SLDPRT, Stopper.SLDPRT]
2026-07-26 Bump forked ODrive firmware submodule
2026-07-30 feat: update robot controls telemetry and CAD
    [608ZZ.SLDPRT, BackPanel.SLDPRT, Battery holder.SLDPRT, Bearing 6804-2RS (20x32x7).SLDPRT, BearingWasher.SLDPRT, Bearings on inside link.SLDASM, Bearings on outside link.SLDASM, BottomPanel.SLDPRT]
2026-07-31 Add 4-bar optimizer GUI, archive 2D step sims, reorganize v4 CAD
    Simulation:
    - New simulation/2d/fourbar_optimizer_gui/: geometry/kinematics/model,
    evaluate + optimize, PyQt GUI, presets and a baseline regression test.
    - Move the old step01-step08b exploratory scripts and sim2d.py into
    simulation/2d/archive/ (unchanged, kept for reference).
    - params.py: TEMP geometry sweep raising the coupler pivot F_Z to 18 mm
    above the hip axis, with Q_RET/Q_EXT re-derived by auto_stroke_angles.
    Original values are recorded inline in the comments.
    CAD:
    - Rename cad/References -> "cad/References to other robots".
    - Move v4 bearing parts under Concepts/Bearing mounting/; add
    Concepts/Kinematics/ s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
    [608ZZ.SLDPRT, AK45-10 Stator.SLDPRT, Bearing 6804-2RS (20x32x7).SLDPRT, BearingWasher.SLDPRT, Bearings on inside link.SLDASM, Bearings on outside link.SLDASM, BottomPanel.SLDPRT, BottomPanelWithAvionics.SLDASM]
2026-08-07 Correct AK45 MIT torque/velocity scaling; jump timing, CAN health, v4 CAD
    Firmware
    - The AK45-10 MIT reply field is shaft torque in N·m, not motor current in
    amps. Renamed the affected params and state fields accordingly
    (calib_seek/move_cur_lim -> calib_seek/move_trq_lim, calib_cur_trip_ms ->
    calib_trq_trip_ms, hip_*_current_a -> hip_*_torque_nm) and rescaled the
    values that were derived from the wrong interpretation: ff1_kt_hip 1.2732
    -> 1.0, jump_torque_max cap 18 -> 8 N·m (MIT full scale), jump_omega_max
    default/bounds to the +/-20 rad/s MIT speed range, hip_running_tff_* range
    widened to +/-8.
    - Param store bumped to v3 with a migration path from v2: no format change,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
    [AK45-10 Rotor.SLDPRT, AK45-10 Stator.SLDPRT, AK_SIM.SLDASM, Ak sim rotor.SLDPRT, Ak45 Lever arm.SLDPRT, BODY.SLDASM, Bearing 6804-2RS (20x32x7).SLDPRT, BearingSpacer.SLDPRT]
2026-08-08 Update firmware, GUI and docs for the v4 leg geometry
    Every link length changed, the tibia became a dogleg, and the wheel went
    from 150 mm to 112 mm OD. Canonical source is the mechanical baseline
    drawing components/2N_10mm_279mm.pdf, whose machine-readable twin is
    simulation/2d/fourbar_optimizer_gui/presets/2N_10mm_279mm.json (the two
    agree to 0.01 mm).
    femur A->C 173.78 -> 187.58 mm
    coupler F->E 150.81 -> 169.54 mm
    stub C->E 35.13 -> 39.01 mm
    tibia |C->W| 129.39 -> 185.91 mm, now a dogleg (C sits 5.28 mm off
    the E-W line, away from the hip motor)
    F rel. A (-58.87, +18.00) -> (-36.42, +37.54) mm
    wheel r=75 -> r=56 mm
    Hard s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
2026-08-08 Add a search box to the Parameters tab
    Every section starts collapsed, so with 139 params a name you don't
    already know the group for is effectively invisible - calib_move_trq_lim
    sits under Calibration > "Extending", which is not a heading you would
    guess for a torque limit.
    Matches on name, description, group and sub-group labels, and the id in
    both hex and decimal; space-separated terms AND together, so "calib trq"
    narrows to 3 rather than widening.
    The point of it: a search deliberately ignores collapse state, so a hit
    is never hidden inside a section the user cannot see. Headers with no
    surviving rows are hidden too, and clearing the box restores the previous
    collapse state exactly.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
2026-08-08 Remove the periodic MIT re-entry from both hips (measured, not assumed)
    Two independent timers were re-sending the AK45 "enter motor mode" frame:
    firmware every 3 s (MIT_REENTER_MS, any state where mit_active is set) and
    the GUI's hip tab every 4 s (MANUAL only). The GUI's routed through
    on_manual() -> hip_motors_enter_mit(), which reset the firmware's
    last_enter_ms, so the two beat into a double re-entry ~1 s apart every 4 s.
    Enter-motor-mode is a mode transition, not an idempotent refresh, and it
    landed ~100 us before the next stiff setpoint frame - audible as a
    repetitive hip jerk in MANUAL, and a periodic disturbance into the balance
    loop in RUNNING.
    The justification for it - "motor si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
2026-08-08 Fix L_EFF_RET: evaluate it at alpha=0, not at the retract hard stop
    l_eff is interpolated as L_EFF_RET + alpha*(L_EFF_EXT - L_EFF_RET), so the
    two constants have to be the values at the alpha endpoints. alpha is the
    fraction of the CALIBRATED span, and define_limits() puts its zero one
    calib_backoff_rad in from the retract switch:
    alpha=0 -> q = Q_RET - backoff = +28 - 5 = +23 deg (NOT the +28 stop)
    alpha=1 -> q = Q_EXT = -57 deg (== the stop)
    The previous commit evaluated the retracted end at the +28 deg hard stop,
    giving 0.086777 against a correct 0.098915 - 12.14 mm, or 12.3% low, and
    skewing every FF1/FF2 term across the whole schedule. L_EFF_EXT was rig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
    [control_loop.cpp]
2026-08-08 Measure the extended hip stop; clamp roll offset to travel headroom
    Closes the two code follow-ups AngleRetractedExt.md left open, and deletes
    the document - everything else in it was either superseded by the v4 leg
    or already done.
    Extended-stop search. define_limits() used to take the extended end on
    faith from calib_range_*_rad, so nothing ever checked the span against the
    hardware; that is how the previous geometry ran 14 deg past its stop
    undetected. Calibration now drives to the extended stop and measures it,
    via two new phases:
    ... -> BACKOFF -> SEEK_EXTENDED -> RETURN_HOME -> RAMPDOWN -> DONE
    SEEK_EXTENDED reuses the existing torque-trip machinery with one
    inversion: in the se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
2026-08-09 Raise calib_seek/move_trq_lim param ceiling to 6 N.m
    Both calibration torque-limit params were capped well below what the
    AK45-10 can deliver (2 and 4 N.m against a 7 N.m peak), leaving no
    headroom to raise the trip threshold when calibration false-tripped.
    Ceiling only -- defaults are unchanged at 0.3 / 0.6 N.m.
    schema.json is the source of truth; the generated table and protocol
    doc are regenerated by protocol/generate_protocol.py. The GUI's
    generated_protocol.py carries no min/max (bounds come from the firmware
    at runtime), so it needs no regeneration.
2026-08-09 Stand down the hip jump guard while an encoder zero is in flight
    Calibration ESTOPed on the right hip the instant it zeroed the encoder:
    Calib R: retract switch PRESSED; encoder zeroed
    FAULT: hip R pos jump 1.732 rad > 1.571 -> ESTOP [fault 0x04]
    One millisecond apart -- no leg moves 99 degrees in 1 ms. Zeroing
    redefines the motor's position frame, so for a few ms the command is
    already in the new frame while replies still in flight carry the old
    one, and pack_and_send()'s guard compares the two.
    calibration.cpp already tried to cover this by writing hm.pos_rad = 0
    right after zero(), but the CAN RX ISR overwrites that snapshot with the
    stale pre-zero position from a reply the motor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
2026-08-09 Calibration only seeks the retract switch; drop the extended-stop search
    Removes the SEEK_EXTENDED and RETURN_HOME phases. Calibration now finds
    the switch, zeroes, backs off calib_backoff_rad, and stops:
    RELEASE_SWITCH? -> SEEK_SWITCH -> WAIT_ZERO_SYNC -> BACKOFF
    -> RAMPDOWN -> DONE
    The removed phases drove the leg from the switch all the way out to the
    extended hard stop, read the over-torque trip as a measurement of the
    span, then walked it back. The robot is unsupported and not balancing
    during CALIBRATION, so swinging a leg through its full ~85 deg stroke
    there is a large unforced disturbance -- to learn a number the mechanism
    already fixes and the CAD already give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
2026-08-09 IMU gyro-stall detection and the radio rescue stick combo
    Two independent bench-driven changes that were already in the working
    tree before this session.
    IMU: the BNO086's Game Rotation Vector and gyro streams stall
    independently -- a gyro-only stall freezes the body rates while attitude
    keeps updating, so IMU_NOMINAL stays set and nothing notices.
    imu_last_update_ms() now reports the OLDER of the two, so freshness is
    judged on the weakest stream rather than the healthiest.
    main.cpp: rescue stick combo. CH3+CH2 pinned full up with CH1+CH4 full
    down -- both sticks jammed into opposite corners, which no driving input
    produces and which is awkward enough to hold that it cannot be stumbled
    int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
    [main.cpp]
2026-08-09 CAD: stiffer 3D-printed v4 legs -- balancing baseline (zip-tied)
    New 3D-printed leg parts with a stiffer 4-bar, plus the mirrored part
    set (Mirror* femur/tibia/coupler/body/side-panel/switch-mount) so left
    and right are modelled separately rather than reused.
    Bench state this records: the robot balances with the legs ZIP-TIED.
    Untied, the soft hip sits in series inside the balance loop -- wheel
    reaction torque lands on the tibia and only reaches the body through the
    hip joint -- and the leg rattles against the retract hard stop, which
    forced LQR pitch gain down 5x from the value that balanced on 2026-08-02.
    Measured across the boundary: hip-deflection power above 3 Hz went
    0.2% -> 14.7%, an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
    [BODY.SLDASM, BottomPanelWithAvionics.SLDASM, Box.SLDASM, COUPLER.SLDASM, Cap.SLDPRT, Coupler.SLDPRT, EncoderCarrier.SLDPRT, FEMUR_INSIDE.SLDASM]
2026-08-09 Measure balance point vs leg height; seed the v4 table
    Adds tools/balance_trim_sweep.py and a characterization directory to
    start building lqr_pitch_trim_* against leg height, plus the first v4
    data point from the 2026-08-09 run that balanced.
    The quantity recorded is deliberately NOT lqr_pitch_trim_* itself. The
    LQR hold is proportional-only, so a wrong trim is silently absorbed by
    the velocity PI integrator biasing theta_ref -- the robot stands there
    looking trimmed while permanently spending lean budget on a DC offset.
    The integrator is the instrument: what it converges to IS the trim
    error, so the portable quantity is pitch_trim_rad + theta_ref, both of
    which are in telemetry. A run mea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
    [balance_trim.csv]
2026-08-09 Measure the balance point directly; gate it on equilibrium, not elapsed time
    Replaces the estimator added in c1a2685. That version reported
    pitch_trim_rad + theta_ref on the reasoning that the velocity PI
    integrator is the instrument for trim error. True, but needlessly
    indirect: at equilibrium tau_sym = 0, so the control law itself gives
    pitch = theta_ref + trim. The balance point is just the mean pitch, and
    it does not depend on what the trim was set to during the run.
    What actually needed fixing was the convergence test. Waiting on "the
    integrator looks settled" is not a criterion; a robot that is not
    accelerating needs no wheel torque, so equilibrium is |mean tau_sym| ~ 0
    with the wheel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
    [balance_trim.csv]
2026-08-09 Reject trim sweeps captured with alpha_force_ret_en set
    alpha_force_ret_en=1 pins g_state.gain_sched_alpha to 0 in telemetry as
    well as in the gain blend, so a multi-height sweep captured with the flag
    still on bins every leg height at alpha=0 -- silently overwriting one row
    instead of building a table. Detect it (alpha constant while the hip
    command moved) and refuse the run.
2026-08-09 Make alpha_force_ret_en persistent, with a boot warning in its place
    Requested for multi-session gain tuning at a single leg height: with the
    gain blend forced to the retracted anchor, the whole _ext-anchor class of
    hazards is out of play, and having to re-set the flag every power cycle
    is pure friction.
    This reverses a deliberate decision, so it does not go in silently. The
    param was non-persistent for a stated reason -- a forgotten bench
    override surviving a power cycle leaves the robot flying retracted gains
    at full extension "with nothing on screen to say why". Persistence
    removes the guarantee; the boot-time WARN added in main.cpp replaces it
    with a signal, which is the part that actua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
    [main.cpp]
2026-08-10 CAD: v3/v4 assembly updates, new wheel-support and hanger parts
    Pre-existing working-tree content, separated from the software checkpoint
    that follows because it shares nothing with it.
    [BackWheelSupport.SLDPRT, BottomPanelWithAvionics.SLDASM, Box.SLDASM, ROBOT.SLDASM, SupportWheel.SLDPRT, WheelHanger.SLDPRT]
2026-08-10 Stable working commit: standup rework, roll suspension, catch authority
    Verified on hardware: robot balances stably, is responsive, the roll
    controller works, the suspension is soft, and it clears obstacles.
    STANDING_UP was rebuilt around the sequence the manoeuvre actually needs
    (CROUCH -> STIFFEN -> RECOVER):
    - CROUCH ramps the hips from their pose at arm to the calibrated retracted
    endpoint over standup_crouch_time, with kp and the hip feedforward faded
    in on the same minimum-jerk profile as the position. Both start at zero,
    so arming applies no torque step from any pose.
    - The ramp now starts from the *clamped* pose. Every hip command is clamped
    to the calibrated span on the wa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
    [_test_cacc.xml, golden_vectors.csv]
2026-08-12 Working robot that jumps! Firmware, sim/twin, CAD, and GUI updates
    [Battery holder.SLDPRT, BatteryCap.SLDPRT, BottomPanel.SLDPRT, BottomPanelWithAvionics.SLDASM, Box.SLDASM, EncoderCableClamp.SLDPRT, EncoderCarrier.SLDPRT, ROBOT.SLDASM]
2026-08-20 Jump landing/handoff phases, jump study tooling, IMU library update
    Pre-existing working-tree changes, committed separately from the TX15 radio
    package so each is reviewable on its own.
    Firmware: live LANDING and HANDOFF phases split out into jump_landing.h and
    jump_retract.h, with the state machine reworked around them and
    FAULT_JUMP_TIMEOUT covering both the per-phase and whole-jump budgets.
    schema.json gains the landing-detection params (jump_air_accel_z,
    jump_land_accel_z, jump_land_gyro_imp, jump_land_min_air, jump_land_timeout),
    the handoff gain-blend set (jmp_handoff_*), the re-arm gates (jmp_arm_*) and
    the forward-nudge pair; generated C++/Python/docs/vectors regenerated to match.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
    [EncoderCarrier.SLDPRT, MirrorTibia.SLDASM, MirrorTibia.SLDPRT, ROBOT.SLDASM, state_machine_contract.json]
2026-08-20 TX15 radio package: RoboBlue theme, LVGL HUD, sound pack, WLR ROBOT model
    Radio-side half of tx15-robot-integration-plan.md. No firmware changes: the
    link is still iBUS and the CRSF swap (plan section 0) has not happened. This
    is staged and validated so it is ready when firmware catches up.
    radio/sdcard/ mirrors the card. Installed and verified byte-for-byte on the
    real radio (board tx15, EdgeTX 3.0.0, 480x320, Mode 2, internal module already
    TYPE_CROSSFIRE): 68 files, no overwrites.
    THEMES/RoboBlue dark slate with a cyan-blue accent, all 13 colour roles.
    WIDGETS/WLRHUD LVGL HUD: state, attitude, gain_sched_alpha, wheel velocity,
    hip torques, 12 health-flag chips, ESP32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
    [annunc.lua, main.lua, model90.yml, telem.lua]
2026-08-20 radio: add TODO.md — on-radio steps now, firmware phases after
    Ordered by what is actionable. Everything under "Now" needs no firmware, no
    CRSF and no robot power: finish the install, swap the shoulder switches to
    momentary/latching, and walk the whole channel map on the Outputs screen
    including both stick combos and both power-on warnings.
    After that, the plan's phases A-E with the specifics that matter: the
    failsafe-parity requirement on the CRSF swap, the ~10-fields-at-5-10-Hz budget
    on telemetry, and the note that the command tunnel must be prototyped before
    any UI is designed around it.
    Flags the one unverified assumption in the package: EdgeTX auto-discovering
    model90.yml. That log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
2026-08-20 Phase A+B: iBUS -> CRSF link, failsafe parity, and radio telemetry
    Executes phases A and B of tx15-robot-integration-plan.md. Everything that can
    be done without an ELRS receiver is done; what remains is hardware bring-up,
    listed in radio/TODO.md.
    ## Phase A -- the link
    teensy/src/crsf_protocol.h is the wire protocol, deliberately Arduino-free so
    the failsafe rules can be tested on a desktop with no radio, no receiver and no
    Teensy. Crsf.h is a thin serial+clock wrapper whose public surface is identical
    to IBus -- begin/update/channel/alive -- so the 24 call sites in main.cpp
    changed name and nothing else. Every one of those sites is safety-relevant
    (arm interlock, rescue combo, calibratio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
    [Crsf.h, CrsfTelem.h, annunc.lua, crsf_protocol.h, main.cpp, main.lua]
2026-08-21 CRSF telemetry: real glitch count, honest "no data" for bus current
    Two fields the previous commit sent as zero. One was my mistake, the other is
    now explicit rather than misleading.
    vel_glitch_count already existed. I had grepped only teensy/src/ and missed
    lib/WheelMotors/, where wm_L/wm_R.vel_glitch_count have been incremented by
    the glitch filter all along. Both axes are now summed and sent, so the HUD's
    GLCH field and the "wheel glitches rising" callout do something.
    The frame carries it 16-bit saturating rather than 8-bit, and the WLR_STATE
    payload grows 16 -> 17 bytes to make room. It is a free-running total and the
    annunciator warns on it RISING, so a byte-wide field would have sat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
    [CrsfTelem.h, crsf_protocol.h, main.cpp, main.lua, telem.lua]
2026-08-21 Fix: EdgeTX's YAML parser has no comment support
    Selecting WLR ROBOT on the radio showed a stock main screen. Cause: EdgeTX's
    YAML parser (radio/src/storage/yaml/yaml_parser.cpp) has NO comment support at
    all. '#' is not a token it knows -- a comment line is read as an attribute
    name, find_node() fails, and at top level toParent() returning false makes the
    parser `return DONE_PARSING`. It stops dead, keeps only what it read before
    that point, and the radio then rewrites the file from defaults. Nothing warns.
    The evidence was on the card: model90.yml had gone from the 17312 bytes we
    wrote to 4336 bytes of radio-authored default. header, inputNames and expoData
    survived with our values -- nam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
    [model90.yml]
2026-08-21 CH11 hard ESTOP: a single-motion panic input while running
    Plan section 6, item 4. The radio has been sending CH11 since the model went
    on the card; firmware now reads it.
    This closes a real gap rather than adding a convenience. CH10 low starts
    DISARMING, which is a controlled ramp-down and not a stop. The rescue combo is
    armed only in STANDBY and ESTOP. So while the robot was actually running there
    was nothing that said "stop now" -- the fastest available action was a
    two-stick gesture that is deliberately inert in exactly that state.
    LEVEL-triggered, not edge-triggered, for two reasons that are both wanted:
    * While the switch is held the fault cannot be cleared. FAULT_HUMAN_ESTOP is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
2026-08-21 Model: disable transmitter trims on the stick channels
    carryTrim 0 is TRIM_ON (myeeprom.h; mixer.cpp applies the trim when
    carryTrim == 0). It was copied from the reference model without thought, which
    left all four trim rockers live on CH1-CH4.
    That is a second authority over the robot's setpoints, and this robot already
    has its own -- pitch_trim_rad, and the balance-point work in CLAUDE.md. A
    bumped rocker would put a permanent creep on velocity, a standing lean on roll,
    a slow turn on yaw, or an offset on leg height. Worse, the custom screens turn
    EdgeTX's trim display off, so it would be doing that invisibly. Radios get
    bumped in bags.
    All stick mixes now use TRIM_OFF. Documented in ra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
2026-08-21 Model: follow the factory shoulder-switch fit (SF momentary, SE latching)
    RadioMaster's own manual diagram (back view) shows the TX15 ships with SF as
    the Momentary Button and SE as the Latching Button. The model had them the
    other way round, taken from the integration plan's proposed lettering.
    That was not cosmetic. As shipped it would have put:
    * JUMP on a latching control -- the exact foot-gun the plan warns about,
    since a latched jump request sits there invisibly
    * ARM on a momentary button -- and the firmware arm test is level-based
    (armed = alive && ch10 > 1990), so the robot would have disarmed the
    instant you released the button
    Swapped the two channel assignments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
    [model90.yml]
2026-08-21 Radio: new switch layout, calibration and reset on switches, no hard ESTOP
    Operator-chosen assignment. Top row left to right is now the whole setup
    sequence -- calibrate, log, profile, arm -- with the two shoulder switches
    carrying the things you do while the robot is moving.
    CH5 SB top row, 2nd from left SD logging
    CH6 SF momentary shoulder jump
    CH9 SC top row, right of dials speed profile
    CH10 SD top row, rightmost ARM
    CH11 SA top row, leftmost calibration request (new)
    CH12 SE latching shoulder reset fault / clear ESTOP (new)
    CH11 and CH12 are switch equivalents of the two stick combos, which remain as
    the fallback for when the radio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
    [main.cpp, model90.yml]
2026-08-21 Model: remove expo on hip height
    Stick position now maps straight to leg height. Worth noting for anyone
    tempted to add a curve back: hip_cmd_rate_lim already shapes the command on
    the robot side, so a transmitter curve compounds with it, and what the Outputs
    screen shows stops being what the firmware receives.
2026-08-21 Live tuning on its own channels: group select CH13-15, latch CH16
    Moves gain-group select off the CH5/CH6 combination and onto dedicated
    channels driven by the RGB push buttons, and gives latching a physical button.
    The old scheme borrowed CH5 and CH6, so entering a tuning session gave up SD
    logging AND the jump trigger -- which made tuning bench-only by construction,
    and meant the one session you most want a log of was the one session you could
    not log. On their own channels nothing is traded away, and CH5/CH6 are now
    unconditionally log and jump (the SIMPLE/LEGACY mode split is gone).
    One channel per group rather than two encoded bits, because the radio's RGB
    function switches support mu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
2026-08-21 Coordinated-turn lean, on RGB button 5 (CH15)
    Turning at speed throws the mass sideways. Leaning into the turn puts the
    resultant of gravity and centripetal acceleration back along the robot's own
    vertical, so the hips carry compression instead of a lateral moment:
    roll_cmd = -lean_gain * atan(v * omega / g)
    It is a SETPOINT GENERATOR, not a controller, which is why it is small.
    Everything that makes it safe already exists in control_loop.cpp: the setpoint
    slew limit, the PID with anti-windup, and the travel-headroom clamp at
    min(t, 1-t)*span. It also inherits, free, that controller's exclusion during
    jump launch and flight.
    The maths lives in teensy/src/lean_turn.h, Arduino-free so t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
2026-08-21 Fly the digital twin with the real TX15 over USB HID
    The transmitter enumerates as a USB gamepad (the model already ships
    usbJoystickIfMode: JOYSTICK), so the same sticks, switch layout and muscle
    memory that drive the robot can drive the simulation.
    The point is transfer, not novelty. twin/params_control.py and the firmware's
    parameter table are both generated from protocol/schema.json, so a gain found
    in sim is the same named parameter on the robot. To make that real, the input
    path decodes the gamepad the way the FIRMWARE decodes the radio: HID -> channel
    microseconds -> the scaling in radio_update(). The thresholds are the
    firmware's own absolute literals (> 1990), not re-derived ones,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
2026-08-21 Checklist: ship it under every filename EdgeTX might look for
    The checklist did not appear at power-on despite displayChecklist: 1 and
    MODELS/"WLR ROBOT.txt" being present and correctly named on the card.
    I could not establish the cause. The boot gate in edgetx.cpp is
    `g_model.displayChecklist && modelHasNotes()`, and modelHasNotes() has no
    definition anywhere in the 2.12 tree I can read -- while the radio is on 3.0,
    whose source is not published. view_text.cpp's getModelNotesFile() tries four
    names (model name, model name with underscores, model FILE name with .yml
    swapped for .txt, and that with underscores), but which of those the boot gate
    consults is exactly the part I cannot see.
    So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
2026-08-21 Model: boot straight to the HUD, checklist on demand
    displayChecklist 0. The checklist stops being a modal on every power-on and
    model select; the file is still shipped and still reachable from the model
    menu, which uses the same filename resolution the aliases were added for. So
    nothing is lost except the interruption.
    Worth keeping in mind: set it back to 1 for a CRSF bring-up or a jump-ladder
    session. Being made to dismiss that ladder deliberately is the entire reason it
    was written, and those are the runs where skipping a step costs something.
    disableThrottleWarning stays 0 regardless -- "the hip stick must be retracted
    at boot" is a separate guard and still worth having.
    Also correct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
    [model90.yml]
2026-08-21 Outputs screen: white text and bars, and a contrast check
    The channel monitor on screen 2 was dark-on-dark and barely readable.
    Cause: I took the Outputs widget's colour options verbatim from the radio's
    own model1.yml, which was written for the stock theme. Its option order is
    [first_channel, fill_background, BG, TEXT, BAR] (widgets/outputs.cpp), and the
    defaults are PRIMARY1 for text and SECONDARY1 for the bars -- sensible on a
    LIGHT theme. Under RoboBlue those resolve to 0x39434F text and 0x121821 bars
    on a 0x070A0F background: luminance deltas of 0.22 and 0.05.
    Text and bars now both use PRIMARY2 (0xE2ECF7), the same near-white the HUD
    uses for primary text.
    This mattered more than co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
    [model90.yml]
2026-08-21 Outputs screen: distinct bar colour so bars stop hiding channel names
    The previous fix made text and bars the same near-white, and the bars then
    covered the channel names.
    Cause is the draw order in widgets/outputs.cpp: the bar object is created
    first and both labels after it, so LVGL draws the channel name and the value
    ON TOP of the bar. The bar grows outward from centre, underneath both. Same
    colour for bar and text means every name vanishes exactly where its own bar
    reaches it -- which reads as the bars covering the names.
    Bars are now SECONDARY2 (accent blue, #00A8FF). Luminance deltas:
    text vs background 0.88
    bar vs background 0.51
    text vs bar 0.38
    check_sdcard.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
    [model90.yml]
2026-08-22 Theme: white fonts, and a contrast check grounded in the theme source
    Text roles were reading dark. Lifted:
    PRIMARY2 0xE2ECF7 -> 0xFFFFFF primary text
    PRIMARY3 0x8FA3B8 -> 0xE2ECF7 secondary text, units, labels
    DISABLED 0x4A5A6B -> 0x8FA3B8 still visibly dim, now legible
    QM_FG 0xE2ECF7 -> 0xFFFFFF
    PRIMARY1 deliberately stays DARK at 0x39434F, which looks wrong until you read
    etx_lv_theme.cpp. etx_std_ctrl_colors() draws a standard control as:
    normal background PRIMARY2 text SECONDARY1
    checked background ACTIVE text PRIMARY1
    edited background EDIT text PRIMARY2
    So PRIMARY1 is the text of a CHECKED control, whose background is the cyan
    ACTIVE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
    [EncoderCarrier.SLDPRT, MirrorTibia.SLDASM, MirrorTibia.SLDPRT, ROBOT.SLDASM, Tibia.SLDASM, Tibia.SLDPRT]
2026-08-22 Radio docs and GUI labels: say what each channel actually does
    radio_channels.md described a live-tune scheme that no longer exists: group
    select on C13/C14/C15 one channel per group, latch on C16, and "return both C5
    and C6 to up" to leave. The firmware has used encoded levels on C13 alone,
    latch on C14, since the RGB buttons were wired up. The channel table two
    screens above already said so, so the file contradicted itself.
    Rewritten off the code rather than the prose: decode bands come from LT_BAND_*
    in main.cpp, latch is C14, and the LEGACY-mode notes on C5/C6 are gone because
    there is no LEGACY mode -- C5 is always SD log and C6 always jump.
    Also records where each channel can be watc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
2026-08-22 CRSF link diagnostics: prove which half of the link is silent
    The telemetry emitter is fire-and-forget -- it writes into a UART FIFO and
    cannot know whether a receiver is on the other end. So "the radio shows no
    telemetry" was indistinguishable between firmware that never emitted, a TX wire
    going nowhere, and a radio that had not discovered its sensors: three problems
    with three unrelated fixes and no way to tell them apart.
    Crsf already counted tx_frames/tx_drops/crc_errors and parsed LINK_STATISTICS,
    but nothing outside the class ever read any of it. Five read-only params now
    mirror them, updated at 10 Hz (not every tick -- these are for a human reading
    the Params tab, and five registry w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
    [main.cpp]
2026-08-22 Radio telemetry works: stop the model hiding its own Telemetry menu
    The HUD sat on "NO ROBOT TELEMETRY" with a completely healthy link. The cause
    was one line in the model: modelTelemetryDisabled: ON. EdgeTX was hiding the
    model's entire Telemetry menu, so the sensor list could not be reached and
    "Discover new sensors" did not exist. No sensors were ever created, so the
    HUD's getFieldInfo("FM") returned nil, robotTelemetry() stayed false, and the
    banner never cleared -- while the Teensy emitted 39 frames/s at 100 % uplink LQ
    and -23 dBm the entire time.
    build_model.py never wrote any of the eleven menu-visibility flags; the file
    simply ended at topbarWidgetWidth. EdgeTX filled them in when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
2026-09-20 Aesthetics improvements in CAD
    Adds the cad/aesthetics generation pipeline (concept boards, tournament
    decisions, per-part renders, and sliced .3mf outputs in the locked
    GLACIER look plus alternate colorways), the artistic-concepts reference
    images that drove it, and the resulting SolidWorks assembly/part updates.
    [BottomPanelWithAvionics.SLDASM, Box.SLDASM, Coupler_glacier.3mf, Femur_abyss.3mf, Femur_apex.3mf, Femur_bullion.3mf, Femur_circuitry.3mf, Femur_dune.3mf]
2026-09-20 CRSF telemetry: cut link budget, mute bench alarms, add TX15 datasheet
    The WLR_STATE emitter was pushing ~590 B/s into an ExpressLRS 1:128
    downlink that only carries tens of bytes/s, so most frames were
    discarded and which ones survived was arbitrary. Trims the schedule to
    state/fault/profile at ~52 B/s, drops ATTITUDE entirely (builder stays
    tested for an easy revert), and sends state twice (WLR_STATE numeric +
    FLIGHT_MODE text) since only FLIGHT_MODE is a standard frame confirmed
    to relay.
    annunc.lua gets an ALARMS switch (off for now, bench work only) that
    gates tones/haptics while leaving spoken callouts untouched, plus an
    everSeenRobot() latch so the HUD/annunciator distinguish "never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
    [CrsfTelem.h, annunc.lua, crsf_protocol.h, main.cpp, main.lua, model90.yml, telem.lua]
2026-09-20 Phase 1: weld non-manifold pinches so STEPs survive Parasolid
    Parts opened in SolidWorks incomplete -- the Femur showed a thin blade where
    the design has a cylinder and its grey cap was simply absent, while Bambu
    Studio showed the same file correctly.
    Root cause: graphite_1 was a NON-MANIFOLD SOLID. Four vertical edges, each the
    full 9.875 mm feature depth, each with four planar faces meeting along one
    line. OCC represents that happily and BRepCheck_Analyzer calls it valid.
    Parasolid cannot represent a non-manifold solid at all, so on import it splits
    the body at every self-contact: one 17.68 cm3 body became 30 solid bodies and
    11 surface bodies totalling 0.00 cm3, with no error raised.
    It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
2026-09-20 Phase 2: the add/remove map, measured free space, and a validated leg sweep
    Fernando marks up screenshots; the geometry decides how far. Everything here is
    input for the Phase 3 rebuild -- no part geometry changes.
    HIS MARKS. tools/marksheet.py writes orthographic, axis-aligned, unstyled sheets
    with two sidecars: a .json (camera basis, px_per_mm, per-part 4x4 transform) and
    a .npz (per-pixel part id + depth). Those are what turn a marked pixel into an
    exact point in the part own frame; readmarks.py --selftest paints a mark inside
    every part on every sheet and checks each maps back inside the zone read from
    it. The legend is RED = MAY REMOVE, GREEN = MAY ADD, which is the inverse of
    what HAN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
2026-09-20 Phase 3 prep: the topology gate, and a collision check over the whole stroke
    The rebuild cannot judge its own work without these two. Both are gates, not
    geometry -- no part changes here.
    THE TOPOLOGY GATE. lib/manifold.gate() runs the four checks verify.py never
    had: non-manifold edges empty (Parasolid splits such a body into debris on
    import and raises no error), free edges empty (open shell), exactly ONE SOLID
    per fused body -- his "no floating pieces" -- and exactly ONE SHELL per solid,
    since a second shell is a sealed internal cavity and unprintable. Plus a
    needle/debris report under 1 mm3 or 0.5 mm thick, for "no sharp edges".
    A per-filament body may legitimately be several solids, b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
2026-09-20 Constraint 5 gets a gate: minimum wall thickness, measured against the source
    The last of the six constraints with nothing behind it. lib/thinwall.py casts
    a ray along the inward normal from every point on the surface and takes the
    distance to the first surface it meets -- the same measure as SolidWorks'
    Evaluate -> Thickness Analysis, chosen so Fernando can check it in the kernel
    that actually consumes the files.
    Calibrated before it was believed. --selftest runs seven solids whose answer is
    known by construction: a 3 mm plate reads 3.000, a 2 mm rib 2.000, a 1 mm pocket
    floor 1.000, a 0.5 mm fin 0.500, and -- the two that matter -- a 3 mm chamfer and
    a 0.5 mm-deep ledge produce no thin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
2026-09-21 Phase 3, Femur increment 1: three razor mechanisms, all the same root cause
    Every one of them is a boundary measured against a DESIGN OUTLINE instead of
    against the real material, and each leaves a sub-millimetre wall that every
    existing check passed.
    1. REMOVALS measured their margin from `grown`, which includes the flange -- and
    the flange is a prism over part of the depth, so at a z where it does not
    reach there is no metal out there at all. At x=+60 the source is solid from
    y -17.25 to +18.5 and the styled part had a 0.5 mm free-standing column at
    y -17.25 with twelve millimetres of air beside it. `clip(cuts, 4.5)` had
    faithfully kept 4.5 mm clear of `grown` and left ha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
    [Femur_glacier.3mf]
2026-09-21 Constraint 6: the back gets designed -- and the render that hid it gets fixed
    He asked "I still see silly squares of colors in the back of parts, have you fix
    that?" The answer was no; constraints 3, 4 and 5 had been worked and 6 had not
    been touched. Looked at the back first in a WELDED export, because HANDOFF.md
    warned the grey might have been Phase 1 shattering rather than a styling
    failure. It is not.
    WHAT THE SQUARES ARE. The colour split is a plane with white above it, so the
    back is graphite EXCEPT where the part is locally thinner than the cap is deep,
    and there white reaches straight through. The patches are the show-face pockets
    seen from behind. Nobody chose them, which is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
    [Femur_glacier.3mf]
2026-09-21 Colour bands raked in PLAN, and the Coupler's flying pieces fixed at the cause
    Two things he raised on the Coupler's back: the grey blocks go "straight down
    ... it seems that a child did it", and it still has pieces attached to nothing.
    THE STRAIGHT EDGES WERE IN THE WRONG PLANE. The colour bands were trapezoids in
    the X-Z plane swept through Y -- trap_xz(..., skew=6) fed to full_y(). A
    trapezoid in X-Z is only trapezoidal seen from the SIDE: intersect it with
    either big face of the part, a plane of constant z, and its footprint is a
    RECTANGLE whose ends are lines of constant x. Dead straight, whatever skew was
    set to. Every colour boundary on the two faces anybody looks at was square,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
    [Coupler_glacier.3mf, Femur_glacier.3mf]
2026-09-21 Graphite becomes a DRAWN shape, not the leftover of a plane (decision 32 B)
    Round 1 offered six greys on the blue's own routed path at a constant offset and
    he rejected all six: "the gray line was following the blue almost exactly ... it
    needs to be a little bit more random, but we still did the same dog-legging kind
    of thing", with an older board attached as the counter-example. That board's
    grey is not a trace at all -- it is the FEATURE BANDS, which sit at different
    lanes, run different lengths and stop in different places. The staggered rhythm
    is the thing; the relationship to the blue is not. Round 2 kept the dog-legging
    and threw away the constant offset. He chose B: three independ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
    [Coupler_glacier.3mf, Femur_glacier.3mf]
2026-09-21 The show face is not the bounding box either: the Coupler's blank side
    "The coupler only one side is edited, and the other side looks just plain white
    to me." Correct, and it is the mistake I had already fixed at the other end,
    unfixed at this one.
    _back_plane existed because ZB is the bounding-box floor and 29 of the Femur's
    39 mm are its knee boss TUBE. The top has the same problem and the Coupler
    wears it: its plate is z -5..+5.5 while its BEARING TUBE runs to +30, so `ZT` is
    the top of a cylinder. The show-face inlay was measured from ZT, so it painted
    the tube end 24 mm above the plate and left the plate itself plain white. The
    Femur escaped only because its tube points the other w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
    [Coupler_glacier.3mf]
2026-09-21 All three links pass the topology gate -- and a weld that ate a part
    His three notes: the Coupler's other side was plain white; the Tibia's front is
    his favourite and only its back needed fixing; and the Tibia's side cutouts read
    as straight lines.
    THE COUPLER'S BLANK SIDE was the ZB mistake unfixed at the other end. Its plate
    is z -5..+5.5 but its BEARING TUBE runs to +30, so ZT is the top of a cylinder
    and the show-face inlay painted the tube end 24 mm above the plate.
    _plate_face() finds either face now. The Femur's ZSHOW is its ZT, so it is
    unchanged and reproduces at 2129 mm2 of trace -- which is how this was checked.
    THE TIBIA KEEPS ITS FRONT, his choice over matching the Femur. I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
    [Coupler_glacier.3mf, Femur_glacier.3mf, Tibia_glacier.3mf]
2026-09-22 The collision sweep runs at last, and four thin-wall fixes get measured
    THE SWEEP. 21 hip angles, model validated at 0.0000 mm reconstruction error
    on all three exported poses. It has never been run before; it takes twelve
    minutes, not the thirty the handoff guessed. Three interferences, and all
    three are the FLANGE:
    Femur x AK45-10 Stator +12.4 mm3 at EVERY one of the 21 angles -- constant
    because the interference is annular about the hip
    axis (r 25.8 against the stator's 26.5)
    Tibia x Femur +2.0 mm3 at one end of travel only
    The plan keep-out cannot fix this: it covers 75% of the Femur's own silhouette,
    because it is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
    [Coupler_glacier.3mf, Femur_glacier.3mf, Tibia_glacier.3mf]
2026-09-22 Constraint 5 reports at 3.0 mm and gates at 1.5 (decision 36, his call)
    min_wall 3.0 stays the number that gets PRINTED -- the map still colours
    everything under 3 mm and nothing is hidden. GATE_WALL 1.5 is what passes or
    fails. ONE ray cast, TWO masks, so the reported number and the gated number
    cannot drift apart.
    The reason is in the numbers rather than in convenience. Two thirds of the
    Femur's and three quarters of the Coupler's introduced thin surface sits in the
    2-3 mm band: thinner than he asked for, but not a razor and not a print risk at
    four perimeters. And his own source parts fail an absolute 3.0 -- source
    Coupler 1729 mm2, and on the source Femur every thin patch is the hip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
2026-09-22 CAD: checkpoint collision-fix-first decision, log robot shakiness in TODO
    Aesthetics pauses per DECISIONS.md #37: fix the 3 collision pairs (Femur x
    AK45-10 Stator, Tibia x Femur) before any more look changes. TODO.txt notes
    the current-operation shakiness under separate investigation.
    [Femur_glacier.3mf]
2026-09-22 firmware: add teensy41_imu_legacy build for IMU fusion A/B testing
    Flashable env:teensy41 variant reverting to the pre-2026-08-20 fusion path
    (Game Rotation Vector + separate calibrated gyro, both at 400 Hz, linear
    accel back on) via the IMU_USE_GYRO_INTEGRATED_RV=0 flag already wired into
    IMU.h/IMU.cpp for test-only A/B use. Added while tracking down roll-watchdog
    trips and balance shakiness suspected to trace to that commit's switch to
    Gyro Integrated Rotation Vector -- see lib/IMU/README.md's measured
    noise/drift comparison between the two fusion modes.
2026-09-22 Constraint 2 PASSES: the flange lap was re-entering the assembly keep-out
    no new collisions in any of the 21 configuration(s) checked
    All three reported interferences were one defect, in `_flange_at`:
    band = band.difference(ko_f) # cut clear of every neighbour ...
    ... # ... twenty lines later ...
    band = union([band, band.buffer(FL_OVER).intersection(mfp)]) # put back
    band = band.difference(kb) # holes re-subtracted; the ASSEMBLY not
    The FL_OVER lap exists so the fuse has something to bite. It grows the flange
    2 mm back inward over the source -- straight through the boundary that had just
    been enforced -- and nothing downstream loo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
    [Coupler_glacier.3mf, Tibia_glacier.3mf]
2026-09-23 HANDOFF: ready for a global check in a fresh session
    Rewrites the restart prompt from "start Phase 3, build the Femur first" to a
    global check: re-run every gate from clean against what is on disk, compare
    with the numbers recorded here, and report before fixing anything.
    Three claims in the file were wrong, not just stale, and are corrected:
    - Constraint 1 was marked "holds -- marks drive the regions, freemap the
    extent". Only the RED marks are wired, only on Femur/Coupler, and only to
    bound the through-cutouts. Green marks, freemap and reconcile are read by
    no part, and tibia.py never reads Tibia.json. Now PARTIAL.
    - "How it works" called asmkeepout.py superseded and u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
2026-10-03 Checkpoint: control loop/state machine tweaks, media reorg, cleanup stale files
    Removes jump_retract.h, old parameter exports, and stale planning docs;
    reorganizes media into dated folders and adds latest release-1.0 gains export.
    [Coupler_glacier.3mf, Femur_glacier.3mf, MirrorTibia.SLDASM, MirrorTibia.SLDPRT, ROBOT.SLDASM, Tibia.SLDASM, Tibia.SLDPRT, Wheel.SLDPRT]
2026-10-03 Add ODrive parameter export
    [Odrive export.json]
2026-10-03 Twin: re-sync with release firmware and add realistic loop delays
    Phase 0 - twin loads and matches firmware again:
    - robot_match.json points at "2026_10_10 Parameters for release 1.0.json";
    fit tool and tests read the export path from the report
    - port 9-point trim table, trim learner and yaw_rate_src (encoder yaw,
    340 mm track) into firmware_control.py
    - SIL harness builds again (_USE_MATH_DEFINES, comm_log/param_set stubs) and
    covers golden, encoder-yaw and trim-learn cases
    Phase 1 - plant realism:
    - remove legacy state predictor that cancelled the sensor delay
    - delay depth rounds half up (round(0.5) made the 1 ms actuator delay zero)
    - 10 ms wheel-speed sample-and-hold (measured i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
2026-10-04 CAD v4: assembly resave and the SolidWorks API hello-world part
    ROBOT.SLDASM is Fernando's own save from the v4 session. ai_components/
    hello_box.SLDPRT is the step-2 test part of the SolidWorks automation
    ladder (cad/solidworks_api/02_box.py), saved here at his request.
    [ROBOT.SLDASM, hello_box.SLDPRT]
2026-10-04 SolidWorks automation: native GLACIER styling, collision checks, safe save
    cad/solidworks_api/ drives SolidWorks 2023 over COM (pywin32, EnsureModule +
    QueryInterface) on the v5 sandbox copy of the robot:
    - 01-07 hello-world ladder: attach, build a part, read the assembly, drive
    the hip through the whole stroke (AI_HipDrive helper mate),
    interference detection, collision sweep, multi-colour parts + Bambu 3MF
    - 08/09 GLACIER rebuilt as native, editable GL_* features from each recipe's
    plan(): Femur, Coupler, Side panel, RobotMount, Tibia; multi-body
    white/graphite/blue; seat keep-out round every opening; collision
    keep-out from SolidWorks interf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
    [BearingWasher_glacier_native.3mf, Coupler_glacier_native.3mf, Femur_glacier_native.3mf, InsideFemurShaft_glacier_native.3mf, RobotMount_glacier_native.3mf, Side panel_glacier_native.3mf, SmallBearingWahser_glacier_native.3mf, Tibia_glacier_native.3mf]
2026-10-04 CAD v5 "Ai designed": the styled robot, native SolidWorks
    A copy of cad/v4 Larger Ball bearings that the automation is free to change
    (v4 stays the master). The five printed parts (Femur, Coupler, Tibia, Side
    panel, RobotMount) carry GLACIER as editable GL_* features, multi-body
    white/graphite/blue; the three green retaining washers carry colour-only
    circuit inlays. Mirrored left leg suppressed (his call). Verified on these
    files: 0 mate errors, 0 contacts lost, 0 new collisions over the 86-pose hip
    sweep (before the RobotMount left-field engraving, which only removes
    material). STEP exports stay ignored (.gitignore *.STEP); _originals/ holds
    the unstyled parts.
    README.md is the SolidWorks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
    [608ZZ.SLDPRT, AK45-10 Rotor.SLDPRT, AK45-10 Stator.SLDPRT, AK_SIM.SLDASM, Ak sim rotor.SLDPRT, Ak45 Lever arm.SLDPRT, BODY.SLDASM, Bearing 6804-2RS (20x32x7).SLDPRT]
2026-10-04 CAD v5: GLACIER on Femur_inside, designed-contact keep-out, source STEPs in git
    Femur_inside (the inner femur plate) gets its own GLACIER layout as native
    SolidWorks features: recipe generated by mkpart.py, Femur spec with its own
    blue/graphite routing and back circuit, and nothing proud (no flange, frame
    flush) because it swings inside the body box, which is not in the CAD.
    Through-cuts confined to the Femur's web markup.
    The plate carries two designed contacts -- the retract limit switch and the
    coupler hard stop -- and a removal there would delete them silently.
    17_contact_keepout.py measures them with the styling off and 08 keeps every
    removal and addition off them; 14 compare now also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
    [AK45-10 Rotor.SLDPRT, AK45-10 Stator.SLDPRT, AK_SIM.SLDASM, Ak sim rotor.SLDPRT, BODY.SLDASM, Bearing 6804-2RS (20x32x7).SLDPRT, BearingWasher.SLDPRT, COUPLER.SLDASM]
2026-10-04 CAD v5: lock the TPU tyre to the rim with ribs and grooves
    The tyre was held on the rim by a 0.7 mm press fit alone and slipped.
    18_tire_lock.py adds, as native SolidWorks features:
    - rim: 36 axial ribs (3.0 x 1.2 mm) on the band, one per spoke root, with a
    lead-in ramp at the top where the tyre goes on;
    - tyre: 36 matching grooves through the bore, line to line in width, floor
    keeping the same 0.7 mm radial press fit;
    - WheelMotorASM: plane mates locking the tyre's rotation to the rim and its
    seat (TL_TyreSeat replaces Coincident8, which the grooves broke).
    Checked: one body each, 0 mates in error, rim x tyre overlap 5506.92 ->
    5240.00 mm3 (press fit kept, ribs in the grooves; half a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
    [AK45-10 Rotor.SLDPRT, AK45-10 Stator.SLDPRT, AK_SIM.SLDASM, Ak sim rotor.SLDPRT, BODY.SLDASM, Bearing 6804-2RS (20x32x7).SLDPRT, BearingWasher.SLDPRT, COUPLER.SLDASM]
2026-10-04 CAD v5: tyre grooves deeper, floor level with the rib tops
    The first cut carried the band's 0.7 mm press fit onto the rib tops, so in
    CAD the ribs stood 0.7 mm into the TPU and the grooves looked shallow. The
    groove floor is now level with the rib tops (r 47.9, 1.9 mm deep): the press
    fit stays on the band between the grooves, and the flanks carry the torque
    as before. It cannot go much deeper: the tyre's end faces are flat only to
    r 48.0 before the shoulder.
    Rim x tyre overlap 3489.64 mm3 (band press fit only, rib tops clear),
    0 mates in error, saved through 16_check_and_save.
    [AK45-10 Rotor.SLDPRT, AK45-10 Stator.SLDPRT, AK_SIM.SLDASM, Ak sim rotor.SLDPRT, BODY.SLDASM, Bearing 6804-2RS (20x32x7).SLDPRT, BearingWasher.SLDPRT, COUPLER.SLDASM]
2026-10-08 CAD v5: box facet styling, tail strut, wheel hub, and automation tools
    - Native SolidWorks box facet concept with ribs and grooves
    - Tail strut design and mounting exploration
    - Wheel hub and rim styling with visual callouts
    - New Python automation: box checks, facet printing, style wheel, pipes
    - Updated component specs and firmware pinout
    - Comprehensive render suite for design review
    [BODY.SLDASM, BackPanel.SLDPRT, BackWheelSupport.SLDPRT, Battery holder.SLDPRT, Battery.SLDPRT, BatteryCap.SLDPRT, BottomPanel.SLDPRT, BottomPanelWithAvionics.SLDASM]
2026-10-09 CAD v5: encoder styling, new fastener models, bracket stand-in configs
    The previous session's work (2026-10-08) that this session did not touch:
    - 26_style_encoder.py: EncoderCarrier + EncoderCableClamp in the robot's
    look (palette A), Bambu 3MFs, renders
    - Common/: M2 and M2.5 button heads, M3 male-female standoffs
    - CornerBracket.SLDASM: NoFH1/NoFH2/NoFH12 configurations (stand-in
    flatheads a longer screw replaces)
    - fasteners in Femur/Tibia, the left coupler / inner plate sub-assemblies,
    the left opposite-hand parts' body colours
    - 16_check_and_save: the encoder parts guarded once styled
    - both-legs and fastener collision sweeps, full-robot renders
    25_fasteners.py, the README secti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
    [CornerBracket.SLDASM, EncoderCableClamp.SLDPRT, EncoderCableClamp_glacier_native.3mf, EncoderCarrier.SLDPRT, EncoderCarrier_glacier_native.3mf, Femur.SLDASM, M2 Roundhead.SLDPRT, M2.5 Roundhead.SLDPRT]
2026-10-09 CAD v5: left leg a true mirror, brackets mirrored, ring screws, fastener audit
    His markup (4 screenshots): fix every wrong fastener, align the corner
    brackets, the left femur "not in the right orientation, extra part".
    - Left femur + tibia: new ordinary assemblies LeftFemur.SLDASM (the true
    left femur MirrorFemur.SLDPRT, rotor, screws) and LeftTibia.SLDASM
    (cable clamp + 13 encoder screws un-reversed), every part at the exact
    mirror and locked; in ROBOT in place of the mirror-feature outputs
    MirrorFemur-4 / MirrorTibia-2 (suppressed, kept). LeftFemur locked to
    the left inner plate, LeftTibia pinned at the knee and E like the right
    one: the left leg follows the hip, exact mirror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
    [BODY.SLDASM, BottomPanelWithAvionics.SLDASM, LeftFemur.SLDASM, LeftTibia.SLDASM, MirrorBODY.SLDASM, MirrorFemur.SLDASM, MirrorFemur.SLDPRT, MirrorSIDE PANEL.SLDASM]
2026-10-10 CAD v5: relief -- colour shapes pressed, link-side grooves, hood skirt features
    His brief (2026-10-09): every shape of a different colour becomes a recess or a
    shallow extrusion; aggressive dark grey / blue features on the FacetHood's
    skirt and tier 1; accents on the white sides of the links.
    - 28_relief.py: offline press/raise engine + checks + whole-robot renders, then
    RL_ features at the END of each part's tree (no mate face touched), a point
    probe of the as-built part, 16 --chain. RobotMount step-bar, FacetBack /
    FacetFront traces + linings + vents, TailStrut, encoder parts pressed; wheel
    hub inlays raised (0.8 mm floor); grooves with coloured floors on the sides
    of Femur, Fe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
    [AK45-10 Rotor.SLDPRT, AK45-10 Stator.SLDPRT, AK_SIM.SLDASM, Ak sim rotor.SLDPRT, BODY.SLDASM, Battery holder.SLDPRT, Battery.SLDPRT, BatteryCap.SLDPRT]
2026-10-13 CAD v5: 0.6 mm accent rule, Coupler/Tibia restyle, femur traces + motor fill, side panel, RobotMount redo
    Work from the 2026-10-09..12 sessions that was left uncommitted (committed
    separately from the TailStrut work that follows):
    - standing rule: every colour accent 0.6 mm (3 layers), insides white;
    Coupler rebuilt to it (face-normal fix, hose `spine`, no accents near
    the E bearing), Tibia colour pass at 0.6 (09), tibia.py cutouts
    - faster iteration: 31_part.py, 16 --chain --quick, 25 mirror-colours <Part>
    - Femur hip-end traces (33_femur_traces.py), AK45 end filled (32_femur_motorfill.py)
    - Side panel accents + invisible colour whitened (28 d_sidepanel, 30_sidepanel.py)
    - RobotMount re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
2026-10-13 CAD v5: TailStrut for multicolour printing on the Front plane + blue trapezoids
    The strut now prints with its Front plane on the bed (a layer = a z slice),
    so every colour boundary runs parallel to the bed:
    - crystal facets + teeth white; |z| >= 25 (pad band + fangs) one graphite
    body per side, pad flanks and fang outer faces flat at z = +-32 (a face
    to print on); keel hose removed; blue seam in the ridge line's layers
    - round 2: blue trapezoids -- on the flat flanks cut 2 mm on 0.6 floors
    (chevron too), on the keel flanks pressed like the window lining
    - as built: 230 -> 32 multi-colour layers, ~377 -> 38 filament changes
    - tail_strut.py is the source (band_bodies, seam_tool, top/mid_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
2026-10-15 CAD v5: FacetHood strip seat (keeper, wider roof, data-in passage)
    The 2026-10-13 session's work, left uncommitted until now (split out of
    the next commit): box_facet_print.strip_channel + hood_variants, the
    reimported FacetHood, regenerated print 3MFs and exports, and the
    SolidWorks files as saved in that session. See README "Strip seat in
    the FacetHood". Backups: _originals/pre_stripseat_2026-10-13/.
2026-10-15 CAD v5: FacetFront/FacetBack 0.6 mm colour, front cheek circuits, full TPU frames
    His brief (both panels print plate down): every accent 0.6 mm of colour.
    The dark well/bay/pod linings no longer run the full 11-12 mm relief
    depth: they are white, and their visible face bands are pressed 1.0 on
    0.6 floors. The back's grey vents (one ran under the hose) and the blue
    brow trace (now under the bumper) move under the I/O bay, with a blue bus
    between the bay and the pod; the hose is kept. The front cheeks get a
    bigger, mirrored blue circuit. Colour the bumpers hide stays white.
    Multi-colour layers, as built: front 60 -> 22, back 60 -> 28.
    Bumpers: full rectangle frames, 10 mm bars on the bracket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
2026-10-17 Firmware: ESP32 glacier face display
    Add glacier_face module and wire it into main.cpp / config.h.
2026-10-17 CAD v5: relief, pipes, hood one-grey and print outputs
    Scripts (24_pipes, 28_relief, 34_hood_one_grey, aesthetics parts) and
    regenerated render/print/relief outputs.
2026-10-17 CAD v5: SolidWorks part and assembly updates
    Re-saved parts and assemblies from the one-grey, facet, bumper and
    trapezoid rounds, plus README update.
2026-10-17 CAD v5: snapshot originals before 2026-10-14..16 rounds
    Pre-edit snapshots (facet rounds 3-5, bumper slots/trapezoid, one-grey)
    kept as rollback points, matching the existing _originals convention.
