fernandomierhicks/wheeled-leg-robot/components/datasheets/Wheel motor/2026-04-03 14.19.43.jpg

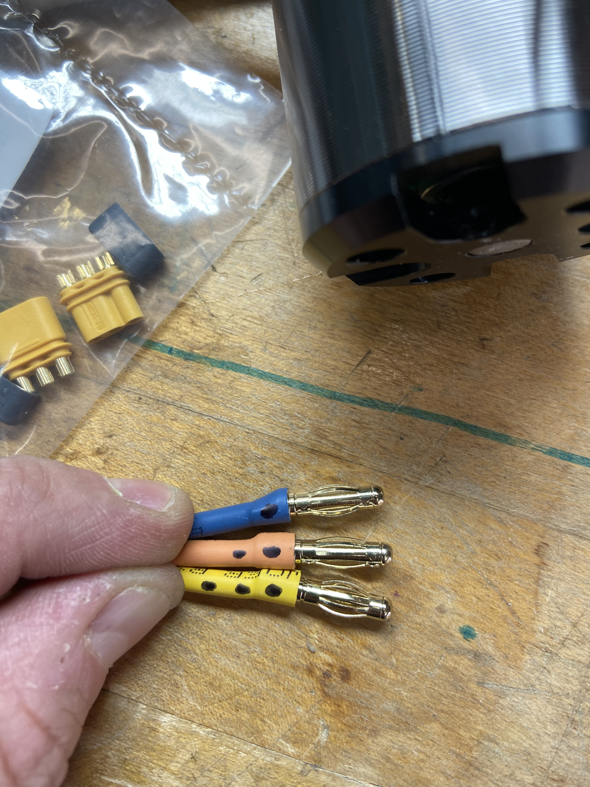
components/datasheets/Wheel motor/2026-04-03 14.19.43.jpg
