fernandomierhicks/wheeled-leg-robot/components/Masses/2026-07-13 22.01.58.jpg

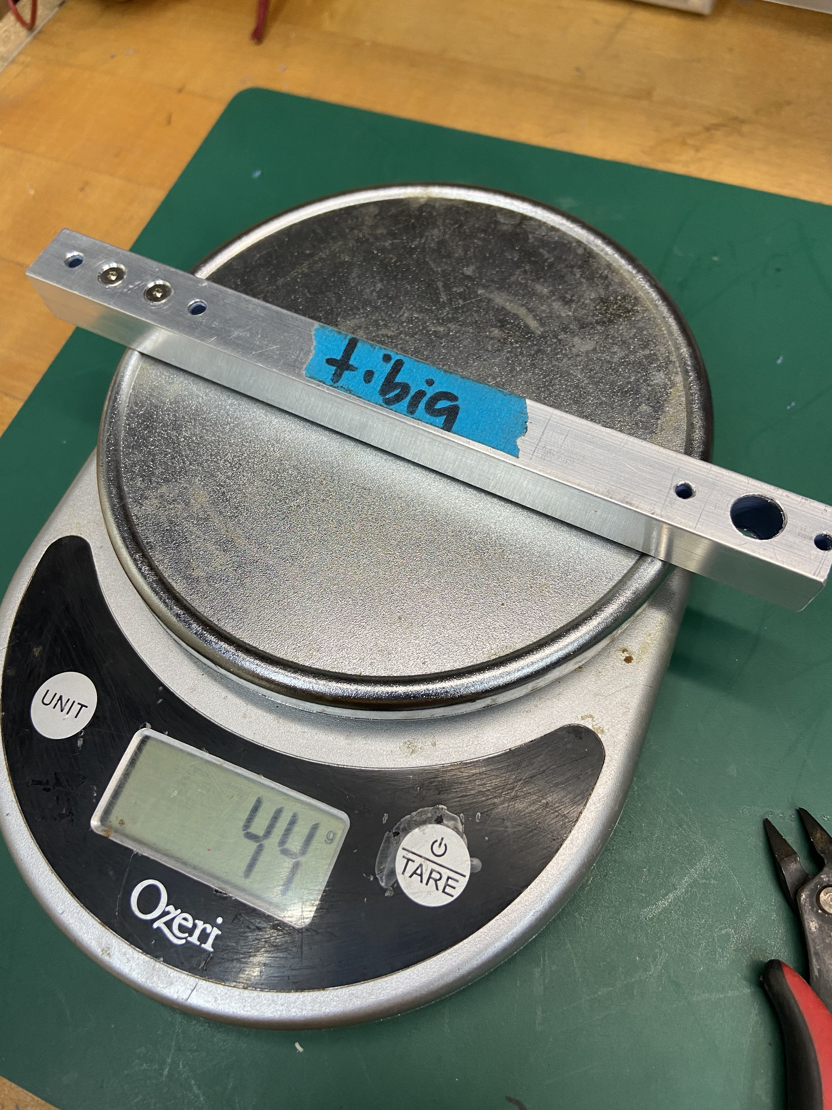
components/Masses/2026-07-13 22.01.58.jpg
