fernandomierhicks/wheeled-leg-robot/components/Masses/2026-07-13 22.02.04.jpg

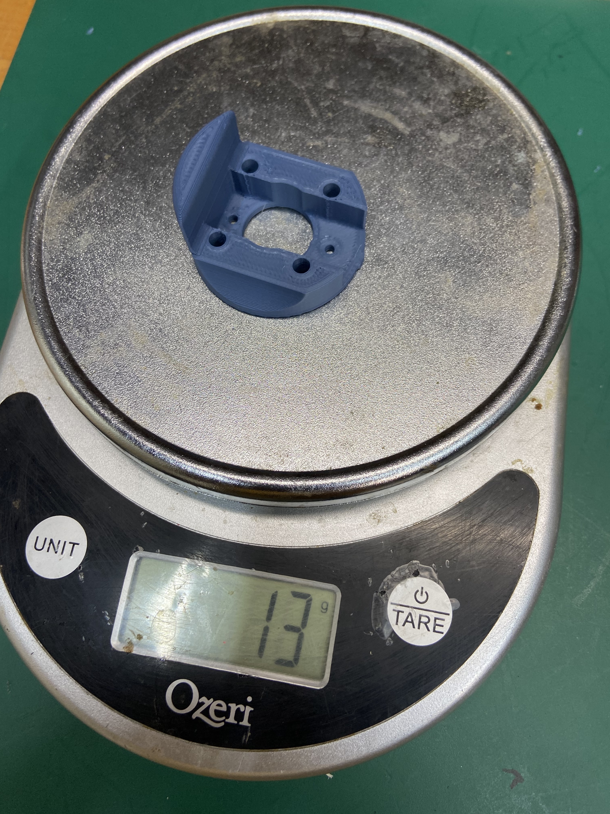
components/Masses/2026-07-13 22.02.04.jpg
