fernandomierhicks/wheeled-leg-robot/components/Masses/2026-07-13 22.02.08.jpg

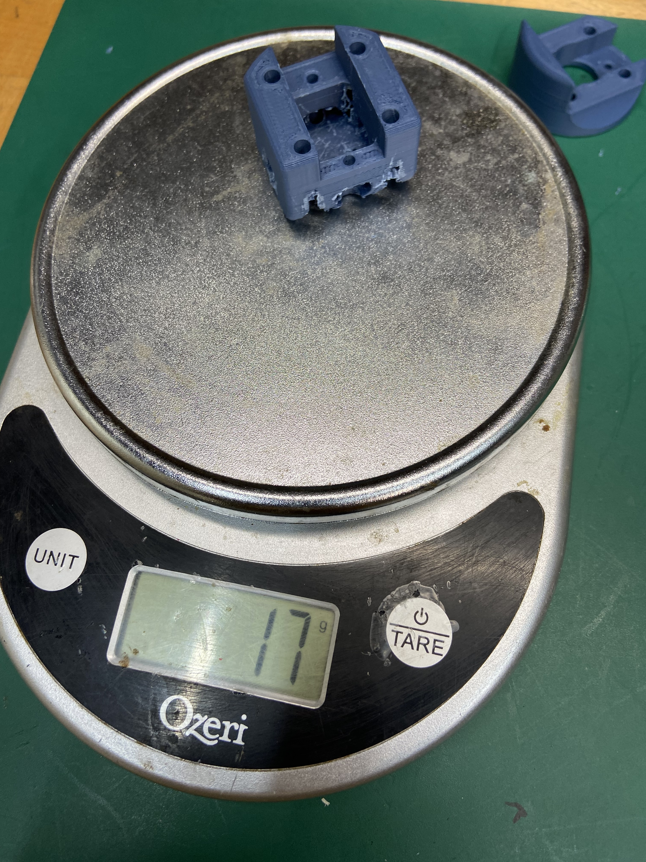
components/Masses/2026-07-13 22.02.08.jpg
