fernandomierhicks/wheeled-leg-robot/components/Masses/2026-07-13 22.19.53.jpg

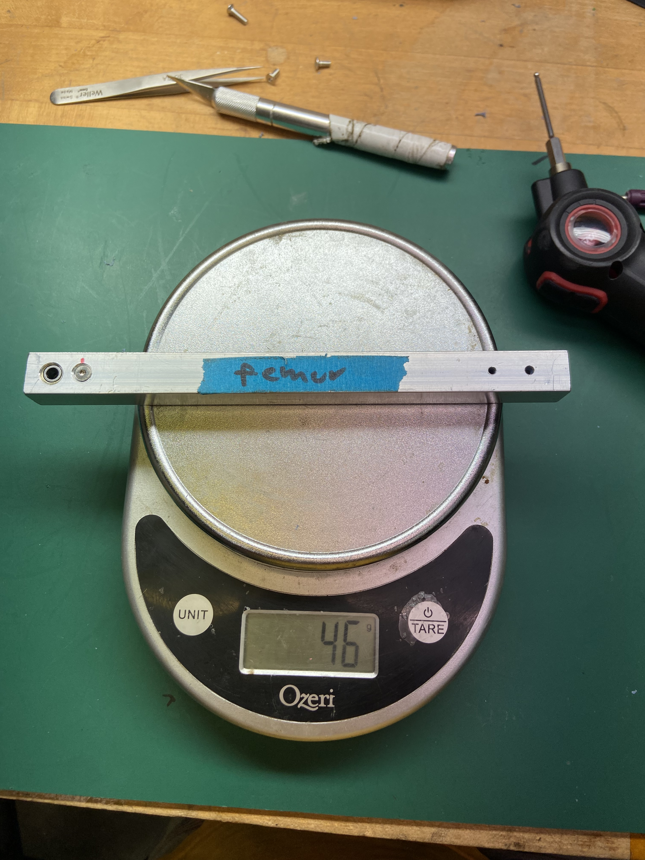
components/Masses/2026-07-13 22.19.53.jpg
