fernandomierhicks/wheeled-leg-robot/components/Masses/2026-07-13 22.25.06.jpg

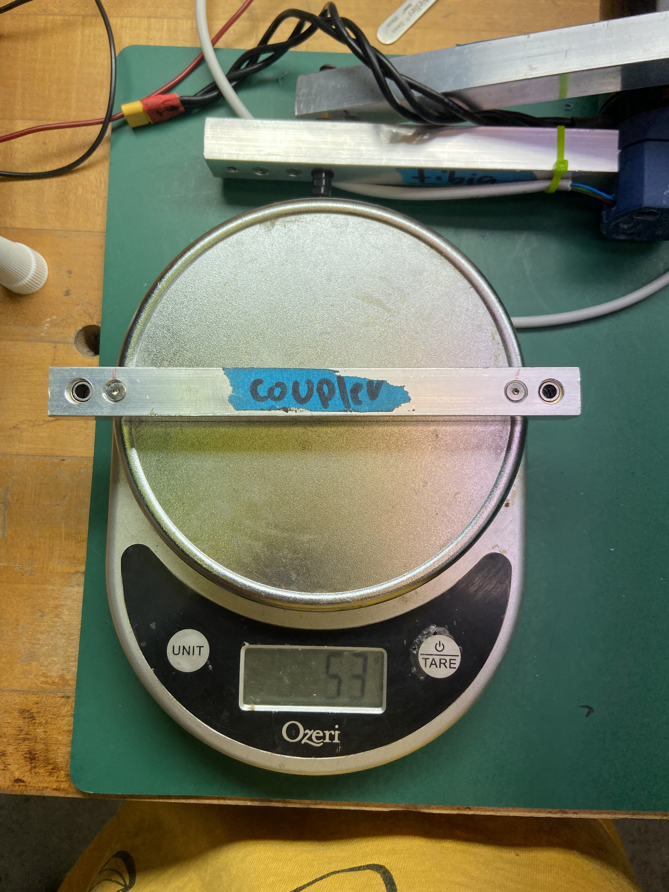
components/Masses/2026-07-13 22.25.06.jpg
