fernandomierhicks/wheeled-leg-robot/components/Masses/2026-07-13 22.51.39.jpg

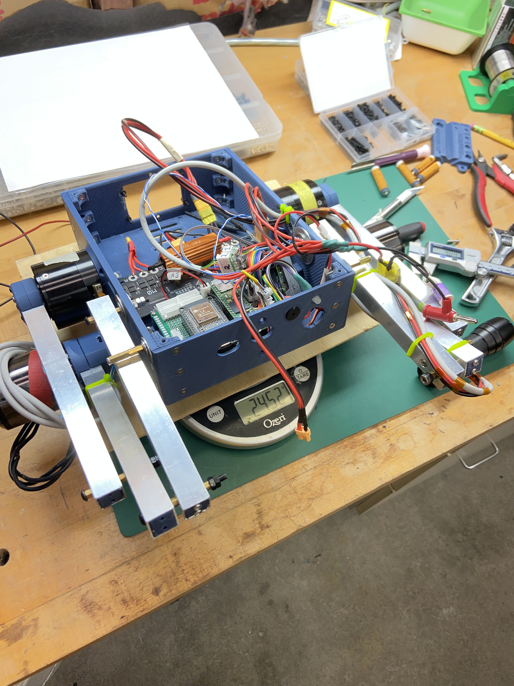
components/Masses/2026-07-13 22.51.39.jpg
