fernandomierhicks/wheeled-leg-robot/components/Masses/2026-07-22 19.02.54.jpg

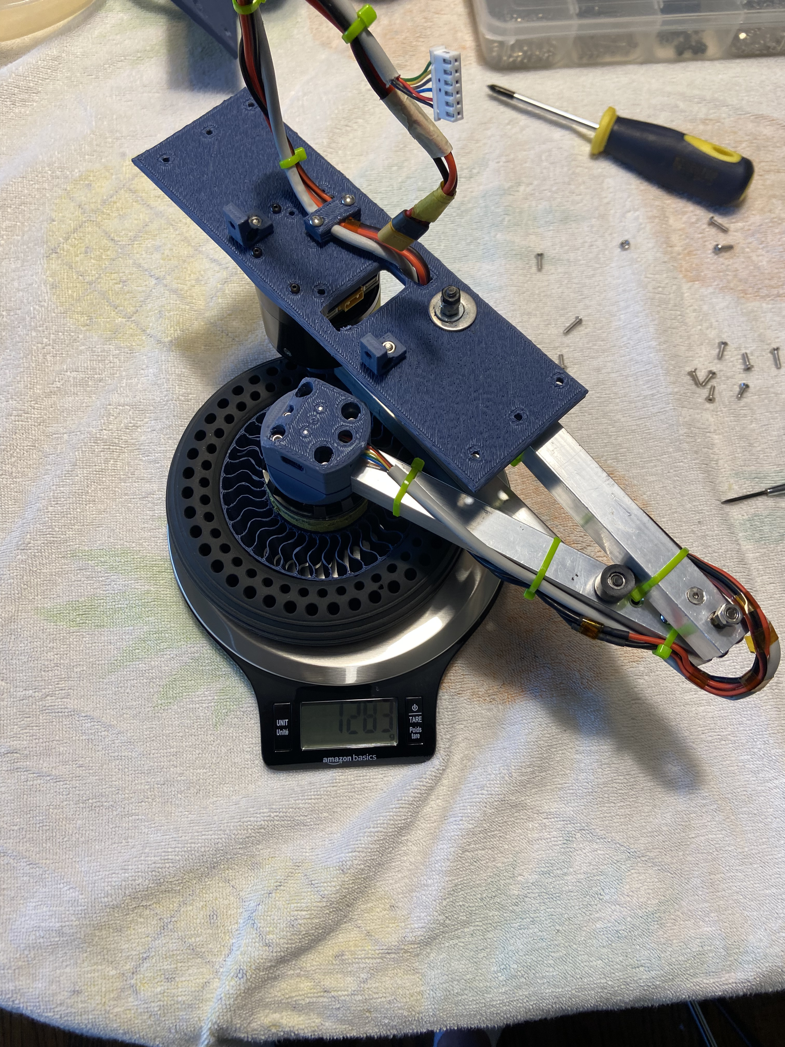
components/Masses/2026-07-22 19.02.54.jpg
