fernandomierhicks/wheeled-leg-robot/components/Masses/2026-07-24 11.23.37.jpg

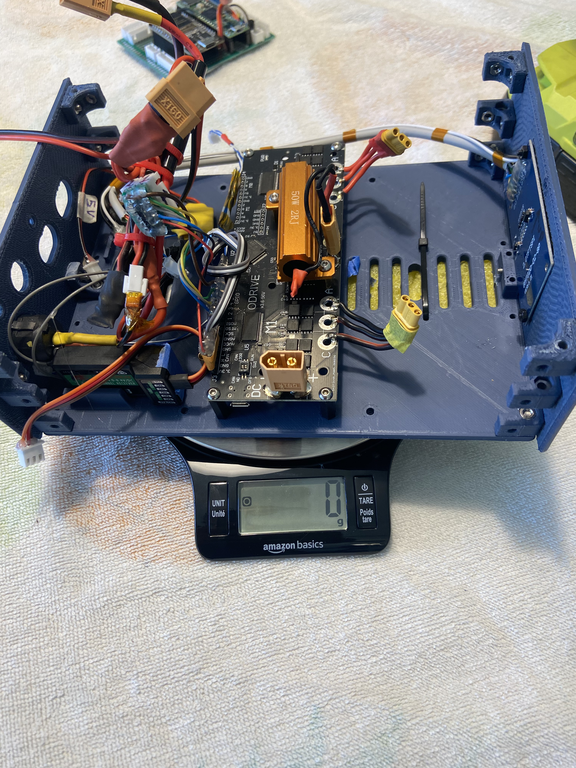
components/Masses/2026-07-24 11.23.37.jpg
