fernandomierhicks/wheeled-leg-robot/components/Masses/2026-07-24 12.39.56.jpg

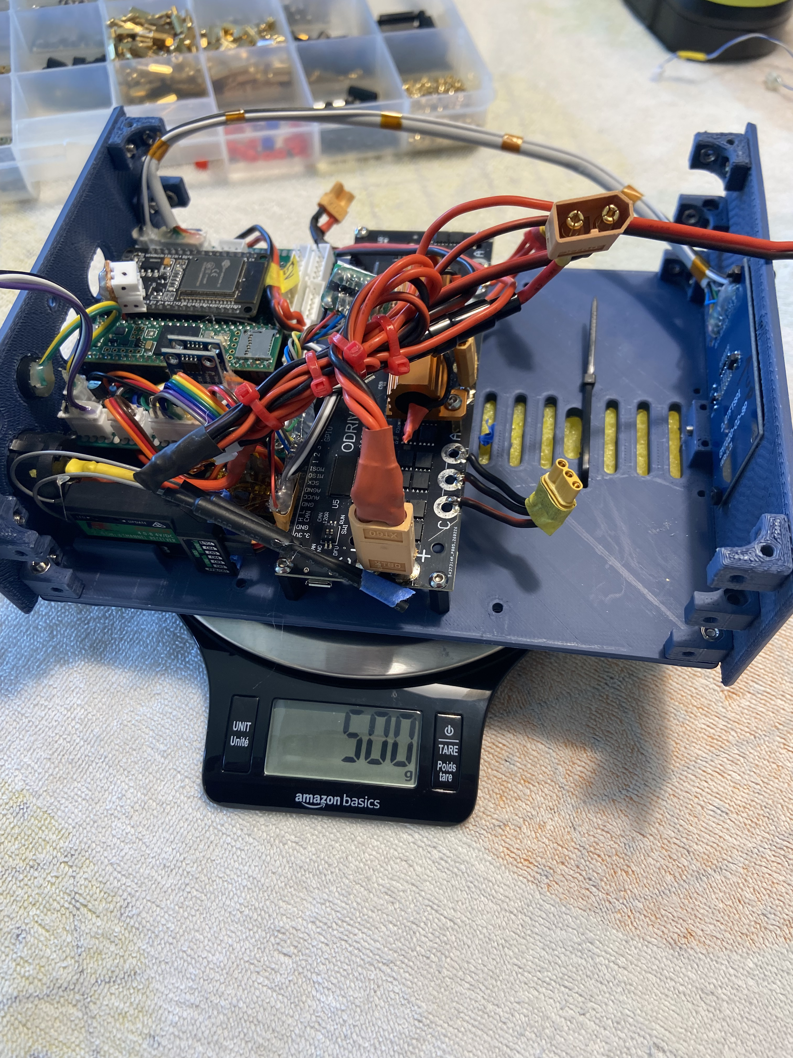
components/Masses/2026-07-24 12.39.56.jpg
